Zdy-1110/FPGA-676/fpga/linux/ReadME.txt

driver  --- 驱动
dma_pio_app.c  --- dma and pio 操作应用程序
pio_test.c  --  寄存器操作应用程序
