Zdy-1110/FPGA-676/交接_20261019_会话续接.md

# 会话交接（2026-10-19 13:15，接 10-18 下午至 10-19 中午的会话）

新会话开场请先读本文件和记忆索引 `MEMORY.md`，然后从 **§3 待办第 1 项** 继续。

## 1. 当前硬件状态（以本节为准）

**FPGA 卡**
- 插在 **P29**（PCIe3 x2，控制器 3c0800000）。10-19 13:03 按 V2 条件重插后，建链为 **Gen2 x2**：
  - EP 0002:21:00.0，根端口 0002:20:00.0；
  - BAR0 f0200000，BAR1 **f0204000**。
- 比特流 **osd1c**（md5 24fc1ec8…）**已写进 FPGA 的 SPI flash**，上电后自加载，不再需要 JTAG。
- V2 之后测过两次，误码计数和 AER 全部为 0：空闲 30 秒一次，不限速送帧约 4.9 GB 一次。
- 日志：`log/p29_gap/v2_*`。

**接线**
- **HDMI 线：用户 13:10 左右在不播放的状态下刚插到 FPGA 板的 HDMI OUT，插上之后还没检查过链路和误码。**
- MIPI 屏没接，挡板螺丝没拧。

**RK（OK3568）**
- 地址 192.168.3.51（WiFi C305_5G），登录方式见记忆 `rk-board-network-access`。
- 串口控制台是 COM9。COM9 可能被其他会话的串口录制程序占用，遇到时等它结束，不要杀进程。
- CMA 256 MB（U-Boot 环境变量 bootargs 里的 `cma=256M`）。

**每次 RK 重启后会复位的东西**
- `/tmp` 被清空；
- EP 没有使能（需要 enable 加 CMD 0x06）；
- MPS 变回 128。

在 PC 上运行 `sh tools/test_feeder/board_test.sh` 会全部自动处理：识别槽位、使能 EP、在 P29 上设 MPS 256、上传文件、30 fps 播放。

## 2. 本次会话完成的工作

| 项目 | 结果 | 详情 |
|---|---|---|
| FPGA 显示 + OSD + 按键 + 标定（disp1 → osd1 → osd1b → osd1c） | 上板全部通过，osd1c 为当前版本 | 记忆 `fpga-display-path` |
| aarch64 交叉编译（Zig 0.14.1 + MPP/RKNN 1.5.0 头文件） | 可用，命令 `sh tools/rk_build.sh` | 记忆 `rk-cross-toolchain` |
| CMA 16 → 256 MB | 已生效，有备份和回退办法 | `RK_CMA扩容方案_20261018.md` |
| test_feeder 零拷贝送帧（MPP → CMA → 门铃 → FPGA） | 30 fps 稳定。不限速：P30 x1 为 103.8 fps，P29 x2 + MPS 256 为 **202 fps** | `tools/test_feeder/`，记忆 `rk-test-feeder` |
| test_feeder 修复 | 输入 EOF 后 2 秒内没有新帧就退出，空输入返回码 3；board_test.sh 改为自动识别槽位、使能 EP、设 MPS | 同上 |
| osd1c 写进 flash | 卡上 flash 实际是芯天下 XT25BF128（ID 0x0B4018），原来是空的。PDS 的 flash 列表经 UAC 加了一条（挂在 WINBOND 下）；冷启动验证通过 | `FPGA_flash固化方案_20261018.md`，记忆 `fpga-flash` |
| P29 排查 | 参考时钟已排除（V3，由 P29 排查会话完成）；**V2 机械重插成功**，确认是插槽接触问题 | 记忆 `ok3568-pcie-slot-hardware`，`P29成功与失败差异分析_20261018.md` |
| 门铃带宽 | 冷启动后 MPS=128，只有 506 MB/s；设成 256 后 770 MB/s。显示读口只占约 30 MB/s | 记忆 `pcie-dma-fast-path`，`log/p29_gap/v2_bench_*` |
| NPU 检测程序 | **只有设计，还没写代码**：yolov8n 转 RKNN 1.5.x INT8，输入 960×320 路面带，用 RGA 预处理，分 M0–M4 | `RK_NPU检测程序设计_20261018.md`，记忆 `rk-npu-design` |
| 状态问答 | RK 端还没有模型检测，FPGA 端也还没有车道线检测；只有 PC 上的离线参考算法 | `tools/ref_algo/`、`tools/yolo_baseline/` |

## 3. 待办（按优先级）

1. **【下一步】确认接上 HDMI 后 P29 是否正常，然后播放给用户看。**
   1. 只读检查：`lspci`、`current_link_speed/width`；
   2. 上传 `tools/pcie_bench/{gen2check,aer,rasdes}.sh` 到 `/tmp`，执行 `/tmp/gen2check.sh 30`，看两条 lane 的误码和 AER；
   3. 一切正常就运行 `sh tools/test_feeder/board_test.sh`，请用户看显示器；
   4. 之后按"一次只加一项"的原则验证：带 HDMI 重启一次 → 拧上挡板螺丝 → 接 MIPI，每加一项都检查建链和误码。
2. **NPU 程序：等用户决定。** 转换环境二选一：
   - 把 Ubuntu-22.04 切到 WSL1，不需要 VT-x；
   - 用户去 BIOS 打开 VT-x，继续用 WSL2。

   另外有几项下载需要用户同意：Toolkit2 1.5.x 和依赖（约 1.5–2 GB）、airockchip 的 ultralytics 分支、yolov8n.pt、librga 1.9.1 头文件。批准后从 M0 开始。
3. （用户暂缓）RK 开机脚本：自动使能 EP、设 MPS，并把播放程序放到 `/userdata`。
4. 更早留下的待办：
   - 用户核验 layer-A 的 GT；
   - 用户手动删除 `D:\d\` 和 `video_review/ref_runs/B_manual$1`；
   - RK HDMI 后备链路（RK 检测不到 HPD）；
   - FPGA 感知口：FPGA 上做车道线和信号灯检测、给 NPU 的拼图预处理、DMA-W 环形缓冲；
   - 门铃完成改用 MSI 通知；
   - test_feeder 每帧带元数据，以及支持中途换分辨率；
   - OSD 检测框寄存器加影子和提交位。

## 4. 常用命令和文件

| 用途 | 命令 / 文件 |
|---|---|
| 一键播放（PC 上运行） | `sh tools/test_feeder/board_test.sh [--fps 0] [--frames N]` |
| 安全重载比特流（JTAG） | `[SLOT=p30] sh tools/fpga_reload.sh D:/pango_work/prog_x2_osd1c.tcl`（P29 不加 SLOT） |
| 写 flash | `tools/flash/*.tcl`，经 `tools/jtag_run_tcl.ps1` 执行。**先断链**，写完用整片回读比对 |
| 误码 / AER | 板上 `/tmp/gen2check.sh 30`、`/tmp/aer.sh show`、`/tmp/rasdes.sh dump`（脚本在 `tools/pcie_bench/`） |
| 门铃回归 | `/tmp/pcie_bench f0204000 3 D`（测之前先设 MPS 256） |
| 板子访问 | `tools/rk_ssh.py`、`rk_put.py`、`rk_get.py`，要设 `MSYS_NO_PATHCONV=1` |
| 方案文档 | `选题3_硬件架构_FPGA视频中枢方案_20261018.md`（总架构）、`PCIe_DMA提速_20261018.md`、`RK_CMA扩容方案_20261018.md`、`FPGA_flash固化方案_20261018.md`、`RK_NPU检测程序设计_20261018.md`、`P29成功与失败差异分析_20261018.md` |

## 5. 坑点（下次别再踩）

- **RK 链路在线时不能动 FPGA**（JTAG 烧写、访问 flash 都不行），否则 RK 会挂死。必须先断链：移除 EP，再置 LnkCtl.Link Disable。
- `rk_ssh.py` 会把命令本身回显出来，而且不返回远端的退出码。在输出里 grep 标记时要加 `^` 锚定，否则会匹配到回显的命令行（之前 `HAVE_MP4` 就因此误判）。
- P29 的 PHY 时钟被关掉时，不要读 0xFDCB8xxx，会挂总线。
- 管理员身份运行的 PowerShell 5.1 会把没有 BOM 的 UTF-8 脚本当 GBK 读，所以 .ps1 只写 ASCII。
- PDS 的 flash 厂商表写死在 cdt_js.exe 里，新增的厂商名会被忽略。`cfg_jtag_flash_verify` 要往管理员目录写文件，所以会失败，改用回读比对。
- `cfg_jtag_flash_readback` 必须先 assign 一个文件，回读长度等于这个文件的大小。
- 测带宽前先确认 MPS。不要凭推断下结论：这次"显示读口抢带宽"的猜测，实测证明是错的。
- Git Bash 里没有 `iconv`；cdt 工具的输出直接读原始内容即可。

## 6. 环境备注

- 工作目录 `E:\Project\nesai2026`；远程操作前确认板卡供电与 P29 槽位占用。
