Zdy-1110/FPGA-676/选题3_当前进度分析与交接_20261014.md

# 选题三（ADAS）当前进度分析与交接文档

> 生成时间：2026-10-14（Asia/Taipei）
> 用途：从「聊天模式」交接到「code 模式」继续执行。新会话请先读本文，再按 §9 的顺序开展工作。
> 分析范围：`E:\Project\nesai2026`（工作区）。**未覆盖** `D:\pango_build\`、`D:\pango_work\` 等工作区外目录（x2 自研工程和成功证据都在那里）。
> 分析方式：4 个 haiku 子智能体分块只读分析 + 主会话抽样复核。凡是只有子智能体报告、未经本人复核的结论，文中标注「未复核」。

---

## 1. 一句话结论

选题三的应用层（图像采集显示、图像识别、多路视频、AI）**一行代码都还没有**。已完成的工作几乎全部集中在「基础任务②：RK3568 ↔ FPGA 的 PCIe 互联」的底层打通：Gen2 x2 链路协商成功、DMA 数据面用 `devmem` 往返验证通过。但**吞吐从未实测**，官方驱动也未编译成功。

---

## 2. 选题三要求（来源：紫光同创《FPGA 创新设计赛道选题指南》第 12–14 页）

**架构要求**：以「紫光同创 FPGA + ARM（或 RISC-V 软核）」为核心的软硬协同系统，处理性能不得高于 RK3568。

| 类别 | 任务 |
|---|---|
| 基础① | 图像采集与显示：HDMI / 摄像头（如 OV5640）输入，LCD 或 HDMI 输出，完成「采集-处理-显示」闭环 |
| 基础② | 软硬协同通信：MCU 与 FPGA 之间的高速通信（如 PCIe），完成数据交互与指令控制 |
| 基础③ | 基于 FPGA 的道路环境监测与特定场景感知（斑马线、行人、障碍物等） |
| 高阶① | 至少四路视频流（前、后、左、右）并行采集与低延迟传输，优化数据流带宽 |
| 高阶② | 复杂场景（夜间道路、复杂路口）下的完整感知与避障 |
| 高阶③ | MCU 端部署轻量 AI 模型，实现多路视频实时、高精度、低延迟识别与自主路径规划 |

**测评与测试方式要点**：
- 图像采集处理：采集一路或多路视频，能拼接或融合（模拟全景影像）；灰度化、去噪、二值化、色彩空间转换等基础处理；延迟与帧率满足低延迟需求。
- 测试场景（现场用 U 盘提供 1–4 种）：
  - 十字路口视频，假设车在左/右/直行三车道之一：红灯停、绿灯行、红灯强行行驶时报警；用叠加箭头或 LED 指示行驶行为（LED0 左转、LED1 直行、LED2 右转）；按键模拟换车道、停止/行驶；LED 或红色叠加表示报警。
  - 道路图片或视频：虚线则变道，实线则直行，强制变道指令时报警；按键模拟左转/右转。
  - 带导航的真实道路视频：根据导航完成模拟智驾。
  - 其他：行人闯红灯、汽车刹车等。
- 文档与代码：Verilog / C 模块化、时序约束合理、无明显时序违例；分析报告含系统架构、软硬协同数据流、资源占用、性能测试。
- 提交物：完整技术文档（含核心亮点预览）、**硬件实物**、**1080P 演示视频（3 分钟内）**、打包的工程源码。强调需要可现场演示的实物，不能只停留在算法仿真。

**平台**：推荐盘古 50 / 盘古 676 开发板（企业借出共 200 套）、RK3568_MES2L100H（5 套），也可用以紫光同创 FPGA 为核心的自制板。盘古 100Pro+（本项目所用）属于 676 系列，板载 HDMI 输入/输出、按键、LED、FMC LPC、PCIe Gen2 x4 金手指；FMC 转 IO 子卡可接官方双目 OV5640 摄像头模块。

---

## 3. 本项目当前硬件方案

- FPGA：盘古 100Pro+（PG2L100H-6FBG676，Logos2），板卡识别为 BASE-V1.2 / CORE-V1.2。
- 主机：飞凌 OK3568-UP4（RK3568），FPGA 卡插在 **P29 槽（PCIE_A，物理 x2，RK 控制器 `3c0800000.pcie`）**。P30 槽是 x1，空置。
- 互联：PCIe，RK 为 Root Complex，FPGA 为 Endpoint。
- 工具链：PDS 2025.2-ads（`D:\pango_pds`），仿真用 Questa Altera Starter 2025.3。
- 用户最新状态（2026-10-14）：FPGA 板已接电脑（JTAG），同时已插在 RK3568 板上。

---

## 4. 已完成的工作（按证据强度分级）

### 4.1 有文档记载的实测结果（原始日志在 `D:\pango_work`，工作区内无，本次未复核原始证据）

来源均为 `PCIe_x2提速_进度与交接文档.md`（2026-10-05 第 2 版）。

| 项目 | 结论 |
|---|---|
| x2 提速根因 | `NUM_OF_LANES` 是布尔标志位，必须保持 `5'b1`。真正决定 lane 数的是 `MAX_LINK_WIDTH=6'd2`、`LINK_CAPABLE=6'd3`、`HSST_LANE_NUM=2` |
| x2 比特流 | 已编译并烧写，EP 广告 `max_link_speed=5.0 GT/s`、`max_link_width=2`；产物 `D:\pango_work\pango_pcie_dma_x2.sbit`（3,791,112 B） |
| RK 端链路 | `PCIe Link up, LTSSM is 0x130011`，EP = `0002:21:00.0`（vendor/device = 0x0755），`current_link_speed=5.0 GT/s`、`current_link_width=2` |
| DMA 数据面 | 用 `devmem` 直控 BAR1（本次映射 `0xf0204000`），128 B 逐字比对与 4096 B 满包往返在两个方向上全部一致，done 位均置 1 |
| RK 启动修复 | boot 分区 DTB 损坏导致 U-Boot `panic()` 死循环，已用 recovery 分区（LBA 0x28000 + 0x800）里的原版 DTB 修回，CRC32 `74a6f13e`，现可正常进 Linux |
| 自动化 | `pds_shell` 全流程编译（约 2.5 分钟）、JTAG 命令行烧写、U-Boot 恢复、串口脚本均已打通 |

JTAG 烧写日志旁证：工作区 `log/configuration.log` 记录 2026-10-05 21:41 有一次成功烧写（进度 100%），与交接文档时间吻合。

### 4.2 工作区内有文件支撑的成果

- **只读 JTAG 实测**（2026-10-03）：识别到 PG2L100H，ID `0x00602899`，当时 DONE=0（`review/hardware_connected_20261003/jtag_readonly_result.json`）。
- **官方 PCIe 例程只读审计**：`review/pcie_code_audit_20261003/`。覆盖 `4_15_PCIE_DMA`（Fabric 2022.2-SP6.4，Gen2 x4 端点，DMA + PIO + 主机驱动 + 测试程序）与 `2_13_pcie_test`。（子智能体摘要，未复核：约 83 个源/IP 文件；历史单 seed 布线结果 Setup WNS 0.439 ns、Hold 0.098 ns、TNS 0，LUT 约 6%、FF 约 4%；官方预编译的驱动和测试程序是 x86-64，RK3568 用不了。）
- **资料包校验**：104 个压缩包重下后校验全部完好（`_report_redownload.txt`、`tools/check_archives.py`）。
- **仿真环境**：`fpga_sim/` 有 Questa + PDS 仿真库的运行方法与踩坑记录；`tb_counter.v` 是有效的计数器自检，`tb_pango_prim.v` 的时钟检查恒真，不算有效验证。运行证据只是 README 自述（2026-10-02 PASS），无日志。
- **串口排障工具**：`tools/` 下 11 个串口脚本，XR21V1414 驱动在 `tools/xr_usb_driver/`。
- **自制教学页**：`fpga_architecture.html`（FPGA 原理图解，非项目方案）。

### 4.3 已终止的工作线（遗留文件会误导，见 §6）

PCIe 电源隔离转接板（Rev A/B/C）：2026-10-07 已按用户指示终止，`design/`、`delivery/`、`archive/` 和 review 里的板卡专属内容全部删除（回收站可恢复）。

---

## 5. 选题三完成度对照

| 任务 | 状态 | 说明 |
|---|---|---|
| 基础① 图像采集与显示 | 未开始 | 工作区无 HDMI/OV5640 采集、显示的 HDL 或软件 |
| 基础② PCIe 软硬协同通信 | 部分完成 | 链路和 DMA 数据面已验证（文档记载）；缺官方驱动编译、吞吐实测、真实数据通道、指令控制协议、FPGA 比特流固化 |
| 基础③ 图像处理与识别 | 未开始 | 无 |
| 高阶①~③ | 未开始 | 无 |
| 提交物（文档、视频、源码） | 未开始 | 现有文档均为工程记录，不是参赛文档 |

---

## 6. 文档矛盾与过期结论（已核对）

| 问题 | 结论 |
|---|---|
| `00_最新PCIe评审_禁止直接打板.md` 声称 Rev C 设计包已交付 | **已过期**。README 写明该线 10 月 7 日已终止并删除，文中链接全部失效 |
| `PCIe中间件_CEM触点映射_已核实.md` 依据 OK3588-C 原理图，而主线用 OK3568-UP4 | 属于已终止的转接板线，不适用于主线 |
| `configuration.log` 显示 10 月 5 日有成功烧写，而 10 月 3 日文档称「未烧写」 | **不矛盾**。前者是 x2 比特流烧写（交接文档有记载），后者是更早的只读 JTAG 阶段 |
| `tools/boot_console.log` 中两路 PCIe 均为 Link Fail | 这是 FPGA 未配置时抓的排障现场（交接文档 §4.2 已说明），不代表当前状态 |
| 交接文档称「目标已达成」，但吞吐未测 | 「≈1GB/s」是 Gen2 x2 的链路折算（5 GT/s × 2 lane × 8b/10b），不是测量值 |
| 10 月 11 日的 `tmp_yuque_*.html` | 飞凌文档页面保存失败后留下的空壳（正文仅十几个字符），无信息 |
| `tmp_ok3568_up4_sch.txt`（2 MB）、`tmp_pcie_page11.txt`、`tmp_rk_pcie_pages/` | 未分析，疑似 RK 原理图 PCIe 页的提取，可能是最近的排查输入 |

---

## 7. 风险与阻塞

1. **吞吐无基线**：官方 `.ko` 驱动需 OK3568 的 Linux 5.10.160 内核源码树加 aarch64 交叉工具链，当前没有（F 盘资料盘已断开，`D:\pango_work\ksrc` 为空，飞凌源码分卷包曾损坏）。板端 `/lib/modules/5.10.160/build` 是悬空软链接，且板上无 gcc，不能板上编译。
2. **FPGA 配置掉电即丢**（SRAM）：交接文档明确要求「别给 FPGA 板断电」。若已断电过，x2 比特流已不在，需要先只读检查 `done bit`。
3. **RK 上电只探测一次 PCIe**：FPGA 必须先于 RK 启动完成配置。演示需要把比特流固化到 Flash（文档提过思路，未做），并验证冷启动能一次枚举成功。
4. **PDS license 已于 2026-11-03 续期至 2029-09-09**（`host_id 00e04cf107df`，需保持 TAP 网卡「以太网 8」MAC = `00E04CF107DF`）。Questa license 至 2027-10-02。
5. **四路视频来源未规划**（我的推断）：100Pro+ 只有 1 路 HDMI 输入加 FMC，官方配套摄像头模块是双目，四路需要提前确认方案（多 FMC 子卡、HDMI 加摄像头混合，或用 U 盘视频文件模拟多路输入）。
6. **时间分配失衡**：最新有实质内容的文档更新是 10 月 7 日，工作量主要花在互联底层、已废弃转接板和排障上。
7. **遗留的未决硬件问题**（均来自已终止的转接板线，直插 P29 槽的主线下已能训练成功，所以大概率不阻塞，这是推断）：参考时钟球位 F11/E11 与 F13/E13 手册冲突、lane reversal 两个例程相反。

---

## 8. 本次会话的 SSH 尝试结果

用户要求：FPGA 已接入电脑并插在 RK 板上，尝试 SSH 到 RK 板分析 PCIe 提速；若缺乏软硬件资料则停止并等待用户补充。

结果：**未能连接，已按约定停止**。

- 本会话运行在云端，访问不到用户本地网络。
- 桌面端本地命令行工具（`device_bash`）提示「Linux 环境仍在下载」，两次尝试均不可用。
- 桌面控制对终端类应用只给「点击」权限，无法输入命令。
- RK 板在 Linux 下的 IP **没有任何文档记载**。此前全部操作走串口 COM14（115200，root/root）；`boot_console.log` 显示启动时有 `Starting sshd`，但未出现 IP。U-Boot 阶段用过 `169.254.33.200`（PC 侧 `169.254.33.151`，网线直连 APIPA），那是 U-Boot 的临时地址，不是 Linux 的。

**本会话未对任何硬件做过写操作**。

---

## 9. code 模式下的建议执行顺序

### 9.0 开工前的约束（上轮约定，沿用）

- 对 RK 板和 FPGA **只读**：不烧写、不擦除、不复位、不断电，除非用户明确另行授权。
- FPGA 烧写只在用户授权时用 `cdt_js.exe` + `cdt_cfg_shell.exe`（见交接文档 §3.3）。
- 访问 BAR 前必须 `echo 1 > /sys/bus/pci/devices/0002:21:00.0/enable`，否则读出全 `0xFFFFFFFF`。
- 板上 `dd` 读写 `/dev/mem` 会报 `Bad address`，只能 `devmem` 逐字访问。
- U-Boot 缓冲区一律用 `0x08300000`（`0x09000000` 是 TrustZone 保护区，访问即 panic）；U-Boot 数字参数全按十六进制解析。
- 串口用 pyserial 直连 COM14 前先杀掉 MobaXterm（它独占串口）；XR21 句柄卡死（PermissionError 13）时拔插 USB。
- 修改 `.v` 文件用 Edit 工具，不要用 Python `re.sub` 写 `\'`（会写入非法语法并被解析器静默跳过）。

### 9.1 第一步：只读摸清现状

1. 找到 RK 板 Linux 下的 IP（任选其一）：
   - 串口 COM14 登录后执行 `ip addr` 或 `ifconfig`；
   - 在 PC 上查 `ipconfig` 与 `arp -a`，网线直连时留意 169.254.x.x 网段。
2. 用 `ssh root@<IP>`（密码见交接文档 §八）确认可达。
3. 在 RK 上执行只读命令，建立链路基线：
   ```sh
   D=/sys/bus/pci/devices/0002:21:00.0; R=/sys/bus/pci/devices/0002:20:00.0
   cat $D/current_link_speed $D/current_link_width $D/max_link_speed $D/max_link_width
   cat $R/current_link_speed $R/current_link_width
   hexdump -C $D/config | head -20; hexdump -C $R/config | head -20
   dmesg | grep -i -E "pcie|0002:2"
   ```
   （`hexdump` 可用来读 PCIe Capability 里的 MPS/MRRS；busybox 的 `lspci` 输出乱码，认 sysfs。）
4. 在 PC 上用 `check.tcl`（只连接并扫链，不烧写）确认 FPGA 的 `done bit`，判断 x2 比特流是否仍在运行。

### 9.2 第二步：补齐资料后再测吞吐

需要用户提供或找到，缺了就停下等待：
- OK3568 的 Linux 5.10.160 内核源码（飞凌 SDK）+ aarch64 交叉工具链，用于编 `pango_pci_driver.ko`、`dma_pio_app`、`pio_test`；
- 或评估不依赖官方驱动的方案（UIO/`mmap` 用户态 DMA 测试）。该方案的可行性我没有验证，需要先读官方 DMA 寄存器说明与 `dma_findings.md`。

链路层面的判断（来自文档，不是实测）：P29 物理上只有 2 条 lane，FPGA 官方例程最高是 Gen2，所以链路层基本已到顶；再提速只能在数据通路上优化（DMA payload 大小、RK 端 MPS/MRRS、驱动与描述符方式、FPGA 侧 128 bit 数据通路时钟），必须先测基线才能判断。

### 9.3 第三步：补选题三主线（优先级建议，非文档内容）

1. **基础①**：HDMI 输入 → DDR3 帧缓存 → HDMI 输出的闭环。不依赖 PCIe，是所有后续工作的底座。
2. **PCIe 数据通道**：把 FPGA 的帧数据 DMA 到 RK 内存并实测吞吐；设计简单的指令/状态协议。
3. **比特流固化 + 冷启动枚举验证**。
4. **基础③**：FPGA 端预处理（灰度、去噪、二值化、边缘、ROI），识别斑马线、红绿灯状态、虚实线。
5. **高阶**：确定四路视频的来源方案；RK 端用 NPU（RKNN）部署轻量模型；构建夜间、十字路口场景。
6. **参赛交付物**：架构、软硬协同数据流、资源占用与性能测试文档；1080P 3 分钟演示视频；按 U 盘测试数据集（十字路口、变道、红绿灯判断）准备演示流程。
7. 续 PDS license。

### 9.4 顺手清理

- 过期文档 `00_最新PCIe评审_禁止直接打板.md`、`PCIe中间件_CEM触点映射_已核实.md`，及 `tools/` 下的转接板线遗留（`make_kicad_interposer.py`、`make_pcie_interposer.py`、`make_wiring_diagram.py`、`kicad_lib/`、`kicad_out/`、`datasheet/`、`lcsc_page.html`）。README 已说明可再删，删除需用户确认。
- `tmp_*` 文件（含 2 MB 的 `tmp_ok3568_up4_sch.txt`）确认无用后清理。

---

## 10. 关键文件索引（工作区 `E:\Project\nesai2026`）

| 文件 | 说明 |
|---|---|
| `README.md` | 工作区总索引（2026-10-07 整理），各工作线状态、目录说明、外部依赖路径、清理记录 |
| `PCIe_x2提速_进度与交接文档.md` | **核心交接文档**：x2 提速全过程、RK 侧枚举/DTB/devmem/U-Boot 坑、烧写与串口方法 |
| `review/pcie_code_audit_20261003/代码分析汇总结论.md` | 官方 PCIe 例程审计结论；配合 `dma_findings.md`、`pcie_test_findings.md` |
| `review/hardware_connected_20261003/` | 实板只读实测记录（不可再生，勿删） |
| `pcie_demo/4_15_PCIE_DMA/` | 官方 DMA 参考设计（含 `linux/` 驱动与测试程序源码、`docs/` 的 RD04005 使用说明） |
| `fpga_sim/README.md` | Questa + PDS 仿真环境四个坑 |
| `contest_pymupdf.txt` | 紫光同创赛道选题指南全文提取（含选题三） |
| `anlogic_2026_topics.txt` | 安路赛道选题指南（与本队无关） |
| `fpga_docs/` | 官方手册 PDF 与文本提取（无 DDR3/HDMI/PCIe IP 用户指南，PDS 的 UG 文档在 `D:\Program Files\pango\PDS_2025.2-ads\doc\`） |

**工作区外依赖**：`D:\pango_build\4_15_PCIE_DMA\`（x2 自研工程，主力）、`D:\pango_work\`（x2/x1 比特流、烧写脚本、U-Boot 自动化脚本、DTB 备份）、`D:\pango_sim_libraries\`（仿真库）、`F:\BaiduNetdiskDownload\`（竞赛资料包与飞凌资料，当前断开）。

---

## 11. 本文未覆盖或未核实的内容

- `D:\pango_build`、`D:\pango_work` 下的实际工程与证据文件。
- x2 链路和 DMA 往返结果的原始日志（`boot_after_fix_raw.bin` 等）。
- 官方例程源码本身（只读了审计结论，没读 RTL）。
- `review/rk_up4_*` 的 RK 手册逐页解析、`tmp_ok3568_up4_sch.txt`、`tmp_pcie_page11.txt`。
- 子智能体给出的细节数字（WNS、资源占用、83 个源文件等）只经过抽样复核。
