Zdy-1110/FPGA-676/选题3_硬件层架构_双摄像头+HDMI降级方案.md

# 选题三（ADAS）硬件层架构：单双目（FMC）+ HDMI 容器帧

> 2026-10-16 制定；**2026-10-17 修订**：卖家确认 FMC 转 IO 子卡（MES-FMC-LPC-IO）只能接 **1 个双目模块**。经手册核实，这是 PG2L100H 的 FMC 引脚数造成的硬上限（见 §1.1）。原方案里"再买一套双目把前/后换成实拍"的升级路径已不成立，改为由 RK3568 外接摄像头填充容器帧（见 §1.2）。
> 文件名保留旧名，避免已有引用失效。
>
> **2026-10-18 架构变更：主架构已改为 `选题3_硬件架构_FPGA视频中枢方案_20261018.md`**（3 个 USB 摄像头 + FMC 双目；USB 画面经 PCIe 进 FPGA；双目改为前方）。本文以下部分仍然有效，被新文档直接引用：§1.1 FMC 引脚限制、§5 引脚、§6 时钟、§10 LED 与按键、§11 上电顺序、§12 可复用代码、§13 中第 1–6、12 条。本文的 HDMI 容器帧（§4.1）降为评测测试视频和 PCIe 故障时的降级通路。§1.2 表中方案 E"摄像头经 PCIe 下发给 FPGA"当时因 PCIe 不稳被否决；10-18 修复并提速后，它成为新的主方案。
> 标注说明：【确认】= 已对照原文核实；【待定】= 缺资料或需上板验证；【推断】= 设计推理，未实测。

---

## 1. 结论

- **主显示屏和双目摄像头接 FPGA 板（盘古 100Pro+）。** RK3568 的 HDMI 输出是 FPGA 的第二个视频入口（容器帧）。
- **4 路逻辑视频（前、后、左、右）的来源：**
  - 左、右：双目 OV5640 → FMC → FPGA 直接采集（2 路实拍，低延迟）。
  - 前、后：RK3568 拼成 1920×1080 的"容器帧"，经 HDMI 送入 FPGA，FPGA 按窗口地址拆出两路。容器窗口的内容由 RK 决定，有两种来源：
    - **回放：** U 盘视频解码（评测现场用这一种）；
    - **实拍：** RK 外接的 2 个摄像头（推荐 USB UVC，备选 OV5645 MIPI）。此时 4 路全部是实拍。
  - 两种来源下，FPGA 侧的硬件和逻辑**完全相同**，切换只是 RK 软件换了视频源。
- **显示：** FPGA 输出 1080p60 四宫格。每格 960×540，与各路源分辨率 1:1，显示通路**不需要缩放器**。
- **测试模式：** 按键切换成"单路全屏"。HDMI 输入整帧作为前视（U 盘测试视频，1920×1080），FPGA 全分辨率处理并全屏显示。
- **PCIe 只传缩小帧和结果：** 约 23 MB/s，Gen1 x1 都够用。PCIe 断开时，采集、处理、显示闭环照常工作。

### 1.1 约束核实：为什么 FMC 只能接 1 个双目【确认】

- 100Pro+ 上**除 FMC（J33）外没有任何通用 IO 排针**。仅有的排针是 10 针 JTAG（`100pro_txt.txt:410-411`）；其余是 HDMI、SFP、SMA、PCIe、以太网、SD、UART。
- 手册 FMC 管脚表中，**LA21、LA24–LA33 和 CLK0_M2C 都标注"PG2L200H"**，并注明"FMC 部分管脚仅 PG2L200H 支持，PG2L100H 为 NC"（`100pro_txt.txt:3128-3211`）。本板是 PG2L100H，可用的只有 LA00–LA20、LA22、LA23，共 **23 对 = 46 根单端 IO**。手册正文"24 对"（`:2931`）与这个数基本一致；概述中的"34 对"（`:420`）是 200H 的数字。
- 一个双目模块要 28 根 IO（每路 14 根，见 §5.2），两个要 56 根，**超过 46 根**。即使去掉 RESET、共用 I2C，也要 52 根，仍然不够。所以**任何 FMC 子卡都无法在本板上接两个双目**，不只是这块子卡的问题。
- 子卡型号：**MES-FMC-LPC-IO 子板**（小眼睛，`docs_ext/fpga_pkg/hsst_regs/sma_hsst_demo.txt:8,14`）。

### 1.2 前/后两路的来源方案比较

| 方案 | 做法 | 4 路都是实拍？ | 额外硬件 | 风险 | 结论 |
|---|---|---|---|---|---|
| A 回放 | RK 解码 U 盘视频填 W0/W1 | 否（2 实拍 + 2 回放） | 无 | 无 | **基线，必须先做通**；评测就用这个 |
| B USB 摄像头 | RK 接 2 个 UVC 摄像头，采集后拼进 W0/W1 | **是** | 2 个 USB 摄像头（支持 MJPEG） | 延迟比 DVP 路高（§7.1） | **推荐的增强**。FPGA 视频通路不改，只加一个可选的帧尾标签解析 |
| C MIPI 摄像头 | RK 底板有 2 个 26 针 `FPC26_OV5645_MIPI` 座（`sch.txt:1158,1257`），CSI 支持 2+2 lane 拆分（`hw.txt:3423-3427`） | 是 | 2 个飞凌 OV5645 模组 | 两路同时工作要改设备树，并核对 0R 选配（R62–R71）【待定】 | 备选，延迟低于 B |
| D 定制 FMC 转接板接 4 个 DVP | — | 是 | 自制 PCB | 4×11 数据/同步线 + 2 根共用 I2C + 4 根独立复位（4 颗 OV5640 默认 SCCB 地址都是 0x78，必须逐个唤醒）= 50 根 > 46 根 | **否决**：引脚不够 |
| E 摄像头经 PCIe 下发给 FPGA | RK → PCIe → FPGA | 是 | 同 B | PCIe Gen2 链路仍有间歇故障，且 DMA 要重写 | **否决**：HDMI 通路更稳 |

决定：**A 作为基线，B 作为 4 路实拍的增强，C 留作备选。** 三者共用同一份 FPGA 设计。

2026-10-17 用户确认做方案 B。摄像头选型和 RK 端容器帧合成的细化设计见 `选题3_RK端容器帧合成与USB摄像头方案.md`。

## 2. 系统框图

```
                    ┌──────────────────────── 盘古 100Pro+ (PG2L100H) ────────────────────────┐
 双目 OV5640 ──J17──┤FMC转IO子卡├─FMC LPC─► DVP×2 采集 ─► 8→16bit ─┐                          │
 (左/右, 960×540@30)│                                              │      ┌─────────────┐     │
                    │                                              ├─AXI─►│ DDR3 1GB    │     │
 RK3568 HDMI TX ────┼─► MS7200 ─RGB888─► HDMI RX 采集 ─► 预处理 ───┤      │ 32bit 帧缓存 │     │
 (容器帧 1080p30)   │                     (灰度/滤波/边缘/HSV)      │      └──────┬──────┘     │
                    │                         │ 特征(车道/红绿灯)    │             │            │
                    │                         ▼                      │      ┌──────▼──────┐     │
                    │                   规则判决 ◄── KEY0-4          │      │ 四宫格合成  │     │
                    │                         │                      │      │ + OSD 叠加  ├─► MS7210 ─► 显示器
                    │                         └──► LED0-3            │      └──────▲──────┘     │   (1080p60)
                    │                                                │             │ 检测框/决策 │
                    │                  2:1 抽取 ─► DMA 区 ──► PCIe EP (DMA + BAR0 寄存器) ◄───────┤
                    └──────────────────────────────────────────────────────┬──────────────────────┘
                                                                           │ 金手指, Gen2 x2
                    ┌──────────────────── RK3568 (OK3568-UP4) ─────────────┴──────────────────────┐
 U 盘 ──────USB─────┼─► VPU 硬解码 ──┐                                                           │
                    │                ├─► 容器帧合成（RGA，W0 前 / W1 后）─► HDMI TX ─► FPGA HDMI 输入 │
 USB 摄像头×2 ──USB─┼─► MJPEG 解码 ──┘                                                           │
 (方案 B，前/后实拍) │                                                                             │
                    │  PCIe RC ─► NPU (YOLO) ─► 决策/路径规划 ─► 写回 BAR0                        │
                    │  (可选) MIPI DSI / LVDS 中控屏                                              │
                    └────────────────────────────────────────────────────────────────────────────┘
```

## 3. 物理连接清单

| # | 连接 | 线缆/接口 | 说明 |
|---|---|---|---|
| 1 | 双目 OV5640 模块 J17 → MES-FMC-LPC-IO 子卡 40 针座 → 100Pro+ FMC LPC（J33） | 2.54 mm 40 针直插 | 模块自带 24 MHz XCLK 晶振，FPGA 不用输出 XCLK；模块只取 3.3V，无 5V【确认】。Bank L6 跳线设为 2.5V（J20→ADJ、J24→2V5，见 §5.2）。**这是 FPGA 上唯一的摄像头入口**（§1.1） |
| 2 | OK3568-UP4 HDMI 输出 → 100Pro+ HDMI 输入（MS7200） | 标准 HDMI 线 | RK 输出 1920×1080@30 |
| 3 | 100Pro+ HDMI 输出（MS7210）→ 显示器 | 标准 HDMI 线 | 1920×1080@60 |
| 4 | 100Pro+ PCIe 金手指 → OK3568-UP4 **P29**（PCIE_A，Gen2 x2） | 直插 | 10-18：FPGA lane 1 去加重改为 0（`pango_pcie_dma_x2_post1_0.sbit`）后，Gen2 x2 压测 10 分钟 0 错误，约 188/184 MB/s。P29 对插拔敏感；P30（Gen2 x1，约 155 MB/s）作备用。见 `PCIe_Gen1链路稳定性测试_20261017.md` §5.12 |
| 5 | U 盘 → RK3568 USB 主机口 | — | 评测现场提供的测试视频 |
| 6 | 调试：FPGA JTAG + USB-UART；RK 调试串口 COM14、WiFi SSH | — | 演示时可拔 |
| 7 | 供电：两板各用自己的适配器，接同一个插排 | — | 只能同时上电或断电（见 §11） |
| 8 | 可选：RK MIPI DSI 或 LVDS 中控屏 | 排线 | 显示 AI 结果和导航，不在主链路上 |
| 9 | 方案 B：USB 摄像头 ×2 → OK3568-UP4 USB 口（前、后） | USB | 选支持 MJPEG 的 UVC 摄像头；两个摄像头插不同的 USB 口，不要挂在同一个 Hub 下【推断】。选型要求见 RK 端方案 §2 |
| 10 | 方案 C（备选）：OV5645 MIPI 模组 ×2 → OK3568-UP4 的两个 `FPC26_OV5645_MIPI` 座 | 26 针 FPC | 需飞凌配套模组、设备树改 2+2 lane；两路能否同时工作【待定】 |

## 4. 逻辑通道与显示模式

### 4.1 HDMI 容器帧（RK 输出 1920×1080@30）

| 窗口 | 区域（x, y, w, h） | 模式 Q-回放（方案 A） | 模式 Q-实拍（方案 B/C） | 模式 T（测试） |
|---|---|---|---|---|
| W0 | 0, 0, 960, 540 | 前视：U 盘视频 | 前视：RK 摄像头 #1 | 整帧 1920×1080 = U 盘测试视频 |
| W1 | 960, 0, 960, 540 | 后视：U 盘视频 | 后视：RK 摄像头 #2 | — |
| W2 | 0, 540, 960, 540 | 备用（左视录像） | 备用（左视录像） | — |
| W3 | 960, 540, 960, 540 | 备用（右视录像） | 备用（右视录像） | — |

FPGA 把整帧存进 DDR3，"拆窗口"只是读取时加地址偏移，采集端不需要裁剪逻辑。

Q-回放和 Q-实拍对 FPGA 来说是同一种输入，**由 RK 端服务选择视频源**，FPGA 不需要知道。只有 T 和 Q 的切换（KEY4）需要两边同步：FPGA 通过 BAR0 0x008 告诉 RK 当前模式；PCIe 断开时，RK 按配置文件里的默认模式运行。

**帧尾标签：** RK 在每帧的 y = 1072–1079、x = 0–287 写入一个由黑白块组成的标签，内容包括布局、W0/W1 的来源、帧计数，以及量化范围校准块（格式见 RK 端方案 §3.5）。FPGA 不依赖 PCIe，也能从标签知道容器的实际布局和 RK 是否卡死。这块区域落在 W2 左下角；模式 T 下位于画面最底部 8 行，显示时可以涂黑。

### 4.2 逻辑通道映射

| 通道 | 方位 | 默认来源 | 备用来源（寄存器切换） |
|---|---|---|---|
| CH0 | 前 | HDMI W0（U 盘视频或 RK 摄像头 #1；模式 T 时为整帧） | — |
| CH1 | 后 | HDMI W1（U 盘视频或 RK 摄像头 #2） | — |
| CH2 | 左 | OV5640 #1（FMC） | HDMI W2 |
| CH3 | 右 | OV5640 #2（FMC） | HDMI W3 |

摄像头出问题时，CH2/CH3 切到 W2/W3，系统就变成"4 路全部来自 HDMI 回放"，演示不中断。

双目模块的两颗 OV5640 通过 24 针 FPC 连到模块主板（`double_dvp_ov5640.txt` 中 J4/J5 = `FPC0_5_24P`），可以朝不同方向安装。实际朝向受 FPC 排线长度限制，装车模前要量一下。

### 4.3 显示输出（1920×1080@60）

- **模式 Q：** 左上 CH0 前，右上 CH1 后，左下 CH2 左，右下 CH3 右，每格 960×540，不缩放。OSD 叠加车道线、检测框、行驶箭头和报警红框。
- **模式 T：** CH0 全屏 1920×1080，叠加箭头、红绿灯状态和报警。可选在角落放两路摄像头的 2:1 小窗（480×270）。
- KEY4 在 Q 和 T 之间切换（见 §10）。

## 5. FPGA 引脚

### 5.1 已确认引脚（来源：100Pro+ 官方例程 `4_12_HDMI_IN_DDR3_HDMI_OUT` 的 fdc，以及硬件手册）

| 功能 | 信号 | 管脚 | 电平 |
|---|---|---|---|
| HDMI 输入（MS7200） | pixclk_in | K21 | LVCMOS33 |
| | hs / vs / de | J23 / H24 / H23 | LVCMOS33 |
| | r_in[7:0] | M15 H19 J19 J20 K20 G21 G20 H22 | LVCMOS33 |
| | g_in[7:0] | L14 J14 J15 J16 K15 K17 K16 L15 | LVCMOS33 |
| | b_in[7:0] | L18 J21 J18 H18 L17 M16 M17 M14 | LVCMOS33 |
| HDMI 输出（MS7210） | pix_clk | T24 | LVCMOS33 |
| | hs / vs / de | R20 / R21 / N19 | LVCMOS33 |
| | r_out[7:0] | N21 L23 L22 L25 L24 K26 K25 P16 | LVCMOS33 |
| | g_out[7:0] | T25 P25 R25 P24 P23 N24 N23 N22 | LVCMOS33 |
| | b_out[7:0] | P19 P21 P20 M22 M21 N18 R22 T22 | LVCMOS33 |
| MS7200/MS7210 公共 | I2C SCL / SDA（两芯片共用） | K22 / K23 | LVCMOS33 |
| | 复位 rstn_out（两芯片共用） | G25 | LVCMOS33 |
| 时钟 | 27 MHz 单端（核心板 U11） | D18 | LVCMOS33 |
| | DDR3 参考差分（核心板 U7，125 MHz） | N3 / N2 | HSTL15D_I |
| | PCIe 参考 100 MHz（来自金手指） | F11 / E11（HSSTREFCLK0_QL3） | HSST |
| | 板载 125 MHz（底板 U4，备用 PCIe 参考） | F13 / E13 | HSST |
| | 底板 27 MHz（U10，备用） | E17 | LVCMOS33 |
| LED（高电平亮） | LED0–LED7 | A20 C18 C19 E18 A17 A18 C17 B17 | LVCMOS33 |
| 按键 | KEY0–KEY4 | C22 C23 B22 A22 B20 | LVCMOS33 |

另有独立的硬件复位按键，所以 KEY0–KEY4 全部可以作业务按键。

### 5.2 摄像头引脚【确认，2026-10-17 取自官方 100H 双目例程】

**最终引脚**（来源：资料包 `7_FMC扩展子卡及Demo/2_Demo/HDMI_DDR3_OV5640_100H/HDMI_DDR3_OV5640_test.fdc`，即 100Pro+ 配 MES-FMC-LPC-IO 子卡和双目模块的官方例程，附预编译的 `CMOS1.sbit` / `CMOS2.sbit`）

| 信号 | CAM1 管脚（所在 LA） | CAM2 管脚（所在 LA） |
|---|---|---|
| PCLK | Y22（LA01_P_CC） | U21（LA17_P_CC） |
| HREF / VSYNC | W18（LA04_N）/ Y23（LA01_N） | W23（LA10_N）/ V23（LA10_P） |
| D7 D6 D5 D4 | V14（CLK0_C2M_N）、V18（LA04_P）、Y21（LA00_N）、T15（LA02_N） | T18（LA06_N）、T17（LA06_P）、AA23（LA12_N）、AB25（LA16_N） |
| D3 D2 D1 D0 | W25（LA15_P）、Y26（LA15_N）、U20（LA07_N）、T14（LA02_P） | V19（LA05_P）、U25、U26（表外，见下）、V21（LA17_N） |
| SCL / SDA | W21（LA00_P）/ U14（CLK0_C2M_P） | W19（LA05_N）/ V16（LA03_P） |
| RESET | T20（LA07_P） | Y20（LA09_N） |

- 两个 PCLK 都落在 `_CC` 时钟对上，全部引脚都不在本板为 NC 的 LA 上。
- 例程把 `cmos_init_done[1:0]` 接到 E18 / A17（LED3 / LED4）。
- **U25 / U26 不在手册的 LA 表里。** 它们应该就是 LA08 或 LA23 的真实管脚（手册把这两对都写成 T19/U19，必有一处错）。用例程引脚即可，不再依赖手册这一行。

以下是推导过程中的原始资料，保留备查。

**双目模块 J17 引脚定义**（来源：`DOUBLE-DVP-OV5640-1113.pdf`）【确认】

| 摄像头 | 信号 → J17 针号 |
|---|---|
| CAM1 | D7→3, D5→5, D4→7, HREF→9, D1→11, D2→13, VSYNC→17, SDA→4, SCL→6, D0→8, D6→10, RESET→12, D3→14, PCLK→18 |
| CAM2 | SDA→20, D7→21, D6→22, SCL→23, D3→24, D1→25, D2→26, D4→27, D5→29, D0→31, PCLK→32, HREF→33, VSYNC→34, RESET→35 |

- 每个摄像头 14 根信号，两个共 28 根 FPGA IO。
- PWDN 不在排针上（模块上有下拉电阻）。
- 模块从排针取 3.3V，板上 LDO 产生 2.8V/1.5V，摄像头 IO 电平是 2.8V。
  - **2026-10-18 更正：** 官方《OV5640双目摄像头实验例程》说明书第 6 页要求 J20 接 ADJ、J24 接 2V5，即 Bank L6 用 **2.5V**。FPGA 输出的 RESET、SCL、SDA 不应高于摄像头 2.8V 的 IO 电源，所以约束用 LVCMOS25。
  - 官方例程的 fdc 把这些引脚写成 LVCMOS33 / VCCIO 3.3，与说明书不一致，以说明书为准。
- 两个摄像头的 I2C 地址都是 0x78，但各走独立的 I2C 总线，不冲突。

**FMC LA 差分对 → FPGA 管脚**（来源：100Pro+ 硬件手册 J33 表 `100pro_txt.txt:2945-3211`）【确认】

> **2026-10-17 更正：** 上一版把 LA00–LA33 全列为可用，这是错的。手册中 LA21、LA24–LA33 标注"PG2L200H"，并注明 PG2L100H 上为 NC（`:3211`）。下表中 ~~删除线~~ 的对在本板不可用。

| LA | P / N | LA | P / N | LA | P / N |
|---|---|---|---|---|---|
| 00_CC | W21 / Y21 | 12 | AA22 / AA23 | ~~24~~ | NC（200H：W14 / W15） |
| 01_CC | Y22 / Y23 | 13 | V24 / W24 | ~~25~~ | NC（200H：AB16 / AC16） |
| 02 | T14 / T15 | 14 | Y25 / AA25 | ~~26~~ | NC（200H：AE17 / AF17） |
| 03 | V16 / V17 | 15 | W25 / Y26 | ~~27~~ | NC（200H：AC17 / AD17） |
| 04 | V18 / W18 | 16 | AA24 / AB25 | ~~28~~ | NC（200H：AD25 / AD26） |
| 05 | V19 / W19 | 17_CC | U21 / V21 | ~~29~~ | NC（200H：AC22 / AC23） |
| 06 | T17 / T18 | 18_CC | U22 / V22 | ~~30~~ | NC（200H：AF19 / AF20） |
| 07 | T20 / U20 | 19 | U15 / U16 | ~~31~~ | NC（200H：AD23 / AD24） |
| 08 | T19 / U19 ⚠ | 20 | AB26 / AC26 | ~~32~~ | NC（200H：AA20 / AB20） |
| 09 | W20 / Y20 | ~~21~~ | NC（200H：AE18 / AF18） | ~~33~~ | NC（200H：AD20 / AE20） |
| 10 | V23 / W23 | 22 | V26 / W26 | | |
| 11 | AB24 / AC24 | 23 | T19 / U19 ⚠ | | |

本板可用：LA00–LA20、LA22、LA23 共 23 对（46 根）；另有 CLK0_C2M U14 / V14（FPGA → 子卡方向的时钟对）。CLK0_M2C 同样只有 200H 才有。

FMC I2C：SCL M20，SDA L20（子卡如果把它引到排针上，可以作摄像头 I2C 备用）。

**落位规则：**

1. 摄像头引脚的最终位置 = 子卡"40 针 → FMC LA"的映射，再查上表。**需要拿到 MES-FMC-LPC-IO 子卡的原理图**（小眼睛科技，meyesemi.com，或向淘宝店铺索取，可以顺便问卖家要 100Pro+ 配双目的例程 fdc）。映射结果必须全部落在 LA00–LA20、LA22、LA23 内；如果落到 NC 的 LA 上，说明子卡是按 200H 设计的，要立刻反馈。
2. CAM1_PCLK、CAM2_PCLK 最好落在 `_CC` 时钟对（LA00/01/17/18）上。如果子卡没这样走线，就像 50K 例程那样设 `PAP_CLOCK_DEDICATED_ROUTE FALSE`，并约束 `create_clock -period 11.9`（84 MHz）。
3. FMC 的 LA 信号分布在 BANK L4/L5/L6/L7。L6/L7 的电压由 VADJ 决定：J20 选 3.3V 或 VADJ，J24 选 VADJ 为 2.5V 或 1.8V（板卡手册）。**接双目时按官方说明书设为 J20→ADJ、J24→2V5（2.5V）**（2026-10-18 更正，原文写的是 3.3V）。
4. ⚠ 手册中 LA08 和 LA23 都写成 T19/U19，必有一处错，**要以底板原理图（`MES2L676-BASE-V1.2-供客户做底板.sch`）为准**。另外 4_12 例程 fdc 里的 `free_clk` 约束在 W19，与 LA05_N 冲突，移植时删掉这个端口。

### 5.3 PCIe

沿用 `D:\pango_build\4_15_PCIE_DMA\` 现有工程的 HSST 引脚和约束（x2，lane 2/3 已释放）。

## 6. 时钟方案

| 时钟 | 频率 | 来源 | 用途 |
|---|---|---|---|
| sys_clk | 27 MHz | D18 | 主 PLL 的输入 |
| pix_out | 148.5 MHz | PLL（27×11/2） | HDMI 输出 1080p60、显示读取、OSD【4_12 例程已实现】 |
| cfg_clk | 10 MHz | PLL | MS7200/MS7210 的 I2C 配置 |
| sccb_clk | 25 MHz | PLL | OV5640 的 SCCB 配置（沿用 50K 例程） |
| pclk_hdmi | 74.25 MHz | MS7200 → K21 | HDMI 输入 1080p30 的采集与预处理 |
| pclk_cam1/2 | 84 MHz（16 位侧 42 MHz） | OV5640 → FMC | 摄像头采集 |
| ddr_core | 由 DDR3 IP 产生 | N3/N2 参考 | AXI 帧缓存 |
| pcie_ref | 100 MHz | 金手指 → F11/E11 | PCIe HSST |

跨时钟域：每个采集口经异步 FIFO 进入 DDR 时钟域，显示和 PCIe 读取同样经异步 FIFO 出来。沿用 `fram_buf` / `wr_buf` / `rd_buf` 的结构。

## 7. 视频格式

| 源 | 分辨率 / 帧率 | 进入 FPGA 的格式 | 存储格式 |
|---|---|---|---|
| OV5640 ×2 | 960×540@30【待定】 | 8 位 DVP，两字节拼成 RGB565 | RGB565 |
| HDMI 输入 | 1920×1080@30 | MS7200 输出 RGB888 并行 24 位 | RGB565（截断） |
| RK USB 摄像头 ×2（方案 B） | 采集 960×540@30 或 1280×720@30，MJPEG | 在 RK 上解码，由 RGA 缩放/拼进 W0/W1（每窗 960×540） | 经容器帧进入 FPGA |
| HDMI 输出 | 1920×1080@60 | RGB888 并行 24 位 → MS7210 | — |
| 送 RK | 每路 480×270@15，可调 | 2:1 抽取，RGB888 | DDR3 中的 DMA 区 |

- **OV5640：** 50K 例程配置的是 1280×720@30、PCLK 84 MHz【确认，`reg_config.v:315-318`】。本方案建议把 DVP 输出尺寸寄存器 0x3808–0x380B 改成 960×540，由传感器内部的 ISP 缩小，FPGA 端就不需要缩放器。【待定：需上板验证】
  - 备选：保持 720p 输出，在 FPGA 里做 4:3 抽取。
- **HDMI 输入用 1080p30 而不是 1080p60：** 并行输入的像素钟从 148.5 MHz 降到 74.25 MHz，时序余量更大，DDR 写带宽也减半。
- **USB 摄像头用 MJPEG，不用 YUYV：** 960×540 YUYV@30 每路约 31 MB/s，超过 USB 2.0 单个等时端点的上限（约 24.6 MB/s）；两路挂在同一 Hub 下更不够。MJPEG 每路只有几 MB/s，RK 的 VPU 可以硬解。【推断，需按实际摄像头确认】

### 7.1 各通路延迟估算【推断，需实测】

| 通路 | 组成 | 估算 |
|---|---|---|
| OV5640 → FPGA → 显示（左/右） | 传感器出一帧 33 ms + 三缓冲最多 1 帧 33 ms + 显示扫描 ≤ 17 ms | 约 50–85 ms |
| RK 摄像头 → RK → HDMI → FPGA → 显示（方案 B，前/后） | UVC 采集 33–66 ms + MJPEG 解码与拼接 10–20 ms + RK 显示 1 帧 33 ms + FPGA 33–50 ms | 约 110–170 ms |
| 方案 C（MIPI） | 比 B 少了 USB 传输和 MJPEG 解码 | 约 80–130 ms |
| FPGA 抽取帧 → PCIe → NPU 结果回写 → OSD | DMA 每组约 1.6 MB，< 20 ms（Gen1）+ NPU 推理 + 回写 | 取决于模型，单独测 |

结论：低延迟要求最高的规则判决（红灯、实线变道）在 FPGA 本地做，不受 RK 通路延迟影响。方案 B 的前/后两路延迟较高，答辩时要如实给出实测值。测量方法：在四个画面里都拍同一个毫秒计时器，拍照比较。

## 8. DDR3 地址映射与带宽

### 8.1 地址映射（字节地址，总容量 1 GB）

| 区域 | 起始 | 大小 | 内容 |
|---|---|---|---|
| HDMI_FB | 0x0000_0000 | 16 MB | HDMI 容器帧，3 帧 × 4 MB（每帧 4,147,200 B） |
| CAM1_FB | 0x0100_0000 | 4 MB | 3 帧 × 1 MB（每帧 1,036,800 B） |
| CAM2_FB | 0x0140_0000 | 4 MB | 同上 |
| DMA_BUF | 0x0180_0000 | 8 MB | 2 组乒乓 × 4 路 × 512 KB（每路 480×270×3 = 388,800 B） |
| 预留 | 0x0200_0000 | — | OSD 图元、调试抓帧 |

三缓冲的作用：30 fps 写入、60 fps 读出不撕裂；写端永远写"非读取帧"，读端取"最新完整帧"。

### 8.2 带宽估算

| 数据流 | 方向 | 带宽 |
|---|---|---|
| 2 路摄像头 960×540×2B×30 | 写 | 62 MB/s |
| HDMI 输入 1920×1080×2B×30 | 写 | 124 MB/s |
| 抽取帧 4×480×270×3B×15 | 写 | 23 MB/s |
| 显示 1920×1080×2B×60 | 读 | 249 MB/s |
| PCIe DMA | 读 | 23 MB/s |
| **合计** | | **约 481 MB/s** |

DDR3 峰值为 4.26 GB/s（32 位 × 1066 Mbps），占用约 11%。AXI 口需要一个 4 写 2 读的仲裁器，可在 `wr_rd_ctrl_top` 基础上扩展。

## 9. FPGA ↔ RK 接口（PCIe）

- **数据面：** FPGA 每完成一组 4 路抽取帧，就置位帧号并发中断，RK 通过 DMA 读走 DMA_BUF。
  - 官方 4_15 例程的 DMA 吞吐有限，且数据源不是 DDR3，需要重写（已列在 PCIe 工作线的计划里），并接入 DDR3 的 AXI 口。
  - 带宽需求约 23 MB/s，远低于链路能力，所以 Gen1 x1 降级运行也能用。
- **控制面：BAR0 寄存器草案**

| 偏移 | 方向 | 内容 |
|---|---|---|
| 0x000 | 只读 | 版本号 |
| 0x004 | 只读 | 状态：DDR 初始化 / HDMI 输入锁定 / CAM1、CAM2 初始化 / 各路帧率 |
| 0x008 | 读写 | 控制：显示模式 Q/T、容器来源请求（实拍/回放）、CH2/CH3 来源选择、DMA 使能、抽取帧率 |
| 0x00C | 只读 | 容器帧尾标签：最近一次解出的 32 位标签、有效位、白块/黑块实测值（量化范围） |
| 0x010 | 只读 | 最新完整帧号（每路一个字节） |
| 0x020 | 只读 | FPGA 感知结果：左右车道线虚/实与偏移、红绿灯状态、斑马线标志 |
| 0x030 | 只读 | 按键状态、当前车道、行驶/停止 |
| 0x040 | 读写 | RK 回写：决策（左/直/右/停）、报警位、导航箭头 |
| 0x080–0x0FC | 读写 | 检测框：最多 16 个 × {通道, 类别, x0, y0, x1, y1}（每个 2 个字） |

### 9.1 NPU 输入改为 FPGA 预处理后的四宫格拼图（2026-10-18 补充）

- **格式：** FPGA 把 4 路各自缩放，拼成一张图，直接按 NPU 输入张量排布（RGB888 交错，NHWC）写出，并带一个帧头（帧号、每路时间戳、通道编号、有效位）。
- **尺寸：** 两种可选：
  - 640×384 整图，每格 320×180；
  - 前方单独一张 640×384，其余三路拼一张。
- **算力：** 拼图不会让 NPU 变快。推理时间大致与输入像素数成正比，拼图只是让 4 路共用一次推理、取同一时刻，并摊薄每次推理的固定开销。
- **后处理：** 检测框按框中心所在的格子归到对应摄像头，按格子边界裁剪，NMS 按格分别做。
- **传输：** 写入 RK 保留内存中的环形缓冲（640×384×3 ≈ 737 KB/帧，15 fps 约 11 MB/s，PCIe 实测 896 MB/s，余量很大），NPU 用 `rknn_create_mem_from_phys` 直接读这块物理内存，不需要 CPU 拷贝。
- **板上已核实（10-18，只读）：**
  - librknnrt **1.5.0**（2023-05-25），导出了 `rknn_create_mem_from_phys`；RKNPU 驱动 v0.9.0；有 `rknn_server`。
  - reserved-memory 只有 ramoops 等小区域，CMA 共 16 MB，已全部分配。
  - 结论：环形缓冲需要在设备树里新增一段保留内存（8–16 MB）。这是对 RK 的持久修改，要用户同意。
- **前置条件：**
  1. FPGA 端要做视频源 DMA：把 10-18 做的长 MWr 引擎的数据源从内部 RAM 改为 DDR3，见 `PCIe_DMA提速_20261018.md` §7。
  2. RK 设备树要加保留内存。
  3. RK 端推理程序需要 aarch64 交叉编译环境（尚未搭好）。
  4. 模型要用 RKNN-Toolkit2 在 PC（Linux 或 WSL）上转换，量化校准图用实际拼图。

- **分工：**
  - FPGA 实时规则判决：红灯时行驶则报警，实线时强制变道则报警。按键和 LED 全在 FPGA 本地，不依赖 RK。
  - RK 负责 NPU 识别（行人、车辆、障碍物）和路径规划，结果写回 0x040/0x080 区，由 FPGA 的 OSD 叠加到画面上。

## 10. LED 与按键（按评测要求分配）

| 器件 | 管脚 | 功能 |
|---|---|---|
| LED0 | A20 | 左转（评测指定） |
| LED1 | C18 | 直行（评测指定） |
| LED2 | C19 | 右转（评测指定） |
| LED3 | E18 | 报警（同时叠加红框） |
| LED4 | A17 | PCIe 链路建立 |
| LED5 | A18 | DDR3 初始化完成 |
| LED6 | C17 | 两路摄像头都初始化完成 |
| LED7 | B17 | HDMI 输入锁定（闪烁 = 心跳） |
| KEY0 | C22 | 切换所在车道：左 → 中 → 右 |
| KEY1 | C23 | 行驶 / 停止 |
| KEY2 | B22 | 左转向 / 强制向左变道 |
| KEY3 | A22 | 右转向 / 强制向右变道 |
| KEY4 | B20 | 短按：显示模式 四宫格 Q ↔ 单路全屏 T；长按 ≥ 1 s：容器来源 实拍 ↔ 回放（经 BAR0 0x008 通知 RK） |

当前 PCIe 调试版本把 LED4–7 用作 RX 状态灯、KEY0 用作复位，合入视频工程时要按上表重新分配。

## 11. 上电与启动顺序

1. 两块板同时上电。
2. FPGA 从 QSPI Flash 加载比特流。**必须先固化**，目前是 JTAG 加载，掉电即丢失。
3. FPGA 依次完成：MS7200/MS7210 I2C 初始化 → OV5640 初始化（每路 257 条有效寄存器写入，循环 357 步；10-18 更正） → DDR3 校准。
4. RK 内核探测 PCIe。RK 只在启动时扫描一次，所以 FPGA 必须在此之前完成配置。从 Flash 加载的耗时需要实测确认。
5. RK 用户态服务自启动：
   - 强制 HDMI 输出 1920×1080@30；
   - 填充容器帧：模式 T 全屏播放 U 盘视频；模式 Q 下 W0/W1 按配置来自 U 盘视频（方案 A）或 RK 摄像头（方案 B/C），某个摄像头打不开时自动退回 U 盘视频；
   - 加载 PCIe 驱动和 NPU 程序。
6. 视频闭环不依赖第 4 步。PCIe 失败时只缺 AI 检测框，LED 和规则报警照常工作。

## 12. 可复用的官方代码

| 来源 | 文件 | 用途 |
|---|---|---|
| 50K `10_HDMI_DDR3_OV5640_test`（已解压到 `docs_ext/demo50k_ov5640/`） | `cmos_8_16bit.v`、`reg_config.v`、`i2c_com.v`、`power_on_delay.v` | DVP 采集与 OV5640 配置。注意：该例程用宏二选一，只显示 1 路摄像头，没有 HDMI 输入，也没有四分屏【确认，顶层 `:22-24, :250-261`】 |
| 100Pro+ `4_12_HDMI_IN_DDR3_HDMI_OUT`（fdc 和顶层已解压到 `docs_ext/demo100p_4_12/`） | `ms7200_ctl.v`、`ms7210_ctl.v`、`ms72xx_ctl.v`、`fram_buf.v`、`wr_rd_ctrl_top.v`、`sync_vg.v`（1080p）、DDR3 IP、fdc | HDMI 输入输出、帧缓存、1080p60 时序、100Pro+ 引脚约束 |
| 100Pro+ `3_2/3_4/3_6/3_8/3_9/3_11`（资料包 RAR） | YCbCr、二值化、中值、高斯、Sobel、字符叠加 | 预处理流水线和 OSD 文字 |
| `D:\pango_build\4_15_PCIE_DMA\` | PCIe x2 工程 | EP 和 BAR，DMA 待重写 |
| 资料包 `7_FMC扩展子卡及Demo/2_Demo/HDMI_DDR3_OV5640_100H/`（F 盘百度网盘下载目录） | 完整 PDS 工程 + fdc + `CMOS1/CMOS2.sbit` | **100Pro+ 上双目的官方例程**：摄像头引脚、OV5640 配置、DDR3 帧缓存，四宫格从这里改起最省事 |
| `D:\pango_work\demo_4_12_extract\`（10-17 从资料包解压） | 4_12 完整工程和 `HDMI_IN_DDR3_HDMI_OUT_top.sbit` | HDMI 输入 → DDR3 → HDMI 输出的环出测试 |

## 13. 待确认事项与风险

| # | 事项 | 怎么解决 |
|---|---|---|
| 1 | ~~MES-FMC-LPC-IO 子卡的 40 针 → FMC LA 映射未知~~ | **已解决（10-17）**：引脚取自官方 100H 双目例程 fdc（§5.2）。子卡手册在资料包 `7_FMC扩展子卡及Demo/3_Hardware/MES-FMC-LPC-IO硬件使用手册_v1.1(0408).pdf` |
| 2 | 手册中 LA08 与 LA23 重复（T19/U19） | 基本解决：例程用到了表外的 U25/U26。直接用例程引脚，不再依赖手册这一行 |
| 3 | VADJ 跳线 J20/J24 当前位置 | 上电前目视确认 **J20→ADJ、J24→2V5（2.5V）**，依据是官方双目说明书（10-18 更正，原写 3.3V） |
| 4 | OV5640 直接输出 960×540 是否正常 | 上板验证；不行就保持 720p 并在 FPGA 抽取 |
| 5 | RK 能否读到 MS7200 的 EDID，并输出 1080p30 | MS7200 内置可编程 EDID【确认，datasheet】；读不到时在 RK 上强制模式 |
| 6 | FPGA 从 Flash 加载的时间是否早于 RK 的 PCIe 探测 | 固化后做冷启动测试 |
| 7 | PCIe 链路间歇故障尚未解决 | 主线排查中；本架构下 PCIe 断开不影响视频闭环 |
| 8 | DDR3 多端口仲裁和 DMA 重写的工作量 | 先做单路 HDMI 闭环，再逐路增加 |
| 9 | FPGA 上只能接 1 个双目（FMC 引脚硬上限，§1.1），前/后两路必须经 RK 的 HDMI 进入 | 方案 A 先做通；要 4 路实拍就加方案 B（2 个 USB 摄像头，FPGA 侧不改）。答辩时说明：4 路都在 FPGA 内并行采集、处理和显示，其中 2 路由 RK 经 HDMI 转入 |
| 10 | 方案 B：USB 摄像头的格式、带宽和延迟；RK 端软件栈与构建环境 | 按 RK 端方案 §2 选型，§6 上板核实和分阶段验收；构建环境（PC 上目前没有 aarch64 交叉编译器）见该文 §5 |
| 11 | 方案 C：两个 OV5645 能否同时工作 | 核对 OK3568-UP4 原理图上 R62–R71 的 0R 装配，并查飞凌的设备树是否支持 2+2 lane |
| 12 | 原 FMC 表把 LA21、LA24–33 列为可用（已更正） | 已在 §5.2 标注 NC；新的引脚约束不要使用这些 LA |

## 14. 资料来源

- 赛题：`contest_pymupdf.txt:362-438`
- 100Pro+ 硬件手册：`fpga_docs/100pro_txt.txt`
  - 接口总览：`320-425`（JTAG `410-411`）
  - FMC：`2928-3236`（PG2L100H 为 NC 的注释：`3211`）
  - 按键和 LED：`2770-2820`
  - 时钟：`522-556`、`2878-2927`
  - HDMI：`2484-2630`
- 双目模块原理图：资料包 `4_IC_datasheet/OV5640/DOUBLE-DVP-OV5640-1113.pdf`（文本见 `docs_ext/scratch_cam/double_dvp_ov5640.txt`）
- MS7200 datasheet：`docs_ext/scratch_cam/ms7200.txt:30, 52`（EDID）
- 官方例程：`docs_ext/demo50k_ov5640/`、`docs_ext/demo100p_4_12/`
- FMC 子卡型号：`docs_ext/fpga_pkg/hsst_regs/sma_hsst_demo.txt:8,14`
- RK3568 摄像头输入：`docs_ext/scratch_rkdoc/hw.txt:2334, 3420-3427`（1 个 CSI PHY，支持 4 lane 或 2+2 lane）
- OK3568-UP4 底板：`docs_ext/scratch_sch/sch.txt:1158, 1257`（两个 `FPC26_OV5645_MIPI`）、`:1740`（USB2.0 Hub FE1.1s）、`:1874, 1986`（USB-A 双口、USB3.0 双口）
