Zdy-1110/FPGA-676/log/npu_freq_20261029.md

# NPU 频率与性能实测记录 (2026-10-29)

## 1. 测试环境与命令
- **测试平台**：飞凌 OK3568 (RK3568) + 紫光同创盘古 100Pro+ (PG2L100H) P29 PCIe 链路
- **模型**：`b5_v6n_band.rknn` (YOLOv8n INT8 定点化，960×320 带状输入)
- **单路测试命令**：
  ```sh
  ./usb_feed --bar1 0xf0204000 --dst 960x540 --slot0-rgb565 --video ... --npu b5_v6n_band.rknn --frames 300
  ```
- **浸泡测试命令**：
  ```sh
  /tmp/soak900.sh
  ```

## 2. 频率与推理耗时实测数据
- **600 MHz**：
  - `run:` 19.67/20.18/20.20/20.24/20.28/20.21/20.16/20.09/20.13/20.14 ms
  - 中位数：`20.14 ms`
  - 超时统计：`to:0`
- **900 MHz (`performance`)**：
  - `run:` 17.02/17.30/17.51/17.60/17.62/17.59/17.63/17.56/17.56/17.53 ms
  - 中位数：`17.55 ms`
  - 超时统计：`to:0`
  - 性能提升：`12.9%`

## 3. 5 分钟四路 900 MHz 浸泡稳定性
- **温度监控**：`soc-thermal 46.7–48.3 °C`
- **工作频率**：`cur_freq` 全程 900 MHz，无温控降频
- **欠载统计**：BAR1 `0x82C` 欠载恒 0
