Zdy-1110/FPGA-676/review/pango100pro_evidence.md

# 盘古 100Pro+（MES2L676-100HP）PCIe 独立证据审查

> **收束状态（2026-10-03）：本次 PERST / power-off 证据评审已完成，最终未证实点及唯一优先补证见第 11 节。硬件未放行，不能上电、不能下单。**

> **PERST / 独立上电优先补充：见第 10 节（2026-10-03）。本地 3.3 V 生成已确认；固定 PERST 外部上拉 / 卡边 3.3 V 出压仍未确认。**

- 审查日期：2026-10-03（Asia/Shanghai）。
- 范围：仅指定 FPGA 资料包的硬件指导手册、底板/核心板相关原理图资料、PCIe 通信测试与 PCIe DMA 示例/约束。
- 不包含：RK 资料、FPC 产品选型、工作区既有 PCB/原理图的审查或修改、嘉立创 EDA 设计操作。
- 所有原始资料只读。PCIe RAR 仅解包到系统临时目录；底板 SCH 仅在临时副本上尝试读取。指定工作区仅新增本报告。
- 未启动子智能体，也未启用 gpt-6-astra。

## 0. 结论与证据边界

**本次不能签署“卡边引脚及双独立电源互连已验证安全”的结论。** 已核实的是资料中的明确表述和工程中的实际配置；二进制底板 SCH 未取得可靠的连通图/网表，未找到核心板独立完整原理图。因此真实 PCIe 卡边接触号、卡边电源与外接 12 V 的关系以及 PRSNT/WAKE 实现仍未闭环。

优先级最高的发现：

1. **REFCLK 球位冲突**：S1 的 PCIe 表写 P=F13、N=E13；S2 的板级约束截图以及两套示例的板级 FDC 均使用 P=F11、N=E11。S1 的另一个章节又把 F13/E13 分配给底板 U4 的 125 MHz 时钟。工程配置可以确认；物理卡边到底连到哪一组，不能仅凭这些文字替代原理图证据。
2. **PERST 板级配置是 G24、低有效、3.3 V LVCMOS33 输入**；DMA 压缩包内的 IP 自带 example_design 约束另写 L4，不能把内层模板当作板级约束。
3. **lane reversal 配置冲突**：S2 要求启用；通信测试示例确实启用；DMA 示例的 IDF 与生成 RTL 却关闭。两套示例不是可以无条件混用的同一配置。
4. **PCIe 编号与 HSST 编号反序**：按 S1 两张表交叉核对，手册 PCIE 通道 0 对应 HSST 通道 3，PCIE 通道 3 对应 HSST 通道 0。这里是手册信号编号关系，不是已经核实的卡边 A/B 接触号，也不是反转 P/N 或 TX/RX。
5. **独立供电不是隔离证明**：S1 确认底板输入 +12 V，并由底板给核心板提供 +5 V；但没有取得可读证据证明 PCIe 电源脚与外接 +12 V 已隔离、经二极管 OR-ing 或具备反向阻断。

### 证据使用规则

- “手册确认”：能在指定页的表格/图中直接读出；不等于本次测量了实物或完整追踪了板间连接。
- “工程确认”：能在实际 IDF、FDC、RTL、PDS 中定位到对应内容；不等于焊接版本或已烧录镜像必然相同。
- “连通确认”：需要清晰的完整原理图线段/器件引脚，或经过正确解析的网表端点。本次对卡边与外接 12 V 尚不具备此类证据。
- **二进制中出现网名，绝不作为连通证明。** 未把标准 PCIe 接触号、原理图符号序号、板对板连接器脚号或 FPGA 球位相互替代。
- PDF 页码均为从 1 开始的文件物理页；另列印刷页码以避免页码偏移。

## 1. 原始资料完整路径与定位

| ID | 文件完整路径 | 用途及相关页 |
|---|---|---|
| S1 | `F:\BaiduNetdiskDownload\【竞赛】2026FPGA创新设计竞赛紫光同创杯资料包\盘古100Pro+开发板（MES2L676-100HP）配套资料\1_Demo_document\实验例程说明篇\教程1_硬件实验指导手册_盘古676系列100Pro+开发板.pdf` | 核心板供电 PDF 20-21（印刷 16-17）；核心板 J1/J3 表 PDF 28-29、32（印刷 24-25、28）；PCIe PDF 41-43（印刷 37-39）；U4 时钟 PDF 54（印刷 50）；底板供电 PDF 59-60（印刷 55-56） |
| S2 | `F:\BaiduNetdiskDownload\【竞赛】2026FPGA创新设计竞赛紫光同创杯资料包\盘古100Pro+开发板（MES2L676-100HP）配套资料\1_Demo_document\实验例程说明篇\教程2_通用实验指导手册_盘古676系列100Pro+开发板.pdf` | PCIe 章节 PDF 187、192-193、195（印刷 180、185-186、188）；图 13.3-8 的球位只能从截图视觉核对，不能靠正文提取 |
| S3 | `F:\BaiduNetdiskDownload\【竞赛】2026FPGA创新设计竞赛紫光同创杯资料包\盘古100Pro+开发板（MES2L676-100HP）配套资料\1_Demo_document\实验例程说明篇\教程4_《国产FPGA权威开发指南》教材配套实验指导手册_盘古676系列100Pro+开发板.pdf` | DMA 能力 PDF 175（印刷 168）；表 15.2-1 PDF 177（印刷 170）；上板 RC/EP 说明 PDF 214（印刷 207） |
| S4 | `F:\BaiduNetdiskDownload\【竞赛】2026FPGA创新设计竞赛紫光同创杯资料包\盘古100Pro+开发板（MES2L676-100HP）配套资料\3_Hardware\MES2L676底板设计资料\MES2L676-BASE-V1.2-供客户做底板.sch` | 二进制底板 SCH；没有可靠页码/连通图可引用，不能宣称已完成其电路连通审查 |
| S5 | `F:\BaiduNetdiskDownload\【竞赛】2026FPGA创新设计竞赛紫光同创杯资料包\盘古100Pro+开发板（MES2L676-100HP）配套资料\3_Hardware\点位图\MES2L676-BASE-V1.2-点位图.pdf` | 共 2 页，底板点位图，不是网络原理图；PDF 1 可定位 PCIe 卡边及器件，但不能证明网络连通 |
| S6 | `F:\BaiduNetdiskDownload\【竞赛】2026FPGA创新设计竞赛紫光同创杯资料包\盘古100Pro+开发板（MES2L676-100HP）配套资料\3_Hardware\点位图\MES2L676-CORE-V1.2-点位图.pdf` | 共 2 页，核心板点位图，不是核心板完整原理图 |
| A1 | `F:\BaiduNetdiskDownload\【竞赛】2026FPGA创新设计竞赛紫光同创杯资料包\盘古100Pro+开发板（MES2L676-100HP）配套资料\2_Demo\2_13_pcie_test.rar` | 通信测试原始 RAR；内部文件与行号见下表 |
| A2 | `F:\BaiduNetdiskDownload\【竞赛】2026FPGA创新设计竞赛紫光同创杯资料包\盘古100Pro+开发板（MES2L676-100HP）配套资料\2_Demo\4_15_PCIE_DMA.rar` | DMA 原始 RAR；内部文件与行号见下表 |

在可见硬件资料以及已审查的两套 PCIe 压缩包中，**没有找到核心板独立完整 SCH/PDF 原理图**。S1 包含部分核心板原理图截图与引脚表，不能替代完整核心板电路。

### PCIe 示例证据索引

以下“RAR 内路径”是归档成员定位，不是声称 F: 盘存在已解包文件。每项同时给出本次实际解包副本的完整路径。临时副本用于复核，最终依据仍是 A1/A2 的原始内容。

| ID | 原始归档与 RAR 内路径 | 本次可读副本完整路径 | 关键行号 |
|---|---|---|---|
| T1 | A1 → `2_13_pcie_test/2_13_pcie_test/pcie_test/ipcore/pcie_test/pnr/example_design/pango_pcie_top.fdc` | `C:\Users\Zdy\AppData\Local\Temp\pango100pro_review_20261003\2_13_pcie_test\2_13_pcie_test\2_13_pcie_test\pcie_test\ipcore\pcie_test\pnr\example_design\pango_pcie_top.fdc` | 82-85 PERST；97-105 REFCLK |
| T2 | A1 → `2_13_pcie_test/2_13_pcie_test/pcie_test/ipcore/pcie_test/pcie_test.idf` | `C:\Users\Zdy\AppData\Local\Temp\pango100pro_review_20261003\2_13_pcie_test\2_13_pcie_test\2_13_pcie_test\pcie_test\ipcore\pcie_test\pcie_test.idf` | 153-154 lane reversal；161-162 5 GT/s；339-340 X4；395-396 100 MHz；435-436 EP |
| T3 | A1 → `2_13_pcie_test/2_13_pcie_test/pcie_test/ipcore/pcie_test/pcie_test.v` | `C:\Users\Zdy\AppData\Local\Temp\pango100pro_review_20261003\2_13_pcie_test\2_13_pcie_test\2_13_pcie_test\pcie_test\ipcore\pcie_test\pcie_test.v` | 22-26 时钟/复位输入；42-45 数据方向；150-158 速度及 reversal；329-334 lane 数与数组映射；567、584-601 PHY 接口 |
| T4 | A1 → `2_13_pcie_test/2_13_pcie_test/pcie_test/ipcore/pcie_test/pnr/example_design/pango_pcie_top.pds` | `C:\Users\Zdy\AppData\Local\Temp\pango100pro_review_20261003\2_13_pcie_test\2_13_pcie_test\2_13_pcie_test\pcie_test\ipcore\pcie_test\pnr\example_design\pango_pcie_top.pds` | 14-16 PG2L100H、-6、FBG676；368-369 选用同目录 FDC |
| D1 | A2 → `4_15_PCIE_DMA/pnr/pango_pcie_top.fdc` | `C:\Users\Zdy\AppData\Local\Temp\pango100pro_review_20261003\4_15_PCIE_DMA\4_15_PCIE_DMA\pnr\pango_pcie_top.fdc` | 4 参考时钟 10 ns；50-54 x4 硬资源；93-96 PERST；108-116 REFCLK |
| D2 | A2 → `4_15_PCIE_DMA/ip/PCIe_IP/PCIe_IP.idf` | `C:\Users\Zdy\AppData\Local\Temp\pango100pro_review_20261003\4_15_PCIE_DMA\4_15_PCIE_DMA\ip\PCIe_IP\PCIe_IP.idf` | 134-135 EP；194-195 100 MHz；281-282 5 GT/s；430-431 X4；473-474 reversal=false |
| D3 | A2 → `4_15_PCIE_DMA/ip/PCIe_IP/PCIe_IP.v` | `C:\Users\Zdy\AppData\Local\Temp\pango100pro_review_20261003\4_15_PCIE_DMA\4_15_PCIE_DMA\ip\PCIe_IP\PCIe_IP.v` | 24-28 时钟/复位；44-47 数据方向；161-169 速度、reversal；340 HSST_LANE_NUM=4 |
| D4 | A2 → `4_15_PCIE_DMA/ip/PCIe_IP/pnr/example_design/pango_pcie_top.fdc` | `C:\Users\Zdy\AppData\Local\Temp\pango100pro_review_20261003\4_15_PCIE_DMA\4_15_PCIE_DMA\ip\PCIe_IP\pnr\example_design\pango_pcie_top.fdc` | 82-85 PERST=L4；97-105 的 E13/F13 REFCLK 行均以 `#` 注释，不能当作生效约束 |
| D5 | A2 → `4_15_PCIE_DMA/pnr/pg2l_pcie_dma.pds` | `C:\Users\Zdy\AppData\Local\Temp\pango100pro_review_20261003\4_15_PCIE_DMA\4_15_PCIE_DMA\pnr\pg2l_pcie_dma.pds` | 14-16 PG2L100H、-6、FBG676；304-305 使用外层 D1 |

## 2. PCIe 能力、用途及收发方向

### 2.1 能确认的资料与配置

- S1 PDF 41（印刷 37）描述的是 **PCIe x4 插卡形态**，可插入 PC 的 x4 插槽；四通道收发连接 FPGA HSST，单通道最高 5 GT/s，卡槽给板卡提供 100 MHz 参考时钟。
- S2 PDF 187（印刷 180）列明 IP 可选 EP、Legacy EP、Root Port，x1/x2/x4，以及 2.5/5 GT/s；这是 IP 配置能力，不代表当前样例是 RC，也不证明当前实物链路已建立。
- T2 与 D2 的明确 GUI 参数均为 **PCI Express Endpoint、X4、100 MHz、5 GT/s**。结合 S3 PDF 214（印刷 207）“PC 软件驱动作为 RC 端，盘古板为 EP 端”的实验说明，已审查样例按 EP 使用。
- S3 PDF 175（印刷 168）列明 DMA 例程支持 Gen1/Gen2 的 x1、x2、x4 模式；不能由此承诺任意裁减 lane 的中间板都能训练。
- S3 PDF 177（印刷 170）与 T3/D3 一致：`rxp/rxn` 是 FPGA 输入，`txp/txn` 是 FPGA 输出；`ref_clk_p/n` 与 `perst_n` 也是输入。这里的 TX/RX 方向以 **FPGA 板卡为参照**。

因此跨端方向只能在角色与端口定义确认后表达为“对端 TX → FPGA RX、FPGA TX → 对端 RX”，不能把两端相同字符串的 TX 网直接并起来。本报告没有审查另一端。

### 2.2 手册信号、FPGA 球位与核心板连接器的交叉表

依据：S1 PDF 42-43（印刷 38-39）的 PCIE 表 + PDF 28-29（印刷 24-25）的 **核心板 J1** 表。下列 J1 脚号不是 PCIe 卡边接触号；也不代表已经验证底板同名连接器的物理朝向。

| S1 的 PCIE 编号 | FPGA 发送 P/N 球位 | 核心板 J1 发送 P/N 脚 | HSST 发送编号 | FPGA 接收 P/N 球位 | 核心板 J1 接收 P/N 脚 | HSST 接收编号 | 本次验证的卡边接触号 |
|---|---|---|---|---|---|---|---|
| 通道 0 | D10 / C10 | 8 / 10 | TX3_QL3 | D12 / C12 | 1 / 3 | RX3_QL3 | 未确认 |
| 通道 1 | B9 / A9 | 14 / 16 | TX2_QL3 | B13 / A13 | 7 / 9 | RX2_QL3 | 未确认 |
| 通道 2 | D8 / C8 | 20 / 22 | TX1_QL3 | D14 / C14 | 13 / 15 | RX1_QL3 | 未确认 |
| 通道 3 | B7 / A7 | 26 / 28 | TX0_QL3 | B11 / A11 | 19 / 21 | RX0_QL3 | 未确认 |

这张表确认的是**两组手册表格间的编号反序关系**，不是本次获得的完整物理连通图。T3 行 329-334 的四路数组映射和硬核自动 reversal 也不能直接替代卡边接触号验证。

### 2.3 必须保留的不确定性

- 手册 PCIE 通道号与标准卡边 lane 号是否完全一致，未完成原理图闭环。
- 卡边正反面的 A/B 接触号、P/N 极性、卡边方向、原理图符号的 pin 编号如何对应，均不能用标准表推定成本板的“已验证接触号”。
- x1/x2 降宽时应保留哪组实物触点，及 lane reversal 对该配置的实际效果，尚未验证。
- 样例中的 `NUM_OF_LANES=5'b1` 是内部编码，**不能仅凭这个数字判定为 x1**；当前 X4 的依据是 IDF 的 `Maximum_Link_Width=X4`、RTL 的 `HSST_LANE_NUM=4` 以及四路端口。

## 3. REFCLK 球位：已发现明确冲突

| 证据 | P 球位 | N 球位 | 频率/用途 | 判断 |
|---|---|---|---|---|
| S1 PDF 43（印刷 39）PCIe 表 | F13 | E13 | 该节前页写卡槽 100 MHz | 手册声明，和板级示例相冲突 |
| S1 PDF 54（印刷 50）U4 原理图截图与表 | F13 | E13 | U4 125 MHz，`Q3_REFCLKP/N` | 手册图能读出 U4 输出经 C123/C122（0.1 uF）到 Q3_REFCLKP/N；不能据此证明卡边时钟与 U4 同网 |
| S1 PDF 28（印刷 24）核心板 J1 表 | F11 | E11 | `HSSTREFCLK0P/N_QL3`，J1=2/4 | 证明手册的第一组 HSST 时钟端口编号 |
| S1 PDF 29（印刷 25）核心板 J1 表 | F13 | E13 | `HSSTREFCLK1P/N_QL3`，J1=32/34 | 第二组独立的手册时钟端口编号，不能与 2/4 混淆 |
| S2 PDF 193（印刷 186），图 13.3-8 | F11 | E11 | 板级约束截图 | 视觉核实截图内容，截图列为 NOBANK |
| T1 行 97-105 | F11 | E11 | 生效板级 FDC | 工程配置确认 |
| D1 行 108-116 | F11 | E11 | 生效板级 FDC；行 4 的参考周期 10 ns | 工程配置确认 |
| D4 行 97-105 | F13 | E13 | 所有这些行被 `#` 注释 | 不是生效球位证据，不应混用 |

T1 的原始片段：

```tcl
define_attribute {p:ref_clk_n} {PAP_IO_LOC} {E11}
define_attribute {p:ref_clk_p} {PAP_IO_LOC} {F11}
```

**结论：可以确认板级示例使用 P=F11、N=E11、100 MHz；不能无条件确认卡边真实物理路径。** F13/E13 的手册 PCIe 条目高度可疑，可能与 U4 时钟条目混淆，但本次没有完整底板/核心板连通证据，不能把“可能误写”升级成已证明的原理图修正。

额外注意：T1/D1 的时钟端口还带有 `LVCMOS33` 属性，而 S2 的截图把这组 HSST 时钟标为 NOBANK。**不要据此把差分参考时钟按普通 3.3 V 单端 GPIO 设计**；该属性文本不足以证明模拟时钟的输入标准、摆幅或容限。

## 4. PERST：逻辑、电平配置及模板污染

明确证据：

- S1 PDF 43（印刷 39）：`PCIE_PERST → G24`。
- S1 PDF 32（印刷 28）核心板 J3 表：J3.9 → `L4_G3_18P_A22` → G24。此处证明手册中核心板侧对应脚，不证明卡边对应接触号。
- S2 PDF 193（印刷 186）图 13.3-8：`perst_n` 为输入，G24、BANKL4、VCCIO=3.3、LVCMOS33。
- T1 行 82-85 与 D1 行 93-96：输入、G24、3.3、LVCMOS33。
- S3 PDF 177（印刷 170）明确写：`perst_n` 为输入，**低有效、来自插槽 PERST#**；与调试用 `button_rst_n` 分开。

```tcl
# T1 行 82-85；D1 行 93-96 同样配置
define_attribute {p:perst_n} {PAP_IO_DIRECTION} {Input}
define_attribute {p:perst_n} {PAP_IO_LOC} {G24}
define_attribute {p:perst_n} {PAP_IO_VCCIO} {3.3}
define_attribute {p:perst_n} {PAP_IO_STANDARD} {LVCMOS33}
```

但 D4 行 82-85 的 **IP 自带内层 example_design** 写 `PAP_IO_LOC=L4`，且是生效行。D5 行 304-305 选择的是外层 D1。因此：

- 可确认该 DMA 板级工程选用 G24 的外层 FDC；不能说整个 RAR 中所有模板都适配此开发板。
- `L4` 是另一 FPGA 球位，不是 BANKL4 的缩写；不得因为截图标 BANKL4 就接受 `LOC=L4`。
- 不能由工程的 3.3 V 输入配置推断卡边上没有电平转换、输入 5 V 安全、另一端 1.8 V 可以直接驱动，或 FPGA 断电时不会通过输入反向供电。
- 实物的上拉电压/阻值、串联器件、保护器件、掉电容限及卡边 PERST 接触号均未核实。

## 5. lane reversal：不能混用的样例配置

| 证据 | 配置/说明 |
|---|---|
| S2 PDF 192（印刷 185） | 明确要求勾选 `Enable Lane Reversal`，否则 PCIe 实验失败 |
| T2 行 153-154 | `Enable_Lane_Reversal=true` |
| T3 行 156 | `AUTO_LANE_FLIP_CTRL_EN=1'b1` |
| D2 行 473-474 | `Enable_Lane_Reversal=false` |
| D3 行 167 | `AUTO_LANE_FLIP_CTRL_EN=1'b0` |

结合第 2 节的手册通道反序表，可以确认这是一项需要解决的工程一致性风险。但不能只看默认 IP 参数、只看教程截图或只看一个包里的模板就认定所有样例可直接上板。

本次没有重新编译、烧录或测试这些样例，不能断言 DMA 示例关闭 reversal 后一定失败，也不能断言它已经靠其他逻辑修正。需要先核实真实卡边到 HSST 的通道排列，再确认最终采用的 IP 参数、约束及烧录镜像。

## 6. 电源脚与外接 12 V 路径

### 6.1 能确认的供电段

依据 S1 PDF 59（印刷 55）的文字和原理图截图：

```text
底板外部电源要求：+12 V
截图中的电源段：DC12V → U25（SGM61163）的 VIN/PVIN → 开关输出及 L38 → A5V0
A5V0/底板 +5 V → 板对板连接器 → 核心板输入
```

- S1 PDF 59-60（印刷 55-56）：+5 V 经 MT2492 生成为底板使用的 +3.3 V；另一路生成 VADJ（2.5 V/1.8 V），并由 J20/J24 选择相关电压配置。
- S1 PDF 20-21（印刷 16-17）：核心板 `VCCIN` 输入要求 +5 V，通过板对板连接器供电；L6/L7 的 I/O 电源还需另外从板间连接器提供。**不能把底板的外接 +12 V 直接当成核心板的 VCCIN。**
- S1 PDF 21（印刷 17）列核心板 L3/L4/L5 I/O 电压为 3.3 V，与 PERST 的 BANKL4、3.3 V 工程配置一致。

以上只确认 **DC12V 至底板 +5 V，以及底板给核心板供电的说明**。该页没有完整画出外部插座、开关、保护/选择元件和 PCIe 卡边电源之间的关系。

### 6.2 不能确认的电源连接

本次没有可靠证据回答：

1. 卡边各 +12 V、+3.3 V、辅助电源触点的真实接触号及本板端点；不能用标准 CEM 表填入“已验证”。
2. 外部 +12 V 插座经过什么器件成为 `DC12V`；是否经过开关、保险丝、二极管、MOSFET 或理想二极管控制。
3. PCIe 电源轨和外部 +12 V 是硬并接、互斥选择、二极管 OR-ing、只读检测，还是完全不连接。
4. +3.3 V/辅助电源触点是否反接板载 +3.3 V；是否用于 WAKE 上拉/待机逻辑；断开这些触点是否会影响侧带信号。
5. 单侧掉电时，PERST/WAKE 或其他 I/O 是否仍可能反向供电。
6. 板上是否存在通过其他连接形成的第二条供电回路。

二进制 SCH 中检索到的 `PCIE_12V`、`12V_IN`、`DC12V` 等字符串，只能作为未来完整原理图的检索线索，**不能证明三者连通、不同名隔离或具有任何反向阻断能力**。

**对双独立电源方案的审查边界：**目前不能宣称“此 FPGA 板自带防反灌、因此卡槽供电脚可以直接保留”。也不能仅靠删除一个所谓电源层证明电气隔离。需要完整网络和器件方向证据后，才可确认应在转接板隔离哪些真实接触号；本次没有给出已验证的断脚清单，更没有改动现有设计。

## 7. PRSNT 与 WAKE

### WAKE

- S1 PDF 43（印刷 39）：`PCIE_WAKE → F24`，描述为 PCIe 唤醒引脚。
- S1 PDF 32（印刷 28）核心板 J3：J3.11 → `L4_G3_18N_VREF_A21` → F24。
- 以上为手册对应关系，**不是**对开漏驱动、待机电源、上拉、缓冲器或真实卡边接触号的确认。
- 已审查的 T3/D3 公开模块接口没有 `PCIE_WAKE`/`WAKE#` 顶层端口。不能因为 IP 内部可能存在 `wake` 名字，就认定它连接到了板卡 F24 或已实现卡边唤醒。
- 本次不能确认 WAKE 的驱动类型、低有效行为、外部上拉来源、掉电状态，也不能把 WAKE 当成已验证的可直接直通信号。

### PRSNT

- 本次可读手册的相关 PCIe 表和示例接口没有给出可验证的 PRSNT 卡边连接图。
- 二进制中的 `PCIE_PRSNT` 仅是字符串线索；不能证明 PRSNT# 触点短接、接地、串电阻或关联供電。
- 不能确认真实存在检测接触号、短接/下拉方式及其是否与独立供电冲突。也不能用通用“短接 PRSNT”建议代替本板证据。

## 8. 最终可确认 / 不能确认清单

### 可确认（均限于明确的资料/工程层面）

- [x] 该资料的 PCIe 接口为 x4 插卡形态，最高 5 GT/s；IP/示例支持 Gen1/Gen2。
- [x] 两套已审查样例的 IDF 按 EP、X4、100 MHz、5 GT/s 配置；没有据此假设另一端角色。
- [x] FPGA TX 是输出，RX 是输入，REFCLK/PERST 是输入；方向以 FPGA 端为参照。
- [x] 手册 PCIe 信号的 FPGA 球位及其与核心板 J1 脚号的交叉表；手册 PCIe 编号与 HSST 编号反序。
- [x] 板级工程 REFCLK=P:F11 / N:E11；与 S1 的 F13/E13 条目有明确冲突。
- [x] 板级 PERST=G24、低有效、3.3 V LVCMOS33；DMA 内层模板的 L4 不适合作为外层板级结论。
- [x] 通信测试启用 reversal，DMA 关闭，与教程要求不一致。
- [x] 外部底板电源要求 +12 V，底板 12 V→5 V，核心板 VCCIN 要求 +5 V；不能把 12 V 直接送入核心板。
- [x] 手册 WAKE 球位 F24、核心板 J3.11；但没有确认其完整电气实现。

### 不能确认 / 后续设计不能跳过

- [ ] 本 FPGA 板卡 PCIe 真实 A/B 接触号、接触面与全部信号/电源的最终对应。
- [ ] 卡边 REFCLK 到 F11/E11 的完整物理路径，以及 U4 125 MHz 支路与卡边时钟是否独立/选择/不装。
- [ ] 卡边与 FPGA 发射端 AC 耦合电容的实际位置、数值、装配状态和是否会重复串接。
- [ ] PCIe +12 V/+3.3 V/辅助电源触点与外接 +12 V、板载电源之间的关系和反向阻断能力。
- [ ] PERST 电平转换、上拉、保护及掉电容限；没有证明与任意另一开发板可直接互连。
- [ ] PRSNT 实际接触号和检测电路；WAKE 接触号、开漏/上拉及待机电源实现。
- [ ] 核心板完整原理图、实物版本/装配配置、当前烧录镜像与这些样例的对应关系。
- [ ] x1/x2 降宽可保留的真实触点及其训练结果；本次没有进行信号完整性或实物链路测试。

## 9. 闭环所需的最小补充证据

应取得与实物版本一致的、清晰可读的底板/核心板完整 PDF 原理图或导出的 ASCII 网表，至少覆盖：

1. PCIe 卡边符号，逐个显示 A/B 接触号、网络名和元件针号。
2. 全部 TX/RX、REFCLK 耦合电容和板间连接器端点；U4 与两组 HSST 参考时钟的连接/选择。
3. PERST、WAKE、PRSNT 的全部上拉、串联、缓冲、保护和供电。
4. 外部 12 V 插座、开关/保险丝/二极管/MOSFET、PCIe 各电源触点及 DC/DC 输入之间的完整路径。
5. 核心板板间连接器到 FPGA 球位的完整电路，以及实际板卡硬件版本/相关元件装配情况。

在这些证据补齐前，不能用本报告作为实际接触号放行表或双电源安全证明。本报告的价值是明确已经发现的资料矛盾，并阻止把未证实的网名/模板配置当成可靠设计输入。

## 附录 A. 提取和只读核验说明

- `pcb scan` 在当前可用运行环境中不可用，按用户允许的本地 Python/PDF 方式回退。
- 使用本地 PyMuPDF 提取 PDF 文本，并渲染/目视检查相关页，包括硬件手册的 PCIe 表/U4/供电图以及 S2 图 13.3-8；未把文字提取失败的截图当作没有内容。
- 使用系统 `tar` 读取 RAR 并解包到 `C:\Users\Zdy\AppData\Local\Temp\pango100pro_review_20261003`；没有在 F: 原目录内解包、保存或改写样例。
- 曾在系统临时目录的 SCH 副本上尝试以已安装 Altium 直接打开；未得到可靠电路内容或网表，因此**不以该尝试作为原理图已成功解析的证据**。未保存原始 SCH，也未操作用户的嘉立创 EDA 设计。
- SCH 在尝试前与尝试后读取的 SHA-256 一致：`eb49c64fdaf3a08e4b9a8affceab7a63ca7754ef9dd67ad9ec28664aad1a864f`。
- 下表为本次读取版本的指纹（除明确说明的 SCH 前后对照外，不把单次读取指纹包装成对所有文件的完整前后审计）。

| 原始文件 | 字节数 | SHA-256 |
|---|---:|---|
| `F:\BaiduNetdiskDownload\【竞赛】2026FPGA创新设计竞赛紫光同创杯资料包\盘古100Pro+开发板（MES2L676-100HP）配套资料\1_Demo_document\实验例程说明篇\教程1_硬件实验指导手册_盘古676系列100Pro+开发板.pdf` | 3504935 | `f2fb07625a0a31705d7e8477308f7bcb1aa5272b6b0754cfbf9daca20ebec114` |
| `F:\BaiduNetdiskDownload\【竞赛】2026FPGA创新设计竞赛紫光同创杯资料包\盘古100Pro+开发板（MES2L676-100HP）配套资料\1_Demo_document\实验例程说明篇\教程2_通用实验指导手册_盘古676系列100Pro+开发板.pdf` | 17393730 | `c6985c13d1c9c4054620e242fd75011ff33a4e5a26341b63a2d842da06dea5e1` |
| `F:\BaiduNetdiskDownload\【竞赛】2026FPGA创新设计竞赛紫光同创杯资料包\盘古100Pro+开发板（MES2L676-100HP）配套资料\1_Demo_document\实验例程说明篇\教程4_《国产FPGA权威开发指南》教材配套实验指导手册_盘古676系列100Pro+开发板.pdf` | 17339089 | `0138ad16c9c4e6dab61b598c0241ef3cab1550c50890d04bbc5f8f40766b89b9` |
| `F:\BaiduNetdiskDownload\【竞赛】2026FPGA创新设计竞赛紫光同创杯资料包\盘古100Pro+开发板（MES2L676-100HP）配套资料\3_Hardware\MES2L676底板设计资料\MES2L676-BASE-V1.2-供客户做底板.sch` | 309885 | `eb49c64fdaf3a08e4b9a8affceab7a63ca7754ef9dd67ad9ec28664aad1a864f` |
| `F:\BaiduNetdiskDownload\【竞赛】2026FPGA创新设计竞赛紫光同创杯资料包\盘古100Pro+开发板（MES2L676-100HP）配套资料\2_Demo\2_13_pcie_test.rar` | 19205045 | `8f0186c0558e93cb9e02aed018a6b86f92694cbd637c9a2c191404dce2adfd11` |
| `F:\BaiduNetdiskDownload\【竞赛】2026FPGA创新设计竞赛紫光同创杯资料包\盘古100Pro+开发板（MES2L676-100HP）配套资料\2_Demo\4_15_PCIE_DMA.rar` | 34637631 | `ea552d7121bbc7487a2741eba1dc28d634b30797bf851fff4e26f17a03c248f1` |

---

## 10. PERST / 独立上电专项补充（2026-10-03，供 native REV_B 决策）

本轮优先回答 PERST 上拉、电源来源和单侧掉电，不审查 RK/FPC，不研究 TI 器件，不修改 native REV_B。用户提出的“lane0/1 + REFCLK + PERST，WAKE/CLKREQ 默认 NC，正电源轨跨板全切”作为待验证的边界，不视为已经通过链路/安全测试。

### 10.1 优先答复表

| 问题 | 可确认结果 | 证据及限制 |
|---|---|---|
| PERST 的接收域与极性 | **已确认工程配置：G24 / BANK L4、低有效、3.3 V LVCMOS33 输入。** | S2 PDF 193（印刷 186）图 13.3-8；S3 PDF 177（印刷 170）；T1 行 82-85、D1 行 93-96。不是卡边电平转换/掉电容限证明。 |
| PERST 已有固定外部 3.3 V 上拉？ | **不能确认；也不是确认没有。** | 缺少完整 PERST 电路，不能给出电阻位号、阻值、供电网和装配状态。 |
| FPGA 是否有启动内部弱上拉？ | **手册确认：默认在进入用户模式前使能所有用户 IO 内部弱上拉。** | S1 PDF 23-24（印刷 19-20），2.1.2.2.4 上电 IO Status。不证明配置完成后 G24 仍上拉，更不证明有固定外部上拉。 |
| 本地 3.3 V 从独立 12 V 供电树生成？ | **是，图示可确认；须区分底板和核心板支路。** | S1 PDF 21、59-60（印刷 17、55-56）：底板 12 V→5 V→MT2492/A3V3；核心板 5 V→EZ8303/3.3 V→L3/L4/L5。 |
| PERST 真实外部上拉接到哪条本地 3.3 V？ | **不能确认。** | 存在本地电源不等于该电源经过电阻连接 PERST。 |
| Pango 独立 12 V 上电时，PCIe 3.3 V 触点会出压？ | **不能确认“会”或“不会”。** | 尚未取得金手指触点到 A3V3/核心板 3.3 V 的完整连通关系，也没有实测触点电压。不能默认从该触点给缓冲取电。 |
| 电源轨全切后，PERST 直接贯通安全？ | **尚未验证，现有证据不能放行直通。** | 切断正电源没有证明 G24 的掉电输入容限，也未消除侧带可能的注入路径。 |

“不能确认”不应被替换为“没有电阻”“卡边没电”或“可以直接连”。

### 10.2 本地供电：真实局部原理图与框图证据

**完整源文件：** `F:\BaiduNetdiskDownload\【竞赛】2026FPGA创新设计竞赛紫光同创杯资料包\盘古100Pro+开发板（MES2L676-100HP）配套资料\1_Demo_document\实验例程说明篇\教程1_硬件实验指导手册_盘古676系列100Pro+开发板.pdf`。

- **PDF 59 / 印刷 55，底板局部原理图**：DC12V → U25（SGM61163）的输入 → 开关输出及 L38 → A5V0。
- **PDF 60 / 印刷 56，底板局部原理图**：U26（MT2492）VIN=5 接 A5V0；SW=6 经 L20（2.2 uH）到 A3V3，输出节点同时接去耦电容和 TP2。图示底板 A3V3 明确是本板 12 V→5 V→3.3 V 的降压输出，不需要把卡槽 3.3 V 作为这条生成路径的输入。
- **PDF 20 / 印刷 16**：核心板 VCCIN 需要 5 V，来自板对板连接器。
- **PDF 21 / 印刷 17，供电框图**：5 V 经 EZ8303 生成 3V3@3A，箭头指向 BANK L3/L4/L5；功能表也把这条 3.3 V 列为 L3/L4/L5 的 I/O 电源。PERST G24 的 L4 工程接收域与此一致。

限制：U25/U26 的截图没有 PCIe 金手指和 PERST，所以不能证明 U26 的输出送到金手指或 PERST 上拉。核心板一项是电源框图证据，不是完整核心板原理图。

**底板 MT2492 的 3.3 V 与核心板 EZ8303 的 3.3 V 需要分别识别，不能凭标称电压相同或同名网认定硬并接。** 即使两支路最终都来自同一个外部 12 V，仍没有验证上电顺序、掉电顺序及 power-good 条件；“底板 A3V3 出现”不等于“G24 的 VCCIO 已经有效”。

这也不等于已经证明切掉卡槽所有电源后 PCIe 全部功能和时序都满足要求；旁路/待机用电等仍缺完整电路证据。

### 10.3 启动弱上拉：有阶段限制，不是 PERST 外部电阻

S1 **PDF 23 / 印刷 19**明示：控制用户 IO 内部弱上拉的功能复用 IO，在“上电完成后到进入用户模式之前”起作用；该脚为 0 时使能内部上拉，核心板默认将它接 GND。**PDF 24 / 印刷 20**画的是 IO_STATUS 配置支路，不是 PCIE_PERST 电路。

可确认和不能确认应分开：

1. 按手册默认装配，上述阶段会使能用户 IO 的内部弱上拉。结合 G24 为 L4 用户 IO 的资料，应将它作为启动行为考虑；没有实测 G24 电压、弱上拉阻值或实际装配状态。
2. 不能据此确认 PERST 有固定外部上拉，也不能证明其配置完成后的上拉状态。
3. T1、D1 对 `perst_n` 只明确 Input、G24、3.3、LVCMOS33，**这两个端口约束块没有显式 pull-up/keeper 属性**。不能从这四行推出用户模式下有确定上拉。
4. IO_STATUS 配置电阻、其他 RESET/JTAG/按键电路的上拉不是 PERST 上拉证据；`button_rst_n` 也不是卡边 PERST。
5. 对低有效 PERST，未被外部有效拉低时，启动弱上拉可能使它向“释放复位”的方向变化。这是待验证状态风险，不是本次实测结果。

**不要以“Pango 启动时有内部弱上拉”为理由省掉 REV_B 的确定上拉、失效安全默认态和掉电隔离。**

### 10.4 给 REV_B 的电源域 / 缓冲边界（推导要求，不是 TI 选型结论）

- 正电源跨板隔离与 PERST 侧带掉电安全是不同事项。全切 +12 V/+3.3 V/辅助电源不能证明 G24 安全；GND 和连续信号参考地不属于要切断的正电源轨。
- 若选择具备适当掉电保护的开漏/开集缓冲，上拉应引用 **G24 所在接收域实际有效的本地 3.3 V/VCCIO**，不应为了上拉重新把另一板的 3.3 V 跨排线接进来。
- 目前不能确认 PCIe 金手指 3.3 V 是上述本地接收域的取电点。不要默认用它作缓冲 VCC/上拉电源；应先确认正确触点网络，或使用另外已验证的本地供电点。
- 如后续发现已有外部上拉，先核对位号/阻值/电源域再决定是否装 REV_B 额外上拉；不能凭 UNKNOWN 删掉选位，也不要在未知已有电阻时盲目并加强上拉。
- **Ioff / 输出高阻不等于复位保持有效。** 例如缓冲由 RC 供电，RC 断电后输出高阻，而 Pango 上拉仍有效，PERST 就可能被拉高、即释放复位。缓冲供电域、未供电输入默认值和 RC 失效时的输出态必须共同定义。
- 若缓冲由 Pango 接收域供电，则“RC 已供电、Pango 未供电”要验证输入和输出的实际掉电容限；若由 RC 供电，则“RC 未供电、Pango 已供电”要处理上拉是否释放复位。不能只验证一个方向。
- 正常释放复位还要服从 FPGA 实际加载、接收域电源和参考时钟条件；本次没有验证具体时序数值或最终镜像。

没有查阅 SN74LVC1G07 或其他 TI 器件资料，不对该型号的电气能力作结论。**当前不应把直通当成已验证安全默认；保留适当掉电隔离的缓冲路径与接收端上拉选位是保守候选，但具体型号、供电侧和默认复位逻辑仍由你完成器件级验证。**

### 10.5 独立上电需要覆盖的状态表

| RC 端 | Pango 接收域 | 必须明确 / 验证 |
|---|---|---|
| 未供电 | 未供电 | 无侧带构成的任一方供电路径；未供电端不被有源强驱。 |
| 已供电 | 未供电或上电中 | RC 的 PERST 高/低不能注入未有效的 G24 接收域；缓冲供电与容限匹配。 |
| 未供电或掉电 | 已供电 | 明确定义复位状态。如果要求保持复位，就不能以“输出高阻 + 本地上拉 = PERST 高”作为安全默认。 |
| 已供电 | 已供电、FPGA 未就绪 | 不把局部 3.3 V 出现当成可释放复位；纳入加载、时钟、上电条件。 |
| 有效 | 就绪 | 低/高电平及释放逻辑正确；再单独关断任一端仍满足上述要求。 |

这只是待验证清单，没有任何一行代表已经执行实物测试。

### 10.6 对最小互连边界的有限说明

WAKE/CLKREQ 不经转接板，意味着本转接板不新增这两条跨板侧带路径；不证明板卡的待机/时钟管理逻辑兼容。本次未取得本板 CLKREQ 完整电路。

只留两组 lane 时，原 x4 示例不能被当成已验证的 x2 配置；原报告的通道反序及 lane reversal 冲突仍存在，本次未验证所称 lane0/1 的真实触点。没有扩展审查 RK/FPC。

### 10.7 本轮查找边界和最小待补证据

- 仍未获得包含本板 PCIe 金手指/PERST 的完整原理图 PDF。可读局部原理图仅支持 U25/U26 供电段，不能填补 PERST 上拉和卡边出压结论。
- 工作区 `E:\Project\nesai2026\fpga_docs\教程1_硬件实验指导手册_盘古676系列100Pro开发板.pdf` 的内容身份和 SHA-256 与 S1 一致：正文也是 MES2L676-100HP，不是一份新增完整原理图。没有读取同目录 RK 内容。
- 二进制底板 SCH 隔离副本的正规导入尝试仍未得到可靠图页/网表，不能作为成功解析证据。原件 SHA-256 前后仍为 `eb49c64fdaf3a08e4b9a8affceab7a63ca7754ef9dd67ad9ec28664aad1a864f`。
- 最小补证只有两组：**① PERST 整段电路：上拉位号/阻值/电源、保护和转换；② PCIe 3.3 V 真实触点到板载 A3V3/核心板 3.3 V 的连接，以及单独 12 V 供电时触点电压。**
- 实物通断/电压测试必须先核对正确触点和方向，不按未核实的通用脚表盲测，更不能带电测通断。本次没有实物测量。

**当前最简答复：本地 3.3 V 来自独立 12 V 的生成支路已确认；固定 PERST 外部上拉和 PCIe 3.3 V 触点出压仍未确认。不能因此放行 PERST 直通，或默认利用卡边 3.3 V 给缓冲取电。**

---

## 11. 收束结论：PERST / power-off tolerances（2026-10-03）

**任务状态：本次证据评审已完成收束；未证实项目保留为未证实，不再扩展调查，也不等待补证继续运行。任务完成不等于硬件安全放行。当前 PCB 仍不能上电、不能下单。**

本收束轮仅核查已有 FPGA PDF 的明确电路/规范文字，不分析二进制连通性、不导入 SCH、不操作 EDA、不读取或修改生成器、不启动子 agent。没有进行实物测量、带电试验或器件选型。

### 11.1 新增的明确器件规范证据

- **N1 完整路径：** `F:\BaiduNetdiskDownload\【竞赛】2026FPGA创新设计竞赛紫光同创杯资料包\盘古100Pro+开发板（MES2L676-100HP）配套资料\4_IC_datasheet\FPGA\DS04001_Logos2系列FPGA器件数据手册.pdf`。
- **资料版本：** DS04001 v1.5，文档日期 2020-11-10，43 页；只核查了这份已有本地版本，不宣称它是最新规范。
- **源文件 SHA-256：** `2debe19896f92864fd5cda743796bd3ec4f06019921e4df1a4b957ef52d5efee`。
- N1 的 PDF 物理页码与印刷页码一致。相关表格已结合页面图像核验，不以文本串出现替代电路连通。

| 直接证据 | 可以确认的规范文字 | 不能由它推导的保证 |
|---|---|---|
| N1 第 17 页，表 2-1 | 通用 I/O 输入绝对极限列为 -0.3 V 至 VCCIO+0.45 V；超过极限可能永久损坏。 | 不能由“LVCMOS33”推导 VCCIO=0 时可持续直接承受外部 3.3 V。未取得 G24 专项掉电例外条款。 |
| N1 第 17 页，表 2-2 | 通用 VIN 推荐范围 -0.2 V 至 VCCIO+0.2 V；IIN 最大 10 mA 的说明明确覆盖上电或未上电 Bank 的引脚正偏钳位二极管。 | 10 mA 是钳位电流限制，不是 Ioff 保证、无反灌保证或推荐注入电流；本报告不以此给出串联电阻放行方案。 |
| N1 第 18 页，2.3 / 表 2-3 | 在“推荐工作条件”下 IL 最大 15 uA；IPU 在 VIN=0、VCCIO=3.3 V 时为 90-330 uA。 | IL 不是明确列有 VCCIO=0 条件的 Ioff 规格。IPU 是 PAD 上拉电流，不能转换成已存在的 PERST 固定外部电阻或证明用户模式持续启用上拉。 |
| N1 第 20 页，3.1；第 2 页修订记录 | 明确写“除专用 I/O 和复用 I/O 外，其它 I/O 均支持二级热插拔”；v1.5 修订记录再次说明这一排除条件。 | 不是“全部 FPGA 引脚掉电安全”的声明；现有资料没有完成 G24 在该条款中的分类、适用条件及 Ioff/长期输入容限确认。 |
| N1 第 20 页，表 3-1 | LVCMOS33 正常输入逻辑门限：VIL 最大 0.8 V、VIH 最小 2.0 V。 | 正常有电的逻辑门限不等于未供电输入容限；不能据此放行 PERST 直通。 |

**对热插拔条款作完整保留：**本报告并不是断言器件完全不支持热插拔，而是没有证明 G24 及其板级 PERST 路径满足该条款。既不忽略“支持二级热插拔”，也不越过专用/复用 I/O 的排除条件。

硬件指导手册 S1（`F:\BaiduNetdiskDownload\【竞赛】2026FPGA创新设计竞赛紫光同创杯资料包\盘古100Pro+开发板（MES2L676-100HP）配套资料\1_Demo_document\实验例程说明篇\教程1_硬件实验指导手册_盘古676系列100Pro+开发板.pdf`）第 32 页给出 G24 名称 `L4_G3_18P_A22`、核心板 J3.9。**该名称本身不在本报告中被当作它属于或不属于上述排除类别的证明。**第 23 页的启动内部弱上拉说明仍限于进入用户模式前，不能替代 PERST 完整电路或掉电规范。

### 11.2 最终未证实点

1. **PERST 的固定外部上拉：**未取得电阻位号、阻值、装配状态及真实上拉电源网；不能称“已有确定 3.3 V 上拉”，也不能称“确认没有上拉”。
2. **G24 的 power-off / Ioff：**没有取得明确针对 G24、VCCIO=0 及外部 PERST 高电平的持续容限、泄漏/注入上限及适用条件；正常 IL、钳位电流上限和有限热插拔文字均不足以单独证明直通安全。
3. **PCIe 3.3 V 触点是否出压：**本地电源生成已有局部图示，但没有证明金手指触点与这些电源网的真实连接，也没有单独 12 V 供电时的触点实测电压。
4. **卡边 PERST 到 G24 的完整保护路径：**未确认所有串联、缓冲、转换、钳位及板间连接器端点，因而不能证明两端独立上电时无注入/反供电。

以上均明确为“未证实”，不是凭二进制字符串、原理图网名相似或标准 PCIe 脚表得到的结论。

### 11.3 当前 PCB 边界：仅记录用户说明，不作核验背书

按用户提供的当前状态记录：

- SB1 的 PERST 两端已分网，默认 OPEN。
- 四层 GND 边界排除全部接点区。
- 当前评审 PCB **不能上电、不能下单**。

本轮没有打开 EDA 或检查实际 PCB，所以没有独立确认上述状态，也没有将 SB1 默认 OPEN 或 GND 边界处理表述为完整电气/信号完整性验收。没有将本轮“评审完成”表述为允许闭合 SB1、接入开发板或下单生产。

### 11.4 仅一项优先最小补证

**向板卡厂家索取一页或一张拼接图：与实物版本一致的 PCIe PERST# 完整局部原理图，从真实卡边触点一直显示到核心板 G24，并完整显示该线的上拉电阻位号/阻值、所接电源网及全部串联/缓冲/转换/保护器件。**资料标识 BASE/CORE V1.2 可作为检索线索，最终必须匹配实物版本。

这是本轮唯一优先补充项；不再新增测量任务，不建议在当前禁止上电的评审 PCB 上施加 3.3 V 或闭合 SB1 来猜测掉电容限。该图优先解决实际线路及上拉证据，**即使取得，也不会自动产生 G24 的 Ioff 规范保证**，因此不提前承诺硬件放行。

第 9/10 节的较完整历史待验证清单保留作背景，不代表本收束任务继续执行或要求用户一次提交多项证据。

**最终状态：证据报告收束完成；PERST 直通/掉电安全未获证明。维持用户规定的 OPEN、禁止上电/下单状态；不操作 EDA、不修改生成器、不启动子 agent。**
