Zdy-1110/FPGA-676/tools/docs_figs/arch_overview.html

车载 ADAS 异构感知平台 · 软硬件框架

紫光同创 PG2L100H FPGA × 瑞芯微 RK3568 SoC ｜ 控制走 MMIO · 数据走零拷贝 DMA · 显示走全硬件流水线

FPGA 位流 cam23 · 0x20261106

感知与人机输入

3 × UVC USB 摄像头

MJPEG 1280×720

后视 / 左后 / 右后

U 盘评测素材

MP4（H.264 / H.265）· JPG / PNG

中文文件名

四路摄像头布置

FMC 前视摄像头

OV5640 · 1280×720

前视主通道（DVP 直连 FPGA）

5 个板载按键 KEY0–4

换道 · 起步/停车 · 转向 · 菜单

RK3568 SoC（飞凌 OK3568-C）· 软件栈

4 × Cortex-A55 2.0 GHz ｜ NPU 1 TOPS INT8 ｜ MPP ｜ RGA ｜ Linux 5.10

应用
交互层

run_boot.sh

开机自启 · 0x838 版本握手

mode_select

开机二选一：实时监控 / U 盘测评

menu_daemon

实时四路监控 · 3×3 参数浮窗

usb_menu

U 盘测评 · 中文界面 · 1–4 路 / 单路满屏

感知
决策层

NPU · YOLOv6n INT8

960×320 道路带 · 9 类目标 · 17.55 ms/帧

tl_det 红绿灯识别

纯 C99 · 0 malloc · 4–6 ms（PC 基准）

adas 决策状态机

红绿灯 + 车道线 + 障碍物 + 按键 → 箭头 / 告警

导航示例 示例

.nav 路线文件驱动

媒体
调度层

usb_feed

多线程零拷贝推流流水线

MPP 硬件解码

MJPEG / H.264 / H.265 → NV12

RGA 2D 加速

缩放转色 960×540 ×4 · 道路带 960×320

quad_sched

四路 NPU 加权轮询 2:1:1:1

fcam_rb 前摄回读 cam19+

FPGA 前视画面 → NPU / 红绿灯 · 15 fps

驱动
内存层

V4L2 / UVC + 夜视 夜视

3 路采集 · usb_night 亮度自适应三档参数

CMA 256 MB + dma-buf

物理连续内存 · 零拷贝 · 缓存回写

RKNN Runtime

NPU INT8 推理

PCIe RC + BAR 映射

MMIO 寄存器 · DMA 门铃

PCIe Gen2 ×2 · MPS 256

实测 896 / 861 MB/s · 5 分钟双向压测 0 错误

↓

视频帧 DMA（RK → FPGA）

门铃 0x190–0x19C · FPGA 主动拉取四路帧

↑

前摄回读 MWr（FPGA → RK）

DDR3 → CMA · 3.2 ms/帧

⇅

控制 / 状态 MMIO（双向）

检测框 0x900 · 文本 0xC00 · 决策 0x850 · 车道 0x8D0 · 车道统计 0x8F4

PG2L100H FPGA（紫光同创盘古 100Pro+）· 硬件流水线

LUT 36.5% ｜ FF 19.4% ｜ DRM 64.8% ｜ APM 25.4% ｜ WNS +0.050 ns · TNS 0

接入

PCIe 端点 + SG-DMA

16 深门铃队列 · DMA 读 / MWr 写

OV5640 采集 cam23

FMC DVP 输入 · 双缓冲 · SCCB 调参

rt_keys

5 键消抖 · 短按 / 长按事件

rt_ext_regs

BAR1 寄存器池 0x800–0xCFF

帧存

rt_ddr_hub

DDR3 1 GB · 32 bit

400 MHz

4 槽视频帧缓冲

独立 Commit：

消隐期换帧，无撕裂

流式感知（前视通道）

rt_night 夜间增强 合成暗化验证

亮度统计 · AUTO 迟滞 · γ 0.5 查找表

rt_lane_det 车道线 cam22

单遍流式最小二乘拟合 · 虚 / 实 / 双黄

逐帧统计 0x8F4 → RK 桶式判定

rt_zebra_det 斑马线 实验性

流式条纹统计

VIEW 图像模式

原彩 / 灰度 / 二值化

显示合成

rt_disp_win_reader

四宫格 4 × 960×540 → 1920×1080

rt_zoom_ana cam19+

ZOOM2X 单路 2 倍满屏

rt_osd 图层叠加

16 检测框 · 4×64 字符

24×24 箭头 · 全屏告警红框

输出

MS7210 HDMI 发送

1080p60 · 148.5 MHz

LED0–3

LED3 = 告警指示

面向驾驶员的功能

四路环视 · 硬件四宫格拼接

车道线虚实识别 · 变道合规提示

红绿灯识别 · 闯红灯告警

行人 / 骑行者 / 锥桶 / 路障 / 前车近距预警

限速标志提示

两级夜视（FPGA + USB 摄像头）

合成/模拟暗场

路线文件导航

示例

单路 2 倍满屏放大

cam19+

中文界面 · 5 键全操控

HDMI 1080p60 显示

前视 · FMC / U 盘

后视

左后

右后

两级夜视协同 合成/模拟暗场

FPGA rt_night γ0.5 + USB 摄像头三档成像参数 · 0x800[11:10] 统一开关

896 MB/s

PCIe Gen2 ×2 实测吞吐（FPGA → RK）

双向压测 0 错误

119.4 fps

四路 960×540 并发合计帧率

PCIe 总线负载 ≤ 14.5%

1080p60

硬件四宫格 + OSD 叠加

独立 Commit 无撕裂

17.55 ms

NPU YOLOv6n INT8 单帧（900 MHz）

验证集 mAP50 66.05%

63 / 69

红绿灯官方用例通过

tl_det 单帧 4–6 ms

36.5%

FPGA LUT 占用（cam23）

DRM 64.8% · WNS +0.050 ns

视频帧 DMA

前摄回读

控制 / 状态 MMIO

功能边界

cam19–cam23 新增

数据来源：技术文档最终稿 · cam19–cam23 板测与构建报告（2026-11-03）
