Zdy-1110/FPGA-676/tools/board_eval/out/report.csv

case_id | video | category | lane_or_side | command | expected | expected_code | t_start | t_end | conf | n_frames | match_ratio | status | dominant_pred | first_ok_s
SIG-112454-01 | 112454 | SIG | 左 | 无/停止 | 停车，不亮方向灯 | STOP | 0.0 | 3.55 | high | 4 | 1.0000 | PASS | STOP | 0.300
SIG-112454-02 | 112454 | SIG | 左 | 按键强制行驶 | 报警（LED3/红色叠加） | ALARM | 0.0 | 3.55 | high | 4 | 1.0000 | PASS | ALARM | 0.300
SIG-112454-03 | 112454 | SIG | 直 | 无/停止 | 停车，不亮方向灯 | STOP | 0.0 | 3.55 | high | 4 | 1.0000 | PASS | STOP | 0.300
SIG-112454-04 | 112454 | SIG | 直 | 按键强制行驶 | 报警（LED3/红色叠加） | ALARM | 0.0 | 3.55 | high | 4 | 1.0000 | PASS | ALARM | 0.300
SIG-112454-05 | 112454 | SIG | 右 | 行驶 | 右转不受灯控，通行（LED2） | GO | 0.0 | 3.55 | mid | 4 | 1.0000 | PASS | GO | 0.300
SIG-112507-01 | 112507 | SIG | 直 | 行驶 | 通行，亮直方向LED（LED1）并叠加箭头 | GO | 10.5 | 12.5 | high | 3 | 1.0000 | PASS | GO | 0.000
SIG-112507-02 | 112507 | SIG | 右 | 行驶 | 右转不受灯控，通行（LED2） | GO | 10.5 | 12.5 | mid | 3 | 1.0000 | PASS | GO | 0.000
SIG-112507-03 | 112507 | SIG | 直 | 行驶 | 通行，亮直方向LED（LED1）并叠加箭头 | GO | 12.5 | 13.5 | high | 2 | 1.0000 | PASS | GO | 0.100
SIG-112507-04 | 112507 | SIG | 右 | 行驶 | 右转不受灯控，通行（LED2） | GO | 12.5 | 13.5 | mid | 2 | 1.0000 | PASS | GO | 0.100
SIG-112507-05 | 112507 | SIG | 左 | 行驶 | 通行，亮左方向LED（LED0）并叠加箭头 | GO | 22.5 | 23.5 | mid | 2 | 1.0000 | PASS | GO | 0.300
SIG-112507-06 | 112507 | SIG | 直 | 行驶 | 通行，亮直方向LED（LED1）并叠加箭头 | GO | 22.5 | 23.5 | high | 2 | 1.0000 | PASS | GO | 0.300
SIG-112507-07 | 112507 | SIG | 右 | 行驶 | 右转不受灯控，通行（LED2） | GO | 22.5 | 23.5 | mid | 2 | 1.0000 | PASS | GO | 0.300
SIG-112507-08 | 112507 | SIG | 左 | 行驶 | 通行，亮左方向LED（LED0）并叠加箭头 | GO | 23.5 | 25.0 | mid | 2 | 1.0000 | PASS | GO | 0.200
SIG-112507-09 | 112507 | SIG | 直 | 行驶 | 通行，亮直方向LED（LED1）并叠加箭头 | GO | 23.5 | 25.0 | high | 2 | 1.0000 | PASS | GO | 0.200
SIG-112507-10 | 112507 | SIG | 右 | 行驶 | 右转不受灯控，通行（LED2） | GO | 23.5 | 25.0 | mid | 2 | 1.0000 | PASS | GO | 0.200
SIG-112507-11 | 112507 | SIG | 左 | 行驶 | 通行，亮左方向LED（LED0）并叠加箭头 | GO | 39.0 | 40.0 | mid | 2 | 1.0000 | PASS | GO | 0.000
SIG-112507-12 | 112507 | SIG | 直 | 行驶 | 通行，亮直方向LED（LED1）并叠加箭头 | GO | 39.0 | 40.0 | high | 2 | 1.0000 | PASS | GO | 0.000
SIG-112507-13 | 112507 | SIG | 右 | 行驶 | 右转不受灯控，通行（LED2） | GO | 39.0 | 40.0 | mid | 2 | 1.0000 | PASS | GO | 0.000
SIG-112739-01 | 112739 | SIG | 左 | 无/停止 | 停车，不亮方向灯 | STOP | 58.0 | 64.0 | mid | 9 | 1.0000 | PASS | STOP | 0.500
SIG-112739-02 | 112739 | SIG | 左 | 按键强制行驶 | 报警（LED3/红色叠加） | ALARM | 58.0 | 64.0 | mid | 9 | 1.0000 | PASS | ALARM | 0.500
SIG-112739-03 | 112739 | SIG | 左 | 无/停止 | 停车，不亮方向灯 | STOP | 64.0 | 77.0 | mid | 20 | 0.8500 | PASS | STOP | 0.500
SIG-112739-04 | 112739 | SIG | 左 | 按键强制行驶 | 报警（LED3/红色叠加） | ALARM | 64.0 | 77.0 | mid | 20 | 0.8500 | PASS | ALARM | 0.500
SIG-113343-01 | 113343 | SIG | 左 | 无/停止 | 停车，不亮方向灯 | STOP | 12.5 | 14.0 | high | 1 | 1.0000 | PASS | STOP | 0.400
SIG-113343-02 | 113343 | SIG | 左 | 按键强制行驶 | 报警（LED3/红色叠加） | ALARM | 12.5 | 14.0 | high | 1 | 1.0000 | PASS | ALARM | 0.400
SIG-113343-03 | 113343 | SIG | 直 | 无/停止 | 停车，不亮方向灯 | STOP | 12.5 | 14.0 | high | 1 | 1.0000 | PASS | STOP | 0.400
SIG-113343-04 | 113343 | SIG | 直 | 按键强制行驶 | 报警（LED3/红色叠加） | ALARM | 12.5 | 14.0 | high | 1 | 1.0000 | PASS | ALARM | 0.400
SIG-113343-05 | 113343 | SIG | 右 | 行驶 | 右转不受灯控，通行（LED2） | GO | 12.5 | 14.0 | mid | 1 | 1.0000 | PASS | GO | 0.400
SIG-113343-06 | 113343 | SIG | 左 | 无/停止 | 停车，不亮方向灯 | STOP | 14.0 | 15.5 | high | 2 | 1.0000 | PASS | STOP | 0.100
SIG-113343-07 | 113343 | SIG | 左 | 按键强制行驶 | 报警（LED3/红色叠加） | ALARM | 14.0 | 15.5 | high | 2 | 1.0000 | PASS | ALARM | 0.100
SIG-113343-08 | 113343 | SIG | 左 | 无/停止 | 停车，不亮方向灯 | STOP | 15.5 | 21.85 | low | 9 | 1.0000 | PASS | STOP | 0.400
SIG-113343-09 | 113343 | SIG | 左 | 按键强制行驶 | 报警（LED3/红色叠加） | ALARM | 15.5 | 21.85 | low | 9 | 1.0000 | PASS | ALARM | 0.400
SIG-113343-10 | 113343 | SIG | 直 | 无/停止 | 停车，不亮方向灯 | STOP | 14.0 | 15.5 | high | 2 | 1.0000 | PASS | STOP | 0.100
SIG-113343-11 | 113343 | SIG | 直 | 按键强制行驶 | 报警（LED3/红色叠加） | ALARM | 14.0 | 15.5 | high | 2 | 1.0000 | PASS | ALARM | 0.100
SIG-113343-12 | 113343 | SIG | 直 | 无/停止 | 停车，不亮方向灯 | STOP | 15.5 | 21.85 | low | 9 | 1.0000 | PASS | STOP | 0.400
SIG-113343-13 | 113343 | SIG | 直 | 按键强制行驶 | 报警（LED3/红色叠加） | ALARM | 15.5 | 21.85 | low | 9 | 1.0000 | PASS | ALARM | 0.400
SIG-113343-14 | 113343 | SIG | 右 | 行驶 | 右转不受灯控，通行（LED2） | GO | 14.0 | 15.5 | mid | 2 | 1.0000 | PASS | GO | 0.100
SIG-113343-15 | 113343 | SIG | 右 | 行驶 | 右转不受灯控，通行（LED2） | GO | 15.5 | 21.85 | mid | 9 | 1.0000 | PASS | GO | 0.400
SIG-113421-01 | 113421 | SIG | 左 | 行驶 | 通行，亮左方向LED（LED0）并叠加箭头 | GO | 0.0 | 6.0 | mid | 9 | 1.0000 | PASS | GO | 0.300
SIG-113421-02 | 113421 | SIG | 直 | 行驶 | 通行，亮直方向LED（LED1）并叠加箭头 | GO | 0.0 | 1.0 | mid | 2 | 1.0000 | PASS | GO | 0.000
SIG-113421-03 | 113421 | SIG | 直 | 行驶 | 通行，亮直方向LED（LED1）并叠加箭头 | GO | 1.0 | 6.0 | high | 7 | 1.0000 | PASS | GO | 0.500
SIG-113421-04 | 113421 | SIG | 右 | 行驶 | 右转不受灯控，通行（LED2） | GO | 0.0 | 6.0 | mid | 9 | 1.0000 | PASS | GO | 0.300
SIG-113421-05 | 113421 | SIG | 左 | 行驶 | 通行，亮左方向LED（LED0）并叠加箭头 | GO | 6.0 | 10.0 | mid | 6 | 1.0000 | PASS | GO | 0.300
SIG-113421-06 | 113421 | SIG | 直 | 行驶 | 通行，亮直方向LED（LED1）并叠加箭头 | GO | 6.0 | 10.0 | high | 6 | 1.0000 | PASS | GO | 0.300
SIG-113421-07 | 113421 | SIG | 右 | 行驶 | 右转不受灯控，通行（LED2） | GO | 6.0 | 10.0 | mid | 6 | 1.0000 | PASS | GO | 0.300
SIG-113452-01 | 113452 | SIG | 左 | 无/停止 | 停车，不亮方向灯 | STOP | 9.0 | 10.0 | low | 2 | 1.0000 | PASS | STOP | 0.000
SIG-113452-02 | 113452 | SIG | 左 | 按键强制行驶 | 报警（LED3/红色叠加） | ALARM | 9.0 | 10.0 | low | 2 | 1.0000 | PASS | ALARM | 0.000
SIG-113452-03 | 113452 | SIG | 直 | 无/停止 | 停车，不亮方向灯 | STOP | 9.0 | 10.0 | mid | 2 | 1.0000 | PASS | STOP | 0.000
SIG-113452-04 | 113452 | SIG | 直 | 按键强制行驶 | 报警（LED3/红色叠加） | ALARM | 9.0 | 10.0 | mid | 2 | 1.0000 | PASS | ALARM | 0.000
SIG-113452-05 | 113452 | SIG | 直 | 无/停止 | 停车，不亮方向灯 | STOP | 10.0 | 14.37 | low | 5 | 1.0000 | PASS | STOP | 0.500
SIG-113452-06 | 113452 | SIG | 直 | 按键强制行驶 | 报警（LED3/红色叠加） | ALARM | 10.0 | 14.37 | low | 5 | 1.0000 | PASS | ALARM | 0.500
SIG-113452-07 | 113452 | SIG | 右 | 行驶 | 右转不受灯控，通行（LED2） | GO | 9.0 | 14.37 | low | 7 | 0.0000 | FAIL | STOP
SIG-113539-01 | 113539 | SIG | 左 | 无/停止 | 停车，不亮方向灯 | STOP | 10.0 | 26.0 | high | 25 | 1.0000 | PASS | STOP | 0.500
SIG-113539-02 | 113539 | SIG | 左 | 按键强制行驶 | 报警（LED3/红色叠加） | ALARM | 10.0 | 26.0 | high | 25 | 1.0000 | PASS | ALARM | 0.500
SIG-113539-03 | 113539 | SIG | 直 | 无/停止 | 停车，不亮方向灯 | STOP | 10.0 | 26.0 | high | 25 | 1.0000 | PASS | STOP | 0.500
SIG-113539-04 | 113539 | SIG | 直 | 按键强制行驶 | 报警（LED3/红色叠加） | ALARM | 10.0 | 26.0 | high | 25 | 1.0000 | PASS | ALARM | 0.500
SIG-113539-05 | 113539 | SIG | 右 | 行驶 | 右转不受灯控，通行（LED2） | GO | 10.0 | 26.0 | mid | 25 | 1.0000 | PASS | GO | 0.500
SIG-113539-06 | 113539 | SIG | 左 | 行驶 | 通行，亮左方向LED（LED0）并叠加箭头 | GO | 27.0 | 30.0 | mid | 4 | 1.0000 | PASS | GO | 0.300
SIG-113539-07 | 113539 | SIG | 直 | 行驶 | 通行，亮直方向LED（LED1）并叠加箭头 | GO | 27.0 | 30.0 | high | 4 | 1.0000 | PASS | GO | 0.300
SIG-113539-08 | 113539 | SIG | 右 | 行驶 | 右转不受灯控，通行（LED2） | GO | 27.0 | 30.0 | mid | 4 | 1.0000 | PASS | GO | 0.300
SIG-113539-09 | 113539 | SIG | 左 | 行驶 | 通行，亮左方向LED（LED0）并叠加箭头 | GO | 61.0 | 63.5 | mid | 3 | 1.0000 | PASS | GO | 0.500
SIG-113539-10 | 113539 | SIG | 直 | 行驶 | 通行，亮直方向LED（LED1）并叠加箭头 | GO | 61.0 | 63.5 | high | 3 | 1.0000 | PASS | GO | 0.500
SIG-113539-11 | 113539 | SIG | 右 | 行驶 | 右转不受灯控，通行（LED2） | GO | 61.0 | 63.5 | mid | 3 | 1.0000 | PASS | GO | 0.500
SIG-113539-12 | 113539 | SIG | 左 | 行驶 | 通行，亮左方向LED（LED0）并叠加箭头 | GO | 63.5 | 67.5 | mid | 6 | 1.0000 | PASS | GO | 0.400
SIG-113539-13 | 113539 | SIG | 左 | 无/停止 | 停车，不亮方向灯 | STOP | 67.5 | 69.0 | low | 2 | 0.0000 | FAIL | GO
SIG-113539-14 | 113539 | SIG | 左 | 按键强制行驶 | 报警（LED3/红色叠加） | ALARM | 67.5 | 69.0 | low | 2 | 0.0000 | FAIL | GO
SIG-113539-15 | 113539 | SIG | 直 | 行驶 | 通行，亮直方向LED（LED1）并叠加箭头 | GO | 63.5 | 67.5 | high | 6 | 1.0000 | PASS | GO | 0.400
SIG-113539-16 | 113539 | SIG | 直 | 无/停止 | 停车，不亮方向灯 | STOP | 67.5 | 69.0 | mid | 2 | 0.0000 | FAIL | GO
SIG-113539-17 | 113539 | SIG | 直 | 按键强制行驶 | 报警（LED3/红色叠加） | ALARM | 67.5 | 69.0 | mid | 2 | 0.0000 | FAIL | GO
SIG-113539-18 | 113539 | SIG | 右 | 行驶 | 右转不受灯控，通行（LED2） | GO | 63.5 | 67.5 | mid | 6 | 1.0000 | PASS | GO | 0.400
LANE-112507-01 | 112507 | LANE | 左 | 左转向 | 允许左变道（LED0/左箭头） | ALLOW | 1.0 | 9.5 | mid | 13 | 0.3846 | FAIL | KEEP | 1.100
LANE-112507-02 | 112507 | LANE | 左 | 左转向 | 保持直行（LED1） | KEEP | 9.5 | 12.5 | mid | 4 | 1.0000 | PASS | KEEP | 0.400
LANE-112507-03 | 112507 | LANE | 左 | 强制左变道 | 报警 | ALARM | 9.5 | 12.5 | mid | 4 | 1.0000 | PASS | ALARM | 0.400
LANE-112507-04 | 112507 | LANE | 左 | 左转向 | 允许左变道（LED0/左箭头） | ALLOW | 15.0 | 19.5 | mid | 7 | 1.0000 | PASS | ALLOW | 0.300
LANE-112507-05 | 112507 | LANE | 左 | 左转向 | 保持直行（LED1） | KEEP | 19.5 | 23.0 | mid | 5 | 0.2000 | FAIL | ALLOW | 1.200
LANE-112507-06 | 112507 | LANE | 左 | 强制左变道 | 报警 | ALARM | 19.5 | 23.0 | mid | 5 | 0.2000 | FAIL | ALLOW | 1.200
LANE-112507-07 | 112507 | LANE | 左 | 左转向 | 允许左变道（LED0/左箭头） | ALLOW | 26.0 | 30.0 | mid | 6 | 0.1667 | FAIL | KEEP | 1.900
LANE-112507-08 | 112507 | LANE | 左 | 左转向 | 保持直行（LED1） | KEEP | 36.0 | 38.5 | mid | 3 | 1.0000 | PASS | KEEP | 0.300
LANE-112507-09 | 112507 | LANE | 左 | 强制左变道 | 报警 | ALARM | 36.0 | 38.5 | mid | 3 | 1.0000 | PASS | ALARM | 0.300
LANE-112507-10 | 112507 | LANE | 左 | 左转向 | 允许左变道（LED0/左箭头） | ALLOW | 43.0 | 45.0 | low | 1 | 1.0000 | PASS | ALLOW | 0.500
LANE-112507-11 | 112507 | LANE | 右 | 右转向 | 允许右变道（LED2/右箭头） | ALLOW | 1.0 | 9.5 | mid | 13 | 0.3077 | FAIL | KEEP | 3.500
LANE-112507-12 | 112507 | LANE | 右 | 右转向 | 保持直行（LED1） | KEEP | 9.5 | 12.5 | mid | 4 | 0.7500 | FAIL | KEEP | 0.400
LANE-112507-13 | 112507 | LANE | 右 | 强制右变道 | 报警 | ALARM | 9.5 | 12.5 | mid | 4 | 0.7500 | FAIL | ALARM | 0.400
LANE-112507-14 | 112507 | LANE | 右 | 右转向 | 允许右变道（LED2/右箭头） | ALLOW | 15.0 | 19.5 | mid | 7 | 0.7143 | FAIL | ALLOW | 0.300
LANE-112507-15 | 112507 | LANE | 右 | 右转向 | 保持直行（LED1） | KEEP | 19.5 | 23.0 | mid | 5 | 0.8000 | PASS | KEEP | 0.000
LANE-112507-16 | 112507 | LANE | 右 | 强制右变道 | 报警 | ALARM | 19.5 | 23.0 | mid | 5 | 0.8000 | PASS | ALARM | 0.000
LANE-112507-17 | 112507 | LANE | 右 | 右转向 | 允许右变道（LED2/右箭头） | ALLOW | 26.0 | 35.0 | mid | 14 | 0.5714 | FAIL | ALLOW | 1.300
LANE-112507-18 | 112507 | LANE | 右 | 右转向 | 保持直行（LED1） | KEEP | 36.0 | 38.5 | mid | 3 | 0.0000 | FAIL | ALLOW
LANE-112507-19 | 112507 | LANE | 右 | 强制右变道 | 报警 | ALARM | 36.0 | 38.5 | mid | 3 | 0.0000 | FAIL | ALLOW
LANE-113343-01 | 113343 | LANE | 左 | 左转向 | 保持直行（LED1） | KEEP | 0.0 | 8.0 | mid | 12 | 1.0000 | PASS | KEEP | 0.300
LANE-113343-02 | 113343 | LANE | 左 | 强制左变道 | 报警 | ALARM | 0.0 | 8.0 | mid | 12 | 1.0000 | PASS | ALARM | 0.300
LANE-113343-03 | 113343 | LANE | 右 | 右转向 | 允许右变道（LED2/右箭头） | ALLOW | 0.0 | 8.0 | mid | 12 | 0.2500 | FAIL | KEEP | 2.100
LANE-113452-01 | 113452 | LANE | 左 | 左转向 | 允许左变道（LED0/左箭头） | ALLOW | 0.0 | 5.0 | low | 7 | 0.0000 | FAIL | KEEP
LANE-113539-01 | 113539 | LANE | 左 | 左转向 | 保持直行（LED1） | KEEP | 0.0 | 5.0 | mid | 7 | 1.0000 | PASS | KEEP | 0.300
LANE-113539-02 | 113539 | LANE | 左 | 强制左变道 | 报警 | ALARM | 0.0 | 5.0 | mid | 7 | 1.0000 | PASS | ALARM | 0.300
LANE-113539-03 | 113539 | LANE | 右 | 右转向 | 允许右变道（LED2/右箭头） | ALLOW | 0.0 | 5.0 | low | 7 | 0.8571 | PASS | ALLOW | 0.900
LANE-113539-04 | 113539 | LANE | 左 | 左转向 | 保持直行（LED1） | KEEP | 37.0 | 47.0 | mid | 15 | 0.8000 | PASS | KEEP | 0.500
LANE-113539-05 | 113539 | LANE | 左 | 强制左变道 | 报警 | ALARM | 37.0 | 47.0 | mid | 15 | 0.8000 | PASS | ALARM | 0.500
LANE-113539-06 | 113539 | LANE | 左 | 左转向 | 保持直行（LED1） | KEEP | 54.0 | 60.0 | mid | 9 | 0.7778 | FAIL | KEEP | 1.500
LANE-113539-07 | 113539 | LANE | 左 | 强制左变道 | 报警 | ALARM | 54.0 | 60.0 | mid | 9 | 0.7778 | FAIL | ALARM | 1.500
LANE-113539-08 | 113539 | LANE | 右 | 右转向 | 允许右变道（LED2/右箭头） | ALLOW | 37.0 | 47.0 | low | 15 | 0.4000 | FAIL | KEEP | 1.700
LANE-113539-09 | 113539 | LANE | 右 | 右转向 | 允许右变道（LED2/右箭头） | ALLOW | 54.0 | 60.0 | low | 9 | 0.4444 | FAIL | KEEP | 0.300
NAV-112739-01 | 112739 | NAV | 右 | 按导航行驶 | 提示右方向（转向灯/LED） |  | 2.0 | 2.0 | high |  |  | N/A
NAV-112739-02 | 112739 | NAV | 右 | 按导航行驶 | 提示右方向（转向灯/LED） |  | 10.0 | 10.0 | high |  |  | N/A
NAV-112739-03 | 112739 | NAV | 右 | 按导航行驶 | 提示右方向（转向灯/LED） |  | 20.0 | 20.0 | high |  |  | N/A
NAV-112739-04 | 112739 | NAV | 右 | 按导航行驶 | 提示右方向（转向灯/LED） |  | 30.0 | 30.0 | high |  |  | N/A
NAV-112739-05 | 112739 | NAV | 右 | 按导航行驶 | 提示右方向（转向灯/LED），距离141.0m≤150.0m，进入对应转向车道 |  | 38.0 | 38.0 | high |  |  | N/A
NAV-112739-06 | 112739 | NAV | 右 | 按导航行驶 | 提示右方向（转向灯/LED），距离36.0m≤150.0m，进入对应转向车道 |  | 42.0 | 42.0 | high |  |  | N/A
NAV-112739-07 | 112739 | NAV | 右 | 按导航行驶 | 提示右方向（转向灯/LED），距离57.0m≤150.0m，进入对应转向车道 |  | 44.0 | 44.0 | high |  |  | N/A
NAV-112739-08 | 112739 | NAV | 右 | 按导航行驶 | 提示右方向（转向灯/LED），距离30.0m≤150.0m，进入对应转向车道 |  | 46.0 | 46.0 | high |  |  | N/A
NAV-112739-09 | 112739 | NAV | 左 | 按导航行驶 | 提示左方向（转向灯/LED） |  | 48.0 | 48.0 | high |  |  | N/A
NAV-112739-10 | 112739 | NAV | 左 | 按导航行驶 | 提示左方向（转向灯/LED） |  | 54.0 | 54.0 | high |  |  | N/A
NAV-112739-11 | 112739 | NAV | 左 | 按导航行驶 | 提示左方向（转向灯/LED） |  | 58.0 | 58.0 | high |  |  | N/A
NAV-112739-12 | 112739 | NAV | 左 | 按导航行驶 | 提示左方向（转向灯/LED），距离100.0m≤150.0m，进入对应转向车道 |  | 60.0 | 60.0 | high |  |  | N/A
NAV-112739-13 | 112739 | NAV | 左 | 按导航行驶 | 提示左方向（转向灯/LED），距离40.0m≤150.0m，进入对应转向车道 |  | 66.0 | 66.0 | high |  |  | N/A
NAV-112739-14 | 112739 | NAV | 掉头 | 按导航行驶 | 提示掉头方向（转向灯/LED） |  | 84.0 | 84.0 | high |  |  | N/A
NAV-112739-15 | 112739 | NAV | 掉头 | 按导航行驶 | 提示掉头方向（转向灯/LED） |  | 90.0 | 90.0 | high |  |  | N/A
HAZARD-112507-01 | 112507 | HAZARD | ped_crossing_near | 危险处置 | 减速提醒 |  | 40.0 | 41.5 | mid |  |  | N/A
HAZARD-113343-01 | 113343 | HAZARD | lead_close | 危险处置 | 碰撞提醒 |  | 12.0 | 14.0 | mid |  |  | N/A
HAZARD-113421-01 | 113421 | HAZARD | cut_in | 危险处置 | 碰撞提醒 |  | 7.0 | 10.0 | low |  |  | N/A
HAZARD-113452-01 | 113452 | HAZARD | lead_close | 危险处置 | 碰撞提醒 |  | 8.0 | 10.5 | high |  |  | N/A
HAZARD-113539-01 | 113539 | HAZARD | lead_close | 危险处置 | 碰撞提醒 |  | 11.0 | 12.5 | mid |  |  | N/A
HAZARD-113539-02 | 113539 | HAZARD | ped_crossing_near | 危险处置 | 减速提醒 |  | 17.5 | 19.5 | mid |  |  | N/A
HAZARD-113539-03 | 113539 | HAZARD | ped_crossing_near | 危险处置 | 减速提醒 |  | 23.5 | 25.0 | mid |  |  | N/A
HAZARD-113539-04 | 113539 | HAZARD | ped_crossing_near | 危险处置 | 减速提醒 |  | 40.5 | 41.5 | mid |  |  | N/A
HAZARD-113539-05 | 113539 | HAZARD | cut_in | 危险处置 | 碰撞提醒 |  | 54.0 | 54.5 | low |  |  | N/A
HAZARD-113539-06 | 113539 | HAZARD | lead_close | 危险处置 | 碰撞提醒 |  | 62.0 | 63.5 | mid |  |  | N/A
HAZARD-113539-07 | 113539 | HAZARD | ped_in_path | 危险处置 | 刹车/停车 + 报警 |  | 69.5 | 71.5 | mid |  |  | N/A
SPEED-112507-01 | 112507 | SPEED |  | 按限速行驶 | 记录限速值50.0，车速（按键/参数模拟）超过时超速提醒 |  | 43.0 | 43.0 | high |  |  | N/A
SPEED-112739-01 | 112739 | SPEED |  | 按限速行驶 | 记录限速值50.0，车速（按键/参数模拟）超过时超速提醒 |  | 14.0 | 14.0 | low |  |  | N/A
SPEED-113421-01 | 113421 | SPEED |  | 按限速行驶 | 记录限速值40.0，车速（按键/参数模拟）超过时超速提醒 |  | 11.0 | 11.0 | high |  |  | N/A
SPEED-113539-01 | 113539 | SPEED |  | 按限速行驶 | 记录限速值40.0，车速（按键/参数模拟）超过时超速提醒 |  | 1.0 | 1.0 | mid |  |  | N/A
