Zdy-1110/FPGA-676/video_review/baseline/113539_baseline_report.md

# COCO yolo11n 基线报告

- a 目录（全片 640）：`E:\Project\nesai2026\video_review\baseline\113539_640`
- b 目录（仅快照帧 1280）：`E:\Project\nesai2026\video_review\baseline\113539_1280snap`
- 生成时间：2026-10-18 12:42:49

## 1 运行概况

### A（全片 640）：`E:\Project\nesai2026\video_review\baseline\113539_640`

| 参数 | 值 |
| --- | --- |
| imgsz | 640 |
| frames_total | 2315 |
| frames_inferred | 2315 |
| infer_ms_mean | 23.422 |
| infer_ms_p95 | 37.924 |

| 类别 | boxes | frames_with | frames_with/frames_inferred | mean_per_frame | h640 <8 | h640 8-16 | h640 16-32 | h640 32-64 | h640 >=64 |
| --- | --- | --- | --- | --- | --- | --- | --- | --- | --- |
| person | 3307 | 1464 | 63.2% | 1.4285 | 0 | 19 | 1250 | 1308 | 730 |
| rider | 1359 | 871 | 37.6% | 0.587 | 0 | 1 | 279 | 584 | 495 |
| car | 13811 | 2311 | 99.8% | 5.9659 | 4 | 1200 | 4327 | 4282 | 3998 |
| bus | 422 | 352 | 15.2% | 0.1823 | 0 | 0 | 114 | 139 | 169 |
| truck | 953 | 747 | 32.3% | 0.4117 | 0 | 0 | 67 | 338 | 548 |
| tl_ref | 1033 | 667 | 28.8% | 0.4462 | 2 | 469 | 536 | 23 | 3 |
| other_ref | 40 | 39 | 1.7% | 0.0173 | 0 | 4 | 13 | 23 | 0 |

原始 COCO 框数：person 4062，bicycle 62，car 13811，motorcycle 1297，bus 422，truck 953，traffic light 1033，stop sign 40

### B（仅快照帧 1280）：`E:\Project\nesai2026\video_review\baseline\113539_1280snap`

| 参数 | 值 |
| --- | --- |
| imgsz | 1280 |
| frames_total | 2315 |
| frames_inferred | 39 |
| infer_ms_mean | 95.902 |
| infer_ms_p95 | 93.858 |

| 类别 | boxes | frames_with | frames_with/frames_inferred | mean_per_frame | h640 <8 | h640 8-16 | h640 16-32 | h640 32-64 | h640 >=64 |
| --- | --- | --- | --- | --- | --- | --- | --- | --- | --- |
| person | 78 | 25 | 64.1% | 2.0 | 0 | 11 | 30 | 31 | 6 |
| rider | 53 | 21 | 53.8% | 1.359 | 0 | 2 | 21 | 15 | 15 |
| car | 302 | 39 | 100.0% | 7.7436 | 2 | 61 | 85 | 80 | 74 |
| bus | 13 | 9 | 23.1% | 0.3333 | 0 | 0 | 2 | 7 | 4 |
| truck | 25 | 17 | 43.6% | 0.641 | 0 | 0 | 4 | 6 | 15 |
| tl_ref | 53 | 16 | 41.0% | 1.359 | 0 | 33 | 20 | 0 | 0 |
| other_ref | 0 | 0 | 0.0% | 0.0 | 0 | 0 | 0 | 0 | 0 |

原始 COCO 框数：person 108，bicycle 3，car 302，motorcycle 50，bus 13，truck 25，traffic light 53，stop sign 0

## 2 640 对 1280 分辨率对照

a/b 快照帧交集：39 帧（0, 60, 120, 180, 240, 300, 360, 420, 480, 540, 600, 660, 720, 780, 840, 900, 960, 1020, 1080, 1140, 1200, 1260, 1320, 1380, 1440, 1500, 1560, 1620, 1680, 1740, 1800, 1860, 1920, 1980, 2040, 2100, 2160, 2220, 2280）

| 类别 | n_b | 匹配数 | a 相对 b 的召回率 | n_a | a 独有框数 |
| --- | --- | --- | --- | --- | --- |
| person | 78 | 27 | 34.6% | 50 | 23 |
| rider | 53 | 23 | 43.4% | 26 | 3 |
| car | 302 | 186 | 61.6% | 243 | 57 |
| bus | 13 | 2 | 15.4% | 10 | 8 |
| truck | 25 | 10 | 40.0% | 19 | 9 |
| tl_ref | 53 | 11 | 20.8% | 16 | 5 |

按 1280（b）框的 h640 分桶：

| 类别 | h640 桶 | n_b | 匹配数 |
| --- | --- | --- | --- |
| person | <8 | 0 | 0 |
| person | 8-16 | 11 | 0 |
| person | 16-32 | 30 | 9 |
| person | 32-64 | 31 | 14 |
| person | >=64 | 6 | 4 |
| rider | <8 | 0 | 0 |
| rider | 8-16 | 2 | 0 |
| rider | 16-32 | 21 | 5 |
| rider | 32-64 | 15 | 6 |
| rider | >=64 | 15 | 12 |
| car | <8 | 2 | 0 |
| car | 8-16 | 60 | 17 |
| car | 16-32 | 85 | 49 |
| car | 32-64 | 81 | 54 |
| car | >=64 | 74 | 66 |
| bus | <8 | 0 | 0 |
| bus | 8-16 | 0 | 0 |
| bus | 16-32 | 2 | 0 |
| bus | 32-64 | 7 | 1 |
| bus | >=64 | 4 | 1 |
| truck | <8 | 0 | 0 |
| truck | 8-16 | 0 | 0 |
| truck | 16-32 | 4 | 1 |
| truck | 32-64 | 6 | 4 |
| truck | >=64 | 15 | 5 |
| tl_ref | <8 | 0 | 0 |
| tl_ref | 8-16 | 32 | 7 |
| tl_ref | 16-32 | 21 | 4 |
| tl_ref | 32-64 | 0 | 0 |
| tl_ref | >=64 | 0 | 0 |

以 1280 结果作参照，只反映缩到 640 造成的漏检，不是相对真值的绝对召回率。

## 3 危险事件区间检出情况

| value | t_start–t_end | conf | 帧数 | 命中帧比例 | 最大 h640 |
| --- | --- | --- | --- | --- | --- |
| lead_close | 11.0–12.5 | mid | 46 | 100.0% | 134.6 |
| ped_crossing_near | 17.5–19.5 | mid | 61 | 100.0% | 110.5 |
| ped_crossing_near | 23.5–25.0 | mid | 46 | 84.8% | 64.1 |
| ped_crossing_near | 40.5–41.5 | mid | 31 | 6.5% | 76.7 |
| cut_in | 54.0–54.5 | low | 16 | 100.0% | 106.2 |
| lead_close | 62.0–63.5 | mid | 46 | 84.8% | 127.3 |
| ped_in_path | 69.5–71.5 | mid | 61 | 100.0% | 144.5 |

注意（人工核对后补充）：这张表只统计"画面中间三分之一、下 60% 区域内有没有对应类别的框"，误检也算命中，所以不能当作危险检出率：
- 17.5–19.5 s 的 100% 来自出租车后窗里的乘客（误检为 person），真正横穿的打伞骑手没有检出；
- 40.5–41.5 s 的 6.5% 不是漏检：41 s 时外卖骑手（0.81）和右侧行人（0.64）都检出了，只是不在中间三分之一（见 `113539_640/snaps_extra/t041.0_det.jpg`）。

## 4 按 5 秒分段的平均目标数

| 区间 | person | rider | car | bus | truck | tl_ref |
| --- | --- | --- | --- | --- | --- | --- |
| 0–5s | 0.07 | 0.00 | 7.72 | 0.01 | 1.39 | 0.04 |
| 5–10s | 1.02 | 0.05 | 2.93 | 0.07 | 0.03 | 0.01 |
| 10–15s | 0.83 | 0.30 | 4.09 | 0.10 | 0.12 | 0.67 |
| 15–20s | 1.83 | 0.29 | 2.52 | 0.00 | 0.01 | 1.37 |
| 20–25s | 2.19 | 0.61 | 2.99 | 0.33 | 0.09 | 1.42 |
| 25–30s | 2.39 | 0.41 | 3.84 | 0.23 | 0.15 | 1.09 |
| 30–35s | 0.85 | 0.45 | 2.00 | 0.25 | 0.47 | 0.34 |
| 35–40s | 1.00 | 0.27 | 12.25 | 0.17 | 0.54 | 0.01 |
| 40–45s | 1.54 | 0.70 | 11.23 | 0.02 | 0.05 | 0.00 |
| 45–50s | 1.22 | 0.91 | 6.16 | 0.01 | 0.10 | 0.24 |
| 50–55s | 0.73 | 1.85 | 6.45 | 0.31 | 0.91 | 0.00 |
| 55–60s | 0.70 | 0.71 | 14.92 | 0.16 | 0.59 | 0.01 |
| 60–65s | 3.36 | 1.35 | 5.03 | 0.15 | 0.44 | 0.81 |
| 65–70s | 2.77 | 0.65 | 3.69 | 0.21 | 0.59 | 0.85 |
| 70–75s | 1.39 | 0.17 | 3.85 | 0.79 | 0.85 | 0.00 |
| 75–77s | 0.35 | 0.77 | 5.54 | 0.00 | 0.06 | 0.06 |

## 5 COCO 无法覆盖的目标类

以下四类目标在 COCO 中没有对应类别，当前基线必然漏检，需层 B 标注后训练：

- tricycle（三轮车）
- cone（锥桶）
- barrier（水马/围挡）
- speed_limit（限速牌）

## 6 人工抽查

抽查了 6 个时刻的 640 叠框图（18、34、40、41、64、70 s），64 s 另外对照了 1280 的结果。"弱势目标"指行人、骑手和骑车人，不含车内乘客和停放的两轮车。

| 时刻 | 画面里的弱势目标 | 640 检出 | 主要漏检 / 误检 |
|---|---|---|---|
| 18 s | 约 4（打伞骑手 2、右侧人行道行人 2） | 0 | 漏检：全部。误检：出租车后窗里的乘客被检成 person。正前方两个带倒计时的红灯都没检出，只检出了左侧的行人灯。锥桶 3 个（COCO 无此类） |
| 34 s | 2（近处电动车骑手、远处摩托） | 1 | 骑手被检成 person，因为电动车本身没检出，合并不成。路边停放的自行车被当成 rider（误检）。前方出租车同时有 car 和 truck 两个框。车道中间 2 个锥桶、右侧施工围挡都检不出 |
| 40 s | 2（外卖骑手、右侧行人） | 1 | 右侧拎袋子的行人漏检 |
| 41 s | 2 | 2 | — |
| 64 s | 约 10 | 约 4 | 640 漏检：中间穿斑马线的白衣行人（h640 约 80）、两个骑自行车的人、面包车前的骑手、打伞骑手，以及左侧那盏绿灯。改用 1280 后，除被黄色指示牌遮住的行人和打伞骑手外都能检出 |
| 70 s | 6 | 5 | 最左侧被画面截断的行人漏检。远处一辆白色面包车被检成 bus，还出现了重叠的 bus 框 |
| 合计 | 约 26 | 约 13（约 50%） | |

结论：
1. **640×384 整帧输入对行人和骑手不够。** 与 1280 对照：行人加骑手只找回约 41%，车辆约 61%。漏检集中在 640 尺度下框高 32 px 以下的目标（1280 找到的这一段，640 只匹配上 17/64）。框高 64 px 以上的弱势目标，640 能找回 16/21。
2. **误检类型**：车窗里的乘客、停放的自行车和电动车、同一辆车同时出 car 和 truck 两个框（按类分别做 NMS 导致）、面包车被检成 bus。
3. **COCO 没有的类别**：锥桶、施工围挡和水马、三轮车、限速牌在这段视频里都多次出现，基线全部检不出。
4. **红绿灯**：COCO 的 traffic light 在 640 下连主灯都会漏（18 s 的两个红灯），而且不区分颜色和箭头方向。这再次说明认灯应放在 FPGA 上、按原分辨率做。
5. **速度**（PC CPU，不代表板上）：640 下每帧平均 23.4 ms（p95 37.9 ms）；1280 下每帧约 94 ms，约为 640 的 4 倍。1280 的平均值 95.9 ms 比 p95 还高，是因为被首帧预热拉高了。

建议：
- NPU 输入不要把整帧直接缩到 640。可以由 FPGA 先裁掉天空和仪表台，只保留路面带（例如 y 360–1000，整宽 1920），再缩到 960×320。这样目标尺度是现在的 1.5 倍，像素数只多约 25%。需要在 RK3568 上实测帧率后再定。
- 层 B 标注时：
  - 把车内乘客、停放的两轮车列为不标；
  - 加上锥桶、围挡、三轮车、限速牌四类；
  - 训练和推理时改用不分类别的 NMS（`agnostic_nms`），消除同一辆车出两个框的问题。
- 危险判决不能只看"中间三分之一有没有人"，要按自车行驶路径划区域，再加多帧跟踪去掉单帧误检。
