Zdy-1110/FPGA-676/RK_CMA扩容方案_20261018.md

# RK3568 CMA 扩容方案（30 fps 零拷贝送帧的前置条件）

> 2026-10-18 晚。只读调查结果和建议改法。
>
> **【已执行，10-18 21:54，用户确认后】改法 A 成功。**
> - **备份：** 板上 `/userdata/uboot_env_20261018.{bin,txt}`，PC 上 `log/rk_boot/uboot_env_20261018.*`，md5 211892a0…。
> - **改动：** `fw_setenv` 只改了 bootargs 一项，新 CRC 为 9d1119fc。重启时 COM9（XR21V1414 Ch A）全程抓了串口日志：`log/rk_boot/serial_boot_cma.txt`。
> - **3.3 验证全部通过：**
>   1. cmdline 含 `cma=256M`；
>   2. `cma: Reserved 256 MiB at 0xddc00000`，范围 0xDDC00000–0xEDC00000，位于 4 GB 以下；
>   3. CmaTotal 262144 kB；
>   4. cma 堆分配 64 MB 和 200 MB，都从 0xddf00000 起物理连续；
>   5. P30 链路 Gen2 x1，osd1c 寄存器和静态帧正常，`pcie_bench D` ALL PASS，gst 硬件解码 655 帧耗时 1.9 s。
> - 记录：`log/rk_boot/verify_cma_1.txt`、`verify_cma_2.txt`、`dmesg_before_cma.txt`、`dmesg_after_cma.txt`。
> - **副作用排查（已逐项核对）：**
>   - 改动前后 dmesg 里 error/fail/unable 的行数都是 63，没有新增错误。
>   - 变化只有三处：swiotlb 从 0xe9f00000 下移到 0xd9c00000（仍为 64 MB，位于 4 GB 以下）；可用内存减少 240 MB；xhci 中断号变了。
>   - 串口日志里的 `WARNING: could not set reg FDT_ERR_BADOFFSET` 在 10-04 的旧启动日志 `tools/boot_console.log:1134` 里就已经有，不是这次引入的。
>   - U-Boot 显示 "FIT: no signed"、"Verified-boot: 0"：只做 sha256 校验，不校验签名。
> - **回退办法不变（见 3.4）。**
> 原始数据：`log/rk_boot/`（board_boot_info*.txt、live_dtb.txt、boot_fit.txt、recovery_fit.txt、uboot_bootargs_strings.txt、cma_phys_test_run.txt）。

## 1. 为什么要扩容

零拷贝送帧的做法：
1. MPP 把 HEVC 解码到物理连续、地址在 4 GB 以下的缓冲里。
2. RK 查出每帧缓冲的物理地址，用门铃交给 FPGA。
3. FPGA 经 PCIe 直接读走，CPU 不拷贝。

这条路已在板上验证可行（`tools/rk_hello/cma_phys_test`，结果见 `log/rk_boot/cma_phys_test_run.txt`）：

| 堆 | 分配 | 结果 |
|---|---|---|
| `/dev/dma_heap/cma` | 4 MB、12 MB | 物理地址 0xeef00000 起，**完全连续，位于 4 GB 以下**；pagemap 能查到物理地址 |
| `/dev/dma_heap/system-dma32` | 4 MB | pagemap 查不到物理地址（全为 0），而且本来就不连续 → **不能用** |

问题出在容量：
- 现在的 CMA 只有 **16 MB**（内核默认值 `CONFIG_CMA_SIZE_MBYTES=16`），12 MB 就基本分满了。
- 1080p HEVC 解码需要约 20 个帧缓冲，每个约 3.7 MB（行跨度 2304），合计约 75 MB；以后摄像头帧和 NPU 拼图还要用。

## 2. 板上现状（只读调查结论）

| 项目 | 事实 | 证据 |
|---|---|---|
| 启动参数来源 | U-Boot 把环境变量 `bootargs`（`storagemedia=emmc androidboot.storagemedia=emmc androidboot.mode=normal`）与内核 DTB 的 `/chosen/bootargs`（`rw rootwait earlycon=… root=PARTUUID=…`）合并后传给内核 | `fw_printenv`；`/proc/cmdline`；U-Boot 镜像里有 `## bootargs(u-boot)`、`## bootargs(merged)` 字符串 |
| U-Boot 环境区 | eMMC 偏移 0x3F8000，长 0x8000（32 KB），只有一份（无冗余）；CRC 有效；板上自带 `fw_printenv` / `fw_setenv` | `/etc/fw_env.config`；环境区头部 CRC `b3aa7b2c` |
| 内核 CMA | 无 DT CMA 节点，用内核默认 16 MB，位于 0xeec00000；`CONFIG_CMA=y`、`DMA_CMA=y`、`DMABUF_HEAPS_CMA=y` | dmesg `cma: Reserved 16 MiB at 0xeec00000`；`/proc/config.gz`；`live_dtb.txt` 里无 `shared-dma-pool` / `linux,cma-default` |
| 内存布局 | 低端 0x0020_0000–0x0840_0000、0x0940_0000–0xF000_0000（约 3.7 GB），4 GB 以上 0x1_F000_0000 起 256 MB；DMA 区覆盖全部低端内存 | DT `/memory`；`/proc/iomem`；dmesg Zone ranges |
| 已有保留区 | ramoops @0x110000（0xF0000，其中 0x1b0000–0x1fffff 被 pcie_feed / pcie_bench 当作中转区）、drm-logo @0xedf00000、drm-cubic-lut @0xeff00000 | `live_dtb.txt` 653–675 行 |
| /dev/mem | `CONFIG_STRICT_DEVMEM=y`：只能访问非"System RAM"区域，所以普通内存和 CMA 不能经 /dev/mem 访问 | `/proc/config.gz` |
| 物理地址查询 | `CONFIG_PROC_PAGE_MONITOR=y`：root 可以读 `/proc/self/pagemap` | 同上；cma_phys_test 实测 |
| boot 分区 | FIT 镜像（fdt @0x800，大小 0x1B7B3；kernel @0x1C000；resource @0x224BA00），各段有 sha256；配置里声明了 `sha256,rsa2048` 签名节点但没有签名值；**fdt 段与 kernel 段之间只剩 77 字节空余** | `boot_fit.txt` |

## 3. 推荐改法 A：在 U-Boot 环境变量 bootargs 末尾加 `cma=256M`

**原理**
- `cma=` 是内核标准的早期参数，会覆盖内核默认的 16 MB。
- 没有 DT CMA 节点，所以不存在"DT 节点优先"的冲突。
- 内核在 DMA 区（4 GB 以下）从高往低找连续空间。预计落在 0xdexx_xxxx–0xeexx_xxxx 一带，以 dmesg 为准。

**影响范围**
- 只改 eMMC 上 32 KB 的环境区，不碰 boot、rootfs 分区。
- CMA 是"可复用"内存：空闲时内核照样拿它放可迁移页，所以占用 256 MB 对日常可用内存影响很小（低端共有 3.7 GB）。

### 3.1 改前备份（板上执行，并拷回 PC）
```sh
fw_printenv > /userdata/uboot_env_20261018.txt
dd if=/dev/mmcblk0 of=/userdata/uboot_env_20261018.bin bs=4096 skip=1016 count=8   # 0x3F8000/4096 = 1016，32 KB
md5sum /userdata/uboot_env_20261018.bin
```
PC 上：`py -3 tools/rk_get.py 192.168.3.51 /userdata/uboot_env_20261018.bin log/rk_boot/uboot_env_20261018.bin`（txt 同理）。

### 3.2 修改
```sh
fw_setenv bootargs "storagemedia=emmc androidboot.storagemedia=emmc androidboot.mode=normal cma=256M"
fw_printenv bootargs          # 确认值
sync; reboot
```
写入约 1 秒，**这期间不要断电**：环境区只有一份，断电可能写坏；写坏后 U-Boot 会改用编译时的默认环境。

### 3.3 改后验证（全部满足才算成功）
1. `cat /proc/cmdline` 含 `cma=256M`。
2. `dmesg | grep "cma: Reserved"` 显示 `Reserved 256 MiB at 0x…`，地址加 256 MB 不超过 0x1_0000_0000。
3. `grep CmaTotal /proc/meminfo` 为 262144 kB。
4. `/tmp/cma_phys_test cma 0x4000000`（64 MB）：物理连续，位于 4 GB 以下。
5. 回归测试：
   - 使能 EP 后 P30 链路正常；
   - osd1c 显示静态帧正常；
   - `pcie_bench D` ALL PASS；
   - gst + mppvideodec 解码正常。

### 3.4 回退
| 情况 | 办法 |
|---|---|
| Linux 能正常启动（最可能） | `fw_setenv bootargs "storagemedia=emmc androidboot.storagemedia=emmc androidboot.mode=normal "`，然后 `reboot`；或者用备份整块写回：`dd if=/userdata/uboot_env_20261018.bin of=/dev/mmcblk0 bs=4096 seek=1016 count=8 conv=fsync` |
| Linux 起不来（可能性很小：CMA 预留失败时内核只打印错误、继续启动） | 接 RK 调试串口（XR21V1414，115200），上电后 1 秒内按任意键进入 U-Boot：`setenv bootargs storagemedia=emmc androidboot.storagemedia=emmc androidboot.mode=normal`、`saveenv`、`reset` |
| 串口也不通 | 用 Rockchip 官方烧写工具（RKDevTool）进 Loader 模式，重刷 U-Boot 或擦除环境区 |

**建议**：执行前先把 RK 调试串口接上 PC，作为第 2 种情况的保险。目前 PC 上没有看到 XR21V1414 的 COM 口，说明串口线没接。

## 4. 备选改法 B：改 boot 分区里的内核 DTB（不推荐）

**做法**
- 在内核 DTB 里加 `reserved-memory/linux,cma` 节点（`compatible = "shared-dma-pool"`、`reusable`、`size = 256 MB`、`alloc-ranges` 限定在 4 GB 以下、`linux,cma-default`），或者在 `/chosen/bootargs` 里加 `cma=256M`；
- 然后重新打包 FIT。

**不推荐的原因**
- fdt 段后面只有 77 字节空余，DTB 一变大就要整体挪动后面 30 多 MB 的 kernel 和 resource 段，并改写 data-position。
- 三段的 sha256 都要重算。
- 镜像声明了签名节点。现在没有签名值也能启动，说明 U-Boot 不强制校验，但这一点没有验证过。
- 一旦出错，boot 分区就起不来了，只能靠 RKDevTool 恢复。

**回退**：改之前用 `dd` 备份整个 boot 分区（64 MB）到 PC；起不来时用 RKDevTool 把备份烧回。

只有当改法 A 被 U-Boot 忽略（验证第 1 条不满足）时才考虑。

## 5. 不采用的做法：DT 里划一块 no-map 保留区

- 用 /dev/mem 映射 no-map 区倒是可以，因为它不算 System RAM。
- 但 VPU 解码要的是 dma-buf 句柄，MPP 无法直接解码进一块裸物理地址。
- 要绕过去就得写内核驱动。

所以零拷贝解码不适合这条路。以后 FPGA→RK 方向的 NPU 输入缓冲，同样可以从 CMA 分配，再用 `rknn_create_mem_from_fd` 或 `rknn_create_mem_from_phys` 交给 NPU。

## 6. 改完之后的下一步（test_feeder）

**接口核对**：MPP 1.0.1 与 RKNN 1.5.0 的头文件已逐行核对，下表为关键行。

| 接口 | 位置 |
|---|---|
| `MPP_BUFFER_TYPE_DMA_HEAP` | `mpp_buffer.h:129` |
| `MPP_BUFFER_FLAGS_CONTIG`（"means cma"） | `mpp_buffer.h:154` |
| `mpp_buffer_group_get` / `limit_config` | `mpp_buffer.h:305-318` |
| `MPP_DEC_SET_EXT_BUF_GROUP` / `MPP_DEC_SET_INFO_CHANGE_READY` | `rk_mpi_cmd.h:93-94` |
| NV12 = `MPP_FMT_YUV420SP` | `mpp_frame.h:213` |
| `rknn_create_mem_from_fd` / `rknn_create_mem_from_phys` | `rknn_api.h:583` / `rknn_api.h:599` |

**做法**：
1. 收到 info change 后，按 `buf_size` 从 cma 堆分配约 20 个缓冲，导入外部缓冲组，交给解码器。
2. 每个缓冲 mmap 后用 pagemap 查一次物理地址，建成"fd → 物理地址"表。
3. 每拿到一帧，按 Y 和 UV 各发门铃（行跨度 2304，FB_STRIDE 设为 2304）。
4. 完成计数到位后 FB_COMMIT，再把缓冲还给解码器。

**带宽**：不再经过 CPU 拷贝。按 30 fps 计约 112 MB/s，P30 x1 的门铃实测 392 MB/s，足够。
