Zdy-1110/FPGA-676/RK_NPU检测程序设计_20261018.md

# RK NPU 检测程序设计要点（2026-10-18，待用户确认）

## 1. 现状与约束（已核实）

**板上（只读查询，10-18 23:53）**
- RKNPU 驱动 v0.9.0，librknnrt 1.5.0（2023-05-25）。
- NPU 频率 200–900 MHz，调速器 rknpu_ondemand。RK3568 的 NPU 只有 1 个核，约 1 TOPS INT8。
- librga 2.1.0（API 1.9.3）。
- 板上没有 Python，也没有编译器，程序用 PC 上的 zig cc 交叉编译（`tools/rk_build.sh`）。

**PC**
- RKNN-Toolkit2（模型转换）只能在 x86 Linux 上运行。
- WSL 里装了 Ubuntu-22.04，但它是 WSL2；BIOS 关了 VT-x，所以起不来。

**已有基线**（`coco-detection-baseline`，PC 上的 yolo11n）
- 整帧缩到 640×384 时，行人、骑车人的召回只有 1280 输入时的约 41%，主要漏掉小目标。
- 建议改为：裁出路面带（y 360–1000，全宽），再缩到 960×320。
- 另外两点：用不分类别的 NMS（消除同一辆车被同时框成 car 和 truck）；COCO 没有锥桶、护栏、三轮车这几类。

**架构文档的长期方案**（§8）
- FPGA 生成 NPU 拼图（640×384 RGB888），用长写放进 RK 的 CMA 环形缓冲。
- RK 零拷贝推理，再把检测框写回 BAR1 0x900+。
- FPGA 侧的预处理和长写都还没做。

**OSD 检测框寄存器**（osd1）
- 0x900–0x97F，共 16 个框，每个框占两个 DW：{color[31:28], y0, x0} 和 {y1, x1}，坐标是 1920×1080 下的值。
- 颜色 0 表示不画；1 红、2 绿、3 黄、4 蓝、5 青、6 品红、7 白。
- **这组寄存器不按帧锁存**，写到一半时可能有一帧画面上新旧框混在一起。

## 2. 关键决策（我的建议）

1. **模型先用 YOLOv8n（COCO 预训练），不用 yolo11n。**
   - 板上运行库是 1.5.0，转换必须用同版本的 RKNN-Toolkit2 1.5.x，否则模型加载不了。
   - yolo11 的 C2PSA 注意力模块要到 toolkit 2.x、model zoo 2.3 才有官方支持。
   - 要用 yolo11，就得升级板上的 librknnrt（可能还要升级 NPU 驱动），属于改板子，暂不做。
2. **导出方式按 rknn_model_zoo 的 yolov8 方案。**
   - 用 airockchip 的 ultralytics 分支导出 ONNX：DFL 和后处理不放进模型，输出 3 个尺度 × {box 64 通道, cls 80 通道, score_sum 1 通道}。
   - 这样 INT8 量化误差小，后处理在 CPU 上用 C 写。
3. **输入尺寸 960×320**，对应原图 1920×640 的路面带，正好横竖都缩 2 倍，不变形，也不用补边。
   - 两边都是 32 的倍数，符合 YOLO 的要求。
   - 以后接 FPGA 拼图时，再转一个 640×384 版本。
4. **分阶段取输入源，NPU 模块不关心输入从哪来。**
   - 现阶段（测试视频模式）：在 RK 上用 RGA 把 MPP 解码帧（NV12，stride 2304，在 CMA 里）裁剪、缩放、转成 RGB888，放进另一块 CMA 缓冲。这一步是硬件完成的，约 2–3 ms。
   - 以后：改成直接吃 FPGA 长写进来的拼图。
   - 不用 CPU 做预处理：之前实测 CPU 读 MPP 缓冲只有 61 MB/s，一帧要 30 ms。
5. **零拷贝推理。**
   - 输入用 `rknn_create_mem_from_fd`（CMA dma-buf）加 `rknn_set_io_mem`。
   - 输出保持 INT8（`want_float=0`）；阈值先换算成量化域，只对超过阈值的候选做反量化。

## 3. 程序结构

新目录 `tools/npu_det/`，test_feeder 保持不动。

| 模块 / 线程 | 职责 |
|---|---|
| 解码送帧线程 | 复用 test_feeder 的逻辑：MPP 解码，30 fps 门铃送 FPGA，FB_COMMIT |
| 最新帧信箱 | 解码线程每出一帧，就把"最新帧"放进 1 格信箱：对 MppBuffer 加引用，并带上帧号。NPU 线程空闲时取走。来不及处理的帧直接跳过，不排队 |
| NPU 线程 | RGA 预处理（裁剪带默认 y 360–1000，以后可改读 CAL_BAND 0x988）→ `rknn_run` → 后处理 → 释放帧引用 |
| 后处理 | 3 个尺度的 DFL 解码 → 分数阈值（默认 0.30）→ 不分类别的 NMS（IoU 0.5）→ 坐标映射回 1920×1080（x×2，y×2+360）→ 类别归并 |
| 输出 | 最多 16 个框按分数排序写入 0x900+，没用到的框写颜色 0；文字 RAM 第 3 行显示 "NPU xx fps yy ms n=zz"；每帧检测结果写 CSV（帧号、类别、框、分数），便于取回 PC 评估 |

**类别与颜色（初版）**

| 类别 | 来源 | 颜色 |
|---|---|---|
| 行人 | person | 黄 3 |
| 骑车人 | bicycle/motorcycle 和 person 的框重叠 | 品红 6 |
| 车辆 | car/bus/truck 合并 | 青 5 |
| 交通灯 | 忽略，信号灯归 FPGA 全分辨率识别 | — |

红色 1 留给以后的"风险目标"，由决策逻辑决定。

**延迟**
- 一次推理预计几十毫秒，所以框会比画面晚 1–2 帧。
- 初版先接受。以后用帧号对齐：FPGA 按 §6 的显示延迟 D 去匹配。

**撕裂**
- 初版直接写寄存器，影响可以忽略（16 个框共 32 次 MMIO 写，不到 50 µs）。
- 以后可以在 RTL 里给框寄存器加影子和"提交"位，在 vs 时生效。

## 4. 模型转换流程（PC，WSL 里）

1. 用 airockchip/ultralytics_yolov8 分支加载 `yolov8n.pt`，导出 model zoo 格式的 ONNX（opset 12，输入 1×3×320×960）。
2. 准备校准集：从 `video_review/src` 的视频里均匀抽 150 帧，裁出路面带并缩到 960×320，写列表文件。
3. RKNN-Toolkit2 1.5.x：
   - `config(mean=[0,0,0], std=[255,255,255], target_platform='rk3568')`；
   - `build(do_quantization=True, dataset=calib.txt)`；
   - `export_rknn`；
   - 用 `accuracy_analysis` 查看每层的量化误差。
4. 在 PC 上，用 ONNX（fp32）和 RKNN 模拟器对同样的 10 帧做检测，比较框的一致性。

## 5. 里程碑与验收

| 编号 | 内容 | 验收 |
|---|---|---|
| M0 | 转换环境和模型（PC） | 生成 `yolov8n_960x320_i8.rknn`；在 PC 模拟器上，与 ONNX 在 10 帧上的召回比 ≥ 0.9 |
| M1 | `npu_bench`（板上，静态图） | 读一张 960×320 RGB888 原始图，跑 100 次 `rknn_run`。打印平均和最大耗时（分别在 600 MHz 和 900 MHz 下），以及检测结果；与 PC 结果的框 IoU ≥ 0.9 |
| M2 | 接进送帧程序 | 播放 113343 和 113539 时显示保持 30.0 fps，late 0；NPU ≥ 15 fps（实测为准）；显示器上框位置正确 |
| M3 | 评估 | 取回 CSV，与 PC 的 yolo11n 基线和 ONNX 结果对比召回与误检，写报告 |
| M4（以后） | 输入改为 FPGA 拼图；前方 640×384 拼图 + 后左右 2×2 拼图；针对锥桶、护栏等微调 | — |

## 6. 需要用户决定或操作的事

1. **转换环境**（二选一）
   - A（推荐，不用重启）：把 Ubuntu-22.04 切到 WSL1（`wsl --set-version Ubuntu-22.04 1`）。WSL1 不需要 VT-x，Toolkit2 是纯 CPU 的 Python 包，理论上能跑。如果跑不起来，再换 B。
   - B：你进 BIOS 打开 VT-x（Intel VT-x / AMD SVM），继续用 WSL2。
2. **下载**（需要同意）
   - WSL 里的 RKNN-Toolkit2 1.5.x wheel 和依赖（torch CPU、onnx、onnxruntime 等），约 1.5–2 GB；
   - airockchip/ultralytics_yolov8 分支（几十 MB）；
   - yolov8n.pt（约 6 MB）；
   - librga v1.9.1 头文件（不到 1 MB，M2 要用；之前搭交叉编译环境时你先没要）。
3. 分工：
   - 写规范、审查代码、上板测试；
   - 转换脚本、校准集脚本、`npu_bench`、集成代码。

## 7. 风险

- **NPU 帧率可能不够。** 960×320 的像素数是 640×640 的 75%；在 RK3568 上能否到 15 fps 以上，以 M1 实测为准。不够就降到 640×224，或者换更轻的模型。
- **WSL1 兼容性。** Toolkit2 依赖的某些原生库在 WSL1 下可能有问题，备选是开 VT-x。
- **Toolkit 1.5.x 的 wheel 对 Python 版本有要求。** Ubuntu 22.04 默认是 3.10；如果 1.5.x 没有 cp310 的 wheel，就要另装 Python 3.8（又是一次下载）。
- **COCO 类别不够用。** 没有锥桶、护栏、三轮车，需要自己采集、标注、训练，属于后续工作。
- **FPGA 感知。** 比赛基础任务③要求"基于 FPGA 感知"。NPU 检测是 RK 端的补充，FPGA 侧的车道线、信号灯、预处理仍要单独做。
