Zdy-1110/FPGA-676/选题3_硬件架构_FPGA视频中枢方案_20261018.md

# 选题三（ADAS）硬件架构：FPGA 视频中枢方案

> 2026-10-18 用户决定：**3 个 USB 摄像头（RK）+ FMC 双目（FPGA）**，采用 **FPGA 视频中枢**架构。USB 画面经 PCIe 送进 FPGA；FPGA 负责全部拼接、预处理和显示；RK 只做 USB 解码、NPU 推理和决策。
> 本文是新的主架构。下面这些内容沿用 `选题3_硬件层架构_双摄像头+HDMI降级方案.md`，不重复：
> - FMC 引脚限制（§1.1）、摄像头与 FPGA 引脚（§5）、时钟（§6）、LED 与按键（§10）、可复用代码（§12）；
> - 该文的 HDMI 容器方案降为**评测测试视频通路和 PCIe 故障时的降级通路**（本文 §6）。
> **2026-10-18 下午修订（用户决定）：评测测试视频改走 PCIe**：RK 解码 U 盘视频后把 NV12 帧经门铃写进 FPGA DDR3，FPGA 读出显示和处理。HDMI 输入只作后备（PCIe 故障时）。原因和实测见 §5.4，新寄存器见 §5.3。
> 标注说明：【确认】= 已核实；【推断】= 设计推理，未实测；【待定】= 需上板验证或待决定。

---

## 1. 结论

- **摄像头：**
  - 前方：FMC 双目 OV5640 ×2，左路作为前视画面，左右两路一起用于测距；
  - 后、左、右：3 个 USB 摄像头接 RK，每个独占一条 USB 总线。
- **数据流：** USB 摄像头 → RK 硬件解码和缩放 → **PCIe（FPGA 主动读）** → FPGA DDR3。双目直接进 FPGA DDR3。FPGA 输出两路结果：
  - 四宫格加叠加信息 → HDMI 显示；
  - NPU 拼图 → **PCIe（FPGA 写回）** → RK NPU 推理 → 检测框和决策经 PCIe 写回寄存器 → FPGA 叠加显示。
- **评测测试视频（U 盘）：** RK 硬件解码后，把 1920×1080 NV12 帧经 **PCIe 门铃**写进 FPGA DDR3（模式 T 全屏），约 93–112 MB/s。好处：像素不经 HDMI 编码，可与 PC 上的参考算法逐像素对比；每帧带帧号，能精确对齐真值、实测延迟；与 USB 摄像头共用同一条通路。（10-18 下午由 HDMI 改为 PCIe，见 §5.4。）
- **降级：** PCIe 断开时，FPGA 自动把测试画面和后、左、右三格切到 HDMI 输入；RK 改为经 HDMI 输出（模式 T 全屏播放测试视频，模式 Q 输出 2×2 拼图）。显示不中断，只是没有 AI 结果。
- **PCIe 能力【确认，10-18 实测】：** FPGA→RK 长传输 896 MB/s；RK→FPGA 现为 4 KB 命令 485 MB/s。本方案需要约 100 MB/s + 25 MB/s，余量充足。

## 2. 系统框图

```
                    ┌──────────────────────────── 盘古 100Pro+ (PG2L100H) ─────────────────────────────┐
 双目 OV5640 ──FMC──┤► DVP×2 采集（前L/前R，960×540@30，同时钟同时启动）─┐                           │
                    │                                                   │      ┌───────────────────┐ │
 RK HDMI TX ───────┤► MS7200 ─► HDMI 采集（仅 PCIe 故障时的后备）──────┼─AXI─►│ DDR3 1GB 多口仲裁 │ │
                    │                                                   │      │ 每路 3–4 帧环形缓存│ │
                    │  PCIe EP ─► DMA-R（长读）：测试视频 NV12 + USB 三路 ┘      │ + 时间戳          │ │
                    │      ▲                                                   └──┬──────┬─────┬───┘ │
                    │      │ 门铃寄存器（地址/帧号/时间戳）                        │      │     │     │
                    │      │                  ┌── 按时间戳挑帧对齐（延迟 D 可调）◄┘      │     │     │
                    │      │                  ├─► 四宫格合成 + OSD ─► MS7210 ─► 显示器 1080p60   │     │
                    │      │                  ├─► NPU 预处理：缩放/拼图/RGB888/帧头 ─────────┘     │
                    │      │                  ├─► 车道线、红绿灯（FPGA 本地）─► 规则判决 ─► LED0-3 │
                    │      │                  └─► 双目视差 → 检测框距离（扩展项）                   │
                    │  PCIe EP ◄─ DMA-W（长写）：NPU 拼图 → RK 预留内存环形缓冲 ◄──────────────────┘
                    │  BAR1 0x800–0xFFF：显示、OSD、按键 LED、标定、检测框/决策回写（§5.3）            │
                    └───────────────────────────────┬──────────────────────────────────────────────────┘
                                                    │ P29 金手指，Gen2 x2（P30 Gen2 x1 备用）
                    ┌──────────────────── RK3568 (OK3568-UP4) ─┴────────────────────────────────────────┐
 USB 摄像头 ×3 ─────┤► V4L2 MJPEG ─► MPP 硬解 ─► RGA 缩放为 960×540 RGB565 ─► 预留内存 ─► 写门铃       │
 (后/左/右)         │                                                                                  │
 U 盘 ──────────────┤► MPP 解码 ─► NV12 帧 ─► 预留内存 ─► 写门铃（模式 T）；PCIe 故障时改走 HDMI TX     │
                    │  NPU：rknn_create_mem_from_phys 直读拼图 ─► 后处理 ─► 检测框/决策写回 BAR1         │
                    └──────────────────────────────────────────────────────────────────────────────────┘
```

## 3. 物理连接

| # | 连接 | 说明 |
|---|---|---|
| 1 | 双目 OV5640 → MES-FMC-LPC-IO 子卡 → FMC（J33） | 安装在车前，左右基线水平。两颗传感器要同步，见 §7.3。**上电前跳线设为 J20→ADJ、J24→2V5（Bank L6 = 2.5V）**，依据是官方说明书，约束用 LVCMOS25 |
| 2 | USB 摄像头 ×3 → RK | **一个接 USB3 口 A、一个接 USB3 口 B、一个接板载 Hub 的任意口**，每个独占一条 USB 总线【确认，10-18 实测 USB 拓扑】。不要把两个摄像头接在 Hub 上 |
| 3 | 100Pro+ PCIe 金手指 → OK3568-UP4 **P29** | Gen2 x2。P29 对插拔敏感，**必须用支架或螺丝把卡固定牢**；P30（Gen2 x1）作备用。**10-18 晚 P29 连续 10 次建链失败（LTSSM 0x2，重插 2 次无效），同一张卡在 P30 一次成功，当前联调用 P30**（脚本加 `SLOT=p30`；BAR1 = 0xf4204000） |
| 4 | RK HDMI 输出 → 100Pro+ HDMI 输入（MS7200） | 仅作 PCIe 故障时的后备通路。10-17 测过：加载 4_12 环出例程前后，RK 都检测不到 HPD，这条链路尚未打通【待查】 |
| 5 | 100Pro+ HDMI 输出（MS7210）→ 显示器 | 1080p60。**主画面在这里看**（10-18 上板打通） |
| 5b | RK MIPI DSI 屏（DSI-1，1024×600） | 建议作副屏：RK 状态（NPU 帧率、链路、丢帧）、日志、标定参数。不放主视频：分辨率太低，且主画面不应依赖 RK |
| 6 | U 盘 → RK | 评测测试视频 |
| 7 | 调试：FPGA JTAG + USB-UART（COM13）；RK 串口和 WiFi SSH | — |
| 8 | 供电：两板各用自己的适配器，接同一插排 | 只能同时上电或断电 |

## 4. 逻辑通道与显示

| 通道 | 方位 | 主来源 | 降级来源 | 分辨率 |
|---|---|---|---|---|
| CH0 | 前 | OV5640 左（FMC） | — | 960×540@30 |
| CH0R | 前（右目） | OV5640 右（FMC） | — | 960×540@30，只用于测距，默认不显示 |
| CH1 | 后 | USB #1 → PCIe | HDMI 拼图 W1 | 960×540@30 |
| CH2 | 左 | USB #2 → PCIe | HDMI 拼图 W2 | 960×540@30 |
| CH3 | 右 | USB #3 → PCIe | HDMI 拼图 W3 | 960×540@30 |
| CHT | 测试 | U 盘视频 → RK 解码 → PCIe（NV12） | HDMI 整帧 | 1920×1080@30 |

**显示（1080p60）：**
- 模式 Q：四宫格，左上前、右上后、左下左、右下右，每格 960×540，不缩放。叠加检测框、距离、车道线、行驶箭头和报警红框。
- 模式 T：CHT 全屏，叠加箭头、红绿灯状态和报警。
- KEY4 切换，沿用原文档 §10。按场景放大（如倒车时放大后方）作为可选项。

## 5. PCIe 接口

### 5.1 数据面

| 方向 | 内容 | 机制 | 带宽 |
|---|---|---|---|
| RK→FPGA | 测试视频（模式 T），每帧 1920×1080 NV12：行跨度 1920 时 3,110,400 B，2304 时 3,732,480 B | 同下，写进 DDR3 的 TEST_FB 槽，写完一帧后写 FB_COMMIT（§5.3） | 93–112 MB/s |
| RK→FPGA | USB 三路，每帧 960×540 RGB565 = 1,036,800 B | RK 把帧放进预留内存，写**门铃**（缓冲区物理地址、帧号、时间戳）。FPGA 排队后**主动发长读请求**，把整帧读进 DDR3，完成后更新状态，RK 才可复用该缓冲区 | 3 × 31 MB/s ≈ 93 MB/s |
| FPGA→RK | NPU 拼图两张 640×384 RGB888（各 737,280 B）+ 64 B 帧头 | FPGA 按 NPU 帧率（默认 15 fps）把拼图**长写**进 RK 预留内存的环形缓冲槽，更新"最新槽号"寄存器（以后可加 MSI） | 约 22 MB/s |
| RK→FPGA | 检测框、决策 | BAR0 寄存器写 | 可忽略 |

**需要新做的 FPGA DMA（在 10-18 提速版基础上）：**
- **DMA-R（长读）**：**引擎已于 10-18 完成**（比特流 mrd1，详见 `PCIe_DMA提速_20261018.md` §4.1）。tag 0–31 循环使用，在途请求有上限（默认 16），完成包按"本命令内全局字节偏移"落地，FPGA 内带测试图校验器。实测 861 MB/s，320 KB 以内任意长度浸泡无错。**10-18 已接到 DDR3 并加了 16 深门铃队列**（比特流 ddr2，`PCIe_DMA提速_20261018.md` §4.2）：Gen2 x2 门铃排队约 795 MB/s，整帧 960×540 写 DDR3 后回读校验无错，随机门铃浸泡 5.87 GB 0 失败。剩下：门铃完成改 MSI 通知、门铃加时间戳、DDR3 多口仲裁（读出口给显示/拼图）。
- **DMA-W（长写）**：10-18 已做好 BAR1 0x250 扩展长度的写包引擎，只需把数据源从内部 RAM 换成 DDR3 读口。

### 5.2 RK 预留内存

> **【10-18 晚已落实：不改设备树，改为扩大 CMA】** 用户同意后，用 `fw_setenv` 在 U-Boot 的 bootargs 里加了 `cma=256M`。现在 CMA 为 256 MB，位于 0xDDC00000–0xEDC00000，在 4 GB 以下。
> - **分配方式：** 所有 RK↔FPGA 缓冲（解码帧、USB 摄像头帧、NPU 拼图环）都从 `/dev/dma_heap/cma` 分配，物理连续，实测 200 MB 一次分配连续。
> - **物理地址：** 用 `/proc/self/pagemap` 查（STRICT_DEVMEM=y，/dev/mem 读不到普通内存）。
> - **好处：** VPU 和 NPU 都能直接用 dma-buf 句柄（MPP 的外部缓冲组、`rknn_create_mem_from_fd`）。no-map 保留区做不到这一点，所以下面的 no-map 方案不再采用。
> - **详情与回退：** 见 `RK_CMA扩容方案_20261018.md`。下表的区域划分仍可作为各环形缓冲的容量参考。

（原方案，已被上面的做法替代）板上现有的保留区只有 ramoops 等小区域，CMA 共 16 MB 且已全部分配【确认，10-18】，所以要在设备树里新增一段 no-map 保留内存，约 16 MB：

| 区域 | 大小 | 内容 |
|---|---|---|
| USB_RING | 9 MB | 3 路 × 3 个缓冲 × 1 MB |
| NPU_RING | 约 6 MB | 4 个槽 × 2 张 × 737 KB + 帧头 |
| 预留 | 约 1 MB | 状态、调试 |

### 5.3 扩展寄存器：BAR1 0x800–0xFFF（10-18 下午定，取代原 BAR0 草案）

- **为什么不用 BAR0：** BAR0（8 KB）在官方设计里接的是 PIO 数据 RAM 通路，改它要动读完成包逻辑。BAR1（4 KB）已有写旁路（rt0101 的 tap，12 位地址）和状态读多路器（rt0206），rt_ddr_hub 就是这样接的，照此扩展风险最小。
- **别名问题【确认】：** BAR1 老寄存器的写译码只比较地址低 9 位，0x800 以上会别名到 0x000–0x1FF 的老寄存器。disp1 给每处老译码加了"地址第 11 位为 0"的条件。
- 0x000–0x7FF 仍为 DMA 引擎和门铃寄存器（见 `PCIe_DMA提速_20261018.md`）。
- 全部为 32 位寄存器；写入必须整 DW。

| 偏移 | 方向 | 内容 | 阶段 |
|---|---|---|---|
| 0x800 | 读写 | DISP_CTRL：bit0 VIDEO_EN，bit1 PAT_FORCE（强制测试图），bit2 OSD_EN，bit4 CSC_SEL（0 = BT.709，1 = BT.601，均为有限范围），bit12/13/14 字节序交换（DW 内字节、128 位内 DW、256 位高低半） | disp1 |
| 0x804–0x810 | 读写 | FB_BASE（复位 0x0400_0000）、FB_SLOT_SIZE（4 MB）、FB_STRIDE（1920）、FB_UV_OFF（1920×1080） | disp1 |
| 0x814 | 只写 | FB_COMMIT：[1:0] 槽号，[31:16] 帧号。RK 写完一帧的所有门铃并确认完成后写入；FPGA 在下一个帧起点换上 | disp1 |
| 0x820–0x830 | 只读 | FB_STAT（显示中的槽号、帧号、是否为视频）、输出帧计数、换帧计数、欠载行数、调试 | disp1 |
| 0x838 / 0x83C | 只读 | 版本 0x2026_1018 / 魔数 0x4453_5031（"DSP1"） | disp1 |
| 0x840 | 只读 | KEY_STAT：去抖后的 KEY0–KEY4，按下 = 1 | disp1 |
| 0x844 | 只读 | KEY_EVT：按键事件序号、键号、类型（短按 / 长按 1 s / 按住 3 s） | osd1 |
| 0x848 | 只读 | DRV_STATE：按键给出的所在车道、行驶 / 停止、左右变道请求 | osd1 |
| 0x84C | 读写 | LED_CTRL：[7:0] 主机给定值，[15:8] 覆盖掩码 | disp1 |
| 0x850 | 读写 | DECISION：L/S/R 三个箭头各 2 位（隐藏 / 灰 / 绿 / 红），bit8 报警 | osd1 |
| 0x880 | 读写 | OSD_CTRL：十字、引导线、y_bot 线、y_top 线、检测框、文字、箭头、报警红框的使能 | osd1 |
| 0x900–0x97F | 读写 | 16 个检测框：+0 {颜色[31:28], y0[27:16], x0[11:0]}，+4 {y1[27:16], x1[11:0]} | osd1 |
| 0x980–0x9A4 | — | 标定寄存器，字段与 `选题3_按键辅助标定与鸟瞰图车道线_FPGA设计_20261018.md` §4 相同（原 BAR0 0x180–0x1A4 整体平移到 BAR1 0x980–0x9A4） | osd1 / 之后 |
| 0xA00–0xBFF | — | 预留：原 BAR0 草案中的 TIME_US、ALIGN_D_US、USB 三路门铃、NPU_RING、通道来源等，届时在此分配 | 之后 |
| 0xC00–0xCFF | 只写 | 文字 RAM：4 行 × 64 字符 ASCII，每 DW 4 个字符，低字节在前 | osd1 |

FPGA 内的帧缓冲规则：4 个槽，RK 写第 n 帧到槽 (n+1) mod 4；FPGA 只在帧起点（场消隐开始）换槽，因此正在显示的槽只可能是最近两次提交之一，不会被覆盖。

### 5.4 测试视频改走 PCIe：板上实测与做法（10-18 下午）

RK3568 板上用 113343（HEVC 1080p30，BT.709 有限范围，21.85 s，655 帧）实测【确认】，脚本 `log/rk_env/gst_t.sh`、`gst_t2.sh`，输出 `log/rk_env/gst_t2_out.txt`：

| 测试 | 结果 | 说明 |
|---|---|---|
| mppvideodec 硬解 → fakesink | 655 帧 1.78 s，约 **368 fps** | 解码不是瓶颈 |
| NV12 → fdsink → /dev/null | 1.77 s | 不读数据时没有额外开销 |
| NV12 → fdsink → 管道 → dd | 40.2 s，**61 MB/s，约 16 fps** | 慢在 CPU 读解码器的输出缓冲（推断为不经缓存的映射） |
| 普通内存走同样的管道 | 491 MB/s | 管道本身不是瓶颈 |
| 每帧字节数 | 3,732,480 = 2304 × 1080 × 1.5 | MPP 把行跨度对齐到 2304，UV 紧接在 1080 行之后 |
| mppvideodec format=BGR16 / BGRx（RGA 转换） | 失败 | dmesg：`RGA_MMU unsupported memory larger than 4G`。解码缓冲落在 4 GB 以上（板上 0x1_F000_0000 起还有 256 MB 内存），RK3568 的 RGA 访问不到 |

结论：
1. **过渡办法**（不需要交叉编译环境）：`gst-launch-1.0 … mppvideodec format=NV12 ! fdsink | pcie_feed … stream - 2304`。pcie_feed 是无 libc 的 32 位 ARM 程序（`tools/pcie_feed/`），把帧经 320 KB 中转区分块写进 DDR3 并提交。上限约 16 fps，只用于把 FPGA 显示通路调通。
2. **全帧率 30 fps 必须用自写的 RK 程序**（依赖交叉编译环境）。**【10-18 晚已实现：test_feeder，采用下面第 1 种做法的变体】** 内存不用 DT 预留，而是把 CMA 扩到 256 MB；MPP 解码直接写进外部 CMA 缓冲，CPU 不拷贝。实测 30.0 fps、欠载 0，见 `tools/test_feeder/`。原先列的两种做法，按优先级：
   - **零拷贝**：设备树新增一段 4 GB 以下的连续保留内存，作为 MPP 的外部输出缓冲组；MPP 直接解码进去，FPGA 用门铃直接读。CPU 不碰像素，行跨度 2304 由 FB_STRIDE 处理。
   - **DMA32 + RGA**：MPP 输出缓冲改从 4 GB 以下分配，用 RGA 拷进保留内存（也可顺便去掉行跨度填充）。
3. 两种做法都要先有交叉编译环境，以及设备树改动（需用户同意）。

## 6. 降级与评测通路

| 情况 | FPGA | RK |
|---|---|---|
| 正常（模式 Q） | CH1–CH3 来自 PCIe | 写门铃、跑 NPU |
| 评测（模式 T） | CHT 来自 DDR3 的 TEST_FB 槽（PCIe 写入的 NV12） | MPP 解码 U 盘视频，经门铃送帧 |
| PCIe 断开或 DMA 超时 | 自动把 CHT 和 CH1–CH3 切到 HDMI 输入；LED4 灭 | 改为 HDMI 输出：模式 T 全屏播放测试视频，模式 Q 输出 2×2 拼图（沿用原方案的容器帧和帧尾标签） |

规则判决（红灯行驶、实线变道）和 LED、按键都在 FPGA 本地完成，任何情况下都不依赖 RK。

## 7. 时序、对齐与同步

### 7.1 统一时间基准
- FPGA 的 TIME_US 是全系统的"钟"。RK 定期读这个寄存器，同时记下自己的系统时间，求出两边的差值（读一次约 1.3 µs）。
- 双目帧在帧同步信号到来时打 FPGA 时间戳。
- USB 帧用 V4L2 时间戳，减去每路的固定延迟补偿后，换算成 FPGA 时间，写进门铃。

### 7.2 按时间戳挑帧（ALIGN_D_US）
每路保留最近 3–4 帧。输出时取"当前时间减去 D"作为目标时刻，每路选最接近的一帧，用于显示和 NPU 拼图。
- D = 0：延迟最小，不对齐；
- D ≈ 80–100 ms：4 路画面对齐；
- D ≈ 150 ms：检测框也按帧号对齐。

摄像头之间没有硬件同步，对齐后的剩余误差为 ±半帧（30 fps 时 ±16.7 ms）【推断】。

每路的固定延迟用 LED 法实测：FPGA 在已知时刻点亮一颗 LED，所有摄像头拍到它，比较时间戳。

### 7.3 双目同步（测距的前提）
左右两路必须同一时刻曝光，否则测距会出错。

官方例程的现状【确认，源码】：
- 两颗 OV5640 由同一个 `power_on_delay` 同时释放复位（`hdmi_ddr_ov5640_top.v:184-191`）；
- 两个 `reg_config` 实例并行配置（`:193-214`），所以两颗几乎同时开始出帧。

但 FPGA 不输出 XCLK，每颗模组用自己的 24 MHz 晶振（原理图 U27 为 CAM1 的晶振）。两颗晶振有频偏，两路的帧相位会慢慢漂开【推断】。

处理办法（二选一，需上板验证）：
- 定期通过 I2C 同时让两颗传感器停流再开流，重新对齐；
- 改模组，让两颗共用一个时钟源。

FPGA 侧按帧时间戳配对左右帧，相位差超过阈值时不做测距。

### 7.4 延迟估算【推断，需实测】

| 通路 | 估算 |
|---|---|
| 双目 → 显示 | 约 50–85 ms |
| USB → RK 解码缩放 → PCIe → FPGA → 显示 | 约 70–100 ms（比原 HDMI 容器方案少 1–2 帧） |
| 拼图 → NPU → 检测框回写 | 约拼图周期 + 推理 30–70 ms |

## 8. 视频格式与 NPU 拼图

| 数据 | 格式 |
|---|---|
| 双目存储 | 960×540 RGB565 |
| USB 帧（RK 侧 RGA 输出） | 960×540 RGB565 |
| 测试视频（PCIe，模式 T） | 1920×1080 NV12，行跨度 1920 或 2304（MPP 对齐）由 FB_STRIDE 给出；FPGA 读出时按 BT.709 有限范围转 RGB（CSC_SEL 可切 BT.601），色度取最近邻 |
| HDMI 输入（后备） | 1920×1080 RGB888 → RGB565 存储 |
| NPU 拼图 A | 前方单独，640×384 RGB888 NHWC（640×360 加上下补边） |
| NPU 拼图 B | 后、左、右各 320×180，拼成 2×2 共 640×384，第 4 格补零 |
| 帧头（64 B） | 魔数、拼图帧号、布局编号、每格的通道号、帧号和时间戳 |

NPU 后处理：检测框按中心所在格子归属到对应摄像头，按格子边界裁剪，NMS 分格做。拼图不会让 NPU 变快，只是共用一次推理、取同一时刻；实际帧率需实测。模型用 RKNN-Toolkit2 转换，量化校准图取真实拼图。

## 9. DDR3 规划（1 GB，32 位，峰值 4.26 GB/s）

| 区域 | 大小 | 内容 |
|---|---|---|
| CAM_L / CAM_R | 各 4 MB | 每路 4 帧 × 1 MB + 时间戳 |
| USB1/2/3 | 各 4 MB | 每路 4 帧 × 1 MB + 时间戳 |
| TEST_FB | 16 MB | 测试视频 4 槽 × 4 MB（NV12，PCIe 写入），起点 FB_BASE = 0x0400_0000 |
| HDMI_FB | 12 MB | 3 帧 × 4 MB（PCIe 故障时的后备输入） |
| NPU_OUT | 4 MB | 乒乓 2 组 × 2 张 × 737 KB |
| 视差 / OSD / 预留 | — | 扩展项 |

**带宽（正常 Q 模式）：**
- 写：双目 62 + USB 93 + 拼图 22 MB/s；
- 读：显示 249 + 预处理约 62 + 拼图上传 22 + 视差约 31 MB/s；
- 合计约 540 MB/s，约为峰值的 13%。

需要一个约 6 写、5 读的 AXI 多口仲裁器，在 `wr_rd_ctrl_top` 基础上扩展。

## 10. 模块清单

| 端 | 模块 | 来源 | 状态 |
|---|---|---|---|
| FPGA | 双目采集与 OV5640 配置 | 官方 `HDMI_DDR3_OV5640_100H` 例程 | 复用 |
| FPGA | HDMI 输入采集、1080p60 输出 | 官方 4_12 例程 | 复用 |
| FPGA | DDR3 + 多口仲裁 | 扩展 `wr_rd_ctrl_top` | 新做 |
| FPGA | PCIe EP + DMA-R / DMA-W + 门铃 + 时间基准 | 10-18 提速版扩展 | 新做（DMA-W 部分已有） |
| FPGA | 按时间戳挑帧、四宫格合成 + OSD | 新做；OSD 文字参考官方 3_11 | 新做 |
| FPGA | NPU 预处理：缩放、拼图、格式转换、帧头 | 新做 | 新做 |
| FPGA | 车道线、红绿灯、规则判决、LED/按键 | 原方案；参考官方 3_x 图像例程 | 新做 |
| FPGA | 双目视差 + 检测框距离 | 新做 | 扩展项 |
| RK | 交叉编译环境 | **Zig 0.14.1**（`zig cc -target aarch64-linux-gnu.2.36`，glibc 与板上一致）；头文件 MPP 1.0.1、RKNN 1.5.0；链接从板上拷回的 librockchip_mpp / librknnrt / librga；一条命令：`sh tools/rk_build.sh <out> <src.c> -lrockchip_mpp -lrknnrt` | **10-18 晚就绪**：冒烟测试在板上通过（MPP HEVC 解码器创建成功，librknnrt 1.5.0 加载）。WSL2 因 BIOS 未开虚拟化无法启动，只在以后做 RKNN 模型转换时才需要 |
| RK | ~~设备树预留内存~~ → CMA 256 MB | U-Boot bootargs `cma=256M` | **10-18 晚已完成**（见 §5.2） |
| RK | usb_feeder：采集 → MPP 解码 → RGA → 预留内存 → 门铃 | 新做 | — |
| RK | npu_infer：读拼图 → RKNN → 后处理 → 写回 BAR0 | 新做；板上 librknnrt 1.5.0 支持物理地址输入【确认】 | — |
| RK | test_feeder：U 盘文件 → MPP 解码 → 预留内存 → 门铃 → FB_COMMIT（30 fps） | **10-18 晚完成**：`tools/test_feeder/`。做法：零拷贝，MPP 外部缓冲组（EXT_DMA），24 个缓冲从 CMA 分配，pagemap 查物理地址，每帧 15 个 256 KB 门铃，按绝对时间节拍提交 | **板上实测（P30 x1）**：30.0 fps，655/655 帧，late 0，欠载 0；每帧 DMA 9.5 ms；不限速 103.8 fps（DMA 是瓶颈）；**用户目测：速度正常、流畅、无花屏、无撕裂、无卡顿** |
| RK | pcie_feed：无 libc 的过渡送帧工具（文件或 gst 管道 → 中转区 → 门铃），约 16 fps | `tools/pcie_feed/`，10-18 新做 | 只用于调通显示 |
| RK | HDMI 输出程序（PCIe 故障时：测试视频全屏、降级拼图） | 原 `adas_vsrc` 方案 | 降为后备 |

## 11. 实施顺序

| 阶段 | 内容 | 验收 | 依赖 |
|---|---|---|---|
| P0（可并行） | 搭交叉编译环境；买 **1 个** USB 摄像头样品上板测带宽和解码，合格后再买 3 个；确定预留内存方案 | 能编译出调用 librknnrt 的 aarch64 程序；样品摄像头 MJPEG 可用，预留带宽满足一总线一个 | 用户：BIOS 开虚拟化；购买 |
| P1 | FPGA 基础视频：双目采集 + DDR3 + 四宫格显示（另外两格先放测试图） | 显示器上看到双目两路画面 | 双目模组到位 |
| P2 | PCIe DMA-R + 门铃；RK 用测试程序推 3 路测试图 | 3 × 960×540@30 推送 10 分钟，逐帧校验无错，显示正常 | P1；预留内存 |
| P2 进度（10-18） | **DMA-R 引擎完成**：长读 + 在途上限 + 在线校验，861 MB/s；**长读落 DDR3 + 门铃队列完成**（ddr2）：门铃约 795 MB/s，960×540 整帧写入 DDR3 回读校验无错，随机门铃浸泡 20000 轮 / 5.87 GB 0 失败 | 待做：DDR3 多口仲裁与上屏、门铃 MSI、预留内存 | — |
| P2' 上板（10-18 晚，P30 Gen2 x1） | **显示通路和 OSD 骨架在板上打通**。①静态帧与参考图一致、颜色正常，**字节序用默认设置即正确**（不需要交换位）；②gst 硬解 → 管道 → pcie_feed 连续送帧 655/655，13.8 fps，**欠载 0**，瓶颈是 CPU 读管道（47 s 中 DMA 只占 0.24 s）；③pcie_bench D 回归 ALL PASS（门铃 392 MB/s @x1）；④OSD 7 项（文字、箭头、检测框、十字、射线、y_top/y_bot 线、LED）和 2 Hz 报警红框目视确认。上板时发现并修复：**官方 ms72xx_ctl 要等 HDMI 输入时钟才配置 MS7210**（无输入就黑屏）→ 改为先配 MS7210；osd1 上电误报 KEY4 短按、DRV_STATE 读 0 → 已修（osd1b）。**osd1b 上板按键与标定全部通过**：短按（车道循环、moving、左右请求 2 s 自动清除、显示模式）、长按（src_sel）、KEY4 按住 3 s 进入标定、连发加速（步长 2→8）、对象切换 VP→YB→G→VP、30 s 无操作放弃、保存后 CAL_VP=(936,600)、CAL_BAND=(720,1000)、CAL_GUIDE=576、CAL_CTRL=0x109，与理论值逐项一致。看代码又发现十字推过左/上边缘会绕到另一侧（无符号下溢）→ 已修并在 T8 补测（旧代码 FAIL、新代码 PASS）。**当前比特流 `D:\pango_work\pango_pcie_dma_x2_osd1c.sbit`**（时序全满足，像素时钟 +0.202 ns；上板复核：开机无误报事件、DRV 复位值对、静态帧正常、欠载 0、pcie_bench D ALL PASS）；日志 `log/rk_env/disp1_p30_run1.txt`、`osd1_p30_*.txt`、`osd1b_*.txt`；按键记录器 `tools/keylog.sh` | osd1c 上板 | — |
| P2' 进度（10-18 晚） | **disp1 已构建**（上板结果见上一行）：`D:\pango_work\pango_pcie_dma_x2_disp1.sbit`（prog_x2_disp1.tcl；工程 `out\build_disp1.tcl` 为 4 种子构建）。Questa T1–T6 全过：真实测试帧 1920×1080 逐像素一致、行跨度 2304 与字节交换、测试图、欠载与恢复、读口仲裁、寄存器与老译码隔离。时序全满足（像素时钟 +1.29 ns，pclk_div2 +0.535 ns）。资源 LUT 19%、DRM 40%、APM 9 个、GPLL 4/6。审查时修了 4 处：格雷码改为源域寄存后跨域、帧起点不再丢失并加确认（防止旧行数被当成新帧）、首帧视频标志、KEY_STAT 极性 | 上板：`tools/fpga_reload.sh D:/pango_work/prog_x2_disp1.tcl`，再用 pcie_feed 送帧 | — |
| P2' 显示骨架（10-18 下午起） | FPGA：DDR3 读出 → 1080p60 HDMI 输出（比特流 disp1）；读口仲裁；BAR1 0x800 扩展寄存器；RK 用 pcie_feed 送 NV12 帧。随后 OSD 骨架（osd1）：文字、箭头、检测框、报警红框、标定十字和引导线、按键事件 | 显示器上看到测试图和 RK 送来的视频帧；pcie_bench D 模式回归通过 | 现在只有两块板就能做 |
| P3 | RK usb_feeder 接真实 USB 摄像头 | 4 路实拍同屏；用毫秒计时器实测延迟 | P0、P2 |
| P4 | NPU 通路：FPGA 拼图 → DMA-W → npu_infer → 检测框回写 → OSD | 检测框叠加在画面上；记录 NPU 实际帧率 | P3；模型转换 |
| P5 | 时间对齐、HDMI 自动降级、评测模式 T（test_feeder 全帧率） | 模式 T 经 PCIe 以 30 fps 播放 U 盘视频；拔掉 PCIe 后切到 HDMI 输入，显示不中断 | P4；交叉编译环境 |
| P6 | 车道线、红绿灯、规则判决、LED/按键；双目测距（扩展） | 按评测要求逐项验收 | P1 起可并行 |

FPGA 侧的 P1 和 P6 不依赖 RK，可以先做；RK 侧所有程序都依赖 P0 的交叉编译环境。

## 12. 风险

| # | 风险 | 应对 |
|---|---|---|
| 1 | PCIe 是单点：P29 对插拔敏感；10-18 晚连续 10 次建链失败，P30 正常 | 当前用 P30（x1，够调显示）；P29 的 x2 到接 3 路摄像头时才需要，届时接上 FPGA USB-UART，用 ltssm_logger 抓训练过程定位；机械固定；HDMI 自动降级（§6） |
| 2 | ~~交叉编译环境未就绪，卡住全部 RK 程序~~ | 【已解决，10-18 晚】Zig 交叉编译；剩下 RKNN 模型转换要 x86 Linux（需 BIOS 开 VT-x 后用 WSL2，或另找 Linux 机器） |
| 3 | 3 路 MJPEG 硬解能力 | P0 用样品实测；不够就降到 960×540 采集 |
| 4 | DMA-R 标签复用、DDR3 多口仲裁的复杂度 | 先单路、再多路；每阶段压测 |
| 5 | NPU 帧率不足 | 前方优先，后左右轮询；必要时换更小的模型 |
| 6 | 双目两路不同步，测距不准 | §7.3 |
| 7 | 修改设备树有风险 | 先备份当前 DTB，改动前征得同意 |
| 8 | FPGA 程序目前用 JTAG 加载，掉电即丢 | 联调稳定后固化到 Flash，并做冷启动测试（原文档 §11） |
| 10 | 评测视频也走 PCIe 后，PCIe 故障会影响评测 | HDMI 输入作后备（§6）；但 RK→FPGA 的 HDMI 链路 10-17 未通（无 HPD），后备要单独打通 |
| 11 | MPP 输出缓冲 CPU 读出只有 61 MB/s，RGA 访问不到 4 GB 以上内存【确认，10-18】 | 全帧率走零拷贝或 DMA32 + RGA（§5.4），都依赖交叉编译环境；在此之前用 pcie_feed 以约 16 fps 调通 |
| 12 | ~~PCIe 写进 DDR3 的字节序未在硬件上确认~~ | 【已解决，10-18 晚】上板看图确认默认设置即正确，交换位保持 0 |
| 9 | Bank L6 电压设错可能伤摄像头 | 按官方说明书 J20→ADJ、J24→2V5；约束用 LVCMOS25。官方 fdc 写的 LVCMOS33 与说明书不一致 |

## 13. FPGA 预处理：怎样真正减轻 NPU 的负担

缩放、拼图和格式转换**本身不减少 NPU 的运算量**（运算量与输入像素数成正比），但能省掉 RK CPU 的前处理。真正减负靠下面几招：

| 手段 | 做法 | 对 NPU 的作用 |
|---|---|---|
| 1. 把经典视觉任务交给 FPGA | 车道线、红绿灯、斑马线在 FPGA 上用传统算法做 | NPU 只跑一个目标检测模型（车、人、障碍物），不用再跑车道线或信号灯模型。**这是最大的一项减负，也符合赛题"基于 FPGA 感知"的要求** |
| 2. 只送有用区域 | 前视裁掉天空和车头，侧后视只保留近处路面 | 输入像素减少约 30–50%【估计】 |
| 3. 只送有变化的画面 | FPGA 做帧差或运动检测，静止、无目标的画面降频或跳过推理 | 平均推理次数下降，与场景有关 |
| 4. 双目测距放在 FPGA | 视差（块匹配）加上检测框，得到距离 | 不需要跑深度估计网络 |
| 5. 画面增强 | 伽马、去噪、统一亮度 | 检测更稳定，可以用更小的模型或更低的分辨率 |
| 6. 缩放、拼图、格式转换 | 直接输出 NPU 要的 RGB888 NHWC | 省掉 RK CPU 前处理（RKNN 例程中这一步常占每帧数毫秒到十几毫秒），帧率常常就卡在这里 |

### 13.1 官方例程能复用什么（2026-10-18 核实）

**双目例程** `7_FMC扩展子卡及Demo/2_Demo/HDMI_DDR3_OV5640_100H`（源码副本在 `D:\pango_work\ref_dual_ov5640`）：
- **只显示一路：** 两路都完成配置和 8→16 位拼字，但只有一路写 DDR3 并显示，由 `` `define CMOS_2 `` 选择（`hdmi_ddr_ov5640_top.v:23-24, 255-265`）。两路同时存储和四宫格显示要自己写。
- **寄存器配置：**
  - 每路 **257 条有效寄存器写入**：循环跑 357 步，空缺的序号走 default 分支（`reg_config.v:77`）；
  - I2C 约 10 kHz（`:57-62`）。
- **输出格式：**
  - 1280×720 RGB565：`reg_config.v:332-335` 中 0x3808=0x05、0x380A=0x02、0x380B=0xD0；`:163` 中 0x4300=0x60；
  - PLL：0x3034=0x1A、0x3035=0x21、0x3036=0x69、0x3037=0x13（`:113-114, 317-318`）。
- **自动对焦：** 没有下载 AF 固件（找不到 0x8000 起的写入和 0x3022），镜头停在音圈电机的静止位置【推断】。这对双目标定反而有利。
- **复位与时钟：**
  - 两路共用一个复位信号（`power_on_delay.v:37-38`）；
  - PWDN 未连接（`top:189`）；
  - FPGA 不输出 XCLK，由模组晶振提供【推断，端口和 fdc 中都没有 xclk】。
- **拼字：** 16 位侧时钟用 `GTP_IOCLKDIV_E2` 对 PCLK 二分频（`cmos_8_16bit.v:59-66`），输出打 3 拍。
- **帧缓存：**
  - `fram_buf` 只有一个写口、一个读口，**2 帧乒乓**（`wr_buf.v:303`、`rd_buf.v:137`）；
  - 1280×720×16 位，DDR3 32 位，AXI 256 位，突发最多 16 拍（`wr_cmd_trans.v:169`）；
  - 显示 720p30，像素时钟 37.125 MHz（`top:147`）。
- **约束：** fdc 中**没有摄像头 PCLK 的 create_clock**，摄像头时钟域没有时序约束。我们的工程要补上。
- 例程里没有任何图像处理。

以上依据例程源码逐段整理，其中寄存器条数、XCLK、帧缓存结构已人工复核。

**板卡图像例程**，资料包 `2_Demo/3_x`，已解压到 `D:\pango_work\img_demos`：

| 模块 | 来源 | 用途 |
|---|---|---|
| `RGB2YCbCr.v` | 3_2 等 | 灰度（取 Y） |
| `matrix_3x3.v` + 行缓存 FIFO | 3_4、3_6、3_8、3_9 | 3×3 窗口，`IMG_WIDTH` 参数默认 1920，可改 |
| `binarization.v`、`area_bin.v` | 3_4 | 二值化 |
| `erosion.v`、`dilate.v`、`matrix_3x3_1bit.v` | 3_5 | 腐蚀和膨胀，可清理红绿灯、车道线掩膜 |
| `median_filter_3x3.v`、`sort3.v` | 3_6 | 中值去噪 |
| `gauss_filter.v` | 3_8 | 高斯平滑 |
| `sobel.v` | 3_9 | 边缘检测，`SOBEL_THRESHOLD=28`，输出二值边缘 |
| `gamma_table.v` | 3_10 | 伽马和亮度 |
| `char_proc.v` | 3_11 | 字符叠加（OSD） |

这些例程除字符叠加外，都把处理放在"采集之后、写 DDR3 之前"，是流式逐像素处理。例如 Sobel 例程：`RGB2YCbCr`（top:167）→ `sobel`（:226）→ `fram_buf`（:250）。字符叠加 `char_proc` 放在**读出 DDR3 之后、显示之前**。

**细节与注意事项**（标"已复核"的为人工核对过）：

| 模块 | 关键参数 | 行缓存 | 延迟 |
|---|---|---|---|
| RGB2YCbCr | Y = (77R + 150G + 29B) >> 8，Cb/Cr 未用 | 无 | 3 拍 |
| matrix_3x3 | IMG_WIDTH/IMG_HEIGHT 参数（默认 1920×1080），x/y 计数器 11 位（最大 2047，已复核）；首末行和行首行尾不做边界钳位 | 2 × FIFO（4096 深 × 8 位） | — |
| binarization | 全局阈值 128 | — | 1 拍 |
| area_bin | 3×3 均值作阈值的局部二值化；**3_4、3_5 里输出没接进写 DDR 的数据**，实际没用上 | 同上 | 4 拍 |
| erosion / dilate | 1 位 3×3 | matrix_3x3_1bit | 各 2 拍 |
| median_filter_3x3 | 7 次 sort3 取中值 | 同 matrix_3x3 | 3 拍 |
| gauss_filter | 核 [1 2 1; 2 4 2; 1 2 1] / 16 | 同上 | 3 拍 |
| sobel | \|gx\| + \|gy\|，不开方，阈值 28，输出 0/255 | 同上 | 3 拍 |
| gamma_table | 256 项查找表写死 | 无 | 1 拍 |
| char_proc | 128×32 字模写死，位置 (1500, 750) | 字模 ROM | 2 拍 |

- ⚠️ **Sobel 有笔误（已复核）：** `sobel.v:86-87` 的 gy 与 `:67-68` 的 gx 公式完全相同，实际只算了横向梯度，只能检测竖直方向的边缘。复用时要把 gy 改为上下两行之差。车道线在透视图中多为斜线，用横向梯度为主也可以，但要有意识地选择，不能把笔误当成设计。
- RGB2YCbCr、matrix_3x3 在各例程中逐字节相同，可以只取一份。
- 改分辨率时要同时改：matrix_3x3 的 IMG_WIDTH、sync_vg 的 H_ACT、fram_buf 的 H_NUM。

**例程里没有、需要自己写的：**
- 缩放器（双线性）；
- 颜色空间转换到 HSV，以及红绿黄阈值分割（红绿灯）；
- ROI 掩膜和车道线拟合（霍夫变换或滑窗）；
- 帧差和运动检测；
- 双目块匹配；
- NPU 拼图打包和帧头；
- 时间戳挑帧和 DMA。

### 13.2 建议的预处理流水线

```
前视 L（采集后）─► 伽马 ─┬─► 缩放 ─► 拼图 A（NPU）
                        ├─► 灰度 ─► 高斯 ─► Sobel ─► ROI ─► 车道线拟合 ─► 车道寄存器
                        ├─► HSV ─► 红/绿/黄阈值 ─► 腐蚀膨胀 ─► 连通域 ─► 红绿灯状态
                        └─► 帧差 ─► 运动标志（控制 NPU 送帧频率）
前视 L + R ─► 灰度 ─► 低分辨率块匹配 ─► 视差图 ─► 检测框内取中值 ─► 距离
USB 三路（DDR3 中）─► 缩放 ─► 拼图 B（NPU）
```

## 14. 摄像头选型

### 14.1 双目模组
- 买**小眼睛官方 Double_OV5640**（店铺"小眼睛科技官方旗舰店"，选"双目摄像头 无超广角"，2026-10-18 用户截图标价 ¥289）。它与官方例程、引脚约束一一对应。
- 选**普通视角，不选超广角**。测距需要每度视角上有更多像素、畸变更小；超广角会降低远处测距精度。
- 两颗模组通过 FPC 软排线连到底板。装车时要用刚性支架固定：两颗平行朝前，基线固定（建议 6–12 cm）。然后做双目标定。
- 不启用自动对焦，保持对焦固定，标定结果才稳定。

### 14.2 USB 摄像头（3 个，后、左、右）

| 项目 | 要求 | 原因 |
|---|---|---|
| 接口 | USB 2.0 UVC 免驱（USB3 也可） | 内核已开 `CONFIG_USB_VIDEO_CLASS=y`，插上即用 |
| 格式 | **MJPEG 1280×720@30**，最好同时支持 960×540、640×480 | USB2 带宽有限，MJPEG 由 RK 硬件解码 |
| 帧率 | 稳定 30 fps，可关闭"曝光优先"（exposure_auto_priority=0）；支持 720p60 更好 | 时间对齐，降低延迟 |
| 传感器 | 1/2.7"–1/2.9" 宽动态或星光级，例如 IMX291、IMX307、IMX335、SC2335、AR0230、OV2710 一类；避免低端小靶面 | 车外反差大（天空、阴影、隧道），夜间也要能用 |
| 镜头 | **定焦**，最好是 M12 可换镜头。后视 120–140°，左右 100–120°，选"无畸变"或低畸变款；不选鱼眼（本方案不做环视） | 检测更准，焦距可调 |
| 快门 | 卷帘快门可以；预算允许时选全局快门 | 运动模糊和果冻效应更小 |
| 外形 | 模组板（如 38×38 mm）配 1–3 m 线，或带外壳和支架 | 方便装车模 |
| 功耗 | ≤ 1 W，USB 供电 | — |
| 数量 | **同一型号 3 个，先买 1 个样品**上板测试 | 一致性、风险控制 |
| 避免 | 只有 YUYV 的高清款；自动对焦；只输出 H.264；带"美颜"或电子防抖；夜间自动降帧且不能关 | — |

**样品到货后我在板上测：**
1. `v4l2-ctl --list-formats-ext`：确认有 MJPEG 720p30；
2. 看它占用的 USB 等时带宽（端点包长），确认一条总线放得下；
3. 确认能设置 exposure_auto_priority=0；
4. 用 MPP 硬解，测 3 路同时 720p30 是否稳定；
5. 用 LED 法测摄像头自身延迟（§7.2）。
