Zdy-1110/FPGA-676/P29成功与失败差异分析_20261018.md

# P29 成功与失败差异分析（2026-10-18）

前提：没有示波器和万用表，只用软件、日志和受控的插拔来定位。

数据来源：
- 10-14 至 10-18 全部会话记录。按 P29（3c0800000）每次建链结果、每次烧录的比特流、用户的每次物理操作，抽成时间线：`log/p29_gap/timeline_raw.txt`。
- 「PCIe插槽通信问题分析」会话的硬件结论（记忆 `ok3568-pcie-slot-hardware`）。
- RK3568 TRM 中 PCIE30_PHY_GRF 一节（`docs_ext/scratch_rkdoc/trm1_phygrf_raw.txt`）。

下文时间均为本地时间（UTC+8）。

## 1. P29 的全部成功记录

| # | 时间 | 成功前做了什么 | 成功维持了多久 |
|---|---|---|---|
| 1 | 10-14 19:03 | 首次上板，烧 x2 | 当天的测试 |
| 2 | 10-15 18:07、20:19、20:26 | 20:17 "板卡已重新插到底" | 和失败交替出现，20:34 起连续失败 |
| 3 | 10-17 17:31 | "卡重新插在 P29、核心板已压紧并加了支撑"，两板上电，烧原版 x2 | 第一次启动就连上，30 分钟 soak 误码 0；**之后 10 次软重启 0/10**，期间没人碰板子 |
| 4 | **10-17 23:25 → 10-18 16:53** | 卡从 P30 换回 P29，两板重新上电，烧 ltssmlog | **最稳的一段**：3/3，之后每次软重启和 JTAG 重载都连上（post1_0、fast1/2、mrd1、ddr1、ddr2）。RK 从 05:30 起没断电，16:53 读到仍是 Gen2 x2 在线 |

## 2. 失败分两种

| 模式 | 出现时间 | RK 侧 | FPGA 侧 | 含义 |
|---|---|---|---|---|
| A | 10-15 晚、10-17 白天 | 0x3→0x8→0x2，Link Fail | CDR 锁定，进入 POLL_CONFIG → CFG_LINKWD_ACEPT，3.1 ms 超时（ltssmlog 记录） | RK 发的 FPGA 收得到；RK 收不到 FPGA 的 TS |
| B | 10-15 21:12、10-17 22:33 以后、**10-18 19:55 以后约 18 次** | 停在 0x2（Polling.Active） | 两条 lane 的 CDR 都不锁，LED4/5/6/7 全灭（dbgled），PLL 和 refclk 正常 | 接收端检测两边都通过（直流通），但**两个方向、两条 lane 都没有交流信号** |

另外，LTSSM 0x0 的失败是 FPGA 还没配置或者槽是空的，属于操作时序，不算故障。

## 3. 成功 #4 和 10-18 晚的失败：哪些因素相同（已排除）

| 因素 | 证据 |
|---|---|
| 比特流 | 19:57 换回成功 #4 最后用的 **ddr2.sbit**，同样 0x2 失败 |
| FPGA 卡本身 | 同一张卡在 P30 每次都能连上 |
| RK 内核和 DT | DT 没改过；cma=256M 是 21:54 加的，比首次失败（19:55）晚 |
| 重载流程 | 都是 fpga_reload.sh 的安全流程：先断链，再 JTAG，再软重启 |
| 温度、断电时长 | 10-17 冷启动（断电 10 分钟以上，38 °C）也失败 |
| 复位时序 | rstfix 比特流在 10-17 测过，无效 |

## 4. 成功 #4 和 10-18 晚的失败：不同之处

链路在 **16:53 还在线**，**19:55 第一次重新训练就失败**。这三个小时里发生了：

1. **RK 接了 MIPI 屏**。19:37 RK 已经识别出 DSI-1（1024×600）。MIPI 面板只在开机时探测，所以接屏之后 RK 至少重新上电过一次。那次上电后 P29 是好是坏，没有记录。
2. **在插在 P29 的 FPGA 卡上插了 HDMI 线**（19:51）。插线会对卡施加侧向或向下的力。
3. 之后的物理操作：
   - 20:15 拔掉 HDMI 后软重启，失败，但 FPGA 没断电，不是干净的对照；
   - 20:26 断电重插，此时 HDMI 已插回；
   - 22:16 "插回 P29 并**固定好**"，用螺丝固定了挡板，是否改变卡的姿态未知。
   
   这些全部失败。**"MIPI 和 HDMI 都不接、全断电、P29" 这个组合 10-18 一次也没测过。**

但 MIPI 和 HDMI 不可能是根因：10-15 和 10-17 没接它们也出现过同样的失败。它们最多是诱因，例如插线时的机械扰动。

## 5. 从成功和失败的规律能推出什么

1. **好坏状态主要在"插入"那一刻决定，之后大体保持。** 成功段几乎都开始于一次物理重插；一段失败里，软重启、全断电、换比特流、按压都救不回来。随机的电气余量不足不会表现成这样，更像**机械接触状态**或**某个受板子形变影响的焊点**。
2. **但好状态也会在没人碰的情况下翻转。** 成功 #3 在 30 分钟满负载 soak 之后，第一次软重启就坏了，说明余量本来就是临界的，热膨胀或负载后的形变可能足以让它翻转。#4 能扛十几个小时，说明那次插入余量较大。
3. **模式 B 只用一个原因就能解释全部 4 对差分线同时没信号。** 有两类候选：
   - **(a) RK 的 PCIe3 PHY 没在工作**，比如 U53 CLK0 → `PCIE_A_CLK` → RK 这一路参考时钟缺失。此时 RK 发不出 TS、也锁不住接收，但接收端检测是模拟电路，照样通过。板子形变（插拔卡时底板受力）可以让 U53 附近一个虚焊点时通时断。这也是另一个会话列的头号嫌疑。
   - **(b) 金手指或插槽在 4 对线所在区域整体接触电阻偏高**。几百欧的接触电阻仍能通过接收端检测，但会把 GHz 信号衰减到对端认为是电气空闲。问题是 refclk（A13/A14）就在旁边却正常（LED3 在闪），所以这一类的可能性小一些。
   - 模式 A（RK 能发、收不到）也和 (a) 相容：参考时钟质量差（幅度低、抖动大）时，TX 还能凑合工作，RX 的 CDR 先锁不住。
4. **没有仪器的情况下，有一个关键手段：RK3568 PCIe3 PHY 自带参考时钟检测器，还能切换参考时钟源。** 见 TRM PCIE30_PHY_GRF 一节，基地址 0xFDCB8000，与 live DT `syscon@fdcb8000` 一致：

   | 寄存器 | 位 | 含义 |
   |---|---|---|
   | `GRF_PCIE30PHY_CON3`（0xFDCB800C） | bit15 `phy0_ref_use_pad` | 复位值 1 = 使用外部引脚时钟（U53 CLK0）；0 = 使用 `ref_alt_clk`（芯片内部；DT 里 PHY 已挂上并使能 `refclk_m/refclk_n`，即 PMUCRU CLK_PCIE30PHY_REF_M/N）。改动后必须复位 PHY |
   | 同上 | bit13 `phy0_ref_clkdet_en` | 打开引脚参考时钟检测，复位值 0 |
   | `GRF_PCIE30PHY_STATUS0`（0xFDCB8080） | bit29 `phy0_ref_clkdet_result` | 检测结果 |
   | 同上 | bit27 `phy0_mplla_state` | PHY 锁相环状态 |

   写 CON3 时，高 16 位是写使能位，例如只置 bit13：`0x20002000`。

   **注意：U53 CLK0 → RK 这一路和 P29 里插没插卡无关。** 所以卡插在 P30 时也可以检查它。

## 6. 不用仪器的验证（按代价从低到高）

> 主会话正在用 JTAG 固化 flash。下面的实验都要等它结束，不能同时操作两块板子。

**V1 只读，查 RK 这一路参考时钟（约 1 分钟）。**
先确认 PHY 的 APB 时钟开着，再读寄存器，避免访问被门控的外设把 RK 卡死：

```sh
grep -iE "pcie30phy|pclk_pcie30" /sys/kernel/debug/clk/clk_summary
devmem 0xfdcb8080 32     # STATUS0：看 bit27 mplla_state
devmem 0xfdcb800c 32     # CON3：确认 bit15=1（用的是外部引脚）
```

- 如果 PHY 在建链失败后被关掉了，mplla_state 会是 0，这时只能说明 PHY 没在运行。
- 要直接判断时钟有没有到，需要打开检测器：`devmem 0xfdcb800c 32 0x20002000`（只置 bit13），再读 STATUS0 的 bit29。这一步是写寄存器，需要你同意。
- 判读：clkdet=0 → U53 CLK0 这一路**现在**就没有时钟，P29 必然失败，基本定位到 RK 侧时钟。clkdet=1 → 这一路至少此刻正常，重点转向接触。

**V2 受控插拔，排除 10-18 新增的变量（约 10 分钟，你操作）。**
1. 拔掉 MIPI 屏和 FPGA 的 HDMI 线，两板断电。
2. 卡插进 P29，**挡板先不拧螺丝**，让卡自己找正。
3. 上电，`fpga_reload` 烧 ddr2 或 osd1c。
4. 如果连上了，再逐个接回 HDMI、MIPI、螺丝，每接一样软重启一次，看是哪一步让它坏的。

**V3 需要你同意：把 P29 的 PHY 改用内部参考时钟（决定性实验，成功的话也是一个长期绕行方案）。**
- 做法：在 U-Boot 命令行（COM9）启动内核之前，执行 `mw.l 0xfdcb800c 0x80000000`（ref_use_pad=0），然后 boot。PHY 复位由内核驱动完成。
- 改完后两端时钟不再同源（RK 用内部 100 MHz，FPGA 用 U53 CLK1），变成 SRNS 方式。两边都不带展频，±ppm 在 PCIe 容限内。可能还要把 `rx0/rx1_cmn_refclk_mode` 改成 separate refclk，TRM 里同一组寄存器。
- 判读：P29 能连上 → 坐实 U53 CLK0 这一路的问题，可以把这条命令写进 U-Boot 的 `bootcmd`，长期绕开它。仍然失败 → 时钟这一支基本排除，剩下插槽接触和 RK PHY 本身。
- 未验证的点：本地没有这版 BSP 的 `phy-rockchip-snps-pcie3.c` 源码，不确定内核驱动会不会改写 CON3。要先在板上做一次只读确认：启动后读 CON3，看 bit15 是否还是 0。

**V4 以后每次尝试都留证据。**
`fpga_reload.sh` 现在只抓 "Link up/Fail" 和最后一行 "Linking"。建议改成每次都保存：
- 完整的 PHY/PCIe 相关 dmesg（`snps pcie3phy`、`lock failed`、`3c0800000` 各行）；
- STATUS0 和 CON3 的值。

这样以后成功和失败可以直接对比。到目前为止，P29 失败的启动**一次完整日志都没留下**。

## 7. 不用仪器测不了的

- U53 CLK0 的幅度和抖动是否处于临界状态。clkdet 只给出有或没有。
- 插槽每个触点的接触电阻。
- 是否有虚焊。只能间接判断：施加按压或形变后，现象是否随之变化。

这些需要万用表或示波器，见记忆 `ok3568-pcie-slot-hardware` 里测 R442–R445 直流电平的办法。

## 8. V1 结果（23:30，只读，日志 `log/p29_gap/v1_phy_status_p30cfg_20261018.txt`）

当时卡插在 P30，P29 是空槽，RK 刚冷启动。

1. **建链失败后，PHY 的时钟全被驱动关掉了。** 以下时钟的使能计数都是 0，所以 GRF 寄存器按设计没有读：
   - `pclk_pcie30phy`
   - `clk_pcie30phy_ref_m/n`
   - `aclk_pcie30x2_*`
   - `pclk_pcie30x2`

   这说明开机后从用户态去读 STATUS0 或打开时钟检测器都没有意义，因为 PHY 已经断电。要观察训练过程中的 PHY 状态，只能让驱动在建链失败后保持 PHY 上电（改 DT 或驱动），或者在训练的那 2.6 秒内去读。
2. **PHY 初始化正常。** 本次启动和 **10-18 20:14 那次 P29 插卡、模式 B 失败的启动**都打印了 `snps pcie3phy FW update! size 8192`，都没有 "lock failed"，与成功启动一致。
   - 推断：BSP 驱动要等 SRAM 初始化完成后才装 PHY 固件，而 SRAM 初始化依赖参考时钟。所以失败那次，U53 CLK0 → RK 这一路**至少在 PHY 初始化时是有时钟的**。
   - "这一路完全没有时钟"基本排除。仍然排除不了的是：时钟质量临界（幅度低、抖动大），或者 PHY 起来了但 lane 没有进入 P0 状态、没有驱动 TX。
3. **嫌疑排序随之调整。** 模式 B 是"两边都检测得到对端，但两个方向都没有交流信号"。结合"好坏状态在插卡那一刻决定"这一规律，**插槽或金手指在 lane 区域接触电阻偏高**升为第一嫌疑；RK PHY 或时钟质量降为第二。
4. **下一步建议：**
   - 先做 V2（受控插拔，无仪器，零风险）；
   - V3（切内部时钟）仍然能检验"时钟质量"这一支，但先验概率下降了，排在 V2 之后；
   - V4 照做：P29 的每次尝试都保存完整的 PHY/PCIe 启动日志。

## 9. 修复尝试（23:35–23:55，卡在 P29，FPGA 从 flash 启动 osd1c）

| 尝试 | 条件 | 结果 | 日志 |
|---|---|---|---|
| 冷启动 | 两板一起上电，**完全不用 JTAG**，FPGA 由 flash 配置 | 0x2，Link Fail | `log/p29_gap/attempt_20261018_2335_coldboot.txt` |
| 普通软重启 | 同上 | 0x2，Link Fail | 同上 |
| **V3：内部参考时钟** | 在 U-Boot（COM9）写 GRF：CON3 = 0x80000000（ref_use_pad 0x9860→0x1860），CON5/CON6 = 0x02100000（cmn_refclk_mode 和 mpll_mode 清零，0x2A90→0x2880），回读确认后 boot | PHY 正常初始化（FW update，没有 lock failed），但仍然 **0x2，Link Fail**，与以前一样 | `v3_uboot_read_before.txt`、`v3_uboot_write.txt`、`v3_boot_serial.txt`、`v3_result.txt` |
| 恢复 | 普通软重启，GRF 回到复位值 | 0x2 | `v3_result.txt` |

**结论：**
1. "FPGA 配置晚了或没配好"彻底排除。从 flash 冷启动的 osd1c 在 P30 上 4.7 秒就能建链，在 P29 上失败。
2. **U53 → RK 那一路参考时钟基本排除**，有两条证据：
   - 失败的启动里，PHY 都能正常初始化；
   - 完全改用内部时钟后，失败现象一模一样。
   
   保留一点：建链失败后 PHY 时钟被关掉，没法在内核里回读确认 CON3 没被驱动改回去。不过 rk3568 的 PHY 初始化流程不写 CON3。
3. 剩下的解释：
   - **P29 插槽或金手指在 lane 区域接触电阻偏高。** 这种情况下直流接收端检测仍能通过，但 GHz 信号被衰减到对端判为电气空闲。它和"好坏在插卡时决定、插 HDMI 或拧螺丝之后变坏"这一规律最吻合，**列为第一嫌疑**。
   - RK PCIe3 PHY 两条 lane 的模拟收发电路，或 P29 走线本身。这一项没法用软件区分。
4. **软件能动的手段基本用完了。** 已经试过：
   - FPGA 比特流的各种变体；
   - TX 摆幅、去加重；
   - 复位时序；
   - FPGA 从 flash 冷启动；
   - RK 参考时钟源。

   剩下的修复办法只有机械方面（V2）：
   - 不接 HDMI 和 MIPI；
   - 挡板**不拧螺丝**，让卡自然落位；
   - 确认靠挡板一端（lane 0/1 的引脚就在这一端，键槽之后的 14–22 号针）完全插到底、卡身水平；
   - 必要时用无水酒精清洁插槽簧片，晾干后再插。

   如果几次受控插拔都不行，就只能长期使用 P30。P30 实测 392 MB/s，已经满足计划中约 230 MB/s 的需求。
