Zdy-1110/FPGA-676/PCIe_DMA提速_20261018.md

# PCIe DMA 提速（2026-10-18）

链路：RK3568 P29（pcie3x2）↔ PG2L100H，Gen2 x2，lane 1 去加重已修复（见 `PCIe_Gen1链路稳定性测试_20261017.md` §5.12）。

## 1. 结论

| 测试项 | 优化前（官方参考 DMA） | 第 1 步：去掉 16 位搬运 | 第 2 步：长命令 + 256 B 包 | 第 3 步：长读 + 未完成数限制（P2） |
|---|---|---|---|---|
| FPGA→主机，长传输 | 不支持（每条命令最多 4 KB） | — | **896 MB/s**（每条命令 256 KB） | 未改动 |
| 主机→FPGA，长传输 | 不支持（每条命令最多 4 KB） | — | — | **861 MB/s**（每条 320 KB，未完成上限 ≥ 8） |
| FPGA→主机，每条 4 KB | 约 160 MB/s | 571 MB/s | 514–571 MB/s | 514 MB/s |
| 主机→FPGA，每条 4 KB | 约 160 MB/s | 446 MB/s | 485 MB/s | 487 MB/s |
| 数据校验 | OK | OK（随机数据） | OK（每档长度逐字校验） | FPGA 在线逐 DW 比对测试图，主机再回读 FPGA RAM 末尾 8 KB 比对，全部 OK |

Gen2 x2 的理论带宽是 1000 MB/s（单方向）。FPGA→主机 896 MB/s 约为理论值的 90%，已接近 256 B 包时的协议开销上限。

第 4 步（P2，比特流 ddr2，§4.2）：长读数据直接写进板载 DDR3，并加了 16 深的门铃队列。Gen2 x2 下 16 个 128 KB 门铃连续排队约 **795 MB/s**，960×540 整帧分 4 条写入 DDR3 后回读逐 DW 校验无错；随机门铃浸泡 20000 轮、89467 个门铃、5.87 GB，0 失败，AER/RAS 全 0。

主机→FPGA 封顶 861 MB/s。推断原因（未直接验证）：RK3568 根口把读完成包按 128 B 一个返回。每个完成包另有约 20 B 开销，128/(128+20)×1000 ≈ 865 MB/s，与实测吻合。如果完成包是 256 B，应能到 900 左右，与 FPGA→主机方向的 896 MB/s 一致。

## 2. 参考资料检索（GitHub 等）

没有找到可以直接用的开源高速 DMA。有参考价值的资料：

- [walker99999/pango_pcie_dma_alloc](https://github.com/walker99999/pango_pcie_dma_alloc)：自称官方设计，与本工程同源。
- [927242768-dotcom/PCB-Component-Inspector](https://github.com/927242768-dotcom/PCB-Component-Inspector)：RK3568 + PG2L100H，只用 BAR0 内存映射，没有 DMA。
- [CSDN《紫光PCIe效率提升指南》](https://blog.csdn.net/m0_61846207/article/details/153267389)：思路是让 FPGA 主动发写包、改用 MSI 中断；x2 下 1080p RGB888 约 130 fps（约 800 MB/s）。没有源码。
- [创龙 RK3568J + FPGA PCIe 实测（博客园）](https://www.cnblogs.com/Tronlong818/p/18222087)：RK3568J + PG2L100H 平台，写约 791 MB/s、读约 595 MB/s。没有源码。
- [CSDN：Titan2 PG2T390H 链式 DMA](https://blog.csdn.net/whlzywy/article/details/130208838)：Gen3 x8，读约 86%、写约 79% 理论值。

## 3. 原设计的瓶颈（源码确认）

1. 两个方向的数据都经过一级 16 位 RAM 逐拍搬运（`src/interface_conversion/rt_mwr_16bit_ram_ctrl.v`、`rt_cpld_16bit_ram_ctrl.v`）。4 KB 要 2048 个时钟，而且必须搬完才开始发送或报完成。Gen2 下内部上限 250 MB/s。
2. 每条命令最多 4 KB（`rt0101_dma_request_ctrl.v:495`，长度只有 10 位 DW），每条都要 CPU 写寄存器、轮询完成标志。
3. FPGA 只声明支持 128 B 包（`ip/PCIe_IP/PCIe_IP.v:180`）。

## 4. 改动

FPGA 工程 `D:\pango_build\4_15_PCIE_DMA`：

| 步骤 | 文件 | 内容 | 备份 |
|---|---|---|---|
| 1 | `src/interface_conversion/rt_gs_dma_interface_conversion.v` | 新增参数 `FAST_PATH`：为 1 时用一块 128 位进/出的 RAM（`ram_128in_128out`，64 KB）直接作 DMA 缓冲区；CplD 收完即报完成，MWr 命令到达 2 拍后开始组包。FAST_PATH=0 时保留原通路 | `backup_20261018_prefast\` |
| 1 | `src/pango_pcie_dma_top.v` | 实例参数 `.FAST_PATH(1)` | 同上 |
| 2 | `src/dma_src/rx/rt0101_dma_request_ctrl.v` | 新寄存器 BAR1 **0x250**：MWr 扩展长度（单位 DW，20 位，最大 4 MB）；为 0 时保持原来的 4 KB 行为 | `backup_20261018_preext\` |
| 2 | `rt01_dma_rx.v`、`rt_dma.v`、`rt02_dma_tx.v` | 0x250 逐级传端口 | 同上 |
| 2 | `src/dma_src/tx/rt0201_dma_mwr_ctrl.v` | `mwr_length` 11 → 20 位；0x250 非 0 时用它作总长度 | 同上 |
| 2 | `ip/PCIe_IP/PCIe_IP.v:180` | `MAX_PAYLOAD_SIZE` 3'd0 → 3'd1（声明支持 256 B） | 同上 |

时序：pclk_div2 WNS 0.733 ns，无违例。比特流：`D:\pango_work\pango_pcie_dma_x2_fast2.sbit`（`prog_x2_fast2.tcl`）。它包含 lane 1 去加重修复、ltssm_logger 和调试灯。

### 4.1 第 3 步：主机→FPGA 长读（P2 的 DMA-R 引擎，比特流 mrd1）

原设计的问题（源码确认）：
- `rt0202` 把一条命令切成若干 MRd 背靠背发出，没有任何节流；tag 每发一个加 1，命令结束清零。
- CplD 落地地址是 `{tag, 片内偏移}`（`rt0102:92-96`），超过 4 KB 后 tag 会在旧请求的完成包回来之前被复用，数据互相覆盖。
- IP 的接收数据 RAM（`ip/PCIe_IP/rtl/external_ram/rcv_data_ram`）只有 1024×72 位，约 8 KB 数据，完成包不受流控。所以在途读请求的总量必须有上限。

新设计：
- **tag 循环使用 0–31**：第 k 个请求用 tag `k mod 32`。只有当这个 tag 的最后一个完成包收完，它才能再次使用；同时限制在途请求数（默认 16 个 × 256 B = 4 KB，可设 1–32）。
- **最后一个完成包的判据**：按 PCIe 规范，Byte Count 等于"本包及之后剩余的字节数"，满足 `ByteCount + LowerAddr[1:0] ≤ Length×4` 的就是最后一包。在数据结束（`cpld_en_flag` 下降沿）时释放 tag（新模块 `rt0105_cpld_tag_free`）。
- **落地地址**：发请求时记下"tag → 本命令内第几块"（32 项表），完成包按 `块号 × 块长 + 片内偏移` 落地，得到本命令内的全局字节偏移。旧的 ≤ 4 KB 命令里块号就是 tag，所以行为不变。FPGA RAM 按低 8 KB 循环写，这个全局偏移以后接 DDR3 时直接作写地址。
- **完成标志**：0x130 改为由请求跟踪器产生（全部请求已发出、全部 tag 已释放、再等 16 拍），不再按拍数计数。
- **在线校验器 `rt_mrd_checker`**：对每个写入的 DW 与测试图 `seed ^ k ^ (k<<16)` 比对（k 为本命令内 DW 序号），同时统计错误数、写入拍数、32 位累加和，并记录第一个错的位置、实际值和期望值。累加和可以用来校验任意图像数据。
- **中止寄存器**：请求卡死时（例如丢了完成包）可以清空跟踪状态，不必重新烧写。

| 文件 | 内容 |
|---|---|
| `src/dma_src/tx/rt0202_dma_mrd_ctrl.v` | 请求跟踪器：tag 占用位图、在途计数和上限、`issue_pending` 节流、完成判定、中止、统计；长度 11 → 20 位；`o_mrd_tag = chunk_cnt[4:0]` |
| `src/dma_src/rx/rt0102_dma_cpld_tag_ctrl.v` | 32 项"tag → 块号"表；落地地址改用块号；多包偏移 RAM 改为组合读出（`OUT_REG 0`），保证完成包首拍读到当前 tag 的偏移 |
| `src/dma_src/rx/rt01_dma_rx.v` | 新模块 `rt0105_cpld_tag_free`（在同一文件末尾）；端口传递 |
| `src/dma_src/rx/rt0101_dma_request_ctrl.v` | BAR1 新写寄存器 0x150 / 0x154 / 0x158 / 0x15C |
| `src/dma_src/tx/rt0206_data_mux.v` | BAR1 新读寄存器 0x160 / 0x170 / 0x180（各 16 字节） |
| `src/dma_src/tx/rt02_dma_tx.v`、`src/dma_src/rt_dma.v` | 端口传递；`rt_mrd_checker` 定义在 `rt_dma.v` 末尾（不必改 .pds 工程文件） |

备份：`backup_20261018_premrd\`。仿真：`sim_mrd/`（Questa FSE，`bash run_sim.sh`）。仿真里的主机模型包括随机延迟、乱序返回、把一个请求拆成多个完成包、TX 随机反压，还做了注错和中止测试，T1–T9 全部通过。时序：pclk_div2 WNS 0.643 ns，WHS 0.061 ns，全部约束满足。比特流：`D:\pango_work\pango_pcie_dma_x2_mrd1.sbit`（`prog_x2_mrd1.tcl`，时序报告 `timing_x2_mrd1.rtr`），包含 fast2 的全部内容。

BAR1 新寄存器（注意：与中枢方案草案里 **BAR0** 的 0x150/0x154 不是同一组）：

| 偏移 | 读/写 | 内容 |
|---|---|---|
| 0x150 | 写 | 长读长度（DW，20 位）；0 = 旧模式，用 0x120 |
| 0x154 | 写 | 在途 MRd 上限，0 → 16，>32 按 32 |
| 0x158 | 写 | 校验器种子 |
| 0x15C | 写 | 写任意值 = 中止，清空跟踪状态（只在"等完成包"或"等 tag"时生效） |
| 0x160 / 0x164 / 0x168 / 0x16C | 读 | 错误 DW 数 / 写入拍数（16 B 一拍）/ 32 位累加和 / 第一个错 DW 的序号（无错 0xFFFFFFFF） |
| 0x170 / 0x174 / 0x178 / 0x17C | 读 | 第一个错 DW 的实际值 / 期望值 / 本次发出的 MRd 数 / 状态：[31] 命令进行中、[30] 正在发请求、[29] 等 tag、[21:16] 生效上限、[13:8] 在途峰值、[5:0] 当前在途数 |
| 0x180 / 0x184 / 0x188 / 0x18C | 读 | 本次耗时（125 MHz 周期）/ 释放的 tag 数 / 固定值 0x4D524432（"MRD2"，用来确认比特流版本）/ tag 占用位图 |

这些统计在每条命令开始时清零，读取不会清零。

主机工具 `tools/pcie_bench/`：
- `pcie_bench.c`：
  - 完成标志是读即清零的，快速通路下第一次读就可能已完成，所以改成直接轮询到置位；
  - 回环校验改为每轮随机数据；
  - 新增 `x` 模式（扩展长度 MWr 测试，逐档长度校验）；bufB 映射扩大到 0x48000。
- `soak_ext.sh`：交替跑 `x` 模式和常规测试。

### 4.2 第 4 步：长读落 DDR3 + 门铃队列 + DDR3 回读（P2，比特流 ddr2）

数据通路：
- **写 DDR3**：长读的完成包写口（本命令内全局偏移，16 B 一拍）加上命令的 DDR 目的地址，在新模块 `src/ddr/rt_ddr_hub.v` 里拼成 256 位拍，按 256 B 块切成不超过 8 拍的 AXI 写突发（目的地址只要求 16 B 对齐，不足一拍的部分用字节使能），经异步 FIFO（写 FIFO 512×288 位、命令 FIFO 512×32 位）送到 DDR3 时钟域的 AXI 写主机。FPGA 片内 RAM 照常同时写入，所以在线校验器（0x160 起）继续有效。
- **反压**：写 FIFO 积压 ≥ 240 拍时 `o_issue_hold` 让 `rt0202` 暂停发新的 MRd（已发出的请求最多再回 256 拍，FIFO 不会溢出）。
- **完成判定**：命令的全部 MRd 完成后，往命令 FIFO 塞一个"提交"标记；AXI 写主机处理到它时，前面所有突发都已交给 DDR3 控制器，再等 64 拍后回报。DDR 使能时，主机命令的 0x130 在这之后才置位；门铃命令不置 0x130，看 0x1C8 完成计数。
- **门铃队列**：16 项（主机地址、长度、DDR 目的地址、帧号），满时丢弃并计数。队列非空且没有命令在提交时，向 `rt0202` 申请；主机命令优先，提交期间（`o_start_block`）不开始新命令。
- **DDR3 回读**：DDR3 → 片内 RAM（读突发 16 拍，按读 FIFO 余量发请求；片内 RAM 写口长读优先），再用已有的长写（0x250）送回主机。回读只用于校验。
- **DDR3 控制器**：官方 DDR3 IP（`ip/ddr3_test/`，Pango DDR3 Interface 1.10，用 PDS 2022.2 生成，2025.2 直接可用），1000 Mbps、32 位、1 GB，用户时钟 125 MHz，参考时钟 125 MHz（N3/N2）。约束从双目例程合并进 `pnr/pango_pcie_top.fdc`（参考时钟改名 `ddr_ref_clk`，避免和 PCIe 的 `ref_clk` 冲突）。

| 文件 | 内容 |
|---|---|
| `src/ddr/rt_ddr_hub.v`（新） | 寄存器旁路、门铃队列、写打包、提交时序、AXI 写/读主机、回读搬运、状态字；异步 FIFO `rt_async_fifo`、同步器 `rt_sync2` |
| `src/pango_pcie_dma_top.v` | DDR3 端口、参考时钟缓冲、上电复位、`u_ddr3_test_h`、`u_rt_ddr_hub` |
| `rt0101` / `rt01_dma_rx` / `rt_dma` / `rt_pcie_dma` | BAR1 写旁路（地址 + 数据）逐级引出；门铃握手、完成、状态逐级传递 |
| `rt0202_dma_mrd_ctrl.v` | 门铃启动 `start_db`（无主机请求、无命令、未阻塞时）；主机请求的应答受 `i_start_block` 门控；`fire` 受 `i_issue_hold` 门控；`o_db_ack` |
| `rt02_dma_tx.v` / `rt0206_data_mux.v` | 0x130 改由 hub 的 `o_final_done_host` 驱动；新读寄存器 0x1C0 / 0x1D0 / 0x1E0 |
| `rt_gs_dma_interface_conversion.v` | 快速通路 RAM 写口加回读复制口（长读写入优先） |
| `pnr/pg2l_pcie_dma.pds`、`pnr/pango_pcie_top.fdc` | 加入 74 个 IP 文件和 hub；DDR3 管脚、时钟、位置约束 |

备份：`backup_20261018_preddr\`（以及 `pnr/*.bak_ddr`）。仿真：`sim_ddr/`（Questa，`bash run_sim.sh`），DDR3 模型带随机握手延迟和写空隙，MRd 模型带拆包、乱序和反压，H1–H9 全部通过（主机命令、回读、门铃、DDR 关闭、队列溢出、非 32 B 对齐、随机压力、写主机吞吐、非对齐 + 慢 DDR 反压）。旧的 `sim_mrd` T1–T9 回归通过。时序：pclk_div2 WNS 0.660 ns，ddrphy_sysclk 1.773 ns，全部约束满足。比特流：`D:\pango_work\pango_pcie_dma_x2_ddr2.sbit`（`prog_x2_ddr2.tcl`，`timing_x2_ddr2.rtr`），包含 mrd1 的全部内容。

开发中修掉的问题（都是 `rt_ddr_hub.v` 内）：
- 审查发现：门铃队列 4 位指针回绕后占用数算错；命令字段读错一位；三个 FIFO 的读数据都晚一拍才有效，状态机却在下一拍就取；写主机取数没有流水。
- 综合日志发现：提交标记写成 `{1'b1, 28'h0}`，只有 29 位，标志位实际落在 bit 28，综合器把整个提交状态当常量删掉了（所有 DDR 命令都会卡死）。
- **上板发现（ddr1 比特流）**：Gen1 下全部通过，但 Gen2 下整帧图像从第 1 条中间开始全错。原因：目的地址不是 256 B 对齐时每 256 B 拆成两个 4 拍突发，写 FIFO 积压到 300 多拍时，64 项的命令 FIFO 先满了，而写命令 FIFO 时没查满标志，命令被丢掉，后面的数据全部配错地址。修正：命令 FIFO 加深到 512 项（与写 FIFO 一样深，1 拍一个突发也不会先满），并加了溢出粘滞位 0x1D0 bit 7。

BAR1 新寄存器（hub）：

| 偏移 | 读/写 | 内容 |
|---|---|---|
| 0x190 / 0x194 / 0x198 | 写 | 门铃：主机物理地址 / 长度（字节，16 的倍数）/ DDR 目的字节地址（16 B 对齐） |
| 0x19C | 写 | 帧号，写入即入队（满时丢弃，溢出计数加 1） |
| 0x1A0 | 写 | bit0 = DDR 使能（长读数据写 DDR3）；bit1 = 1 清统计 |
| 0x1A4 | 写 | 主机命令（0x140 触发的长读）的 DDR 目的字节地址 |
| 0x1A8 / 0x1AC / 0x1B0 / 0x1B4 | 写 | 回读：DDR 源地址（512 B 对齐）/ 长度（512 的倍数，≤ 32 KB）/ 片内 RAM 目的字地址（用 2048）/ 写任意值启动 |
| 0x1C0 | 读 | [31:16] 门铃溢出数、[13:12] 提交状态、[11:10] 门铃状态、[8] 队列满、[4:0] 队列占用 |
| 0x1C4 / 0x1C8 / 0x1CC | 读 | 入队计数 / 门铃完成计数 / 最近完成的帧号 |
| 0x1D0 | 读 | [31:16] 写 FIFO 峰值、[7] 命令 FIFO 溢出、[6] 回读中、[5] 读 FIFO 溢出、[4] 写 FIFO 溢出、[3] 提交中、[2] 反压、[1] DDR 使能生效、[0] DDR 初始化完成 |
| 0x1D4 / 0x1D8 / 0x1DC | 读 | 进入写 FIFO 的拍数（256 位）/ AXI 写突发数 / 回读完成计数 |
| 0x1E0 / 0x1E4 / 0x1E8 / 0x1EC | 读 | 最近一个门铃耗时（125 MHz 周期）/ AXI 写拍数 / 固定值 0x44445231（"DDR1"）/ 回读拍数 |

0x1C4、0x1D8、0x1E4 不随 0x1A0 bit1 清零。0x1D8、0x1E4 来自 DDR 时钟域，多位直接同步，读到的瞬时值偶尔可能不准，只作参考。

## 5. 使用方法

**FPGA→主机长传输：**
```
wr(0x200, 主机物理地址低32位); wr(0x204, 高32位); wr(0x210, 0);
wr(0x220, 1023); wr(0x250, 总字节数/4); wr(0x240, 0)   // 0x240 触发
轮询 0x230 直到非 0（读即清零）
用完 wr(0x250, 0) 恢复 4 KB 行为
```
限制：
- 主机地址要按包长对齐（至少 256 B），保证包不跨 4 KB 边界；
- FPGA RAM 读地址取主机地址的 [12:4]，所以长传输的数据是 FPGA RAM 前 8 KB 循环重复。测吞吐够用；以后接视频源时，要把数据源换成视频 FIFO。

**主机→FPGA 长传输（mrd1 比特流）：**
```
wr(0x158, 种子); wr(0x154, 在途上限，建议 16); wr(0x150, 总字节数/4);
wr(0x100, 主机物理地址低32位); wr(0x104, 0); wr(0x110, 0); wr(0x120, 1023); wr(0x140, 0)   // 0x140 触发
轮询 0x130 直到 == 1（读即清零）；再读 0x160–0x18C 查看校验结果和耗时
用完 wr(0x150, 0) 恢复旧模式
```
限制：
- 主机地址必须按请求长度对齐（MPS 256 时为 256 B），否则请求可能跨 4 KB 边界；
- 长度必须是 16 B 的倍数，校验器按 16 B 一拍计数；
- RK 端目前只有 ramoops 那 320 KB 连续物理内存（0x1b0000–0x1fffff），所以一帧 960×540 RGB565（1 MB）分 4 条传。正式使用要在设备树里加约 16 MB 预留内存（改设备树前先征得同意）。

测试命令：`pcie_bench f0204000 <每点次数> L` 跑长度 × 上限矩阵、测试图像和旧模式回归；`pcie_bench f0204000 <轮数> S` 跑随机长度和随机上限的浸泡测试。

**主机→DDR3（ddr2 比特流）：**
```
先确认 0x1D0 bit0 = 1（DDR3 初始化完成），0x1E8 = 0x44445231
wr(0x154, 16); wr(0x1A0, 1)                      // 在途上限；DDR 使能
门铃：wr(0x190, 主机地址); wr(0x194, 字节数); wr(0x198, DDR 目的地址); wr(0x19C, 帧号)   // 入队
轮询 0x1C8（完成计数）达到目标；0x1CC 为最近完成的帧号
主机命令：wr(0x1A4, DDR 目的地址)，再按上面"主机→FPGA 长传输"发；0x130 置位时数据已写进 DDR3
```
限制：
- 主机地址按 256 B 对齐（同长读）；长度为 16 B 的倍数；DDR 目的地址 16 B 对齐即可。
- 长读期间别用 0x210 搬片内 RAM：回读用的是片内 RAM 2048–4095 字，长读落在 0–511 字。
- 用完 DDR 前 `wr(0x1A0, 0)`，再用旧的 4 KB 读命令前 `wr(0x150, 0)`（否则旧命令会按 0x150 的长度读）。

测试命令：`pcie_bench f0204000 <队列轮数> D`（主机命令落 DDR、16 个门铃排队、整帧图像、关闭 DDR 后回归）；`pcie_bench f0204000 <轮数> E`（每轮 1–8 个随机门铃：随机源、长度 256 B–128 KB、DDR 目的地址在 0–48 MB 内跨轮递增，含 +16 B 偏移，逐个回读校验）。回读打印的 MB/s 含 CPU 在非缓存内存上逐 DW 比对的时间，不代表硬件速度。

**256 B 包（每次 RK 重启后要重新设）：** 在没有传输时，把根口和 EP 的 DevCtl（配置空间 0x78，PCIe 能力在 0x70）的 MPS 设为 256：
```
printf '\060' | dd of=/sys/bus/pci/devices/0002:20:00.0/config bs=1 seek=120 count=1 conv=notrunc
printf '\060' | dd of=/sys/bus/pci/devices/0002:21:00.0/config bs=1 seek=120 count=1 conv=notrunc
```
也可以在内核命令行加 `pci=pcie_bus_perf` 让内核自动协商（未验证）。

## 6. 测试记录

| 时间 | 比特流 | 测试 | 结果 | 日志（`log/rk_env/`） |
|---|---|---|---|---|
| 00:35 | fast1 | 常规测试 | 回环校验 OK；4 KB：主机→FPGA 444、FPGA→主机 570 MB/s | `pcie_fast1_bench_20261018.log` |
| 00:43 | fast1 | 5 分钟压测 | 303/303，AER/RAS DES 全 0 | `pcie_fast1_soak_20261018.log` |
| 00:48 | fast1 | 2 分钟压测（随机校验数据） | 121/121 | `pcie_fast1_soak_rand_20261018.log` |
| 01:05 | fast2，MPS 128 | x 模式 | 8 KB 659 → 256 KB 834 MB/s，全部校验 OK | `pcie_fast2_mps128_20261018.log` |
| 01:07 | fast2，MPS 256 | x 模式 | 8 KB 669 → 256 KB **896 MB/s**，全部校验 OK；4 KB：主机→FPGA 485 MB/s | `pcie_fast2_mps256_20261018.log` |
| 01:09–01:14 | fast2，MPS 256 | 5 分钟交替压测（`soak_ext.sh 300`） | **485 轮 0 失败**，AER、RAS DES 全 0，256 KB 档稳定 896 MB/s | `pcie_fast2_soak_ext_20261018.log` |
| 03:06 | mrd1（仿真） | Questa T1–T9：旧模式、256 KB 反压+乱序+拆包、上限 1/16/32、注错、中止恢复 | 全部通过 | `pcie_mrd1_sim_20261018.log` |
| 03:16 | mrd1，MPS 256 | 旧模式回归（默认测试 300 次） | 回环 OK；4 KB：主机→FPGA 487、FPGA→主机 514 MB/s，与 fast2 一致 | — |
| 03:18 | mrd1，MPS 256 | `L` 模式，每点 3 次：6 种长度 × 8 种上限、测试图像、回归 | **全部通过**。上限 1：141 MB/s（每个读请求往返约 1.8 µs）；上限 4：558；上限 ≥ 8：861 MB/s 封顶；设 24/32 时在途峰值只到约 21，没有收益。960×540 RGB565 一帧（分 4 条）FPGA 传输 1.2 ms | `pcie_mrd1_L3_20261018.log` |
| 03:20 起 | mrd1，MPS 256 | `S` 浸泡 500000 轮：长度 256 B–320 KB 随机、上限 1–16 随机，每 100 轮插一次旧模式回环 | **500000 轮 0 失败，共 82 GB**；5000 次回环全部 OK；AER、RAS DES 全 0；链路仍为 Gen2 x2 | `pcie_mrd1_soak_20261018.log` |
| 05:13 | ddr1 | 烧写后 60 s 空闲误码 | 开始 Gen2 x2，期间 4 次 L0→Recovery、EP CE=0x1（接收错），结束时**降为 Gen1**；RK 侧各 lane 误码 0。重训练一次（`setlink.sh 2 0`）后 Gen2 x2 30 s 全 0。ddr2 烧写后没有复现，暂按偶发处理 | `pcie_ddr1_variant_20261018.log`、`pcie_ddr1_gen2retrain_20261018.log` |
| 05:16 | ddr1，Gen1 x2 | `D` 模式 | 全部通过；门铃 16×128 KB 约 427 MB/s（链路上限）。第一次跑回归失败是测试程序没清 0x150，已修 | `pcie_ddr1_D_20261018.log`、`pcie_ddr1_D3_20261018.log` |
| 05:18 | ddr1，Gen2 x2 | `D` 模式 | 门铃 795 MB/s 通过；**整帧图像失败**（命令 FIFO 溢出，见 §4.2） | `pcie_ddr1_D3_gen2_20261018.log` |
| 05:29 | ddr2，Gen2 x2 | 烧写后 60 s 空闲误码 + `D` 模式（3 轮） | 链路全 0；**全部通过**：门铃 794–796 MB/s，整帧图像通过，回归 OK；写 FIFO 峰值 332 拍，三个溢出位都是 0；进 FIFO 的拍数 = AXI 写拍数 = 233104 | `pcie_ddr2_variant_20261018.log`、`pcie_ddr2_D3_gen2_20261018.log` |
| 05:30–05:34 | ddr2，Gen2 x2 | `E` 浸泡 20000 轮 | **0 失败**，89467 个门铃、5.87 GB；门铃平均约 600 MB/s（随机长度，平均约 64 KB，含每个门铃的固定开销）；写 FIFO 峰值 349；进 FIFO 拍数 = AXI 写拍数 = 195,167,817；AER、RAS DES 全 0，仍为 Gen2 x2 | `pcie_ddr2_soakE_20261018.log` |
| 05:33 | ddr2（仿真） | Questa H1–H9 | 全部通过；写主机吞吐（DDR 无空隙）每拍 3.44 个 DDR 时钟，约 1.16 GB/s | `pcie_ddr2_sim_20261018.log` |

## 7. 还没做的

1. ~~主机→FPGA 长传输~~：10-18 已完成（§4.1，比特流 mrd1）。后续问题：
   - ~~完成包写口接 DDR3、加门铃队列~~：10-18 已完成（§4.2，比特流 ddr2）。剩下：门铃完成用 MSI 通知 RK（现在靠轮询 0x1C8）；DDR3 的读出口要给显示/拼图用，届时 hub 要改成多口仲裁；门铃时间戳字段还没加。
   - 中止后，如果丢失的完成包又迟到，可能写进下一条命令的数据里。正常使用不会触发，以后可以加"命令代号"过滤。
   - 想验证"RK 按 128 B 返回完成包"的推断，可以在 FPGA 里加一个完成包计数寄存器。
2. **MPS 256 持久化**：现在每次 RK 重启都要手动设。可以改设备树或内核命令行。
3. **接视频源**：把 MWr 的数据源从 RAM 换成摄像头帧 FIFO，按帧写入主机环形缓冲区；帧完成用 MSI 中断（`ven_msi_req` 目前固定为 0）。这需要 RK 侧有内核驱动，依赖交叉编译环境。
4. 4 KB 小命令的性能受主机轮询限制（每次读寄存器 1.34 µs），要改善只能靠更长的命令或中断。
