Zdy-1110/FPGA-676/PCIe_Gen1链路稳定性测试_20261017.md

# PCIe Gen1 链路稳定性测试（2026-10-17）

> 目的：确认 Gen1 x2 能否作为视频下行通路的基础（见 `选题3_RK端容器帧合成与USB摄像头方案.md` 的方案 B+）。
> 环境：卡插 P29（PCIE_A，x2），用户 17:30 断电后重新插卡、压紧核心板并加支撑。bitstream 为官方 4_15 x2 原版 `D:\pango_work\pango_pcie_dma_x2.sbit`（10-05 编译）。
> 原始日志：`log/rk_env/pcie_gen1_idle_20261017.log`、`pcie_gen1_soak_20261017.log`、`pcie_reboot_loop_20261017.log`。

## 1. 结论

| 项目 | 结果 |
|---|---|
| 建链后的链路质量（Gen1 x2） | **合格**：空闲 60 s 与带流量 30 min 均为 0 误码 |
| 建链成功率 | **不合格**：今天 14 次开机只成功 1 次 |
| 第一个修复假设（PERST# 漏检） | **未被证实**；修复版也建不了链，原版在同样流程下也失败 |
| 当前判断 | 训练阶段 FPGA 收发器没有工作起来（两条 lane、两个方向都没有信号），根因未定 |

## 2. 测试记录

| 时间 | 操作 | 结果 |
|---|---|---|
| 17:33 | 断电重启（FPGA 未配置） | P29 LTSSM 0x0，Link Fail（正常） |
| 17:34 | JTAG 烧原版 x2 → 软重启 RK | **建链成功，Gen2 x2**；Gen2 下根端口已记一次 Receiver Error |
| 17:36 | `setlink.sh 1 0` 降到 Gen1 | 2.5 GT/s x2 |
| 17:36 | 空闲 60 s（`gen2check.sh 60`） | 两条 lane 各计数、DLL、L0→Recovery、AER **全为 0** |
| 17:37–18:07 | 30 min 压力测试（`soak.sh 1800 2000`，循环 pcie_bench：4 KB 回环校验 + 双向 DMA 长度扫描） | **563/563 轮通过**，30 个每分钟采样的所有计数与 AER 均为 0；吞吐 RK→FPGA 97.0 MB/s、FPGA→RK 98.9 MB/s |
| 18:08–18:16 | 10 次 RK 软重启（FPGA 保持配置，`reboot_loop.sh 10`） | **0/10**，每次都停在 LTSSM 0x2（Polling.Active） |
| 18:47 | 烧复位监管修复版（覆盖已配置的 FPGA）→ 重启 RK | 失败（0x2）；LED4 灭（监管模块已放开复位）、LED3 快闪、LED0 慢闪、LED1/2 灭 |
| 19:25 | 断电重启 → 修复版作为首次配置 → 重启 RK | 失败（0x2） |
| 19:31 | 原版覆盖已配置的 FPGA → 重启 RK | 失败（0x2） |
| 19:34 | 断电重启 → 原版作为首次配置 → 重启 RK（与 17:34 完全相同的流程） | **失败**（0x2） |
| 19:36 | 用户再次按压核心板（不断电）→ 重启 RK | 失败（0x2） |

失败时 RK 一侧的 LTSSM 依次为 0x3 → 0x8 → 0x2，然后一直停在 0x2，2.6 s 后报 Link Fail。

## 3. 排除了什么

- **第一个假设**：RK 重启时会停掉参考时钟，而 FPGA 的 PERST# 去抖和 HSST 复位序列都运行在这个参考时钟上，所以 FPGA 漏掉了复位。
  - 源码确认：`INNER_RST_EN="FALSE"`、`i_free_clk=1'b0`（`ipm2l_pcie_hsstlp_x2_top.v:245, 1420`）；PLL 锁定看门狗也运行在 ref_clk 上（`hsstl_rst4mcrsw_tx_v1_0.v:66-72`）。
  - 但原有的 `hsst_rst_cross_sync_v1_0` 对 PERST# 是**异步拉低**的，没有时钟也能复位，所以"漏检"本来就不太可能。
  - 加了 27 MHz 自由时钟（D18）复位监管模块的修复版也建不了链，而原版在同一流程下同样失败。**结论：假设不成立；17:34 的成功与"首次配置"无关，更可能与刚重新插卡有关。**
- **不是 Gen2 的问题**：失败发生在 Polling 阶段，这时链路还在 2.5 GT/s，尚未切换速率。

## 4. 现在的推断【推断，待验证】

- 失败时两条 lane、两个方向都没有有效信号，但双方都能检测到对端的接收端。10-15 的逐 lane 调试灯显示：FPGA 两条 lane 都没有退出电气空闲，也没有符号锁定；今天 RK 一侧也一直收不到 FPGA 的 TS1。
- 这更像是 **FPGA 收发器在训练时没有工作起来**（例如 HSST PLL 没锁定、lane 复位没完成），而不是某一对差分线接触不良。
- 一旦训练成功，链路就非常稳定（30 min 0 误码）。这说明问题出在"起振、锁定"阶段，而不是信号质量本身。
- FPGA 的参考时钟路径要经过底板与核心板之间的板对板连接器 J1（金手指 A13/A14 → C236/C237 → 底板 J1.1/3 → 核心板 J1.2/4 → R249 → F11/E11）。参考时钟幅度不足，正好会造成"难以锁定、锁上后稳定"的现象。但按压核心板没有恢复，所以证据还不够。

## 5. 当前文件状态

- `D:\pango_build\4_15_PCIE_DMA\`：6 个文件已恢复为原始版本，再加上复位监管修改（`src/pango_pcie_dma_top.v` 新增 `pcie_rst_supervisor`，`pnr/pango_pcie_top.fdc` 新增 free_clk D18 和 LED4 A17）。10-15 的调试版保存在 `backup_20261017_debug/`，原始版在 `backup_20261015_orig/`。
- 修复版 bitstream：`D:\pango_work\pango_pcie_dma_x2_rstfix.sbit`（编译通过，时序满足，最差 setup +0.778 ns、hold +0.044 ns）。没有证明它有害，也没有证明它有用。
- 新工具：`tools/pcie_bench/soak.sh`（压力测试）、`tools/pcie_bench/reboot_loop.sh`（软重启统计）。

## 5.1 调试灯版本与 x1 对照（19:40–19:55）

调试版 `D:\pango_work\pango_pcie_dma_x2_dbgled.sbit`：基于原始源码，只新增调试输出，编译时序满足（setup +0.938 ns、hold +0.050 ns）。粘滞灯由 PERST# 清零，记录本次训练窗口内到达过的状态。

| LED | 含义 | 19:47 训练失败后读数 |
|---|---|---|
| LED0 | HSST PLL 曾锁定 | **亮** |
| LED1 | TX lane 复位曾完成 | **亮** |
| LED2 | 链路建立（实时） | 灭 |
| LED3 | 原 ref_led | 亮或闪 |
| LED4 / LED5 | lane0 / lane1 CDR 曾锁定 | **亮 / 亮** |
| LED6 | LTSSM 曾到 POLL_CONFIG（0x04） | **亮** |
| LED7 | LTSSM 曾到 Configuration（0x07–0x0C） | **亮** |

- **结论：失败时物理层是好的。** 时钟、PLL、两条 lane、两个方向都正常，FPGA 的 LTSSM 能进入 Configuration，但到不了 L0。RK 侧早期记录的 0x8（CFG_LINKWD_ACEPT）也说明双方都进了 Configuration。
- **由此排除：** 参考时钟 / J1 接触（PLL 和 CDR 都锁定了）、FPGA 复位问题（第 3 节）。
- **x1 对照：** 官方 x1 版（`pango_pcie_dma_x1_backup.sbit`）连续 6 次 RK 软重启 **0/6**（`log/rk_env/pcie_x1_reboot_loop_20261017.log`），所以也不是双 lane 绑定或去偏斜的问题。

**新的规律【推断】：** 今天唯一的成功出现在 17:30 重新插卡之后，当时板子断电了好几分钟、处于冷态。建链后链路在升温过程中 30 分钟 0 误码，而之后的所有尝试都失败了；那几次断电只有约 5 秒，板子一直是热的。10-15 也是"重插卡后就能成功"，而重插卡意味着较长时间断电。所以训练能否成功可能与**温度或断电时长**有关。

## 5.2 冷启动对照（20:15）

两块板断电 10 分钟以上，上电后 RK SoC 温度 38.3 °C。烧调试版 → RK 软重启 → **Link Fail**（SoC 38.9 °C，`log/rk_env/pcie_coldstart_20261017.log`）。**温度或断电时长的假设不成立。**

至此，今天唯一一次成功（17:34）与其他所有失败相比，唯一的区别是**刚刚物理拔插过板卡**。

## 5.3 拔插复现测试（20:25）

第 1 次：断电 → 拔出再插回 P29、压紧核心板 → 上电 → 烧调试版 → RK 重启两次：**0/2**（`log/rk_env/pcie_reseat1_20261017.log`）。"拔插后能成功一次"**没有复现**。今天累计：约 23 次训练尝试，只成功 1 次（17:34），看起来是低概率的随机成功，而不是由某个可控条件触发的。

## 5.4 UART LTSSM 轨迹（21:12）

记录器版本 `D:\pango_work\pango_pcie_dma_x2_ltssmlog.sbit`：用 27 MHz 板载时钟，经 CP2102（PC 上为 COM13，921600 baud）输出每次 LTSSM 跳变和 PERST/PLL/TX/CDR/LSM/LINK 的变化。PC 端解码脚本为 `tools/pcie_bench/uart_ltssm.py`。一次失败训练的完整记录：`log/rk_env/ltssm_trace1_20261017.log`（1292 条，无丢失）。

- PERST# 释放后约 1.2 ms PLL 锁定，再过 26 µs TX 复位完成；两条 lane 的 CDR 和字对齐（LSM）在 Polling.Configuration 和 Configuration 期间**一直保持锁定**。
- 2.8 s 内约 90 轮，**每一轮都一样**：

| FPGA 状态 | 停留时间 | 说明 |
|---|---|---|
| POLL_ACTIVE | 中位 2.3 ms | FPGA 很快收齐 RK 的 TS1，FPGA 接收方向正常 |
| POLL_CONFIG | 12.5 / 25 / 50 ms（约 12.5 ms 的整数倍） | 在等 RK 发 TS2；RK 像是靠自身超时才前进 |
| CFG_LINKWD_START → CFG_LINKWD_ACEPT | Accept **每次正好 3.146 ms** | 超时，回到 Detect |
| CFG_LANENUM_WAIT 及以后 | **一次也没到** | — |

**推断：** FPGA 能正常接收 RK，而 RK 迟迟收不齐 FPGA 的训练序列。问题方向更像是 **FPGA TX → RK RX**，与 10-14/15 Gen2 下 lane 1 误码的方向相同。

## 5.5 加大 FPGA 发送幅度（21:15–21:21）

10-15 的全摆幅版本：DAC40 **0/3**，DAC55 **0/3**（`log/rk_env/pcie_dac40_reboot_20261017.log`、`pcie_dac55_reboot_20261017.log`）。**单纯加大 TX 幅度无效。**

RK 设备树：10-05 修改过一次（`D:\pango_work\dtb_new.bin`），现在的值 max-link-speed=3、num-lanes=2 与 10-14 链路正常时相同。**排除 RK 侧配置被持久修改的可能。**

## 5.6 参考时钟 100 MHz / 125 MHz 核对（21:40）

| 项 | 结果 | 依据 |
|---|---|---|
| FPGA 设计用的参考时钟脚 | F11/E11（HSSTREFCLK0_QL3） | `pnr/pango_pcie_top.fdc:144-152` |
| F11/E11 接到哪里 | 金手指 J5.A13/A14（REFCLK±）→ C236/C237 → 底板 J1.1/3 → 核心板 J1.2/4 → U1.F11/E11 | `docs_ext/fpga_pkg/hw/BASE_V1.2_netpins.txt`、`CORE_V1.2_netpins.txt` |
| 板载 125 MHz 晶振 U4（Q3_REFCLK） | 接 F13/E13（HSSTREFCLK1_QL3），本设计**没用** | 同上；手册 p50 |
| IP 设置 | Reference_Clk = 100 MHz | `ip/PCIe_IP/PCIe_IP.idf:194-195` |
| 时序约束 | ref_clk 10.000 ns（100 MHz） | `pnr/pango_pcie_top.fdc:4` |
| 125 MHz 从哪来 | PCIe 核内部 pclk（Gen1 时 125 MHz，由 100 MHz 参考倍频得到）；DMA 逻辑用 pclk_div2（62.5 MHz） | `src/pango_pcie_dma_top.v:267` 注释 |
| RK 侧 | PHY 参考 clk_pcie30phy_ref_m/n = 100 MHz（来自 PPLL） | `/sys/kernel/debug/clk/clk_summary` |

手册 p43 写的 PCIE_REFCLK=F13/E13 是**错的**（那是 125 MHz 晶振）。照手册接会出问题，本设计没有照抄。

**结论：不存在 100/125 MHz 错配。** 另有物理证据：若参考时钟差 25%，FPGA 不可能解出 RK 的 TS1/TS2，而 5.4 轨迹里每次失败 FPGA 都走过了 Polling.Active → Polling.Config → Config.Linkwidth.Start；17:34 那次建链后 30 分钟 0 误码。

**补充（10-15 已查过 OK3568-UP4 原理图）：** P29 插槽的 REFCLK 来自底板 U53 DSC557-03 时钟芯片，不开 SSC。RK 的 PHY 按 clk_summary 看用的是内部 PPLL 100 MHz【推断，原理图上 U53 是否也接 RK 未最终确认】。也就是说，两侧很可能是"各自的 100 MHz"（非同源），这在 PCIe 规范允许范围内（各 ±300 ppm），17:34 建链后 30 分钟 0 误码也说明它不是根因。

**另：** 10-15 已把卡插到 P30 做过对照（RK 另一个控制器、另一个 PHY、另一路参考时钟），同样大多失败。两个插槽的共同因素是 FPGA 卡。

## 5.7 检查清洁后复测（22:17–22:23）

用户检查了金手指（橡皮擦 + 酒精清洁）、板间连接器和金手指附近的电容，然后断电重插 P29、上电。FPGA 用 JTAG 烧 `pango_pcie_dma_x2_ltssmlog.sbit`，RK 软重启 3 次：**0/3**，每次 RK 都是 0x3 → 0x8 → 0x2 → Link Fail。

UART 轨迹（`log/rk_env/ltssm_insp1_20261017.log`、`ltssm_insp23_20261017.log`）与 5.4 相同：每次启动约 88 轮 CFG_LINKWD_START → CFG_LINKWD_ACEPT 超时，从未进入 CFG_LANENUM_WAIT，LINK 一直为 0。**清洁、检查没有改变失败方式。**

## 5.8 第二次橡皮清洁后复测（22:33–22:35）——失败方式变了

用户再次用橡皮清洁金手指，重插、上电，烧 ltssmlog，RK 软重启 3 次：**0/3**。日志：`log/rk_env/pcie_clean2_reboot_20261017.log`、`ltssm_clean2_20261017.log`。

| | 之前（5.4、5.7） | 这次 |
|---|---|---|
| FPGA 接收（CDR0/1、LSM0/1） | 一直锁定 | **一直为 0**，收不到 RK 的信号 |
| FPGA 最远状态 | CFG_LINKWD_ACEPT，约 88 轮 | POLL_ACTIVE 约 25 ms 后进 **POLL_COMPLIANCE** 并停住，每次启动只走一轮 |
| RK dmesg | 0x3 → 0x8 → 0x2 → Fail | 0x2 ×5 → Fail |
| PLL / TX 复位完成 | 1 | 1（全程没有掉锁记录） |

**解读：** 两边的"接收端检测"都通过了（这一步只需要低频导通），但两个方向的高速信号都过不去。前后唯一的变化是手动清洁和重插。

**结论更新【推断】：** 失败方式会随拔插、清洁而改变，说明问题主要在**机械连接**上：金手指和 P29 插槽的接触，或者核心板与底板之间的连接器。这比"FPGA 发送端器件损坏"更可能。另外，用橡皮摩擦金手指会产生静电，而卡上的 RX 金手指直接连到 FPGA 的 HSST 接收脚，有一定 ESD 风险。之后不要再用橡皮擦。

## 6. 下一步选项（21:22 更新）

| 选项 | 内容 | 需要 | 能回答的问题 |
|---|---|---|---|
| G（最关键） | **交叉替换**：把一块已知正常的 PCIe 设备（M.2 NVMe 加转接卡、PCIe 网卡等）插到 RK 的 P29；或者把 FPGA 卡插到一台台式机的 PCIe 槽 | 你手边有没有这类设备或台式机 | 问题在 RK 一侧还是 FPGA 卡一侧，这是目前最大的未知 |
| H | 读 RK PCIe 控制器内部的 LTSSM 调试 FIFO（驱动在训练时已经打开了它） | 无需硬件，但训练失败后控制器可能已断电，读寄存器有让 RK 死机的风险 | RK 一侧卡在哪个子状态、在等什么 |
| I | 把 FPGA PCIe IP 的目标速率锁死为 Gen1，并去掉 Gen3/Gen2 相关的速率协商 | 重新生成 IP | 排除速率协商字段的影响（可能性较低，因为失败发生在速率切换之前） |
| D | PCIe 先放一放，推进 HDMI 通路（方案 B，不依赖 PCIe） | 无 | — |

**之前的下一步选项（20:16 版本，保留备查）**

| 选项 | 内容 | 代价 | 能回答的问题 |
|---|---|---|---|
| E（最便宜） | 两块板断电 ≥ 10 分钟，冷却后上电 → 烧 x2 调试版 → 重启 RK | 等 10 分钟，你开关一次电 | 冷态能否稳定建链；如能，再用吹风机或风扇做冷热对照 |
| F（信息量最大） | 在 FPGA 中加一个 UART 记录器，通过 100Pro+ 的 USB-UART 口实时输出 LTSSM 状态的每次跳变（带时间戳） | 编译一次；需要用 USB 线连接 FPGA 板的 UART 口和电脑 | 精确知道卡在 Configuration 的哪个子状态（Lanenum、Complete、Idle），以及是否进入了 Recovery |
| D | PCIe 先放一放，推进 HDMI 通路（方案 B） | 无 | — |

原选项 A 已完成（结果见 5.1）；B、C 暂缓：物理层已证实正常，换参考时钟意义不大。

| 选项 | 内容 | 代价 | 能回答的问题 |
|---|---|---|---|
| A（推荐） | 调试版 bitstream：用 LED 显示 HSST PLL 锁定（实时）、TX/RX lane 复位完成、CDR 锁定、自 PERST# 释放以来 LTSSM 到达的最高状态 | 编译一次（约 4 min），再重启几次 RK | 训练失败卡在哪一层：时钟、PLL、lane 复位还是 LTSSM |
| B | 完全按 17:30 的做法：断电 → 拔卡 → 重插 → 压紧 → 上电，看是否"每次重插都能成功一次" | 每次都要你动手 | 是否是机械或热漂移问题 |
| C | 根据 A 的结果，必要时改用 FPGA 板上的 125 MHz 晶振作 HSST 参考时钟（独立参考时钟模式），绕开金手指参考时钟路径 | 需要重新生成 IP | 绕开可疑的参考时钟路径 |
| D | PCIe 先放一放，推进不依赖 PCIe 的 HDMI 通路（方案 B） | 无 | — |

## 5.9 酒精清洁 + 仔细重插后复测（22:41–22:43）

用户按 5.8 的步骤操作：酒精清洁、吹插槽、插到底、保持垂直并托住、压核心板。之后上电、烧 ltssmlog，RK 软重启 3 次：**0/3**。日志：`log/rk_env/pcie_reseat3_reboot_20261017.log`、`ltssm_reseat3_20261017.log`。

失败方式与 5.8 相同：FPGA 的 CDR/LSM 全程为 0，POLL_ACTIVE 约 25 ms 后进 POLL_COMPLIANCE。**两个方向的高速信号仍然都不通，重插没有恢复到 5.7 的状态。**

下一步建议：把卡移到 **P30**（RK 另一个控制器、另一路时钟，只接 lane 0），用同一个 ltssmlog 版本看 FPGA 的 CDR0 能否锁定：
- CDR0 能锁：卡的接收通路正常，问题在 P29 插槽一侧；
- CDR0 也锁不住：问题在卡一侧（金手指、板间连接器或 FPGA 本身）。

## 5.10 卡换到 P30（22:50–23:00）——卡是好的

用户把卡从 P29 移到 P30（RK pcie2x1 控制器、组合 PHY2、核心板 PCIE_B_CLK 参考时钟，只接 lane 0），FPGA 仍烧 `pango_pcie_dma_x2_ltssmlog.sbit`。

| 项 | 结果 |
|---|---|
| 建链 | **3/3**，每次 `PCIe Link up, LTSSM is 0x130011`，**5.0 GT/s x1**；第 2、3 次是软重启，没有重新 JTAG 烧录 |
| UART 轨迹 | 每次一遍走完 Detect → Polling → Config（含 LANENUM_WAIT/ACEPT、COMPLETE、IDLE）→ L0 → Recovery（升速）→ L0；CDR0/LSM0=1 |
| 稳定性 | 60 s 内每 5 s 读一次，LTSSM 一直 0x11，LnkSta=0xf012 |
| 数据 | pcie_bench 4 KB 回环校验 6/6 OK；host→FPGA ~153 MB/s，FPGA→host ~156 MB/s；无 AER 报错 |

日志：`log/rk_env/pcie_p30_reboot_20261017.log`、`ltssm_p30_1_20261017.log`、`ltssm_p30_23_20261017.log`、`pcie_p30_bench_20261017.log`。

**结论（推翻 10-15 "共同因素是 FPGA 卡"的判断）：** 卡的 lane 0 收发、金手指、参考时钟输入都是好的。P29 的问题在 **P29 一侧**，可能是：
- P29 插槽触点；
- P29 的参考时钟 U53 DSC557-03（PCIE_A_CLK）或其走线；
- RK 的 PCIe3 PHY 或 P29 走线。

卡的 lane 1 没有测到（P30 只接 lane 0）。

与 5.8/5.9 一致的解释【推断】：如果 P29 给卡的参考时钟有问题，FPGA 的收发都以它为基准，两个方向都会坏；而 RK 自己的 PHY 用内部 PPLL，不受影响。这可以用 FPGA 内测频（27 MHz 晶振对 ref_clk 计数）在 P30、P29 各测一次来验证。

**实际意义：** P30 的 Gen2 x1 用参考 DMA 实测约 153/156 MB/s，比 P29 Gen1 x2 的 97/99 MB/s 还高（参考 DMA 内部搬运在 Gen2 下是 250 MB/s 上限）。项目可以先用 P30。

**10 分钟压力测试（23:00–23:10，`log/rk_env/pcie_p30_soak_20261017.log`）：** 324/324 轮通过（每轮都含 4 KB 回环校验和双向 DMA 长度扫描）。根端口和 EP 的 AER 全为 0，RAS DES 各计数全为 0，链路全程 5.0 GT/s x1。吞吐量 153.0 / 156.0 MB/s。

## 5.11 卡换回 P29（23:24–23:37）——能建链了，但 lane 1 在 Gen2 下仍坏

用户把卡从 P30 移回 P29，上电，烧 `pango_pcie_dma_x2_ltssmlog.sbit`。FPGA 的 USB 串口线（COM13）在这次移动后没有出现在电脑上，所以本节**没有 UART 轨迹**。

| 项 | 结果 | 日志 |
|---|---|---|
| 建链 | **3/3**，每次都是 5.0 GT/s x2（1 次烧录后 + 2 次软重启） | `log/rk_env/pcie_p29b_reboot_20261017.log` |
| Gen2 x2，空闲约 70 s | lane0 全 0；**lane1 decode/disparity=15（计数上限）**，deskew=255，rx_err=255，l0_to_recov=282510，replay_to=21，tx_nak=33；根口 CE=0x1081，EP CE=0x1100 | `pcie_p29b_idle_20261017.log` |
| Gen2 x2，pcie_bench | 回环校验 OK，但 3 轮里 2 轮超过 15 s 超时；第 3 轮出现 `reg read 0xFFFFFFFF: EP lost`（链路瞬断）→ **不可用** | `pcie_p29b_gen2_bench_20261017.log` |
| 运行中降到 Gen1 x2（`setlink.sh 1 0`），空闲约 50 s | 全部计数为 0 | `pcie_p29b_gen1_idle_20261017.log` |
| Gen1 x2，5 分钟压测 | **94/94 通过**，全部计数为 0，94.4 / 99.8 MB/s | `pcie_p29b_gen1_soak_20261017.log` |

**结论：**
1. P29 的"建链失败"在这次重插后消失了（3/3），说明它主要是**接触/机械问题**，对插拔很敏感，不是 P29 电路彻底坏了。这修正了 5.10 的说法。
2. **lane 1 在 Gen2 下的误码仍在**（方向是 FPGA lane1 TX → RK lane1 RX，与 10-14/15 相同）。P30 只接 lane 0，所以还分不清是卡的 lane 1 坏还是 P29 的 lane 1 坏。
3. 用参考 DMA 时三种可用配置的对比：

| 配置 | 稳定性 | 实测吞吐 |
|---|---|---|
| **P30 Gen2 x1** | 稳定，10 分钟 0 错误 | **约 153 / 156 MB/s** |
| P29 Gen1 x2 | 稳定，5 分钟 0 错误（但开机默认训练到 Gen2，需要启动后降速，或把设备树 max-link-speed 改为 1） | 约 94 / 100 MB/s |
| P29 Gen2 x2 | lane 1 误码，链路会瞬断 | 不可用 |

现状（23:37）：卡在 P29，链路已在运行中降到 Gen1 x2。

## 5.12 修复 Gen2 lane 1 误码：把 lane 1 的 TX 去加重从 -6 dB 改成 0（23:40–00:10）

**机制（源码确认）：** `ips2l_pcie_soft_phy_v1_2c.v:953-961`：PIPE `mac_phy_txdeemph==0`（Gen2 -6 dB）→ `lx_deemph=01` → HSST 用 POST1 去加重；其余（Gen1、-3.5 dB）→ `lx_deemph=00` → 用 POST。参数在 `ipm2l_pcie_hsstlp_x2_top.v:271-276`：POST=12，POST1=19（取值范围 0..31，见 `ipm2l_pcie_hsstlp_wrapper_v1_6.v:627`）。所以 Gen2 下两条 lane 都用 POST1=19。

**RK 侧请求 -3.5 dB 不生效：** 根端口 GEN2_CTRL（0x80C）bit20 置 1（0x001102be）后升回 Gen2，两端 LnkSta2 仍为 0x0000（-6 dB）。10-15 那次"-3.5 dB 无改善"实际上从未生效。

**FPGA 侧扫描（只改 CH1_POST1_CURSOR_EMPHASIS，lane 0 与 Gen1 不动；`tools/build_post1.sh`，产物 `D:\pango_work\pango_pcie_dma_x2_post1_<v>.sbit`）：**

| CH1 POST1 | 样本（Gen2 x2 空闲） | lane1 decode/disparity | L0→Recovery |
|---|---|---|---|
| 19（原版） | 4 次：70 s / 20 s / 15 s / 15 s | 15/15（计数上限） | 282510 / 102005 / 35667 / 82423 |
| **0** | 开机训练后 60 s + 2 次重训练各 15 s | **0/0** | **0 / 0 / 0** |

POST1=0 时，三个样本中 lane0、lane1、DLL、AER 全为 0。日志：`log/rk_env/pcie_p29_post1_19_samples_20261017.log`、`pcie_p29_post1_0_20261017.log`。

**解读【推断】：** lane 1 这条通路的高频损耗小，-6 dB 去加重属于"过补偿"：低频分量被压掉一半，眼图反而变差，RK 接收端误判。lane 0 的通路特性不同，所以在 -6 dB 下仍然正常。

**验证（POST1=0）：**
- 10 分钟 Gen2 x2 压测（00:05–00:15，`log/rk_env/pcie_p29_post1_0_soak_20261018.log`）：**370/370 通过**，AER、RAS DES 全部为 0，吞吐 **188.4 / 183.7 MB/s**（P30 Gen2 x1 是 153/156）。
- 软重启 2 次（`pcie_p29_post1_0_reboot_20261018.log`）：每次开机直接训练到 Gen2 x2，20 s 内全部为 0。

**已写入源码：** `ipm2l_pcie_hsstlp_x2_top.v:276` 改为 `CH1_POST1_CURSOR_EMPHASIS = 0`（原文件备份在 `backup_20261017_prepost1\`）。可直接使用的比特流：`D:\pango_work\pango_pcie_dma_x2_post1_0.sbit`（`prog_x2_post1_0.tcl`；内含 ltssm_logger 和调试灯）。

**现在的推荐配置：P29 Gen2 x2 + post1_0。** 这是参考 DMA 下最快的稳定配置。仍需注意：P29 对插拔敏感，插好后不要再动。另外，FPGA 是 JTAG 烧到 SRAM 的，断电后要重新烧录。
