Zdy-1110/FPGA-676/RK_NPU模型训练与部署规划_20261020.md

# RK3568 NPU 检测模型训练与部署规划（2026-10-20）

> 本文是在 `RK_NPU检测程序设计_20261018.md` 基础上的扩展：从"直接用 COCO 预训练模型"改为"自训专用模型"，并补上数据、训练、量化的规划。板端程序结构（§6）沿用旧文档 §3。
> 本次规划未连接开发板。所有板端数字，以 N1 的上板实测为准。

## 0. 结论摘要

- **目标**：训练一个 9 类 YOLOv8n 检测模型，量化为 INT8，跑在 RK3568 的 NPU 上（板端 librknnrt 1.5.0）。它要覆盖赛题点名的"行人、道路路障"，以及碰撞提醒、变道需要的车辆和骑行者。COCO 没有锥桶、水马、三轮车，所以必须自己训练。
- **训练条件已具备，不用下载**：
  - PC 有 RTX 5080 Laptop（16 GB，compute capability 12.0）。
  - conda 环境 `E:\Project\conda_envs\yoloe-trt` 已有 torch 2.7.1+cu128（含 sm_120，CUDA 可用）、ultralytics 8.4.120、onnx 1.18，Python 3.11。
  - 预训练权重已在本地：`E:\Project\Python_Project\yolo\yolov8n.pt`（6,549,796 B，md5 95a24496…，与官方大小一致）和 `yolov8s.pt`。
- **两个主要阻塞**：
  1. 还没有任何人工标注的目标框，只有 113539 一段的 yolo11n 伪标签。
  2. 还没有 RKNN 转换环境：BIOS 里 VT-x 关闭，WSL2 起不来；本机没有 Toolkit2。
- **推进方式**：四条工作线并行（数据、训练、转换、板端），按里程碑 N0–N6 推进。
  - 决定输入尺寸和模型大小，要先拿到 N1 的板上测速结果，所以转换环境是关键路径。

## 1. 需求边界

### 1.1 赛题原文（`contest_pymupdf.txt`，已逐字核对）

| 行号 | 要点 |
|---|---|
| :368-369 | 识别斑马线、行人、道路路障；变道、超速提醒、碰撞提醒 |
| :373 | ARM 端处理性能不高于 RK3568 |
| :384 | 基础任务③：**基于 FPGA** 实现环境监测与场景感知 → NPU 只是 AI 补充，不能替代 FPGA 感知 |
| :386-391 | 高阶任务：①四路视频；②夜间道路、复杂路口；③在 ARM 端部署轻量 AI 模型，做多路实时、低延迟识别 |
| :413、:417-420 | 评分看实时帧率、端到端延迟、识别准确率 |
| :437 | 测试场景含"行人闯红灯的汽车刹车" |
| — | 原文没有给出具体的 fps 数字，下文的 fps 目标是自定的 |

### 1.2 NPU 和 FPGA 分工

| 目标 | 负责方 | 理由 |
|---|---|---|
| 信号灯（含箭头灯） | FPGA，全分辨率 | 缩到 NPU 输入后，箭头只剩约 10 px |
| 车道线和虚实 | FPGA，BEV | 已有方案（按键标定 + 鸟瞰图） |
| 斑马线 | FPGA | 架构文档 §13。v2 可选：NPU 加 crosswalk 类做交叉验证 |
| 行人、骑行者、车辆、三轮车、锥桶、水马 | NPU | COCO 类别不全，需要自训 |
| 限速牌 | NPU 只检出框；数值由二级识别读取 | 小目标。v1 只出框，读数值放到 v2 |

## 2. 模型规格（v1）

- **架构**：YOLOv8n，nc=9，用 COCO 预训练的 yolov8n.pt 初始化。
  - 为什么仍用 v8n：板端 runtime 1.5.0 只能配 Toolkit2 1.5.x；model_zoo 有 yolov8 的 C 后处理可以参考；yolo11 要 2.x 才支持。
- **类别**（沿用层 B 标注方案）：

  | id | 类别 |
  |---|---|
  | 0 | person |
  | 1 | rider（骑手和两轮车合成一个框） |
  | 2 | car |
  | 3 | bus |
  | 4 | truck |
  | 5 | tricycle |
  | 6 | cone |
  | 7 | barrier |
  | 8 | speed_limit |

  - 标注按 9 类做。训练时可以合并（比如 bus+truck 合成 large_vehicle），合并不需要重新标注。
- **输入**：
  - 前视：960×320。取 1920×1080 原图的路面带 y 360–1000，横竖各缩 2 倍。
  - 以后接 FPGA 拼图时：640×384。用同一份权重再导出一个版本。
- **输出**：按 model_zoo 格式，3 个尺度，每个尺度 {box 64 通道（DFL）, cls 9 通道, score_sum 1 通道}。DFL 解码和 NMS 放在板端 C 代码里。
- **量化**：
  - INT8 非对称量化。
  - 校准集：200 张真实路面带图，必须用和板端相同的裁剪、缩放方式生成。
  - 如果精度损失超标，把检测头改为 fp16，做混合量化。
- **备选**：
  - N1 测速余量大（≥30 fps）：试 yolov8s。
  - 不到 15 fps：改用 640×224 输入，或者把激活函数换成 ReLU 的版本。

## 3. 数据方案

### 3.1 数据来源

| 来源 | 规模 | 作用 | 状态 |
|---|---|---|---|
| 官方 7 段视频（`video_review/src`，共约 268 s、8.4k 帧） | 帧池 535 张（`label_pool`，已去掉 111440） | 域内训练和验证 | 已抽帧，未标注 |
| 官方视频加密抽帧 | 再抽约 800 张（按 2 fps 抽，帧差去重） | 扩充域内样本 | 待做 |
| 自己拍的行车视频，白天和夜间都要 | 目标 ≥30 min，抽约 2000 张 | 样本量不够；高阶任务②需要夜间道路 | 需要你们拍 |
| 公开数据集（需要你批准下载） | 子集，见下 | 补足类别和夜间样本 | 未下载 |

公开数据候选（大小和类别映射都待核实，**下载前会逐项请你批准**）：
- **BDD100K 检测子集**：行车记录仪视角，有昼夜之分。类别含 pedestrian、rider、car、bus、truck、bicycle、motorcycle。计划只取 5–10k 张。
- **SODA10M 有标注部分**：中国城市道路，含 tricycle、cyclist。和深圳的素材最接近。
- **锥桶/水马**：CODA（道路角落案例）或其他 traffic cone 数据集，二选一。
- **限速牌**：TT100K（有 pl40 等限速类）体积大，放到 v2 再议。

### 3.2 标注

- **工具**：建议用 X-AnyLabeling。它在本地运行，支持 YOLO 格式，也能用模型预标注。需要下载约 100–200 MB；备选是 LabelImg。
- **流程**：
  1. 预标注：在 GPU 上用 COCO 的 yolov8s，以 1280 输入跑原图，得到 person、bicycle、motorcycle、car、bus、truck，再用脚本把人和两轮车合成 rider。
  2. 人工修正，并补标 tricycle、cone、barrier、speed_limit。
  3. 抽查：随机抽 10%，由另一人复核。
- **标注在 1920×1080 原图上做**。裁带放在数据构建脚本里，这样以后改裁带范围或者换拼图格式，都不用重新标注。
- **规则**：沿用 `选题3_官方视频素材分析与数据标注方案_20261018.md` :66-80（遮挡超过 70% 的不标、中控屏和反光里的不标等）。新增一条：裁带后可见部分不到 30% 的框丢弃。
- **工作量估计**：535 张约 1.5–2 人日；加密抽帧的 800 张约 2 人日；自采的 2000 张约 4–5 人日。

### 3.3 训练集和验证集划分

- **必须按视频划分**。相邻帧高度相关，按帧随机分会让验证结果虚高。
- 验证集取 2 段官方视频，再加 1 段自采夜间视频。要求验证集里至少出现 person、rider、car、cone 这 4 类。具体选哪几段，标完后按各类数量再定。
- 113539 里锥桶、围挡、三轮车、行人最多，放在训练集。
- 事件级测试：用层 A 的 131 条用例。其中 HAZARD 11 条（ped_in_path、lead_close、obstacle_in_lane）专门检验 NPU 的检测结果能不能支撑刹车和碰撞提醒的判断。

### 3.4 数据集构建

脚本 `tools/npu_train/build_dataset.py`：
1. 读入原图标注，裁出路面带，缩到 960×320，写出 YOLO 格式的 txt。
2. 公开数据集按相同的纵向比例裁带，并把类别映射到这 9 类。
3. 生成 `data.yaml`。自有数据按重复列表的方式加权，让域内样本占比更高。

## 4. 训练方案

- **环境**：conda 环境 yoloe-trt，**只用不改**：不往里 pip install。
  - 需要加包时，先 `conda create --clone` 出一个 `npu-train` 环境，再在新环境里装。
  - 设置 `YOLO_CONFIG_DIR=E:\Project\nesai2026\.yolo_cfg`，不再改动全局的 Ultralytics settings.json。
  - 训练输出写到 `runs/npu_train/`。
- **起点超参**：imgsz=960，开 mosaic，最后 15 轮关闭 mosaic，epochs 150，batch 32，从 yolov8n.pt 预训练开始。增强里加亮度和 gamma 扰动，模拟夜间。
- **三组对照**，全部在同一个验证集上比较各类 AP50：
  - B0：COCO yolov8n 不训练，只把类别映射过来（只覆盖 5 类）；
  - B1：只用自有数据微调；
  - B2：自有数据加公开数据。
- **耗时估计**：5k 张图在 RTX 5080 上大约 1–2 小时，以实测为准。

## 5. 导出与转换

- **导出**：
  - 不用 airockchip 的旧 fork 训练。它基于 ultralytics 8.0，和现在的权重、依赖版本都可能对不上。
  - 自己写 `tools/npu_train/export_rknn_onnx.py`：用 ultralytics 8.4 加载训练好的权重，把 Detect.forward 换成 model_zoo 的 9 输出格式。
  - 用 opset 12，静态形状，导出 1×3×320×960 和 1×3×384×640 两个版本。
  - **等价性检验**：用 numpy 解码 ONNX 的输出，在 10 张图上和 ultralytics predict 的结果比较，要求框的 IoU ≥0.99。
  - **风险**：onnx 1.18 默认写出 IR version 10，Toolkit 1.5 自带的老版 onnx 可能不认。要么把 IR 降到 8，要么在转换环境里导出，到时验证。
- **转换**：
  - 需要 Linux x86_64 加 RKNN-Toolkit2 1.5.x。优先用和板端完全一致的 1.5.0；wheel 支持哪些 Python 版本，到时核实。
  - 参数：`target_platform='rk3568'`，mean 0，std 255，asymmetric_quantized-8，校准集 200 张。精度不够时把量化算法换成 mmse。
- **验收**：用模拟器在验证集上测，INT8 的 mAP50 比 fp32 下降不超过 3 个点。超标就查 accuracy_analysis，再考虑混合量化。

转换环境有三个选项：

| 选项 | 前置条件 | 优点 | 缺点 |
|---|---|---|---|
| **A（推荐）** 在 BIOS 打开 VT-x，用 WSL2 里的 Ubuntu-22.04 | 你进 BIOS 改一项，然后重启 | 最稳；以后 docker 也能用 | 需要你到机器前操作 |
| B 把 Ubuntu-22.04 切到 WSL1 | 运行 `wsl --set-version Ubuntu-22.04 1`（改系统配置，需要你同意） | 不用进 BIOS | Toolkit 在 WSL1 下能不能跑没验证过；转换要花不少时间 |
| C 云主机，或别人的 Linux 机器 | 有账号；要上传 ONNX 和校准图 | 不动本机 | 数据要外传，流程更繁琐 |

Toolkit 版本：**推荐 1.5.x**，和板端一致。备选是 2.3.x：
- 好处是可以直接 pip 安装，也支持 yolo11。
- 代价是要把 librknnrt 2.x 和我们的程序一起放到板上（用 LD_LIBRARY_PATH 指定，不替换系统库）。
- NPU 驱动 0.9.0 能不能配 2.x 的 runtime，要上板验证。

## 6. 板端部署（沿用 18 日的设计文档 §3）

- `npu_bench`（N1）：单独测推理速度。
- `npu_det`（N5）：接到 test_feeder 上，流程是：
  1. 最新帧信箱；
  2. RGA 裁剪、缩放，转成 RGB888，放进 CMA 缓冲；
  3. `rknn_create_mem_from_fd` 零拷贝推理；
  4. 在 INT8 域里做后处理；
  5. 把框写入 BAR1 0x900+（最多 16 个）；文字 RAM 显示 fps 和延迟；每帧结果写 CSV。
- 颜色只有 3 位，按类别分配：

  | 类别 | 颜色 |
  |---|---|
  | person | 黄 3 |
  | rider | 品红 6 |
  | car、bus、truck | 青 5 |
  | tricycle | 蓝 4 |
  | cone、barrier | 白 7 |
  | speed_limit | 绿 2 |
  | 风险目标（保留） | 红 1 |

- N5 需要 librga v1.9.1 的头文件（不到 1 MB，需要你同意下载）。

## 7. 速度预算（待 N1 实测）

- 960×320 的像素数是 640×640 的 75%。
- 目标：
  - 前视单路 ≥15 fps，一次推理加前后处理 ≤50 ms；
  - 四路阶段：前视 15 fps 加 2×2 拼图 ≥5 fps。
- RK3568 的 NPU 只有一个核，所以四路阶段每次推理要压到约 40 ms 以内。
- N1 实测后，再定模型用 n 还是 s，以及输入尺寸。

## 8. 里程碑

| 编号 | 内容 | 验收 | 依赖 |
|---|---|---|---|
| N0 | 你确认 §9 的决策；不需要下载的部分马上开工：数据构建脚本、预标注脚本、导出脚本 | 脚本能在本机跑通 | — |
| N1 | 打通转换链路并测速：COCO yolov8n 转成 960×320 和 640×384 两个 rknn，在板上跑 `npu_bench` | 900 MHz 下的推理时间；定下模型大小和输入尺寸 | 转换环境、开发板 |
| N2 | 535 张预标注，人工修正，按视频划分 | 标注完成，抽查一致 | 标注工具、标注人力 |
| N3 | 训练 B0、B1、B2 | 各类 AP50 对比表，选定模型 | N2 |
| N4 | 导出和量化 | ONNX 等价；INT8 在模拟器上 mAP50 下降 ≤3 点 | N1、N3 |
| N5 | 上板集成 `npu_det` | 显示保持 30 fps 不掉帧；NPU ≥15 fps；框的位置正确；取回 CSV，对比板端和模拟器 | N4、开发板 |
| N6 | 扩展：用自采夜间数据再训；输入改成 FPGA 拼图；限速值识别；用帧号对齐框和画面 | — | N5 |

可以并行的部分：N1 在 PC 上的部分、N2、N3 的准备工作（脚本、B0 评估）三者互不依赖。需要开发板的只有 N1 的测速和 N5。

## 9. 需要你决定的事

> 10-20 已定：D1 = A（VT-x 已开，WSL2 可启动）；D2 = 1.5.x；D3 = 9 类；D5 = yoloe-trt 只用不改。仍待定：D4。

1. **D1 转换环境**：A 开 VT-x（推荐）/ B WSL1 / C 云端。
2. **D2 Toolkit 版本**：1.5.x（推荐）/ 2.3.x 加随程序附带的 runtime。
3. **D3 类别**：按 §2 的 9 类（推荐），或者修改。
4. **D4 数据**：
   - 谁来标注；是否下载 X-AnyLabeling；
   - 下载哪些公开数据集；
   - 能不能自己补拍行车视频，尤其是夜间的。
5. **D5 训练环境**：直接用 yoloe-trt，只用不改（推荐）；或者克隆一个专用环境。

## 10. 目录规划

| 路径 | 内容 |
|---|---|
| `tools/npu_train/` | PC 端：build_dataset、prelabel、训练配置、export_rknn_onnx、评估脚本 |
| `tools/npu_convert/` | Linux 端：转换脚本、生成校准列表、accuracy_analysis |
| `tools/npu_det/` | 板端 C 程序：npu_bench、npu_det |
| `datasets/npu_v1/` | 生成的训练数据，可以随时重新生成 |
| `models/npu/` | 训练好的权重、ONNX、rknn |

## 11. 进度（10-21）

- **N0 完成**，所有脚本只在 CPU 上运行。**供电不足**：10-20 用 GPU 预标注时整机断电 3 次（Kernel-Power 41）。供电问题解决前不用 GPU、不训练。
- 预标注：`tools/npu_train/prelabel.py`（支持 `--device cpu --threads 6 --skip-existing`），535 张，4723 个框，输出在 `datasets/npu_labels/prelabel_v8s1280`。
- 数据集：`tools/npu_train/build_dataset.py` 生成 `datasets/npu_v1`。train 462 张/3780 框，val 73 张/819 框（val 暂定 113343、113452）。ultralytics 格式检查 0 corrupt。完整命令见 `build_cmd.txt`。
  - 不设全局的 y2/面积过滤：机位正常时，近车底边会到 y≈1030–1077，面积可达 0.39，全局过滤会误删这些最关键的目标。
  - 只对 112739 按视频过滤：y2>900 或框宽>700 的框删掉（中控屏、A 柱误检），共 123 个。
- ONNX 导出：`tools/npu_train/export_rknn_onnx.py`，9 输出，opset 12，ir 7。COCO yolov8n 的 band 档和 mosaic 档都通过等价校验：框误差 ≤0.008 px，NMS 后 IoU ≥0.99999。后处理参考实现为 `rknn_postprocess.py`，只依赖 numpy，可以给板端 C 代码对照。
- 校准集：`tools/npu_convert/make_calib.py` 生成 `models/npu/calib/{band_960x320,mosaic_640x384}`，各 200 张 PNG。排除 111440、val、112739（机位偏）。
- 转换：`tools/npu_convert/convert_rknn.py` 目前只通过了 `--dry-run`，要等 WSL 装好 Toolkit2 1.5.x 才能真正转换。
- **人工标注（N2）要修的预标注问题**：
  - 锥桶、栏杆、限速牌、三轮车全部漏标，COCO 没有这几类；
  - 两轮车没检出时，骑车人会被标成 person；
  - 有重复框，以及同一辆车同时被标成 car 和 truck；
  - 112739 整段机位偏，路段带里大部分是仪表台。
- **下一步**（都需要你批准或在场）：
  - WSL 装 pip、venv 和 Toolkit2 1.5.x，约 1.5–2 GB 下载，注意 WSL 不能用本机 localhost 代理；
  - 决定 D4；
  - 供电恢复后再做冒烟训练。

## 12. 进度（10-25：在 WSL 里用 GPU 训练）

- **环境**：WSL 的 conda 环境 `yolov8_train`，只用不改。每次先 `source tools/npu_train/wsl_env.sh`，它会设好 YOLO_CONFIG_DIR、关掉自动安装、开启离线。数据集是在 WSL 里重建的 `datasets/npu_v1w`，与 npu_v1 划分一致。新增脚本：`train_npu.py`、`hyp_v1*.yaml`、`eval_npu.py`、`infer_videos.py`。
- **供电**：做了冒烟和 3 次训练与推理。GPU 峰值 126 W，最高 58 °C，没有断电，功耗记录在 `log/gpu_smoke_20261025.csv`。
- **结果**：验证集是 2 段留出视频共 73 张，GT 是教师伪标签，所以下面的数字只代表与教师的一致程度。

  | 模型 | person | rider | car | bus | truck | mAP50 |
  |---|---|---|---|---|---|---|
  | B0（COCO 映射） | 0.285 | 0.594 | 0.825 | 0.335 | 0.651 | 0.538 |
  | B1（全量微调） | 0.570 | 0.667 | 0.737 | 0.049 | 0.512 | 0.507 |
  | B1f（冻结骨干） | 0.528 | 0.440 | 0.781 | 0.022 | 0.587 | 0.471 |

  | B2（6 fps，全量微调） | 0.512 | 0.508 | 0.797 | 0.127 | 0.619 | 0.513 |
  | B2f（6 fps，冻结骨干） | 0.578 | 0.626 | 0.777 | 0.239 | 0.640 | **0.572** |

  B2 和 B2f 的数据是 `datasets/npu_v2w`：训练视频按 6 fps 加密抽帧，训练集 1384 张，验证集与 v1w 逐字节相同。B2f 是第一个 mAP 超过 B0 的模型，工作点召回也全面高于 B0。但 car 仍比 B0 低 4.8 个点，按原定标准还是没过验收。

  **当前候选改为 B2f**：
  - `models/npu/b2f_v8n_band.onnx` 等价校验通过（IoU ≥ 0.99998）；
  - 官方视频回放结果在 `video_review/npu_runs/b2f_freeze10/`；
  - HAZARD 近似命中 9/11，B1f 是 8/11、B1 是 7/11。提升都出现在训练视频 113539 上，所以偏乐观。

  B1 和 B1f 都没过验收：car 低于 B0，bus 基本学不出来。B1f 在工作点的召回最好；HAZARD 近似命中 8/11，B1 是 7/11。
- **导出**：`models/npu/b1f_v8n_band.onnx` 等价校验通过（IoU ≥ 0.99999），IR 7，opset 12，9 个输出。官方视频回放在 `video_review/npu_runs/b1f_freeze10/`，GPU 推理约 6.7 ms/帧。
- **坑**：
  - 对已训完的 last.pt 做 resume，ultralytics 会另起一次默认训练（coco8，自动选设备），脚本现在会直接拒绝；
  - YOLO_OFFLINE 拦不住数据集的自动下载。
