Zdy-1110/FPGA-676/选题3_官方视频素材分析与数据标注方案_20261018.md

# 选题3 官方视频素材分析与数据标注方案（2026-10-18）

素材目录：`F:\BaiduNetdiskDownload\RK3568-飞凌\紫光同创杯赛题三参考素材\`（8 段 mp4）
赛题测评依据：`contest_pymupdf.txt` 第 422–438 行（十字路口红绿灯、虚实线变道、带导航真实道路、行人闯红灯等，现场 U 盘给视频）。
本次产物：
- 缩略图拼版 `video_review/sheets/`（每段 5×4 张，文件名标明抽帧间隔）
- 关键帧截图 `video_review/frames/`
- 待标注帧池 `video_review/label_pool/`（2 fps，729 帧，`manifest.csv` 记录视频名与时间）
- 抽帧脚本 `tools/video_prep/extract_frames.py`

## 1 结论

1. **需要标注，但要分层做，不是所有内容都逐帧画框。** 先做"事件时间轴真值"（工作量最小、用处最大），再做 NPU 检测框，最后做 FPGA 传统算法的调参数据。见第 4 节。
2. **风险最大的是红绿灯。** 素材里全是"箭头灯组"（左转箭头、直行箭头分开），测评又按"左/直/右车道"考，所以只判断"有红灯"不够，必须同时识别**灯的颜色和箭头方向**，再与按键选定的车道对应。现有方案"FPGA 用 HSV 阈值找红绿灯"需要扩展为"灯箱定位 + 颜色 + 箭头形状"。
3. **111440 不是道路素材**，是量产车"城市领航辅助"中控屏的录像，不标注，作为我们 HDMI 输出画面的设计参考（对应评分项"更真实的道路效果模拟及效果呈现"）。
4. **112739 是测评第 (3) 项"带导航的真实道路视频"的样例**。导航指令（转向图标 + 距离）从画面里的导航屏读取，用模板匹配和数字模板即可，不需要训练用的标注，只需要时间轴真值和图标模板。

## 2 素材清单

全部为 1920×1080、30 fps、HEVC，音轨为空；均为晴天白天，深圳城区（粤B 车牌），由手机隔着挡风玻璃手持拍摄。时间点由缩略图估计，误差约 ±1 个抽帧间隔。

| 文件 | 时长 | 画面内容 | 对应测评项 | 要点 |
|---|---|---|---|---|
| video_20260929_111440 | 1:40 | 中控屏"城市领航辅助中"可视化录像 | 呈现效果参考 | 车速、限速 60、导航"352 米右转"、车道级箭头、渲染的自车/车辆/电动车/行人/斑马线/锥桶、顶部红绿灯状态；约 75 s 后在路口停车等红灯 |
| video_20260929_112454 | 0:04 | 停在路口停止线后 | (1) 红灯停/强行通过报警 | 左转红箭头 + 直行红箭头，前方斑马线 |
| video_20260929_112507 | 0:45 | 多车道主干道前视 | (1)(2)(4) | 白虚线、路口前白实线、地面导向箭头；约 22–25 s 绿灯过路口；约 40 s 路口有行人和电动车；约 42 s 限速 50 标志 |
| video_20260929_112739 | 1:33 | 道路 + 左下中控导航屏 | (3) 按导航模拟智驾 | 导航转向图标与距离（如"684 米右转"）、车道引导箭头、地图上的红绿灯倒计时；约 75–80 s 中控切到 360 环视画面 |
| video_20260929_113343 | 0:22 | 接近路口、变道、排队 | (1)(2) | 变道后在路口排队停车 |
| video_20260929_113421 | 0:13 | 路口起步通过 | (1) | 绿灯起步、通过斑马线 |
| video_20260929_113452 | 0:14 | 跟车减速停车 | (1)(4) 碰撞提醒 | 前车距离由远到近直至停车 |
| video_20260929_113539 | 1:17 | 城市街道跟出租车 | (1)(4) 路障/行人 | 约 12–28 s 红灯停车、约 28 s 转绿；锥桶、施工围挡、三轮车、电动车；约 64–72 s 路口行人 |

## 3 对方案设计有影响的观察

1. **视角不固定。** 手持拍摄，每段的视角、消失点高度都不同且会晃动；画面上沿有后视镜和遮阳板，下沿有仪表台及其在玻璃上的反光。车道线 ROI 和逆透视参数不能写死，需要按段自动估计消失点（或按键标定）；FPGA 帧差也会受晃动影响。
2. **红绿灯小，而且是箭头灯。** 1080p 原图中一组灯箱约 140×60 px，箭头约 30 px；缩到 NPU 输入的 640×360 后箭头只剩约 10 px，NPU 不适合认灯。灯要在 FPGA 上、在原分辨率（至少 960×540）的上半幅 ROI 里做。易混的干扰：红旗（112739 多处）、红色横幅、公交 LED 屏、尾灯、蓝色指路牌。
3. **测评里的车道是按键指定的虚拟车道。** 左车道看左转箭头灯，直行车道看直行箭头或圆灯；右转一般不受灯控（有右转箭头灯时除外）。这一口径需要向组委会确认。
4. **车道线类型有限**：白虚线、白实线（路口前一段）、黄实线中心线、地面导向箭头。变道测评只需要自车左右两条边界的类型（虚或实）。
5. **目标构成**：电动车/摩托很多，骑手常打伞；还有三轮车、出租车、公交、货车；锥桶、水马、施工围挡；行人多出现在路口斑马线上。
6. **没有夜间、雨天、强逆光素材。** 高阶任务里的"夜间道路"需要自己补拍。
7. **素材少且相似。** 道路部分约 4.5 分钟，相邻帧高度相关。划分训练集和验证集要按视频分，不能按帧随机分，否则验证结果虚高；还需要补拍同风格的素材。

## 4 标注内容（三层）

### 层 A：事件时间轴真值（必须，最先做）

每段视频一张 CSV，按时间段记录（开始秒、结束秒、字段值）：

| 字段 | 取值 | 用途 |
|---|---|---|
| sig_left / sig_straight / sig_right | red / yellow / green / off / none | 三车道各自的放行状态 |
| junction | approach / at_stop_line / crossing / none | 是否在路口、在停止线前 |
| ego_left_line / ego_right_line | white_dashed / white_solid / yellow_solid / double_yellow / none | 是否允许向该侧变道 |
| lane_change | left / right（事件起止时间） | 变道动作 |
| nav_maneuver, nav_dist_m | left / right / straight / uturn，数字 | 导航指令（112739） |
| hazard | ped_in_path / lead_close / obstacle_in_lane / none | 刹车、碰撞提醒 |
| speed_limit | 数值或空 | 超速提醒 |
| expect | stop / go / alarm_if_go；allow_change / forbid_change | 由测评规则推出的期望行为 |

用途：判决状态机的测试用例；离线回放时统计判决准确率和延迟。FPGA 传统算法和 NPU 模型都用这一份。工作量：8 段共约 6 分钟，1 人约半天。

### 层 B：NPU 目标检测框（训练用，必须）

建议单模型 9 类：

| id | 类别 | 标注规则 |
|---|---|---|
| 0 | person | 步行的人；骑车人不单独标 |
| 1 | rider | 骑手和两轮车（电动车/摩托/自行车）合成一个框，打伞的也算 |
| 2 | car | 轿车、SUV、出租车、面包车 |
| 3 | bus | 公交、大巴 |
| 4 | truck | 货车、厢式车、工程车 |
| 5 | tricycle | 三轮车（载货或载人） |
| 6 | cone | 锥桶、防撞桶 |
| 7 | barrier | 占用车道的水马、施工围挡、临时隔离栏；路侧固定护栏不标 |
| 8 | speed_limit | 限速牌，附属性 value（30/40/50/60…） |

通用规则：
- 遮挡超过 70% 的不标；在 640 宽尺度下高度不足约 8 px 的不标；
- 中控屏和玻璃反光里的目标不标；被画面边缘截断的目标按可见部分标。

数据：帧池 `video_review/label_pool/`，去掉 111440 的 194 帧后剩 535 帧。

做法：
1. 先用 COCO 预训练 YOLO 预标注（person、bicycle、motorcycle、car、bus、truck 可直接得到）；
2. 人工修正，把骑手和车合成 rider，再补标 tricycle、cone、barrier、speed_limit。

工作量：预标注后约 1.5–2 人日。

### 层 C：FPGA 传统算法的调参与验收数据（必须，数量可以小）

- **红绿灯**：所有路口段按 5 fps 抽帧，每个灯箱标一个框，附属性：
  - color：red / yellow / green / off；
  - shape：round / left / straight / right / uturn；
  - facing：是否朝向本车方向。

  这批数据用来测 FPGA 的识别率。如果 FPGA 的识别率达不到要求，可以用它训练一个只看上半幅 ROI 的小模型作为备选。
- **车道线**：约 150 帧。标自车左右两条边界的折线（必要时加上相邻两条），附属性 color 和 style。斑马线用多边形、停止线用折线，在出现的帧上标。
- **导航屏**：
  - 每段标几次导航面板的位置（手持拍摄，位置会漂移）；
  - 截取左转、右转、直行、掉头、靠左、靠右等转向图标作为模板；
  - 截取 0–9 数字作为模板。

### 不需要标注的内容

- 111440 中控屏渲染画面（只作为呈现效果参考）；
- 路侧固定护栏、建筑、树木、指路牌上的文字。

## 5 下一步（按顺序）

1. **确认规则口径**（找组委会或比赛群）：
   - U 盘里的测试视频是否就是这一批同风格视频；
   - 三个车道与灯如何对应（右转是否受灯控，只有圆灯时是否管所有方向）；
   - "强制行驶""强制变道"由什么触发（按键）。
2. **做层 A 时间轴真值和测试用例表。** 初稿已完成（10-18）：`video_review/gt/`（7 段道路时间轴、131 条测试用例），核对说明见 `video_review/gt/README_核对说明.md`。
3. **跑基线**：在 PC 上用 COCO 预训练 YOLO 跑一遍帧池，统计各类漏检，据此定稿类别表。113539 已完成（10-18）：叠框视频和报告见 `video_review/baseline/`。结论是 640×384 整帧输入时，行人和骑手大约漏掉一半，建议改为裁出路面带后再缩放。
4. **选标注工具**：X-AnyLabeling（离线，支持 YOLO 预标注、折线、多边形和属性）或 CVAT；导出 YOLO txt 格式，属性另存 JSON。
5. **训练与部署**：
   - 以 640×384 输入微调；
   - 用 RKNN-Toolkit2 做 INT8 量化，校准图取自帧池；
   - 在 RK3568 上实测帧率，目标不低于方案文档中的 15 fps。
6. **改进 FPGA 红绿灯识别**：上半幅 ROI 内做红/绿/黄 HSV 阈值，加上"外围是黑色灯箱"的约束和箭头形状模板（左/直/右），用层 C 数据测准确率。车道线改为按消失点自标定 ROI。
7. **补拍素材**：同风格（手机隔挡风玻璃，1080p30）补拍夜间、雨天、逆光、行人闯红灯、施工路段、实线变道场景，每类 2–3 段。
