Zdy-1110/FPGA-676/选题3_按键辅助标定与鸟瞰图车道线_FPGA设计_20261018.md

# 选题3 按键辅助消失点标定与鸟瞰图车道线的 FPGA 实现设计（2026-10-18，草案）

相关文档：
- Python 参考算法：`tools/ref_algo/`（说明见其中的 `README.md`）；
- 硬件主架构：`选题3_硬件架构_FPGA视频中枢方案_20261018.md`；
- 按键 / LED 引脚：`选题3_硬件层架构_双摄像头+HDMI降级方案.md` §10。

## 1 为什么要按键标定

鸟瞰图（BEV）车道线检测非常依赖消失点（VP）是否准确。VP 偏几十像素，鸟瞰图就会呈扇形，虚实判断随之出错。10-18 在 7 段官方视频上试了四种自动标定方法，各有失败的视频，误差在 100–430 px：
- 霍夫线段投票；
- 光流扩展焦点（FOE）；
- 鸟瞰图竖直度搜索；
- 闭环成对选线搜索。

原因是这些视频都是手持拍摄：取景差别大，有仪表台遮挡，开头常停在斑马线前。详见 `tools/ref_algo/README.md`。

所以采用"按键辅助标定"：
- 每段测试视频开始时，操作员用按键把屏幕上的十字和两条引导线对准路面，大约 10 秒。
- 自动标定的结果作为十字的初始位置，同时作为不按键时的后备。
- 运行中 VP 可以在标定值附近自动微调，跟上手持晃动带来的漂移。

赛题测试方式本身就要求用按键模拟车道切换和强制操作，增加一个标定模式符合评测形式。

## 2 标定参数

坐标都以输入帧 1920×1080 为准。模式 T 下全屏显示时，屏幕坐标与输入帧一一对应。

| 参数 | 含义 | 来源 |
|---|---|---|
| vp_x, vp_y | 消失点 | 按键标定；未标定时用自动标定值 |
| y_bot | 路面带下沿（仪表台 / 引擎盖上方的最低一行可见路面） | 按键标定；未标定时用自动值 |
| y_top | 鸟瞰图顶行对应的图像行 = vp_y + max(0.05H, 0.30·(y_bot − vp_y)) | 由上面两个参数推出，不需要标定 |
| 车道宽度、镜头在车道内的相对位置 | 用于成对选线 | 每段视频在线学习，不需要标定 |

## 3 操作流程

### 3.1 按键分配（标定模式下临时复用）

平时 KEY0–KEY4 的功能见硬件文档 §10。KEY4 原定义为：短按切换显示模式 Q/T，长按 ≥ 1 s 松开时切换容器来源。

| 操作 | 平时 | 标定模式 |
|---|---|---|
| KEY4 按住 ≥ 3 s | 进入标定模式（到 3 s 时立即触发，不再执行 1 s 长按的功能） | 保存并退出（写寄存器，CAL_VALID=1） |
| KEY4 短按 | 显示模式 Q/T | 切换调节对象：VP → y_bot → 引导线张角 → VP |
| KEY2 / KEY3 | 左转向 / 右转向 | 当前对象左移 / 右移（调张角时为收窄 / 放宽） |
| KEY0 / KEY1 | 换车道 / 行驶停止 | 当前对象上移 / 下移 |
| 30 s 无按键 | — | 放弃修改并退出 |

- 按住连发并逐步加速：前 0.5 s 每次 2 px，0.5–1.5 s 每次 8 px，此后每次 32 px，约每 66 ms 一次。
- 进入标定模式时，FPGA 在 BAR0 置"暂停请求"位，RK 播放器收到后暂停 U 盘视频，方便对准；退出时清除该位，恢复播放。PCIe 断开时无法暂停，就在播放中对准。

### 3.2 屏幕叠加（OSD）

- **红色十字**：中心为 (vp_x, vp_y)，臂长 40 px，线宽 3。
- **两条绿色引导射线**：从 VP 射向 (vp_x ± g, y_bot)，g 为张角参数，初值为 0.3W。操作员调 VP 和张角，让两条射线分别与自车左右车道线重合。两条射线都重合时，VP 的 x、y 就都对准了。这一步最直观，是标定的核心。
- **黄色水平线**：y = y_bot。对准可见路面的最低一行，紧贴仪表台或引擎盖上沿，宁低勿高。离线评测表明，把最近一段路面切掉会让车道线判对率从 87% 掉到 70%（见 §7.2）。
- **灰色水平线**：y = y_top（推导值，不可调）。
- **右上角**：实时显示鸟瞰小窗（见 §5）。对准时车道线在小窗里会变成竖直线，可以作为第二种确认手段。
- **左上角**：文字 "CAL VP(x,y) YB=.. OBJ=VP STEP=8"，用现有 3_11 OSD 字符模块。
- 当前被调节的对象闪烁（1 Hz）。

射线的像素判定：对显示像素 (x, y) 计算 |(x − vx)·(y_bot − vy) − (±g)·(y − vy)| ≤ t·L，其中 L 为射线长度的近似值，t 为线宽。每条射线需要 2 个乘法器，2 条射线、十字、水平线合计用不到 10 个 DSP。

### 3.3 自动后备与运行中自校正

- **自动初值**：RK 在每段视频开头 3 s 运行自动标定（参考算法中的霍夫投票 VP 和 y_bot），写入 AUTO_VP、AUTO_BAND，作为十字的初始位置。
- **未标定时**：直接使用自动值（CAL_SRC=0）。
- **运行中自校正**：左右两条线都稳定时，用它们在原图中的交点慢慢修正 VP，每帧最多移动 vp_alpha=0.05 倍的偏差，单步不超过 10 px。修正后的 VP 只能落在标定值附近：x 方向 ±12%W，y 方向 ±6%H。当前值写入 LIVE_VP 供显示和调试。

## 4 BAR0 寄存器（新增，0x180 起）

| 偏移 | 方向 | 内容 |
|---|---|---|
| 0x180 | 读写 | CAL_CTRL：bit0 CAL_VALID，bit1 CAL_MODE（FPGA 置位，RK 只读），bit2 PAUSE_REQ（FPGA 置位，RK 只读），bit3 CAL_SRC（0 自动 / 1 按键），bit8–15 CAL_SEQ（每次保存加 1，RK 据此重算） |
| 0x184 | 读写 | CAL_VP：[15:0] vp_x，[31:16] vp_y（像素，整数） |
| 0x188 | 读写 | CAL_BAND：[15:0] y_top，[31:16] y_bot |
| 0x18C | 读写 | CAL_GUIDE：[15:0] 引导线张角 g |
| 0x190 | RK 写 | AUTO_VP：自动标定 VP |
| 0x194 | RK 写 | AUTO_BAND：自动标定 y_top、y_bot |
| 0x198 | RK 写 | LIVE_VP：运行中自校正后的 VP |
| 0x1A0 | 读写 | BEV_CTRL：bit0 使能；bit8–15 行表版本号（行表重算后加 1） |
| 0x1A4 | 只读 | BEV_STAT：最近一帧鸟瞰图帧号、处理耗时（us） |

## 5 鸟瞰图在 FPGA 上的实现

### 5.1 关键性质：按行变换

参考算法的鸟瞰图，是把"上下边水平、两腰过 VP"的梯形映射成 w×h 矩形（w=h=400）。这类单应变换把水平线映射为水平线，并把 VP 映射到竖直方向的无穷远，所以：
- 鸟瞰图的每一行 v 正好对应原图的一行 y(v)；
- 在同一行内，横向坐标是线性对应的。

记 D_b = y_bot − vy，D_t = y_top − vy，HS = 0.75W：

- y(v) = vy + 1 / ( 1/D_b + (1 − v/(h−1)) · (1/D_t − 1/D_b) )
- x(u, v) = vx + HS · (y(v) − vy)/D_b · (2u/(w−1) − 1)

也就是 x(u, v) = x0(v) + u·dx(v)，其中：
- x0(v) = vx − HS·s(v)
- dx(v) = 2·HS·s(v)/(w−1)
- s(v) = (y(v) − vy)/D_b

因此不需要逐像素做单应除法，只要一张 h=400 行的行表 {y(v), x0(v), dx(v)}：
- y(v) 取整数；
- x0 用 Q12.4 定点；
- dx 用 Q4.12 定点；
- 合计约 400×6 字节。

行表在 CAL_SEQ 或 LIVE_VP 变化时重算：由 RK 算好后经 BAR 窗口写入 BRAM，或由 FPGA 内一个小状态机用串行除法器算出，每行一次倒数，400 行约 20 us。

**已验证（10-18）**：取 4 组 VP / y_bot（(880,715,1052)、(1203,607,942)、(917,739,971)、(632,576,971)），在全部 400×400 个鸟瞰图像素上，与 cv2.getPerspectiveTransform 的逆变换结果比对，最大误差 4.8e-4 px，只是浮点舍入。远端一行原图最多对应 4.8–8.2 行鸟瞰图。

### 5.2 数据通路

1. **生成鸟瞰图**：输入帧已在 DDR3 中，按 v=0..399 读出图像行 y(v) 的 [x0(v), x0(v)+w·dx(v)] 一段，做横向线性插值，得到 400 个像素（BGR 转灰度、H、S 在读出后计算）。
   - 远端一行原图会对应多行鸟瞰图：112507 的 VP 下最多约 8 行，所以不宜按原图光栅流水线直通，应从 DDR3 按行随机读，读带宽 < 1 MB/帧。
2. **提取脊线**：G(u) − max(G(u−6), G(u+6)) ≥ 18 且 G ≥ 120；再按 S、H 阈值分为白线、黄线。逐行流水处理，只需 13 像素的移位寄存器。
3. **列直方图**：400 个 9 位计数器，按帧累加。
4. **送往 RK**：两张 400×400 的 1 位掩膜（白线、黄线）和列直方图，合计约 41 KB/帧，用 DMA-W 送到 RK 预留内存，30 fps 时约 1.2 MB/s，相对于已实测的 896 MB/s 可以忽略。
5. **RK 端（C 语言移植参考算法）**：
   - 成对选线；
   - 滑窗跟踪和直线拟合；
   - 最长连续段判断虚实，1 s 时间窗多数表决；
   - 判断黄线、双黄线；
   - VP 自校正（限幅）。
   - 结果写回 BAR0 0x020（左右线型、偏移），以及两条线在原图中的端点，供 OSD 画线用。PC 上参考实现每帧约 4 ms，C 移植到 A55 后预计 1–2 ms，待实测。
6. **FPGA 判决**：用 0x020 的线型和 KEY2/KEY3 的请求做变道判决（允许 / 保持 / 报警），点亮 LED0–LED3。

这样划分的理由：
- 逐像素、规则的部分（变换、脊线、直方图）放在 FPGA，体现基础任务③"基于 FPGA 的感知"；
- 逻辑分支多、数据量很小的部分（选线、分类、跟踪）放在 RK，开发和调参都快；
- 两边以 PCIe 交换，也正好体现软硬协同。

## 6 验收

1. **离线**：用 `tools/ref_algo/vp_measure.py` 从清晰的车道线帧测得每段视频的准确 VP，作为"操作员标定值"跑完整评测，与自动标定对比。结果见 §7，待补。
2. **行表公式**：Python 中闭式行表与 cv2 单应结果逐像素一致（≤ 0.5 px）。
3. **RTL 仿真**：取一帧测试图，鸟瞰图的灰度和掩膜与 Python 参考逐像素比对；掩膜允许插值舍入造成的 ≤ 1% 差异。
4. **上板**：
   - 进入 / 退出标定模式、连发加速、30 s 超时退出；
   - 寄存器读回与 CAL_SEQ 自增；
   - RK 暂停播放；
   - 鸟瞰小窗实时显示；
   - 操作员对准一段视频的耗时 ≤ 15 s。

## 7 离线评测结果（10-18）

### 7.1 各段视频的消失点测量

测量方法：用 `tools/ref_algo/vp_measure.py`，取左右两条自车车道线都拟合良好的帧，把两条线映射回原图求交点，取中位数后迭代。

| 视频 | 时间窗 | 测得 VP | 稳定性 | 评测采用 |
|---|---|---|---|---|
| 112507 | 2–9 s | (876–889, 714–717) | 4 轮摆动 ±7 px，交点四分位距约 30 px | (880, 715) |
| 113343 | 0–8 s | (917, 739) | 2 轮收敛 | (917, 739) |
| 113452 | 0–8 s | 第 1 轮 (835, 674)，之后持续向上漂 | 不收敛：右边界是绿化带路缘，不是车道线；手持俯仰角一直在变 | 第 1 轮值 |
| 113539 | 0–10 s | 第 1 轮 (1203, 607)，之后向上漂 | 不收敛 | 第 1 轮值 |
| 113421 | 0–6 s | 第 1 轮 (950, 715) | 不收敛 | 第 1 轮值 |
| 112739 | 15–30 s | 退化，结果不可用 | 路面带只有约 60 行，太窄 | 沿用自动值（这段没有车道线用例） |

手持视频的消失点本身会随时间漂移，"一段视频一个准确 VP"只能是近似。这也说明，标定之后仍然需要限幅自校正。

### 7.2 模拟操作员标定的评测

| 运行 | VP | 路面带下沿 y_bot | 车道线逐帧 | LANE 用例 | 112507 / 113343 / 113539 逐帧 |
|---|---|---|---|---|---|
| H_pair（自动，当前默认） | 霍夫自动值 + 限幅自校正 | 霍夫自动值 | 71.2% | 17/32 | 86.6% / 58.6% / 51.9% |
| I_cal | 测得值 + 限幅自校正 | 人工目测（偏保守、偏高） | 62.2% | 10/32 | 70.5% / 47.5% / 52.6% |
| J_cal | 测得值 + 限幅自校正 | 霍夫自动值 | 70.1% | 17/32 | 86.8% / 47.5% / 52.6% |

结论：
1. **y_bot 必须尽量低**，紧贴仪表台或引擎盖上沿。把最近的一段路面切掉，代价很大（112507 从 87% 掉到 70%）。所以 §3.2 中黄色水平线的操作要求改为"对准可见路面的最低一行"，自动值作为初值。
2. **在当前真值下，准确的 VP 没有带来提升。**
   - 113343 用测得的 VP 反而更差。从画面看，车更可能在中间车道，真值标的"左侧黄实线"很可能是错的：VP 准了以后，算法找到的是真实的左右虚线，反而与错误的真值不一致。
   - 113539 的 37–47 s 是车越过双黄线超车的片段，真值有歧义。
   - 所以眼下车道线成绩的瓶颈是**真值质量**，需要先核对。
3. 按键标定的价值主要在于**未知视频上的鲁棒性**：自动标定在 7 段官方视频中有 3–4 段偏差超过 100 px，现场 U 盘视频的取景无法预知，按键标定可以兜底。
