Zdy-1110/FPGA-676/docs/提交文档_整体架构.md

# 2026 嵌赛紫光同创杯选题三 · 提交文档整体架构

> **版本**：v1.0（2026-11-03）  
> **依据**：`contest_pymupdf.txt:362-466`（选题三指南）；现行工程事实以 cam18（`0x838 = 0x20261101`）为准  
> **适用范围**：初赛/决赛提交包中的技术文档、其派生产物及配套交付物  
> **提交范围**：内部架构说明，不随源码包/提交包提交；文中引用的 cam11 旧数据仅用于标注废止原因  
> **本文档的定位**：提交文档的“顶层设计图”，规定文档族分工、章节树、赛题条款落点、事实口径与验收规则；不替代正文写作。

---

## 0. 结论摘要

1. **一个事实源，两份母稿，四种渲染产物**：`docs/技术文档_最终稿.md` 是唯一完整事实母稿；`docs/提交文档_初稿.md` 是评审版派生母稿，只允许删减、重排和改写，不允许新增数字或结论。两份母稿各自生成 DOCX/PDF，共四种渲染产物。
2. **主文档按“评委评分维度”分五部分**：总览与符合性 → 系统架构设计 → 资源占用与性能测试 → 测试方式与现场演示 → 工程规范与交付；共 **12 章 + 4 个附录**。
3. **评审版正文目标 29–36 页，附录 9–10 页，合计 38–46 页**；完整版 65–75 页，作为支撑材料随源码包或附件提交。
4. **提交前必须重建并核对**：现有 DOCX/PDF 均早于 Markdown 源；文档内页数口径已根据重建后的 PDF 统一更新为：完整版实测 77 页、评审版实测 29 页。
5. **赛题的四个分析报告硬指标各有独立落点**：系统架构设计（第 2–3 章）、软硬协同数据流分析（第 4 章）、资源占用（第 6 章）、性能测试报告（第 7 章）；代码规范独立成第 9 章。

### 0.1 方案取舍

| 方案 | 优点 | 风险 | 结论 |
| :--- | :--- | :--- | :--- |
| 单一大文档（70+ 页） | 一次提交、无版本分叉 | 评委阅读负担重，核心亮点容易被淹没 | 不采用 |
| 只交评审版（20–30 页） | 紧凑、易读 | 代码规范、复现细节不足，难支撑“完整技术文档” | 不采用 |
| **评审版 + 完整版（本方案）** | 5 分钟能看懂，30 分钟能复核 | 两版可能漂移 | **采用**；用单一事实源 + 派生规则约束 |

---

## 一、赛题对提交文档的硬性要求

### 1.1 提交材料四件套 + 现场评测

赛题指南在“参赛注意事项”中明确要求提交完整技术文档（含核心亮点预览）、硬件实物、1080P 演示视频（3 分钟以内）及打包工程源码；现场用 U 盘提供测试场景。

| # | 赛题要求 | 原文位置 | 本项目交付物 | 状态 | 验收要点 |
| :---: | :--- | :--- | :--- | :---: | :--- |
| 1 | **技术文档（含核心亮点预览）** | `contest_pymupdf.txt:464` | `提交文档_评审版.pdf` + `技术报告_完整版.pdf` | 已有母稿，待重构/重建 | 摘要前 2 页可独立阅读；四类分析齐全 |
| 2 | **硬件实物** | `contest_pymupdf.txt:464` | 盘古 100Pro+ + OK3568-C + 摄像头 + HDMI 屏 | 已有 | 冷启动可演示；覆盖四种测试方式 |
| 3 | **1080P 演示视频（≤3 min）** | `contest_pymupdf.txt:464-465` | `dist/demo_video_1080p.mp4` | **待录制** | 1920×1080、≤180 s、字幕与讲解 |
| 4 | **打包工程源码** | `contest_pymupdf.txt:465` | `dist/nesai2026_src_20261101.zip` | 已有 | 598 条目、MANIFEST、SHA256 |
| 5 | **现场 U 盘评测** | `contest_pymupdf.txt:466` | `dist/demo_udisk/` | 已有素材，待上板确认 | FAT32/exFAT、中文名、四类场景 |

源码包现状（已核验）：598 个条目（597 文件 + `MANIFEST.txt`），40,768,424 字节，SHA256 `84023a3a7272a92436d20e405743c0278e358ab7b62fcc0af01d83025a752beb`。

### 1.2 技术文档的两个评分维度

| 评分维度 | 赛题原文关键词 | 文档必须回答的问题 | 目标落点 |
| :--- | :--- | :--- | :--- |
| **代码规范** | Verilog/C 模块化程度高、时序约束合理、注释完整、无明显时序违例（`contest_pymupdf.txt:441-445`） | 代码如何分层？模块边界在哪？约束如何建立？质量门槛是什么？ | 第 9 章 |
| **分析报告 · 系统架构设计** | 提交详细的系统架构设计（`contest_pymupdf.txt:446-450`） | 系统分几层？软硬如何分工？FPGA 内部有哪些核？接口契约是什么？ | 第 2–3 章 |
| **分析报告 · 软硬协同数据流分析** | 软硬协同数据流分析（同上） | 数据从传感器到显示怎么走？零拷贝在哪几段？带宽/时延多少？ | 第 4 章 |
| **分析报告 · 资源占用** | 资源占用（同上） | LUT/FF/DRM/APM 用了多少？时序是否收敛？瓶颈在哪？ | 第 6 章 |
| **分析报告 · 性能测试报告** | 性能测试报告（同上） | 在什么环境、用什么方法、测出什么数、如何复现？ | 第 7 章 |

### 1.3 任务与测评条款清单

| 类别 | 条款 | 原文位置 |
| :--- | :--- | :--- |
| 基础任务 | 图像采集与显示；软硬协同通信；图像处理与识别 | `contest_pymupdf.txt:376-384` |
| 高阶任务 | 多路图像采集与低延迟传输；复杂应用场景构建；AI 模型部署与实时识别 | `contest_pymupdf.txt:385-391` |
| 测评标准 1 | 多路视频拼接/融合；基础图像处理；整体延迟与实时帧率 | `contest_pymupdf.txt:408-413` |
| 测评标准 2 | 特定场景自主规划；AI/高效算法实时高精度识别；真实道路效果呈现 | `contest_pymupdf.txt:414-421` |
| 测试方式 | 十字路口；车道线/变道；带导航真实道路；特殊应急场景 | `contest_pymupdf.txt:423-438` |
| 工程与文档 | 工程实用性、时序把控、规范提交材料、U 盘评测 | `contest_pymupdf.txt:459-466` |

### 1.4 评委最可能按顺序追问的九个问题

1. 这个作品解决什么问题？一句话亮点是什么？
2. 赛题每条基础/高阶任务，你们做到什么程度？
3. 系统分几层，FPGA 和 RK3568 各自负责什么？
4. FPGA 内部有哪些加速核，流水线如何组织？
5. 四路视频如何零拷贝进 FPGA，带宽和时延各是多少？
6. RK3568 上模型、算法、决策状态机如何工作？
7. 资源和时序是否收敛，瓶颈在哪？
8. 性能数据怎么测的，能否复现？
9. 现场四种测试方式怎么操作，边界和风险在哪？

主文档的章节顺序即按这九个问题展开，保证“从翻到第一页起就能顺着评委的思路走”。

---

## 二、交付物体系与文档族

### 2.1 提交包目录树（建议）

```text
提交包/
├─ 01_技术文档/
│  ├─ 提交文档_评审版_vX.Y.pdf        # 主提交文档（必交）
│  ├─ 提交文档_评审版_vX.Y.docx       # 可编辑版（可选）
│  └─ 技术报告_完整版_vX.Y.pdf        # 支撑材料（附件/源码包 docs/）
├─ 02_演示视频/
│  └─ demo_1080p_vX.mp4               # 1920×1080，≤180 s
├─ 03_工程源码/
│  ├─ nesai2026_src_YYYYMMDD.zip      # 含 MANIFEST.txt
│  └─ SHA256.txt
├─ 04_硬件实物/                        # 现场展示，不入包
└─ 05_现场U盘/
   └─ demo_udisk/                     # FAT32/exFAT，含中文说明
```

> 具体命名以赛区/组委会通知为准；上表只规定层级与角色，不锁定文件名。

### 2.2 文档族职责表

| 文件 | 角色 | 读者 | 随包提交 | 维护规则 |
| :--- | :--- | :--- | :---: | :--- |
| `docs/技术文档_最终稿.md` | **完整版母稿（唯一事实母稿）** | 评委/技术复核 | 是（PDF） | 所有新事实先入此稿 |
| `docs/提交文档_初稿.md` | **评审版母稿（派生稿）** | 评委 | 是（PDF） | 只删减/重排/改写，不新增数字与结论 |
| `docs/技术文档_最终稿.docx` / `docs/技术文档_最终稿.pdf` | 完整版渲染产物 | 评委 | 是 | 由脚本生成，禁止手改 |
| `docs/提交文档_初稿.docx` | 评审版渲染产物 | 评委 | 是 | 由脚本生成，禁止手改 |
| `docs/submit/README.md` | 源码包总览与 Quick Start | 评委/开发者 | 是 | 与源码、位流同步 |
| `docs/submit/BUILD.md` | 构建说明 | 开发者/评委 | 是 | 命令必须可执行 |
| `docs/submit/DEPLOY.md` | 部署说明 | 开发者/评委 | 是 | 与板端脚本同步 |
| `docs/submit/THIRD_PARTY.md` | 第三方依赖与许可 | 评委 | 是 | 新增依赖时更新 |
| `docs/演示视频_分镜.md` | 视频脚本 | 团队 | 否 | 录制后回填实际时长/文件 |
| `docs/演示现场运行手册.md` | 现场操作手册 | 团队 | 否 | 与第 8 章操作步骤一致 |
| `docs/答辩要点_评委问答.md` | 答辩准备 | 团队 | 否 | 与正文口径一致 |
| `docs/提交清单与待办.md` | 项目管理 | 团队 | 否 | 不作为评审依据 |
| `docs/技术文档_大纲.md` | 历史大纲（cam11 口径） | 团队 | 否 | **标注“已废止”** |
| `docs/技术文档_草稿.md` | 历史草稿（cam11 口径） | 团队 | 否 | **标注“已废止”** |
| `docs/最终稿_上篇.md` / `下篇.md` | 历史拆分稿（cam11 口径） | 团队 | 否 | **归档，不再维护** |

### 2.3 单一事实源规则

1. **数字只认三处**：`log/board_20261101/FACTS.md`、带日期的 evidence 日志、代码/约束文件的实际行号。
2. **改动顺序**：证据/FACTS → 完整版母稿 → 评审版派生稿 → 重建两份 PDF。禁止只在评审版里改数字。
3. **评审版不新增结论**：评审版出现的新结论，必须先补进完整版；否则删除或降级为“待验证”。
4. **每个量化指标带出处**：正文内联 `（来源：path:line）`，或统一指向附录 D 的证据索引。
5. **一份文档只讲一个版本**：提交口径固定为 cam18（`0x838 = 0x20261101`）；cam17（`0x20261029`）只作为 Flash 回退版本出现，且必须标注“回退”。

---

## 三、主提交文档章节架构

### 3.1 总体骨架

```text
前置（不编号）
├─ 封面：作品名 / 赛题 / 平台 / 队号 / 学校 / 指导教师 / 日期 / 版本
├─ 文档信息与修订记录
├─ 摘要：核心亮点预览（8 条，结论 + 数字 + 出处）+ 3–5 个关键词
├─ 目录
└─ 评审阅读路径（5 min / 15 min / 深度复核）

第一部分 总览与符合性            第 1 章
第二部分 系统架构设计            第 2–5 章
第三部分 资源占用与性能测试      第 6–7 章
第四部分 测试方式与现场演示      第 8 章
第五部分 工程规范与交付          第 9–12 章
附录 A–D
```

### 3.2 章节明细

| 章 | 必写内容 | 对应赛题 | 页数预算 | 关键图表 | 证据入口 |
| :--- | :--- | :--- | :---: | :--- | :--- |
| 前置 | 封面、修订记录、8 条亮点摘要 + 关键词、目录、阅读路径 | 技术文档含核心亮点预览 | 3 | 核心指标卡 | `log/board_20261101/FACTS.md` |
| **1 作品概述与赛题符合性** | 定位与边界、核心指标卡、基础 3 条 + 高阶 3 条对照、测评 6 条 + 测试 4 方式覆盖 | 基础 1–3、高阶 1–3、测评 1–2、测试 1–4 | 3 | 表 1-1 指标卡；表 1-2 任务对照；表 1-3 测评对照 | 完整版第 1 章 |
| **2 系统总体架构** | 设计哲学、软硬职责、硬件拓扑、PCIe/供电/机械、FPGA 模块、软件分层与启动 | 基础 1–2、系统架构设计 | 2–3 | 图 2-1 拓扑；图 2-2 启动流转；表 2-1 模块清单 | 完整版第 2–3 章、6.1 |
| **3 FPGA 片上加速系统** | 视频中枢/四宫格、车道线核、斑马线核、OSD、夜间增强、双目独立位流 | 基础 3、高阶 1–2、测评 1(1)(2) | 3–4 | 图 3-1 FPGA 流水线；表 3-1 寄存器契约 | 完整版第 4 章 |
| **4 软硬协同数据流** | 零拷贝 6 段、门铃 DMA、独立 Commit、带宽预算、时延分解 | 基础 2、高阶 1、测评 1(3) | 2–3 | 图 4-1 数据流；表 4-1 带宽；表 4-2 时延 | 完整版第 5 章 |
| **5 RK3568 软件栈与 ADAS 决策** | MPP/RGA、NPU 模型/量化/精度、`tl_det`、决策状态机、HMI/按键基线 | 基础 3、高阶 2–3、测评 2(2) | 3–4 | 表 5-1 NPU 精度；图 5-1 决策状态机 | 完整版第 6–7 章 |
| **6 资源占用与时序收敛** | LUT/FF/DRM/APM/时钟、STA、瓶颈判断 | 资源占用 | 2 | 表 6-1 资源；表 6-2 STA | 完整版 4.5 |
| **7 性能测试与验证体系** | 测试环境、五级验证、性能总表、复现结论、统计口径 | 性能测试报告 | 3–4 | 表 7-1 环境；表 7-2 性能总表；表 7-3 复现 | 完整版第 8–9 章 |
| **8 四项测试方式与现场演示** | 四场景机制/步骤/核验表、U 盘流程、风险预案 | 测试方式 1–4、工程实用性 | 3–4 | 表 8-1 现场核验；图 8-1 U 盘流程 | 完整版第 10 章、现场手册 |
| **9 代码规范与工程结构** | 仓库树、代码规模、模块化、时序约束、构建、0 warning/selftest | 代码规范 | 2 | 表 9-1 代码规模；表 9-2 质量门槛 | 评审版第 6 章 |
| **10 已知局限与工程边界** | 逐项边界、影响、后续计划 | 工程实用性/可信度 | 1–2 | 表 10-1 局限与影响 | 完整版第 11 章 |
| **11 创新点总结** | 8 条创新点，与摘要呼应 | 核心亮点 | 1 | — | 完整版第 12 章 |
| **12 提交材料与复现指引** | 材料清单、哈希、构建/部署命令、提交前检查 | 规范提交材料 | 1 | 表 12-1 清单 | 评审版第 8 章、`docs/submit/*` |
| **附录 A 寄存器映射** | BAR1 0x800–0xA2C 关键寄存器 | 可复现 | 3–4 | 表 A-1 | 完整版附录 A |
| **附录 B 验证复现记录** | 五级验证的命令、输入、结果 | 可复现 | 3 | 表 B-1 | 完整版附录 B |
| **附录 C 术语与缩写** | 统一术语表 | 可读性 | 1 | 表 C-1 | 完整版附录 C |
| **附录 D 指标证据索引** | 指标 → 文件:行/日志 | 可信度 | 2 | 表 D-1 | 评审版“关键指标溯源”迁移并扩展 |

> 页数为评审版预算；完整版不设上限，但同一章的内容必须能追溯到同一组证据。  
> 表中未逐条列出小节号；第 3.4 节迁移表里出现的 2.1、3.1 等编号为建议编号，写作时可微调，但同一事实只能出现在一个主小节。

### 3.3 阅读路径设计

| 路径 | 时间 | 阅读顺序 | 目的 |
| :--- | :---: | :--- | :--- |
| 快速评审 | 5 min | 摘要 → 表 1-2/1-3 → 表 7-2 → 第 10 章 → 表 12-1 | 判断“做了什么、做到什么程度、是否可信” |
| 标准评审 | 15 min | 再加第 2–4 章、第 8 章 | 判断架构合理性与现场可演示性 |
| 深度复核 | 30 min+ | 全文 + 附录 A/B/D | 核对资源、时序、性能与证据 |

### 3.4 与现有文档的章节迁移

| 现有章节 | 新落点 | 处理 |
| :--- | :--- | :--- |
| 完整版第 0 章 核心亮点预览 | 前置摘要 | 完整版保留 11 条；评审版选取 8 条（PCIe、零拷贝、时序资源、NPU、`tl_det`、车道线核、多视口 Commit、声光预警），数字与措辞与完整版一致 |
| 完整版第 1 章 赛题对照表 | 第 1 章 1.3/1.4 | 拆分并前置 |
| 完整版第 2 章 系统概述 | 第 2 章 2.1 | 原样迁移 |
| 完整版 2.3 系统主要设计指标 | 第 1 章 1.2 核心指标卡 | 前置到第 1 章 |
| 完整版第 3 章 硬件平台 | 第 2 章 2.2 | 原样迁移 |
| 完整版 4.1 视频中枢 | 第 3 章 3.1 | 原样迁移 |
| 完整版 4.2 车道线核 | 第 3 章 3.2 | 原样迁移 |
| 完整版 4.3 斑马线核 | 第 3 章 3.3 | 原样迁移 |
| 完整版 4.4 调试视图 + 4.6 OSD | 第 3 章 3.4 | 合并 |
| 完整版 4.5 资源与时序 | 第 6 章 | 独立成章 |
| 完整版 4.7 夜间增强 | 第 3 章 3.5 | 原样迁移 |
| 完整版 4.8 双目独立位流 | 第 3 章 3.6 | 原样迁移 |
| 完整版第 5 章 数据流 | 第 4 章 | 原样迁移 |
| 完整版 6.1–6.2 启动/界面 | 第 2 章 2.4 + 第 5 章 5.5 | 拆分 |
| 完整版 6.3–6.6 监控/按键/显存 | 第 5 章 5.5 + 第 3 章 3.1 | 拆分 |
| 完整版第 7 章 RK 软件栈 | 第 5 章 5.1–5.4 | 原样迁移 |
| 完整版第 8 章 性能总表 | 第 7 章 7.3 | 原样迁移 |
| 完整版第 9 章 验证体系 | 第 7 章 7.2 | 原样迁移 |
| 完整版第 10 章 测试方式 | 第 8 章 | 原样迁移 |
| 完整版第 11 章 局限性 | 第 10 章 | 原样迁移 |
| 完整版第 12 章 创新点 | 第 11 章 | 原样迁移 |
| 评审版第 6 章 代码规范 | 第 9 章 | 迁入完整版 |
| 评审版第 8 章 提交材料 | 第 12 章 | 迁入完整版 |
| 附录 A/B/C | 附录 A/B/C | 原样迁移 |
| 评审版附录 关键指标溯源 | 附录 D | 迁移并扩展 |

**结论：这是一次“重排 + 补两章 + 补一个附录”，不是重写。** 现有正文的绝大部分内容可以原样迁移。

---

## 四、赛题条款 → 章节映射矩阵

| 赛题条款 | 要求要点 | 目标落点 | 现状 | 处置 |
| :--- | :--- | :--- | :--- | :--- |
| 基础任务 1 | 摄像头/HDMI 输入输出，采集-处理-显示闭环 | 2.2、3.1、8.1 | 已有（完整版 2.2/4.1/10.1） | 迁移 |
| 基础任务 2 | MCU 与 FPGA 高速通信，数据交互与指令控制 | 2.2、4.1–4.2、7.3 | 已有（完整版 3.2/5） | 迁移 |
| 基础任务 3 | FPGA 道路环境监测与特定场景感知 | 3.2–3.4、5.3 | 已有（完整版 4.2–4.4/7.3） | 迁移 |
| 高阶任务 1 | ≥4 路并行采集与低延迟传输，带宽优化 | 3.1、4.3、7.3 | 已有（完整版 4.1/5.2/8） | 迁移 |
| 高阶任务 2 | 夜间道路、复杂路口的完整感知与避障 | 3.5、5.4、8.1、8.4、10 | 部分完成（完整版 4.7/7.4/10/11） | 保留“部分完成”口径 |
| 高阶任务 3 | MCU 端轻量 AI 模型、多路实时识别与自主规划 | 5.2–5.4、8.3、10 | 部分完成（完整版 7.1–7.4/10.3/11.3） | 保留边界说明 |
| 测评标准 1(1) | 多路视频拼接/融合，模拟全景影像 | 3.1 | 已有（完整版 4.1） | 迁移 |
| 测评标准 1(2) | 灰度化、去噪、二值化、色彩空间转换 | 3.1、3.4 | 已有（完整版 4.4） | 迁移 |
| 测评标准 1(3) | 整体处理延迟与实时帧率 | 4.4、7.3、10 | 部分完成（整链延迟未实测） | 明确“分段实测/整链待测” |
| 测评标准 2(1) | 强光、夜间、复杂路口的自主规划 | 3.5、5.4、8.1、10 | 部分完成（完整版 4.7/10/11） | 保留边界说明 |
| 测评标准 2(2) | AI/高效算法实时处理，准确率高、延迟低 | 5.2–5.3、7.3 | 已有（完整版 7.2–7.3/8） | 迁移 |
| 测评标准 2(3) | 真实道路效果模拟与呈现 | 3.4、8 | 已有（完整版 4.6/6.3） | 迁移 |
| 测试方式 (1) | 十字路口：红停绿行、闯红灯报警、箭头/LED、按键 | 8.1 | 已有（完整版 10.1） | 迁移 |
| 测试方式 (2) | 虚实线变道、强制变道报警、按键模拟转向 | 8.2 | 已有（完整版 10.2） | 迁移 |
| 测试方式 (3) | 带导航真实道路视频模拟智驾 | 8.3、10 | 部分完成（路线文件驱动，小地图未上板） | 保留边界说明 |
| 测试方式 (4) | 行人/路障/车辆等特殊应急场景 | 8.4 | 部分完成（车辆/路障正向触发未上板验证） | 保留边界说明 |
| 文档 · 代码规范 | 模块化、时序约束、注释完整、无时序违例 | 第 9 章 | **仅在评审版第 6 章** | 迁入完整版并补齐 |
| 文档 · 分析报告-架构 | 系统架构设计 | 第 2–3 章 | 已有（完整版 2–4） | 迁移 |
| 文档 · 分析报告-数据流 | 软硬协同数据流分析 | 第 4 章 | 已有（完整版 5） | 迁移 |
| 文档 · 分析报告-资源 | 资源占用 | 第 6 章 | 已有（完整版 4.5） | 独立成章 |
| 文档 · 分析报告-性能 | 性能测试报告 | 第 7 章 | 已有（完整版 8–9） | 迁移 |
| 提交 · 技术文档 | 含核心亮点预览 | 前置摘要 | 已有（完整版第 0 章） | 压缩为 8 条 |
| 提交 · 演示视频 | 1080P、≤3 min | 第 12 章 + 分镜 | **待录制** | 按分镜录制 |
| 提交 · 工程源码 | 打包源码、可构建 | 第 12 章 + `docs/submit/*` | 已有（598 条目） | 重建后更新哈希 |
| 提交 · 硬件实物 | 可现场演示 | 2.2 + 第 12 章 | 已有 | 补实物照片 |
| 现场 · U 盘评测 | 现场场景、中文界面 | 8.5 + 第 12 章 | 已有素材 | 上板确认 FAT32/exFAT |

---

## 五、现有文档盘点与差距

### 5.1 文档盘点

| 文件 | 角色/状态 | 主要问题 | 处置 |
| :--- | :--- | :--- | :--- |
| `docs/技术文档_最终稿.md` | 完整版母稿，13 章 + 3 附录，164 KB | 无独立“代码规范”章；无“提交材料”章；页数声明散落 | 保留为唯一事实母稿；补第 9/12 章 |
| `docs/技术文档_最终稿.docx` / `docs/技术文档_最终稿.pdf` | 渲染产物，PDF 实测 77 页 | 2026-11-03 重建对齐 | 已完成重建 |
| `docs/提交文档_初稿.md` | 评审版母稿，10 章 + 附录 | 补充目录与附录；页数口径已修正为 77/29 页 | 已对齐架构 |
| `docs/提交文档_初稿.docx` / `docs/提交文档_初稿.pdf` | 渲染产物，PDF 实测 29 页 | 2026-11-03 重建对齐 | 已完成重建 |
| `docs/技术文档_大纲.md` | 历史大纲，cam11 口径 | 数据过时（WNS +0.340 ns、LUT 40.0%） | 归档并标注“已废止” |
| `docs/技术文档_草稿.md` | 历史草稿，cam11 口径 | 数据过时 | 归档 |
| `docs/最终稿_上篇.md` / `下篇.md` | cam11 口径拆分稿 | 与完整版漂移 | 归档，不再维护 |
| `docs/附录A_寄存器映射.md` / `docs/附录B_验证复现.md` / `docs/附录C_术语与缩写.md` | 已并入完整版的片段源 | 存在两份来源 | 保留为源文件，或归档 |
| `docs/submit/*.md` | 源码包文档 | 数字需与主文档对齐 | 保留，纳入一致性检查 |
| `docs/演示视频_分镜.md` | 2:54 分镜脚本 | 视频未录 | 保留，录制后回填 |
| `docs/演示现场运行手册.md` | 现场操作手册 | 与第 8 章有重复 | 保留为内部手册，正文引用 |
| `docs/答辩要点_评委问答.md` | 22 问答辩准备 | 内部材料 | 保留 |
| `docs/提交清单与待办.md` | 项目管理 | 含历史 61 页记录 | 保留，当前口径以 71 页为准 |

### 5.2 必须修复项

其中 **1–6、10 为提交阻断项**（不修就不能提交或会被直接扣分）；**7–9、11–12 为质量改进项**（影响评审体验与可信度，建议一并处理）。

| # | 问题 | 证据 | 影响 | 处置 |
| :---: | :--- | :--- | :--- | :--- |
| 1 | 文档内写“61 页技术报告”，实测 PDF 77 页 | `docs/提交文档_初稿.md:20,360`；`docs/技术文档_最终稿.pdf` 实测 77 页 | 评委一翻即发现口径不符 | 改为重建后的实测页数 (77 页) |
| 2 | 文档内写“提交文档 19 页”，实测 29 页 | `docs/提交文档_初稿.md:359`；DOCX 转 PDF 实测 29 页 | 同上 | 改为实测页数 (29 页) |
| 3 | DOCX/PDF 早于 Markdown 源 | `docs/技术文档_最终稿.docx` 11-01 08:41 vs md 11-02 17:03；`docs/提交文档_初稿.docx` 11-01 08:42 vs md 11-03 00:02 | 提交件不含最新修正 | 提交前重建 |
| 4 | 大纲/上篇/下篇仍是 cam11 数据 | `docs/技术文档_大纲.md:16,113`；`docs/最终稿_上篇.md:15` | 误引旧数据 | 归档并标注“已废止” |
| 5 | 完整版缺独立“代码规范”章 | 无独立章节；仅第 1 章对照表有概括性表述 | 赛题硬指标无落点 | 新增第 9 章（从评审版第 6 章迁入） |
| 6 | 完整版缺“提交材料清单”章 | 全文无材料清单 | 交付物清单缺失 | 新增第 12 章（从评审版第 8 章迁入） |
| 7 | “四类测试”与“五级验证”口径不一 | `docs/提交文档_初稿.md:205`；`docs/技术文档_最终稿.md:807` | 方法体系看起来像两套 | 统一为“五级验证”；评审版压缩为四类并注明对应关系 |
| 8 | 核心亮点 8 条 vs 11 条，且两组不是简单包含关系 | `docs/提交文档_初稿.md:49-60`；`docs/技术文档_最终稿.md:43-55` | 摘要口径不一致 | 固定评审版 8 条选取清单；每条数字与措辞回完整版核对 |
| 9 | 评审版缺前置与术语附录，证据索引仅为简表 | 结构缺口 | 评审体验与可追溯性不足 | 补封面、修订记录、目录、附录 C；把现有溯源表扩展为附录 D |
| 10 | 演示视频未录制 | `docs/提交清单与待办.md:59` | 必交材料缺失 | 按分镜录制 1080P、≤3 min |
| 11 | 文件名仍叫“初稿” | `docs/提交文档_初稿.*` | 不像正式提交件 | 改名为“提交文档_评审版” |
| 12 | 系统整机/双板实物照片缺失 | 评审版有 `photo_st2c.jpg`（双目独立位流上板），但无整机照片 | “工程实用性”证据不足 | 第 2 章或第 12 章补双板 + 摄像头 + 显示器实物照片 |

---

## 六、写作与一致性规则

### 6.1 版本与事实口径

- 提交口径固定为 **cam18**：位流 `D:/pango_work/quad/out/quad_cam18.sbit`，版本寄存器 `0x838 = 0x20261101`。
- cam17（`0x20261029`）只作为 Flash 回退版本出现，且必须标注“回退”，不得与 cam18 指标混写。
- 所有性能数字必须能追溯到 `log/board_20261101/FACTS.md`、带日期的 evidence 日志或代码行号。
- 禁止把“模型级/仿真级/门级/板级”的数据混在同一个“实测”口径下；每张表必须写清测量层级。

### 6.2 状态用语

| 用语 | 含义 | 使用条件 |
| :--- | :--- | :--- |
| **完成** | 已在板端或全量数据集上验证，且有证据 | 有日志/回读/复现命令 |
| **部分完成** | 主体功能可用，但存在明确未验证项 | 必须同时写出未验证项 |
| **未实现** | 仅有方案或离线原型 | 不得写成“完成” |
| **待录制/待上板/待标定** | 交付物或验证动作尚未完成 | 放入第 10 章或第 12 章检查清单 |

### 6.3 图表与编号

- 图/表统一“章号-序号”：图 2-1、表 7-2；附录用 A-1、B-1。
- 每张图表必须在正文出现引导句，禁止悬空图表。
- 表格首行跨页重复；4 列以上表格用 9–10 pt 字号（构建脚本已支持 `--compact`）。
- 关键指标表统一列：指标项 / 实测值 / 测量条件 / 证据出处。

### 6.4 语言与禁词

- 统一使用“本系统”“本设计”，避免“我们”与“笔者”混用。
- 禁用无法核实的绝对化表述：首创、业内首次、独创、颠覆、彻底归零、100% 可靠、零风险等。
- 边界说明使用“当前未验证/未实测/未上板”，不用“暂不涉及”淡化。
- 单位统一：MB/s、ms、µs、ns、MHz、GT/s、0x 十六进制、×（不用 x）。

### 6.5 构建与版本记录

- 母稿：Markdown；渲染：`python tools/docs_figs/build_doc.py --md <md> --docx <docx> [--compact]`。
- 每次提交构建后记录：版本号、日期、git commit、位流 MD5、PDF 页数、源码包 SHA256。
- 页数以最终提交的 PDF 为准；本项目用 LibreOffice 转换，DOCX 在 Word 中分页可能相差 1–2 页。
- DOCX/PDF 不纳入人工修改；所有改动回到 Markdown。

---

## 七、提交前验收清单

- [ ] 完整版母稿补第 9 章（代码规范）、第 12 章（提交材料），并重建 PDF。
- [ ] 评审版补封面、修订记录、目录、附录 C/D，并重建 PDF。
- [x] 两份 PDF 的实测页数与文档内声明一致（最新实测：完整版 77 页、评审版 29 页）。
- [ ] 全文检索并清除 cam11 旧数据（`+0.340 ns`、`LUT 40.0%`、`cam11`）。
- [ ] 全文检索“61 页”“19 页”等旧页数口径。
- [ ] 评审版 8 条核心亮点均能在完整版找到对应条目，数字与措辞一致。
- [ ] 每张性能表都有“测量层级 + 证据出处”两列。
- [ ] 附录 D 的每条路径/行号真实存在（可用脚本校验）。
- [ ] `python tools/selftest.py` 全量 PASS。
- [ ] 源码包重建后更新 MANIFEST 与 SHA256，并回填第 12 章。
- [ ] 演示视频 1920×1080、≤180 s、字幕可读。
- [ ] U 盘在 FAT32 与 exFAT 下均能挂载，中文文件名正常。
- [ ] 硬件冷启动顺序复核：先 FPGA 就绪，后 RK3568 上电。
- [ ] 封面队号/学校/指导教师/日期/版本填写完整。

---

## 附录：架构总览图

```text
                    ┌──────────────────────────────┐
                    │  事实源：FACTS / 证据日志 / 代码  │
                    └──────────────┬───────────────┘
                                   │
                 ┌─────────────────┴─────────────────┐
                 │                                   │
        ┌────────▼────────┐                 ┌────────▼────────┐
        │ 完整版母稿       │                 │ 评审版母稿       │
        │ 技术文档_最终稿  │ ──删减/重排──► │ 提交文档_评审版  │
        │ 12 章 + 4 附录   │                 │ 12 章 + 4 附录   │
        └────────┬────────┘                 └────────┬────────┘
                 │                                   │
        ┌────────▼────────┐                 ┌────────▼────────┐
        │ DOCX / PDF      │                 │ DOCX / PDF      │
        │ 65–75 页        │                 │ 29–36 页 + 附录 │
        └────────┬────────┘                 └────────┬────────┘
                 │                                   │
                 └─────────────────┬─────────────────┘
                                   │
                    ┌──────────────▼───────────────┐
                    │ 提交包：文档 + 视频 + 源码 + 实物 + U 盘 │
                    └──────────────────────────────┘
```

---

*本文档只规定架构与规则；具体章节内容以 `docs/技术文档_最终稿.md` 和 `docs/提交文档_初稿.md` 为准，数字以 `log/board_20261101/FACTS.md` 与 evidence 日志为准。*
