Zdy-1110/FPGA-676/docs/最终稿_上篇.md

# 2026 嵌赛紫光同创杯选题三：基于 FPGA+RK3568 软硬协同的高性能车载 ADAS 系统设计技术报告（上篇）

> **项目名称**：基于紫光同创 PG2L100H 与瑞芯微 RK3568 异构架构的车载高级驾驶辅助系统 (ADAS)  
> **参赛赛题**：2026 全国大学生嵌入式芯片与系统设计竞赛——紫光同创杯 选题三  
> **硬件平台**：紫光同创盘古 100Pro+ (PG2L100H-6FBG676) + 飞凌嵌入式 OK3568-C (RK3568)  
> **编制基准**：实测工程日志与软硬件代码事实对齐稿（上篇：第零章至第六章）  
> **编制日期**：2026-10-30  

---

## 第零章 核心亮点预览

1. **工业级高可靠 PCIe 异构高速互联通道**：打通盘古 100Pro+ 插接 OK3568 P29 槽位的 PCIe Gen2 ×2 链路，实测板卡到主机长传输吞吐达 896 MB/s，主机到板卡传输峰值达 861 MB/s；在 5 分钟 485 轮双向交替压力测试中取得 0 校验错误，高级错误报告（AER）与可靠性可用性可维护性未纠正错误（RAS DES）计数恒为 0（出处：`PCIe_DMA提速_20261018.md:200-201`）。
2. **端到端纯硬件零拷贝多路视频中枢**：构建“MPP 硬解 $\rightarrow$ RGA 派生 $\rightarrow$ 门铃 DMA $\rightarrow$ FPGA DDR3 $\rightarrow$ 四宫格排版 $\rightarrow$ HDMI”流水线，四路 960×540@30fps 并发推流在 RGB888 格式下总带宽为 186.6 MB/s（占 861 MB/s 实测峰值的 21.7%），全 RGB565 格式下仅占用 124.4 MB/s（总线负载 14.5%），全 NV12 格式下仅占用 93.3 MB/s（总线负载 10.8%），CPU 拷贝与画面撕裂开销彻底归零（出处：`PCIe_DMA提速_20261018.md:204`）。
3. **纳秒级时序收敛与高紧凑片上资源平衡**：最新 cam11 固件在集成车道线核、斑马线核与多路视频集线器满载工况下，全局建立时间最差裕量 WNS 为 +0.340 ns（148.5 MHz `pix_clk` 域），总负余量 TNS 严格为 0.000 ns；片上逻辑资源高效利用，LUT 占用 26,645/66,600（40.0%）、FF 占用 25,730/133,200（19.3%）、DRM 占用 99/155（63.8%）、APM 占用 61/240（25.4%）（出处：`build_cam11_s1.log:20529,20551-20577`）。
4. **NPU 深度量化与频点极限能效调优**：部署 960×320 车载带状视野定制 YOLOv6n INT8 模型（`b5_v6n_band.rknn`），运行于 900 MHz 频点时单帧推理耗时中位数降至 17.55 ms（较 600 MHz 频点的 20.14 ms 下降 12.9%）；5 分钟浸泡压力测试中片上温度稳定在 46.7–48.3 °C，总线欠载计数器 `0x82C` 恒为 0（出处：`log/npu_freq_20261029.md:21, 27-29`）。
5. **零依赖极低开销纯 C 交通信号灯引擎**：脱离 OpenCV 等重型视觉库，纯 C99 实现 `tl_det` 单帧运算 0 动态内存分配（0 malloc）；在 7 段官方评测视频共 2678 帧全量数据集上实现检测级 RAW 2678/2678（100.00%）逐帧对齐、滤波后独立运行 SIG 2603/2678（97.20%）对齐，官方 SIG 用例通过数达 63/69（91.3%），算法单帧耗时仅 4–6 ms（WSL x86 PC 基准）（出处：`tools/adas/host_test/report.md:33, 52, 67, 77`）。
6. **单遍光栅流式车道线硬件加速核**：提出无整帧行缓存的在线定点最小二乘与 EMA 平滑滤波硬件流水线 `rt_lane_det`，在 5 组基准向量集仿真中实现逐行比对全部通过（row_mismatch=0）并严密核验 12 个关键字段，门级网表后仿真跑通真实路面采样的 42 帧时序反标核验（出处：`log/lane_fpga/vectors/README.md:13`）。
7. **嵌入式人机交互与全功能多模式启动系统**：自主开发轻量级中文图形用户界面（GUI）与 26×26 GBK 点阵字库引擎，实现开机二选一启动器、四宫格实时推流、U 盘中文文件名显示与播放参数浮窗调节，全系统脱离外接键鼠纯靠板载 5 物理按键闭环控制（已实现，上板验证项见第十一章）（出处：`tools/menu/mode_select.c:388`，`tools/menu/usb_menu.c:1461`）。
8. **亚毫秒级声光安全预警闭环响应**：通过单个 32 位 MMIO 寄存器（`0x850`）实现单周期控制字映射（实测 0x0C 红停、0x10C 闯红灯爆闪、0x08 绿行），每个 4 KB 读请求往返约 1.8 µs，960×540 RGB565 一帧 FPGA 传输仅 1.2 ms；当视觉检出近距危险障碍物时即刻置位自车道红箭头与 bit8 报警标志，驱动屏幕全屏鲜红边框闪烁与声光告警（出处：`tools/usb_feed/adas.c:301-327`，`PCIe_DMA提速_20261018.md:200-204`）。

---

## 第一章 赛题任务与测评标准逐条对照表

系统严格对照 2026 年全国大学生嵌入式芯片与系统设计竞赛——紫光同创杯选题三指南各项技术条款进行设计开发。各项指标实现状态与证据索引见表 1-1。

#### 表 1-1：赛题任务与测评标准逐项达成对照表

| 赛题条款（原文关键词） | 状态 | 实现方式 | 证据位置 |
| :--- | :---: | :--- | :--- |
| **基础任务 1**：图像采集与显示（HDMI/摄像头输入，LCD/HDMI 输出，采集-处理-显示闭环，道路环境感知） | **完成** | 前向 FMC 摄像头/视频回放 + 3 路 UVC USB 摄像头并行输入；FPGA MS7210 芯片驱动 HDMI 1080P@60Hz 闭环输出。 | 第三章 §3.2、第四章 §4.1 |
| **基础任务 2**：软硬协同通信（MCU 与 FPGA 高速通信如 PCIe，数据交互与指令控制） | **完成** | 建立 OK3568 与盘古 100Pro+ 间的 PCIe Gen2 ×2 物理链路，实测 DMA 吞吐达 896 MB/s；MMIO 门铃触发与双向状态交互。 | 第三章 §3.2、第五章 §5.3 |
| **基础任务 3**：图像处理与识别（基于 FPGA 实现道路周围环境监测和特定场景感知） | **完成** | FPGA 片上部署单遍光栅流式车道线检测核 `rt_lane_det` 与斑马线核 `rt_zebra_det`，支持 DISP_CTRL 原彩/灰度/二值化滤镜硬件切换。 | 第四章 §4.2、§4.3、§4.4 |
| **高阶任务 1**：多路图像采集与低延迟传输（至少四路视频流并行采集与低延迟传输，优化数据流带宽） | **完成** | 支持四路 960×540@30fps 并发采集，总线负载仅 14.5%（RGB565）；FPGA 片上 DDR3 多通道仲裁 Hub 具备独立 Commit 异步帧同步机制。 | 第四章 §4.1、第五章 §5.2 |
| **高阶任务 2**：复杂应用场景构建（针对夜间道路、复杂路口构建完整感知和避障功能） | **部分** | 完成复杂十字路口红绿灯识别与车道线决策；检出近距危险障碍物触发红箭头与全屏爆闪告警；夜间微光自适应增强算法本期未集成。 | 第五章 §5.1、第七章、第十一章 |
| **高阶任务 3**：AI 模型部署与实时识别（MCU 部署轻量级 AI 模型，多路实时高精度低延迟识别与自主道路规划） | **部分** | RK3568 NPU 部署定制 YOLOv6n INT8 模型（`b5_v6n_band.rknn`），900 MHz 下单帧 17.55 ms；底层完成车道规划与转向提示，全局导航规划未开发。 | 第五章 §5.1、第七章、第十一章 |
| **测评标准 1(1)**：正确采集一路或多路视频，进行拼接或融合，模拟汽车全景影像 | **完成** | FPGA 硬件视频中枢实现四路 960×540 视频光栅实时拼接排版，合成 1920×1080@60Hz 四宫格全景监控画面。 | 第四章 §4.1、第六章 §6.6 |
| **测评标准 1(2)**：基础图像处理（灰度化、去噪、二值化、色彩空间转换等优化道路场景） | **完成** | FPGA 纯硬件流水线实现实时加权灰度化与路面标线二值化掩膜提取（DISP_CTRL 控制）；RGA 硬件完成 YUV/RGB 快速转换与缩放。 | 第四章 §4.4、第五章 §5.1 |
| **测评标准 1(3)**：系统整体处理延迟与实时帧率满足高级辅助驾驶低延迟需求 | **完成** | 硬件流水线处理延迟在像素时钟级别，PCIe 传输单帧 1.2 ms（960×540 RGB565），显示维持 60 fps 刷新。 | 第四章 §4.1、第五章 §5.3 |
| **测评标准 2(1)**：基于特定场景（如强光、夜间、复杂十字路口）完成道路自主规划 | **部分** | 复杂十字路口红绿灯识别率通过率达 91.3%，结合虚实车道线完成本车道通行规划；强光与夜间极端环境自适应算法未开发。 | 第四章 §4.2、第五章 §5.2 |
| **测评标准 2(2)**：利用 AI 模型或高效算法完成图像实时处理，识别准确率高且延迟低 | **完成** | YOLOv6n NPU 推理 17.55 ms，验证集 mAP50 达 66.05%；C99 交通灯算法耗时 4–6 ms，RAW 一致率 100.00%。 | 第零章、第五章 §5.1、§5.2 |
| **测评标准 2(3)**：更真实的道路效果模拟及呈现 | **完成** | 1080P 高清画面逐像素叠加 24×24 矢量转向箭头、16 组目标动态识别框、64 字符状态行与违规全屏边框爆闪。 | 第四章 §4.6、第六章 §6.3 |
| **测试方式 (1)**：十字路口场景（红灯停、绿灯行、红灯强行报警，箭头叠加，按键切换车道与启停） | **完成** | C99 `tl_det` 准确判定三向信号灯；KEY0 循环切车道、KEY1 切换行驶/停止；DECISION 寄存器控制 24×24 矢量箭头与全屏闪烁告警。 | 第四章 §4.6、第六章 §6.5 |
| **测试方式 (2)**：车道线与变道合规（虚线变道、实线直行、强制实线变道报警，按键模拟转向） | **完成** | `rt_lane_det` 实时提取线型；KEY2/KEY3 短按转向、长按强制变道；实线强制变道触发声光报警与指示红箭头。 | 第四章 §4.2、第六章 §6.5 |
| **测试方式 (3)**：带导航真实道路视频模拟智驾（根据导航完成模拟智驾功能） | **未实现** | 系统专注于底层机器视觉感知与行车规则决策，未开发内嵌导航小地图图标 OCR 解析算法，现场退化为常规道路监测演示。 | 第十章、第十一章 |
| **测试方式 (4)**：特殊应急场景（行人闯红灯刹车、障碍物等；现场评测用 U 盘提供场景） | **部分** | NPU 检出行人/骑行者/锥桶，近距危险触发自车道红箭头与 bit8 全屏爆闪；因无车载 CAN 卡与线控底盘，未连接物理刹车制动。 | 第零章、第六章 §6.4、第十章 |
| **提交要求与注意事项**：代码规范、分析报告、工程实用性实物、时序把控、提交材料、现场 U 盘评测 | **完成** | Verilog/C 模块化编码，STA 建立与保持全收敛（WNS=+0.340 ns）；双核心板刚性固定可演示；提供完备技术文档与 U 盘评测工具；静态图片输入已实现待上板验证。 | 全文、第六章 §6.4 |

---

## 第二章 系统概述与整体设计

### 2.1 系统定位与设计哲学
本系统面向智能网联汽车前装与准前装边缘感知应用场景，针对传统车载 ADAS 系统在多路高清并发输入下面临的“CPU 拷贝负荷过重、总线时延抖动不可控、端到端显示撕裂”等痛点，提出了基于紫光同创盘古 100Pro+（PG2L100H）FPGA 与瑞芯微 RK3568 SoC 异构协同的计算平台架构。

系统确立了“**控制走 MMIO，数据走零拷贝 DMA，显示走全硬件流水线**”的设计哲学：
1. **控制与管理解耦**：Linux 用户态程序通过 PCIe 内存映射 I/O（MMIO）读写 FPGA 内部寄存器，实现亚微秒级指令配置与毫秒级告警下发；
2. **高速流媒体数据直通**：多路视频在 SoC 侧经由硬件解码与图形缩放后，直接通过直接内存访问（DMA）注入 FPGA 板载显存，绕过操作系统虚拟内存二次搬移；
3. **显示渲染硬件接管**：多视口画面裁切、排版、四宫格拼接以及矢量图形与文字字符的屏幕显示（OSD）全部在 FPGA 硬件光栅流水线内单周期实时完成。

### 2.2 系统顶层协同架构
系统总体硬件互连与协同处理拓扑如图 2-1 所示。

```text
                                 图 2-1：系统总体硬件互连与协同拓扑框图
```
*(注：对应技术架构矢量图见 `figs/fig1_system.png`)*

系统的多传感器输入层由 1 路专用高速差分 FMC 接口（主前视/双目 CMOS 子卡）与 3 路工业级 UVC USB 摄像头（覆盖左后视、右后视及车内视角）组成。在数据流向上一句话概括为：**外部视频流经 SoC 硬件解码与 RGA 零拷贝预处理后，通过 PCIe DMA 门铃直推至 FPGA DDR3 帧存，由 FPGA 硬件流水线在行扫描时单周期完成四宫格无撕裂拼接与多图层 OSD 告警叠加，并经 HDMI 1080P@60Hz 实时输出。**

四宫格画面布局定义如下：
- **视口 0（Slot 0，左上角）**：主前视道路视角，分辨率 960×540，采用 RGB565 格式（单帧占用 1,036,800 字节），承载硬件流式车道线与斑马线检测，支持图像原彩/灰度/二值化效果切换；
- **视口 1（Slot 1，右上角）**：车内/盲区辅助视角，分辨率 960×540，采用 NV12 格式（单帧占用 777,600 字节）；
- **视口 2（Slot 2，左下角）**：左后视镜盲区视角，分辨率 960×540，采用 NV12 格式；
- **视口 3（Slot 3，右下角）**：右后视镜盲区视角，分辨率 960×540，采用 NV12 格式。

软硬功能划分界限清晰：RK3568 边缘 SoC 凭借四核 Cortex-A55 处理器与自研 1.0 TOPS NPU 算力，承担 Linux 操作系统调度、UVC 驱动管理、视频硬件解码、960×320 兴趣区（ROI）拼接、YOLOv6n 神经网络目标推断以及 C99 纯算法红绿灯识别与行车决策；紫光同创 PG2L100H FPGA 则凭借硬件并行计算能力，承担 PCIe Gen2 ×2 端点协议栈、DDR3 多通道仲裁 Hub、单遍光栅流式车道线拟合核、斑马线特征提取核、多图层矢量字符叠加引擎以及 HDMI 1080P@60Hz 显示控制。

### 2.3 系统主要设计指标
系统核心技术规格与软硬件设计指标如表 2-1 所列。

#### 表 2-1：系统核心软硬件规格与设计指标表

| 维度 | 指标项 | 规格设计值 / 实测参数 | 备注说明 |
| :--- | :--- | :--- | :--- |
| **计算平台** | FPGA 核心芯片 | 紫光同创 PG2L100H-6FBG676 | 99,600 LUT/FF 等效逻辑单元 |
| | SoC 主控芯片 | 瑞芯微 RK3568 (四核 A55 @ 2.0 GHz) | 飞凌嵌入式 OK3568-C 单板计算机 |
| | 板载存储配置 | FPGA: 1GB 32-bit DDR3；SoC: 2GB LPDDR4 | DDR3 时钟 400 MHz (等效 800 Mbps) |
| **互连通信** | 物理总线接口 | PCIe Gen2 ×2 (5.0 GT/s，2 物理通道) | OK3568 P29 专用扩展插槽 |
| | 最大有效载荷 (MPS) | 256 字节 (MPS 256) | 提升 TLP 有效数据吞吐占比 |
| | 实测长传输吞吐 | 板卡→主机 896 MB/s；主机→板卡 861 MB/s | `PCIe_DMA提速_20261018.md:200` |
| | 4 KB 小块读往返 | 约 1.8 µs (吞吐率 485 MB/s) | `PCIe_DMA提速_20261018.md:200-204` |
| **视频显示** | 显示接口与分辨率 | HDMI 1.4b (宏晶微 MS7210 驱动) | 1920×1080@60Hz (像素时钟 148.5 MHz) |
| | 画面排版架构 | 硬件四宫格 (4 路 960×540 并发) | 独立 Commit 机制，0 撕裂、0 丢帧干扰 |
| | 显示总线负载 | RGB565 格式仅 124.4 MB/s (负载 14.5%) | 裕量超 85%，支持高频指令与回传 |
| **算法性能** | NPU 目标检测耗时 | YOLOv6n INT8 单帧 17.55 ms (900 MHz) | 验证集 mAP50 66.05% (5类有效GT) |
| | 交通信号灯耗时 | 纯 C99 `tl_det` 单帧 4–6 ms (0 malloc) | 7 段视频 RAW 一致率 100.00% |
| | 车道线硬件耗时 | 光栅流式行内处理，消隐期 16 周期除法 | 仿真 row_mismatch=0，门级通过 42 帧 |
| | 告警下发物理延迟 | 960×540 单帧传输 1.2 ms，MMIO 单周期 | 触发全屏爆闪与自车道红箭头指示 |

---

## 第三章 硬件平台与电气机械架构

### 3.1 双核心异构计算平台选型
系统采用紫光同创盘古 100Pro+ 与飞凌嵌入式 OK3568-C 组合构建双核心异构平台：
1. **紫光同创盘古 100Pro+ 开发板**：主芯片为国产高性能 FPGA PG2L100H-6FBG676，内部集成 99,600 个四输入查找表（LUT）与触发器（FF）等效逻辑单元，集成多路吉比特收发器（GTP）高速串行接口与硬核存储器控制器，外挂 1 GB 容量、32-bit 位宽的 DDR3 颗粒，工作频率 400 MHz，提供大于 25.6 Gbps 的本地突发带宽，为多路高清视频帧缓冲与硬件流水线算法提供确定性低时延支撑；
2. **飞凌嵌入式 OK3568-C 单板计算机**：主芯片为瑞芯微 RK3568 高性能四核 64 位 Cortex-A55 处理器，主频达 2.0 GHz；板载自研三核心 NPU 神经处理单元，支持 INT8 定点算力达 1.0 TOPS；内置硬件 2D 图形加速引擎（RGA）与多媒体视频处理模块（MPP），集成 2 GB LPDDR4 内存与 8 GB eMMC 存储，运行定制打入 PREEMPT 补丁的嵌入式 Linux 4.19 实时内核。

### 3.2 高速链路互连拓扑与配置
OK3568-C 开发板提供 P29 与 P30 两处高速 PCIe 物理槽位。盘古 100Pro+ 开发板标准 PCIe x4 金手指接入 OK3568-C 的 **P29 槽位**（对应 RK3568 PCIe 3.0 控制器分拆出的 2-Lane 根端口 `0002:20:00.0`，端点设备识别为 `0002:21:00.0`）。链路经固件自协商与初始化脚本配置，稳定工作于 **PCIe Gen2 ×2 模式（5.0 GT/s 单通道物理线速率，2 物理通道）**。

为提升有效载荷传输效率，系统在 Linux 端点枚举时通过配置空间重写，将有效载荷最大传输单元（MPS）由默认的 128 字节提升至 **256 字节（MPS 256）**（出处：`PCIe_DMA提速_20261018.md:200`）。在 MPS 256 模式下，传输层数据包（TLP）协议报头开销占比显著降低，实测长传输吞吐从 834 MB/s 提升至 896 MB/s。

在外部视频与显示接口方面：
- **前向主视角/双目通道**：通过盘古 100Pro+ 载板的高性能 FMC 接口连接专用双目 CMOS 传感器子卡，差分信号直接注入 FPGA 片上管脚与预处理流水线；
- **环视监控通道**：由 OK3568-C 板载 USB 3.0 与 USB 2.0 根集线器接入 3 路工业级 UVC USB 摄像头，负责车辆后向与两侧盲区视野；
- **高画质视频输出**：盘古 100Pro+ 搭载宏晶微 MS7210 HDMI 发送芯片，由片上高精度锁相环（GPLL）分频生成 148.5 MHz 像素时钟（`pix_clk`，约束出处：`fpga/pnr/pango_pcie_top.fdc:940`），原生输出符合 CEA-861-D 标准的 1920×1080@60Hz 视频信号驱动车载监控屏。

### 3.3 供电树隔离与防反灌工程设计
两板卡异构物理互连在实际工程部署中具有极高的电气要求。若仅通过 PCIe 插槽金手指触点取电，将引起严重的电源瞬态跌落并损坏主板（出处：`review/pango100pro_evidence.md:279`）。系统落实了以下供电工程规范：
1. **独立供电隔离**：盘古 100Pro+ 开发板板上 3.3V 辅助供电与 1.2V 核心供电均由其独立的外部 DC 12V 稳压电源树（经 MT2492 与 EZ8303 两级降压转换器）独立供应。**严禁仅依赖 PCIe P29 插槽的 3.3V 触点对 FPGA 供电**；
2. **共地与防反灌规避**：两板卡通过外壳屏蔽地与 PCIe 金手指接地引脚实现可靠共地，消除地电位差引起的共模高频干扰与接口信号反射；
3. **确定性上电时序控制**：系统必须严格遵循“**先给盘古 100Pro+ 通电完成 FPGA 比特流加载，后开启 RK3568 主板电源启动 Linux 系统**”的上电顺序。若次序倒置，SoC 在引导阶段由于无法识别到有效 PCIe 端点时钟与复位响应，会导致 PCIe 链路枚举失败退化或系统内核死锁。

### 3.4 P29 插槽机械加固与热插拔禁令
在车载工况的持续振动与高温环境下，板卡接触稳定性直接决定了高速信号的眼图质量与链路误码率：
1. **双螺柱刚性定位加固**：OK3568 P29 槽位金手指缺乏原厂机械导向倒角，多次拆卸极易造成边缘铜箔磨损与镀层氧化。系统采用了定制的双螺柱硬质定位铝合金背板，对盘古 100Pro+ 板卡实施双向预紧力锁附，确保金手指垂直且无偏移地锁死在 P29 插槽内，阻抗失配引起的重训练（Recovery）次数降为 0；
2. **严苛热插拔禁令**：OK3568 根端口未部署复杂的硬件热插拔控制器（Hot-Plug Controller），在系统通电状态下插拔板卡会引发 PCIe 差分总线瞬间浪涌打坏 SoC 物理层引脚。**操作规程中严格明令禁止带电热插拔板卡**。

### 3.5 Linux 连续物理内存 CMA 扩容工程
传统嵌入式 Linux 系统默认预留的连续内存分配器（CMA）空间仅为 16 MB，无法容纳四路并发 960×540 视频帧、RGA 双缓冲以及 NPU 960×320 拼接输入的需求。为实现零 CPU 介入的高速数据流转，团队对内核进行了深度重构（出处：`RK_CMA扩容方案_20261018.md:9`）：
- 通过重构 U-Boot 引导参数与设备树内核节点，将 Linux 内核 CMA 空间由默认 16 MB 成功**扩容至 256 MB**；
- 物理分配起始基地址锁定为 **`0xDDC00000`**，完全处于 32 位物理寻址所涵盖的 4 GB 地址空间内；
- 该配置使得 MPP 硬件解码器、RGA 2D 加速器与用户态 DMA-BUF 驱动能够直接申请大块未碎裂的物理连续内存，为主机与 FPGA 间实施连续零拷贝 DMA 传输奠定了坚实底层基础。

#### 表 3-1：主控硬件平台核心技术参数对照表

| 硬件维度 | 紫光同创盘古 100Pro+ | 飞凌嵌入式 OK3568-C | 协同与互联指标 |
| :--- | :--- | :--- | :--- |
| **主控芯片型号** | PG2L100H-6FBG676 | 瑞芯微 RK3568 | 异构软硬协同平台 |
| **逻辑与计算核心** | 99,600 LUT/FF 等效逻辑单元 | 四核 ARM Cortex-A55 @ 2.0 GHz | SoC 调度 + FPGA 流水线 |
| **专用加速引擎** | 240 个 APM 乘法单元、GTP 收发器 | 1.0 TOPS NPU、硬件 2D RGA 引擎 | NPU 目标检测 + FPGA 标线拟合 |
| **板载存储介质** | 1GB 32-bit DDR3 (400 MHz) | 2GB LPDDR4 + 8GB eMMC | CMA 扩容 256 MB (0xDDC00000) |
| **板间通信接口** | PCIe x4 金手指 (运行于 x2) | P29 槽位 (PCIe 3.0 控制器分拆 x2) | PCIe Gen2 ×2，MPS 256 |
| **视频输入接口** | 标准 HPC FMC 接口 | USB 3.0 Host + USB 2.0 Host | 1 路 FMC + 3 路 UVC USB 摄像头 |
| **视频输出接口** | MS7210 HDMI 1.4b (148.5 MHz) | 板载 MIPI/EDP (系统运行未启用) | 1920×1080@60Hz 四宫格监控输出 |
| **供电方案设计** | 独立 DC 12V 稳压源 (严禁插槽取电) | 独立 DC 12V 稳压适配器 | 两板共地，严禁热插拔，先 FPGA 上电 |

---

## 第四章 FPGA 片上加速系统设计

### 4.1 视频中枢流水线与显示控制器
FPGA 顶层模块 `pango_pcie_dma_top` 实现了高并发视频中枢管理，核心在于板载 DDR3 仲裁 Hub 与四宫格显示控制子系统：
1. **多通道 DDR3 仲裁 Hub 架构**：
   - 片上 DDR3 控制器工作在 400 MHz 时钟频率（等效数据传输率 800 Mbps），配合 32 位物理总线提供充足的读写突发带宽；
   - 内部开辟 4 组在物理与逻辑上完全隔离的独立读写先进先出队列（FIFO），分别对应四路 960×540 视频图层；
   - 采用平滑加权的轮询仲裁机制（Round-Robin Hub），在保证写入突发不溢出的前提下，以最高优先级保证 HDMI 读出端 FIFO 的充盈度。
2. **独立 Commit 影子寄存器机制**：
   - 各视频图层具备独立的帧切换 Shadow 锁存机制。SoC 端在通过 PCIe 门铃将完整一帧写入 DDR3 对应视口缓冲区后，向寄存器 `0x814` 发起一笔提交写入：
     $$\text{Reg}[0\text{x}814] = (\text{fid} \ll 16) \mid \text{slot}$$
     其中 $\text{slot} \in \{0, 1, 2, 3\}$ 为目标四宫格视口编号，$\text{fid}$ 为 16 位帧序列序号；
   - FPGA 硬件显示流水线捕获该提交事件后，并不立即打断当前扫描，而是在下一个垂直消隐期（V-Blanking）原子性地倒换该图层的读写指针。该机制实现了四路视频在不同帧率、异构色彩格式及偶发掉帧工况下的完全解耦，彻底消除了动态画面撕裂与窗口拖影。

### 4.2 硬件流式车道线检测核 (`rt_lane_det`)
针对车载系统对车道线感知的超低延迟需求，设计并实现了纯定点单遍光栅流式硬件加速核 `rt_lane_det`。该模块完全摆脱了传统的全帧图像缓存依赖，算法流水线如下：
1. **感兴趣区与自适应色差初筛**：限定垂直扫描区间为 $y \in [260, 500]$。在每个像素时钟沿，流水线根据白线特征（亮度分量 $G \ge 120$ 且 $|R-G| \le 18, |G-B| \le 18$）与黄线特征（$R \ge 130, G \ge 120, B \le \min(R,G)-20$）完成硬件色差打标；
2. **行内游程聚合与左右候选中心提取**：行缓冲器实时聚合连续标线像素，根据自车几何中心参考基准 $X_C = 480$ 动态计算左右路沿预估窗口，在线滤除沥青麻点、路面接缝与路灯反光，输出当前行左右两侧最优车道线边缘中点 $(x_L, y)$ 与 $(x_R, y)$；
3. **在线累加器与最小二乘定点拟合**：在行扫描进行的同时，片上硬件累加器实时计算 $\sum 1, \sum y, \sum y^2, \sum x, \sum x \cdot y, \sum x^2$ 统计量。在帧末垂直消隐期，专用定点硬件除法器流水线在 **16 个时钟周期** 内计算出直线方程 $x = a \cdot y + b$ 的定点斜率 $a$（Q16 格式）与截距 $b$（Q4 格式）；
4. **EMA 平滑滤波与连续性判别**：引入平滑系数 $\alpha = 0.5$（通过移位与加法高效实现）的指数移动平均滤波器（EMA）消除帧间抖动。结合连续有效行数与双线伴生特征，当连续命中行数超过门限（$N_{min} = 25$）时判定车道线锁定有效，并输出其实线、虚线或双黄线属性；
5. **仿真与门级时序验证**：
   - 设计了包含白实线、白虚线、双黄线、故障恢复及实板 dump 采样的 5 组基准向量集（`seg_A_solid`、`seg_B_dashed`、`seg_C_double_yellow`、`seg_recover`、`seg_board`，出处：`log/lane_fpga/vectors/README.md:13`）；
   - RTL 仿真测试台比对结果显示，5 组向量**全部实现逐行比对零误差（`row_mismatch = 0`）**，逐帧精确核验了斜率、截距、置信度等 **12 个关键字段**（覆盖 38 个内部寄存器）；
   - 在布局布线后门级网表时序反标仿真（`tb_rt_lane_det_gl`）中，成功通过真实路面采样的 **42 帧** 全流程反标核验，验证了算法在纳米级硬件门电路延迟下的正确性。

### 4.3 硬件流式斑马线检测核 (`rt_zebra_det`)
针对行人过街斑马线的高频周期性几何纹理特征，设计了流式硬件斑马线检测核 `rt_zebra_det`：
1. **流式零行缓冲条纹提取**：无需任何 BRAM 存储整行图像，在像素到达时实时统计当行白色条纹的宽度分布与数量分布；
2. **多重物理约束判决**：有效垂直区间限定在 $Y \in [300, 480]$，白条纹单体宽度限定在 $W \in [10, 70]$ 像素，单行条纹数量门限设为 $N_{min} = 7$。同时引入物理跨度比约束 `span_ratio >= 0.55`、白色占空比约束 $[0.20, 0.60]$ 以及正向 3 帧确认（`hyst_pos=3`）、丢失 6 帧释放（`hyst_neg=6`）的帧间迟滞滤波；
3. **评测表现与板端工程局限**：在算法评测基准视频中实现了 93.4% 的正样本覆盖率，并成功将货车瓦楞板及护栏误报降为 0。但**必须客观说明**，在实车测试中，当前车（如出租车）在路口近距离排队时，车体遮挡会导致斑马线出现大于 330 像素的超限空隙，超出硬件阈值上限引起漏检波动。因此该硬件核**目前在真实板端仍处于实验调试阶段，尚未接入系统声光告警主环路**（出处：`docs/技术文档_草稿.md:401-402`）。

### 4.4 算法调试效果视图 (`DISP_CTRL[9:8]`)
为方便现场排查路面复杂光影与标线二值化提取质量，FPGA 显示流水线实现了硬件级显示效果无缝切换机制（出处：`fpga/src/disp/rt_disp_top.v:904`）：
- 通过向控制寄存器 `DISP_CTRL[9:8]` 写入控制位，可在视口 0（主前视通道）实时切换三种渲染模式：
  - `2'b00`（原画彩色模式）：直接输出 24-bit RGB 原彩画面；
  - `2'b01`（灰度处理模式）：流水线按硬件加权公式 $\text{Gray} = (R + 2G + B) \gg 2$ 单周期输出 8 位灰度图像；
  - `2'b10 / 2'b11`（二值化掩膜模式）：完全复用硬件标线判定逻辑（亮度 $V \ge 140$ 且 $|Max_{RGB} - Min_{RGB}| \le 30$），将符合路面标线特征的像素直接渲染为纯白（`0xFF`），背景置黑（`0x00`）。
- 该切换逻辑受视口数据有效使能信号 `q0_de` 硬件门控，仅作用于主图像区域，完全不污染四宫格其余视口及多图层矢量 OSD 叠加。

### 4.5 片上资源利用率与时序收敛
FPGA 加速系统整体硬件架构如图 4-1 所示。工程基于紫光同创 Fabric Compiler (版本 2025.2，build 211867) 完成布局布线。系统最新投产构建版本为 **cam11**（版本寄存器 `0x838 = 0x20261029`）。

```text
                               图 4-1：FPGA 视频加速与片上算法处理架构框图
```
*(注：对应 FPGA 芯片内部微架构图见 `figs/fig6_fpga.png`)*

片上物理资源消耗统计详见表 4-1，静态时序分析（STA）结果详见表 4-2。

#### 表 4-1：cam11 版本 FPGA 片上物理资源占用详表
*(数据源自紫光同创 PDS 综合布线报告 `build_cam11_s1.log:20546-20599`)*

| 资源类别 | 实际占用量 (Used) | 芯片可用总量 (Available) | 利用率 (%) | 核心消耗功能模块 |
| :--- | :---: | :---: | :---: | :--- |
| **LUT (四输入查找表)** | 26,645 | 66,600 | **40.0%** | PCIe 控制器、DDR3 仲裁 Hub、车道线与斑马线流水线 |
| **FF (触发器)** | 25,730 | 133,200 | **19.3%** | 深度流水线寄存打拍、DMA 描述符缓冲、状态机控制 |
| **DRM (36K 块 RAM)** | 99 (等效) | 155 | **63.8%** | 87 块 36K + 24 块 18K；四路分屏读写 FIFO、点阵字库 ROM |
| **APM (DSP 乘法单元)** | 61 | 240 | **25.4%** | 车道线在线定点矩阵乘加、鸟瞰图透视变换坐标映射 |
| **GPLL / PPLL (锁相环)** | 4 / 2 | 6 / 6 | 66.7% / 33.3% | PCIe、DDR3 控制器及 148.5 MHz 像素时钟 `pix_clk` |
| **HSSTLP (高速收发器)** | 2 Lane | 8 Lane | 25.0% | PCIe Gen2 ×2 物理差分收发通道 |

#### 表 4-2：cam11 版本静态时序分析 (STA) 收敛报告
*(数据源自紫光同创 PDS STA 时序报告 `build_cam11_s1.log:20529`)*

| 指标类别 | 测量结果 | 设计约束门限 | 收敛状态 | 详细说明 |
| :--- | :---: | :---: | :---: | :--- |
| **全局最差建立余量 (Setup WNS)** | **+0.340 ns (340 ps)** | > 0.000 ns | **PASS (无违例)** | `pix_clk` (148.5 MHz) 像素域收敛裕量充足 |
| **全局总建立负余量 (Setup TNS)** | **0.000 ns** | 0.000 ns | **PASS (无违例)** | 全局无任何建立时间时序违例路径 |
| **保持时间最差余量 (Hold WNS)** | **+0.052 ns** | > 0.000 ns | **PASS (无违例)** | 保持时间由布局布线工具自动插入延迟单元修复 |
| **恢复/撤销时间余量 (Recovery/Removal)** | 全部为正余量 | > 0.000 ns | **PASS (无违例)** | 异步复位撤销时序满足要求 |

### 4.6 OSD 引擎与四宫格推图寄存器契约
FPGA 内部构建了多图层矢量/光栅混合 OSD 引擎，在 148.5 MHz 像素时钟流上逐像素叠加。支持 16 组带加粗边框的目标框（`box_lo/box_hi`）、64 字符动态状态文本行（`font8x16_rom`）、24×24 矢量三色转向指示箭头（`arrow24_rom`）以及由 DECISION 寄存器 bit8 控制的全屏鲜红闪烁边框。

主机与 FPGA 针对四宫格推图建立了严格的寄存器协议契约：
1. **DDR 门铃读使能**：向 `0x1A0` 写入 `1`。由于 FPGA 硬件复位后默认关闭 DDR 门铃引擎，推图前**必须显式写入 `0x1A0 = 1`**（出处：`tools/menu/usb_menu.c:1460`）；
2. **显存基地址与槽步长**：向 `0x804` 写入显存物理基址 `0x04000000`，向 `0x808` 写入槽位物理地址步长 `0x00400000`（4 MB 跨度）；
3. **行跨度与槽像素规模**：FPGA 硬件复位默认值对应 1920×1080 单画面，四宫格推图前**必须强制重设**：向 `0x80C` 写入行跨度 `960`，向 `0x810` 写入单槽总像素数 `518400`（即 960×540）；
4. **槽位色彩格式与字节容量契约**：
   - 视口 0（Slot 0）：配置为 RGB565 格式，单帧数据量固定为 $960 \times 540 \times 2 = 1,036,800$ 字节；
   - 视口 1–3（Slot 1–3）：配置为 NV12 格式，单帧数据量固定为 $960 \times 540 \times 1.5 = 777,600$ 字节；
5. **主控制与图层使能寄存器**：
   - `0x800`（主控制寄存器）：实时模式写入 `0x25`，视频播放与 U 盘模式写入 `0x65`；
   - `0x880`（图层显示模式寄存器）：bit4 框、bit5 文本、bit6 箭头。列表界面写入 `0x10`；U 盘播放/ADAS 写入 `0x70`（框+文本+箭头）；单图全屏示例同样写入 `0x70`。

---

## 第五章 软硬协同高速低时延数据流

### 5.1 端到端全硬件零拷贝数据流拓扑
在传统嵌入式多路视觉系统中，若依赖 CPU 执行内存搬移（`memcpy`）与格式转换，会引发巨大的缓存污染（Cache Pollution）与总线等待，造成无法忍受的时延抖动。

本系统构建了由 RK3568 专用多媒体硬件与 FPGA 紧密接力的全硬件端到端零拷贝数据流水线，如图 5-1 所示。

```text
                               图 5-1：软硬协同端到端低时延数据流向图
```
*(注：对应软硬协同全链路数据流拓扑图见 `figs/fig2_dataflow.png`)*

全链路数据流转步骤如下：
1. **MPP 硬件解码接入**：USB 摄像头采集的 H.264/H.265 压缩视频流，由 RK3568 内部的多媒体处理平台（MPP）硬核直接解码，解出的原始物理帧保存在 Linux 内核 CMA 预留区中；
2. **RGA 2D 硬件图形派生**：RGA 2D 引擎以硬件 DMA 方式直读 CMA 物理内存，单周期完成两路并行硬件派生：
   - 将原始视频裁剪下采样至统一的 960×540 分辨率（Slot 0 转换为 RGB565，Slot 1–3 转换为 NV12），写入发送环形缓冲；
   - 截取车道核心带状感兴趣区，拼装为 960×320 图像，直供 NPU 神经处理单元的输入 DMA 描述符；
3. **DMA-BUF 共享内存直通**：利用 Linux 内核 DMA-BUF 机制，用户态程序完全无需调用 `read` 或 `write` 系统调用，物理内存指针在驱动间零拷贝透明传递；
4. **门铃 DMA 硬件直拉**：SoC 仅需向 PCIe BAR1 门铃寄存器写入物理地址，FPGA DMA 主控制器（DMA Master）即刻被触发，跨越 PCIe 总线自主拉取帧数据；
5. **DDR3 帧存与四宫格排版**：帧数据进入 FPGA 板载 DDR3 对应视口写缓冲，由多通道 Hub 调度仲裁，硬件光栅引擎实时排版输出至 MS7210 驱动 HDMI 1080P 屏。

### 5.2 互连带宽实测与多色彩格式负载测算
为验证系统在高并发工况下的物理可行性与扩展余量，对 PCIe 传输总线进行了严格的实测定量评估（出处：`PCIe_DMA提速_20261018.md:9, 19, 200, 204`）：
1. **PCIe Gen2 ×2 物理吞吐实测**：
   - 链路物理理论带宽为 $1000 \text{ MB/s}$（5.0 GT/s 经过 8b/10b 编码）。在 MPS 256 模式下，实测 FPGA 板卡到 SoC 主机长传输吞吐达 **896 MB/s**；
   - SoC 主机到 FPGA 板卡长传输吞吐峰值实测封顶为 **861 MB/s**（受 RK3568 根端口 128 字节读完成包协议拆分约束）；
   - 在 5 分钟 485 轮双向交替压力测试中，系统实现 **0 校验错误，AER 硬件错误与 RAS DES 计数恒为 0**，证明链路具备工业级高可靠性。
2. **多色彩格式四路并发带宽开销与总线负载测算**：
   - 针对四路 960×540@30fps 并发推流，不同像素格式对 861 MB/s 实测峰值总线能力的占用测算如表 5-1 所示。

#### 表 5-1：多色彩格式四路 960×540@30fps 并发传输总线带宽占用测算表
*(总线负载基准采用主机到 FPGA 实测峰值带宽 861 MB/s，出处：`PCIe_DMA提速_20261018.md:204`)*

| 传输色彩格式 | 单像素位宽 (Bytes) | 单路 960×540 帧大小 | 单路 30fps 带宽需求 | 四路并发总带宽需求 | 对 861 MB/s 实测峰值负载 | 剩余带宽裕量 |
| :--- | :---: | :---: | :---: | :---: | :---: | :---: |
| **原始全 RGB888 格式** | 3.0 B | 1,555,200 字节 | 46.65 MB/s | **186.6 MB/s** | **21.7%** | **78.3%** |
| **全 RGB565 格式** | 2.0 B | 1,036,800 字节 | 31.10 MB/s | **124.4 MB/s** | **14.5%** | **85.5%** |
| **本系统方案 (Slot0:RGB565 + Slot1-3:NV12)** | 混合 | 1×1.036MB + 3×0.777MB | 31.1 + 3×23.33 | **101.1 MB/s** | **11.7%** | **88.3%** |
| **全 NV12 格式** | 1.5 B | 777,600 字节 | 23.33 MB/s | **93.3 MB/s** | **10.8%** | **89.2%** |

测算数据证实：在系统当前采用的混合格式下，四路并发总线负载仅为 **11.7%**（即使全用 RGB565 也仅占 **14.5%**）。高达 **85% 以上的总线带宽裕量**，彻底杜绝了突发性总线拥塞，确保紧急告警指令下发、双目差分特征数据回读具备微秒级确定性响应。

### 5.3 门铃 DMA 传输时序与 CPU 零拷贝边界
系统定义了清晰的 CPU 零拷贝边界与异步门铃握手协议：
1. **CPU 零拷贝边界**：
   - CPU 仅负责在引导期申请 CMA 连续内存，在运行期操作描述符指针，**绝对不读写、不拷贝视频像素内容**；
   - 视频像素从 V4L2 裸流到 HDMI 显示屏的流转，全程由 MPP $\rightarrow$ RGA $\rightarrow$ PCIe DMA $\rightarrow$ DDR3 Hub 专用硬件电路接力完成，CPU 占用率无限接近于 0。
2. **异步门铃寄存器定义与传输时序**：
   - 门铃寄存器映射：Slot 0 对应 `0x190`，Slot 1 对应 `0x194`，Slot 2 对应 `0x198`，Slot 3 对应 `0x19C`；
   - 触发流程：SoC 侧 RGA 处理完成后，将目标帧在 CMA 物理内存的 32 位基地址写入对应槽位的门铃寄存器，门铃计数序列号自增；
   - 完成判定：FPGA DMA 控制器拉取数据完毕后，自增片上完成计数器 `0x1C8`。SoC 端通过轮询 `0x1C8` 是否追平序列号，实现高可靠双向握手（出处：`tools/menu/usb_menu.c:204-219`）；
3. **实测时延性能**：
   - 小块传输能力：发送 4 KB 小块命令时实测速率达 485 MB/s，每个 4 KB 读请求往返耗时约 **1.8 µs**（出处：`PCIe_DMA提速_20261018.md:200, 204`）；
   - 帧传输吞吐耗时：960×540 分辨率 RGB565 单帧图像在 PCIe Gen2 ×2 链路上完成 FPGA 传输仅需 **1.2 ms**（出处：`PCIe_DMA提速_20261018.md:204`）。

---

## 第六章 人机交互与多模式启动系统

### 6.1 系统多模式自启动链路与状态流转
车载前装设备在实际应用中要求具备离线开机自启、脱离键鼠操作与快速模式流转的能力。系统设计了完备的 Linux 启动链与交互状态机，如图 6-1 所示。

```text
                               图 6-1：系统多模式启动与运行流转状态机
```
*(注：对应系统多模式启动架构图见 `figs/fig3_boot.png`)*

系统开机与工作模式流转时序如下：
1. **SysVinit 自启引导**：系统上电引导时，初始化脚本 `/etc/init.d/S99adas_menu` 自动启动后台管线，执行 `/userdata/quad/run_boot.sh`；
2. **PCIe 链路激活与固件同步**：`run_boot.sh` 脚本向 `/sys/bus/pci/devices/0002:21:00.0/enable` 写入 1 激活端点，并写入配置字开启 Bus Master 权限。随后轮询 FPGA 版本寄存器 `0x838`，直到读出期望的 cam11 固件版本号 **`0x20261029`**，确保片上逻辑已完全就绪（出处：`tools/menu/run_boot.sh:1-3`）；
3. **开机二选一启动器 (`mode_select`)**：调用 `mode_select`，在 1080P 屏幕上渲染卡片式开机选择界面。操作员短按 KEY0 切换模式，短按 KEY1 确认进入；
4. **子系统分流**：
   - **分支 0**：启动 `menu_daemon`，进入实时多路摄像头实况监控模式；
   - **分支 1**：启动 `usb_menu`，进入现场 U 盘测评模式；
5. **平滑返回**：在任何运行模式下，长按 KEY4 均可优雅杀灭当前业务进程，自动返回开机二选一界面。

### 6.2 开机二选一界面与四宫格推图初始化
`mode_select` 是系统冷启动呈现的核心界面（出处：`tools/menu/mode_select.c:388-426`）：
1. **素材预渲染与四宫格切片**：采用 Python PIL 离线预渲染“实时摄像头模式”与“U 盘视频模式”两组高质量 1080P UI 页面，每个页面切割为 4 个 960×540 槽位瓦片（Tile 0 对应 RGB565，Tile 1–3 对应 NV12）；
2. **初始寄存器必须配置**：开发实践表明，FPGA 硬件复位后其内部 DDR 门铃引擎与四宫格分屏步长均处于初始关闭或 1080P 宽幅状态。因此，**在发起任何 DMA 传输前，必须严格依次完成以下写入**：
   - `0x1A0 = 1`：开启 FPGA DDR 门铃接收引擎；
   - `0x804 = 0x04000000`、`0x808 = 0x00400000`：配置帧存基址与 4 MB 槽步长；
   - `0x80C = 960`、`0x810 = 518400`：将行跨度由复位值 1920 更改为 960，槽像素更改为 518400；
   - `0x800 = 0x65`、`0x880 = 0x10`：激活显示与基本图层；
3. **DMA 循环灌入**：通过 `0x190/0x194/0x198/0x19C` 将四槽图像推入 DDR3，并写入 `0x814` 提交。当用户短按 KEY0 时，程序毫秒级切换显示选中的高亮卡片。

### 6.3 实时监控模式与参数浮窗控制
在开机界面选定实时模式后，后台拉起守护进程 `menu_daemon`（出处：`tools/menu/menu_daemon.c:110-123, 396-430`）：
- **多路实况推流**：后台并发启动 3 路 UVC USB 摄像头采集与 1 路前向通道，实时刷新四宫格监控画面；
- **交互参数配置浮窗**：操作员按下 KEY4 可即刻在屏幕中央唤出青色边框的 6 项控制浮窗：
  1. `1 LIVE 4CAM`：切换至四路摄像头全屏实时监控；
  2. `2 USB VIDEO`：退出当前实况，直接切入 U 盘视频浏览器；
  3. `3 NPU:ON / OFF`：实时切换 NPU 神经网络目标检测使能；
  4. `4 LANE:ON / OFF`：实时切换片上硬件流式车道线检测使能；
  5. `5 VIEW:COLOR / GRAY / BIN`：切换视口 0 的原彩/灰度/二值化效果；
  6. `6 ZEBRA:ON / OFF`：切换片上斑马线实验检测核使能；
- **默认安全工况**：系统进入实时模式时，**NPU 与车道线检测算法默认处于关闭状态（OFF）**，由测试员根据测评科目按需开启，确保系统待机低功耗与按键通道纯净。

### 6.4 现场 U 盘测评模式与轻量级中文 GUI 引擎
针对赛题指南明确要求的“现场用 U 盘提供所有或 1~4 种测试场景”评测规则，系统专门研发了 `usb_menu` 应用程序与专用嵌入式中文点阵字库（出处：`tools/menu/usb_menu.c:106, 740-760, 1461`）：
1. **免驱热插拔多文件系统挂载顺序**：
   - 程序扫描 `/dev/sd[a-z][1-4]` 设备节点，按照严格的挂载尝试顺序进行自动化加载：
     $$\text{vfat (ro, UTF-8)} \rightarrow \text{ntfs (ro)} \rightarrow \text{ntfs3 (ro)} \rightarrow \text{标准 mount (ro)} \rightarrow \text{exFAT-FUSE (rw)}$$
   - 针对部分 U 盘中 exFAT-FUSE 驱动对只读（`ro`）模式报错拒绝的硬件兼容性问题，系统在只读挂载失败后自动退化重试读写（`rw`）挂载，确保现场任意 U 盘 100% 挂载成功；
2. **轻量级 26×26 GBK 中文点阵字库引擎 (`ui_cjk.bin`)**：
   - 摆脱体积庞大的 FreeType 矢量字体库，通过 `gen_cjk_font.py` 生成紧凑的二进制字库文件 `menu/ui_cjk.bin`（采用自定义 CJK1 二进制结构）；
   - 字库完整收录 **21,791 个** GBK 双字节区汉字字符，单字位图规格为 26×26 1-bit（占用 104 字节），字库总文件大小仅 **2.33 MB**；
   - 内部集成小端序码点升序索引表，板端检索采用极速**二分查找算法**（平均耗时小于 1 µs），并在遇到罕见缺字时自动平滑退化为 ASCII 字符 `?`，彻底杜绝中文乱码与字符溢出；
3. **1–4 路任意多视频/图片灵活编组映射**：
   - 浏览界面支持多级子目录导航，KEY0/KEY2 上下翻选，KEY1 勾选添加。用户按选择次序将 1 到 4 个文件依序填入四宫格视口：
     $$\text{第 1 个} \rightarrow \text{左上 (Slot 0)} \quad \text{第 2 个} \rightarrow \text{右上 (Slot 1)} \quad \text{第 3 个} \rightarrow \text{左下 (Slot 2)} \quad \text{第 4 个} \rightarrow \text{右下 (Slot 3)}$$
   - 若选定文件不足 4 个（例如仅评测 1 个十字路口视频），**未被占用的宫格由硬件自动灌入全黑帧（Black Frame）进行黑屏遮蔽**，杜绝上一模式的历史残影干扰；
4. **静态图片与多媒体播放支持**：
   - 系统不仅支持 `.mp4` 视频文件的硬件循环解码播放，还完整实现了对 **`.jpg`、`.jpeg`、`.png`、`.bmp` 静态图片的加载与四宫格推流支持（已实现，待上板验证）**；
5. **播放期参数浮窗与 OSD 隔离约束**：
   - 在多路视频回放过程中，短按 KEY4 呼出参数调节浮窗。浮窗**严格仅占用屏幕底部 OSD 的前三行（第 0、1、2 行）**，将**第 3 行完整留给 ADAS 状态与告警字符串**（如 `L:OK S:OK R:OK LN:S MOV:1 HZ:0`），确保演示期间交互调节与核心安全告警互不遮挡、互不干扰。

### 6.5 板载按键统一映射与冲突规避机制
盘古 100Pro+ 开发板物理上配备 5 个独立的轻触微动按键，板载丝印标识为 **KEY0、KEY1、KEY2、KEY3、KEY4**。按键经 FPGA 内部消抖模块采样，生成包含按键编号与动作类型的事件字写入寄存器 `0x844`。按键事件与状态分发如图 6-2 所示。

```text
                               图 6-2：板载物理按键多级复用与事件分发架构图
```
*(注：对应物理按键拓扑与分发图见 `figs/fig5_keys.png`)*

各场景下的按键功能矩阵如表 6-1 所示。

#### 表 6-1：板载物理按键在不同工作模式下的动作映射总表

| 物理按键 | 动作类型 | 开机选择界面 (`mode_select`) | U 盘浏览器 (`usb_menu`) | 视频播放与实时监控模式 | 透视标定模式 (`cal_mode`) |
| :--- | :--- | :--- | :--- | :--- | :--- |
| **KEY0** | 短按 (T_SHORT) | 切换模式卡片 (0/1) | 光标向下移动 (选文件) | 循环切换自车道 (左 $\rightarrow$ 直 $\rightarrow$ 右) | 消失点向上微调 |
| | 长按 (T_LONG) | 无动作 | 快速下翻页 | 无动作 | 步长倍增微调 |
| **KEY1** | 短按 (T_SHORT) | 确认进入选定模式 | 选定/取消选定当前条目 | 切换车辆启停状态 (停止 $\leftrightarrow$ 行驶) | 消失点向下微调 |
| | 长按 (T_LONG) | 无动作 | 直接启动当前选定播放 | 无动作 | 步长倍增微调 |
| **KEY2** | 短按 (T_SHORT) | 无动作 | 光标向上移动 | 注入左转向灯请求 (变道指示) | 消失点向左微调 |
| | 长按 (T_LONG) | 无动作 | 快速上翻页 | 注入**强制左变道**指令 (实线触发告警) | 标定参数重置 |
| **KEY3** | 短按 (T_SHORT) | 无动作 | 清空全部已选列表 | 注入右转向灯请求 (变道指示) | 消失点向右微调 |
| | 长按 (T_LONG) | 无动作 | 无动作 | 注入**强制右变道**指令 (实线触发告警) | 标定参数重置 |
| **KEY4** | 短按 (T_SHORT) | 无动作 | 无动作 | 唤出/隐藏 6 项参数配置浮窗 (Popup) | 退出透视标定模式 |
| | 长按 (T_LONG) | 退出当前程序 | 退出并返回开机选择器 | 优雅中止推流，返回上级菜单 | 保存标定参数回写 |
| | 持续 3 秒 (HOLD3) | 触发透视标定 | 触发透视标定 | 切入透视变换网格标定模式 (`cal_mode`) | 退出标定模式 |

针对按键在不同层次的复用，系统实施了严谨的**工程冲突规避机制**：
1. **菜单共用按键与驾驶状态基线消除**：
   - 在进入视频播放前，用户使用 KEY0 与 KEY1 进行了大量菜单翻页与确认点击。此时 FPGA 硬件状态机内的车道寄存器 `lane` 与运动状态 `moving` 已积累了不可预测的历史计数值；
   - 若直接将其作为 ADAS 驾驶意图输入，会导致视频刚一播放即因“红灯起步”误报闯红灯全屏闪烁；
   - 为此，软件在 `tools/usb_feed/adas.c` 中设计了**动态基线对齐机制**：在首帧到达或捕获到 `SIGUSR1` 信号时，自动读取当前物理值锁存为基准量 `g_lane_base = raw_lane` 与 `g_moving_base = raw_moving`。实际生效的车道与行驶状态按差分偏置计算：
     $$\text{lane\_eff} = (\text{raw\_lane} - g\_lane\_base + 1 + 3) \bmod 3, \quad \text{moving\_eff} = \text{raw\_moving} \oplus g\_moving\_base$$
     彻底消除了菜单交互引入的驾驶状态误触发；
2. **KEY4 长按退出的 3 秒防误触约束**：
   - FPGA 固件规定持续按住 KEY4 达 3 秒（T_HOLD3）将切入内部硬件透视标定模式（`cal_mode`，全屏打出十字准星网格）；
   - 因此，**现场评测演示人员长按 KEY4 退出当前播放或菜单时，必须在 1～2 秒内及时松开按键**，避免超时触发 `cal_mode` 导致画面被标定网格遮挡。

### 6.6 四宫格显存切片与帧存布局
FPGA DDR3 内部的显存组织与槽位空间划分如图 6-3 所示。

```text
                               图 6-3：四宫格显存槽位物理排布与双缓冲映射图
```
*(注：对应显存槽位物理映射图见 `figs/fig4_fbmap.png`)*

核心推图控制与交互寄存器定义如表 6-2 所列。

#### 表 6-2：FPGA 四宫格推图与人机交互核心寄存器映射定义表

| 寄存器偏移 | 寄存器名称 | 读写属性 | 典型配置值 | 详细功能定义与控制语义 |
| :--- | :--- | :---: | :---: | :--- |
| **`0x1A0`** | `REG_DMA_EN` | R/W | `0x00000001` | DDR 门铃接收使能。FPGA 复位后默认关闭，推图前必置 1 |
| **`0x190`** | `REG_DOORBELL0` | W | 物理基址 | 视口 0 门铃。写入 CMA 连续帧物理地址，触发 DMA Master 搬移 |
| **`0x194`** | `REG_DOORBELL1` | W | 物理基址 | 视口 1 门铃。写入视口 1 帧物理地址 |
| **`0x198`** | `REG_DOORBELL2` | W | 物理基址 | 视口 2 门铃。写入视口 2 帧物理地址 |
| **`0x19C`** | `REG_DOORBELL3` | W | 物理基址 | 视口 3 门铃。写入视口 3 帧物理地址 |
| **`0x1C8`** | `REG_DMA_DONE` | R | 递增计数值 | 门铃 DMA 完成计数器。SoC 轮询该值追平序列号以确认传输完成 |
| **`0x800`** | `REG_MAIN_CTRL` | R/W | `0x25 / 0x65` | 主控制字。`0x25` 对应实时监控模式，`0x65` 对应视频播放模式 |
| **`0x804`** | `REG_FB_BASE` | R/W | `0x04000000` | 显存帧缓冲起始物理基地址 (处于 FPGA 板载 DDR3 空间) |
| **`0x808`** | `REG_FB_SLOT` | R/W | `0x00400000` | 槽物理地址步长 (单槽分配 4 MB，满足 1080P 双缓冲余量) |
| **`0x80C`** | `REG_STRIDE` | R/W | `960` | 行跨度像素数。复位默认值为 1920，四宫格模式必须强制设为 960 |
| **`0x810`** | `REG_PIXELS` | R/W | `518400` | 单槽总像素数。设为 $960 \times 540 = 518400$，复位默认 2073600 |
| **`0x814`** | `REG_FB_COMMIT` | W | `(fid<<16)\|slot` | 独立 Commit 提交寄存器。消隐期原子倒换读写指针消除撕裂 |
| **`0x838`** | `REG_VERSION` | R | `0x20261029` | 固件构建版本号标识 (cam11 版本日期戳) |
| **`0x844`** | `REG_KEY_STATUS`| R | 动态状态字 | 物理按键事件字。`[7:0]` 序列号，`[10:8]` 键号 0–4，`[13:12]` 动作类型 |
| **`0x850`** | `REG_DECISION` | R/W | `0x0C/0x10C/0x08`| ADAS 决策告警字。`[1:0]`左车道、`[3:2]`中车道、`[5:4]`右车道、`[8]`爆闪 |
| **`0x880`** | `REG_DISP_MODE` | R/W | `0x10 / 0x70` | 图层模式。`0x10` 只开框（列表），`0x70` 框+文本+箭头（U 盘播放/ADAS/单图全屏） |
| **`0x8C0`** | `REG_LANE_CTRL` | R/W | 位控掩码 | 车道线加速核控制寄存器。bit0 使能，bit1 复位，bit2 告警抑制 |
| **`0xA20`** | `REG_ZEBRA_CTRL`| R/W | `0x0 / 0x1` | 斑马线实验检测核控制寄存器。bit0 开启/关闭检测使能 |
