Zdy-1110/FPGA-676/docs/演示视频_分镜.md

# 2026 嵌赛紫光同创选题三 1080P 演示视频分镜脚本

- **工程代号**：nesai2026（车载异构计算与智能驾驶辅助系统）
- **硬件平台**：紫光同创盘古 100Pro+ (PG2L100H) + 飞凌嵌入式 OK3568-UP4 (RK3568)
- **目标视频规格**：1920×1080 60fps，目标时长 02:54（控制范围 02:50–02:55，比赛硬上限 03:00）
- **编导定位**：竞赛演示视频执行导演 / 硬件实物与界面实录现场机位统筹

---

## 一、总体时长规划与时间码累计校验表

| 序号 | 镜头分段名称 | 起止时间码 (SMPTE) | 单段时长 (秒) | 累计时间码 | 核心呈现内容 | 风险等级 |
| :---: | :--- | :---: | :---: | :---: | :--- | :---: |
| 1 | 片头系统概览与实物 | 00:00 - 00:10 | 10 | 00:10 | 异构架构框图与硬件实物连接全貌 | 低 |
| 2 | 断电冷启动与模式选择 | 00:10 - 00:24 | 14 | 00:24 | 硬件冷启动、全屏二选一菜单切换 | 中 |
| 3 | 四路实时多摄与弹窗交互 | 00:24 - 00:52 | 28 | 00:52 | 3路USB+1路FPGA四宫格、OSD弹窗控制 | 高 |
| 4 | U盘模式与多路分屏播放 | 00:52 - 01:21 | 29 | 01:21 | CJK中文文件浏览、4视频勾选并发回放 | 中 |
| 5 | 赛题(1) 红绿灯通行判决 | 01:21 - 01:49 | 28 | 01:49 | 切车道、红灯禁行、闯红灯爆闪、绿灯通行 | 高 |
| 6 | 赛题(2) 车道线与变道监控 | 01:49 - 02:14 | 25 | 02:14 | 虚线变道放行、实线拒绝、强行变道告警 | 高 |
| 7 | 赛题(4) 行人与障碍物识别 | 02:14 - 02:29 | 15 | 02:29 | NPU目标检出、车道红箭头与声光报警 | 高 |
| 8 | 核心性能指标与资源卡 | 02:29 - 02:49 | 20 | 02:49 | 896MB/s带宽、17.55ms时延、WNS时序与资源 | 低 |
| 9 | 片尾收尾与团队信息 | 02:49 - 02:54 | 5 | 02:54 | 演示收尾、参赛题号与队名占位 | 低 |

**时间码校验公式**：
`10s + 14s + 28s + 29s + 28s + 25s + 15s + 20s + 5s = 174s = 02分54秒`（符合 02:50–02:55 黄金区间，距 03:00 上限预留 6 秒安全缓冲）。

---

## 二、分镜头拍摄脚本（逐镜头详细执行表）

> **排版说明**：
> 1. 屏幕字幕均严格遵守每行不超过 18 字（中文全角）规范，单段至多 2 行。
> 2. 配音解说词均严格遵守不超过 2 句口语化表达规范。
> 3. 每个镜头明确对应物理按键操作时长与拍摄设备形态。

### 镜头 1：系统架构与硬件实物全貌 (00:00 - 00:10, 10s)
- **画面内容**：
  - 前 4 秒：后期合成异构系统框图动效（RK3568 PCIe 2-Lane 与 PG2L100H 高速桥接，PCIe、DDR3、HDMI 信号流动态点亮）。
  - 后 6 秒：手机双机位摇镜头拍摄硬件实物，特写展示 OK3568 底板与盘古 100Pro+ 插入 P29 槽位的双螺柱固定结构、外部双 12V 隔离电源线、三路 USB 摄像头与 HDMI 输出线。
- **屏幕叠加字幕**：
  - 行1：紫光同创FPGA+瑞芯微SoC
  - 行2：异构软硬协同车载ADAS系统
- **物理操作**：无操作（设备静置展示）。
- **解说词**：本系统基于紫光同创盘古100Pro+与瑞芯微RK3568构建。通过PCIe高速互联，实现端到端硬件零拷贝车载视觉处理。
- **拍摄方式**：后期合成 (0-4s) + 手机拍硬件 (4-10s, 4K60P 顺滑摇镜)。
- **失败预案**：若手机微距对焦虚化或走线杂乱，直接切为系统 3D 渲染爆炸图与清晰硬件俯视定妆照，镜头时长保持 10 秒不变。

---

### 镜头 2：断电冷启动与整屏模式选择 (00:10 - 00:24, 14s)
- **画面内容**：
  - 手机特写拍摄操作手按下总电源开关，LED 指示灯亮起。
  - 画中画切 HDMI 采集卡直录画面：全高清 1080P 显示器从黑屏迅速亮起，加载出整屏大图标二选一引导界面（左卡片「四路实时模式 4CAM」、右卡片「U盘视频流 USB」）。
  - 采集卡画面显示黄色高亮框随按键在左右两个大选项间自如切换，最后停在左侧进入。
- **屏幕叠加字幕**：
  - 行1：上电冷启动秒级就绪
  - 行2：按KEY0切换选择 按KEY1进入
- **物理操作**：
  - 00:10：机械开关上电。
  - 00:17：短按 KEY0（C22 引脚，约 0.2 秒），高亮框由左移至右。
  - 00:19：再次短按 KEY0，高亮框由右移回左。
  - 00:21：短按 KEY1（C23 引脚，约 0.2 秒），确认进入四路实时模式。
- **解说词**：系统支持断电冷启动秒级初始化，进入整屏引导菜单。驾驶员通过板载按键即可在实时监控与文件回放间快速切换。
- **拍摄方式**：手机拍硬件按键（画中画右下角 30% 画面） + HDMI 采集卡直录（主画面 70%）。
- **失败预案**：若 HDMI 显示器冷启动握手延时导致漏录启动画面，改用预先录制好的完整冷启动 1080P 视频段，重新对准手部按键动作剪辑合成。

---

### 镜头 3：四路实时多摄与弹窗交互 (00:24 - 00:52, 28s)
- **画面内容**：
  - 采集卡直录全屏四宫格画面（左上/右上/左下为 3 路真实 USB 摄像头环境视角，右下为 FPGA 片上硬件生成的高清测试信号流）。四路画面 30fps 流畅无撕裂。
  - 画面顶部快速滑出青色外框 OSD 调试弹窗（3×3 布局共 9 项：CAM1~3、NPU、LANE、VIEW、ZEBRA、USB VIDEO、NIGHT）。
  - 黄色光标跳转至「5 LANE」，车道线识别覆盖（绿色拟合多项式曲线）即刻浮现；光标切至「6 VIEW」，画面由彩色平滑切换为灰度图与二值化特征提取视图；切至「9 NIGHT」，演示夜间增强模式切换（AUTO/ON/OFF）。
  - 长按按键关闭弹窗并返回纯净四宫格监控。
- **屏幕叠加字幕**：
  - 行1：四路960×540满帧硬件排版
  - 行2：OSD弹窗即时开关算法图层
- **物理操作**：
  - 00:27：短按 KEY4（B20 引脚，约 0.2 秒），激发 3×3 OSD 配置弹窗。
  - 00:32：短按 KEY0 移动光标至 LANE 项（第 5 项），短按 KEY1 开启车道线（LANE:ON）。
  - 00:38：短按 KEY0 移动光标至 VIEW 项（第 6 项），连续两次短按 KEY1（COLOR → GRAY → BIN），展示硬件图像预处理。
  - 00:42：短按 KEY0 移动光标至 NIGHT 项（第 9 项），短按 KEY1 切换夜间增强模式（ON/OFF/AUTO）。
  - 00:46：长按 KEY4（约 1.2 秒），彻底关闭弹窗恢复整屏四宫格。
- **解说词**：四路视频由FPGA硬件流水线实时排版为四宫格，时延低于一毫秒。通过OSD弹窗可动态下发车道线拟合、夜间增强与视图特征切换指令。
- **拍摄方式**：HDMI 采集卡直录（主画面全屏展示）。
- **失败预案**：若现场摄像头因光照不足导致二值化噪点较多，在弹窗中仅切换至 GRAY（灰度）视图，跳过 BIN（二值）阶段；斑马线硬件核若在板上不稳定，禁止在弹窗中开启第 7 项「7 ZEBRA:ON」，保持其默认 OFF 状态。

---

### 镜头 4：U 盘模式与多路分屏播放 (00:52 - 01:21, 29s)
- **画面内容**：
  - 画面由实时流切回模式选择，进入 U 盘视频模式。
  - 屏幕呈现 CJK 点阵汉字渲染的中文文件管理器，列表中清晰显示包含中文字符的 MP4 测试文件名称（如「测试路段A_红绿灯.mp4」、「实线变道_路口.mp4」）。
  - 操作光标连续勾选 4 个测试视频，底部状态显示 `[1] [2] [3] [4]` 顺序分配，光标移至 `START` 启动播放。
  - 界面瞬间切入四路 MP4 视频同步分屏硬件解码回放；短按呼出 5 项播放弹窗（NPU/LANE/VIEW/ZEBRA/NIGHT）。
  - （新增扩展演示，≤10s）：若加载含 `112739.nav` 的测试视频，OSD 状态行呈现导航转向指令（标注：“模拟导航文件”），在标线虚线时放行变道、实线时拒绝；若混选暗化静态图，FPGA 硬件自适应夜间增强自动开启（标注：“合成暗化静态图”），暗部特征即刻拉伸。
- **屏幕叠加字幕**：
  - 行1：全自主CJK中文文件管理器
  - 行2：多路MP4视频并行分屏回放
- **物理操作**：
  - 00:54：在主菜单按 KEY0 切至右侧 U 盘图标，按 KEY1 进入。
  - 00:59：按 KEY0 下移光标，连续按 KEY1 依次选定 4 个待播视频。
  - 01:08：光标移动到底部 `START`，按 KEY1 执行并发回放。
  - 01:15：短按 KEY4，呼出播放中浮动状态菜单，展示回放中控制能力。
- **解说词**：系统内置全自主点阵中文字库与文件管理器，支持多路高清视频并行选取。SoC端硬件解码配合FPGA四通道DMA，实现流畅分屏回放。
- **拍摄方式**：HDMI 采集卡直录。
- **失败预案**：若现场热插拔 U 盘导致偶发未挂载，必须在录制前确保 U 盘格式化为 FAT32，且文件固定放置于 `/media/usb`；若选 4 个视频解码偶发掉帧，可勾选 2 个代表性视频分屏演示。

---

### 镜头 5：赛题测试 (1) 十字路口红绿灯判决 (01:21 - 01:49, 28s)
- **画面内容**：
  - 画面锁定前视主车道测试视频：自车接近十字路口，前方信号灯显示红灯。
  - 屏幕下方叠加的左转、直行、右转三组 24×24 矢量指示箭头实时更新；当前直行车道为红灯，直行箭头呈现鲜红色，状态寄存器 `0x850` 写入 `0x0C`（红灯停）。
  - 模拟驾驶员强行起步（闯红灯）：屏幕四周瞬间爆闪 2Hz 红色警示边框，状态字突变为 `0x10C`，声光告警同步激发。
  - 随后信号灯变绿，自车恢复行驶，屏幕边框红闪解除，直行箭头变为绿色通行（`0x08`）。
- **屏幕叠加字幕**：
  - 行1：红灯禁行直行箭头显红
  - 行2：闯红灯毫秒级全屏爆闪告警
- **物理操作**：
  - 01:23：短按 KEY0（C22）切换自车所在车道至中间直行车道。
  - 01:30：在红灯状态下短按 KEY1（C23，设置 `moving=1`），人为触发闯红灯违规状态。
  - 01:39：信号灯转绿后，再次短按 KEY1（保持 `moving=1`），恢复合规通行。
- **解说词**：纯C语言算法tl_det实现零内存分配的交通灯逐帧识别。当红灯违规行驶时，系统毫秒级触发全屏红色边框爆闪警示。
- **拍摄方式**：HDMI 采集卡直录（全屏） + 手机特写拍摄板载蜂鸣器/告警 LED 联动（画中画叠加）。
- **失败预案**：若现场视频交通灯受光照或反光影响偶发漏检，使用官方评测数据集黄金测试视频段（`7段评测集`），确保 `tl_det` 100% 检出率与准确决策。

---

### 镜头 6：赛题测试 (2) 虚实线变道合规监控 (01:49 - 02:14, 25s)
- **画面内容**：
  - 车辆行驶于多车道干道，左侧为白色虚线，右侧为连续双黄实线。
  - 驾驶员发出左转信号：屏幕左下角立即打出绿色通行箭头，决策引擎判定为合规变道（ALLOW）。
  - 车辆进入路口前实线区段，驾驶员发出右转信号：屏幕右侧箭头变为灰色保持（KEEP），禁止变道。
  - 驾驶员长按按键强行压实线变道：系统即刻判定违规压线，右侧箭头变为亮红，伴随红色闪烁边框报警（ALARM）。
- **屏幕叠加字幕**：
  - 行1：虚线变道放行 实线禁行拦截
  - 行2：强制压实线变道即刻触发告警
- **物理操作**：
  - 01:52：行至虚线段，短按 KEY2（B22，约 0.2 秒），触发左转向变道请求。
  - 01:59：驶入实线段，短按 KEY3（A22，约 0.2 秒），触发右转向变道请求。
  - 02:05：长按 KEY3（约 1.5 秒），强制注入右变道压线指令。
- **解说词**：车道线检测核实时感知标线物理属性。虚线区段允许自如变道，而实线强行变道将瞬间触发压线红色警告。
- **拍摄方式**：HDMI 采集卡直录。
- **失败预案**：若道路光影干扰导致局部线型置信度抖动，在测试脚本中微调地面消失点参数或选取标线清晰的标准测试片段，保证虚线与实线状态机严格翻转。

---

### 镜头 7：赛题测试 (4) 特殊障碍物与行人识别 (02:14 - 02:29, 15s)
- **画面内容**：
  - 画面切换至复杂交通场景：前方车道出现横穿行人与施工反光锥桶。
  - RK3568 板载 NPU 运行轻量化模型，在 17.55 ms 内锁定目标，FPGA 硬件图层在行人与锥桶外侧稳定打出黄色目标跟踪方框。
  - 当障碍物进入自车安全制动包络线，本车道上方立即叠加醒目红色危险制动箭头与警示提示。
- **屏幕叠加字幕**：
  - 行1：NPU 900MHz高速目标检测
  - 行2：障碍物侵限本车道红箭头告警
- **物理操作**：无须按键，算法实时流式推理检测。
- **解说词**：利用SoC端900兆赫NPU加速行人与锥桶检测，耗时仅17.55毫秒。障碍物侵限时自车道即刻亮起红色制动警示。
- **拍摄方式**：HDMI 采集卡直录。
- **失败预案**：若现场摄像头捕捉的活体障碍物在近距离边界触发不稳定，立即切换为提前在开发板验证通过的标准 MP4 道路评测片段，并在屏幕右上角诚实注明「预录视频测试」，确保画面目标框稳定不抖动。

---

### 镜头 8：核心性能指标与时序资源卡 (02:29 - 02:49, 20s)
- **画面内容**：
  - 后期制作具有科技感的全屏数据信息大屏（黑金风格图表），以清晰图表罗列实测关键参数：
    1. **PCIe 互联吞吐**：长传输实测 **896 MB/s**，四路视频并发总线负载仅 21.7%（余裕 >78%）。
    2. **四路并发吞吐**：四路 **960×540 @ 30fps** 零丢失满帧运转。
    3. **NPU 推理时延**：RK3568 NPU @ 900 MHz，平均单帧仅 **17.55 ms**。
    4. **FPGA 时序收敛**：全局 setup WNS = **+0.086 ns**，pix_clk 148.5 MHz 域 WNS = **+0.321 ns**，TNS 严格为 0，零违例。
    5. **片上资源占用**：LUT 36.1% (24064/66600)、FF 19.2% (25536/133200)、DRM 64.5% (100/155)、APM 25.8% (62/240)。
    6. **算法精度表现**：纯 C 交通灯 `tl_det` 黄金集 RAW 一致率 **100%**，动态内存分配严格为 0。
- **屏幕叠加字幕**：
  - 行1：PCIe吞吐896MB/s 余量超78%
  - 行2：pix_clk WNS+0.32ns 严苛时序零违例
- **物理操作**：无操作（数据图表动效展示）。
- **解说词**：系统实测PCIe双向带宽达896兆字节每秒，时序收敛裕量充足。算法全面摆脱第三方库依赖，实现极致轻量与高可靠。
- **拍摄方式**：后期合成（After Effects / 剪映专业版 1080P 高清动态信息图）。
- **失败预案**：此镜头为纯后期数据资产卡，数据源严格来自已归档的测试记录与 `技术文档_草稿.md`，无硬件断连风险。

---

### 镜头 9：片尾总结与队伍信息 (02:49 - 02:54, 5s)
- **画面内容**：
  - 科技感淡出画面，居中展示项目全称：「2026年全国大学生嵌入式芯片与系统设计竞赛——紫光同创选题三车载视觉处理系统」。
  - 屏幕下方列出参赛队名占位符 `[参赛队伍名称 / 高校名称]` 与构建版本 `Bitstream cam18 (0x20261101)`。
- **屏幕叠加字幕**：
  - 行1：软硬协同 构筑安全车载视觉
  - 行2：[参赛队名占位]
- **物理操作**：无。
- **解说词**：软硬协同，构筑高可靠车载视觉中枢。感谢各位评审专家观看！
- **拍摄方式**：后期合成。
- **失败预案**：无，直接使用预渲染模板。

---

## 三、录制前物理与电气检查清单（严格 18 条）

> 必须在开机录制前按序逐一核对打勾，任何一项不满足严禁开机拍摄。

- [ ] **1. 板卡机械紧固**：盘古 100Pro+ 与 OK3568 底板间的双螺柱必须完全拧紧定位，严防晃动。
- [ ] **2. P29 插槽金手指防护**：确认卡已垂直插到底，**严禁在通电状态下触碰、扳动 P29 插槽或插拔板卡**。
- [ ] **3. 供电树独立隔离**：FPGA 必须使用独立 12V 适配器供电，RK3568 使用原装 12V 适配器，地线可靠共地。
- [ ] **4. 开机上电时序**：严格执行「**先开 FPGA 电源加载固件，后开 RK3568 电源启动系统**」原则。
- [ ] **5. FPGA Flash 固件版本确认**：串口读取 `0x838` 寄存器值应为 `0x20261101`（cam18 提交位流；若 Flash 暂为 cam17 则为 `0x20261029`）。
- [ ] **6. PCIe 链路速率检查**：进入系统执行 `lspci -vvv`，确认链路状态锁定在 `5.0 GT/s, width x2`（Gen2 x2）。
- [ ] **7. U 盘物理格式与分区**：U 盘格式化为标准 FAT32，卷标为纯英文，插入 RK3568 USB 3.0 高速口。
- [ ] **8. U 盘演示测试素材齐备**：根目录下放置 `test_1.mp4`、`test_2.mp4`、`test_3.mp4`、`test_4.mp4`（1080P/720P H.264 基线编码）及中文命名测试文件各一份。
- [ ] **9. 三路 USB 摄像头连通性**：插入指定 USB 口，通过 `ls /dev/video*` 确认识别出 3 组视频节点且镜头保护膜已撕除。
- [ ] **10. 镜头采光与反光控制**：摄像头前视测试车道模型摆放平整，避免现场顶灯直接照射引发过曝反光。
- [ ] **11. HDMI 信号传输稳定性**：使用高屏蔽 HDMI 2.0 线缆连接盘古开发板 HDMI TX 口至视频采集卡。
- [ ] **12. HDMI 采集卡参数锁死**：采集卡 EDID 设置为固定 1920×1080@60Hz，严禁开启自适应缩放或 HDR。
- [ ] **13. OBS 录制参数校验**：录制分辨率严格为 1920×1080，帧率锁定 60 fps，编码器设为 NVENC 或 CPU H.264，码率锁定 12 Mbps CBR，音频采样率 48 kHz。
- [ ] **14. 颜色空间与范围**：采集软件中配置视频格式为 NV12 或 YUY2，色彩空间 BT.709，色彩范围 Full。
- [ ] **15. 实体按键响应测试**：开机前测试 KEY0–KEY4 机械弹性，消抖电平切换正常，无连键粘连。
- [ ] **16. 录制脚本与按键序列张贴**：将按键操作时间表打印并贴在录制机位旁，确保按键人与录屏人读秒同步。
- [ ] **17. 辅助机位手机参数设置**：副机位手机固定于三脚架，开启 4K 60fps 模式，锁定曝光与对焦（AE/AF LOCK）。
- [ ] **18. 静电与现场环境**：录制人员佩戴防静电手环，桌面远离大功率射频或电机干扰源。

---

## 四、高风险镜头现场处置与剪辑备选预案

| 风险序号 | 涉及镜头 | 现场潜在故障现象 | 根因与规避策略 | 剪辑备用方案 (Plan B) |
| :---: | :--- | :--- | :--- | :--- |
| **R1** | 镜头 3 (四路实时) | 斑马线识别核在板上不稳定，画面出现跳变噪点。 | 硬件加速核特定光照下误触发。在 OSD 弹窗中**禁止开启第 7 项「7 ZEBRA:ON」**，保持 OFF。 | 剪辑时完全不切入斑马线特写，仅一句话带过「系统保留了全硬件斑马线感知接口」，主画面聚焦四路流畅排版。 |
| **R2** | 镜头 7 (行人/锥桶) | 现场活体行人近距离经过时，NPU 检出框抖动或未达触发阈值。 | 镜头焦距及环境照度导致置信度低于阈值。代码已实现，但近距离触发待现场确认。 | **立即使用预录测试视频方案**：切入已在 RK3568 端验证完毕的行人测试 MP4 片段，字幕右上方添加小字「预录实测」，绝不强行摆拍。 |
| **R3** | 镜头 5 (红绿灯判决) | 摄像头拍摄模型红绿灯时，因发光二极管频闪导致 `tl_det` 偶发识别跳变。 | LED 脉冲调制与摄像头快门产生拍频条纹。 | 调整摄像头曝光时间或直接切换至 U 盘回放模式播放官方标准评测序列，确保红/黄/绿与 0x0C/0x10C 告警 100% 精确复现。 |
| **R4** | 镜头 2 (冷启动) | P29 金手指插拔受力，导致开机冷启动 PCIe 链路偶发降级或训练失败。 | P29 槽位机械敏感度高，插卡微动导致接触电阻异常。 | 录制期间绝对严禁触碰板卡；若冷启动偶然失败，重启两板并在后期将成功的冷启动片段平滑拼接，不得强行录制异常态。 |
| **R5** | 镜头 4 (U盘回放) | 插入劣质 U 盘或 NTFS 格式导致无法挂载，提示「未检测到 U 盘」。 | 嵌入式 Linux 内核驱动与分区格式限制。 | 必须使用检查清单中已格式化为 FAT32 的专用测试 U 盘；若现场无法识别，直接使用板载 `/userdata/quad/` 预置的 MP4 文件执行演示。 |

---

## 五、后期剪辑合成与音画包装规范

### 1. 视频画质与编码标准
- **分辨率**：标准 1080P（1920 × 1080 逐行扫描，宽高比 16:9）。
- **编码格式**：H.264 / AVC（High Profile, Level 4.2），封装格式 MP4。
- **视频码率**：动态码率 VBR 8–12 Mbps（目标码率 10 Mbps，峰值码率 15 Mbps）。
- **帧率**：严格 60.00 fps（不得使用可变帧率 VFR）。
- **像素格式**：YUV 4:2:0（8-bit）。

### 2. 字幕排版与视觉标识规范
- **中文字体**：思源黑体（Source Han Sans CN Bold）或 微软雅黑 Bold。
- **英文字体**：DIN Alternate Bold 或 Arial Bold。
- **主标题字号**：42 pt，纯白（#FFFFFF），加 2 像素 40% 黑色投影（平滑柔和）。
- **正文字幕字号**：32 pt，文字居中，行宽限制在 **18 个汉字以内**，底部边距 80 像素。
- **数据标注卡与高亮字**：高亮重点数据使用竞赛青色（#00E5FF）或琥珀金（#FFB300）。

### 3. 音频设计与旁白要求
- **音频轨配置**：立体声双声道（Stereo），采样率 48 kHz，AAC-LC 编码，码率 256 kbps。
- **配音旁白**：录音棚级清晰解说，男中音或女声沉稳专业，解说音量电平控制在 **-6 dB 至 -3 dB** 之间，去底噪、压限处理。
- **背景音乐 (BGM)**：选用科技感、快节奏、具有前进动力的轻度电子音乐（如 Tech Minimal / Deep Ambient）；BGM 音量必须全程压低至 **-20 dB 至 -24 dB**，严禁掩盖人声。
- **音效提示**：在告警边框爆闪（01:32、02:08）瞬间，叠加短促微弱的雷达警示音效（Buzzer SFX）。

### 4. 镜头转场与时间轴纪律
- **转场方式**：以硬切（Cut）为主，部分模块过渡使用极速交叉溶解（Cross Dissolve，不超过 0.3 秒），杜绝炫目三维翻转特效。
- **严守时限**：成片绝对时长控制在 **02:54:00**（误差不得超出 ±0.5 秒），严禁突破 03:00 比赛红线。

---

## 六、功能边界与明确禁录声明

> 依据比赛命题要求与现有工程真实已验证记录，以下内容**严禁出现在演示视频中**：

1. **导航功能规范（路线文件驱动）**：
   - 现状：当前导航变道决策基于 `.nav` 路线引导文件（模拟导航模块输出）驱动，中控屏小地图图标视觉解析与全局路径规划尚未部署。
   - 规范：导航只允许以“模拟导航文件（路线文件驱动）”的名义出现，禁止说成真实导航/小地图识别/路径规划；解说词不得提倡未开发功能。
2. **绝对禁录物理刹车执行器控制**：
   - 现状：系统决策通过寄存器 `0x850` 完成亚毫秒级声光告警与屏幕警示，未连接实际底盘线控刹车电机。
   - 规范：不得宣称「已实现物理线控刹车制动」，一律统一口径为「车道级声光安全预警与制动提示」。
3. **审慎对待斑马线硬件核**：
   - 现状：`rt_zebra` 硬件加速核目前板上测试存在微小稳定性抖动，正在工程优化中。
   - 规范：仅在四路实时菜单中作为调试视图展示一次，解说词不作展开，若拍摄时偶发异常则直接移出镜头，严禁当作主打成熟功能宣传。
4. **诚实注明检测输入源**：
   - 针对行人与复杂障碍物检测，若使用本地录制测试视频流验证 NPU，必须在字幕中明确标注「测试样本回放测试」，体现严谨求实的工程素养。

---

## 总体校验

- **视频规划总时长**：174 秒（02分54秒）
- **时间码累计一致性**：00:00 → 00:10 → 00:24 → 00:52 → 01:21 → 01:49 → 02:14 → 02:29 → 02:49 → 02:54（自洽无空隙，段时长与总时长完全相等）
- **镜头数量**：9 个分镜段落（覆盖系统框图、开机引导、四路实时、U盘回放、红绿灯判决、变道监控、行人识别、性能卡、收尾）
- **六大板块完整性**：一总体规划、二分镜头脚本、三检查清单、四失败预案、五后期规范、六禁录声明，全项具备。
