Zdy-1110/FPGA-676/docs/答辩要点_评委问答.md

# 答辩要点与评委问答

> 用法：现场答辩按“结论 → 数据 → 边界”三句话回答；每个数字都能在正文/附录找到出处。
> 原则：不知道就说不知道，未实测就说未实测；不要用“应该”“大概”替代数据。

## A. 30 秒开场（背下来）

“我们做的是紫光同创 PG2L100H + RK3568 的软硬协同 ADAS 演示平台。FPGA 负责多路视频汇聚、四宫格显示、车道线与斑马线硬件流水线；RK3568 负责硬解、NPU 检测和决策。PCIe Gen2 ×2 实测 896 MB/s，四路 960×540@30fps 只占用约 21.7% 带宽；NPU 900 MHz 单帧 17.55 ms；整机从开机到选择界面全自动，现场用 5 个按键完成全部操作。”

## B. 高频问题

### Q1 为什么用 FPGA + RK3568，纯 SoC 不行吗？
- **结论**：纯 SoC 能做，但四路并发时 CPU/NPU 会被搬运和显示合成吃掉，延迟和抖动不可控。
- **数据**：FPGA 侧 DDR3 400 MHz、四组独立 FIFO + round-robin，四路 30fps 连续运行无撕裂；PCIe 只占 21.7% 带宽。
- **边界**：我们不是要替代量产 SoC，而是验证“异构分工”的工程可行性。

### Q2 PCIe 为什么只有 Gen2 ×2？带宽够吗？
- **结论**：受 OK3568 P29 插槽与 FPGA 端点 IP 限制，稳定跑在 Gen2 ×2；带宽足够。
- **数据**：长传输 896 MB/s、反向 861 MB/s；四路 RGB888 满载 186.6 MB/s，占 21.7%；RGB565 14.5%，NV12 10.8%。
- **边界**：再提高需要改硬件走线/端点 IP，不在本期范围。

### Q3 四路 1080p 怎么做到 30fps？
- **结论**：摄像头 MJPEG → MPP 硬解 → RGA 缩放到 960×540 → 门铃 DMA 直推 FPGA，全程不经过 CPU 内存拷贝。
- **数据**：三路 USB 摄像头采集 87–90 fps，显示节拍 30 fps；PCIe 单帧传输 1.2 ms。
- **边界**：4 路 1080p 解码时 CMA 紧张，选 3 路以上时把 `--dec-bufs` 降到 8（代码里已按选片数自动设置）。

### Q4 端到端延迟到底多少？
- **结论**：**整链（传感器曝光→HDMI）尚未实测**，这是本期明确留下的缺口。
- **数据**：已实测分段——PCIe 单帧 1.2 ms、4 KB 读请求往返约 1.8 µs、MMIO 单周期、显示 60 fps；四路连续 5 分钟无丢帧/撕裂。
- **边界**：复位后会补“秒表 + 高速相机”的整链标定；文档第十一章 11.1b 已写明。

### Q5 车道线为什么用硬件而不是 NPU？
- **结论**：车道线是逐行几何问题，硬件流水线延迟确定、不占 NPU；NPU 留给语义目标。
- **数据**：单遍光栅、无整帧缓存、16 周期除法、EMA 平滑；5 组向量 `row_mismatch=0`，12 个关键字段核验，门级 42 帧。
- **边界**：32 用例模型级通过 16/32，瓶颈是虚实线/双黄线分类，不是拟合。

### Q6 16/32 的通过率是不是太低？
- **结论**：这是**参考算法同口径**的结果（参考 17/32），差距 1 例；失败集中在类型判定，不是车道线位置。
- **数据**：失败 16 例中 12 例是类型判定偏差、4 例是决策表决抖动、0 例无候选点、0 例拟合偏差。
- **边界**：类型判定用线宽/占空比先验，遇到磨损、阴影、双黄线会混淆；下一步用时序投票或小 CNN 分类。

### Q7 斑马线为什么板端不稳？
- **结论**：几何先验太严 + 遮挡，导致整行被判废。
- **数据**：112454 每帧只有 2–5 行满足全部条件（`r_min=3`，本身临界）；113539 前车遮挡产生约 330 px 间隙，超过 `gap_max_w=100`，所以 0 检出。
- **边界**：模型扫描显示放宽到 400 能救回 88.2%，但瓦楞板负样本开始误报，因此**保持 100，不接入告警**；另发现 `0xA2C` 因总线连线错位实际不可调（附录 B.8），已在第十一章写明。

### Q8 NPU mAP50 只有 66%，能用吗？
- **结论**：这是 9 类里 5 类有标注的验证集结果，不能按 COCO 的 80 类口径对比；演示场景够用。
- **数据**：mAP50 66.05%、mAP50-95 47.59%、AR 72.3%（验证集 73 帧）；900 MHz 17.55 ms。
- **边界**：验证集中 tricycle/cone/barrier/speed_limit 4 类没有 GT，精度无法量化；这也是我们没把 barrier 纳入刹车判定的原因。

### Q9 红绿灯为什么不用 CNN？
- **结论**：固定机位下颜色 + 形状 + 时序滤波更稳、更省、可解释。
- **数据**：2678 帧 RAW 100%、独立 SIG 97.20%、SIG 用例 63/69（91.3%），单帧 4–6 ms、0 malloc。
- **边界**：夜间/强逆光未覆盖；`tl_det` 假设画面里有明确的灯组区域。

### Q10 菜单按键会不会和驾驶状态打架？
- **结论**：会，这是我们在联调中发现的真实问题，已经用软件基线抵消。
- **数据**：FPGA 里 KEY0 短按切车道、KEY1 短按切启停；菜单又用 KEY0/KEY1 导航。`adas.c` 记录开播瞬间的基线，用 `lane_eff=(raw-base+1+3)%3`、`moving_eff=raw^base`；弹窗关闭时发 `SIGUSR1` 重置。
- **边界**：这是软件规避，根治要改 RTL 的按键分发；许可证窗口内不改。

### Q11 返回选择界面时 DMA 卡死，怎么解决？
- **结论**：根因是旧 feed 未彻底退出/门铃队列残留；已从三处加固。
- **数据**：子进程 `setpgid` 成组、`SIGTERM` 轮询 2 s 后 `SIGKILL` 并 `waitpid`；`mode_select` 推图前等 `0x1C8` 静止 100 ms（最多 2 s），超时重试 3 次；`run_boot` 连续失败 3 次才退出，S99 再包一层守护。
- **边界**：**未上板复测**，板子回来第一件事就是连续 5 次“实时→选择界面”验证。

### Q12 4 路 U 盘播放怎么保证不 OOM？
- **结论**：按选片数量自动降解码缓冲，并预分配 CMA。
- **数据**：`--dec-bufs` 在选 3 路及以上时为 8，否则 10；CMA 预留 256 MB；四路 960×540 输出缓冲固定复用。
- **边界**：4 路同时播放尚未由用户在板上确认，是上板验证项。

### Q13 中文文件名怎么显示？测试 U 盘语言不可预测怎么办？
- **结论**：预生成 GBK 位图字库，运行时按 UTF-8 码点二分查找，不依赖系统字体。
- **数据**：21,791 字、26×26、2.33 MB；ASCII 用 15×30 字模；缺字退化为 `?`，不崩。
- **边界**：4 字节生僻字/emoji 会退化；文件名过长按显示宽度截断。

### Q14 现场演示怎么保证不翻车？
- **结论**：三层兜底 + 明确的操作规范。
- **数据**：S99 守护循环；`run_boot` 3 次重试；`mode_select` 推图 3 次重试；KEY4 长按 3 s 返回开机界面，按住 10 s 才进调试/标定层；P29 插槽不热插拔。
- **边界**：FPGA 位流对外以 cam18（0x20261101）为准；若现场 Flash 仍为 cam17（0x20261029），除 NIGHT 项无效外其它功能不受影响，现场不重烧。

### Q15 你们的创新点到底是什么？
- **结论**：不是算法首创，而是“把多路视频 + 硬件视觉 + NPU + 交互”在国产 FPGA 上做成可现场演示的闭环。
- **数据**：896 MB/s、21.7% 带宽、pix_clk WNS +0.321 ns、LUT 36.1%、17.55 ms、2678 帧 100%。
- **边界**：单点算法指标不是 SOTA，工程整合与可复现性是优势。

### Q16 和量产 ADAS 差多远？
- **结论**：差在传感器、功能安全、执行器与数据闭环，不在“能不能跑”。
- **数据**：我们只有 3 路 USB + 1 路 FPGA 相机；没有 CAN/线控；没有车规认证。
- **边界**：定位是教学/竞赛验证平台，不是量产件。

### Q17 为什么没有自动刹车？
- **结论**：没有线控底盘和 CAN 执行器，物理上做不到。
- **数据**：软件已实现近距危险目标 → 本车道红箭头 + bit8 全屏告警（person/rider/cone/barrier，score≥0.30、底边≥75%、中心 30–70%；移动中车辆类亦纳入）。
- **边界**：车辆/路障报警正向触发未在板上实测验证（测试视频无 cls 7，且测试未按键 moving_eff=0）；告警≠制动，答辩时明确说“预警闭环”，不说“AEB”。

### Q18 导航功能没做，怎么回应？
- **结论**：部分实现：路线文件驱动的模拟导航示例；小地图视觉识别与路径规划未实现。
- **数据**：112739 上 15 条真值，离线 NCC 原型 53.3%（right 25%/left 80%/uturn 100%），低于 70% 可用线；失败原因是手持漂移 >230 px、玻璃反光、卡片背景变化。
- **边界**：现场把带导航视频当普通道路视频处理，前视红绿灯/车道线/障碍物正常跑。

### Q19 LUT 才 40%，余量准备做什么？
- **结论**：留给双目标定/立体测距与更多视觉核；当前优先保时序余量。
- **数据**：LUT 24,064/66,600 (36.1%)、FF 25,536/133,200 (19.2%)、DRM 100/155 (64.5%，较紧)、APM 62/240 (25.8%)；pix_clk WNS +0.321 ns（全局最差 +0.086 ns，TNS 0）。
- **边界**：DRM 63.8% 是下一个瓶颈，加核前要先算 BRAM。

### Q20 如果现场 U 盘只有图片怎么办？
- **结论**：已支持 jpg/png/bmp 作为静态帧循环播放，和 mp4 可混选。
- **数据**：`usb_feed --still` 解一帧后按 30 fps 循环推；usb_menu 同时列出图片与视频，按选择顺序填 1–4 格。
- **边界**：图片解码走 GStreamer `decodebin`，依赖板端插件；已于 10-30 完成板端实测验证（静态图片推流与按键基线，详见 `docs/提交清单与待办.md:21-31`）。

### Q21 怎么证明这些数字不是编的？
- **结论**：全部可复现，附录 B 给了命令与结果。
- **数据**：交通灯 2678 帧逐帧复现；车道线 16/32 复现；斑马线 93.4% 复现；门级仿真 42 帧；`python tools/selftest.py` 一键构建与文档检查。
- **边界**：板端相关指标（帧率、温度、DMA）以历史日志为准，本次未重测。

### Q22 成本与功耗？
- **结论**：FPGA + RK3568 两块板，功耗未做整机实测。
- **数据**：RK3568 5 分钟 900 MHz 浸泡 46.7–48.3 °C；FPGA 资源如上。
- **边界**：没有功率计数据，不猜瓦数。

## C. 现场演示顺序（2 分钟版）

1. 冷启动 → 选择界面（10 s）
2. 四路实时 → 弹窗开车道线 → 切灰度/二值（25 s）
3. 回选择界面 → U 盘 → 选 3 个视频 → 播放 → 弹窗（35 s）
4. 红绿灯：切直行、红灯停、闯红灯告警、绿灯行（30 s）
5. 变道：虚线允许、实线拒绝（20 s）

## D. 不要说的话

- “完全实时/零延迟”（我们只有分段实测）
- “四路都验证过无欠载”（`0x82C` 只统计窗口 0）
- “斑马线已经能用”（板端不稳，未接告警）
- “支持自动刹车”（只有预警）
- “导航已实现”（只有离线原型，53.3%）
