Zdy-1110/FPGA-676/docs/技术文档_大纲.md

# 2026 嵌赛紫光同创杯选题三：车载 ADAS 系统技术文档编制大纲与执行指南

> **文档定位**：本大纲为正式技术报告的顶层设计蓝图，定义了报告的章节树、各节撰写目标、核心技术论点、图表规划、数据出处及代码事实一致性核对规则，供后续分章节填充编写。  
> **适用赛题**：2026 年全国大学生嵌入式芯片与系统设计竞赛——紫光同创杯 选题三（以紫光同创 FPGA 为核心的高级辅助驾驶系统）  
> **硬件平台**：紫光同创盘古 100Pro+ (PG2L100H-6FBG676) + 飞凌嵌入式 OK3568-C (RK3568)  
> **编制基准**：基于初稿 `docs/技术文档_草稿.md`（Draft v1.0）及仓库软硬件实际实现与测试日志梳理  

---

## 零、核心亮点预览 (Executive Summary)

*本节置于正式技术文档卷首（第 1 页），紧扣赛题“含核心亮点预览”要求，以 8 条“核心结论 + 权威实测数字”直观呈现作品核心竞争力：*

1. **工业级高可靠 PCIe 异构高速互联通道**：打通盘古 100Pro+ 插接 OK3568 P29 槽位的 PCIe Gen2 x2 链路，实测板卡到主机长传输吞吐达 **896 MB/s**（主机到板卡实测峰值 **861 MB/s**），在 5 分钟 485 轮双向交替压力测试中取得 **0 失败、PCIe AER 与 RAS DES 硬件错误严格为 0** 的优异表现（出处：`PCIe_DMA提速_20261018.md:200-201`）。
2. **端到端纯硬件零拷贝多路视频中枢**：独创“MPP 硬件解码 $\rightarrow$ RGA 2D 派生 $\rightarrow$ 门铃 DMA 触发 $\rightarrow$ FPGA DDR3 帧存 $\rightarrow$ 四宫格硬件排版”全链路，四路 960×540@30fps 并发推流在 RGB565 格式下仅占用 **124.4 MB/s** 总线带宽，**对 861 MB/s 实测峰值负载仅为 14.5%**（原始 RGB888 占 **21.7%**），CPU 内存搬移与画面撕裂开销彻底归零（出处：草稿 §4.2，`PCIe_DMA提速_20261018.md:204`）。
3. **纳秒级时序收敛与高紧凑片上资源平衡**：最新 cam11 固件在包含车道线、斑马线及四路视频 Hub 满载工况下，全局建立时间最差余量 **Setup WNS = +0.340 ns (340 ps)**（`pix_clk` 148.5 MHz 域），总负余量 TNS 严格为 **0.000 ns**；以精简资源（**LUT 40.0%、FF 19.3%、DRM 63.8%、APM 25.4%**）实现单片高密度集成（出处：`build_cam11_s1.log:20529, 20551-20577`）。
4. **NPU 深度量化与频点极限能效调优**：部署定制 $960 \times 320$ 车载带状视野 YOLOv6n INT8 模型（`b5_v6n_band.rknn`），超频运行于 900 MHz 最大频点，**单帧推理耗时中位数降至 17.55 ms**（较 600 MHz 降低 **12.9%**）；5 分钟浸泡压测板温稳定在 **46.7–48.3 °C** 且硬件 `0x82C` 欠载计数恒为 **0**（出处：`log/npu_freq_20261029.md:21, 27-29`）。
5. **零依赖极低开销纯 C 交通信号灯引擎**：完全脱离 OpenCV 等重型视觉库，纯 C99 实现 `tl_det` 单帧运算 0 动态内存分配（**0 malloc/free**）；在 7 段官方评测视频共 2678 帧全量数据集上实现 **检测级 RAW 100.00% (2678/2678) 逐帧对齐**，官方 SIG 用例通过数达 **63 / 69 (91.3%)**（出处：`tools/adas/host_test/report.md:33, 67`）。
6. **单遍光栅流式车道线硬件加速核**：提出无整帧缓存的在线定点最小二乘与 EMA 平滑流水线 `rt_lane_det`，在 5 组基准向量集仿真中**逐行比对全部通过 (row_mismatch = 0) 并核验 12 个关键字段**，门级网表后仿真成功跑通真实路面采样的 **42 帧**时序反标核验（出处：`log/lane_fpga/vectors/README.md:13`）。
7. **嵌入式人机交互与全功能 U 盘启动系统**：自主开发轻量级中文 GUI 与 26×26 GBK 点阵字库引擎（`ui_cjk.bin`），构建开机二选一界面（`mode_select`）、实况监控参数浮窗（`menu_daemon`）与现场 U 盘多格式视频浏览器（`usb_menu`），全系统脱离键盘鼠标、纯靠板载 5 物理按键与 MMIO 闭环控制（出处：`tools/menu/mode_select.c:388`，`tools/menu/usb_menu.c:1461`）。
8. **亚毫秒级声光安全预警闭环响应**：通过单个 32 位 MMIO 寄存器（`0x850`）单周期控制字映射（实测 **`0x0C` 红停、`0x10C` 闯红灯爆闪、`0x08` 绿行**），当视觉检出近距危险障碍物时即刻置位自车道红箭头与 bit8 报警标志，实现 **<1.2 ms** 的硬件级告警直推与全屏鲜红边框闪烁（出处：`tools/usb_feed/adas.c:250-253`，`PCIe_DMA提速_20261018.md:204`）。

---

## 一、总体结构与章节树

正式技术文档划分为 **12 个正式章节**，保留草稿已有 10 章主体结构，并将人机交互与启动系统独立成章，章节规划如下：

```text
文档结构章节树：
├── 零、核心亮点预览 (Executive Summary，1页)
├── 一、赛题任务与测评标准逐条对照表 (Contest Checklist)
├── 二、系统概述与整体设计 (System Overview)
├── 三、硬件平台与电气机械架构 (Hardware Platform & Architecture)
├── 四、FPGA 片上加速系统设计 (FPGA Accelerated System)
├── 五、软硬协同高速低时延数据流体系 (Hardware-Software Dataflow)
├── 六、人机交互与多模式启动系统 (HMI & Multi-mode Boot System) [新增]
├── 七、RK3568 边缘计算与 ADAS 决策软件栈 (Edge Computing & ADAS Decision)
├── 八、系统关键实测性能数据全景表 (Performance Benchmark Tables)
├── 九、全流程软硬件协同验证方法体系 (Verification & Validation System)
├── 十、赛题四项测试方式的实现与现场演示步骤 (Test Modes & Demonstration)
├── 十一、已知局限性与工程说明 (Limitations & Engineering Notes)
└── 十二、核心亮点与创新点总结 (Key Innovations Summary)
```

---

## 二、赛题任务与测评标准逐条对照表

*本节对照 2026 嵌赛紫光同创选题三指南（`contest_pymupdf.txt:362-466`），逐项核验系统达成状态：*

| 赛题要求类别 | 赛题指南原文任务描述 | 本系统技术实现方案 | 达成状态 | 报告对应章节 |
| :--- | :--- | :--- | :---: | :---: |
| **基础任务 1** | **图像采集与显示**：HDMI/摄像头视频输入接口，LCD/HDMI 输出，完成采集-处理-显示闭环，道路环境感知。 | 前向 FMC/回放 + 3 路 UVC USB 摄像头输入；FPGA MS7210 驱动 HDMI 1080P@60Hz 输出；全流程闭环感知。 | **完成** | 第三章、第四章 |
| **基础任务 2** | **软硬协同通信**：设计并实现 MCU 与 FPGA 高速通信机制（如 PCIe），完成数据交互与指令控制。 | PCIe Gen2 x2 链路，DMA 长传输实测 896 MB/s；MMIO 门铃触发与双向寄存器配置。 | **完成** | 第三章、第五章 |
| **基础任务 3** | **图像处理与识别**：基于 FPGA 实现系统对道路周围环境的监测和特定场景的感知。 | FPGA 硬件流式 `rt_lane_det` 车道线检测、`rt_zebra_det` 斑马线特征检测、DISP_CTRL 灰度/二值化滤镜。 | **完成** | 第四章 |
| **高阶任务 1** | **多路图像采集与低延迟传输**：至少四路视频流并行采集与低延迟传输，优化数据流带宽。 | 四路 960×540@30fps 并发，PCIe 总线负载仅 14.5%（RGB565）；DDR3 Hub 独立 Commit 机制。 | **完成** | 第五章 |
| **高阶任务 2** | **复杂应用场景构建**：针对特定交通场景（夜间道路、复杂路口），构建完整感知和避障功能。 | 复杂路口信号灯识别与虚实车道线决策完成；近距障碍物触发红箭头与全屏报警；夜间低照度算子未开发。 | **部分完成** | 第四章、第七章、第十一章 |
| **高阶任务 3** | **AI 模型部署与实时识别**：在 MCU 端部署轻量级 AI 模型，实现多路视频实时识别和自主道路规划。 | RK3568 NPU 部署定制 YOLOv6n INT8（`b5_v6n_band.rknn`），900 MHz 下 17.55 ms；未开发全局路径规划。 | **部分完成** | 第七章、第十一章 |
| **测试方式 (1)** | **十字路口场景**：红灯停、绿灯行、红灯强行报警；图像叠加箭头（左/直/右）；按键切换车道与启停。 | C99 `tl_det` 逐帧检测；KEY0 切车道、KEY1 切启停；DECISION 寄存器控制 24×24 矢量箭头与全屏爆闪。 | **完成** | 第七章、第十章 |
| **测试方式 (2)** | **车道线与变道合规**：虚线变道、实线直行、强制实线变道报警；叠加箭头；按键模拟转向。 | `rt_lane_det` 实时提取线型；KEY2/KEY3 短按转向灯、长按强制变道；实线强制变道触发声光报警。 | **完成** | 第四章、第十章 |
| **测试方式 (3)** | **带导航真实道路视频模拟智驾**：根据导航完成模拟智驾。 | 系统专注于底层视觉感知与规则决策，未开发内嵌导航小地图图标 OCR 解析算法；退化为常规道路监测。 | **未实现** | 第十章、第十一章 |
| **测试方式 (4)** | **特殊应急场景**：行人闯红灯刹车、障碍物等；现场评测用 U 盘提供测试场景。 | NPU 实时检出行人/骑行者/锥桶等，近距危险触发红箭头与告警位；无底盘线控物理刹车；支持 U 盘多格式播放。 | **部分完成** | 第六章、第七章、第十章 |
| **现场评测要求** | **U 盘评测支持**：现场用 U 盘提供所有或 1~4 种测试场景数据集。 | 专门开发 `usb_menu`，支持 U 盘自动挂载、GBK 中文文件列表浏览、多格式视频播放与实时 ADAS 处理。 | **完成** | 第六章、第十章 |

---

## 三、各章节详细大纲条目

### 第一章：系统概述与整体设计
- **本章目标**：系统阐述项目研发背景、赛题任务定位、软硬协同异构设计思想及系统顶层全景架构。
- **章节核心要点**：
  1. 车载 ADAS 系统在实际道路工况下面临的“高并发视频吞吐、纳秒级流水线低时延、严苛时序收敛与高可靠性决策”综合挑战；
  2. 紫光同创盘古 100Pro+（PG2L100H）与瑞芯微 RK3568 异构架构的分工范式：SoC 负责 NPU 推理与高层调度，FPGA 承担流水线机器视觉与四路视频集中排版；
  3. “控制走 MMIO，数据走零拷贝 DMA，显示走全硬件流水线”的核心系统设计哲学；
  4. 多传感器视频接入拓扑：3 路 UVC 高清 USB 摄像头 + 1 路 FMC/回放源，MS7210 芯片驱动 1080P@60Hz HDMI 实时输出闭环；
  5. 系统开机多模式工作流与状态机宏观概述。
- **规划图表/素材**：
  - 图 1-1：系统总体硬件互连与协同拓扑框图【框图，需重画】
  - 图 1-2：软硬协同数据分流与控制流向总图【流程图，需重画】
- **权威数据出处**：草稿行 28–62；`docs/技术文档_草稿.md:36-58`。

---

### 第二章：硬件平台与电气机械架构
- **本章目标**：深入阐述异构计算平台选型依据、高速 PCIe 物理互连拓扑以及严苛的现场电气机械工程规范。
- **章节核心要点**：
  1. 紫光同创盘古 100Pro+（PG2L100H-6FBG676）硬件规格：99,600 LUT/FF 等效逻辑单元、GTP 高速收发器、板载 32-bit DDR3 内存；
  2. 飞凌嵌入式 OK3568-C 单板计算机规格：四核 Cortex-A55、1.0 TOPS 算力自研 NPU、RGA 2D 硬件图形引擎、2GB LPDDR4；
  3. OK3568 P29 PCIe 插槽链路拓扑：协商为 PCIe Gen2 x2（5.0 GT/s，2 物理通道），有效载荷最大传输单元 MPS 设置为 256 字节；
  4. 多路视频输入子系统（前向 FMC 子卡通道与 3 路 USB 摄像头）及 HDMI 1.4b（MS7210 芯片，`pix_clk = 148.5 MHz`）物理输出通道；
  5. 关键供电树隔离与防反灌工程约束：盘古板由独立 DC 12V 稳压源供电，严禁仅依赖 PCIe P29 供电，两板共地并先供电 FPGA 后上电 SoC；
  6. P29 插槽机械固定工程约束：采用双螺柱硬质定位背板，规避触点擦伤与阻抗失配；
  7. Linux 内核连续物理内存 CMA 扩容工程：由默认 16 MB 成功扩容至 256 MB（基址 `0xDDC00000`）。
- **规划图表/素材**：
  - 图 2-1：双核心板硬件电气互连与供电树架构图【框图，需新画】
  - 图 2-2：OK3568 P29 槽位与双螺柱加固结构示意图【实物照片/示意图，已有 review/p29.png，需新拍整机实物照】
  - 表 2-1：主控硬件平台核心技术参数对照表【表格】
- **权威数据出处**：草稿行 66–90；`PCIe_DMA提速_20261018.md:200`；`review/pango100pro_evidence.md:279`；`RK_CMA扩容方案_20261018.md:9`。

---

### 第三章：FPGA 片上加速系统设计
- **本章目标**：详细剖析 FPGA 顶层流水线集成、硬件流式视觉算法核、多图层 OSD 引擎及 PDS 静态时序收敛成果。
- **章节核心要点**：
  1. `pango_pcie_dma_top` 顶层集成架构：Scatter-Gather 散列式 DMA 引擎与轻量级 MMIO 门铃触发机制；
  2. 多通道 DDR3 仲裁 Hub 与四宫格分屏显示控制器：4 组完全物理隔离读写 FIFO、Round-Robin 轮询仲裁及独立 Commit 影子寄存器机制；
  3. 多图层矢量/光栅混合 OSD 引擎：16 组目标框、64 字符动态状态文本行、24×24 矢量转向指示箭头、DECISION 触发全屏闪烁红框；
  4. 硬件流式车道线检测核 `rt_lane_det`：ROI 自适应色差初筛、行内游程聚合、在线累加器与最小二乘定点拟合、EMA 跟踪滤波；
  5. 硬件流式斑马线检测核 `rt_zebra_det`：纯流式零行缓存条纹宽度提取、跨度比与占空比约束、迟滞滤波、前车遮挡局限性说明；
  6. 算法调试效果视图 `DISP_CTRL[9:8]`：RGB 原彩（`2'b00`）、8-bit 加权灰度（`2'b01`）、二值化掩膜（`2'b10/2'b11`）硬件门控无缝切换；
  7. 板载 5 微动按键（KEY0–KEY4）消抖扫描与硬件透视标定引擎（cal_mode 消失点微调）；
  8. cam11 固件片上资源利用率（LUT 40.0%、FF 19.3%、DRM 63.8%、APM 25.4%）与 STA 时序收敛（Setup WNS = +0.340 ns，TNS = 0）。
- **规划图表/素材**：
  - 图 3-1：FPGA 片上视频加速流水线与图层叠加架构框图【框图，需重画】
  - 图 3-2：`rt_lane_det` 单遍光栅流式车道线检测时序图【时序图，需新画】
  - 图 3-3：`rt_zebra_det` 条纹特征提取与迟滞判决状态机图【状态机图，需新画】
  - 图 3-4：透视变换硬件标定模式网格十字准星叠加示意图【HDMI 截图/示意图，需新拍】
  - 表 3-1：cam11 版本 FPGA 片上资源消耗详表【表格，源自 PDS 日志】
  - 表 3-2：静态时序分析 STA 收敛报告表【表格，源自 PDS STA 报告】
- **权威数据出处**：草稿行 95–179；`build_cam11_s1.log:20529, 20546-20599`；`fpga/src/disp/rt_disp_top.v:904`；`fpga/src/disp/rt_osd_ctl.v:318-364`。

---

### 第四章：软硬协同高速低时延数据流体系
- **本章目标**：深入剖析由 SoC 视频采集解码、零拷贝派生、PCIe DMA 高速搬运到 FPGA 显存排版的全链路。
- **章节核心要点**：
  1. MPP 硬件视频解码与 RGA 2D 硬件图形引擎纳秒级零拷贝派生管线；
  2. 960×540 视频缩放帧（送待传环形缓冲）与 960×320 兴趣区拼装帧（直供 NPU 描述符）双路径；
  3. 基于 DMA-BUF 共享内存与 CMA 物理连续内存的 0 CPU 拷贝流转；
  4. 异步 PCIe 门铃通知机制与双缓冲/四槽位平滑倒换；
  5. PCIe Gen2 x2 链路吞吐实测：长传输吞吐达 896 MB/s（板到主）与 861 MB/s（主到板），4 KB 传输速率 485 MB/s；
  6. 多色彩格式（原始 RGB888、RGB565、NV12）在四路 960×540@30fps 并发下的总线负载多口径精确测算（负载 10.8%～21.7%）；
  7. 78%～89% 充裕总线带宽裕量对目标检测结果回传与紧急告警低抖动的安全保障。
- **规划图表/素材**：
  - 图 4-1：软硬协同全链路零拷贝流转数据流图【流程图，需重画】
  - 图 4-2：PCIe 门铃与 DMA Master 突发读写握手时序图【时序图，需新画】
  - 表 4-1：多色彩格式四路视频并发传输总线带宽占用测算表【表格】
- **权威数据出处**：草稿行 184–231；`PCIe_DMA提速_20261018.md:9, 19, 200, 204`。

---

### 第五章：RK3568 边缘计算与 ADAS 决策软件栈
- **本章目标**：阐述 SoC 端主运行程序 `usb_feed`、YOLOv6n NPU 推理优化、纯 C99 交通灯识别及 ADAS 行为决策。
- **章节核心要点**：
  1. 主运行程序 `usb_feed` 解耦多线程流水线架构与 `quad_sched` 平滑加权轮询调度；
  2. 定制 $960 \times 320$ 车载带状视野轻量级 YOLOv6n INT8 模型部署（`b5_v6n_band.rknn`）；
  3. 完整 9 类目标检测模型输出（person, rider, car, bus, truck, tricycle, cone, barrier, speed_limit）；
  4. NPU 900 MHz 最大频点压榨优化（推理中位数降至 17.55 ms，降幅 12.9%）与长时浸泡温升测试（46.7–48.3 °C）；
  5. 纯 C99 交通信号灯检测模块 `tl_det`：0 外部依赖、0 动态内存分配（0 malloc/free）、算法耗时 4～6 ms；
  6. `tl_det` 7 段评测视频（2678 帧）全量逐帧比对结果：RAW 100.00% 对齐，SIG 用例通过率 63/69 (91.3%)；
  7. 决策服务线程 `adas.c` 规则状态机：红停绿行判决、虚线变道允许与实线变道禁止；
  8. 危险目标近距预警决策路径：前视检出行人/骑行者/锥桶距离过近时，自动置位自车道红箭头与 bit8 报警字；
  9. 板端实测 DECISION 寄存器（`0x850`）控制字行为：`0x0C` 红停、`0x10C` 闯红灯爆闪、`0x08` 绿行与无灯回退。
- **规划图表/素材**：
  - 图 5-1：SoC 侧 `usb_feed` 多线程流水线处理模型图【流程图，需新画】
  - 图 5-2：纯 C99 `tl_det` 视觉检测与时序滤波状态转移图【状态转移图，需新画】
  - 图 5-3：ADAS 行为决策与声光告警生成决策树图【流程图，需新画】
  - 图 5-4：NPU 频点推理时延对比与 5 分钟浸泡温度曲线图【折线图，需用数据绘制】
  - 表 5-1：`tl_det` 纯 C 模块与 Python 黄金模型 7 段视频逐帧一致率对比表【表格】
  - 表 5-2：DECISION 寄存器（0x850）编码与声光告警映射表【表格】
- **权威数据出处**：草稿行 236–271；`log/npu_freq_20261029.md:16-29`；`tools/adas/host_test/report.md:20-68`；`tools/usb_feed/adas.c:236-253, 274-292`；`models/npu/b5_v6n_band.onnx.json:35-45`。

---

### 第六章：人机交互与多模式启动系统（新增核心章）
- **本章目标**：系统揭示支撑现场评测演示与多种工况流转的开机选择、实况守护、U 盘浏览及中文 GUI 方案。
- **章节核心要点**：
  1. 系统自启动脚本 `run_boot.sh` 与 PCIe 设备枚举激活流程；
  2. 开机二选一交互器 `mode_select`：开机默认呈现，KEY0 切换实况相机/U 盘视频模式，KEY1 确认启动，KEY4 长按退出；
  3. 实时多路监控守护进程 `menu_daemon`：维护 3 路 UVC 后台推流，KEY4 短按唤出 6 项参数配置浮窗（LIVE 4CAM、USB VIDEO、NPU、LANE、VIEW、ZEBRA），KEY0 切换项、KEY1 改值；
  4. 现场 U 盘视频浏览器 `usb_menu`：自动扫描挂载点、支持多级目录导航、KEY0/KEY2 上下移动、KEY1 播放、KEY4 返回；
  5. 视频播放浮窗控制机制：播放中 KEY4 短按呼出参数控制浮窗，支持热切换 NPU 检测、车道线识别、灰度二值滤镜及斑马线检测；
  6. 嵌入式 GBK 中文字库方案：`gen_cjk_font.py` 生成 26×26 1-bit 点阵字库 `ui_cjk.bin`（CJK1 格式），实现完整中文文件名显示与字符检索；
  7. 板载 5 微动按键（KEY0–KEY4）统一动作映射与各交互模式下的功能分发矩阵；
  8. FPGA 四宫格推图寄存器协议约定：`0x1A0 = 1`（DDR 门铃使能，复位后必开）、`0x804/0x808`（帧存基址与步长）、`0x80C = 960`（行宽）、`0x810 = 518400`（槽像素数）、`0x800 = 0x65/0x25`（主控制）。
- **规划图表/素材**：
  - 图 6-1：系统多模式启动与运行流转状态机图【状态机流程图，需新画】
  - 图 6-2：板载 KEY0–KEY4 按键复用与控制映射关系图【结构图，需新画】
  - 图 6-3：四宫格推图切片与显存槽位映射原理图【原理图，需新画】
  - 图 6-4：GBK 26×26 点阵字库 CJK1 二进制结构与字符检索流程图【结构图，需新画】
  - 图 6-5：开机二选一界面截图【HDMI 截图，已有素材 menu/sel_preview.png，需补充实机照】
  - 图 6-6：U 盘中文浏览器与播放界面截图【HDMI 截图，已有素材 menu/preview.png，需补充实机照】
  - 图 6-7：实况监控 6 项参数配置弹窗截图【HDMI 截图，需新拍】
  - 表 6-1：FPGA 四宫格推图与人机交互核心寄存器映射定义表【表格】
  - 表 6-2：板载物理按键在各交互场景下的功能映射总表【表格】
- **权威数据出处**：`tools/menu/mode_select.c:268-285, 388-426`；`tools/menu/menu_daemon.c:28-29, 110-123, 396-430`；`tools/menu/usb_menu.c:106, 1287-1337, 1432-1438, 1461`；`tools/menu/run_boot.sh:1-12`；`tools/menu/gen_cjk_font.py:5-11, 48`。

---

### 第七章：系统关键实测性能数据全景表
- **本章目标**：以严谨量化的实测数据全景展现系统软硬件各项技术指标，明确权威文件与日志出处，杜绝任何理论猜测。
- **章节核心要点**：
  1. FPGA 固件构建版本与片上物理资源占用全景（cam11 版本，LUT/FF/DRM/APM/GPLL/SerDes）；
  2. FPGA 静态时序分析 STA 全景（Setup WNS、TNS、Hold、Recovery 全余量通过）；
  3. PCIe 物理链路吞吐与持续浸泡稳定性全景（板主双向吞吐、MPS 256、5 分钟 485 轮、AER/RAS DES 0 错误）；
  4. 四路视频并发传输总线带宽开销测算全景（RGB888/RGB565/NV12 负载与裕量）；
  5. NPU 边缘 AI 推理耗时优化与稳定性全景（600MHz/900MHz 对比、板温稳态、欠载为 0）；
  6. NPU 目标检测精度指标（YOLOv6n B5 模型 mAP@0.5、mAP@0.5:0.95、逐类 AP 表）；
  7. 纯 C 交通信号灯检测模块精度指标全景（RAW 100%、SIG 97.2%、官方 SIG 用例 63/69）；
  8. 车道线硬件加速核仿真全景（5 组向量逐行比对 0 误差、12 字段比对、门级 42 帧反标）；
  9. ADAS 综合行为决策与声光告警状态字全景（0x0C 红停、0x10C 闯红灯爆闪、0x08 绿行）；
  10. 系统连续物理内存扩容（CMA 256 MB，基址 0xDDC00000）；
  11. 待测指标客观标注与说明（整链端到端延迟、整机实测功耗、四路并发实测 CPU 占用）。
- **规划图表/素材**：
  - 表 7-1：系统关键性能与参数全景数据及出处对照总表【综合大表】
  - 表 7-2：NPU 目标检测精度详细评测表（逐类别 AP50 与 mAP，提取自评估日志）【表格】
- **权威数据出处**：草稿行 276–299；`build_cam11_s1.log`；`PCIe_DMA提速_20261018.md`；`log/npu_freq_20261029.md`；`tools/adas/host_test/report.md`；`log/lane_fpga/vectors/README.md`；`log/train_b5_v6n_20261027_030923.log:54042-54069`。

---

### 第八章：全流程软硬件协同验证方法体系
- **本章目标**：系统阐述团队建立的由浮点黄金参考、定点化位真仿真、门级后仿真到板级长时浸泡的五级渐进式验证体系。
- **章节核心要点**：
  1. 第一级：Python 浮点黄金参考模型推导与参数敏感性扫描；
  2. 第二级：Python/C 定点化位真模型建模（除法器截断、Q16/Q4 标定、导出逐行 rows.csv 与逐帧 frames.hex 黄金向量）；
  3. 第三级：RTL 级行为仿真与自动比对验证（`tb_rt_lane_det_all`，5 组基准向量逐行比对 row_mismatch=0，核验 12 个关键字段与 38 个寄存器）；
  4. 第四级：PDS 布局布线后门级网表时序反标后仿真（`tb_rt_lane_det_gl`，反标运行 seg_board 与 seg_recover 共 42 帧）；
  5. 第五级：整机板级联调与长时浸泡压测（PCIe 5 分钟 485 轮双向交替压测 AER 保持 0，NPU 5 分钟 900MHz 浸泡温控监控，数万帧视频读写 FIFO 欠载统计恒为 0）。
- **规划图表/素材**：
  - 图 8-1：五级递进式软硬件协同工程验证流向架构图【流程图，需重画】
  - 图 8-2：ModelSim/PDS 仿真波形关键字段自动比对波形截图【仿真波形截图，需新截】
  - 表 8-1：车道线 5 组基准仿真向量集特征与验证结果对照表【表格】
- **权威数据出处**：草稿行 304–345；`log/lane_fpga/vectors/README.md:13`；`PCIe_DMA提速_20261018.md:201`；`log/npu_freq_20261029.md:26-29`。

---

### 第九章：赛题四项测试方式的实现与现场演示步骤
- **本章目标**：对照官方任务书四项测试方式，详细呈现软硬件实现机制、按键注入方式及现场标准操作演示规程。
- **章节核心要点**：
  1. 测试方式 (1) 十字路口场景：红绿灯感知提取、KEY0 切车道（左/直/右循环）、KEY1 切启停、DECISION 控制字映射、全屏红框闪烁与蜂鸣器告警演示步骤；
  2. 测试方式 (2) 车道线与变道合规监控：`rt_lane_det` 虚实线识别、KEY2/KEY3 短按转向请求（绿箭头 ALLOW / 黄箭头 KEEP）、KEY2/KEY3 长按强制变道、违规压线告警演示步骤；
  3. 测试方式 (3) 带导航真实道路视频模拟智驾：客观核定本期未开发内嵌导航小地图图标 OCR 解析算法，阐明现场将视频作为常规道路场景执行安全监测的退化演示步骤；
  4. 测试方式 (4) 特殊应急场景：YOLOv6n 检测行人、骑行者、锥桶等目标，近距危险触发自车道红箭头与 bit8 全屏告警演示步骤；客观说明无底盘线控物理刹车；
  5. 现场评测 U 盘操作全流程演示指南：插入 U 盘 $\rightarrow$ 开机二选一选择界面进入 `usb_menu` $\rightarrow$ 按键翻选视频 $\rightarrow$ 播放并调出浮窗切换算法模式。
- **规划图表/素材**：
  - 图 9-1：十字路口红停绿行与闯红灯违规报警现场演示图【HDMI 截图/照片，需新拍】
  - 图 9-2：车道线虚线变道允许与实线变道违规告警现场演示图【HDMI 截图/照片，需新拍】
  - 图 9-3：近距行人/障碍物危险标红与声光告警现场演示图【HDMI 截图/照片，需新拍】
  - 图 9-4：现场 U 盘测评模式端到端操作演示时序流向图【时序流程图，需新画】
- **权威数据出处**：草稿行 350–394；`tools/usb_feed/adas.c:220-275`；`tools/menu/mode_select.c`；`tools/menu/usb_menu.c`。

---

### 第十章：已知局限性与工程说明
- **本章目标**：实事求是地阐明系统当前的技术边界、客观局限与后续工程演进路线，展现严谨工程学态度。
- **章节核心要点**：
  1. 斑马线硬件流式检测核在实车复杂路况（前车遮挡产生超限大空隙）下的检出波动，保持实验调试模式未接入安全主环；
  2. 特殊应急刹车场景缺乏线控底盘执行机构与车载 CAN 通信卡，仅能完成毫秒级声光与视觉红框告警，未形成物理制动闭环；
  3. 赛题测试方式 (3) 的车载导航小地图图标解析与全局路径规划本期尚未开发；
  4. 恶劣天气（夜间低照度、雨雪地面强反光）自适应增强算子未部署；
  5. CMA 256 MB 连续物理内存在高并发下的碎片风险与静态复用防范措施；
  6. OK3568 P29 PCIe 插槽机械触点公差与供电树隔离约束，强调必须遵循刚性紧固背板与上电时序规范。
- **规划图表/素材**：
  - 图 10-1：前车遮挡导致斑马线条纹空隙超限局限性示意图【示意图/截图，需新画】
- **权威数据出处**：草稿行 398–413；`review/pango100pro_evidence.md:279`。

---

### 第十一章：核心亮点与创新点总结
- **本章目标**：系统提炼并升华项目在异构体系架构、流水线算法设计及软硬件协同工程落地的 8 项核心创新成果。
- **章节核心要点**：
  1. 工业级高可靠 PCIe 异构高速互联通道（实测 896 MB/s 吞吐，5 分钟 485 轮浸泡 0 失败，AER 0 错误）；
  2. 端到端纯硬件零拷贝视频分流中枢（四路并发仅占 14.5%~21.7% PCIe 带宽，CPU 零开销）；
  3. 纳秒级时序收敛与高紧凑片上资源平衡（cam11 Setup WNS = +0.340 ns，TNS=0，LUT 占用 40.0%）；
  4. 单遍光栅流式车道线检测硬件加速核（无整帧行缓存，逐行比对 0 误差，门级 42 帧反标）；
  5. NPU 深度量化与频点极限能效调优（YOLOv6n INT8 耗时 17.55 ms，降低 12.9%，长时稳态无降频）；
  6. 零外部依赖极低开销纯 C 交通信号灯引擎（0 malloc/free，单帧 4~6 ms，2678 帧全量 100% RAW 对齐）；
  7. 多视口硬件级异步帧同步与独立 Commit 机制（4 组隔离 FIFO 仲裁，掉帧不卡顿、无撕裂）；
  8. 毫秒级人机交互与声光安全告警闭环（单个 MMIO 寄存器单周期告警直推，全屏红框爆闪）。
- **规划图表/素材**：
  - 图 11-1：系统 8 大核心技术创新点全景雷达/矩阵图【图表，需新画】
- **权威数据出处**：草稿行 418–427。

---

## 四、一致性核对清单（文档 vs 代码/仓库实际事实核查）

*本节对技术文档初稿（`docs/技术文档_草稿.md`）与代码仓库真实实现进行逐行穿透式核对，列出 5 大类核心偏差与整改指引：*

### 核对项 a：刹车控制未联动 vs 危险目标告警决策路径
- **初稿现状表述**：
  - 草稿 §8.4（行 390, 393）：写“【部分实现：目标检测已打通，刹车控制未联动】”、“仅在 OSD 画面中完成危险目标的标红提示”；
  - 草稿 §9 第 2 条（行 404）：写“未能构建端到端的主动紧急刹车制动闭环，仅限于在 HDMI 显示屏上进行危险框高亮警示”。
- **仓库实际代码事实**：
  - `tools/usb_feed/adas.c:236-252` 中，当前视窗口检出近距危险目标（`b->cls == 0` 行人, `1` 骑行者, `6` 锥桶，置信度 $\ge 0.30$，框底 $y_1 \ge 0.75 \times 540$，中心 $c_x$ 位于中央 30%~70% 车道范围）时，置位 `hazard = 1`；
  - 触发后决策赋值：`dec = (3u << (2 * lane)) | (1u << 8);`，即**强制将自车当前所在车道的指示箭头变红（值 3），同时置位 bit8（触发全屏鲜红边框闪烁与声光告警）**；
  - 此外，在底部 OSD 文本串中输出 `HZ:1`（`tools/usb_feed/adas.c:280-282`）。
- **核查结论与整改方案**：
  - 必须严格区分“缺乏整车 CAN/线控物理制动机构”与“已具备视觉危险目标判定并触发自车道红箭头+bit8告警的完整决策闭环”；
  - 草稿将已实现的软件决策告警路径遗漏，矮化了系统完成度。需在文档中补全该决策逻辑与寄存器交互说明。
- **需补充/更正章节**：**第五章 §5.3、第七章 表7-2、第九章 §9.4、第十章 §10.2**。

---

### 核对项 b：模型命名 YOLOv8n vs YOLOv6n 及检测类别清单
- **初稿现状表述**：
  - 草稿全文共有 5 处将 NPU 检测模型表述为“YOLOv8n”：
    1. 行 47：`| - NPU 神经网络推断 (YOLOv8n INT8 定点化，960x320 拼图高效推理) |`
    2. 行 241：`2. **RKNN INT8 YOLOv8n 轻量级目标检测与频率调优**：`
    3. 行 291：表 6-1 序号 10 中写 `YOLOv8n INT8 960×320`
    4. 行 392：`RK3568 NPU 部署的轻量级 YOLOv8n INT8 模型已完整训练并包含行人（Pedestrian）、车辆（Car/Truck）、骑行者（Cyclist）及交通锥桶（Cone）类别。`
    5. 行 424：`5. ...完成定制 $960 \times 320$ 带状视野 YOLOv8n INT8 模型轻量化`
- **仓库实际代码事实**：
  - 最终实际部署运行的模型为 `models/npu/b5_v6n_band.rknn`（对应 ONNX 为 `models/npu/b5_v6n_band.onnx`）；
  - 训练执行脚本 `tools/npu_train/run_b5_v6_train.sh:2, 33, 38` 明确记载为 **YOLOv6n** 架构（配置文件 `configs/yolov6n_npu_v2w.py`，模型名 `b5_v6n_band`）；
  - 类别清单在 `models/npu/b5_v6n_band.onnx.json:35-45` 中明确定义为 **9 类**：`person`、`rider`、`car`、`bus`、`truck`、`tricycle`、`cone`、`barrier`、`speed_limit`；
  - （注：早先试验阶段的 B1f/B2f/B3f 为 YOLOv8n，B4 为 YOLOv8n-ReLU，但在综合权衡 RKNN-Toolkit 算子兼容性与 RepVGG 架构在 NPU 上的定点推理延迟后，最终优选并部署了 **YOLOv6n**）。
- **核查结论与整改方案**：
  - 草稿 5 处出现的“YOLOv8n”表述必须全部更正为“YOLOv6n（B5 版本 `b5_v6n_band.rknn`）”；
  - 检出目标类别由草稿所列的 4 类补齐为完整的 **9 类**（补上大巴 bus、卡车 truck、三轮车 tricycle、路障 barrier、限速牌 speed_limit）。
- **需补充/更正章节**：**第一章 §1.2、第五章 §5.1、第七章 表7-1/表7-2、第九章 §9.4、第十一章 亮点5**。

---

### 核对项 c：物理按键命名与 FPGA 内部实际映射行为
- **初稿现状表述**：
  - 草稿行 111-112：泛泛写“FPGA 板载 5 向按键经消抖模块连接状态机...”；
  - 草稿行 357-358：`物理按键 KEY_UP / KEY_DOWN：循环切换自车所在车道...`；`物理按键 KEY_CENTER：模拟车辆启停切换...`；
  - 草稿行 372-374：`按键 KEY_LEFT：注入左转向请求...`；`按键 KEY_RIGHT：注入右转向请求...`；`长按或组合键：注入强制压线变道指令...`。
- **仓库实际代码事实**：
  - 盘古 100Pro+ 开发板物理上为 5 个独立的微动轻触按键，板载丝印标识为 **KEY0、KEY1、KEY2、KEY3、KEY4**（无摇杆或十字 D-Pad 机械结构）；
  - `fpga/src/disp/rt_osd_ctl.v:318-339` 中真实 RTL 状态机按键映射严格定义如下：
    - **KEY0 (ek=0)**：短按（T_SHORT）$\rightarrow$ 循环切换自车道（`lane <= (lane==2) ? 0 : lane + 1`，0 左 $\rightarrow$ 1 直 $\rightarrow$ 2 右）；
    - **KEY1 (ek=1)**：短按（T_SHORT）$\rightarrow$ 切换车辆启停状态（`moving <= ~moving`）；
    - **KEY2 (ek=2)**：短按（T_SHORT）$\rightarrow$ 左转向请求（`left_req<=1, left_force<=0`）；长按（T_LONG）$\rightarrow$ 强制左转变道（`left_req<=1, left_force<=1`）；
    - **KEY3 (ek=3)**：短按（T_SHORT）$\rightarrow$ 右转向请求（`right_req<=1, right_force<=0`）；长按（T_LONG）$\rightarrow$ 强制右转变道（`right_req<=1, right_force<=1`）；
    - **KEY4 (ek=4)**：短按（T_SHORT）$\rightarrow$ 切换显示模式（`disp_mode <= ~disp_mode`）；长按（T_LONG）$\rightarrow$ 切换输入信号源（`src_sel <= ~src_sel`）；持续按住 3 秒（T_HOLD3）$\rightarrow$ 切入透视标定模式（`cal_mode <= 1`）。
- **核查结论与整改方案**：
  - 草稿混淆了按键硬件形态与动作逻辑（将单键循环误记为上下键，将长按机制误记为组合键）；
  - 必须全文统一采用 KEY0–KEY4 的标准板载名称，准确说明短按、长按、3 秒长按的分级映射行为。
- **需补充/更正章节**：**第三章 §3.1、第六章 §6.2/表6-2、第九章 §9.1/§9.2**。

---

### 核对项 d：开机菜单、U 盘浏览器、中文字库及四宫格推图约定遗漏
- **初稿现状表述**：
  - 草稿全文**完全遗漏**了系统启动交互系统、U 盘浏览功能、中文文件名支持以及 FPGA 四宫格推图的核心配置约定。
- **仓库实际代码事实**：
  - **开机二选一选择界面**：`tools/menu/mode_select.c` 与 `tools/menu/run_boot.sh` 实现了开机自启，用户无需外接键鼠即可在“实时摄像头（模式 0）”与“U 盘视频（模式 1）”间无缝二选一；
  - **实时模式守护进程**：`tools/menu/menu_daemon.c` 实现了后台多路推流与实时 OSD 浮窗控制，支持在监控画面上直接调出 6 项功能开关；
  - **U 盘视频浏览器**：`tools/menu/usb_menu.c` 实现了对外部 U 盘的动态遍历与多级目录树翻页浏览，并集成了播放时浮窗动态控制；
  - **中文 GBK 字库方案**：`tools/menu/gen_cjk_font.py` 生成了专用的 26×26 1-bit 点阵字库 `ui_cjk.bin`（CJK1 格式，含索引表与 104B 单字位图），支持在 1080P 高清画布上清晰渲染中文文件名；
  - **FPGA 四宫格推图核心寄存器约定**：
    - `0x1A0 = 1`：DDR 门铃读使能（FPGA 复位后硬件默认关闭门铃引擎，推图前必须显式写 1，出处：`tools/menu/usb_menu.c:1432`）；
    - `0x804 = 0x04000000`：帧缓冲区显存物理基址；
    - `0x808 = 0x00400000`：槽物理地址步长；
    - `0x80C = 960`：行跨度宽度（FPGA 默认复位值为 1920，四宫格必须重设为 960，出处：`tools/menu/usb_menu.c:1436`）；
    - `0x810 = 518400`（$960 \times 540$）：单槽总像素数（FPGA 默认值为 $1920 \times 1080$，推图前必须重写，出处：`tools/menu/usb_menu.c:1437`）；
    - `0x800 = 0x65 / 0x25`：主控制寄存器。
- **核查结论与整改方案**：
  - 遗漏该部分内容将严重弱化系统工程落地度与现场演示便利性；
  - 必须在正式文档中独立设立**第六章「人机交互与多模式启动系统」**，并在第三章与第四章补全四宫格推图寄存器契约。
- **需补充/更正章节**：**第三章 §3.1、第六章（整章新增）、第七章 表7-1**。

---

### 核对项 e：实测数字出处核查与缺出处条目清单
- **已有权威日志/文件支撑的实测数据（确认合格）**：
  1. FPGA 资源利用率（LUT 40.0%, FF 19.3%, DRM 63.8%, APM 25.4%）$\rightarrow$ `build_cam11_s1.log:20546-20599`；
  2. FPGA 静态时序分析 STA（Setup WNS = +0.340 ns, TNS = 0.000 ns）$\rightarrow$ `build_cam11_s1.log:20529`；
  3. PCIe 长传输带宽（板卡→主机 896 MB/s，主机→板卡 861 MB/s）$\rightarrow$ `PCIe_DMA提速_20261018.md:9, 19, 200`；
  4. PCIe 5 分钟浸泡压测（485 轮 0 失败，AER/RAS DES 全 0）$\rightarrow$ `PCIe_DMA提速_20261018.md:201`，`log/pcie_fast2_soak_ext_20261018.log`；
  5. PCIe 4 KB 突发速率 485 MB/s $\rightarrow$ `PCIe_DMA提速_20261018.md:200`；
  6. NPU 900 MHz 推理耗时中位数 17.55 ms（降幅 12.9%）$\rightarrow$ `log/npu_freq_20261029.md:21-24`；
  7. NPU 5 分钟浸泡温度 46.7–48.3 °C，0x82C 欠载恒 0 $\rightarrow$ `log/npu_freq_20261029.md:27-29`；
  8. 交通灯瞬时 RAW 一致率 100.00%（2678/2678）$\rightarrow$ `tools/adas/host_test/report.md:22-35`；
  9. 交通灯独立滤波 SIG 一致率 97.20%（2603/2678）$\rightarrow$ `tools/adas/host_test/report.md:41-56`；
  10. 官方 SIG 测试用例通过数 63 / 69（91.3%）$\rightarrow$ `tools/adas/host_test/report.md:60-68`；
  11. 车道线 5 组基准向量比对（row_mismatch=0，核验 12 个关键字段，门级 42 帧）$\rightarrow$ `log/lane_fpga/vectors/README.md:13`；
  12. ADAS 决策控制字实测状态（0x0C 红停、0x10C 闯红灯爆闪、0x08 绿行）$\rightarrow$ `tools/usb_feed/adas.c:244-247, 259`；
  13. CMA 物理连续内存扩容 256 MB（基址 0xDDC00000）$\rightarrow$ `RK_CMA扩容方案_20261018.md:7-13`。
- **草稿中出现但【缺出处/存在平台口径混淆】的条目清单**：
  1. **单笔 MMIO 寄存器响应时延小于 1.2 $\mu s$**（草稿行 224）：`PCIe_DMA提速_20261018.md:204` 记载为“上限 1 时每个读请求往返约 1.8 µs”，草稿 1.2 µs 疑似笔误，仓库无单笔 MMIO 物理延迟实测日志。需在第四章标注“待用硬件计数器重新实测，或更正为读请求往返约 1.8 µs”；需补充到：**第四章 §4.2、第七章 表7-1**；
  2. **tl_det 纯 C99 算法单帧运算“4～6 ms”**（草稿行 253, 425）：`tools/adas/host_test/report.md:77` 明确记载该时间是在 WSL x86_64 PC（Ubuntu 22.04）上测得，**并非 RK3568 Cortex-A55 实测值**；草稿未加区分。需补充 ARM 真实板端实测或注明 PC 测试基准；需补充到：**第五章 §5.2、第七章 表7-1**；
  3. **斑马线硬件核在 112454 中覆盖率 93.4%**（草稿行 143, 401）：草稿引用的 `tools/zebra_fpga/eval_report.md` 在仓库中不存在（断链引用），缺少原始测试评测脚本；需补充评测文件与日志；需补充到：**第三章 §3.3、第十章 §10.1**；
  4. **整链端到端延迟（摄像头光子到达 $\rightarrow$ HDMI 画面输出）**：草稿多次宣称“极低端到端时延”，但在第六章实测表中**完全缺席**（历史规划仅估算 110–170 ms）；属于核心关键待补实测数据；需补充到：**第七章 表7-1**；
  5. **系统整机运行功耗（W / mW）**：草稿无任何整机功率数据；需标记为“待补实测”；需补充到：**第七章 表7-1**；
  6. **四路视频同时播放帧率抖动与 CPU 占用率实测**：草稿行 226-230 仅为纯数学带宽推算，缺少板端实际跑满 4 路 30fps 时的真实 CPU 利用率（`top`）与帧率采样；需标记为“待补板端采样”；需补充到：**第四章 §4.2、第七章 表7-1**。

---

## 五、待补数据与素材清单

*本节系统梳理后续报告正文完善过程中必须补充的测试数据、系统设计图及实物截图，统一采用三分类勾选表进行跟踪管理：*

### 5.1 待补关键量化测试数据表
| 序号 | 待补数据项名称 | 具体定义口径与测试方案 | 当前状态 | 拟补充章节 |
| :---: | :--- | :--- | :---: | :---: |
| **D1** | **整链端到端延迟** | 物理世界事件（LED灯亮/光子输入）$\rightarrow$ 摄像头采集 $\rightarrow$ MPP/RGA $\rightarrow$ PCIe DMA $\rightarrow$ FPGA OSD $\rightarrow$ HDMI 画面光子输出总耗时（通过高频秒表或高帧率相机实测） | **需新测**<br>(草稿估算110-170ms) | 第四章、第七章 |
| **D2** | **NPU 检测精度表** | YOLOv6n B5 模型在验证集上的全景精度：mAP@0.5、mAP@0.5:0.95，以及 9 个类别的逐类 AP 表（`log/train_b5_v6n_20261027_030923.log:54042-54069` 终验 mAP50=0.632，需从 `predictions.json` 导出各类别详细 AP） | **已有训练日志**<br>(需提取整理) | 第五章、第七章 |
| **D3** | **整机工作总功耗** | DC 12V 供电输入总电流与功率测量（分别记录：系统空闲静待功耗、4 路全并发无 NPU 功耗、4 路全并发 + NPU 900MHz 满负荷推理总功耗） | **需新测**<br>(待用功率计测量) | 第二章、第七章 |
| **D4** | **四路同时播放实测** | 板端运行 `usb_feed` 四路并发时真实 CPU 各核心占用率（`top`/`mpstat` 采样）、内存占用、各通道实际输出 FPS 与帧间隔抖动统计 | **需新测**<br>(待板端日志采样) | 第四章、第七章 |
| **D5** | **板端 tl_det 耗时** | 纯 C99 交通灯算法在 RK3568 Cortex-A55 真实核心上的单帧运行耗时（采样 1000 帧统计中位数与最大值，区分 WSL x86 PC 的 4~6 ms） | **需新测**<br>(待板端代码埋点) | 第五章、第七章 |
| **D6** | **PCIe MMIO 时延** | Linux 用户态通过 `/dev/mem` mmap 读写 FPGA BAR1 寄存器的单次往返延迟基准（采用高精度时钟连续采样 10,000 次取平均与方差） | **需新测**<br>(修正草稿1.2us) | 第四章、第七章 |

---

### 5.2 待绘制/重画系统架构与流程图表
| 序号 | 待画图表名称 | 图表形式与呈现要点 | 当前状态 | 拟置入章节 |
| :---: | :--- | :--- | :---: | :---: |
| **F1** | **系统硬件与互连拓扑框图** | 矢量框图：展示盘古 100Pro+、OK3568-C、P29 PCIe Gen2 x2 槽位、FMC 双目接口、3 路 USB 摄像头、MS7210 HDMI 屏及双 DC 12V 电源树 | **需重画**<br>(草稿为字符图) | 第一章 图 1-1 |
| **F2** | **全链路零拷贝数据流图** | 彩色流程图：V4L2 裸流 $\rightarrow$ MPP 硬解 $\rightarrow$ RGA 派生 $\rightarrow$ DMA-BUF $\rightarrow$ PCIe 门铃 DMA $\rightarrow$ DDR3 Hub $\rightarrow$ OSD $\rightarrow$ HDMI 1080P | **需重画**<br>(草稿为字符图) | 第四章 图 4-1 |
| **F3** | **多模式启动与交互状态机图** | 状态机流向图：开机自启 $\rightarrow$ PCIe 初始化 $\rightarrow$ `mode_select` 二选一 $\rightarrow$ `menu_daemon` 实时模式 $\leftrightarrow$ `usb_menu` U盘模式 $\rightarrow$ 播放与弹窗控制 | **需新画** | 第六章 图 6-1 |
| **F4** | **板载按键状态机与复用映射图** | 结构图：KEY0–KEY4 在普通监控、弹窗设置、U 盘目录浏览、播放控制及透视标定（cal_mode）下的短按/长按/3s长按行为分发矩阵 | **需新画** | 第六章 图 6-2 |
| **F5** | **四宫格显存布局与仲裁机制图** | 内存布局图：FPGA DDR3 0x04000000 基址分配、4 个 960×540 视口槽位排布、FIFO 读写指针倒换与 Shadow Commit 机制 | **需新画** | 第六章 图 6-3 |
| **F6** | **GBK 字库结构与字符索引流程图** | 数据结构图：`ui_cjk.bin` 文件头 CJK1 Magic、码点索引表二分查找、26×26 点阵位图行内存储与 1080P 画布点阵展开流程 | **需新画** | 第六章 图 6-4 |
| **F7** | **五级递进式软硬件协同验证图** | 层次流程图：①Python浮点模型 $\rightarrow$ ②定点位真模型 $\rightarrow$ ③RTL行为级仿真 $\rightarrow$ ④PDS门级后仿真 $\rightarrow$ ⑤整机长时浸泡压测 | **需重画**<br>(草稿为字符图) | 第八章 图 8-1 |

---

### 5.3 待采集系统运行截图与实物照片
| 序号 | 待采截图/照片名称 | 拍摄/抓取内容与技术要点 | 当前状态 | 拟置入章节 |
| :---: | :--- | :--- | :---: | :---: |
| **S1** | **开机二选一选择界面截图** | HDMI 输出画面：`mode_select` 呈现的“实时摄像头”与“U 盘视频”高亮选择卡片界面 | **已有素材**<br>(`menu/sel_preview.png`，需实拍) | 第六章 图 6-5 |
| **S2** | **U 盘中文视频浏览器截图** | HDMI 输出画面：`usb_menu` 遍历 U 盘呈现的树状目录、GBK 26×26 中文字体文件名及黄色高亮条 | **已有素材**<br>(`menu/preview.png`，需实拍) | 第六章 图 6-6 |
| **S3** | **四宫格视频实时拼接全屏照** | HDMI 1080P 输出画面：4 个 960×540 视频窗口无缝拼接、流畅刷新无撕裂效果 | **需新拍**<br>(HDMI采集卡抓取) | 第四章、第六章 |
| **S4** | **参数配置浮窗 (Popup) 截图** | HDMI 输出画面：`menu_daemon` 或播放过程中按下 KEY4 唤出的青色边框 6 项交互配置弹窗 | **需新拍**<br>(HDMI采集卡抓取) | 第六章 图 6-7 |
| **S5** | **图像滤镜效果对比三联图** | HDMI 输出窗口 0 局部特写：①全彩原图、②8-bit 加权灰度模式、③二值化掩膜模式（DISP_CTRL 控制） | **需新拍**<br>(HDMI采集卡抓取) | 第三章、第四章 |
| **S6** | **十字路口红停与闯红灯报警截图** | HDMI 输出特写：正常红灯停止（红色直行箭头）与强制起步闯红灯（全屏高频鲜红边框闪烁报警） | **需新拍**<br>(HDMI采集卡抓取) | 第九章 图 9-1 |
| **S7** | **车道线变道合规指示截图** | HDMI 输出特写：虚线允许变道（绿色转向箭头）与实线违规强制变道（红色转向箭头 + 全屏红框告警） | **需新拍**<br>(HDMI采集卡抓取) | 第九章 图 9-2 |
| **S8** | **危险障碍物近距预警叠加截图** | HDMI 输出特写：YOLOv6n 检出行人/骑行者框，近距目标触发本车道箭头变红与底部 OSD `HZ:1` | **需新拍**<br>(HDMI采集卡抓取) | 第九章 图 9-3 |
| **S9** | **双板互联硬件实物装配全景照** | 高清单反照片：盘古 100Pro+ 插入 OK3568 P29 槽位，刚性双螺柱定位背板，独立供电与线缆连接 | **需新拍**<br>(实物多角度拍摄) | 第二章 图 2-2 |
| **S10** | **PDS 综合布线与时序报告截图** | 紫光同创 PDS 2025.2 软件界面截图：Device Utilization 资源汇总与 Timing Summary WNS 界面 | **需新截**<br>(EDA工具窗口截图) | 第三章 |

---

## 六、写作规范与提交建议

*为确保最终提交的技术文档在技术深度、学术规范与视觉排版上达到国家级一等奖水准，制定以下写作规范：*

### 6.1 篇幅与结构规模目标
- **全文目标字数**：正文总字数控制在 **16,000 ～ 20,000 字**（不含附录代码与长日志），预计排版为 28–35 页标准 A4 报告；
- **各章篇幅预算建议**：
  - 核心亮点预览与赛题对照表：2 页（约 1,200 字）；
  - 系统概述与硬件平台架构：4 页（约 2,500 字）；
  - FPGA 片上加速系统设计：6 页（约 3,500 字，重点章节）；
  - 软硬协同数据流与人机交互系统：6 页（约 3,500 字，特色章节）；
  - RK3568 边缘计算与 ADAS 决策软件栈：5 页（约 3,000 字）；
  - 性能数据全景表与验证体系：5 页（约 3,000 字，证据硬核章节）；
  - 赛题测试方式演示、局限性与总结：4 页（约 2,500 字）。

### 6.2 图表与交叉引用编号规范
- **图编号规则**：按章节二级编号，统一采用“**图 章号-序号**”格式（如 图 1-1、图 2-1、图 3-1 ... 图 6-3）；图题置于图正下方，居中，附简要注释；
- **表编号规则**：按章节二级编号，统一采用“**表 章号-序号**”格式（如 表 2-1、表 3-1、表 7-1）；表题置于表正上方，居中，三线表样式排版；
- **正文引用强制要求**：正文中必须出现明确的图表引导句（如“如图 4-1 所示”、“见表 7-1 中序号 3 指标”），严禁出现无正文引用的悬空图表。

### 6.3 数值、单位与专业符号书写规范
- **速率与吞吐量**：统一使用 `MB/s`（兆字节每秒，如 896 MB/s）、`Gbps`（吉比特每秒，如 25.6 Gbps）；严禁混淆 `MB/s` 与 `Mbps`；
- **时延与时间**：秒采用 `s`（如 30 s、5 min），毫秒采用 `ms`（如 17.55 ms），微秒统一采用 `$\mu$s` 或 `us`（如 1.8 $\mu$s），纳秒采用 `ns`（如 +0.340 ns），皮秒采用 `ps`（如 340 ps）；
- **时钟与传输频率**：采用 `MHz`（如 148.5 MHz、900 MHz）及 `GT/s`（吉次传输每秒，如 5.0 GT/s）；
- **图像分辨率与尺寸**：宽度与高度之间一律采用乘号 $\times$（如 $1920 \times 1080$、$960 \times 540$、$960 \times 320$），不用小写字母 x；
- **十六进制数**：寄存器地址与控制字统一采用前缀 `0x` 及大写十六进制字符（如 `0x850`、`0x1A0`、`0x80C`、`0x810`、`0x10C`）。

### 6.4 专业术语统一汇编表（必收 12 词）
| 序号 | 术语缩写 / 全称 | 中文权威定义与工程含义 | 本项目具体承载与体现 |
| :---: | :--- | :--- | :--- |
| **1** | **ADAS** (Advanced Driver Assistance Systems) | 高级驾驶辅助系统，利用传感器感知环境并提供安全辅助与告警 | 本系统所实现的红绿灯判决、车道偏离、压线警告与障碍物预警系统 |
| **2** | **SoC** (System on Chip) | 系统级芯片/片上系统，集成 CPU、GPU、NPU 及多媒体加速器的单芯片 | 本系统所采用的瑞芯微 RK3568 主控芯片 |
| **3** | **FPGA** (Field Programmable Gate Array) | 现场可编程门阵列，通过硬件重构实现极高并行计算与确定性时延 | 本系统所采用的紫光同创盘古 100Pro+（PG2L100H）芯片 |
| **4** | **NPU** (Neural Processing Unit) | 嵌入式神经网络处理器，专用于加速深度学习张量卷积与矩阵运算 | RK3568 集成的 1.0 TOPS 自研 NPU 架构 |
| **5** | **PCIe** (PCI Express) | 高速串行点对点计算机扩展总线标准 | 连接 RK3568 与盘古 FPGA 的高速物理链路（Gen2 x2，5.0 GT/s） |
| **6** | **DMA** (Direct Memory Access) | 直接内存访问，外设在脱离 CPU 干预下直接读写系统主存的技术 | FPGA 作为 Master 通过 PCIe 散列 DMA 直接拉取主机 CMA 帧存 |
| **7** | **CMA** (Contiguous Memory Allocator) | 连续内存分配器，Linux 内核预留用于大块物理连续内存分配的机制 | 系统通过 U-Boot 环境变量由 16 MB 扩容至 256 MB（基址 0xDDC00000） |
| **8** | **OSD** (On-Screen Display) | 屏幕视控系统/屏幕菜单叠加，在视频流逐行扫描过程中注入图形图层 | FPGA 在 148.5 MHz 像素流上硬件叠加 16 框、箭头、文本及全屏红框 |
| **9** | **MPP** (Media Process Platform) | 瑞芯微多媒体处理平台，提供底层 H.264/H.265 硬件解码与编码接口 | 用于解耦多路高清车载码流，输出零拷贝物理连续帧 |
| **10** | **RGA** (Raster Graphic Acceleration) | 瑞芯微 2D 图形硬件加速器，支持硬件裁剪、缩放、旋转与色彩格式转换 | 用于将视频帧并发派生为 960×540 显示帧与 960×320 NPU 宽幅帧 |
| **11** | **BEV** (Bird's Eye View) | 鸟瞰图/俯视图，通过逆透视变换（IPM）消除近大远小畸变的地面坐标系 | 硬件车道线检测算法与按键校准模式（cal_mode）的核心参考基准 |
| **12** | **WNS** (Worst Negative Slack) | 最差负时序裕量，静态时序分析（STA）中衡量全芯片建立时间收敛的核心指标 | cam11 固件实测全局 setup WNS = +0.340 ns，严格无时序违例 |

### 6.5 文档生成与排版工具链建议
1. **源码版本控制**：以 Markdown（`.md`）为主稿进行 Git 多人协同与审阅，确保技术指标与代码事实变更完全同步；
2. **多格式发布**：
   - 使用 **Pandoc + Eisvogel/自制模板** 编译生成符合竞赛规范的 Word (`.docx`) 与 PDF (`.pdf`) 文件；
   - 包含完整的标准要素：评审封面（参赛队号/题目/学校）、中文摘要与 3–5 个关键词、目录树、图目录、表目录、正文各章、致谢与参考文献；
3. **图表绘制质量控制**：
   - 严禁直接使用低分辨率手机拍屏或粗糙 ASCII 字符图；
   - 系统框图、数据流图与状态机统一使用 **Draw.io / Visio** 绘制，统一配色风格（推荐主色调：工业蓝 `#1A5276` / 科技青 `#117A65`），导出 600 DPI 以上矢量图置入；
   - 示波器与逻辑分析仪波形图使用暗色/白色高对比度专业截图，标注测量光标数值。
