Zdy-1110/FPGA-676/docs/提交前清理记录.md

# 提交前仓库清理与参数化记录 (2026-10-30)

## 1. 从 Git 索引移除的误跟踪文件 (11 个)
通过 `git rm --cached` 移出索引，本地工作区文件均保留：
- `fpga/src/disp/iic_dri.v.bak_20261019`
- `fpga/src/disp/ms7210_ctl.v.bak_20261019`
- `fpga/src/disp/ms72xx_ctl.v.bak_20261019`
- `fpga/src/disp/rt_disp_top.v.bak_20261019`
- `fpga/src/disp/rt_ext_regs.v.bak_20261019`
- `fpga/src/pango_pcie_dma_top.v.bak_20261019`
- `tools/pcie_bench/pcie_bench.bak_20261018`
- `tools/pcie_bench/pcie_bench.c.bak_preddr`
- `tools/adas/host_test/tl_host_main`
- `tools/adas/host_test/tl_host_main.exe`
- `tools/adas/host_test/tl_host_main.pdb`

## 2. .gitignore 追加规则分组
在 `.gitignore` 末尾追加 `# --- submission hygiene (20261030) ---`：
- **备份文件**: `*.bak_*`, `*.bak_*.*`, `*.bak_preddr`
- **编译中间件与二进制**: `*.exe`, `*.pdb`, `*.o`, `*.a`, `*.so`
- **未带扩展名的工具编译产物**:
  - `tools/menu/menu`, `tools/menu/menu_daemon`, `tools/menu/menu_launcher`
  - `tools/menu/mode_select`, `tools/menu/usb_menu`
  - `tools/usb_feed/usb_feed`, `tools/test_feeder/test_feeder`
  - `tools/pcie_feed/pcie_feed`, `tools/usb_feed/qnpu_selftest`
- **Menu 资源与打包产物**:
  - `menu/*.rgb565`, `menu/*.nv12`, `menu/ui_cjk.bin`, `menu/*.png`
  - `dist/`

## 3. 板端连接凭据参数化
对以下 5 个 Python 脚本去硬编码，保持默认值 `root`/`root` 向后兼容：
- `tools/rk_ssh.py`
- `tools/rk_get.py`
- `tools/rk_put.py`
- `tools/rk_push.py`
- `tools/rk_net_info.py`
新增可选环境变量：
- `RK_USER`: 用户名（默认 `root`）
- `RK_PASS`: 密码（默认 `root`）

## 4. 工作区残留文件提醒（打包需排除）
上述 11 个文件已不再受 Git 跟踪，但物理文件仍在工作区中（如备份与二进制）。
在执行最终提交打包或制作 Release 归档时，请确保：
1. 依据 `.gitignore` 规则进行打包过滤；
2. 特别注意无扩展名可执行文件 `tools/adas/host_test/tl_host_main` 需排除。
