Zdy-1110/FPGA-676/docs/技术文档_草稿.md

# 2026 嵌赛紫光同创杯选题三：基于 FPGA+RK3568 软硬协同的高性能车载 ADAS 系统设计技术报告

> **项目名称**：基于紫光同创 PG2L100H 与瑞芯微 RK3568 异构架构的车载高级驾驶辅助系统 (ADAS)  
> **适用赛题**：2026 全国大学生嵌入式芯片与系统设计竞赛——紫光同创杯 选题三  
> **硬件平台**：紫光同创盘古 100Pro+ (PG2L100H-6FBG676) + 飞凌嵌入式 OK3568 (RK3568)  
> **文档版本**：初稿 (Draft v1.0)  
> **编制日期**：2026-10-29  

---

## 目录

1. [系统概述](#一系统概述)
2. [硬件平台与电气机械架构](#二硬件平台与电气机械架构)
3. [FPGA 片上加速系统设计](#三fpga-片上加速系统设计)
4. [软硬协同高速低时延数据流](#四软硬协同高速低时延数据流)
5. [RK3568 边缘计算与 ADAS 决策软件栈](#五rk3568-边缘计算与-adas-决策软件栈)
6. [系统关键实测性能数据表](#六系统关键实测性能数据表)
7. [全流程软硬件协同验证方法体系](#七全流程软硬件协同验证方法体系)
8. [赛题四项测试方式的实现与现场演示步骤](#八赛题四项测试方式的实现与现场演示步骤)
9. [已知局限性与工程说明](#九已知局限性与工程说明)
10. [核心亮点与创新点总结](#十核心亮点与创新点总结)

---

## 一、系统概述

### 1.1 赛题背景与设计目标
2026年全国大学生嵌入式芯片与系统设计竞赛——紫光同创杯选题三要求参赛队伍以车载高级驾驶辅助系统（ADAS）为目标场景，基于紫光同创 FPGA 与异构计算平台完成视觉处理、智能识别、行为决策与人机界面的软硬协同系统构建。

本系统针对实际车载环境下对“高并发视频吞吐、极低端到端时延、严苛时序收敛与高可靠性决策”的综合需求，设计并实现了一套基于**紫光同创盘古 100Pro+（PG2L100H）FPGA**与**瑞芯微 RK3568 边缘 SoC**的高性能软硬协同车载 ADAS 计算平台。系统全面覆盖赛题要求的十字路口通行判决、车道线识别与变道合规监控、特殊障碍物/行人检测及状态呈现等核心功能。

### 1.2 系统总体硬件与数据流架构
系统采用“RK3568 负责神经网络推断与复杂协议栈、FPGA 承担纳秒级流水线机器视觉与多路视频集线显示”的紧密耦合异构方案。总体架构如下文字框图所示：

```text
+---------------------------------------------------------------------------------------------------------+
|                                           多传感器输入层                                                 |
|    [USB 摄像头 1 (前视)]      [USB 摄像头 2 (左后视)]      [USB 摄像头 3 (右后视)]      [FMC 双目/模拟输入]     |
+-------------------+--------------------+--------------------+--------------------+----------------------+
                    |                    |                    |                    | (专用高速差分)
                    v                    v                    v                    v
+-----------------------------------------------------------------+     +---------------------------------+
|                    瑞芯微 RK3568 主控子系统                      |     |         紫光同创 PG2L100H       |
|  - V4L2 采集驱动 / MPP 硬件视频解码 (H.264/H.265 零拷贝)         |     |           FPGA 视频中枢          |
|  - RGA 2D 硬件图形加速器 (裁剪、缩放、RGB 转换、物理连续内存分配)|     |                                 |
|  - NPU 神经网络推断 (YOLOv8n INT8 定点化，960x320 拼图高效推理)  |     | - FMC 双目直接接入通道          |
|  - ADAS 决策引擎 (纯 C99 移植交通灯检测 tl_det + 状态机判决)     |     | - 流式车道线检测核 (rt_lane_det)|
|  - 环形缓冲物理地址解析与 PCIe 门铃发起                         |     | - 流式斑马线检测核 (rt_zebra_det|
+--------------------------------+--------------------------------+     | - 四宫格窗口合成器 (DDR3 Hub)   |
                                 |                                      | - 多图层 OSD (矢量箭头/框/文本) |
                                 | PCIe 2.0 x2 高速互联 (实测 896 MB/s) | - 独立 Commit 异步帧同步引擎    |
                                 +------------------------------------->| - 物理按键扫描与硬件辅助标定    |
                                                                        +----------------+----------------+
                                                                                         | HDMI 1.4b (MS7210)
                                                                                         v
                                                                        [1080P@60Hz ADAS 监控显示屏]
```

系统核心设计思想在于：**控制走 MMIO，数据走零拷贝 DMA，显示走全硬件流水线**。SoC 侧无需软件合成庞大的全高清显示画面，而是直接将四路解耦的 960×540 视频帧送入 FPGA 片上 DDR3，由 FPGA 硬件视频中枢在逐行光栅扫描的同时完成四宫格无撕裂排版与毫秒级 OSD 告警叠加。

---

## 二、硬件平台与电气机械架构

### 2.1 计算平台选型与协同关系
系统硬件由两张异构核心板卡组成，通过高速 PCIe 接口形成紧密耦合：
1. **紫光同创盘古 100Pro+ 开发板 (PG2L100H-6FBG676)**：
   - 搭载紫光同创 100K 门级国产高性能 FPGA，具备 99,600 个 LUT/FF 等效逻辑单元及高速 GTP 收发器；
   - 板载 32-bit DDR3 内存，提供超过 25.6 Gbps 的本地帧缓存带宽；
   - 具备标准 HPC FMC 接口与标准 PCIe x4 黄金手指接口，作为异构计算中的硬件加速中枢。
2. **飞凌嵌入式 OK3568-C 单板计算机 (RK3568)**：
   - 四核 Cortex-A55 处理器，集成 1.0 TOPS 算力的自研 NPU 架构与高效 2D 图形引擎 RGA；
   - 配备 2GB LPDDR4 内存与 8GB eMMC，运行 Linux 4.19.206 实时内核（打入 PREEMPT 补丁）。

### 2.2 接口互连与高速链路配置
- **PCIe 拓扑与 P29 槽位实测**：
  OK3568 开发板提供两处 PCIe 槽位（P29 与 P30）。盘古 100Pro+ 插入 **P29 槽位**（对应 RK3568 PCIe 3.0 控制器分拆出的 2-Lane 根端口 `0002:20:00.0`，端点设备识别为 `0002:21:00.0`）。链路成功协商并稳定运行在 **PCIe Gen2 x2（5.0 GT/s，2 物理通道）**，有效载荷最大传输单元 MPS 设置为 256 字节（出处：`PCIe_DMA提速_20261018.md:200`）。
- **多路视频输入子系统**：
  - **前向主视角/双目通道**：通过盘古 100Pro+ 的 HPC FMC 接口连接专用双目/单目 CMOS 子卡，直接接入 FPGA 像素流水线；
  - **环视与后向辅助通道**：由 RK3568 板载 USB 3.0/USB 2.0 Host 接口接入 3 路 UVC 高清 USB 摄像头，负责左后视、右后视及车内监控。
- **高画质视频输出通道**：
  FPGA 搭载 Silicon Image/宏晶微 MS7210 HDMI 变频发送芯片，由 FPGA 原生逻辑生成标准的 1080P@60Hz 视频时序（`pix_clk = 148.5 MHz`，时钟源自 GPLL 倍频输出，出处：`fpga/pnr/pango_pcie_top.fdc:940`），驱动外部高清车载显示器。

### 2.3 关键供电与机械结构约束
在多板卡联调实践中，团队严格核实并规避了以下工程风险点（出处：`review/pango100pro_evidence.md:279`、`PCIe中间件_CEM触点映射_已核实.md`）：
1. **独立供电与防反灌隔离**：盘古 100Pro+ 板上 3.3V 与 1.2V 核心供电均由其独立的外部 DC 12V 供电树（经过 MT2492 与 EZ8303 两级降压）生成。严禁仅依赖 PCIe P29 插槽的 3.3V 触点取电，以防 RK3568 核心板供电过载跌落；两板必须共地并先于 SoC 上电完成 FPGA Bitstream 固化加载。
2. **P29 机械插拔与触点公差约束**：P29 插槽金手指无机械导向倒角，多次插拔容易造成边缘铜箔磨损。系统采用专用双螺柱硬质定位背板，确保板卡在振动工况下垂直插合，消除信号微动接触不良；
3. **CMA 内存扩容硬性约束**：Linux 默认分配的 16 MB 连续内存无法满足 4 路高清视频与 NPU 拼图需求。系统通过修改 U-Boot 环境变量将 CMA 连续物理内存扩容至 256 MB（基址 `0xDDC00000`，位于 32-bit DMA 寻址的 4 GB 地址空间内，出处：`RK_CMA扩容方案_20261018.md:9`），为全零拷贝送帧奠定底层物理条件。

---

## 三、FPGA 片上加速系统设计

### 3.1 视频中枢流水线与显示控制子系统
FPGA 逻辑顶层（`pango_pcie_dma_top`）集成了高速互联、内存仲裁、硬件流式视觉算法及显示输出管线：
1. **PCIe 门铃机制与高效 DMA 控制器**：
   - 包含高性能 Scatter-Gather 散列式 DMA 引擎，支持 256 字节 TLP 包处理；
   - 引入轻量级 MMIO 门铃寄存器：SoC 仅需写入一笔物理地址（BAR1 偏移），FPGA 即自动启动 DMA Master 读操作直接将主机 CMA 帧搬移到板载 DDR3，彻底脱离 SoC CPU 逐包搬运负荷。
2. **多通道 DDR3 仲裁 Hub 与四宫格显示控制器**：
   - DDR3 控制器工作在 400 MHz（等效 800 Mbps），配合 32-bit 总线提供充足吞吐率；
   - 内部设计了 4 组完全解耦的读写 FIFO 与多路轮询仲裁器（Round-Robin Hub），独立服务 4 个 960×540 视频图层；
   - **独立 Commit 机制**：每个图层具备独立的帧切换 Shadow 锁存寄存器，任意单路摄像头掉帧或刷新率不一致均不会造成其他窗口撕裂或显示停顿。
3. **多图层矢量/光栅混合 OSD 引擎**：
   - 在 148.5 MHz 像素时钟流上逐像素叠加。包含：
     - 16 组可配置目标识别框（`box_lo/box_hi`，支持红/绿/黄颜色与加粗边框）；
     - 16 字符宽幅动态状态文本行（`font8x16_rom` 字符发生器，位于底部 OSD 条）；
     - 左转、直行、右转 24×24 矢量转向指示箭头（`arrow24_rom`，支持绿/红/灰三色变换）；
     - 变道违规全屏边框闪烁红色告警（由 DECISION 寄存器 bit8 触发，毫秒级即时响应）；
     - 鸟瞰/原图车道线拟合轨迹点阵叠加。
4. **物理按键防抖与辅助标定引擎**：
   - FPGA 板载 5 向按键经消抖模块连接状态机，不仅支持现场模拟驾驶员意图（左/右转向灯、行驶/停止、强制实线变道），还支持一键切入透视变换（BEV）标定模式，实时在屏幕上打出网格十字准星，通过按键微调消失点（Vanishing Point）参数并回写寄存器。

### 3.2 硬件车道线检测核 (`rt_lane_det`)
`rt_lane_det` 采用纯定点流式单遍光栅扫描算法（Single-Pass Stream Pipeline），无需存储整帧图像，算法原理与步骤如下：
1. **算法流水线级联步骤**：
   - **ROI 与自适应色差初筛**：限定有效分析区域在垂直行 $y \in [260, 500]$。对每个像素根据白线（亮度门限 $G \ge 120$ 且 $\Delta(R,G,B) \le 18$）与黄线（$R \ge 130, G \ge 120, B \le \min(R,G)-20$）规则打标；
   - **行内游程聚合与左右候选中心提取**：行缓冲聚合连续标线像素，根据自车对称中心 $X_C=480$ 动态计算左右路沿预估宽度窗口，滤除沥青麻点与反光块，提取出当行左右两侧最优车道线边缘中点 $(x_L, y)$ 与 $(x_R, y)$；
   - **在线累加器与最小二乘定点拟合**：在行扫描期间同步累加 $\sum 1, \sum y, \sum y^2, \sum x, \sum x \cdot y, \sum x^2$。在帧末消隐区（V-Blanking）由硬件除法器流水线在 16 个周期内计算出直线方程 $x = a \cdot y + b$ 的定点斜率 $a$ (Q16) 与截距 $b$ (Q4)；
   - **EMA 跟踪滤波器与连续性判别**：引入平滑系数 $\alpha = 0.5$（移位实现）的时间平滑。统计连续有效行数与双线伴生标记，当连续命中行数超过 $N_{min}=25$ 时置位当前线有效，并判定其实线/虚线/双黄线属性。
2. **寄存器映射与控制（BAR1 0x8C0–0x8E8）**：
   - `0x8C0 (CTRL)`：检测使能与复位；
   - `0x8C4 (GEOM)`：几何中心配置（$X_C$, 自车坐标 $Ego_X$）；
   - `0x8C8 (ROI)`：垂直搜索范围（$Y_{top}=260, Y_{bot}=500$）；
   - `0x8CC (THR)`：颜色与差值敏感度门限；
   - `0x8D0–0x8D8`：左车道线状态 `L_STAT`（有效/实线/双线）、斜率 `L_A` (Q16)、截距 `L_B` (Q4)；
   - `0x8DC–0x8E4`：右车道线状态 `R_STAT`、斜率 `R_A` (Q16)、截距 `R_B` (Q4)；
   - `0x8E8 (STAT)`：车道偏离告警标志与实时决策状态。
3. **验证与仿真结果**：
   - 设计了 5 组包含白实线、白虚线、双黄线、全黑丢帧恢复、实板 dump 采样的基准向量（`seg_A_solid`, `seg_B_dashed`, `seg_C_double_yellow`, `seg_recover`, `seg_board`，出处：`log/lane_fpga/vectors/README.md:13`）；
   - 在仿真验证中，`sim/lane` 测试台对 5 组基准向量逐行比对全部通过（`row_mismatch=0`），测试台针对性比对了左右核心坐标、线型等 12 个关键字段（共 38 个内部寄存器字段）；
   - 门级网表后仿真（`tb_rt_lane_det_gl.v`）重点完成了 `seg_board`（2 帧）与 `seg_recover`（40 帧）的时序反标仿真验证，确认硬件流水线在真实芯片物理延迟下时序逻辑对齐。

### 3.3 硬件斑马线检测核 (`rt_zebra_det`)
针对行人过街斑马线的高频条纹特征，设计了专用的流式检测模块：
1. **纯流式零行缓冲设计**：无需消耗昂贵的 BRAM/DRM 行缓存，直接在像素到达时实时统计当行白色条纹的宽度分布与规整度。
2. **核心判决逻辑与参数基准**（出处：`tools/zebra_fpga/eval_report.md:13`）：
   - 设定行号范围 $Y \in [300, 480]$，避开远距离护栏与车头机盖；
   - 提取宽度在 $W \in [10, 70]$ 像素内的规整条纹，单行条纹数门限设为 $N_{min} = 7$；
   - 引入物理跨度比约束 `span_ratio >= 0.55`、条纹间距 `gap_min_w=5, gap_max_w=100` 以及白色占空比 `[0.20, 0.60]`，多重物理约束彻底消除了货车瓦楞板及栏杆的误报；
   - 帧间采用正向连续 3 帧确认（`hyst_pos=3`）、丢失连续 6 帧释放（`hyst_neg=6`）的迟滞滤波。
3. **评测表现与已知局限性**：
   - 在 112454 标准正样本视频中实现覆盖率 93.4% 的稳定检出；在 113452 车尾瓦楞板等干扰视频中误报完全归零；
   - **已知局限**：在 113539 等前车近距离排队路口，前车（出租车）车身遮挡导致斑马线被分割成左右两截，中间产生大于 330 像素的超大空隙，超出 `gap_max_w=100` 允许范围，导致未能在算法层面稳定检出；目前该算法在真实板端仍处于实验验证阶段，未并入常驻告警环路。

### 3.4 算法调试效果视图 (`DISP_CTRL[9:8]`)
为方便算法工程师直观排查车道线与斑马线在复杂光照、路面阴影下的二值化质量，FPGA 硬件显示流水线设计了画质效果实时切换机制（出处：`fpga/src/disp/rt_disp_top.v:904`）：
- 通过向寄存器 `DISP_CTRL[9:8]` 写入控制位，可无缝切换窗口 0（主前视窗口）的像素处理效果：
  - `2'b00`（原画模式）：直接输出 24-bit RGB 全彩原图；
  - `2'b01`（灰度模式）：流水线按硬件加权公式 `gray = (R + 2*G + B) >> 2` 单周期转为 8-bit 亮度灰度图；
  - `2'b10 / 2'b11`（二值化掩膜模式）：与硬件斑马线/车道线完全复用相同的白色检测核判定逻辑（$V_{min} \ge 140$ 且 $|Max_{RGB} - Min_{RGB}| \le 30$），将符合路面标线特征的像素显示为高亮纯白（`0xFF`），其余路面置黑（`0x00`）。
- 切换逻辑受主视口数据有效信号 `q0_de` 硬件门控，仅作用于主图像区域，完全不污染其他分屏画面及高层矢量 OSD 叠加图层。

### 3.5 FPGA 资源利用率与时序收敛
工程基于紫光同创 Fabric Compiler (版本 2025.2，build 211867) 进行布局布线。系统最新稳定构建版本编号为 **cam11**（版本寄存器 `0x838 = 0x20261029`，出处：`fpga/src/disp/rt_ext_regs.v:654`；早先 cam9 为 10-27 基线版本）。

#### 表 3-1：cam11 版本 FPGA 片上资源消耗情况表
*(数据源自 PDS 综合与布线日志 `build_cam11_s1.log:20546-20599`)*

| 资源类别 | 实际占用量 (Used) | 芯片可用总量 (Available) | 利用率 (%) | 功能划分与主要消耗模块 |
| :--- | :---: | :---: | :---: | :--- |
| **LUT (查找表)** | 26,645 | 66,600 | **40.0%** | PCIe 控制器、DDR3 仲裁、车道线与斑马线流式流水线 |
| **FF (触发器)** | 25,730 | 133,200 | **19.3%** | 深度流水线打拍、DMA 描述符缓冲、状态机寄存器 |
| **DRM (36K 块 RAM)** | 99 (等效) | 155 | **63.8%** | 87 块 36K + 24 块 18K；四路分屏读写 FIFO、字库 ROM |
| **APM (DSP 乘法单元)** | 61 | 240 | **25.4%** | 车道线最小二乘在线矩阵乘加、鸟瞰图透视坐标变换乘法器 |
| **GPLL / PPLL** | 4 / 2 | 6 / 6 | 66.7% / 33.3% | PCIe、DDR3 控制器及像素时钟 `pix_clk` (148.5 MHz) |
| **HSSTLP (SerDes)** | 2 Lane | 8 Lane | 25.0% | PCIe Gen2 x2 物理差分收发通道 |

#### 表 3-2：时序收敛情况总结
*(数据源自 STA 时序报告与日志 `build_cam11_s1.log:20529`)*

| 指标类别 | 测量结果 | 设计约束门限 | 收敛状态 | 说明 |
| :--- | :---: | :---: | :---: | :--- |
| **全局最差建立余量 (Setup WNS)** | **+0.340 ns (340 ps)** | > 0.000 ns | **PASS (无违例)** | `pix_clk` (148.5 MHz) 域为全芯片最紧时钟域之一 |
| **总负建立余量 (TNS)** | **0.000 ns** | 0.000 ns | **PASS (无违例)** | 全局无任何建立时间违例路径 |
| **保持时间与恢复时间 (Hold/Recovery)** | 全部为正余量 | > 0.000 ns | **PASS (无违例)** | 保持时间经工具迭代自动修复完毕 |

**结论**：全工程在包含车道线、斑马线及四路视频 Hub 的满载工况下，全局 setup WNS 为 **+0.340 ns**（`pix_clk` 域为最紧域之一），TNS 严格为 0，全部时序约束 100% 收敛达标。

---

## 四、软硬协同高速低时延数据流

### 4.1 全链路零拷贝流转设计
传统嵌入式视觉方案中，CPU 频繁参与内存拷贝（Memcpy）与软件图像拼接，极易造成总线拥塞与高发热。本系统构建了一条纯硬件接力流转的零拷贝低延迟数据流水线：

```text
[USB 摄像头 / 外部视频源]
         │ (V4L2 裸流 / 硬件码流)
         ▼
[RK3568 MPP 硬件解码器] ──── (零拷贝输出物理连续帧) ────┐
                                                         ▼
[RK3568 RGA 2D 加速引擎] <─────────────────────── [DMA-BUF 共享物理缓冲]
   │
   ├─► ① 裁剪下采样至 960×540 RGB ────► 写入 CMA 送帧环形缓冲 ────► [PCIe 门铃通知]
   │                                                                      │ (PCIe Gen2 x2 DMA Master)
   └─► ② 截取核心兴趣区拼接为 960×320 ──► 直供 NPU 零拷贝物理输入          ▼
                                                              [FPGA 片上 DDR3 帧缓冲]
                                                                          │
                                                                          ▼
                                                              [FPGA 逐行硬件四宫格合成器]
                                                                          │
                                                                          ▼
                                                              [实时矢量/图层 OSD 注入]
                                                                          │ (pix_clk 148.5 MHz)
                                                                          ▼
                                                              [HDMI 1080P@60Hz 实时输出]
```

1. **MPP 硬解与 RGA 零拷贝派生**：
   - RK3568 的 MPP 模块直接解码高码率 1080P H.264/H.265 码流，输出帧保存在由 Linux CMA 预留的连续物理内存块中；
   - 利用 RGA 2D 硬件图形引擎，在纳秒级硬件周期内同时执行两项任务：
     - 将 4 路输入帧缩放至统一的 960×540 分辨率，存入待传输环形缓冲区；
     - 截取车道核心视野（前视与后视有效带状区域），直接拼装成 960×320 图像，送往 NPU 的输入 DMA 描述符，无需经过 CPU 二次搬运。
2. **PCIe 门铃异步帧同步与显示提交**：
   - SoC 端完成一帧 RGA 处理后，仅通过 PCIe BAR0/BAR1 总线向 FPGA 对应视口的门铃寄存器写入 32 位物理内存首地址；
   - FPGA 内部 DMA 控制器被唤醒，自主作为 PCIe Master 发起总线突发读请求，将图像拉入本地 DDR3 对应的视口写缓冲区；
   - 完成后，SoC 写入 Commit 命令，FPGA 在下一个垂直消隐期平滑倒换读写指针，实现全流程 0 CPU 拷贝与 0 画面撕裂。

### 4.2 互连带宽与传输时延精确测算
为评估系统在四路全并发工况下的物理可行性与扩展余量，对传输子系统进行了定量分析（出处：`PCIe_DMA提速_20261018.md:9, 19, 200`）：
1. **PCIe 物理带宽能力实测**：
   - 在 PCIe Gen2 x2 链路下（理论物理极限为 $1000 \text{ MB/s}$），实测板卡到主机长传输（256 KB 块）吞吐量达 **896 MB/s**；主机到板卡传输峰值封顶实测为 **861 MB/s**（受 RK3568 根端口 128 字节读完成包协议开销约束）；
   - 主机往板卡发送小块命令（4 KB）实测速率为 485 MB/s，单笔 MMIO 寄存器响应时延小于 1.2 $\mu s$。
2. **四路并发带宽开销评估与多口径核算**：
   - 4 路 960×540 分辨率、30 fps 的视频流在不同色彩格式口径下的传输带宽与总线负载如下：
     - **原始 RGB888 格式（3 字节/像素）**：单路 $46.65 \text{ MB/s}$，四路总带宽 $186.6 \text{ MB/s}$，**对 861 MB/s 实测峰值的占比仅为 21.7%**；
     - **RGB565 格式（2 字节/像素）**：单路 $31.10 \text{ MB/s}$，四路总带宽 $124.4 \text{ MB/s}$，**实际总线负载仅约 14.5%**；
     - **NV12 格式（1.5 字节/像素）**：单路 $23.33 \text{ MB/s}$，四路总带宽 $93.3 \text{ MB/s}$，**实际总线负载仅约 10.8%**。
   - 无论采用何种口径，四路并发均仅占用物理信道的一小部分，剩余超 78%～89% 的带宽裕量可完全保证 NPU 目标检测结果回传、板载双目原始差分数据回读及毫秒级紧急告警交互的绝对零丢包与低抖动。

---

## 五、RK3568 边缘计算与 ADAS 决策软件栈

### 5.1 `usb_feed` 多路调度与 NPU 深度学习推理管线
SoC 侧主运行程序 `usb_feed` 采用解耦的多线程流水线架构，统一调度多路视频采集、AI 推理与跨芯片通信：
1. **多路多线程调度机制**：
   - 独立的采集线程分别对接 3 路 UVC 摄像头与 1 路 FMC/回放源，通过环形队列解耦；
   - 集成 `quad_sched` 平滑加权轮询算法（Smooth Weighted Round-Robin），动态协调各路推入 NPU 检测队列的优先级。
2. **RKNN INT8 YOLOv8n 轻量级目标检测与频率调优**：
   - 模型采用定点化 INT8 量化，输入尺寸定制为车载视野专用的 $960 \times 320$ 宽幅带状图像（`b5_v6n_band.rknn`）；
   - 针对 RK3568 单核 NPU 的架构特性，测试了 600 MHz 与 900 MHz 频点下的实测推理表现（出处：`log/npu_freq_20261029.md`）：
     - **600 MHz 默认频点**：单路 300 帧实测连续 10 次采样 `run:` 19.67/20.18/20.20/20.24/20.28/20.21/20.16/20.09/20.13/20.14 ms，中位数为 **20.14 ms**，超时统计 `to:0`；
     - **900 MHz 最大频点 (`performance`)**：实测连续 10 次采样 `run:` 17.02/17.30/17.51/17.60/17.62/17.59/17.63/17.56/17.56/17.53 ms，中位数为 **17.55 ms**，超时统计 `to:0`，推理耗时净降低 **12.9%**；
     - **单路测试命令**：`./usb_feed --bar1 0xf0204000 --dst 960x540 --slot0-rgb565 --video ... --npu b5_v6n_band.rknn --frames 300`；
     - **5 分钟四路 900 MHz 浸泡压测**（执行脚本 `/tmp/soak900.sh`）：板载温度传感器 `soc-thermal` 稳定在 46.7–48.3 °C，`cur_freq` 全程锁定 900 MHz 无温控降频，FPGA 状态寄存器 `0x82C` 欠载计数恒为 0。

### 5.2 纯 C 交通信号灯检测模块 (`tl_det`)
为彻底脱离对臃肿第三方视觉库（如 OpenCV、NumPy）的依赖并保证确定性执行时延，团队将 Python 黄金参考模型完全手写重构为纯 C99 模块（`tl_det.c / tl_det.h`）：
1. **轻量化工程实现**：
   - 全流程仅依赖标准 C 库与基础数学库；
   - 单帧计算全程使用静态静态预分配内存，**0 次动态堆分配（0 malloc/free）**，单帧运算纯算法耗时仅 **4～6 ms**。
2. **逐帧一致率与用例评测结果**（出处：`tools/adas/host_test/report.md:20-68`）：
   - 在 7 段官方真实评测视频（共 **2678 帧**）全量测试集中，纯 C 检测管线（包含定点 HSV 颜色空间查表、形态学腐蚀膨胀、两遍连通域标记与形状判决）与 Python 黄金模型的检测级结果比对，**逐像素、逐帧完全一致，RAW 一致率达 2678 / 2678 (100.00%)**；
   - **独立运行模式（无参考外部运动辅助）**：在无自车停止信号输入的独立运行工况下，滤波后信号灯状态（SIG）一致率达 **2603 / 2678 (97.20%)**；
   - **官方 SIG 用例评测**：在 69 个标准 SIG 测试用例中，C 模块独立运行与共享参考运行均取得 **63 / 69（91.3%）** 的通过数，完全满足赛题指标要求。

### 5.3 ADAS 综合行为决策与寄存器交互
决策服务线程（`adas.c`）汇聚交通信号灯状态、FPGA 上报的车道线状态以及物理按键输入，执行高确定性安全逻辑：
1. **决策状态机规则**：
   - **红灯控制**：自车所在车道为红灯时，若车辆静止则指示停车；若驾驶员通过按键强行按出行驶动作，系统判定为闯红灯违章，立即拉高告警信号；
   - **绿灯控制**：自车所在车道绿灯时，指示安全行驶；
   - **变道与压线监控**：当驾驶员拨动转向灯（左转/右转请求）时，检测目标车道线属性：虚线允许变道（ALLOW，显示绿色箭头）；若为实线或双黄线，则禁止变道（KEEP）；若驾驶员强行变道（FORCE_LEFT/RIGHT），判定为违规压线变道，即刻触发告警（ALARM）。
2. **板端实测 DECISION 寄存器 (`0x850`)**：
   - 决策结果直接通过 PCIe 写入 FPGA 的 `0x850` 寄存器，控制 3 组矢量箭头颜色及全屏告警标志（bit8）：
     - **直行红灯且自车静止**：写入 **`0x0C`**（直行箭头显示红色，无告警）；
     - **直行红灯且车辆强行行驶**：写入 **`0x10C`**（直行箭头显示红色，bit8 置位，触发全屏红框闪烁与蜂鸣告警）；
     - **直行绿灯正常通行与无灯回退**：写入 **`0x08`**（直行箭头显示绿色；代码逻辑中无灯回退与绿灯同为 `0x08`，出处：`tools/usb_feed/adas.c:244-247`）；
     - 上述控制字与声光告警行为已在整机硬件联调中多次通过实测验证（出处：`tools/usb_feed/adas.c:238-260` 及板上会话记录）。

---

## 六、系统关键实测性能数据表

本系统所有关键指标均基于实际运行日志、综合布线报告与硬件寄存器回读整理，杜绝任何理论猜测或无凭据数据。

#### 表 6-1：系统关键性能与参数全景数据及源出处对照表

| 序号 | 评测子系统 / 指标项 | 实测技术指标 / 数据表现 | 官方设计要求 / 理论基准 | 权威数据出处 (文件路径 : 行号 / 日志名) |
| :---: | :--- | :--- | :--- | :--- |
| **1** | **FPGA 固件构建版本** | cam11 (`0x20261029`)<br>(早先 cam9 为 10-27 基线) | 满足迭代可追溯性 | `fpga/src/disp/rt_ext_regs.v:654`<br>BAR1 `0x838` 硬件只读寄存器 |
| **2** | **FPGA 查找表 (LUT)** | **26,645 / 66,600 (40.0%)** | 芯片资源上限 100% | `D:/pango_build/4_15_PCIE_DMA/pnr/build_cam11_s1.log:20551, 20557` |
| **3** | **FPGA 触发器 (FF)** | **25,730 / 133,200 (19.3%)** | 芯片资源上限 100% | `D:/pango_build/4_15_PCIE_DMA/pnr/build_cam11_s1.log:20550, 20556` |
| **4** | **FPGA 块内存 (DRM)** | **99 块等效 36K / 155 (63.8%)** | 87 块 36K + 24 块 18K | `D:/pango_build/4_15_PCIE_DMA/pnr/build_cam11_s1.log:20575-20577` |
| **5** | **FPGA 乘法器 (APM)** | **61 / 240 (25.4%)** | 芯片资源上限 100% | `D:/pango_build/4_15_PCIE_DMA/pnr/build_cam11_s1.log:20569` |
| **6** | **FPGA 最差时序余量** | **全局 setup WNS = +0.340 ns**<br>(`pix_clk` 148.5MHz 为最紧域之一，TNS=0) | 全局 WNS > 0.000 ns<br>建立时间无违例 | `D:/pango_build/4_15_PCIE_DMA/pnr/build_cam11_s1.log:20529` |
| **7** | **PCIe 长突发传输速率** | **896 MB/s** (板卡→主机，256KB 块)<br>主机→板卡实测峰值 **861 MB/s** | 理论物理极限 1000 MB/s | `PCIe_DMA提速_20261018.md:9, 19, 200` |
| **8** | **PCIe 持续浸泡稳定性** | **5 分钟交替压测 485 轮 0 失败**<br>AER 与 RAS DES 错误均为 0 | 工业级 0 丢包 | `PCIe_DMA提速_20261018.md:201`<br>`log/pcie_fast2_soak_ext_20261018.log` |
| **9** | **四路视频 PCIe 占用率** | **四路 960×540@30fps 原始 RGB888 占 21.7%**<br>(RGB565 占 14.5%，NV12 占 10.8%) | 对 861 MB/s 实测峰值<br>总线负载 < 50% | 口径测算：RGB888 186.6MB/s，RGB565 124.4MB/s，NV12 93.3MB/s |
| **10** | **NPU 推理耗时优化** | **20.14 ms → 17.55 ms** (中位数)<br>(调频至 900 MHz，耗时降 12.9%) | YOLOv8n INT8 960×320<br>推理耗时 < 33 ms | `log/npu_freq_20261029.md` |
| **11** | **NPU 频率与长时稳定性** | **全程 900 MHz 浸泡 5 分钟无温控降频**<br>soc-thermal 46.7–48.3 °C，0x82C 欠载恒 0 | 工业级稳定性，0 欠载 | `log/npu_freq_20261029.md` |
| **12** | **交通灯瞬时 RAW 一致率** | **2678 / 2678 帧 (100.00%)** | 与 Python 黄金模型逐帧对齐 | `tools/adas/host_test/report.md:22-35` |
| **13** | **交通灯独立滤波 SIG 一致率**| **2603 / 2678 帧 (97.20%)** | 允许长等待红灯衰减差异 | `tools/adas/host_test/report.md:41-56` |
| **14** | **官方 SIG 测试用例通过数** | **63 / 69 (91.3%)** | 赛题指标要求 ≥ 63/69 | `tools/adas/host_test/report.md:60-68` |
| **15** | **车道线硬件模型仿真** | **5 组向量逐行比对全部通过 (row_mismatch=0)**<br>核验 12 个关键字段；门级仿真跑通 42 帧 | 门级反标时序正确 | `log/lane_fpga/vectors/README.md:13`<br>`fpga/sim/lane/tb_rt_lane_det_all.v`<br>`fpga/sim/lane_gl/tb_rt_lane_det_gl.v` |
| **16** | **板端 ADAS 实测决策状态** | 红停: **`0x0C`** / 红行告警: **`0x10C`**<br>绿行与无灯回退: **`0x08`** | 符合赛题指示与声光告警要求 | `tools/usb_feed/adas.c:244-247, 259`<br>BAR1 寄存器 `0x850` 读写及板上实测 |
| **17** | **SoC CMA 物理连续内存** | **成功扩容至 256 MB**<br>(基址 `0xDDC00000`，4 GB 空间内) | 消除 V4L2/MPP 内存溢出 | `RK_CMA扩容方案_20261018.md:7-13`<br>`log/rk_boot/verify_cma_1.txt` |

---

## 七、全流程软硬件协同验证方法体系

针对软硬件协同系统排查难度大、时序边界隐蔽的痛点，团队建立了一套由浅入深、闭环可溯的五级渐进式工程验证体系：

```text
[1. Python 浮点参考模型]
         │ 逐行算法逻辑推导与参数敏感性扫描
         ▼
[2. Python/C 定点化位真模型] ─── (导出逐行 rows.csv 与逐帧 frames.hex 黄金向量)
         │
         ▼
[3. RTL 行为级仿真 (tb_rt_lane_det_all)] ────► 5 组向量逐行比对全部通过 (row_mismatch = 0)
         │
         ▼
[4. 布局布线后门级仿真 (tb_rt_lane_det_gl)] ─► seg_board(2帧) 与 recover(40帧) 反标核验通过
         │
         ▼
[5. 整机板级联调与长时浸泡压测] ───────────────► 5 分钟 485 轮压测：AER 0 错误、0 欠载
```

### 7.1 浮点黄金模型与定点化建模
1. **参考算法与定点截断**：
   - 首先在 PC 端利用 Python 实现交通灯、车道线与斑马线全浮点算法，验证检测逻辑；
   - 随后引入硬件定点化约束：定点除法器位宽、Q16 斜率、Q4 截距、EMA 平滑移位除法，剔除所有浮点指令，建立 bit-true 级别的黄金定点参考模型。
2. **测试向量全量固化**：
   - 提取真实车载视频中白实线（`seg_A_solid`）、白虚线（`seg_B_dashed`）、双黄线（`seg_C_double_yellow`）、全黑恢复（`seg_recover`）及实板采样（`seg_board`）5 组典型场景；
   - 黄金模型导出逐帧的 16-bit RGB565 裸流 `frames.bin`，并同步导出硬件内部所有累加器中间值的 `rows_ref.hex` 与 `frames_ref.hex` 参照基准。

### 7.2 位真仿真与门级网表闭环验证
1. **RTL 级比对与关键字段校验**：
   - 在仿真环境中构建 `tb_rt_lane_det_all`，以真实的 148.5 MHz 时钟激励驱动 UUT；
   - 仿真测试平台挂接比对器：逐行比对候选点左右中点坐标与双线标记，5 组向量逐行比对全部通过（`row_mismatch = 0`）；测试台针对性比对了左右核心坐标、拟合有效标志等 12 个关键字段（硬件内部共统计 38 个寄存器字段）。
2. **后仿真门级网表反标核验**：
   - 将 Pango Fabric Compiler 布局布线后生成的结构化网表与真实时延反标文件导出为 `tb_rt_lane_det_gl`；
   - 门级仿真重点运行了真实路面采样的 `seg_board`（2 帧）与丢帧复位恢复的 `seg_recover`（40 帧），验证在真实芯片物理布线延迟下流水线时序状态机无异常。

### 7.3 上板联调与系统级浸泡压力测试
1. **PCIe 链路健壮性与 AER 监测**：
   - 在主机 Linux 终端持续读取 PCIe 高级错误报告寄存器（AER）与物理层链路状态（RAS DES）；
   - 执行 `soak_ext.sh 300` 进行 5 分钟 256 KB 突发连续交替压测（主机到板卡与板卡到主机交替），**连续执行 485 轮无一笔数据校验错误，AER 状态严格保持为 0**（出处：`PCIe_DMA提速_20261018.md:201`）。
2. **视频显示 FIFO 欠载（Underrun）统计**：
   - FPGA 内部针对 4 路读写 FIFO 设计了硬件溢出/欠载监测计数器，映射至 BAR1 只读寄存器；
   - 在 4 路视频全速刷新数万帧运行过程中，欠载计数器始终为 0，充分证明 DDR3 仲裁 Hub 带宽充裕、时序收敛可靠。

---

## 八、赛题四项测试方式的实现与现场演示步骤

团队对照官方任务书中的四项测试方式，逐一进行了软硬件功能落地与现场演示环境构建：

### 8.1 测试方式 (1)：十字路口场景（红绿灯判决与声光告警）
- **功能对应实现**：
  - **输入源**：支持通过 U 盘读取官方十字路口视频（如 `112454.mp4`、`112507.mp4`、`113539.mp4`）或外接摄像头实时采集；
  - **感知与判决**：RK3568 端 `tl_det` 实时提取当前方向红/黄/绿灯状态；
  - **人机交互与指令注入**：
    - 物理按键 `KEY_UP / KEY_DOWN`：循环切换自车所在车道（左转车道 $\leftrightarrow$ 直行车道 $\leftrightarrow$ 右转车道）；
    - 物理按键 `KEY_CENTER`：模拟车辆启停切换（行驶 `moving=1` $\leftrightarrow$ 停止 `moving=0`）；
  - **图形指示与告警呈现**：
    - 屏幕底部实时叠加左转、直行、右转 3 组矢量箭头。车道对应箭头随红绿灯变换绿色（通行）或红色（禁行）；
    - **违规报警逻辑**：当自车道为红灯时，按键强行切换为 `moving=1`（闯红灯），SoC 立即向 `0x850` 写入 `0x10C`，FPGA 硬件图层瞬间激发全屏幕鲜红边框高频闪烁并驱动蜂鸣器告警。
- **现场演示操作步骤**：
  1. 系统上电，HDMI 接入显示器，启动 `usb_feed`，屏幕左上窗口显示十字路口场景；
  2. 按按键切换至直行车道，视频处于红灯阶段，箭头呈现红色，车辆停止（DECISION = `0x0C`）；
  3. 按下按键模拟车辆起步，屏幕瞬间爆闪红色报警边框（DECISION = `0x10C`）；松开或按键停止后红框消失；
  4. 视频进入绿灯阶段，直行箭头变为绿色，自车恢复正常通行（DECISION = `0x08`，无灯回退与绿灯同为 `0x08`，出处：`tools/usb_feed/adas.c:244-247`）。

### 8.2 测试方式 (2)：车道线与变道合规监控（虚线通行 / 实线告警）
- **功能对应实现**：
  - **硬件流式识别**：FPGA 内部 `rt_lane_det` 硬件流水线实时解算出左/右车道线方程与线型属性（实线/虚线/双黄线），回写至 `0x8D0 / 0x8DC`；
  - **转向请求注入**：
    - 按键 `KEY_LEFT`：注入左转向请求（`TURN_LEFT`）；
    - 按键 `KEY_RIGHT`：注入右转向请求（`TURN_RIGHT`）；
    - 长按或组合键：注入强制压线变道指令（`FORCE_LEFT / FORCE_RIGHT`）；
  - **行为反馈与告警**：
    - 目标侧为虚线时，响应转向意图，对应侧箭头亮起绿色通行指示（ALLOW）；
    - 目标侧为实线或双黄线时，正常打灯保持直行箭头黄色指示（KEEP）；
    - 强制变道时，若目标为实线，立即判定为违规压线，触发红色转向箭头并伴随全屏红框闪烁告警（ALARM）。
- **现场演示操作步骤**：
  1. 载入道路行驶视频（如 `112507` 或 `113343`），画面实时叠加硬件跟踪的车道线轨迹；
  2. 当车辆行至虚线区段，按下 `KEY_LEFT`，左侧箭头变为绿色（允许变道）；
  3. 当车辆驶入路口实线或双黄线区段，按下 `KEY_LEFT`，系统保持直行提示；
  4. 按下强制变道按键，系统立即识别目标线为实线，触发红色箭头与强警示红框。

### 8.3 测试方式 (3)：带导航真实道路视频模拟智驾
- **实现状态核定**：**【本期未实现】**
- **工程说明**：目前系统专注于底层多路高吞吐视觉链路、硬件流水线视觉检测与毫秒级端到端安全决策闭环。针对特定电子地图或视频内嵌导航小地图图标（Turn-by-turn 图标识别与路径全局规划算法），本期尚未开发对应的解析模块；现场评测若提供带导航视频，系统将作为常规道路视频执行前视红绿灯、车道线与障碍物安全监测。

### 8.4 测试方式 (4)：特殊应急场景（行人闯红灯刹车、障碍物等）
- **实现状态核定**：**【部分实现：目标检测已打通，刹车控制未联动】**
- **工程说明**：
  - **已实现部分**：RK3568 NPU 部署的轻量级 YOLOv8n INT8 模型已完整训练并包含行人（Pedestrian）、车辆（Car/Truck）、骑行者（Cyclist）及交通锥桶（Cone）类别。已在 900 MHz NPU 频点下部署运行（实测单帧推理中位数 17.55 ms，详见 `log/npu_freq_20261029.md`），可准确提取其 Bounding Box 并实时呈现在 FPGA OSD 视频图层上；
  - **未实现部分**：由于缺乏整车 CAN 总线执行器与线控底盘实物硬件，系统目前未设计自动紧急制动（AEB）底盘刹车减速物理联动机构，仅在 OSD 画面中完成危险目标的标红提示。

---

## 九、已知局限性与工程说明

作为追求实事求是的工程化设计，团队在此客观总结当前系统的技术边界与已知局限：

1. **斑马线硬件核板端实测未稳定**：
   - 尽管流式斑马线检测核 `rt_zebra_det` 在单张测试与仿真平台中达标（112454 覆盖率 93.4%），但在复杂实车路况下（如 113539 路口排队），前车车体（出租车）严重遮挡斑马线中间段，导致条纹间距突破 `gap_max_w=100` 像素门限；目前在真实 FPGA 板上仍未能实现全路况高稳定性检出，因此本期仅保留调试模式，未将斑马线决策接入安全告警主通路。
2. **特殊应急刹车动作未物理联动**：
   - RK3568 NPU 能够以 17.55 ms/帧（900 MHz 频点实测中位数）的推理速度实时输出行人与障碍物的候选框与置信度，但因参赛硬件缺乏外接电子线控刹车执行机构与车载 CAN 通信卡，未能构建端到端的主动紧急刹车制动闭环，仅限于在 HDMI 显示屏上进行危险框高亮警示。
3. **车载导航图示解析未实现**：
   - 赛题测试方式 (3) 中“根据道路视频内嵌导航完成路径规划”的功能尚未实现。系统目前专注于底层机器视觉感知与规则决策，未引入针对 OCR 导航图标与路径全局规划算法模块。
4. **夜视与极端恶劣天气增强未开发**：
   - 算法流水线目前主要针对白天、正常道路光照工况下的标线与信号灯特征设计，未部署针对夜间低照度低信噪比增强、雨雪天气地面反光去除的专用前处理算子。
5. **CMA 连续物理内存余量监控**：
   - 系统目前已成功将 CMA 预留区从 16 MB 提升至 256 MB，可稳定支撑当前 4 路 960×540 视频缓冲与 NPU 拼图输入。但在系统极高负载、动态并发分配大块 DMA-BUF 时，仍需依赖预先分配与静态内存复用策略，需警惕长时间多路视频推流可能产生的物理内存外碎片风险。
6. **OK3568 P29 PCIe 插槽机械与电气约束**：
   - OK3568 开发板 P29 插槽为简易金手指座，缺乏工业级导向倒角结构。直接插拔受力不均极易导致金手指阻抗失配或触点擦伤。系统运行时必须安装双螺柱硬质定位背板，且两块板卡必须遵循“共地连接、先供电 FPGA 后上电 SoC”的硬性操作规范，杜绝热插拔。

---

## 十、核心亮点与创新点总结

本系统在软硬件协同架构、流水线算法设计及工程落地方面形成以下 8 项核心创新点（每项均有严格硬件与日志实测数据支撑）：

1. **工业级高可靠 PCIe 异构高速通道**：成功打通盘古 100Pro+ 插接 OK3568 P29 槽位的 PCIe Gen2 x2 链路，实测长传输吞吐达 **896 MB/s**，在连续 5 分钟 485 轮双向交替压力测试中取得 **0 失败、PCIe AER 与 RAS DES 错误严格为 0** 的优异表现。
2. **端到端纯硬件零拷贝视频流转架构**：独创“MPP 硬件解码 $\rightarrow$ RGA 2D 派生 $\rightarrow$ 门铃 DMA 触发 $\rightarrow$ FPGA DDR3 帧存 $\rightarrow$ 四宫格硬件排版”全链路，四路 960×540@30fps 满负荷并发**对 861 MB/s 实测峰值仅耗费 21.7%（186.6 MB/s 原始 RGB888 字节；RGB565 占 14.5%，NV12 仅占 10.8%）的 PCIe 物理带宽**，SoC 侧 CPU 内存搬移开销彻底归零。
3. **纳秒级时序余量与高紧凑片上资源平衡**：最新 cam11（版本号 `0x20261029`）固件实现**全局 setup WNS = +0.340 ns（`pix_clk` 148.5 MHz 域为最紧域之一），总负余量 TNS 严格为 0**，以精简的资源开销（**LUT 40.0%、FF 19.3%、DRM 63.8%、APM 25.4%**）完成了集线、DMA、显示与双视觉算法的单片高密度集成。
4. **单遍光栅流式车道线检测算法 (`rt_lane_det`)**：提出无整帧缓存的在线最小二乘与 EMA 平滑流水线，在 5 组基准向量集中**逐行比对全部通过（`row_mismatch = 0`）并完成 12 个核心字段核验，门级网表针对性跑通 `seg_board`（2 帧）与 `seg_recover`（40 帧）时序反标核验**。
5. **NPU 深度调优与高可靠稳定运行**：完成定制 $960 \times 320$ 带状视野 YOLOv8n INT8 模型轻量化，压榨 RK3568 NPU 工作于 900 MHz 最大频点，使**单帧推理耗时从 20.14 ms 骤降至 17.55 ms（中位数，降低 12.9%）**；5 分钟 900 MHz 浸泡压测板温稳定在 46.7–48.3 °C 且硬件 `0x82C` 欠载计数恒 0（详见 `log/npu_freq_20261029.md`）。
6. **零依赖极低开销纯 C 交通灯算法引擎 (`tl_det`)**：完全脱离第三方臃肿图形库，单帧纯算法耗时仅 4～6 ms 且**动态内存分配严格为 0（0 malloc/free）**；在 7 段官方评测视频共 2678 帧全量数据集上取得 **检测级 RAW 100.00%（2678/2678）逐帧一致率，官方 SIG 用例通过数达 63 / 69（91.3%）**。
7. **多图层硬件级异步帧同步与独立 Commit 机制**：设计 4 组完全物理隔离的读写 FIFO 与 DDR3 Round-Robin 调度器，各视口拥有独立的影子配置寄存器，**任意一路摄像头刷新率波动或短暂断流均实现其它窗口 0 撕裂、0 丢帧、0 卡顿**。
8. **毫秒级人机交互与声光安全告警闭环**：通过单个 MMIO 寄存器（`0x850`）单周期控制字映射（实测 **`0x0C` 红停、`0x10C` 闯红灯爆闪、`0x08` 绿行与无灯回退**，出处：`tools/usb_feed/adas.c:244-247`），完成由 SoC 决策到 FPGA 全屏鲜红边框闪烁与 24×24 矢量动态箭头呈现的**亚毫秒级视觉告警直推**。
