Zdy-1110/FPGA-676/tools/lane_fpga/exp_gaptol_20261102.md

# 车道线定点模型 gap_tol 与双黄抑制实验报告 (2026-11-02)

- **实验时间**：2026-11-02 22:56:18
- **基线复现状态**：`G=0, solid_rows=61` 成功复现 **16/32 (50.0%)** (d2s=10, s2d=6)。
- **PDS 综合窗口**：今晚 23:20 决策截止，本实验为是否重跑 RTL 综合提供定点依据。

## 一、参数网格扫描结果表 (PASS/32 及 d2s/s2d 错数)

### Rule A (RTL基线双黄: 帧内累加>=61行)

| gap_tol (G) | sr=61 | sr=73 | sr=85 | sr=97 | sr=109 | sr=121 |
|---|---|---|---|---|---|---|
| **G=0** | 16/32 (d10/s6) | 12/32 (d10/s10) | 13/32 (d9/s10) | 11/32 (d9/s12) | 11/32 (d9/s12) | 11/32 (d9/s12) |
| **G=1** | 15/32 (d11/s6) | 16/32 (d10/s6) | 12/32 (d10/s10) | 13/32 (d9/s10) | 13/32 (d9/s10) | 11/32 (d9/s12) |
| **G=2** | 15/32 (d11/s6) | 15/32 (d11/s6) | 16/32 (d10/s6) | 12/32 (d10/s10) | 13/32 (d9/s10) | 13/32 (d9/s10) |
| **G=3** | 15/32 (d11/s6) | 15/32 (d11/s6) | 15/32 (d11/s6) | 16/32 (d10/s6) | 12/32 (d10/s10) | 12/32 (d10/s10) |
| **G=4** | 16/32 (d12/s4) | 15/32 (d11/s6) | 15/32 (d11/s6) | 16/32 (d10/s6) | 12/32 (d10/s10) | 12/32 (d10/s10) |
| **G=6** | 18/32 (d12/s2) | 14/32 (d12/s6) | 14/32 (d12/s6) | 15/32 (d11/s6) | 16/32 (d10/s6) | 12/32 (d10/s10) |

### Rule B (双黄门限与实线门限同步)

| gap_tol (G) | sr=61 | sr=73 | sr=85 | sr=97 | sr=109 | sr=121 |
|---|---|---|---|---|---|---|
| **G=0** | 16/32 (d10/s6) | 11/32 (d7/s14) | 11/32 (d5/s16) | 14/32 (d2/s16) | 14/32 (d2/s16) | 13/32 (d1/s18) |
| **G=1** | 15/32 (d11/s6) | 12/32 (d10/s10) | 8/32 (d8/s16) | 11/32 (d5/s16) | 12/32 (d4/s16) | 14/32 (d2/s16) |
| **G=2** | 15/32 (d11/s6) | 13/32 (d11/s8) | 8/32 (d10/s14) | 8/32 (d8/s16) | 9/32 (d7/s16) | 12/32 (d4/s16) |
| **G=3** | 15/32 (d11/s6) | 13/32 (d11/s8) | 13/32 (d11/s8) | 8/32 (d10/s14) | 7/32 (d9/s16) | 11/32 (d5/s16) |
| **G=4** | 16/32 (d12/s4) | 13/32 (d11/s8) | 13/32 (d11/s8) | 12/32 (d10/s10) | 9/32 (d9/s14) | 11/32 (d5/s16) |
| **G=6** | 18/32 (d12/s2) | 14/32 (d12/s6) | 12/32 (d12/s8) | 13/32 (d11/s8) | 13/32 (d9/s10) | 9/32 (d9/s14) |

### Rule C (双黄套用gap_tol连续计数, 门限=实线门限)

| gap_tol (G) | sr=61 | sr=73 | sr=85 | sr=97 | sr=109 | sr=121 |
|---|---|---|---|---|---|---|
| **G=0** | 10/32 (d10/s12) | 13/32 (d5/s14) | 12/32 (d2/s18) | 12/32 (d2/s18) | 12/32 (d2/s18) | 14/32 (d0/s18) |
| **G=1** | 11/32 (d11/s10) | 10/32 (d10/s12) | 9/32 (d7/s16) | 12/32 (d4/s16) | 11/32 (d3/s18) | 12/32 (d2/s18) |
| **G=2** | 15/32 (d11/s6) | 13/32 (d11/s8) | 8/32 (d10/s14) | 8/32 (d8/s16) | 7/32 (d7/s18) | 10/32 (d4/s18) |
| **G=3** | 15/32 (d11/s6) | 13/32 (d11/s8) | 13/32 (d11/s8) | 8/32 (d10/s14) | 7/32 (d9/s16) | 11/32 (d5/s16) |
| **G=4** | 16/32 (d12/s4) | 13/32 (d11/s8) | 13/32 (d11/s8) | 12/32 (d10/s10) | 9/32 (d9/s14) | 11/32 (d5/s16) |
| **G=6** | 18/32 (d12/s2) | 14/32 (d12/s6) | 12/32 (d12/s8) | 13/32 (d11/s8) | 13/32 (d9/s10) | 9/32 (d9/s14) |

### Rule D (双黄套用gap_tol连续计数, 门限=30行)

| gap_tol (G) | sr=61 | sr=73 | sr=85 | sr=97 | sr=109 | sr=121 |
|---|---|---|---|---|---|---|
| **G=0** | 10/32 (d10/s12) | 11/32 (d7/s14) | 12/32 (d4/s16) | 13/32 (d3/s16) | 11/32 (d3/s18) | 11/32 (d3/s18) |
| **G=1** | 13/32 (d11/s8) | 10/32 (d10/s12) | 10/32 (d8/s14) | 9/32 (d7/s16) | 11/32 (d5/s16) | 11/32 (d5/s16) |
| **G=2** | 15/32 (d11/s6) | 15/32 (d11/s6) | 10/32 (d10/s12) | 9/32 (d9/s14) | 9/32 (d9/s14) | 10/32 (d8/s14) |
| **G=3** | 15/32 (d11/s6) | 15/32 (d11/s6) | 15/32 (d11/s6) | 12/32 (d10/s10) | 12/32 (d10/s10) | 8/32 (d10/s14) |
| **G=4** | 16/32 (d12/s4) | 15/32 (d11/s6) | 15/32 (d11/s6) | 16/32 (d10/s6) | 12/32 (d10/s10) | 10/32 (d10/s12) |
| **G=6** | 18/32 (d12/s2) | 16/32 (d12/s4) | 16/32 (d12/s4) | 17/32 (d11/s4) | 16/32 (d10/s6) | 16/32 (d10/s6) |
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
