Zdy-1110/FPGA-676/tools/lane_fpga/exp_temporal_20261102.md

# RK 端车道线时序分类器实验报告 (2026-11-02)

## 一、评测口径与平凡解参考标尺

本实验严格遵循 ADAS 变道核心业务逻辑：**虚线允许变道（ALLOW），实线/双黄线禁止变道（KEEP/ALARM）**。
针对 32 个 LANE 用例（12 个虚线用例，20 个实线/双黄线用例），设立以下综合指标：
- **虚线通过数**：$D / 12$（目标变道成功率）
- **实线通过数**：$S / 20$（实线阻拦合规率）
- **均衡分（主指标）**：$\text{Bal} = \frac{D}{12} + \frac{S}{20}$（范围 $[0, 2.0]$，两类权重均等）
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
