Zdy-1110/FPGA-676/docs/figs/fig_arch_overview.png

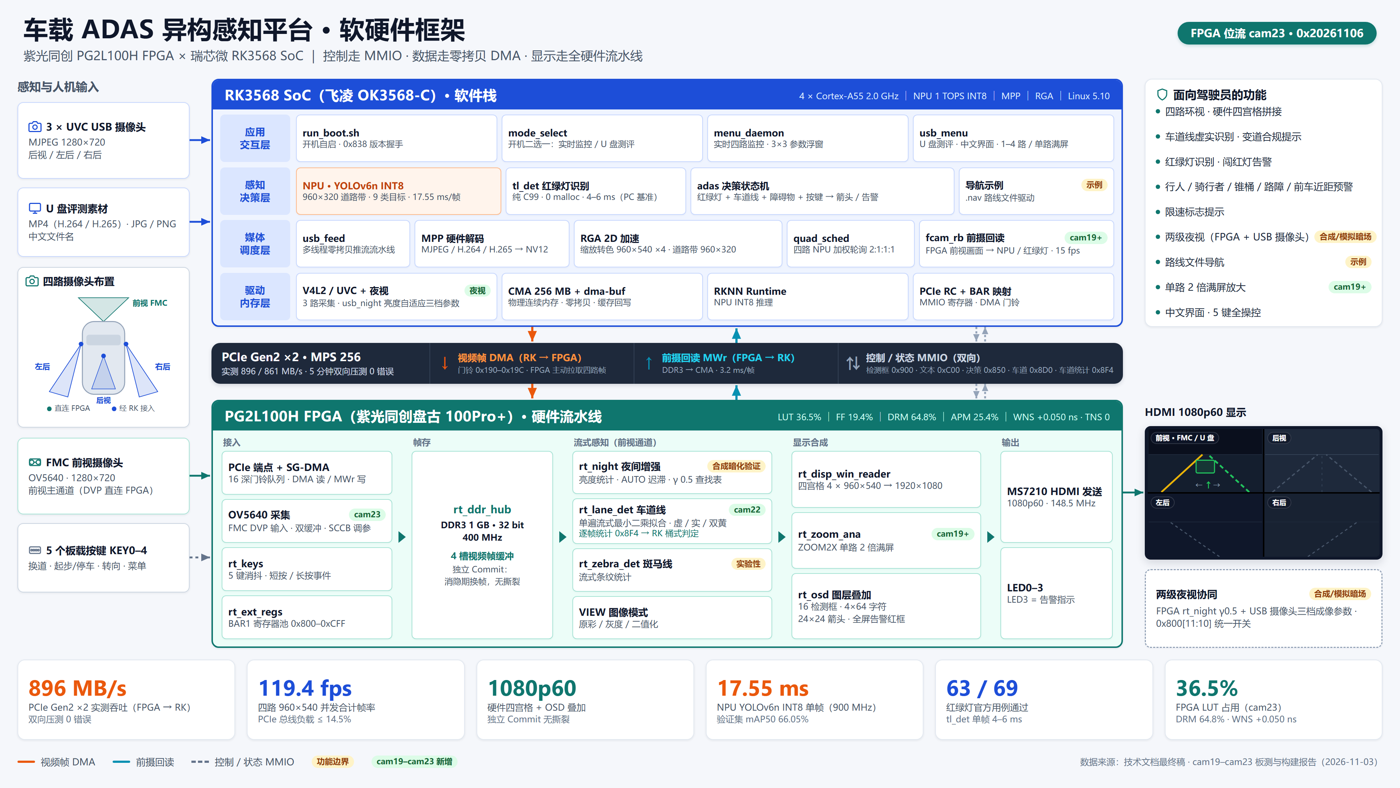
docs/figs/fig_arch_overview.png
