Zdy-1110/FPGA-676/tools/nav_proto/templates/crop48_inspect.jpg

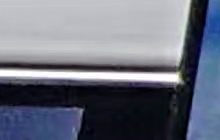
tools/nav_proto/templates/crop48_inspect.jpg
