Zdy-1110/FPGA-676/tools/nav_proto/templates/crop50.jpg

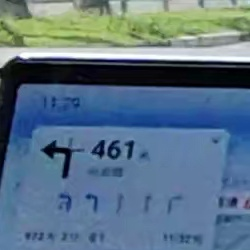
tools/nav_proto/templates/crop50.jpg
