Zdy-1110/FPGA-676/tools/nav_proto/templates/f54_nav_crop.jpg

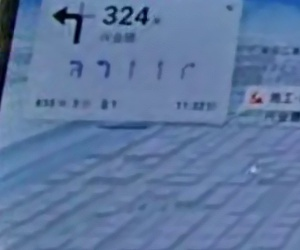
tools/nav_proto/templates/f54_nav_crop.jpg
