Zdy-1110/FPGA-676/tools/nav_proto/templates/frame_70.0s.jpg

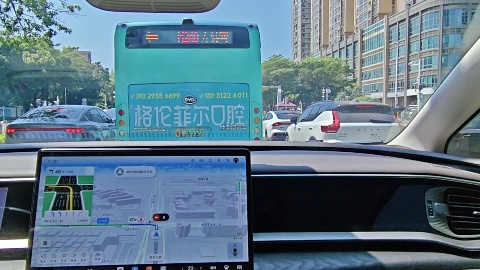
tools/nav_proto/templates/frame_70.0s.jpg
