Zdy-1110/FPGA-676/tools/nav_proto/templates/gt_quad_10.0s.jpg

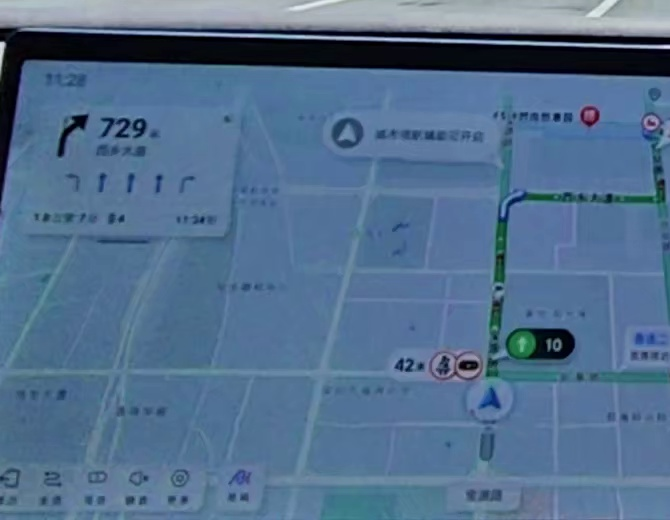
tools/nav_proto/templates/gt_quad_10.0s.jpg
