Zdy-1110/FPGA-676/tools/nav_proto/templates/quad_6.0s.jpg

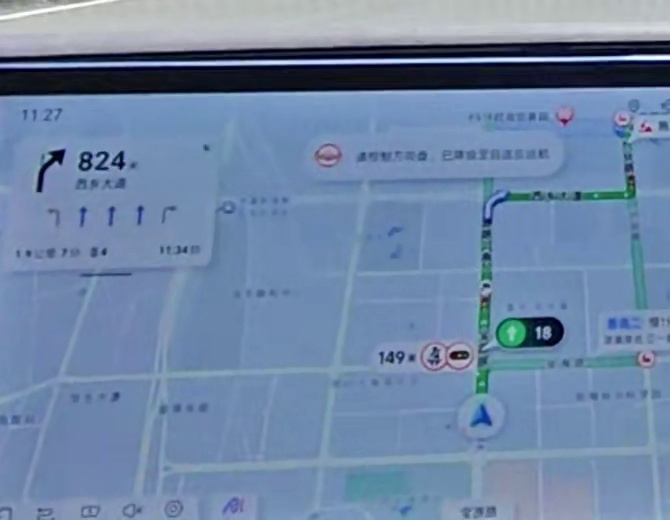
tools/nav_proto/templates/quad_6.0s.jpg
