Zdy-1110/FPGA-676/tools/nav_proto/templates/seq_52.0s.jpg

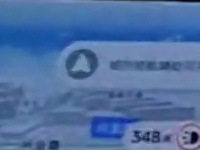
tools/nav_proto/templates/seq_52.0s.jpg
