Zdy-1110/FPGA-676/tools/nav_proto/templates/sub48_full.jpg

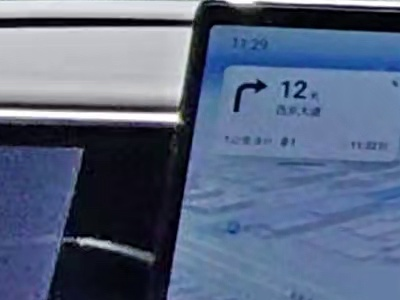
tools/nav_proto/templates/sub48_full.jpg
