Zdy-1110/FPGA-676/tools/nav_proto/templates/sub_02.0s.jpg

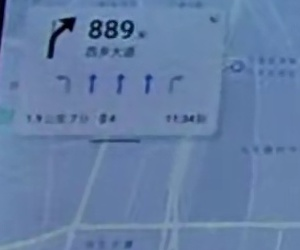
tools/nav_proto/templates/sub_02.0s.jpg
