Zdy-1110/FPGA-676/tools/nav_proto/templates/tiles2/tile_2_1.jpg

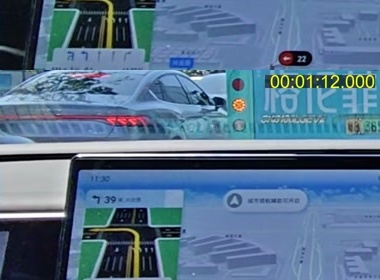
tools/nav_proto/templates/tiles2/tile_2_1.jpg
