Zdy-1110/FPGA-676/tools/night_eval/out/dark/day_112739_10.jpg

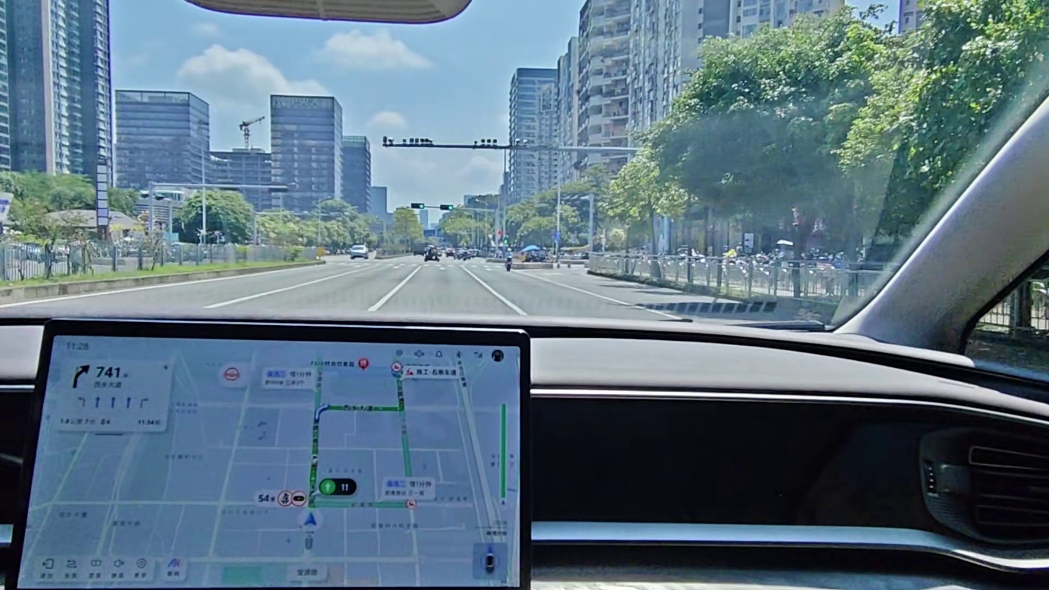
tools/night_eval/out/dark/day_112739_10.jpg
