Zdy-1110/FPGA-676/tools/night_eval/out/dark/day_113539_50.jpg

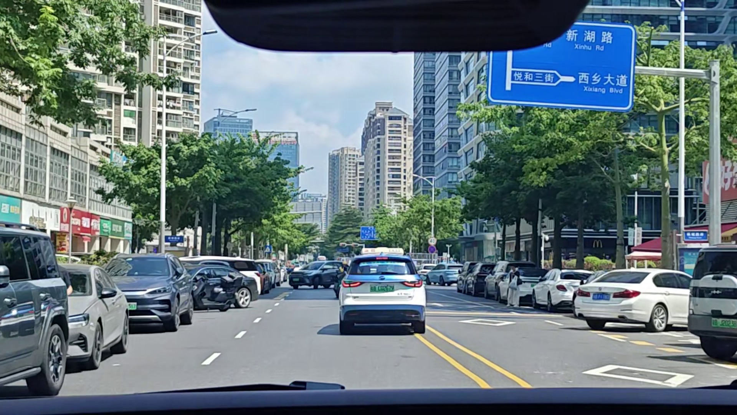
tools/night_eval/out/dark/day_113539_50.jpg
