Zdy-1110/FPGA-676/tools/night_eval/out/dark/night25_112739_50.jpg

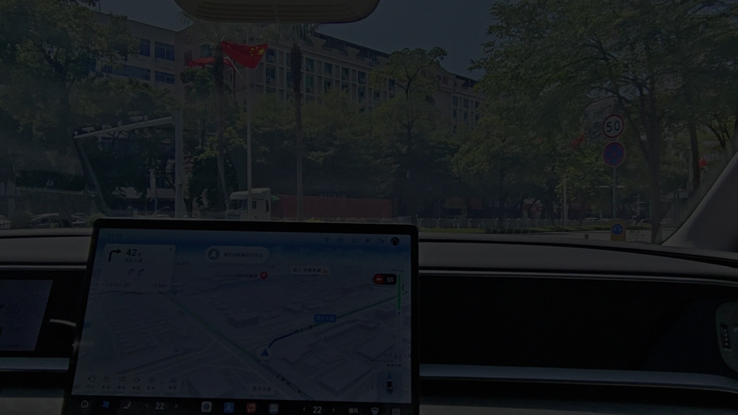
tools/night_eval/out/dark/night25_112739_50.jpg
