Zdy-1110/FPGA-676/tools/night_eval/out/dark/night25_113539_10.jpg

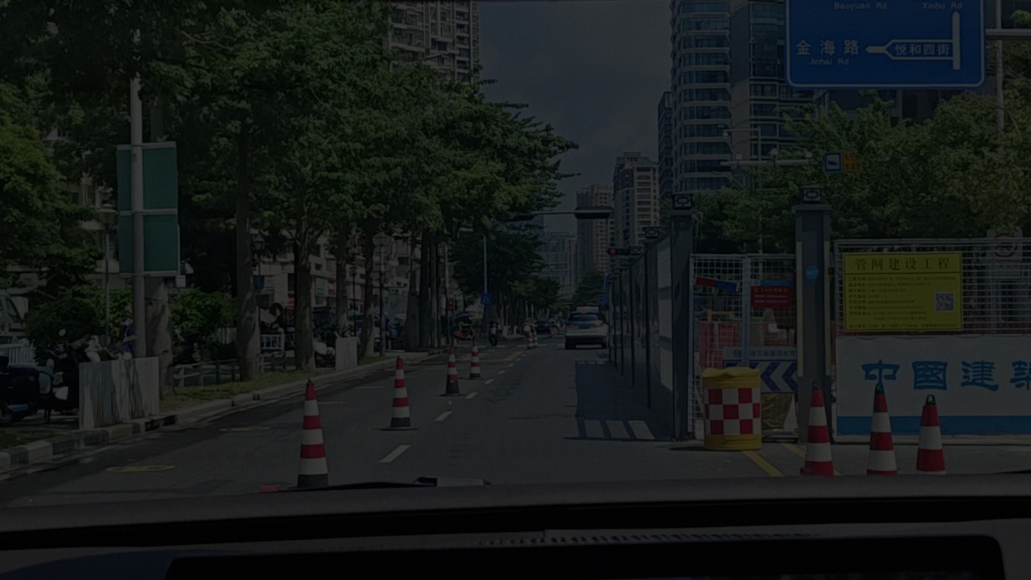
tools/night_eval/out/dark/night25_113539_10.jpg
