Zdy-1110/FPGA-676/tools/night_eval/out/dark/sim_gamma_night25_112739_50.jpg

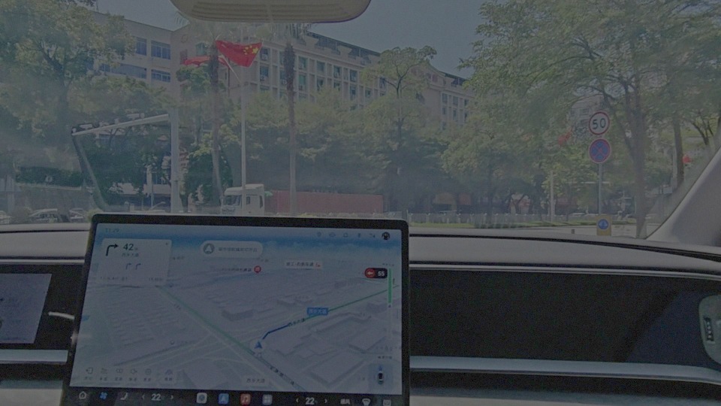
tools/night_eval/out/dark/sim_gamma_night25_112739_50.jpg
