Zdy-1110/FPGA-676/tools/night_eval/out/dark/sim_gamma_night40_112739_10.jpg

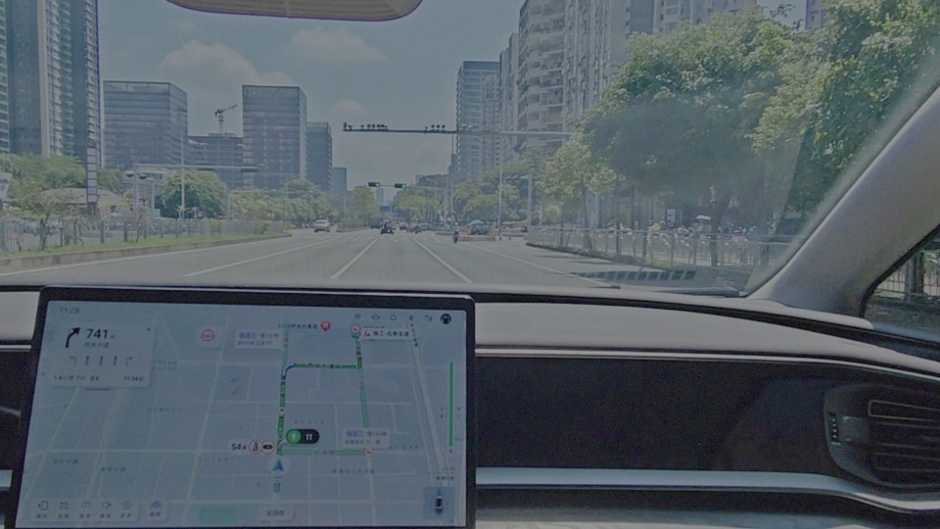
tools/night_eval/out/dark/sim_gamma_night40_112739_10.jpg
