Zdy-1110/FPGA-676/docs/提交清单与待办.md

# 提交清单与待办（2026-11-01）

## 零、2026-11-01 状态（cam18 与新功能交付）

### 1. cam18 构建与板测结论
- **位流与版本**：`D:/pango_work/quad/out/quad_cam18.sbit`（MD5 `c760ab29fb2cb2e2d0ff56207a8b5ed7`），固件版本寄存器 `0x838 = 0x20261101`（取代 cam17 作为提交位流）；构建脚本 `fpga/pnr/build_cam18.tcl`，PDS 2025.2 4-seed 综合实现。
- **时序与资源**：Slow 0.95V 85°C 下 All Constraints Met；pix_clk 148.5 MHz WNS = +0.321 ns，全局最差建立裕量 +0.086 ns（DDR PHY 路径），TNS = 0.000 ns，最差保持 +0.060 ns；片上资源：LUT 24,064/66,600 (36.1%)、FF 25,536/133,200 (19.2%)、DRM 100/155 (64.5%)、APM 62/240 (25.8%)。
- **板测结论**：JTAG 加载板测通过。112739 白天视频回放与 cam17 同条件对比决策字 348/360 一致、`night_active` 恒为 0；暗化静态图（Y25/Y40）AUTO 精准切入夜间，车道候选点显著召回（129/83）；4 路混播 75 s 合计 119.4 fps，`err=0`，欠载 `0x82C=0`；实时双目约 30 fps，`0x82C=0`。

### 2. 三项新功能
- **FPGA 自适应夜间增强（`rt_night.v`）**：`0x800[11:10]` AUTO/ON/OFF，`0x820` bit3 状态 / `[11:4]` slot0 帧亮度均值；8 帧迟滞比较（<48 入，>64 出）；两组 $\gamma=0.5$ LUT（感知前端与显示端）；Questa 仿真 4 用例通过，7 段白天视频 8024 帧 0 误触（GATE PASS）；软件菜单暗底写 `0x865` 避误判。边界：无真实夜间道路实采，仅合成暗化验证，全局固定 gamma，极暗（<15）无效。
- **导航示例（路线文件驱动）**：`tools/nav_proto/make_navfile.py` 从 112739 真值时间线生成 `.nav` 文件；`usb_feed --nav` 加载并在窗口内注入虚拟转向，复用虚实线规则（实线不变道 9 次），OSD 追加 `NAV:x`；`test_nav.c` 宿主单测 PASS；板端实测决策时序对齐在 $\pm 2\text{ s}$ 内。边界：为模拟导航输出，离线小地图模板匹配准确率 53.3% 未上板，无全局规划。
- **前车/路障预警与双目测距独立演示**：
  - `adas.c` 的 `hazard` 扩展纳入 cls 7 路障及 cls 2/3/4 车辆（需 `moving_eff=1` 起步）；112739 回放未误报；边界：车辆/路障报警正向触发未在板上验证。
  - 双目测距独立位流 `st2c.sbit`（JTAG 加载）：FMC 双 OV5640（基线 3 cm），5×5 Census 视差引擎（$D=128$），40×40 网格着色渲染、4 行遥测字符、近距报警边框；板端首次上板 30 fps，近距白墙触发报警；边界：物理真值拟合标定未做（参数为理论估计值），按键未逐项验收，画面偏紫，不合入四路主工程。

### 3. 本次源码包与技术文档
- **归档文件**：`dist/nesai2026_src_20261101.zip`
- **规模与校验**：597 个文件 + MANIFEST.txt（共 598 条目），文件大小 38.9 MB（40,768,424 字节），SHA256 为 `84023a3a7272a92436d20e405743c0278e358ab7b62fcc0af01d83025a752beb`；内含 cam18 位流与 10 份 `evidence/` 评测日志。
- **技术文档构建**：`docs/技术文档_最终稿.pdf` 实测 71 页。

### 4. 自动化质量自检 (selftest)
- 执行 `python tools/selftest.py`：全量 **21/21 passed 全部 PASS**（退出码 0），覆盖交叉构建、脚本语法、文档不变量、二进制资产、旧口径禁词与源码包内容检查。

## 一、已完成（历史记录 2026-10-30）

| 项 | 状态 | 位置 / 证据 |
|---|---|---|
| 技术文档正文（12 章） | ✅ 61 页 | `docs/技术文档_最终稿.md` / `.docx` / `.pdf` |
| 附录 A 寄存器手册 | ✅ | `docs/附录A_寄存器映射.md`（已并入正文） |
| 附录 B 验证复现记录 | ✅ | `docs/附录B_验证复现.md`（已并入正文） |
| 附录 C 术语与缩写 | ✅ | `docs/附录C_术语与缩写.md`（已并入正文） |
| 6 张 300 dpi 配图 | ✅ | `docs/figs/fig1–fig6.png` |
| 演示分镜（2:54） | ✅ | `docs/演示视频_分镜.md` |
| 答辩问答（22 问） | ✅ | `docs/答辩要点_评委问答.md` |
| 现场运行手册 | ✅ | `docs/演示现场运行手册.md` |
| 源码包（含 MANIFEST） | ✅ 569 文件 / 30.0 MB | `dist/nesai2026_src_20261030.zip`（SHA256 `28d7fe0a…`） |
| 关键指标复现 | ✅ | 交通灯 2678 帧、车道线 16/32、斑马线 93.4% |
| 门级后仿 42 帧 | ✅ | `repro_board.log`、`repro_recover40.log`（42 帧 `row_mismatch=0`） |
| 一键自检 | ✅ 18/18 | `python tools/selftest.py` |
| Git 检查点 | ✅ | tag `checkpoint-20261030-windows`、`checkpoint-20261030-final` |

## 二、板端回归（2026-10-30 已实测通过）

- [x] 连续 5 次「实时（开 3 路 USB）→ 长按 KEY4 3 s → 选择界面」无残影/卡死；冷启动 1 次 slot0 超时后重试成功；
- [x] `usb_feed --still` 单张 JPG：60 帧、解码 1920×1080→960×540、`err=0 late=0`、欠载 0；
- [x] 4 路混播（3 视频 + 1 图片，`--dec-bufs 8`）：480 帧、`err=0 late=0`，CMA 最低约 152 MB；
- [x] `SIGUSR1` 重基线：进程存活，日志输出 `adas: rebaseline lane=…`；
- [x] 断电冷启动：`rk_diag` 9/9，`mode_select` 自动拉起；
- [x] U 盘模式长按 KEY4 3 s 返回选择界面；
- [x] KEY4 长按 3 s 返回、按住 10 s 进入调试层（30 s 自动退出）；
- [x] cam17 默认仅 FPGA 双目；CAM1–3 可单独开关，关闭后槽位清黑；
- [x] VIEW 彩色/灰度/二值对四路全画面生效。

## 三、待完成清单

1. **按键类回归与 Flash 固化**：按键类回归（5 轮模式往返、KEY4 3 s/10 s）通过后用 `tools/flash/flash_program_cam18.tcl` 写 Flash（先按 `tools/fpga_reload.sh` 的方式安全断链）；
2. **双目标定**：`D:/pango_work/stereo/doc/st2d_calibration.md`；
3. **演示视频录制**：按 `docs/演示视频_分镜.md` 录制 1080P、≤3 min；失败镜头用文中预案；
4. **提交系统**：上传文档 PDF、源码包、视频；核对命名与大小限制；
5. **可选**：斑马线配置总线（`0xA2C`）仍不可调；如许可证续期可重综合修正，本期不阻塞。

## 四、常用命令

```sh
# 文档重建（md → docx → pdf）
python tools/docs_figs/build_doc.py

# 配图重建
python tools/docs_figs/make_figs.py

# 一键自检（构建 + 文档不变量）
python tools/selftest.py

# 源码包
python tools/make_submit_package.py

# 现场体检（需板子在线）
python tools/rk_diag.py 192.168.3.51

# 录制素材
python tools/make_demo_udisk.py
```

## 五、回退

```sh
git tag                      # checkpoint-20261030-windows / -final
git checkout <tag>           # 需要回退时
```

文档与源码包均可由上述脚本重建；`docs/*.docx|pdf`、`dist/` 未纳入 git（构建产物）。

## 六、已知风险

- 板端已完成：5 轮往返、静态图片、4 路混播、按键基线、冷启动、U 盘返回、10 s 调试；
- `0x82C` 仅统计窗口 0（诊断盲区）；
- 斑马线 `0xA2C` 因 RTL 总线错位不可调（默认 100 仍生效）；
- 门级后仿为独立综合网表，不是全芯片 PnR/SDF 反标；
- cam17 全局 WNS 仅 +0.035 ns（DDR PHY 路径），pix_clk +0.211 ns，属紧收敛；
- PDS 许可证已续期至 2029-09-09（host `00E04CF107DF`）。
