Zdy-1110/FPGA-676/video_review/gt/out/testcases.md

# 测试用例（由 gen_testcases.py 生成）

## 视频 112454（5 条）

| case_id | t_start | t_end | category | lane_or_side | command | expected | conf | note | basis |
|---|---|---|---|---|---|---|---|---|---|
| SIG-112454-01 | 0.0 | 3.55 | SIG | 左 | 无/停止 | 停车，不亮方向灯 | high | 灯=red | 2;4 |
| SIG-112454-02 | 0.0 | 3.55 | SIG | 左 | 按键强制行驶 | 报警（LED3/红色叠加） | high | 灯=red 强制通过 | 2;4 |
| SIG-112454-03 | 0.0 | 3.55 | SIG | 直 | 无/停止 | 停车，不亮方向灯 | high | 灯=red | 2;5 |
| SIG-112454-04 | 0.0 | 3.55 | SIG | 直 | 按键强制行驶 | 报警（LED3/红色叠加） | high | 灯=red 强制通过 | 2;5 |
| SIG-112454-05 | 0.0 | 3.55 | SIG | 右 | 行驶 | 右转不受灯控，通行（LED2） | mid | 口径待组委会确认 | 2;6 |

## 视频 112507（34 条）

| case_id | t_start | t_end | category | lane_or_side | command | expected | conf | note | basis |
|---|---|---|---|---|---|---|---|---|---|
| LANE-112507-01 | 1.0 | 9.5 | LANE | 左 | 左转向 | 允许左变道（LED0/左箭头） | mid | 虚线 | 3;4 |
| LANE-112507-11 | 1.0 | 9.5 | LANE | 右 | 右转向 | 允许右变道（LED2/右箭头） | mid | 虚线 | 3;5 |
| LANE-112507-02 | 9.5 | 12.5 | LANE | 左 | 左转向 | 保持直行（LED1） | mid | 线=white_solid | 3;7 |
| LANE-112507-03 | 9.5 | 12.5 | LANE | 左 | 强制左变道 | 报警 | mid | 线=white_solid 强制压线 | 3;7 |
| LANE-112507-12 | 9.5 | 12.5 | LANE | 右 | 右转向 | 保持直行（LED1） | mid | 线=white_solid | 3;8 |
| LANE-112507-13 | 9.5 | 12.5 | LANE | 右 | 强制右变道 | 报警 | mid | 线=white_solid 强制压线 | 3;8 |
| SIG-112507-01 | 10.5 | 12.5 | SIG | 直 | 行驶 | 通行，亮直方向LED（LED1）并叠加箭头 | high | 灯=green | 6;9 |
| SIG-112507-02 | 10.5 | 12.5 | SIG | 右 | 行驶 | 右转不受灯控，通行（LED2） | mid | 口径待组委会确认 | 6;11 |
| SIG-112507-03 | 12.5 | 13.5 | SIG | 直 | 行驶 | 通行，亮直方向LED（LED1）并叠加箭头 | high | 灯=green | 12;9 |
| SIG-112507-04 | 12.5 | 13.5 | SIG | 右 | 行驶 | 右转不受灯控，通行（LED2） | mid | 口径待组委会确认 | 12;11 |
| LANE-112507-04 | 15.0 | 19.5 | LANE | 左 | 左转向 | 允许左变道（LED0/左箭头） | mid | 虚线 | 3;13 |
| LANE-112507-14 | 15.0 | 19.5 | LANE | 右 | 右转向 | 允许右变道（LED2/右箭头） | mid | 虚线 | 3;14 |
| LANE-112507-05 | 19.5 | 23.0 | LANE | 左 | 左转向 | 保持直行（LED1） | mid | 线=white_solid | 3;16 |
| LANE-112507-06 | 19.5 | 23.0 | LANE | 左 | 强制左变道 | 报警 | mid | 线=white_solid 强制压线 | 3;16 |
| LANE-112507-15 | 19.5 | 23.0 | LANE | 右 | 右转向 | 保持直行（LED1） | mid | 线=white_solid | 3;17 |
| LANE-112507-16 | 19.5 | 23.0 | LANE | 右 | 强制右变道 | 报警 | mid | 线=white_solid 强制压线 | 3;17 |
| SIG-112507-05 | 22.5 | 23.5 | SIG | 左 | 行驶 | 通行，亮左方向LED（LED0）并叠加箭头 | mid | 灯=green | 15;19 |
| SIG-112507-06 | 22.5 | 23.5 | SIG | 直 | 行驶 | 通行，亮直方向LED（LED1）并叠加箭头 | high | 灯=green | 15;18 |
| SIG-112507-07 | 22.5 | 23.5 | SIG | 右 | 行驶 | 右转不受灯控，通行（LED2） | mid | 口径待组委会确认 | 15;20 |
| SIG-112507-08 | 23.5 | 25.0 | SIG | 左 | 行驶 | 通行，亮左方向LED（LED0）并叠加箭头 | mid | 灯=green | 21;19 |
| SIG-112507-09 | 23.5 | 25.0 | SIG | 直 | 行驶 | 通行，亮直方向LED（LED1）并叠加箭头 | high | 灯=green | 21;18 |
| SIG-112507-10 | 23.5 | 25.0 | SIG | 右 | 行驶 | 右转不受灯控，通行（LED2） | mid | 口径待组委会确认 | 21;20 |
| LANE-112507-07 | 26.0 | 30.0 | LANE | 左 | 左转向 | 允许左变道（LED0/左箭头） | mid | 虚线 | 3;22 |
| LANE-112507-17 | 26.0 | 35.0 | LANE | 右 | 右转向 | 允许右变道（LED2/右箭头） | mid | 虚线 | 3;23 |
| LANE-112507-08 | 36.0 | 38.5 | LANE | 左 | 左转向 | 保持直行（LED1） | mid | 线=white_solid | 3;27 |
| LANE-112507-09 | 36.0 | 38.5 | LANE | 左 | 强制左变道 | 报警 | mid | 线=white_solid 强制压线 | 3;27 |
| LANE-112507-18 | 36.0 | 38.5 | LANE | 右 | 右转向 | 保持直行（LED1） | mid | 线=white_solid | 3;28 |
| LANE-112507-19 | 36.0 | 38.5 | LANE | 右 | 强制右变道 | 报警 | mid | 线=white_solid 强制压线 | 3;28 |
| SIG-112507-11 | 39.0 | 40.0 | SIG | 左 | 行驶 | 通行，亮左方向LED（LED0）并叠加箭头 | mid | 灯=green | 32;30 |
| SIG-112507-12 | 39.0 | 40.0 | SIG | 直 | 行驶 | 通行，亮直方向LED（LED1）并叠加箭头 | high | 灯=green | 32;29 |
| SIG-112507-13 | 39.0 | 40.0 | SIG | 右 | 行驶 | 右转不受灯控，通行（LED2） | mid | 口径待组委会确认 | 32;31 |
| HAZARD-112507-01 | 40.0 | 41.5 | HAZARD | ped_crossing_near | 危险处置 | 减速提醒 | mid | 右转路径旁人行横道有行人和电动车等候（行人灯红） | 33 |
| LANE-112507-10 | 43.0 | 45.0 | LANE | 左 | 左转向 | 允许左变道（LED0/左箭头） | low | 虚线 | 3;35 |
| SPEED-112507-01 | 43.0 | 43.0 | SPEED |  | 按限速行驶 | 记录限速值50.0，车速（按键/参数模拟）超过时超速提醒 | high | 右转后路右侧限速 50 | 34 |

**未覆盖区间（3）**：

- [10.5, 12.5] 左灯=unknown (basis: 6;10)
- [12.5, 13.5] 左灯=unknown (basis: 12;10)
- [30.0, 35.0] 左车道线=unknown (basis: 3;24)

## 视频 112739（20 条）

| case_id | t_start | t_end | category | lane_or_side | command | expected | conf | note | basis |
|---|---|---|---|---|---|---|---|---|---|
| NAV-112739-01 | 2.0 | 2.0 | NAV | 右 | 按导航行驶 | 提示右方向（转向灯/LED） | high |  | 3;4 |
| NAV-112739-02 | 10.0 | 10.0 | NAV | 右 | 按导航行驶 | 提示右方向（转向灯/LED） | high |  | 5;6 |
| SPEED-112739-01 | 14.0 | 14.0 | SPEED |  | 按限速行驶 | 记录限速值50.0，车速（按键/参数模拟）超过时超速提醒 | low | 路侧红圈标志，数字待核；导航地图 48–58 s 也显示限速 50 | 8 |
| NAV-112739-03 | 20.0 | 20.0 | NAV | 右 | 按导航行驶 | 提示右方向（转向灯/LED） | high |  | 9;10 |
| NAV-112739-04 | 30.0 | 30.0 | NAV | 右 | 按导航行驶 | 提示右方向（转向灯/LED） | high |  | 11;12 |
| NAV-112739-05 | 38.0 | 38.0 | NAV | 右 | 按导航行驶 | 提示右方向（转向灯/LED），距离141.0m≤150.0m，进入对应转向车道 | high | near | 14;15 |
| NAV-112739-06 | 42.0 | 42.0 | NAV | 右 | 按导航行驶 | 提示右方向（转向灯/LED），距离36.0m≤150.0m，进入对应转向车道 | high | near | 16;17 |
| NAV-112739-07 | 44.0 | 44.0 | NAV | 右 | 按导航行驶 | 提示右方向（转向灯/LED），距离57.0m≤150.0m，进入对应转向车道 | high | near | 20;21 |
| NAV-112739-08 | 46.0 | 46.0 | NAV | 右 | 按导航行驶 | 提示右方向（转向灯/LED），距离30.0m≤150.0m，进入对应转向车道 | high | near | 22;23 |
| NAV-112739-09 | 48.0 | 48.0 | NAV | 左 | 按导航行驶 | 提示左方向（转向灯/LED） | high |  | 25;26 |
| NAV-112739-10 | 54.0 | 54.0 | NAV | 左 | 按导航行驶 | 提示左方向（转向灯/LED） | high |  | 27;28 |
| SIG-112739-01 | 58.0 | 64.0 | SIG | 左 | 无/停止 | 停车，不亮方向灯 | mid | 灯=red | 40;42 |
| SIG-112739-02 | 58.0 | 64.0 | SIG | 左 | 按键强制行驶 | 报警（LED3/红色叠加） | mid | 灯=red 强制通过 | 40;42 |
| NAV-112739-11 | 58.0 | 58.0 | NAV | 左 | 按导航行驶 | 提示左方向（转向灯/LED） | high |  | 29;30 |
| NAV-112739-12 | 60.0 | 60.0 | NAV | 左 | 按导航行驶 | 提示左方向（转向灯/LED），距离100.0m≤150.0m，进入对应转向车道 | high | near | 31;32 |
| SIG-112739-03 | 64.0 | 77.0 | SIG | 左 | 无/停止 | 停车，不亮方向灯 | mid | 灯=red | 41;42 |
| SIG-112739-04 | 64.0 | 77.0 | SIG | 左 | 按键强制行驶 | 报警（LED3/红色叠加） | mid | 灯=red 强制通过 | 41;42 |
| NAV-112739-13 | 66.0 | 66.0 | NAV | 左 | 按导航行驶 | 提示左方向（转向灯/LED），距离40.0m≤150.0m，进入对应转向车道 | high | near | 33;34 |
| NAV-112739-14 | 84.0 | 84.0 | NAV | 掉头 | 按导航行驶 | 提示掉头方向（转向灯/LED） | high |  | 44;45 |
| NAV-112739-15 | 90.0 | 90.0 | NAV | 掉头 | 按导航行驶 | 提示掉头方向（转向灯/LED） | high |  | 46;47 |

## 视频 113343（19 条）

| case_id | t_start | t_end | category | lane_or_side | command | expected | conf | note | basis |
|---|---|---|---|---|---|---|---|---|---|
| LANE-113343-01 | 0.0 | 8.0 | LANE | 左 | 左转向 | 保持直行（LED1） | mid | 线=yellow_solid | 2;5 |
| LANE-113343-02 | 0.0 | 8.0 | LANE | 左 | 强制左变道 | 报警 | mid | 线=yellow_solid 强制压线 | 2;5 |
| LANE-113343-03 | 0.0 | 8.0 | LANE | 右 | 右转向 | 允许右变道（LED2/右箭头） | mid | 虚线 | 2;6 |
| HAZARD-113343-01 | 12.0 | 14.0 | HAZARD | lead_close | 危险处置 | 碰撞提醒 | mid | 接近排队车辆并刹停 | 16 |
| SIG-113343-01 | 12.5 | 14.0 | SIG | 左 | 无/停止 | 停车，不亮方向灯 | high | 灯=red | 8;10 |
| SIG-113343-02 | 12.5 | 14.0 | SIG | 左 | 按键强制行驶 | 报警（LED3/红色叠加） | high | 灯=red 强制通过 | 8;10 |
| SIG-113343-03 | 12.5 | 14.0 | SIG | 直 | 无/停止 | 停车，不亮方向灯 | high | 灯=red | 8;11 |
| SIG-113343-04 | 12.5 | 14.0 | SIG | 直 | 按键强制行驶 | 报警（LED3/红色叠加） | high | 灯=red 强制通过 | 8;11 |
| SIG-113343-05 | 12.5 | 14.0 | SIG | 右 | 行驶 | 右转不受灯控，通行（LED2） | mid | 口径待组委会确认 | 8;12 |
| SIG-113343-06 | 14.0 | 15.5 | SIG | 左 | 无/停止 | 停车，不亮方向灯 | high | 灯=red | 9;10 |
| SIG-113343-07 | 14.0 | 15.5 | SIG | 左 | 按键强制行驶 | 报警（LED3/红色叠加） | high | 灯=red 强制通过 | 9;10 |
| SIG-113343-10 | 14.0 | 15.5 | SIG | 直 | 无/停止 | 停车，不亮方向灯 | high | 灯=red | 9;11 |
| SIG-113343-11 | 14.0 | 15.5 | SIG | 直 | 按键强制行驶 | 报警（LED3/红色叠加） | high | 灯=red 强制通过 | 9;11 |
| SIG-113343-14 | 14.0 | 15.5 | SIG | 右 | 行驶 | 右转不受灯控，通行（LED2） | mid | 口径待组委会确认 | 9;12 |
| SIG-113343-08 | 15.5 | 21.85 | SIG | 左 | 无/停止 | 停车，不亮方向灯 | low | 灯=red | 9;13 |
| SIG-113343-09 | 15.5 | 21.85 | SIG | 左 | 按键强制行驶 | 报警（LED3/红色叠加） | low | 灯=red 强制通过 | 9;13 |
| SIG-113343-12 | 15.5 | 21.85 | SIG | 直 | 无/停止 | 停车，不亮方向灯 | low | 灯=red | 9;14 |
| SIG-113343-13 | 15.5 | 21.85 | SIG | 直 | 按键强制行驶 | 报警（LED3/红色叠加） | low | 灯=red 强制通过 | 9;14 |
| SIG-113343-15 | 15.5 | 21.85 | SIG | 右 | 行驶 | 右转不受灯控，通行（LED2） | mid | 口径待组委会确认 | 9;15 |

## 视频 113421（9 条）

| case_id | t_start | t_end | category | lane_or_side | command | expected | conf | note | basis |
|---|---|---|---|---|---|---|---|---|---|
| SIG-113421-01 | 0.0 | 6.0 | SIG | 左 | 行驶 | 通行，亮左方向LED（LED0）并叠加箭头 | mid | 灯=green | 5;9 |
| SIG-113421-02 | 0.0 | 1.0 | SIG | 直 | 行驶 | 通行，亮直方向LED（LED1）并叠加箭头 | mid | 灯=green | 5;7 |
| SIG-113421-04 | 0.0 | 6.0 | SIG | 右 | 行驶 | 右转不受灯控，通行（LED2） | mid | 口径待组委会确认 | 5;10 |
| SIG-113421-03 | 1.0 | 6.0 | SIG | 直 | 行驶 | 通行，亮直方向LED（LED1）并叠加箭头 | high | 灯=green | 5;8 |
| SIG-113421-05 | 6.0 | 10.0 | SIG | 左 | 行驶 | 通行，亮左方向LED（LED0）并叠加箭头 | mid | 灯=green | 6;9 |
| SIG-113421-06 | 6.0 | 10.0 | SIG | 直 | 行驶 | 通行，亮直方向LED（LED1）并叠加箭头 | high | 灯=green | 6;8 |
| SIG-113421-07 | 6.0 | 10.0 | SIG | 右 | 行驶 | 右转不受灯控，通行（LED2） | mid | 口径待组委会确认 | 6;10 |
| HAZARD-113421-01 | 7.0 | 10.0 | HAZARD | cut_in | 危险处置 | 碰撞提醒 | low | 前车由揽胜变为蓝色宝马（宝马并入或自车偏移），待核对 | 11 |
| SPEED-113421-01 | 11.0 | 11.0 | SPEED |  | 按限速行驶 | 记录限速值40.0，车速（按键/参数模拟）超过时超速提醒 | high | 路右侧限速 40 与禁停标志 | 12 |

## 视频 113452（9 条）

| case_id | t_start | t_end | category | lane_or_side | command | expected | conf | note | basis |
|---|---|---|---|---|---|---|---|---|---|
| LANE-113452-01 | 0.0 | 5.0 | LANE | 左 | 左转向 | 允许左变道（LED0/左箭头） | low | 虚线 | 2;5 |
| HAZARD-113452-01 | 8.0 | 10.5 | HAZARD | lead_close | 危险处置 | 碰撞提醒 | high | 前车刹车、距离缩小至停车 | 13 |
| SIG-113452-01 | 9.0 | 10.0 | SIG | 左 | 无/停止 | 停车，不亮方向灯 | low | 灯=red | 8;10 |
| SIG-113452-02 | 9.0 | 10.0 | SIG | 左 | 按键强制行驶 | 报警（LED3/红色叠加） | low | 灯=red 强制通过 | 8;10 |
| SIG-113452-03 | 9.0 | 10.0 | SIG | 直 | 无/停止 | 停车，不亮方向灯 | mid | 灯=red | 8;9 |
| SIG-113452-04 | 9.0 | 10.0 | SIG | 直 | 按键强制行驶 | 报警（LED3/红色叠加） | mid | 灯=red 强制通过 | 8;9 |
| SIG-113452-07 | 9.0 | 14.37 | SIG | 右 | 行驶 | 右转不受灯控，通行（LED2） | low | 口径待组委会确认 | 8;12 |
| SIG-113452-05 | 10.0 | 14.37 | SIG | 直 | 无/停止 | 停车，不亮方向灯 | low | 灯=red | 8;11 |
| SIG-113452-06 | 10.0 | 14.37 | SIG | 直 | 按键强制行驶 | 报警（LED3/红色叠加） | low | 灯=red 强制通过 | 8;11 |

**未覆盖区间（1）**：

- [0.0, 5.0] 右车道线=unknown (basis: 2;6)

## 视频 113539（35 条）

| case_id | t_start | t_end | category | lane_or_side | command | expected | conf | note | basis |
|---|---|---|---|---|---|---|---|---|---|
| LANE-113539-01 | 0.0 | 5.0 | LANE | 左 | 左转向 | 保持直行（LED1） | mid | 线=yellow_solid | 2;12 |
| LANE-113539-02 | 0.0 | 5.0 | LANE | 左 | 强制左变道 | 报警 | mid | 线=yellow_solid 强制压线 | 2;12 |
| LANE-113539-03 | 0.0 | 5.0 | LANE | 右 | 右转向 | 允许右变道（LED2/右箭头） | low | 虚线 | 2;13 |
| SPEED-113539-01 | 1.0 | 1.0 | SPEED |  | 按限速行驶 | 记录限速值40.0，车速（按键/参数模拟）超过时超速提醒 | mid | 右上角限速 40 | 11 |
| SIG-113539-01 | 10.0 | 26.0 | SIG | 左 | 无/停止 | 停车，不亮方向灯 | high | 灯=red | 15;16 |
| SIG-113539-02 | 10.0 | 26.0 | SIG | 左 | 按键强制行驶 | 报警（LED3/红色叠加） | high | 灯=red 强制通过 | 15;16 |
| SIG-113539-03 | 10.0 | 26.0 | SIG | 直 | 无/停止 | 停车，不亮方向灯 | high | 灯=red | 15;17 |
| SIG-113539-04 | 10.0 | 26.0 | SIG | 直 | 按键强制行驶 | 报警（LED3/红色叠加） | high | 灯=red 强制通过 | 15;17 |
| SIG-113539-05 | 10.0 | 26.0 | SIG | 右 | 行驶 | 右转不受灯控，通行（LED2） | mid | 口径待组委会确认 | 15;18 |
| HAZARD-113539-01 | 11.0 | 12.5 | HAZARD | lead_close | 危险处置 | 碰撞提醒 | mid | 接近前方出租车并刹停（静止排队段不算） | 22 |
| HAZARD-113539-02 | 17.5 | 19.5 | HAZARD | ped_crossing_near | 危险处置 | 减速提醒 | mid | 行人/电动车从出租车前横穿 | 23 |
| HAZARD-113539-03 | 23.5 | 25.0 | HAZARD | ped_crossing_near | 危险处置 | 减速提醒 | mid | 摩托/电动车横穿 | 24 |
| SIG-113539-06 | 27.0 | 30.0 | SIG | 左 | 行驶 | 通行，亮左方向LED（LED0）并叠加箭头 | mid | 灯=green | 25;19 |
| SIG-113539-07 | 27.0 | 30.0 | SIG | 直 | 行驶 | 通行，亮直方向LED（LED1）并叠加箭头 | high | 灯=green | 25;20 |
| SIG-113539-08 | 27.0 | 30.0 | SIG | 右 | 行驶 | 右转不受灯控，通行（LED2） | mid | 口径待组委会确认 | 25;21 |
| LANE-113539-04 | 37.0 | 47.0 | LANE | 左 | 左转向 | 保持直行（LED1） | mid | 线=double_yellow | 6;27 |
| LANE-113539-05 | 37.0 | 47.0 | LANE | 左 | 强制左变道 | 报警 | mid | 线=double_yellow 强制压线 | 6;27 |
| LANE-113539-08 | 37.0 | 47.0 | LANE | 右 | 右转向 | 允许右变道（LED2/右箭头） | low | 虚线 | 6;28 |
| HAZARD-113539-04 | 40.5 | 41.5 | HAZARD | ped_crossing_near | 危险处置 | 减速提醒 | mid | 打伞行人在车流间穿行 | 29 |
| LANE-113539-06 | 54.0 | 60.0 | LANE | 左 | 左转向 | 保持直行（LED1） | mid | 线=double_yellow | 6;34 |
| LANE-113539-07 | 54.0 | 60.0 | LANE | 左 | 强制左变道 | 报警 | mid | 线=double_yellow 强制压线 | 6;34 |
| LANE-113539-09 | 54.0 | 60.0 | LANE | 右 | 右转向 | 允许右变道（LED2/右箭头） | low | 虚线 | 6;35 |
| HAZARD-113539-05 | 54.0 | 54.5 | HAZARD | cut_in | 危险处置 | 碰撞提醒 | low | 蓝色三轮车在左前方近距离 | 33 |
| SIG-113539-09 | 61.0 | 63.5 | SIG | 左 | 行驶 | 通行，亮左方向LED（LED0）并叠加箭头 | mid | 灯=green | 36;39 |
| SIG-113539-10 | 61.0 | 63.5 | SIG | 直 | 行驶 | 通行，亮直方向LED（LED1）并叠加箭头 | high | 灯=green | 36;38 |
| SIG-113539-11 | 61.0 | 63.5 | SIG | 右 | 行驶 | 右转不受灯控，通行（LED2） | mid | 口径待组委会确认 | 36;40 |
| HAZARD-113539-06 | 62.0 | 63.5 | HAZARD | lead_close | 危险处置 | 碰撞提醒 | mid | 接近前方出租车并刹停 | 43 |
| SIG-113539-12 | 63.5 | 67.5 | SIG | 左 | 行驶 | 通行，亮左方向LED（LED0）并叠加箭头 | mid | 灯=green | 37;39 |
| SIG-113539-15 | 63.5 | 67.5 | SIG | 直 | 行驶 | 通行，亮直方向LED（LED1）并叠加箭头 | high | 灯=green | 37;38 |
| SIG-113539-18 | 63.5 | 67.5 | SIG | 右 | 行驶 | 右转不受灯控，通行（LED2） | mid | 口径待组委会确认 | 37;40 |
| SIG-113539-13 | 67.5 | 69.0 | SIG | 左 | 无/停止 | 停车，不亮方向灯 | low | 灯=yellow | 37;42 |
| SIG-113539-14 | 67.5 | 69.0 | SIG | 左 | 按键强制行驶 | 报警（LED3/红色叠加） | low | 灯=yellow 强制通过 | 37;42 |
| SIG-113539-16 | 67.5 | 69.0 | SIG | 直 | 无/停止 | 停车，不亮方向灯 | mid | 灯=yellow | 37;41 |
| SIG-113539-17 | 67.5 | 69.0 | SIG | 直 | 按键强制行驶 | 报警（LED3/红色叠加） | mid | 灯=yellow 强制通过 | 37;41 |
| HAZARD-113539-07 | 69.5 | 71.5 | HAZARD | ped_in_path | 危险处置 | 刹车/停车 + 报警 | mid | 转弯时人行横道上行人与电动车在车前横穿 | 45 |
