Zdy-1110/FPGA-676/evidence/cam23_multiseed_result.csv

Seed | State | UserFilter | Setup(Slow) | Setup(Fast) | Hold(Slow) | Hold(Fast) | Recovery(Slow) | Recovery(Fast) | Removal(Slow) | Removal(Fast) | Routing Arc Length | Worst Slack(place) | Worst Slack(pre route) | Wire Length | Power | Place Cpu Time | Route Cpu Time | Route Optimize Cpu Time
3 | OK | 1 | 0.050 | 2.172 | 0.058 | 0.044 | 0.379 | 1.801 | 0.336 | 0.233 | 436401 | 84 | 475 | 381847 | NA | 0h:3m:11s | 0h:2m:0s | 0h:0m:51s
4 | OK | 1 | 0.032 | 2.126 | 0.062 | 0.044 | 1.115 | 2.178 | 0.353 | 0.247 | 438924 | -248 | 445 | 394286 | NA | 0h:2m:51s | 0h:2m:7s | 0h:0m:53s
2 | OK | 1 | 0.022 | 2.151 | 0.061 | 0.043 | 1.064 | 2.214 | 0.295 | 0.195 | 436866 | -1 | 490 | 383758 | NA | 0h:2m:39s | 0h:2m:24s | 0h:1m:2s
1 | OK | 1 | 0.005 | 2.209 | 0.062 | 0.044 | 0.689 | 1.967 | 0.352 | 0.245 | 438704 | 119 | 211 | 394422 | NA | 0h:2m:55s | 0h:1m:55s | 0h:0m:51s
5 | OK | 0 | -0.007 | 2.135 | 0.060 | 0.044 | 0.728 | 1.944 | 0.352 | 0.248 | 441841 | 24 | 287 | 401342 | NA | 0h:2m:57s | 0h:2m:6s | 0h:0m:52s
0 | OK | 0 | -0.036 | 2.196 | 0.061 | 0.043 | 0.596 | 1.859 | 0.326 | 0.217 | 434938 | -265 | 565 | 377872 | NA | 0h:2m:49s | 0h:1m:59s | 0h:0m:50s
Best Slack Seed:3
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
