Zdy-1110/FPGA-676/video_review/gt/out/testcases.csv

case_id | video | t_start | t_end | category | lane_or_side | command | expected | basis | conf | note
SIG-112454-01 | 112454 | 0.0 | 3.55 | SIG | 左 | 无/停止 | 停车，不亮方向灯 | 2;4 | high | 灯=red
SIG-112454-02 | 112454 | 0.0 | 3.55 | SIG | 左 | 按键强制行驶 | 报警（LED3/红色叠加） | 2;4 | high | 灯=red 强制通过
SIG-112454-03 | 112454 | 0.0 | 3.55 | SIG | 直 | 无/停止 | 停车，不亮方向灯 | 2;5 | high | 灯=red
SIG-112454-04 | 112454 | 0.0 | 3.55 | SIG | 直 | 按键强制行驶 | 报警（LED3/红色叠加） | 2;5 | high | 灯=red 强制通过
SIG-112454-05 | 112454 | 0.0 | 3.55 | SIG | 右 | 行驶 | 右转不受灯控，通行（LED2） | 2;6 | mid | 口径待组委会确认
SIG-112507-01 | 112507 | 10.5 | 12.5 | SIG | 直 | 行驶 | 通行，亮直方向LED（LED1）并叠加箭头 | 6;9 | high | 灯=green
SIG-112507-02 | 112507 | 10.5 | 12.5 | SIG | 右 | 行驶 | 右转不受灯控，通行（LED2） | 6;11 | mid | 口径待组委会确认
SIG-112507-03 | 112507 | 12.5 | 13.5 | SIG | 直 | 行驶 | 通行，亮直方向LED（LED1）并叠加箭头 | 12;9 | high | 灯=green
SIG-112507-04 | 112507 | 12.5 | 13.5 | SIG | 右 | 行驶 | 右转不受灯控，通行（LED2） | 12;11 | mid | 口径待组委会确认
SIG-112507-05 | 112507 | 22.5 | 23.5 | SIG | 左 | 行驶 | 通行，亮左方向LED（LED0）并叠加箭头 | 15;19 | mid | 灯=green
SIG-112507-06 | 112507 | 22.5 | 23.5 | SIG | 直 | 行驶 | 通行，亮直方向LED（LED1）并叠加箭头 | 15;18 | high | 灯=green
SIG-112507-07 | 112507 | 22.5 | 23.5 | SIG | 右 | 行驶 | 右转不受灯控，通行（LED2） | 15;20 | mid | 口径待组委会确认
SIG-112507-08 | 112507 | 23.5 | 25.0 | SIG | 左 | 行驶 | 通行，亮左方向LED（LED0）并叠加箭头 | 21;19 | mid | 灯=green
SIG-112507-09 | 112507 | 23.5 | 25.0 | SIG | 直 | 行驶 | 通行，亮直方向LED（LED1）并叠加箭头 | 21;18 | high | 灯=green
SIG-112507-10 | 112507 | 23.5 | 25.0 | SIG | 右 | 行驶 | 右转不受灯控，通行（LED2） | 21;20 | mid | 口径待组委会确认
SIG-112507-11 | 112507 | 39.0 | 40.0 | SIG | 左 | 行驶 | 通行，亮左方向LED（LED0）并叠加箭头 | 32;30 | mid | 灯=green
SIG-112507-12 | 112507 | 39.0 | 40.0 | SIG | 直 | 行驶 | 通行，亮直方向LED（LED1）并叠加箭头 | 32;29 | high | 灯=green
SIG-112507-13 | 112507 | 39.0 | 40.0 | SIG | 右 | 行驶 | 右转不受灯控，通行（LED2） | 32;31 | mid | 口径待组委会确认
SIG-112739-01 | 112739 | 58.0 | 64.0 | SIG | 左 | 无/停止 | 停车，不亮方向灯 | 40;42 | mid | 灯=red
SIG-112739-02 | 112739 | 58.0 | 64.0 | SIG | 左 | 按键强制行驶 | 报警（LED3/红色叠加） | 40;42 | mid | 灯=red 强制通过
SIG-112739-03 | 112739 | 64.0 | 77.0 | SIG | 左 | 无/停止 | 停车，不亮方向灯 | 41;42 | mid | 灯=red
SIG-112739-04 | 112739 | 64.0 | 77.0 | SIG | 左 | 按键强制行驶 | 报警（LED3/红色叠加） | 41;42 | mid | 灯=red 强制通过
SIG-113343-01 | 113343 | 12.5 | 14.0 | SIG | 左 | 无/停止 | 停车，不亮方向灯 | 8;10 | high | 灯=red
SIG-113343-02 | 113343 | 12.5 | 14.0 | SIG | 左 | 按键强制行驶 | 报警（LED3/红色叠加） | 8;10 | high | 灯=red 强制通过
SIG-113343-03 | 113343 | 12.5 | 14.0 | SIG | 直 | 无/停止 | 停车，不亮方向灯 | 8;11 | high | 灯=red
SIG-113343-04 | 113343 | 12.5 | 14.0 | SIG | 直 | 按键强制行驶 | 报警（LED3/红色叠加） | 8;11 | high | 灯=red 强制通过
SIG-113343-05 | 113343 | 12.5 | 14.0 | SIG | 右 | 行驶 | 右转不受灯控，通行（LED2） | 8;12 | mid | 口径待组委会确认
SIG-113343-06 | 113343 | 14.0 | 15.5 | SIG | 左 | 无/停止 | 停车，不亮方向灯 | 9;10 | high | 灯=red
SIG-113343-07 | 113343 | 14.0 | 15.5 | SIG | 左 | 按键强制行驶 | 报警（LED3/红色叠加） | 9;10 | high | 灯=red 强制通过
SIG-113343-08 | 113343 | 15.5 | 21.85 | SIG | 左 | 无/停止 | 停车，不亮方向灯 | 9;13 | low | 灯=red
SIG-113343-09 | 113343 | 15.5 | 21.85 | SIG | 左 | 按键强制行驶 | 报警（LED3/红色叠加） | 9;13 | low | 灯=red 强制通过
SIG-113343-10 | 113343 | 14.0 | 15.5 | SIG | 直 | 无/停止 | 停车，不亮方向灯 | 9;11 | high | 灯=red
SIG-113343-11 | 113343 | 14.0 | 15.5 | SIG | 直 | 按键强制行驶 | 报警（LED3/红色叠加） | 9;11 | high | 灯=red 强制通过
SIG-113343-12 | 113343 | 15.5 | 21.85 | SIG | 直 | 无/停止 | 停车，不亮方向灯 | 9;14 | low | 灯=red
SIG-113343-13 | 113343 | 15.5 | 21.85 | SIG | 直 | 按键强制行驶 | 报警（LED3/红色叠加） | 9;14 | low | 灯=red 强制通过
SIG-113343-14 | 113343 | 14.0 | 15.5 | SIG | 右 | 行驶 | 右转不受灯控，通行（LED2） | 9;12 | mid | 口径待组委会确认
SIG-113343-15 | 113343 | 15.5 | 21.85 | SIG | 右 | 行驶 | 右转不受灯控，通行（LED2） | 9;15 | mid | 口径待组委会确认
SIG-113421-01 | 113421 | 0.0 | 6.0 | SIG | 左 | 行驶 | 通行，亮左方向LED（LED0）并叠加箭头 | 5;9 | mid | 灯=green
SIG-113421-02 | 113421 | 0.0 | 1.0 | SIG | 直 | 行驶 | 通行，亮直方向LED（LED1）并叠加箭头 | 5;7 | mid | 灯=green
SIG-113421-03 | 113421 | 1.0 | 6.0 | SIG | 直 | 行驶 | 通行，亮直方向LED（LED1）并叠加箭头 | 5;8 | high | 灯=green
SIG-113421-04 | 113421 | 0.0 | 6.0 | SIG | 右 | 行驶 | 右转不受灯控，通行（LED2） | 5;10 | mid | 口径待组委会确认
SIG-113421-05 | 113421 | 6.0 | 10.0 | SIG | 左 | 行驶 | 通行，亮左方向LED（LED0）并叠加箭头 | 6;9 | mid | 灯=green
SIG-113421-06 | 113421 | 6.0 | 10.0 | SIG | 直 | 行驶 | 通行，亮直方向LED（LED1）并叠加箭头 | 6;8 | high | 灯=green
SIG-113421-07 | 113421 | 6.0 | 10.0 | SIG | 右 | 行驶 | 右转不受灯控，通行（LED2） | 6;10 | mid | 口径待组委会确认
SIG-113452-01 | 113452 | 9.0 | 10.0 | SIG | 左 | 无/停止 | 停车，不亮方向灯 | 8;10 | low | 灯=red
SIG-113452-02 | 113452 | 9.0 | 10.0 | SIG | 左 | 按键强制行驶 | 报警（LED3/红色叠加） | 8;10 | low | 灯=red 强制通过
SIG-113452-03 | 113452 | 9.0 | 10.0 | SIG | 直 | 无/停止 | 停车，不亮方向灯 | 8;9 | mid | 灯=red
SIG-113452-04 | 113452 | 9.0 | 10.0 | SIG | 直 | 按键强制行驶 | 报警（LED3/红色叠加） | 8;9 | mid | 灯=red 强制通过
SIG-113452-05 | 113452 | 10.0 | 14.37 | SIG | 直 | 无/停止 | 停车，不亮方向灯 | 8;11 | low | 灯=red
SIG-113452-06 | 113452 | 10.0 | 14.37 | SIG | 直 | 按键强制行驶 | 报警（LED3/红色叠加） | 8;11 | low | 灯=red 强制通过
SIG-113452-07 | 113452 | 9.0 | 14.37 | SIG | 右 | 行驶 | 右转不受灯控，通行（LED2） | 8;12 | low | 口径待组委会确认
SIG-113539-01 | 113539 | 10.0 | 26.0 | SIG | 左 | 无/停止 | 停车，不亮方向灯 | 15;16 | high | 灯=red
SIG-113539-02 | 113539 | 10.0 | 26.0 | SIG | 左 | 按键强制行驶 | 报警（LED3/红色叠加） | 15;16 | high | 灯=red 强制通过
SIG-113539-03 | 113539 | 10.0 | 26.0 | SIG | 直 | 无/停止 | 停车，不亮方向灯 | 15;17 | high | 灯=red
SIG-113539-04 | 113539 | 10.0 | 26.0 | SIG | 直 | 按键强制行驶 | 报警（LED3/红色叠加） | 15;17 | high | 灯=red 强制通过
SIG-113539-05 | 113539 | 10.0 | 26.0 | SIG | 右 | 行驶 | 右转不受灯控，通行（LED2） | 15;18 | mid | 口径待组委会确认
SIG-113539-06 | 113539 | 27.0 | 30.0 | SIG | 左 | 行驶 | 通行，亮左方向LED（LED0）并叠加箭头 | 25;19 | mid | 灯=green
SIG-113539-07 | 113539 | 27.0 | 30.0 | SIG | 直 | 行驶 | 通行，亮直方向LED（LED1）并叠加箭头 | 25;20 | high | 灯=green
SIG-113539-08 | 113539 | 27.0 | 30.0 | SIG | 右 | 行驶 | 右转不受灯控，通行（LED2） | 25;21 | mid | 口径待组委会确认
SIG-113539-09 | 113539 | 61.0 | 63.5 | SIG | 左 | 行驶 | 通行，亮左方向LED（LED0）并叠加箭头 | 36;39 | mid | 灯=green
SIG-113539-10 | 113539 | 61.0 | 63.5 | SIG | 直 | 行驶 | 通行，亮直方向LED（LED1）并叠加箭头 | 36;38 | high | 灯=green
SIG-113539-11 | 113539 | 61.0 | 63.5 | SIG | 右 | 行驶 | 右转不受灯控，通行（LED2） | 36;40 | mid | 口径待组委会确认
SIG-113539-12 | 113539 | 63.5 | 67.5 | SIG | 左 | 行驶 | 通行，亮左方向LED（LED0）并叠加箭头 | 37;39 | mid | 灯=green
SIG-113539-13 | 113539 | 67.5 | 69.0 | SIG | 左 | 无/停止 | 停车，不亮方向灯 | 37;42 | low | 灯=yellow
SIG-113539-14 | 113539 | 67.5 | 69.0 | SIG | 左 | 按键强制行驶 | 报警（LED3/红色叠加） | 37;42 | low | 灯=yellow 强制通过
SIG-113539-15 | 113539 | 63.5 | 67.5 | SIG | 直 | 行驶 | 通行，亮直方向LED（LED1）并叠加箭头 | 37;38 | high | 灯=green
SIG-113539-16 | 113539 | 67.5 | 69.0 | SIG | 直 | 无/停止 | 停车，不亮方向灯 | 37;41 | mid | 灯=yellow
SIG-113539-17 | 113539 | 67.5 | 69.0 | SIG | 直 | 按键强制行驶 | 报警（LED3/红色叠加） | 37;41 | mid | 灯=yellow 强制通过
SIG-113539-18 | 113539 | 63.5 | 67.5 | SIG | 右 | 行驶 | 右转不受灯控，通行（LED2） | 37;40 | mid | 口径待组委会确认
LANE-112507-01 | 112507 | 1.0 | 9.5 | LANE | 左 | 左转向 | 允许左变道（LED0/左箭头） | 3;4 | mid | 虚线
LANE-112507-02 | 112507 | 9.5 | 12.5 | LANE | 左 | 左转向 | 保持直行（LED1） | 3;7 | mid | 线=white_solid
LANE-112507-03 | 112507 | 9.5 | 12.5 | LANE | 左 | 强制左变道 | 报警 | 3;7 | mid | 线=white_solid 强制压线
LANE-112507-04 | 112507 | 15.0 | 19.5 | LANE | 左 | 左转向 | 允许左变道（LED0/左箭头） | 3;13 | mid | 虚线
LANE-112507-05 | 112507 | 19.5 | 23.0 | LANE | 左 | 左转向 | 保持直行（LED1） | 3;16 | mid | 线=white_solid
LANE-112507-06 | 112507 | 19.5 | 23.0 | LANE | 左 | 强制左变道 | 报警 | 3;16 | mid | 线=white_solid 强制压线
LANE-112507-07 | 112507 | 26.0 | 30.0 | LANE | 左 | 左转向 | 允许左变道（LED0/左箭头） | 3;22 | mid | 虚线
LANE-112507-08 | 112507 | 36.0 | 38.5 | LANE | 左 | 左转向 | 保持直行（LED1） | 3;27 | mid | 线=white_solid
LANE-112507-09 | 112507 | 36.0 | 38.5 | LANE | 左 | 强制左变道 | 报警 | 3;27 | mid | 线=white_solid 强制压线
LANE-112507-10 | 112507 | 43.0 | 45.0 | LANE | 左 | 左转向 | 允许左变道（LED0/左箭头） | 3;35 | low | 虚线
LANE-112507-11 | 112507 | 1.0 | 9.5 | LANE | 右 | 右转向 | 允许右变道（LED2/右箭头） | 3;5 | mid | 虚线
LANE-112507-12 | 112507 | 9.5 | 12.5 | LANE | 右 | 右转向 | 保持直行（LED1） | 3;8 | mid | 线=white_solid
LANE-112507-13 | 112507 | 9.5 | 12.5 | LANE | 右 | 强制右变道 | 报警 | 3;8 | mid | 线=white_solid 强制压线
LANE-112507-14 | 112507 | 15.0 | 19.5 | LANE | 右 | 右转向 | 允许右变道（LED2/右箭头） | 3;14 | mid | 虚线
LANE-112507-15 | 112507 | 19.5 | 23.0 | LANE | 右 | 右转向 | 保持直行（LED1） | 3;17 | mid | 线=white_solid
LANE-112507-16 | 112507 | 19.5 | 23.0 | LANE | 右 | 强制右变道 | 报警 | 3;17 | mid | 线=white_solid 强制压线
LANE-112507-17 | 112507 | 26.0 | 35.0 | LANE | 右 | 右转向 | 允许右变道（LED2/右箭头） | 3;23 | mid | 虚线
LANE-112507-18 | 112507 | 36.0 | 38.5 | LANE | 右 | 右转向 | 保持直行（LED1） | 3;28 | mid | 线=white_solid
LANE-112507-19 | 112507 | 36.0 | 38.5 | LANE | 右 | 强制右变道 | 报警 | 3;28 | mid | 线=white_solid 强制压线
LANE-113343-01 | 113343 | 0.0 | 8.0 | LANE | 左 | 左转向 | 保持直行（LED1） | 2;5 | mid | 线=yellow_solid
LANE-113343-02 | 113343 | 0.0 | 8.0 | LANE | 左 | 强制左变道 | 报警 | 2;5 | mid | 线=yellow_solid 强制压线
LANE-113343-03 | 113343 | 0.0 | 8.0 | LANE | 右 | 右转向 | 允许右变道（LED2/右箭头） | 2;6 | mid | 虚线
LANE-113452-01 | 113452 | 0.0 | 5.0 | LANE | 左 | 左转向 | 允许左变道（LED0/左箭头） | 2;5 | low | 虚线
LANE-113539-01 | 113539 | 0.0 | 5.0 | LANE | 左 | 左转向 | 保持直行（LED1） | 2;12 | mid | 线=yellow_solid
LANE-113539-02 | 113539 | 0.0 | 5.0 | LANE | 左 | 强制左变道 | 报警 | 2;12 | mid | 线=yellow_solid 强制压线
LANE-113539-03 | 113539 | 0.0 | 5.0 | LANE | 右 | 右转向 | 允许右变道（LED2/右箭头） | 2;13 | low | 虚线
LANE-113539-04 | 113539 | 37.0 | 47.0 | LANE | 左 | 左转向 | 保持直行（LED1） | 6;27 | mid | 线=double_yellow
LANE-113539-05 | 113539 | 37.0 | 47.0 | LANE | 左 | 强制左变道 | 报警 | 6;27 | mid | 线=double_yellow 强制压线
LANE-113539-06 | 113539 | 54.0 | 60.0 | LANE | 左 | 左转向 | 保持直行（LED1） | 6;34 | mid | 线=double_yellow
LANE-113539-07 | 113539 | 54.0 | 60.0 | LANE | 左 | 强制左变道 | 报警 | 6;34 | mid | 线=double_yellow 强制压线
LANE-113539-08 | 113539 | 37.0 | 47.0 | LANE | 右 | 右转向 | 允许右变道（LED2/右箭头） | 6;28 | low | 虚线
LANE-113539-09 | 113539 | 54.0 | 60.0 | LANE | 右 | 右转向 | 允许右变道（LED2/右箭头） | 6;35 | low | 虚线
NAV-112739-01 | 112739 | 2.0 | 2.0 | NAV | 右 | 按导航行驶 | 提示右方向（转向灯/LED） | 3;4 | high
NAV-112739-02 | 112739 | 10.0 | 10.0 | NAV | 右 | 按导航行驶 | 提示右方向（转向灯/LED） | 5;6 | high
NAV-112739-03 | 112739 | 20.0 | 20.0 | NAV | 右 | 按导航行驶 | 提示右方向（转向灯/LED） | 9;10 | high
NAV-112739-04 | 112739 | 30.0 | 30.0 | NAV | 右 | 按导航行驶 | 提示右方向（转向灯/LED） | 11;12 | high
NAV-112739-05 | 112739 | 38.0 | 38.0 | NAV | 右 | 按导航行驶 | 提示右方向（转向灯/LED），距离141.0m≤150.0m，进入对应转向车道 | 14;15 | high | near
NAV-112739-06 | 112739 | 42.0 | 42.0 | NAV | 右 | 按导航行驶 | 提示右方向（转向灯/LED），距离36.0m≤150.0m，进入对应转向车道 | 16;17 | high | near
NAV-112739-07 | 112739 | 44.0 | 44.0 | NAV | 右 | 按导航行驶 | 提示右方向（转向灯/LED），距离57.0m≤150.0m，进入对应转向车道 | 20;21 | high | near
NAV-112739-08 | 112739 | 46.0 | 46.0 | NAV | 右 | 按导航行驶 | 提示右方向（转向灯/LED），距离30.0m≤150.0m，进入对应转向车道 | 22;23 | high | near
NAV-112739-09 | 112739 | 48.0 | 48.0 | NAV | 左 | 按导航行驶 | 提示左方向（转向灯/LED） | 25;26 | high
NAV-112739-10 | 112739 | 54.0 | 54.0 | NAV | 左 | 按导航行驶 | 提示左方向（转向灯/LED） | 27;28 | high
NAV-112739-11 | 112739 | 58.0 | 58.0 | NAV | 左 | 按导航行驶 | 提示左方向（转向灯/LED） | 29;30 | high
NAV-112739-12 | 112739 | 60.0 | 60.0 | NAV | 左 | 按导航行驶 | 提示左方向（转向灯/LED），距离100.0m≤150.0m，进入对应转向车道 | 31;32 | high | near
NAV-112739-13 | 112739 | 66.0 | 66.0 | NAV | 左 | 按导航行驶 | 提示左方向（转向灯/LED），距离40.0m≤150.0m，进入对应转向车道 | 33;34 | high | near
NAV-112739-14 | 112739 | 84.0 | 84.0 | NAV | 掉头 | 按导航行驶 | 提示掉头方向（转向灯/LED） | 44;45 | high
NAV-112739-15 | 112739 | 90.0 | 90.0 | NAV | 掉头 | 按导航行驶 | 提示掉头方向（转向灯/LED） | 46;47 | high
HAZARD-112507-01 | 112507 | 40.0 | 41.5 | HAZARD | ped_crossing_near | 危险处置 | 减速提醒 | 33 | mid | 右转路径旁人行横道有行人和电动车等候（行人灯红）
HAZARD-113343-01 | 113343 | 12.0 | 14.0 | HAZARD | lead_close | 危险处置 | 碰撞提醒 | 16 | mid | 接近排队车辆并刹停
HAZARD-113421-01 | 113421 | 7.0 | 10.0 | HAZARD | cut_in | 危险处置 | 碰撞提醒 | 11 | low | 前车由揽胜变为蓝色宝马（宝马并入或自车偏移），待核对
HAZARD-113452-01 | 113452 | 8.0 | 10.5 | HAZARD | lead_close | 危险处置 | 碰撞提醒 | 13 | high | 前车刹车、距离缩小至停车
HAZARD-113539-01 | 113539 | 11.0 | 12.5 | HAZARD | lead_close | 危险处置 | 碰撞提醒 | 22 | mid | 接近前方出租车并刹停（静止排队段不算）
HAZARD-113539-02 | 113539 | 17.5 | 19.5 | HAZARD | ped_crossing_near | 危险处置 | 减速提醒 | 23 | mid | 行人/电动车从出租车前横穿
HAZARD-113539-03 | 113539 | 23.5 | 25.0 | HAZARD | ped_crossing_near | 危险处置 | 减速提醒 | 24 | mid | 摩托/电动车横穿
HAZARD-113539-04 | 113539 | 40.5 | 41.5 | HAZARD | ped_crossing_near | 危险处置 | 减速提醒 | 29 | mid | 打伞行人在车流间穿行
HAZARD-113539-05 | 113539 | 54.0 | 54.5 | HAZARD | cut_in | 危险处置 | 碰撞提醒 | 33 | low | 蓝色三轮车在左前方近距离
HAZARD-113539-06 | 113539 | 62.0 | 63.5 | HAZARD | lead_close | 危险处置 | 碰撞提醒 | 43 | mid | 接近前方出租车并刹停
HAZARD-113539-07 | 113539 | 69.5 | 71.5 | HAZARD | ped_in_path | 危险处置 | 刹车/停车 + 报警 | 45 | mid | 转弯时人行横道上行人与电动车在车前横穿
SPEED-112507-01 | 112507 | 43.0 | 43.0 | SPEED |  | 按限速行驶 | 记录限速值50.0，车速（按键/参数模拟）超过时超速提醒 | 34 | high | 右转后路右侧限速 50
SPEED-112739-01 | 112739 | 14.0 | 14.0 | SPEED |  | 按限速行驶 | 记录限速值50.0，车速（按键/参数模拟）超过时超速提醒 | 8 | low | 路侧红圈标志，数字待核；导航地图 48–58 s 也显示限速 50
SPEED-113421-01 | 113421 | 11.0 | 11.0 | SPEED |  | 按限速行驶 | 记录限速值40.0，车速（按键/参数模拟）超过时超速提醒 | 12 | high | 路右侧限速 40 与禁停标志
SPEED-113539-01 | 113539 | 1.0 | 1.0 | SPEED |  | 按限速行驶 | 记录限速值40.0，车速（按键/参数模拟）超过时超速提醒 | 11 | mid | 右上角限速 40
