Zdy-1110/FPGA-676/tools/ov_sccb/test_tune.txt

# Moved to tools/ov_sccb/test/test_tune.txt
