Zdy-1110/FPGA-676/tools/adas/host_test/test_eval.md

# 参考感知 / 判决离线评测报告

- 生成时间：2026-11-02 17:59:31
- runs-dir：tools/adas/host_test/out
- gt-dir：video_review/gt
- testcases：video_review/gt/out/testcases.csv
- pass-ratio：0.8；edge-trim：0.3；right_free：True
- 已加载运行结果视频：112454, 112507, 112739, 113343, 113421, 113452, 113539

## 一、测试用例汇总

| category | 总数 | 参评数 | PASS | FAIL | NO_FRAMES | NO_RUN | 通过率 |
| --- | --- | --- | --- | --- | --- | --- | --- |
| SIG | 69 | 69 | 63 | 6 | 0 | 0 | 91.3% |
| LANE | 32 | 32 | 20 | 12 | 0 | 0 | 62.5% |
| 合计 | 101 | 101 | 83 | 18 | 0 | 0 | 82.2% |

### 按视频通过率（SIG+LANE）

| video | 总数 | PASS | FAIL | 通过率 |
| --- | --- | --- | --- | --- |
| 112454 | 5 | 5 | 0 | 100.0% |
| 112507 | 32 | 25 | 7 | 78.1% |
| 112739 | 4 | 2 | 2 | 50.0% |
| 113343 | 18 | 17 | 1 | 94.4% |
| 113421 | 7 | 7 | 0 | 100.0% |
| 113452 | 8 | 7 | 1 | 87.5% |
| 113539 | 27 | 20 | 7 | 74.1% |
| 合计 | 101 | 83 | 18 | 82.2% |

### 按 conf 通过率（SIG+LANE）

| conf | 总数 | PASS | FAIL | 通过率 |
| --- | --- | --- | --- | --- |
| high | 26 | 26 | 0 | 100.0% |
| mid | 59 | 48 | 11 | 81.4% |
| low | 16 | 9 | 7 | 56.2% |

### FAIL 用例清单（按 match_ratio 升序）

| case_id | 窗口 | 期望 | dominant_pred | match_ratio | note |
| --- | --- | --- | --- | --- | --- |
| LANE-112507-01 | [1.30, 9.20] | ALLOW | KEEP | 0.0000 | 虚线 |
| LANE-112507-04 | [15.30, 19.20] | ALLOW | KEEP | 0.0000 | 虚线 |
| LANE-112507-07 | [26.30, 29.70] | ALLOW | KEEP | 0.0000 | 虚线 |
| LANE-112507-10 | [43.30, 44.70] | ALLOW | KEEP | 0.0000 | 虚线 |
| LANE-112507-11 | [1.30, 9.20] | ALLOW | KEEP | 0.0000 | 虚线 |
| LANE-112507-14 | [15.30, 19.20] | ALLOW | KEEP | 0.0000 | 虚线 |
| LANE-112507-17 | [26.30, 34.70] | ALLOW | KEEP | 0.0000 | 虚线 |
| LANE-113343-03 | [0.30, 7.70] | ALLOW | KEEP | 0.0000 | 虚线 |
| LANE-113452-01 | [0.30, 4.70] | ALLOW | KEEP | 0.0000 | 虚线 |
| LANE-113539-03 | [0.30, 4.70] | ALLOW | KEEP | 0.0000 | 虚线 |
| LANE-113539-08 | [37.30, 46.70] | ALLOW | KEEP | 0.0000 | 虚线 |
| LANE-113539-09 | [54.30, 59.70] | ALLOW | KEEP | 0.0000 | 虚线 |
| SIG-113539-13 | [67.80, 68.70] | STOP | GO | 0.5000 | 灯=yellow |
| SIG-113539-14 | [67.80, 68.70] | ALARM | GO | 0.5000 | 灯=yellow 强制通过 |
| SIG-113539-16 | [67.80, 68.70] | STOP | GO | 0.5000 | 灯=yellow |
| SIG-113539-17 | [67.80, 68.70] | ALARM | GO | 0.5000 | 灯=yellow 强制通过 |
| SIG-112739-03 | [64.30, 76.70] | STOP | STOP | 0.6480 | 灯=red |
| SIG-112739-04 | [64.30, 76.70] | ALARM | ALARM | 0.6480 | 灯=red 强制通过 |

## 二、第一部分：逐帧状态准确率

### 信号灯逐帧准确率

| video | 精确一致 | 颜色一致(真值红/黄/绿) | 停走一致 |
| --- | --- | --- | --- |
| 112454 | 104/108 (96.3%) | 68/72 (94.4%) | 104/108 (96.3%) |
| 112507 | 142/173 (82.1%) | 105/105 (100.0%) | 173/173 (100.0%) |
| 112739 | 197/271 (72.7%) | 197/271 (72.7%) | 224/271 (82.7%) |
| 113343 | 282/282 (100.0%) | 188/188 (100.0%) | 282/282 (100.0%) |
| 113421 | 295/303 (97.4%) | 194/202 (96.0%) | 303/303 (100.0%) |
| 113452 | 93/119 (78.2%) | 39/65 (60.0%) | 119/119 (100.0%) |
| 113539 | 811/831 (97.6%) | 544/564 (96.5%) | 811/831 (97.6%) |
| 总计 | 1924/2087 (92.2%) | 1335/1467 (91.0%) | 2016/2087 (96.6%) |

### 车道线逐帧准确率

| video | 类型一致(虚线/实线/无) | 精确类型一致 |
| --- | --- | --- |
| 112454 | 0/0 (-) | 0/0 (-) |
| 112507 | 0/597 (0.0%) | 0/597 (0.0%) |
| 112739 | 0/0 (-) | 0/0 (-) |
| 113343 | 0/162 (0.0%) | 0/162 (0.0%) |
| 113421 | 0/0 (-) | 0/0 (-) |
| 113452 | 0/51 (0.0%) | 0/51 (0.0%) |
| 113539 | 0/426 (0.0%) | 0/426 (0.0%) |
| 总计 | 0/1236 (0.0%) | 0/1236 (0.0%) |

### 自车运动逐帧准确率

| video | 运动一致 |
| --- | --- |
| 112454 | 35/36 (97.2%) |
| 112507 | 450/450 (100.0%) |
| 112739 | 879/926 (94.9%) |
| 113343 | 193/219 (88.1%) |
| 113421 | 71/131 (54.2%) |
| 113452 | 140/144 (97.2%) |
| 113539 | 696/772 (90.2%) |
| 总计 | 2464/2678 (92.0%) |

### 按真值 conf 统计

| conf | 信号精确 | 信号颜色 | 信号停走 | 车道线类型 | 车道线精确 | 运动 |
| --- | --- | --- | --- | --- | --- | --- |
| high | 99.2% | 99.2% | 99.2% | - | - | 89.7% |
| mid | 89.0% | 83.3% | 94.9% | 0.0% | 0.0% | 99.3% |
| low | 86.6% | 82.9% | 96.8% | 0.0% | 0.0% | 86.3% |

### 混淆矩阵：信号灯（真值 x 预测，精确值）

| 真值\预测 | green | none | red | yellow | 合计 |
| --- | --- | --- | --- | --- | --- |
| green | 507 | 8 | 4 | 0 | 519 |
| none | 31 | 589 | 0 | 0 | 620 |
| red | 47 | 4 | 812 | 53 | 916 |
| yellow | 16 | 0 | 0 | 16 | 32 |

### 混淆矩阵：车道线（真值 x 预测，类型）

| 真值\预测 | none | 合计 |
| --- | --- | --- |
| dashed | 756 | 756 |
| solid | 480 | 480 |

### 混淆矩阵：自车运动（真值 x 预测）

| 真值\预测 | moving | stopped | 合计 |
| --- | --- | --- | --- |
| moving | 2091 | 83 | 2174 |
| stopped | 131 | 373 | 504 |
