Zdy-1110/FPGA-676/tools/ov_sccb/test/test_tune.txt

# Normal test tune
0x3406 0x01
sleep_ms 5
0x3400 0x04
