Zdy-1110/FPGA-676/tools/adas/host_test/out/112454/states.csv

frame | t | sig_left | sig_straight | sig_right | raw_left | raw_straight | raw_right | n_lights | lights | left_line | right_line | left_cov | right_cov | ego_motion | motion_score
0 | 0.000 | none | none | none | red | red | none | 2 | red:straight:828:243:854:268;red:left:508:248:539:276 |  |  | 0 | 0 | moving | 0.000
3 | 0.100 | none | none | none | red | red | none | 2 | red:straight:828:241:854:268;red:left:508:246:540:274 |  |  | 0 | 0 | stopped | 2.720
6 | 0.200 | red | red | none | red | red | none | 2 | red:straight:828:240:854:264;red:left:508:244:539:272 |  |  | 0 | 0 | stopped | 2.549
9 | 0.300 | red | red | none | red | red | none | 2 | red:straight:828:238:854:264;red:left:508:243:540:272 |  |  | 0 | 0 | stopped | 2.378
12 | 0.400 | red | red | none | red | red | none | 2 | red:straight:829:239:855:264;red:left:510:242:540:271 |  |  | 0 | 0 | stopped | 2.067
15 | 0.500 | red | red | none | red | red | none | 2 | red:straight:830:238:856:262;red:left:511:243:541:271 |  |  | 0 | 0 | stopped | 1.756
18 | 0.600 | red | red | none | red | red | none | 2 | red:straight:831:238:858:266;red:left:512:243:542:271 |  |  | 0 | 0 | stopped | 1.597
21 | 0.700 | red | red | none | red | red | none | 2 | red:straight:832:238:858:265;red:left:512:242:544:271 |  |  | 0 | 0 | stopped | 1.597
24 | 0.800 | red | red | none | red | red | none | 2 | red:straight:834:238:860:264;red:left:514:242:546:270 |  |  | 0 | 0 | stopped | 1.756
27 | 0.900 | red | red | none | red | red | none | 2 | red:straight:836:238:862:262;red:left:516:242:548:271 |  |  | 0 | 0 | stopped | 1.852
30 | 1.000 | red | red | none | red | red | none | 2 | red:straight:838:236:864:264;red:left:519:242:550:270 |  |  | 0 | 0 | stopped | 2.182
33 | 1.100 | red | red | none | red | red | none | 2 | red:straight:840:236:866:262;red:left:520:242:552:270 |  |  | 0 | 0 | stopped | 2.247
36 | 1.200 | red | red | none | red | red | none | 2 | red:straight:842:236:869:264;red:left:523:242:554:270 |  |  | 0 | 0 | stopped | 2.989
39 | 1.300 | red | red | none | red | red | none | 2 | red:straight:844:236:871:260;red:left:526:241:556:269 |  |  | 0 | 0 | stopped | 3.127
42 | 1.400 | red | red | none | red | red | none | 2 | red:unknown:847:234:873:253;red:left:528:240:559:268 |  |  | 0 | 0 | stopped | 3.391
45 | 1.500 | red | red | none | red | red | none | 2 | red:straight:849:234:876:260;red:left:530:240:561:268 |  |  | 0 | 0 | stopped | 3.391
48 | 1.600 | red | red | none | red | red | none | 2 | red:straight:851:234:877:262;red:left:532:240:563:268 |  |  | 0 | 0 | stopped | 3.391
51 | 1.700 | red | red | none | red | red | none | 2 | red:straight:852:234:879:262;red:left:534:240:565:268 |  |  | 0 | 0 | stopped | 3.083
54 | 1.800 | red | red | none | red | red | none | 2 | red:straight:854:234:880:258;red:left:536:240:566:268 |  |  | 0 | 0 | stopped | 2.641
57 | 1.900 | red | red | none | red | red | none | 2 | red:straight:856:234:882:262;red:left:538:240:568:268 |  |  | 0 | 0 | stopped | 2.641
60 | 2.000 | red | red | none | red | red | none | 2 | red:straight:857:233:884:262;red:left:539:240:570:268 |  |  | 0 | 0 | stopped | 2.586
63 | 2.100 | red | red | none | red | red | none | 2 | red:straight:859:234:886:258;red:left:540:240:572:268 |  |  | 0 | 0 | stopped | 2.641
66 | 2.200 | red | red | none | red | red | none | 2 | red:straight:860:233:886:260;red:left:542:240:572:268 |  |  | 0 | 0 | stopped | 2.586
69 | 2.300 | red | red | none | red | red | none | 2 | red:straight:862:233:888:260;red:left:543:240:574:268 |  |  | 0 | 0 | stopped | 2.586
72 | 2.400 | red | red | none | red | red | none | 2 | red:straight:862:233:888:260;red:left:544:240:574:268 |  |  | 0 | 0 | stopped | 2.323
75 | 2.500 | red | red | none | red | red | none | 2 | red:straight:864:232:890:261;red:left:545:240:576:268 |  |  | 0 | 0 | stopped | 2.274
78 | 2.600 | red | red | none | red | red | none | 2 | red:straight:864:232:890:258;red:left:546:238:576:266 |  |  | 0 | 0 | stopped | 2.274
81 | 2.700 | red | red | none | red | red | none | 2 | red:straight:865:232:891:260;red:left:546:238:577:266 |  |  | 0 | 0 | stopped | 2.277
84 | 2.800 | red | red | none | red | red | none | 2 | red:straight:865:232:892:256;red:left:547:238:577:266 |  |  | 0 | 0 | stopped | 2.042
87 | 2.900 | red | red | none | red | red | none | 2 | red:straight:866:231:892:258;red:left:547:238:578:266 |  |  | 0 | 0 | stopped | 1.931
90 | 3.000 | red | red | none | red | red | none | 2 | red:straight:866:232:892:258;red:left:548:238:578:266 |  |  | 0 | 0 | stopped | 1.675
93 | 3.100 | red | red | none | red | red | none | 2 | red:straight:866:230:893:256;red:left:548:236:579:264 |  |  | 0 | 0 | stopped | 1.675
96 | 3.200 | red | red | none | red | red | none | 2 | red:straight:868:225:894:253;red:left:549:232:580:261 |  |  | 0 | 0 | stopped | 1.675
99 | 3.300 | red | red | none | red | red | none | 2 | red:straight:868:220:895:248;red:left:550:227:580:256 |  |  | 0 | 0 | stopped | 2.270
102 | 3.400 | red | red | none | red | red | none | 2 | red:straight:869:214:896:240;red:left:550:221:581:249 |  |  | 0 | 0 | stopped | 4.833
105 | 3.500 | red | red | none | red | red | none | 2 | red:straight:868:209:894:236;red:left:550:216:581:244 |  |  | 0 | 0 | stopped | 4.833
