Zdy-1110/FPGA-676/tools/adas/host_test/out/112507/states.csv

frame | t | sig_left | sig_straight | sig_right | raw_left | raw_straight | raw_right | n_lights | lights | left_line | right_line | left_cov | right_cov | ego_motion | motion_score
0 | 0.000 | none | none | none | none | none | none | 0 |  |  |  | 0 | 0 | moving | 0.000
3 | 0.100 | none | none | none | none | green | none | 1 | green:straight:905:158:940:196 |  |  | 0 | 0 | moving | 15.591
6 | 0.200 | none | none | none | none | green | none | 1 | green:straight:906:162:942:201 |  |  | 0 | 0 | moving | 15.990
9 | 0.300 | none | green | none | none | green | none | 1 | green:straight:905:173:942:206 |  |  | 0 | 0 | moving | 16.390
12 | 0.400 | none | green | none | green | none | none | 1 | green:left:474:163:519:202 |  |  | 0 | 0 | moving | 16.129
15 | 0.500 | none | green | none | green | none | none | 1 | green:left:463:158:502:188 |  |  | 0 | 0 | moving | 15.868
18 | 0.600 | green | green | none | green | green | none | 1 | green:unknown:456:150:486:176 |  |  | 0 | 0 | moving | 15.868
21 | 0.700 | green | green | none | none | none | none | 0 |  |  |  | 0 | 0 | moving | 14.619
24 | 0.800 | green | green | none | green | green | none | 1 | green:unknown:430:116:455:140 |  |  | 0 | 0 | moving | 14.170
27 | 0.900 | green | green | none | green | green | none | 1 | green:unknown:409:79:442:112 |  |  | 0 | 0 | moving | 14.170
30 | 1.000 | green | green | none | none | none | green | 1 | green:right:388:50:416:76 |  |  | 0 | 0 | moving | 14.170
33 | 1.100 | green | green | none | none | none | none | 0 |  |  |  | 0 | 0 | moving | 14.619
36 | 1.200 | green | green | none | none | none | none | 0 |  |  |  | 0 | 0 | moving | 15.138
39 | 1.300 | green | green | none | none | none | none | 0 |  |  |  | 0 | 0 | moving | 15.138
42 | 1.400 | green | green | none | none | none | none | 0 |  |  |  | 0 | 0 | moving | 13.555
45 | 1.500 | green | green | none | none | none | none | 0 |  |  |  | 0 | 0 | moving | 13.724
48 | 1.600 | green | green | none | none | none | none | 0 |  |  |  | 0 | 0 | moving | 13.724
51 | 1.700 | green | green | none | none | none | none | 0 |  |  |  | 0 | 0 | moving | 13.724
54 | 1.800 | green | green | none | none | none | none | 0 |  |  |  | 0 | 0 | moving | 13.724
57 | 1.900 | green | green | none | none | none | none | 0 |  |  |  | 0 | 0 | moving | 13.724
60 | 2.000 | green | green | none | none | none | none | 0 |  |  |  | 0 | 0 | moving | 12.924
63 | 2.100 | green | green | none | none | none | none | 0 |  |  |  | 0 | 0 | moving | 11.282
66 | 2.200 | green | green | none | none | none | none | 0 |  |  |  | 0 | 0 | moving | 11.027
69 | 2.300 | green | green | none | none | none | none | 0 |  |  |  | 0 | 0 | moving | 11.027
72 | 2.400 | green | green | none | none | none | none | 0 |  |  |  | 0 | 0 | moving | 11.282
75 | 2.500 | green | green | none | red | red | none | 1 | red:unknown:1370:638:1388:648 |  |  | 0 | 0 | moving | 11.298
78 | 2.600 | green | green | none | red | red | none | 1 | red:unknown:1376:624:1410:648 |  |  | 0 | 0 | moving | 11.528
81 | 2.700 | red | red | none | red | red | none | 1 | red:unknown:1390:608:1432:648 |  |  | 0 | 0 | moving | 11.683
84 | 2.800 | red | red | none | none | none | none | 0 |  |  |  | 0 | 0 | moving | 11.683
87 | 2.900 | red | red | none | none | none | none | 0 |  |  |  | 0 | 0 | moving | 11.528
90 | 3.000 | red | red | none | none | none | none | 0 |  |  |  | 0 | 0 | moving | 9.671
93 | 3.100 | red | red | none | none | none | none | 0 |  |  |  | 0 | 0 | moving | 9.671
96 | 3.200 | red | red | none | none | none | none | 0 |  |  |  | 0 | 0 | moving | 9.671
99 | 3.300 | red | red | none | none | none | none | 0 |  |  |  | 0 | 0 | moving | 11.239
102 | 3.400 | red | red | none | none | none | none | 0 |  |  |  | 0 | 0 | moving | 11.696
105 | 3.500 | red | red | none | green | green | none | 2 | green:unknown:1544:272:1562:309;green:unknown:340:344:349:353 |  |  | 0 | 0 | moving | 12.613
108 | 3.600 | red | red | none | red | red | none | 1 | red:unknown:1576:558:1633:623 |  |  | 0 | 0 | moving | 12.613
111 | 3.700 | red | red | none | red | red | none | 1 | red:unknown:1606:548:1666:614 |  |  | 0 | 0 | moving | 13.511
114 | 3.800 | red | red | none | red | red | none | 1 | red:unknown:1641:537:1703:604 |  |  | 0 | 0 | moving | 12.613
117 | 3.900 | red | red | none | red | red | none | 1 | red:unknown:1674:532:1739:598 |  |  | 0 | 0 | moving | 15.287
120 | 4.000 | red | red | none | green | green | none | 1 | green:unknown:1730:188:1738:202 |  |  | 0 | 0 | moving | 12.010
123 | 4.100 | red | red | none | green | green | none | 1 | green:unknown:1766:100:1774:110 |  |  | 0 | 0 | moving | 15.699
126 | 4.200 | red | red | none | red | red | none | 1 | red:unknown:1785:504:1862:578 |  |  | 0 | 0 | moving | 15.699
129 | 4.300 | red | red | none | red | red | none | 1 | red:unknown:1834:486:1913:562 |  |  | 0 | 0 | moving | 15.699
132 | 4.400 | red | red | none | none | none | none | 0 |  |  |  | 0 | 0 | moving | 11.008
135 | 4.500 | red | red | none | none | none | none | 0 |  |  |  | 0 | 0 | moving | 13.016
138 | 4.600 | red | red | none | none | none | none | 0 |  |  |  | 0 | 0 | moving | 12.248
141 | 4.700 | red | red | none | none | none | none | 0 |  |  |  | 0 | 0 | moving | 11.008
144 | 4.800 | red | red | none | none | none | none | 0 |  |  |  | 0 | 0 | moving | 12.033
147 | 4.900 | red | red | none | none | none | none | 0 |  |  |  | 0 | 0 | moving | 12.033
150 | 5.000 | red | red | none | none | none | none | 0 |  |  |  | 0 | 0 | moving | 8.852
153 | 5.100 | red | red | none | yellow | yellow | none | 1 | yellow:unknown:1716:124:1728:134 |  |  | 0 | 0 | moving | 8.852
156 | 5.200 | red | red | none | green | green | none | 1 | green:unknown:556:403:587:416 |  |  | 0 | 0 | moving | 9.209
159 | 5.300 | red | red | none | none | none | none | 0 |  |  |  | 0 | 0 | moving | 7.896
162 | 5.400 | red | red | none | none | none | none | 0 |  |  |  | 0 | 0 | moving | 9.209
165 | 5.500 | red | red | none | none | none | none | 0 |  |  |  | 0 | 0 | moving | 9.369
168 | 5.600 | red | red | none | none | none | green | 1 | green:right:546:386:558:396 |  |  | 0 | 0 | moving | 11.404
171 | 5.700 | red | red | none | red | none | none | 1 | red:left:1641:500:1652:513 |  |  | 0 | 0 | moving | 13.708
174 | 5.800 | red | red | none | none | none | none | 0 |  |  |  | 0 | 0 | moving | 13.708
177 | 5.900 | red | red | none | red | red | none | 1 | red:unknown:1676:514:1684:524 |  |  | 0 | 0 | moving | 18.205
180 | 6.000 | red | red | none | red | red | none | 3 | red:unknown:1710:498:1722:506;red:unknown:1694:499:1704:508;red:unknown:1696:516:1708:525 |  |  | 0 | 0 | moving | 13.919
183 | 6.100 | red | red | none | yellow | yellow | none | 1 | yellow:unknown:1889:586:1906:596 |  |  | 0 | 0 | moving | 19.505
186 | 6.200 | red | red | none | red | red | none | 1 | red:unknown:1748:518:1756:526 |  |  | 0 | 0 | moving | 15.792
189 | 6.300 | red | red | none | red | red | none | 1 | red:unknown:1776:522:1795:532 |  |  | 0 | 0 | moving | 15.792
192 | 6.400 | red | red | none | red | red | none | 1 | red:unknown:1802:522:1820:534 |  |  | 0 | 0 | moving | 15.150
195 | 6.500 | red | red | none | none | none | none | 0 |  |  |  | 0 | 0 | moving | 15.792
198 | 6.600 | red | red | none | red | red | none | 1 | red:unknown:1860:484:1895:520 |  |  | 0 | 0 | moving | 15.150
201 | 6.700 | red | red | none | red | none | none | 1 | red:left:1896:468:1920:485 |  |  | 0 | 0 | moving | 12.917
204 | 6.800 | red | red | none | none | none | none | 0 |  |  |  | 0 | 0 | moving | 12.917
207 | 6.900 | red | red | none | green | green | none | 1 | green:round:1790:624:1808:634 |  |  | 0 | 0 | moving | 13.522
210 | 7.000 | red | red | none | none | none | none | 0 |  |  |  | 0 | 0 | moving | 12.917
213 | 7.100 | red | red | none | none | none | none | 0 |  |  |  | 0 | 0 | moving | 11.075
216 | 7.200 | red | red | none | none | none | none | 0 |  |  |  | 0 | 0 | moving | 11.391
219 | 7.300 | red | red | none | green | green | none | 1 | green:unknown:1822:616:1832:636 |  |  | 0 | 0 | moving | 11.261
222 | 7.400 | red | red | green | none | none | green | 1 | green:right:1822:624:1852:648 |  |  | 0 | 0 | moving | 11.075
225 | 7.500 | green | red | green | green | none | none | 1 | green:left:1836:626:1860:648 |  |  | 0 | 0 | moving | 11.261
228 | 7.600 | green | red | green | green | none | none | 1 | green:left:1848:628:1866:648 |  |  | 0 | 0 | moving | 11.391
231 | 7.700 | green | red | green | none | none | none | 0 |  |  |  | 0 | 0 | moving | 11.614
234 | 7.800 | green | red | green | none | none | green | 1 | green:right:1846:633:1862:648 |  |  | 0 | 0 | moving | 12.267
237 | 7.900 | green | red | green | none | none | none | 0 |  |  |  | 0 | 0 | moving | 12.279
240 | 8.000 | green | red | green | none | none | none | 0 |  |  |  | 0 | 0 | moving | 12.279
243 | 8.100 | green | red | green | none | none | none | 0 |  |  |  | 0 | 0 | moving | 12.267
246 | 8.200 | green | red | green | none | none | none | 0 |  |  |  | 0 | 0 | moving | 11.751
249 | 8.300 | green | red | green | none | none | none | 0 |  |  |  | 0 | 0 | moving | 11.449
252 | 8.400 | green | red | green | none | none | none | 0 |  |  |  | 0 | 0 | moving | 11.358
255 | 8.500 | green | red | green | none | none | none | 0 |  |  |  | 0 | 0 | moving | 11.304
258 | 8.600 | green | red | green | none | none | none | 0 |  |  |  | 0 | 0 | moving | 11.270
261 | 8.700 | green | red | green | none | none | none | 0 |  |  |  | 0 | 0 | moving | 10.975
264 | 8.800 | green | green | green | green | green | none | 1 | green:unknown:821:532:829:542 |  |  | 0 | 0 | moving | 10.975
267 | 8.900 | green | green | green | green | green | none | 1 | green:unknown:820:525:828:534 |  |  | 0 | 0 | moving | 11.270
270 | 9.000 | green | green | green | green | green | none | 1 | green:unknown:126:158:138:174 |  |  | 0 | 0 | moving | 11.652
273 | 9.100 | green | green | green | green | green | none | 1 | green:unknown:356:14:364:22 |  |  | 0 | 0 | moving | 11.873
276 | 9.200 | green | green | green | green | green | none | 1 | green:unknown:814:503:823:513 |  |  | 0 | 0 | moving | 11.873
279 | 9.300 | green | green | green | green | green | none | 1 | green:unknown:813:499:822:508 |  |  | 0 | 0 | moving | 11.652
282 | 9.400 | green | green | green | green | green | none | 1 | green:unknown:348:6:356:14 |  |  | 0 | 0 | moving | 11.149
285 | 9.500 | green | green | green | green | green | none | 1 | green:unknown:348:8:356:18 |  |  | 0 | 0 | moving | 11.076
288 | 9.600 | green | green | green | none | green | none | 1 | green:straight:811:503:821:513 |  |  | 0 | 0 | moving | 10.586
291 | 9.700 | green | green | green | green | green | none | 1 | green:unknown:346:13:354:22 |  |  | 0 | 0 | moving | 10.586
294 | 9.800 | green | green | green | none | none | green | 1 | green:right:810:502:820:513 |  |  | 0 | 0 | moving | 11.050
297 | 9.900 | green | green | green | green | green | none | 2 | green:unknown:811:502:820:513;green:unknown:982:504:990:512 |  |  | 0 | 0 | moving | 11.076
300 | 10.000 | green | green | green | green | green | none | 2 | green:round:811:502:821:512;green:unknown:986:504:994:514 |  |  | 0 | 0 | moving | 11.097
303 | 10.100 | green | green | green | green | green | none | 2 | green:round:812:502:822:512;green:unknown:989:503:998:512 |  |  | 0 | 0 | moving | 11.155
306 | 10.200 | green | green | green | green | green | none | 2 | green:straight:813:499:823:511;green:unknown:993:501:1002:510 |  |  | 0 | 0 | moving | 11.155
309 | 10.300 | green | green | green | green | green | none | 2 | green:straight:815:495:825:506;green:unknown:998:497:1006:506 |  |  | 0 | 0 | moving | 11.743
312 | 10.400 | green | green | green | green | none | none | 1 | green:left:98:141:113:159 |  |  | 0 | 0 | moving | 12.103
315 | 10.500 | green | green | green | green | none | none | 1 | green:left:99:144:113:156 |  |  | 0 | 0 | moving | 12.376
318 | 10.600 | green | green | green | green | none | none | 1 | green:left:99:139:112:152 |  |  | 0 | 0 | moving | 13.704
321 | 10.700 | green | green | green | green | green | none | 1 | green:round:98:136:110:148 |  |  | 0 | 0 | moving | 14.072
324 | 10.800 | green | green | green | green | green | none | 1 | green:round:96:132:108:144 |  |  | 0 | 0 | moving | 14.292
327 | 10.900 | green | green | green | green | green | none | 1 | green:unknown:94:126:103:140 |  |  | 0 | 0 | moving | 14.655
330 | 11.000 | green | green | green | green | green | none | 1 | green:round:178:400:191:412 |  |  | 0 | 0 | moving | 18.091
333 | 11.100 | green | green | green | green | none | none | 1 | green:left:94:116:106:130 |  |  | 0 | 0 | moving | 19.997
336 | 11.200 | green | green | green | green | green | none | 1 | green:round:94:108:106:124 |  |  | 0 | 0 | moving | 19.997
339 | 11.300 | green | green | green | green | green | none | 1 | green:round:94:98:108:118 |  |  | 0 | 0 | moving | 19.997
342 | 11.400 | green | green | green | green | green | none | 1 | green:round:96:96:108:114 |  |  | 0 | 0 | moving | 19.796
345 | 11.500 | green | green | green | green | green | none | 1 | green:round:96:92:108:110 |  |  | 0 | 0 | moving | 18.592
348 | 11.600 | green | green | green | green | green | none | 1 | green:round:96:88:106:108 |  |  | 0 | 0 | moving | 18.413
351 | 11.700 | green | green | green | green | green | none | 1 | green:unknown:90:84:103:104 |  |  | 0 | 0 | moving | 17.294
354 | 11.800 | green | green | green | none | green | green | 2 | green:straight:820:388:834:404;green:right:1073:393:1084:406 |  |  | 0 | 0 | moving | 16.961
357 | 11.900 | green | green | green | none | green | none | 2 | green:straight:816:382:830:397;green:straight:1076:387:1088:402 |  |  | 0 | 0 | moving | 16.889
360 | 12.000 | green | green | green | none | green | none | 2 | green:straight:811:377:826:392;green:straight:1079:382:1092:396 |  |  | 0 | 0 | moving | 16.040
363 | 12.100 | green | green | green | none | green | none | 2 | green:straight:806:370:822:388;green:straight:1083:375:1098:392 |  |  | 0 | 0 | moving | 15.584
366 | 12.200 | green | green | green | none | green | green | 2 | green:right:802:361:818:378;green:straight:1088:366:1104:384 |  |  | 0 | 0 | moving | 15.144
369 | 12.300 | green | green | green | none | green | none | 2 | green:straight:798:350:814:368;green:straight:1094:355:1108:372 |  |  | 0 | 0 | moving | 14.774
372 | 12.400 | green | green | green | none | green | none | 2 | green:straight:792:338:808:356;green:straight:1099:342:1114:360 |  |  | 0 | 0 | moving | 13.657
375 | 12.500 | green | green | green | none | green | none | 2 | green:straight:786:326:802:346;green:straight:1104:330:1122:348 |  |  | 0 | 0 | moving | 13.657
378 | 12.600 | green | green | green | none | green | none | 2 | green:straight:774:315:792:336;green:straight:1108:319:1125:340 |  |  | 0 | 0 | moving | 14.563
381 | 12.700 | green | green | green | none | green | none | 2 | green:straight:760:302:778:322;green:straight:1107:306:1126:326 |  |  | 0 | 0 | moving | 14.563
384 | 12.800 | green | green | green | green | green | none | 2 | green:left:744:282:764:304;green:straight:1108:286:1127:308 |  |  | 0 | 0 | moving | 14.656
387 | 12.900 | green | green | green | none | green | none | 2 | green:straight:726:250:748:274;green:straight:1110:255:1130:278 |  |  | 0 | 0 | moving | 14.729
390 | 13.000 | green | green | green | none | green | none | 2 | green:straight:715:211:738:237;green:straight:1119:216:1141:242 |  |  | 0 | 0 | moving | 15.715
393 | 13.100 | green | green | green | none | green | none | 2 | green:straight:704:169:729:196;green:straight:1130:174:1154:200 |  |  | 0 | 0 | moving | 17.370
396 | 13.200 | green | green | green | green | green | none | 2 | green:unknown:689:126:716:155;green:straight:1140:132:1165:159 |  |  | 0 | 0 | moving | 17.890
399 | 13.300 | green | green | green | none | green | none | 2 | green:straight:673:84:700:115;green:straight:1152:89:1178:119 |  |  | 0 | 0 | moving | 18.847
402 | 13.400 | green | green | green | none | green | none | 2 | green:straight:650:50:680:80;green:straight:1161:54:1189:85 |  |  | 0 | 0 | moving | 18.929
405 | 13.500 | green | green | green | none | none | none | 0 |  |  |  | 0 | 0 | moving | 21.829
408 | 13.600 | green | green | green | none | none | none | 0 |  |  |  | 0 | 0 | moving | 22.097
411 | 13.700 | green | green | green | none | none | none | 0 |  |  |  | 0 | 0 | moving | 23.138
414 | 13.800 | green | green | green | none | none | none | 0 |  |  |  | 0 | 0 | moving | 23.138
417 | 13.900 | green | green | green | red | red | none | 1 | red:unknown:1380:592:1392:600 |  |  | 0 | 0 | moving | 22.097
420 | 14.000 | green | green | green | none | none | none | 0 |  |  |  | 0 | 0 | moving | 21.539
423 | 14.100 | green | green | green | none | none | none | 0 |  |  |  | 0 | 0 | moving | 20.733
426 | 14.200 | green | green | green | none | none | none | 0 |  |  |  | 0 | 0 | moving | 19.693
429 | 14.300 | green | green | none | none | none | none | 0 |  |  |  | 0 | 0 | moving | 19.045
432 | 14.400 | green | green | none | none | none | none | 0 |  |  |  | 0 | 0 | moving | 17.693
435 | 14.500 | green | green | none | none | none | none | 0 |  |  |  | 0 | 0 | moving | 17.414
438 | 14.600 | green | green | none | none | none | none | 0 |  |  |  | 0 | 0 | moving | 16.372
441 | 14.700 | green | green | none | none | none | none | 0 |  |  |  | 0 | 0 | moving | 15.707
444 | 14.800 | green | green | none | none | none | none | 0 |  |  |  | 0 | 0 | moving | 14.818
447 | 14.900 | green | green | none | none | none | none | 0 |  |  |  | 0 | 0 | moving | 14.321
450 | 15.000 | green | green | none | none | none | none | 0 |  |  |  | 0 | 0 | moving | 14.321
453 | 15.100 | green | green | none | none | none | none | 0 |  |  |  | 0 | 0 | moving | 14.469
456 | 15.200 | green | green | none | none | none | none | 0 |  |  |  | 0 | 0 | moving | 14.818
459 | 15.300 | green | green | none | none | none | none | 0 |  |  |  | 0 | 0 | moving | 15.057
462 | 15.400 | green | green | none | green | green | none | 1 | green:unknown:656:453:672:461 |  |  | 0 | 0 | moving | 15.240
465 | 15.500 | green | green | none | none | none | none | 0 |  |  |  | 0 | 0 | moving | 15.513
468 | 15.600 | green | green | none | green | green | none | 1 | green:round:48:354:64:368 |  |  | 0 | 0 | moving | 15.513
471 | 15.700 | green | green | none | none | none | green | 1 | green:right:40:346:54:366 |  |  | 0 | 0 | moving | 15.513
474 | 15.800 | green | green | none | green | green | none | 1 | green:unknown:682:269:694:278 |  |  | 0 | 0 | moving | 15.240
477 | 15.900 | green | green | none | green | green | none | 1 | green:unknown:670:252:682:260 |  |  | 0 | 0 | moving | 15.106
480 | 16.000 | green | green | none | green | green | green | 2 | green:right:640:437:662:461;green:unknown:654:461:664:469 |  |  | 0 | 0 | moving | 13.004
483 | 16.100 | green | green | none | none | none | none | 0 |  |  |  | 0 | 0 | moving | 12.775
486 | 16.200 | green | green | none | none | none | none | 0 |  |  |  | 0 | 0 | moving | 12.434
489 | 16.300 | green | green | none | none | none | none | 0 |  |  |  | 0 | 0 | moving | 12.434
492 | 16.400 | green | green | none | green | green | none | 1 | green:unknown:1080:640:1088:648 |  |  | 0 | 0 | moving | 12.434
495 | 16.500 | green | green | none | green | green | none | 1 | green:unknown:638:434:646:446 |  |  | 0 | 0 | moving | 12.434
498 | 16.600 | green | green | none | green | green | none | 1 | green:unknown:1078:634:1086:642 |  |  | 0 | 0 | moving | 12.694
501 | 16.700 | green | green | none | green | green | none | 1 | green:unknown:579:138:587:146 |  |  | 0 | 0 | moving | 13.388
504 | 16.800 | green | green | none | none | none | none | 0 |  |  |  | 0 | 0 | moving | 13.839
507 | 16.900 | green | green | none | green | green | none | 1 | green:unknown:1077:624:1086:632 |  |  | 0 | 0 | moving | 13.388
510 | 17.000 | green | green | none | none | none | none | 0 |  |  |  | 0 | 0 | moving | 13.437
513 | 17.100 | green | green | none | green | green | none | 1 | green:unknown:1080:620:1088:628 |  |  | 0 | 0 | moving | 13.437
516 | 17.200 | green | green | none | green | green | none | 1 | green:unknown:1083:618:1092:627 |  |  | 0 | 0 | moving | 12.770
519 | 17.300 | green | green | none | green | green | none | 1 | green:unknown:1088:616:1096:624 |  |  | 0 | 0 | moving | 12.770
522 | 17.400 | green | green | none | green | green | none | 1 | green:round:1088:614:1098:624 |  |  | 0 | 0 | moving | 12.878
525 | 17.500 | green | green | none | green | green | none | 2 | green:unknown:1090:614:1098:622;green:unknown:1012:616:1022:624 |  |  | 0 | 0 | moving | 12.383
528 | 17.600 | green | green | none | green | green | none | 2 | green:unknown:1090:614:1098:622;green:unknown:1012:616:1020:624 |  |  | 0 | 0 | moving | 12.878
531 | 17.700 | green | green | none | green | green | none | 2 | green:unknown:1088:612:1096:620;green:unknown:1010:616:1018:624 |  |  | 0 | 0 | moving | 13.051
534 | 17.800 | green | green | none | green | green | none | 1 | green:unknown:232:65:241:78 |  |  | 0 | 0 | moving | 12.878
537 | 17.900 | green | green | none | green | green | none | 2 | green:unknown:1083:610:1091:619;green:unknown:1002:614:1011:622 |  |  | 0 | 0 | moving | 13.051
540 | 18.000 | green | green | none | green | green | none | 1 | green:unknown:214:58:222:68 |  |  | 0 | 0 | moving | 13.104
543 | 18.100 | green | green | none | green | green | none | 1 | green:round:206:50:218:62 |  |  | 0 | 0 | moving | 13.104
546 | 18.200 | green | green | none | green | green | none | 1 | green:unknown:200:44:209:52 |  |  | 0 | 0 | moving | 12.197
549 | 18.300 | green | green | none | none | green | none | 1 | green:straight:194:37:206:48 |  |  | 0 | 0 | moving | 12.197
552 | 18.400 | green | green | none | green | green | none | 1 | green:unknown:1074:604:1083:613 |  |  | 0 | 0 | moving | 12.125
555 | 18.500 | green | green | none | green | green | none | 2 | green:unknown:1073:602:1084:611;green:unknown:986:606:995:614 |  |  | 0 | 0 | moving | 11.692
558 | 18.600 | green | green | none | green | green | none | 1 | green:round:172:18:182:30 |  |  | 0 | 0 | moving | 10.179
561 | 18.700 | green | green | none | green | none | none | 1 | green:left:163:12:174:22 |  |  | 0 | 0 | moving | 9.700
564 | 18.800 | green | green | none | none | green | none | 1 | green:straight:150:6:164:18 |  |  | 0 | 0 | moving | 9.361
567 | 18.900 | green | green | none | green | green | none | 1 | green:round:142:0:156:12 |  |  | 0 | 0 | moving | 9.092
570 | 19.000 | green | green | none | green | green | none | 2 | green:unknown:1063:592:1073:601;green:unknown:970:594:981:603 |  |  | 0 | 0 | moving | 8.890
573 | 19.100 | green | green | none | green | green | none | 2 | green:unknown:1061:592:1070:601;green:unknown:966:594:977:603 |  |  | 0 | 0 | moving | 8.890
576 | 19.200 | green | green | none | green | green | none | 2 | green:unknown:1058:592:1067:602;green:unknown:962:595:973:604 |  |  | 0 | 0 | moving | 8.342
579 | 19.300 | green | green | none | green | green | none | 2 | green:round:1055:592:1065:602;green:round:959:594:969:605 |  |  | 0 | 0 | moving | 8.342
582 | 19.400 | green | green | none | green | green | none | 2 | green:unknown:1053:592:1062:602;green:round:954:594:965:605 |  |  | 0 | 0 | moving | 9.397
585 | 19.500 | green | green | none | green | green | none | 2 | green:round:1051:590:1061:600;green:round:951:592:964:602 |  |  | 0 | 0 | moving | 9.397
588 | 19.600 | green | green | none | green | green | none | 2 | green:round:1051:590:1061:600;green:round:950:591:961:602 |  |  | 0 | 0 | moving | 8.229
591 | 19.700 | green | green | none | green | green | none | 2 | green:round:1050:590:1061:601;green:round:948:592:959:603 |  |  | 0 | 0 | moving | 9.397
594 | 19.800 | green | green | none | green | green | none | 2 | green:round:1051:588:1062:600;green:round:947:592:959:602 |  |  | 0 | 0 | moving | 11.808
597 | 19.900 | green | green | none | green | green | none | 2 | green:round:1054:588:1065:598;green:round:948:590:960:600 |  |  | 0 | 0 | moving | 12.982
600 | 20.000 | green | green | none | green | green | none | 2 | green:round:1058:585:1069:597;green:round:952:588:963:598 |  |  | 0 | 0 | moving | 12.982
603 | 20.100 | green | green | none | green | green | none | 2 | green:round:1063:582:1074:594;green:round:954:586:965:596 |  |  | 0 | 0 | moving | 12.982
606 | 20.200 | green | green | none | green | green | none | 2 | green:round:1066:580:1080:592;green:round:956:582:968:594 |  |  | 0 | 0 | moving | 12.860
609 | 20.300 | green | green | none | green | green | none | 2 | green:round:1069:578:1080:590;green:round:957:580:969:591 |  |  | 0 | 0 | moving | 11.453
612 | 20.400 | green | green | none | green | green | none | 2 | green:round:1072:576:1084:587;green:round:958:578:970:589 |  |  | 0 | 0 | moving | 10.388
615 | 20.500 | green | green | none | green | green | none | 2 | green:round:957:576:969:589;green:round:1073:576:1084:588 |  |  | 0 | 0 | moving | 10.331
618 | 20.600 | green | green | none | green | green | none | 2 | green:round:1072:576:1085:589;green:round:955:578:968:590 |  |  | 0 | 0 | moving | 10.331
621 | 20.700 | green | green | none | green | green | none | 2 | green:round:1071:577:1083:590;green:round:951:580:964:592 |  |  | 0 | 0 | moving | 10.331
624 | 20.800 | green | green | none | green | green | none | 2 | green:round:1069:578:1081:592;green:round:947:582:960:594 |  |  | 0 | 0 | moving | 10.331
627 | 20.900 | green | green | none | green | green | none | 2 | green:round:1067:580:1080:592;green:round:943:582:956:594 |  |  | 0 | 0 | moving | 11.668
630 | 21.000 | green | green | none | green | green | none | 2 | green:round:1066:580:1078:593;green:round:940:582:953:594 |  |  | 0 | 0 | moving | 11.668
633 | 21.100 | green | green | none | green | green | none | 2 | green:round:1065:578:1078:592;green:round:936:582:950:594 |  |  | 0 | 0 | moving | 11.338
636 | 21.200 | green | green | none | green | green | none | 2 | green:round:1065:576:1078:591;green:round:934:580:947:593 |  |  | 0 | 0 | moving | 11.015
639 | 21.300 | green | green | none | green | green | none | 2 | green:round:1065:574:1083:589;green:round:932:578:946:590 |  |  | 0 | 0 | moving | 11.015
642 | 21.400 | green | green | none | green | green | none | 2 | green:round:1066:570:1080:585;green:round:930:572:945:586 |  |  | 0 | 0 | moving | 10.968
645 | 21.500 | green | green | none | green | green | none | 2 | green:round:1068:564:1082:579;green:round:930:568:945:581 |  |  | 0 | 0 | moving | 10.968
648 | 21.600 | green | green | none | green | green | none | 2 | green:round:1070:558:1084:574;green:round:929:560:944:575 |  |  | 0 | 0 | moving | 10.968
651 | 21.700 | green | green | none | green | green | none | 2 | green:round:1073:551:1088:567;green:round:929:554:944:569 |  |  | 0 | 0 | moving | 11.762
654 | 21.800 | green | green | none | green | green | none | 2 | green:round:1076:546:1091:562;green:round:928:548:944:564 |  |  | 0 | 0 | moving | 12.194
657 | 21.900 | green | green | none | green | green | none | 2 | green:round:1078:540:1093:556;green:round:927:544:943:558 |  |  | 0 | 0 | moving | 12.194
660 | 22.000 | green | green | none | green | green | none | 2 | green:round:1081:536:1097:552;green:round:928:538:944:554 |  |  | 0 | 0 | moving | 12.260
663 | 22.100 | green | green | none | green | green | none | 2 | green:round:1084:532:1100:549;green:round:927:536:944:552 |  |  | 0 | 0 | moving | 12.336
666 | 22.200 | green | green | none | green | green | none | 2 | green:round:1086:528:1103:546;green:round:925:532:943:549 |  |  | 0 | 0 | moving | 12.336
669 | 22.300 | green | green | none | green | green | none | 2 | green:round:1088:524:1104:542;green:round:923:528:941:544 |  |  | 0 | 0 | moving | 12.375
672 | 22.400 | green | green | none | green | green | none | 2 | green:round:1087:518:1104:537;green:round:918:522:936:540 |  |  | 0 | 0 | moving | 12.714
675 | 22.500 | green | green | none | green | green | none | 2 | green:round:1086:511:1104:530;green:round:914:514:932:533 |  |  | 0 | 0 | moving | 12.714
678 | 22.600 | green | green | none | green | green | none | 2 | green:round:1086:504:1104:523;green:round:908:506:928:526 |  |  | 0 | 0 | moving | 12.636
681 | 22.700 | green | green | none | green | green | none | 2 | green:round:1086:495:1104:515;green:round:904:498:923:517 |  |  | 0 | 0 | moving | 12.636
684 | 22.800 | green | green | none | green | green | none | 2 | green:round:1084:487:1103:508;green:round:897:490:917:510 |  |  | 0 | 0 | moving | 12.660
687 | 22.900 | green | green | none | green | green | none | 2 | green:round:1083:479:1103:500;green:round:892:482:912:503 |  |  | 0 | 0 | moving | 12.660
690 | 23.000 | green | green | none | green | green | none | 2 | green:round:1086:471:1106:493;green:round:889:476:910:496 |  |  | 0 | 0 | moving | 14.136
693 | 23.100 | green | green | none | green | green | none | 2 | green:round:1087:462:1108:484;green:round:884:468:906:488 |  |  | 0 | 0 | moving | 14.136
696 | 23.200 | green | green | none | green | green | none | 2 | green:round:1088:454:1109:477;green:round:878:458:901:480 |  |  | 0 | 0 | moving | 13.642
699 | 23.300 | green | green | none | green | green | none | 2 | green:round:1087:444:1110:468;green:round:872:448:895:471 |  |  | 0 | 0 | moving | 13.642
702 | 23.400 | green | green | none | green | green | none | 2 | green:round:1088:435:1111:459;green:round:865:438:890:462 |  |  | 0 | 0 | moving | 12.799
705 | 23.500 | green | green | none | green | green | none | 2 | green:round:1088:425:1112:450;green:round:858:428:883:454 |  |  | 0 | 0 | moving | 12.799
708 | 23.600 | green | green | none | green | green | none | 2 | green:round:1088:414:1112:440;green:round:850:418:876:443 |  |  | 0 | 0 | moving | 12.799
711 | 23.700 | green | green | none | green | green | none | 2 | green:round:1088:401:1114:428;green:round:842:406:868:432 |  |  | 0 | 0 | moving | 12.799
714 | 23.800 | green | green | none | green | green | none | 2 | green:round:1089:388:1115:416;green:round:834:392:861:420 |  |  | 0 | 0 | moving | 12.799
717 | 23.900 | green | green | none | green | green | none | 2 | green:round:1090:375:1117:404;green:round:825:380:853:409 |  |  | 0 | 0 | moving | 12.192
720 | 24.000 | green | green | none | green | green | none | 2 | green:round:1091:362:1119:392;green:round:815:368:845:397 |  |  | 0 | 0 | moving | 12.192
723 | 24.100 | green | green | none | green | green | none | 2 | green:round:1093:350:1122:380;green:round:806:354:836:386 |  |  | 0 | 0 | moving | 12.192
726 | 24.200 | green | green | none | green | green | none | 2 | green:round:1094:334:1125:366;green:round:796:339:827:372 |  |  | 0 | 0 | moving | 11.729
729 | 24.300 | green | green | none | green | green | none | 2 | green:round:1098:317:1130:350;green:round:786:322:819:356 |  |  | 0 | 0 | moving | 12.477
732 | 24.400 | green | green | none | green | green | none | 2 | green:round:1103:298:1137:334;green:round:777:304:812:339 |  |  | 0 | 0 | moving | 12.953
735 | 24.500 | green | green | none | green | green | none | 2 | green:round:1109:279:1145:316;green:round:768:285:804:322 |  |  | 0 | 0 | moving | 12.953
738 | 24.600 | green | green | none | green | green | none | 2 | green:round:1116:258:1152:296;green:round:757:264:794:303 |  |  | 0 | 0 | moving | 12.953
741 | 24.700 | green | green | none | green | green | none | 2 | green:round:1124:234:1162:274;green:round:745:239:784:280 |  |  | 0 | 0 | moving | 14.906
744 | 24.800 | green | green | none | green | green | none | 2 | green:round:1132:206:1172:246;green:round:732:210:773:253 |  |  | 0 | 0 | moving | 15.953
747 | 24.900 | green | green | none | green | green | none | 2 | green:round:1140:172:1183:216;green:round:716:175:760:221 |  |  | 0 | 0 | moving | 16.600
750 | 25.000 | green | green | none | green | green | none | 2 | green:round:1152:129:1198:176;green:round:700:133:747:182 |  |  | 0 | 0 | moving | 16.600
753 | 25.100 | green | green | none | green | green | none | 2 | green:round:1164:83:1214:133;green:round:682:88:731:139 |  |  | 0 | 0 | moving | 17.706
756 | 25.200 | green | green | none | green | green | none | 2 | green:round:1180:34:1232:87;green:round:661:38:714:94 |  |  | 0 | 0 | moving | 19.933
759 | 25.300 | green | green | none | green | green | none | 2 | green:round:637:0:695:42;green:round:1202:0:1254:36 |  |  | 0 | 0 | moving | 19.933
762 | 25.400 | green | green | none | none | none | red | 1 | red:right:1578:614:1592:626 |  |  | 0 | 0 | moving | 19.933
765 | 25.500 | green | green | none | none | none | none | 0 |  |  |  | 0 | 0 | moving | 19.666
768 | 25.600 | green | green | none | red | none | none | 1 | red:left:1594:606:1633:646 |  |  | 0 | 0 | moving | 19.023
771 | 25.700 | green | green | none | green | green | none | 1 | green:round:1870:598:1894:628 |  |  | 0 | 0 | moving | 17.943
774 | 25.800 | green | green | none | red | red | none | 1 | red:unknown:1670:568:1678:580 |  |  | 0 | 0 | moving | 16.009
777 | 25.900 | green | green | none | none | none | none | 0 |  |  |  | 0 | 0 | moving | 15.226
780 | 26.000 | green | green | none | none | none | none | 0 |  |  |  | 0 | 0 | moving | 15.226
783 | 26.100 | green | green | none | yellow | yellow | none | 1 | yellow:unknown:1230:640:1238:648 |  |  | 0 | 0 | moving | 15.226
786 | 26.200 | green | green | none | red | red | none | 1 | red:round:1361:634:1371:648 |  |  | 0 | 0 | moving | 15.326
789 | 26.300 | green | green | none | red | red | none | 2 | red:round:1363:628:1373:648;yellow:round:1228:638:1238:648 |  |  | 0 | 0 | moving | 15.326
792 | 26.400 | red | red | none | red | red | none | 2 | red:round:1368:628:1378:648;yellow:unknown:1230:639:1242:648 |  |  | 0 | 0 | moving | 15.326
795 | 26.500 | red | red | none | yellow | yellow | none | 1 | yellow:round:1235:624:1246:648 |  |  | 0 | 0 | moving | 13.122
798 | 26.600 | red | red | none | none | none | none | 0 |  |  |  | 0 | 0 | moving | 12.978
801 | 26.700 | red | red | none | none | none | none | 0 |  |  |  | 0 | 0 | moving | 11.097
804 | 26.800 | red | red | none | red | red | none | 2 | red:straight:1874:508:1920:566;red:unknown:1890:562:1920:574 |  |  | 0 | 0 | moving | 11.097
807 | 26.900 | red | red | none | red | red | none | 2 | red:unknown:1902:493:1920:532;red:unknown:1358:590:1388:648 |  |  | 0 | 0 | moving | 11.097
810 | 27.000 | red | red | none | red | red | none | 1 | red:unknown:1363:590:1388:648 |  |  | 0 | 0 | moving | 11.261
813 | 27.100 | red | red | none | none | none | none | 0 |  |  |  | 0 | 0 | moving | 13.052
816 | 27.200 | red | red | none | none | none | none | 0 |  |  |  | 0 | 0 | moving | 16.525
819 | 27.300 | red | red | none | yellow | yellow | none | 3 | red:unknown:1361:618:1374:648;yellow:round:1202:616:1218:648;yellow:unknown:1362:628:1370:646 |  |  | 0 | 0 | moving | 13.052
822 | 27.400 | red | red | none | yellow | yellow | none | 2 | red:round:1358:628:1370:648;yellow:round:1196:624:1210:648 |  |  | 0 | 0 | moving | 14.146
825 | 27.500 | yellow | yellow | none | yellow | yellow | none | 2 | red:round:1356:638:1368:648;yellow:round:1192:632:1208:648 |  |  | 0 | 0 | moving | 13.052
828 | 27.600 | yellow | yellow | none | yellow | yellow | none | 1 | yellow:round:1190:638:1204:648 |  |  | 0 | 0 | moving | 11.931
831 | 27.700 | yellow | yellow | none | yellow | yellow | none | 1 | yellow:unknown:1196:639:1208:648 |  |  | 0 | 0 | moving | 10.250
834 | 27.800 | yellow | yellow | none | yellow | yellow | none | 1 | yellow:unknown:1206:640:1216:648 |  |  | 0 | 0 | moving | 10.246
837 | 27.900 | yellow | yellow | none | none | none | none | 0 |  |  |  | 0 | 0 | moving | 10.246
840 | 28.000 | yellow | yellow | none | yellow | yellow | none | 1 | yellow:unknown:1234:640:1246:648 |  |  | 0 | 0 | moving | 10.246
843 | 28.100 | yellow | yellow | none | yellow | yellow | none | 1 | yellow:unknown:1248:639:1261:648 |  |  | 0 | 0 | moving | 10.932
846 | 28.200 | yellow | yellow | none | yellow | yellow | none | 2 | red:unknown:1456:640:1470:648;yellow:round:1260:634:1278:648 |  |  | 0 | 0 | moving | 10.970
849 | 28.300 | yellow | yellow | none | yellow | yellow | none | 3 | red:round:1481:636:1496:648;yellow:round:1280:629:1296:648;yellow:left:1484:632:1496:646 |  |  | 0 | 0 | moving | 12.311
852 | 28.400 | yellow | yellow | none | yellow | yellow | none | 3 | red:round:1510:628:1525:648;yellow:round:1300:622:1318:648;yellow:unknown:1512:625:1520:634 |  |  | 0 | 0 | moving | 13.189
855 | 28.500 | yellow | yellow | none | yellow | yellow | none | 2 | red:round:1544:618:1560:648;yellow:round:1330:612:1346:648 |  |  | 0 | 0 | moving | 13.189
858 | 28.600 | yellow | yellow | none | yellow | yellow | none | 1 | yellow:round:1358:598:1382:648 |  |  | 0 | 0 | moving | 15.055
861 | 28.700 | yellow | yellow | none | yellow | yellow | none | 2 | yellow:round:1392:588:1416:648;green:round:1502:606:1512:616 |  |  | 0 | 0 | moving | 16.046
864 | 28.800 | yellow | yellow | none | none | green | none | 1 | green:straight:684:356:702:376 |  |  | 0 | 0 | moving | 17.333
867 | 28.900 | yellow | yellow | none | none | none | none | 0 |  |  |  | 0 | 0 | moving | 17.513
870 | 29.000 | yellow | yellow | none | none | none | none | 0 |  |  |  | 0 | 0 | moving | 17.661
873 | 29.100 | yellow | yellow | none | none | none | yellow | 1 | yellow:right:1848:552:1860:562 |  |  | 0 | 0 | moving | 18.523
876 | 29.200 | yellow | yellow | none | none | none | none | 0 |  |  |  | 0 | 0 | moving | 18.523
879 | 29.300 | yellow | yellow | none | red | red | none | 1 | red:unknown:1912:636:1920:648 |  |  | 0 | 0 | moving | 18.523
882 | 29.400 | yellow | yellow | none | none | none | none | 0 |  |  |  | 0 | 0 | moving | 18.208
885 | 29.500 | yellow | yellow | none | none | none | none | 0 |  |  |  | 0 | 0 | moving | 18.208
888 | 29.600 | yellow | yellow | none | none | none | none | 0 |  |  |  | 0 | 0 | moving | 17.889
891 | 29.700 | yellow | yellow | none | green | green | none | 1 | green:unknown:736:401:753:428 |  |  | 0 | 0 | moving | 16.746
894 | 29.800 | yellow | yellow | none | yellow | yellow | none | 1 | yellow:unknown:144:584:160:592 |  |  | 0 | 0 | moving | 13.864
897 | 29.900 | yellow | yellow | none | yellow | yellow | none | 1 | yellow:unknown:124:578:138:586 |  |  | 0 | 0 | moving | 13.198
900 | 30.000 | yellow | yellow | none | none | none | none | 0 |  |  |  | 0 | 0 | moving | 12.090
903 | 30.100 | yellow | yellow | none | none | none | none | 0 |  |  |  | 0 | 0 | moving | 12.090
906 | 30.200 | yellow | yellow | none | green | green | none | 1 | green:unknown:738:412:746:424 |  |  | 0 | 0 | moving | 11.722
909 | 30.300 | yellow | yellow | none | green | green | none | 1 | green:unknown:697:304:705:312 |  |  | 0 | 0 | moving | 11.551
912 | 30.400 | green | green | none | green | green | none | 1 | green:unknown:600:312:613:320 |  |  | 0 | 0 | moving | 12.090
915 | 30.500 | green | green | none | none | none | none | 0 |  |  |  | 0 | 0 | moving | 12.484
918 | 30.600 | green | green | none | none | none | none | 0 |  |  |  | 0 | 0 | moving | 11.551
921 | 30.700 | green | green | none | green | green | none | 1 | green:unknown:522:306:538:318 |  |  | 0 | 0 | moving | 11.551
924 | 30.800 | green | green | none | none | none | none | 0 |  |  |  | 0 | 0 | moving | 11.135
927 | 30.900 | green | green | none | none | none | none | 0 |  |  |  | 0 | 0 | moving | 10.352
930 | 31.000 | green | green | none | none | none | none | 0 |  |  |  | 0 | 0 | moving | 9.693
933 | 31.100 | green | green | none | green | green | none | 1 | green:round:464:314:478:326 |  |  | 0 | 0 | moving | 9.693
936 | 31.200 | green | green | none | green | green | none | 1 | green:unknown:432:316:447:330 |  |  | 0 | 0 | moving | 9.693
939 | 31.300 | green | green | none | none | none | none | 0 |  |  |  | 0 | 0 | moving | 11.039
942 | 31.400 | green | green | none | green | green | none | 1 | green:unknown:1524:524:1544:534 |  |  | 0 | 0 | moving | 12.162
945 | 31.500 | green | green | none | none | none | none | 0 |  |  |  | 0 | 0 | moving | 13.786
948 | 31.600 | green | green | none | none | none | none | 0 |  |  |  | 0 | 0 | moving | 14.695
951 | 31.700 | green | green | none | green | none | none | 1 | green:left:388:294:405:306 |  |  | 0 | 0 | moving | 15.317
954 | 31.800 | green | green | none | green | green | none | 1 | green:unknown:369:262:394:274 |  |  | 0 | 0 | moving | 15.413
957 | 31.900 | green | green | none | none | none | none | 0 |  |  |  | 0 | 0 | moving | 15.829
960 | 32.000 | green | green | none | green | green | none | 2 | green:unknown:416:262:424:278;green:unknown:338:298:352:306 |  |  | 0 | 0 | moving | 15.829
963 | 32.100 | green | green | none | none | none | none | 0 |  |  |  | 0 | 0 | moving | 15.829
966 | 32.200 | green | green | none | none | none | none | 0 |  |  |  | 0 | 0 | moving | 15.413
969 | 32.300 | green | green | none | none | none | none | 0 |  |  |  | 0 | 0 | moving | 15.273
972 | 32.400 | green | green | none | green | green | none | 1 | green:unknown:360:242:371:269 |  |  | 0 | 0 | moving | 15.273
975 | 32.500 | green | green | none | green | green | none | 1 | green:unknown:384:260:392:270 |  |  | 0 | 0 | moving | 14.841
978 | 32.600 | green | green | none | green | green | none | 1 | green:unknown:1841:356:1850:364 |  |  | 0 | 0 | moving | 14.431
981 | 32.700 | green | green | none | none | none | none | 0 |  |  |  | 0 | 0 | moving | 14.413
984 | 32.800 | green | green | none | none | none | none | 0 |  |  |  | 0 | 0 | moving | 14.431
987 | 32.900 | green | green | none | green | green | none | 1 | green:unknown:224:338:242:348 |  |  | 0 | 0 | moving | 14.431
990 | 33.000 | green | green | none | none | none | none | 0 |  |  |  | 0 | 0 | moving | 13.896
993 | 33.100 | green | green | none | green | green | none | 2 | green:round:152:322:162:332;green:unknown:200:338:208:352 |  |  | 0 | 0 | moving | 13.755
996 | 33.200 | green | green | none | none | none | none | 0 |  |  |  | 0 | 0 | moving | 13.346
999 | 33.300 | green | green | none | green | green | none | 2 | green:unknown:313:232:338:246;green:unknown:288:248:296:256 |  |  | 0 | 0 | moving | 13.346
1002 | 33.400 | green | green | none | none | none | none | 0 |  |  |  | 0 | 0 | moving | 13.346
1005 | 33.500 | green | green | none | none | none | none | 0 |  |  |  | 0 | 0 | moving | 13.477
1008 | 33.600 | green | green | none | none | none | none | 0 |  |  |  | 0 | 0 | moving | 13.477
1011 | 33.700 | green | green | none | green | green | none | 1 | green:round:314:242:324:254 |  |  | 0 | 0 | moving | 13.477
1014 | 33.800 | green | green | none | none | none | none | 0 |  |  |  | 0 | 0 | moving | 12.469
1017 | 33.900 | green | green | none | green | green | none | 1 | green:unknown:272:202:288:220 |  |  | 0 | 0 | moving | 11.762
1020 | 34.000 | green | green | none | none | none | none | 0 |  |  |  | 0 | 0 | moving | 11.762
1023 | 34.100 | green | green | none | none | none | none | 0 |  |  |  | 0 | 0 | moving | 11.762
1026 | 34.200 | green | green | none | green | green | none | 1 | green:unknown:236:224:264:240 |  |  | 0 | 0 | moving | 11.762
1029 | 34.300 | green | green | none | none | none | none | 0 |  |  |  | 0 | 0 | moving | 12.072
1032 | 34.400 | green | green | none | green | green | none | 2 | green:unknown:324:226:333:238;green:left:283:229:302:246 |  |  | 0 | 0 | moving | 12.485
1035 | 34.500 | green | green | none | green | green | none | 1 | green:unknown:235:183:243:192 |  |  | 0 | 0 | moving | 12.485
1038 | 34.600 | green | green | none | green | green | none | 1 | green:unknown:148:265:156:280 |  |  | 0 | 0 | moving | 12.649
1041 | 34.700 | green | green | none | green | none | none | 1 | green:left:256:176:270:190 |  |  | 0 | 0 | moving | 13.139
1044 | 34.800 | green | green | none | green | green | none | 1 | green:unknown:458:212:469:220 |  |  | 0 | 0 | moving | 14.426
1047 | 34.900 | green | green | none | none | none | none | 0 |  |  |  | 0 | 0 | moving | 15.593
1050 | 35.000 | green | green | none | none | green | none | 1 | green:straight:162:234:172:245 |  |  | 0 | 0 | moving | 16.628
1053 | 35.100 | green | green | none | none | none | none | 0 |  |  |  | 0 | 0 | moving | 16.884
1056 | 35.200 | green | green | none | none | none | green | 1 | green:right:252:174:264:186 |  |  | 0 | 0 | moving | 16.884
1059 | 35.300 | green | green | none | none | none | none | 0 |  |  |  | 0 | 0 | moving | 16.884
1062 | 35.400 | green | green | none | none | none | none | 0 |  |  |  | 0 | 0 | moving | 16.884
1065 | 35.500 | green | green | none | none | none | none | 0 |  |  |  | 0 | 0 | moving | 16.343
1068 | 35.600 | green | green | none | none | none | none | 0 |  |  |  | 0 | 0 | moving | 16.143
1071 | 35.700 | green | green | none | none | none | none | 0 |  |  |  | 0 | 0 | moving | 16.143
1074 | 35.800 | green | green | none | green | green | none | 1 | green:unknown:410:434:424:443 |  |  | 0 | 0 | moving | 14.555
1077 | 35.900 | green | green | none | none | none | none | 0 |  |  |  | 0 | 0 | moving | 13.614
1080 | 36.000 | green | green | none | none | none | none | 0 |  |  |  | 0 | 0 | moving | 12.107
1083 | 36.100 | green | green | none | none | none | none | 0 |  |  |  | 0 | 0 | moving | 11.614
1086 | 36.200 | green | green | none | none | none | none | 0 |  |  |  | 0 | 0 | moving | 11.542
1089 | 36.300 | green | green | none | green | green | none | 2 | green:unknown:1075:612:1084:621;green:round:1166:614:1176:626 |  |  | 0 | 0 | moving | 11.542
1092 | 36.400 | green | green | none | green | none | none | 1 | green:left:1072:610:1082:624 |  |  | 0 | 0 | moving | 11.290
1095 | 36.500 | green | green | none | green | green | none | 1 | green:unknown:356:412:370:421 |  |  | 0 | 0 | moving | 11.217
1098 | 36.600 | green | green | none | green | green | none | 1 | green:unknown:350:410:361:418 |  |  | 0 | 0 | moving | 11.217
1101 | 36.700 | green | green | none | green | green | none | 2 | green:straight:1070:600:1080:610;green:round:1170:602:1180:612 |  |  | 0 | 0 | moving | 11.217
1104 | 36.800 | green | green | none | green | green | none | 1 | green:round:1170:600:1181:612 |  |  | 0 | 0 | moving | 11.245
1107 | 36.900 | green | green | none | green | green | none | 2 | green:left:1068:594:1080:605;green:round:1172:598:1182:608 |  |  | 0 | 0 | moving | 12.365
1110 | 37.000 | green | green | none | green | green | none | 1 | green:unknown:304:394:322:404 |  |  | 0 | 0 | moving | 12.365
1113 | 37.100 | green | green | none | green | green | none | 1 | green:round:1170:591:1182:602 |  |  | 0 | 0 | moving | 12.365
1116 | 37.200 | green | green | none | green | green | none | 1 | green:unknown:1167:588:1176:599 |  |  | 0 | 0 | moving | 11.502
1119 | 37.300 | green | green | none | green | green | none | 2 | green:unknown:1052:581:1061:590;green:unknown:1166:584:1175:594 |  |  | 0 | 0 | moving | 11.244
1122 | 37.400 | green | green | none | green | green | none | 2 | green:unknown:1048:576:1057:586;green:unknown:1165:580:1174:589 |  |  | 0 | 0 | moving | 11.244
1125 | 37.500 | green | green | none | green | green | none | 1 | green:unknown:197:359:214:368 |  |  | 0 | 0 | moving | 11.244
1128 | 37.600 | green | green | none | green | green | none | 2 | green:unknown:1038:567:1048:576;green:unknown:1161:568:1170:580 |  |  | 0 | 0 | moving | 11.348
1131 | 37.700 | green | green | none | green | green | none | 2 | green:unknown:1035:563:1044:573;green:unknown:1161:565:1170:576 |  |  | 0 | 0 | moving | 11.454
1134 | 37.800 | green | green | none | green | green | none | 2 | green:unknown:1034:559:1043:569;green:round:1162:561:1173:572 |  |  | 0 | 0 | moving | 11.778
1137 | 37.900 | green | green | none | green | green | none | 2 | green:round:1035:552:1045:563;green:round:1167:555:1177:566 |  |  | 0 | 0 | moving | 11.785
1140 | 38.000 | green | green | none | none | green | none | 1 | green:straight:162:356:176:366 |  |  | 0 | 0 | moving | 12.310
1143 | 38.100 | green | green | none | green | green | none | 1 | green:unknown:152:350:168:361 |  |  | 0 | 0 | moving | 12.506
1146 | 38.200 | green | green | none | green | green | none | 1 | green:unknown:322:108:380:140 |  |  | 0 | 0 | moving | 12.604
1149 | 38.300 | green | green | none | green | green | none | 1 | green:unknown:312:104:374:135 |  |  | 0 | 0 | moving | 12.614
1152 | 38.400 | green | green | none | green | green | none | 1 | green:unknown:309:98:364:128 |  |  | 0 | 0 | moving | 13.241
1155 | 38.500 | green | green | none | green | green | none | 1 | green:unknown:300:94:362:132 |  |  | 0 | 0 | moving | 14.003
1158 | 38.600 | green | green | none | green | green | none | 1 | green:unknown:292:86:352:116 |  |  | 0 | 0 | moving | 14.706
1161 | 38.700 | green | green | none | green | green | none | 1 | green:unknown:286:82:344:115 |  |  | 0 | 0 | moving | 14.706
1164 | 38.800 | green | green | none | green | green | none | 1 | green:unknown:266:76:334:110 |  |  | 0 | 0 | moving | 14.706
1167 | 38.900 | green | green | none | green | green | none | 1 | green:unknown:258:74:328:112 |  |  | 0 | 0 | moving | 14.706
1170 | 39.000 | green | green | none | green | green | none | 1 | green:unknown:254:70:326:110 |  |  | 0 | 0 | moving | 14.706
1173 | 39.100 | green | green | none | green | green | none | 1 | green:unknown:254:66:326:106 |  |  | 0 | 0 | moving | 14.216
1176 | 39.200 | green | green | none | green | green | none | 1 | green:unknown:256:62:328:102 |  |  | 0 | 0 | moving | 14.216
1179 | 39.300 | green | green | none | green | green | none | 1 | green:unknown:260:56:334:92 |  |  | 0 | 0 | moving | 13.397
1182 | 39.400 | green | green | none | green | green | none | 1 | green:unknown:266:48:340:90 |  |  | 0 | 0 | moving | 12.821
1185 | 39.500 | green | green | none | green | green | none | 1 | green:unknown:276:44:350:84 |  |  | 0 | 0 | moving | 10.519
1188 | 39.600 | green | green | none | green | green | none | 1 | green:unknown:292:42:364:75 |  |  | 0 | 0 | moving | 10.519
1191 | 39.700 | green | green | none | green | green | none | 1 | green:unknown:318:40:378:73 |  |  | 0 | 0 | moving | 10.477
1194 | 39.800 | green | green | none | green | green | none | 1 | green:unknown:358:40:432:80 |  |  | 0 | 0 | moving | 9.307
1197 | 39.900 | green | green | none | green | green | none | 1 | green:unknown:418:42:492:77 |  |  | 0 | 0 | moving | 9.307
1200 | 40.000 | green | green | none | green | green | none | 1 | green:unknown:498:44:570:78 |  |  | 0 | 0 | moving | 9.611
1203 | 40.100 | green | green | none | green | green | none | 1 | green:unknown:602:46:672:80 |  |  | 0 | 0 | moving | 9.611
1206 | 40.200 | green | green | none | green | green | none | 1 | green:unknown:768:38:838:72 |  |  | 0 | 0 | moving | 10.367
1209 | 40.300 | green | green | none | green | green | none | 1 | green:unknown:782:281:801:290 |  |  | 0 | 0 | moving | 12.958
1212 | 40.400 | green | green | none | none | none | none | 0 |  |  |  | 0 | 0 | moving | 20.708
1215 | 40.500 | green | green | none | none | none | none | 0 |  |  |  | 0 | 0 | moving | 24.898
1218 | 40.600 | green | green | none | none | none | none | 0 |  |  |  | 0 | 0 | moving | 27.979
1221 | 40.700 | green | green | none | green | green | none | 1 | green:unknown:1907:209:1920:217 |  |  | 0 | 0 | moving | 27.979
1224 | 40.800 | green | green | none | red | red | none | 1 | red:round:1878:586:1888:602 |  |  | 0 | 0 | moving | 32.679
1227 | 40.900 | green | green | none | none | none | none | 0 |  |  |  | 0 | 0 | moving | 32.679
1230 | 41.000 | green | green | none | red | red | none | 1 | red:unknown:960:10:968:20 |  |  | 0 | 0 | moving | 32.679
1233 | 41.100 | green | green | none | none | none | red | 1 | red:right:992:622:1004:634 |  |  | 0 | 0 | moving | 38.165
1236 | 41.200 | red | red | none | red | red | none | 1 | red:round:212:304:244:363 |  |  | 0 | 0 | moving | 39.450
1239 | 41.300 | red | red | none | red | red | none | 1 | red:round:640:302:672:362 |  |  | 0 | 0 | moving | 43.359
1242 | 41.400 | red | red | none | red | red | none | 1 | red:round:1084:279:1116:342 |  |  | 0 | 0 | moving | 45.332
1245 | 41.500 | red | red | none | red | red | none | 1 | red:round:1572:245:1606:310 |  |  | 0 | 0 | moving | 45.395
1248 | 41.600 | red | red | none | green | green | none | 1 | green:unknown:66:625:88:641 |  |  | 0 | 0 | moving | 46.535
1251 | 41.700 | red | red | none | green | red | none | 2 | red:round:0:474:19:490;green:left:292:455:302:469 |  |  | 0 | 0 | moving | 46.535
1254 | 41.800 | red | red | none | red | red | none | 4 | red:round:177:478:193:494;red:round:195:480:230:496;red:round:358:485:391:502;red:round:394:487:426:502 |  |  | 0 | 0 | moving | 45.332
1257 | 41.900 | red | red | none | red | red | none | 5 | red:round:556:491:571:506;red:round:592:492:606:508;red:round:680:496:712:512;red:round:731:498:763:514;red:round:765:499:798:514 |  |  | 0 | 0 | moving | 40.028
1260 | 42.000 | red | red | none | none | none | none | 0 |  |  |  | 0 | 0 | moving | 36.192
1263 | 42.100 | red | red | none | red | red | none | 1 | red:round:1571:529:1585:544 |  |  | 0 | 0 | moving | 36.192
1266 | 42.200 | red | red | none | red | red | none | 2 | red:round:1542:518:1578:535;red:round:1579:520:1596:536 |  |  | 0 | 0 | moving | 36.192
1269 | 42.300 | red | red | none | red | red | none | 2 | red:round:1867:519:1884:536;red:round:1887:520:1905:536 |  |  | 0 | 0 | moving | 32.905
1272 | 42.400 | red | red | none | none | none | none | 0 |  |  |  | 0 | 0 | moving | 32.905
1275 | 42.500 | red | red | none | none | none | none | 0 |  |  |  | 0 | 0 | moving | 32.905
1278 | 42.600 | red | red | none | none | none | none | 0 |  |  |  | 0 | 0 | moving | 30.847
1281 | 42.700 | red | red | none | none | none | none | 0 |  |  |  | 0 | 0 | moving | 29.668
1284 | 42.800 | red | red | none | none | none | none | 0 |  |  |  | 0 | 0 | moving | 29.668
1287 | 42.900 | red | red | none | none | none | none | 0 |  |  |  | 0 | 0 | moving | 28.434
1290 | 43.000 | red | red | none | none | none | none | 0 |  |  |  | 0 | 0 | moving | 25.504
1293 | 43.100 | red | red | none | none | none | none | 0 |  |  |  | 0 | 0 | moving | 25.374
1296 | 43.200 | red | red | none | none | none | none | 0 |  |  |  | 0 | 0 | moving | 22.349
1299 | 43.300 | red | red | none | none | none | none | 0 |  |  |  | 0 | 0 | moving | 22.187
1302 | 43.400 | red | red | none | none | none | none | 0 |  |  |  | 0 | 0 | moving | 21.707
1305 | 43.500 | red | red | none | none | none | none | 0 |  |  |  | 0 | 0 | moving | 20.048
1308 | 43.600 | red | red | none | none | none | none | 0 |  |  |  | 0 | 0 | moving | 19.534
1311 | 43.700 | red | red | none | none | none | none | 0 |  |  |  | 0 | 0 | moving | 18.077
1314 | 43.800 | red | red | none | none | none | none | 0 |  |  |  | 0 | 0 | moving | 17.785
1317 | 43.900 | red | red | none | none | none | none | 0 |  |  |  | 0 | 0 | moving | 17.741
1320 | 44.000 | red | red | none | none | none | none | 0 |  |  |  | 0 | 0 | moving | 16.568
1323 | 44.100 | red | red | none | none | none | none | 0 |  |  |  | 0 | 0 | moving | 16.568
1326 | 44.200 | red | red | none | none | none | none | 0 |  |  |  | 0 | 0 | moving | 15.057
1329 | 44.300 | none | none | none | none | none | none | 0 |  |  |  | 0 | 0 | moving | 15.057
1332 | 44.400 | none | none | none | none | none | none | 0 |  |  |  | 0 | 0 | moving | 15.578
1335 | 44.500 | none | none | none | none | none | none | 0 |  |  |  | 0 | 0 | moving | 16.804
1338 | 44.600 | none | none | none | none | none | none | 0 |  |  |  | 0 | 0 | moving | 17.202
1341 | 44.700 | none | none | none | none | none | none | 0 |  |  |  | 0 | 0 | moving | 17.202
1344 | 44.800 | none | none | none | none | none | none | 0 |  |  |  | 0 | 0 | moving | 18.680
1347 | 44.900 | none | none | none | none | none | none | 0 |  |  |  | 0 | 0 | moving | 18.680
