Zdy-1110/FPGA-676/tools/adas/host_test/out/112739/states.csv

frame | t | sig_left | sig_straight | sig_right | raw_left | raw_straight | raw_right | n_lights | lights | left_line | right_line | left_cov | right_cov | ego_motion | motion_score
0 | 0.000 | none | none | none | none | none | none | 0 |  |  |  | 0 | 0 | moving | 0.000
3 | 0.100 | none | none | none | none | none | none | 0 |  |  |  | 0 | 0 | stopped | 5.295
6 | 0.200 | none | none | none | none | none | none | 0 |  |  |  | 0 | 0 | stopped | 6.525
9 | 0.300 | none | none | none | none | none | none | 0 |  |  |  | 0 | 0 | stopped | 7.754
12 | 0.400 | none | none | none | none | none | none | 0 |  |  |  | 0 | 0 | stopped | 8.844
15 | 0.500 | none | none | none | none | none | none | 0 |  |  |  | 0 | 0 | stopped | 9.933
18 | 0.600 | none | none | none | none | none | none | 0 |  |  |  | 0 | 0 | moving | 10.714
21 | 0.700 | none | none | none | none | none | none | 0 |  |  |  | 0 | 0 | moving | 10.714
24 | 0.800 | none | none | none | none | none | none | 0 |  |  |  | 0 | 0 | moving | 12.038
27 | 0.900 | none | none | none | none | none | none | 0 |  |  |  | 0 | 0 | moving | 12.038
30 | 1.000 | none | none | none | none | none | none | 0 |  |  |  | 0 | 0 | moving | 12.038
33 | 1.100 | none | none | none | none | none | none | 0 |  |  |  | 0 | 0 | moving | 11.255
36 | 1.200 | none | none | none | none | none | none | 0 |  |  |  | 0 | 0 | moving | 12.964
39 | 1.300 | none | none | none | none | none | none | 0 |  |  |  | 0 | 0 | moving | 11.255
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
177 | 5.900 | none | none | none | none | none | none | 0 |  |  |  | 0 | 0 | moving | 13.514
180 | 6.000 | none | none | none | none | none | none | 0 |  |  |  | 0 | 0 | moving | 13.514
183 | 6.100 | none | none | none | none | none | none | 0 |  |  |  | 0 | 0 | moving | 11.177
186 | 6.200 | none | none | none | none | none | none | 0 |  |  |  | 0 | 0 | moving | 13.514
189 | 6.300 | none | none | none | none | none | none | 0 |  |  |  | 0 | 0 | moving | 14.241
192 | 6.400 | none | none | none | none | none | none | 0 |  |  |  | 0 | 0 | moving | 14.241
195 | 6.500 | none | none | none | none | none | none | 0 |  |  |  | 0 | 0 | moving | 14.662
198 | 6.600 | none | none | none | none | none | none | 0 |  |  |  | 0 | 0 | moving | 14.662
201 | 6.700 | none | none | none | none | none | none | 0 |  |  |  | 0 | 0 | moving | 14.662
204 | 6.800 | none | none | none | none | none | none | 0 |  |  |  | 0 | 0 | moving | 10.776
207 | 6.900 | none | none | none | none | none | none | 0 |  |  |  | 0 | 0 | moving | 10.776
210 | 7.000 | none | none | none | none | none | none | 0 |  |  |  | 0 | 0 | moving | 10.776
213 | 7.100 | none | none | none | none | none | none | 0 |  |  |  | 0 | 0 | moving | 10.776
216 | 7.200 | none | none | none | none | none | none | 0 |  |  |  | 0 | 0 | moving | 10.918
219 | 7.300 | none | none | none | none | none | none | 0 |  |  |  | 0 | 0 | moving | 11.249
222 | 7.400 | none | none | none | none | none | none | 0 |  |  |  | 0 | 0 | moving | 16.550
225 | 7.500 | none | none | none | green | green | none | 1 | green:unknown:1572:472:1594:482 |  |  | 0 | 0 | moving | 19.340
228 | 7.600 | none | none | none | green | green | none | 1 | green:unknown:854:396:862:404 |  |  | 0 | 0 | moving | 19.340
231 | 7.700 | none | none | none | none | none | none | 0 |  |  |  | 0 | 0 | moving | 19.340
234 | 7.800 | none | none | none | none | none | none | 0 |  |  |  | 0 | 0 | moving | 13.959
237 | 7.900 | none | none | none | none | none | none | 0 |  |  |  | 0 | 0 | moving | 13.870
240 | 8.000 | none | none | none | none | none | none | 0 |  |  |  | 0 | 0 | moving | 12.987
243 | 8.100 | green | green | none | green | green | none | 1 | green:unknown:800:376:808:384 |  |  | 0 | 0 | moving | 12.987
246 | 8.200 | green | green | none | none | none | none | 0 |  |  |  | 0 | 0 | moving | 12.987
249 | 8.300 | green | green | none | green | green | none | 1 | green:unknown:840:382:848:390 |  |  | 0 | 0 | moving | 12.987
252 | 8.400 | green | green | none | none | none | none | 0 |  |  |  | 0 | 0 | moving | 12.635
255 | 8.500 | green | green | none | none | none | none | 0 |  |  |  | 0 | 0 | moving | 12.635
258 | 8.600 | green | green | none | none | none | none | 0 |  |  |  | 0 | 0 | moving | 12.635
261 | 8.700 | green | green | none | none | none | none | 0 |  |  |  | 0 | 0 | moving | 16.712
264 | 8.800 | green | green | none | none | none | none | 0 |  |  |  | 0 | 0 | moving | 10.476
267 | 8.900 | green | green | none | green | green | none | 1 | green:unknown:826:380:834:390 |  |  | 0 | 0 | moving | 10.882
270 | 9.000 | green | green | none | none | none | none | 0 |  |  |  | 0 | 0 | moving | 10.882
273 | 9.100 | green | green | none | none | none | none | 0 |  |  |  | 0 | 0 | moving | 10.475
276 | 9.200 | green | green | none | none | none | none | 0 |  |  |  | 0 | 0 | moving | 8.775
279 | 9.300 | green | green | none | green | none | none | 1 | green:left:821:374:831:386 |  |  | 0 | 0 | moving | 8.775
282 | 9.400 | green | green | none | green | green | none | 1 | green:unknown:821:374:831:383 |  |  | 0 | 0 | moving | 8.775
285 | 9.500 | green | green | none | none | none | none | 0 |  |  |  | 0 | 0 | moving | 8.331
288 | 9.600 | green | green | none | none | none | none | 0 |  |  |  | 0 | 0 | moving | 8.331
291 | 9.700 | green | green | none | none | none | none | 0 |  |  |  | 0 | 0 | moving | 8.246
294 | 9.800 | green | green | none | green | green | none | 1 | green:unknown:822:371:832:379 |  |  | 0 | 0 | moving | 8.777
297 | 9.900 | green | green | none | none | none | none | 0 |  |  |  | 0 | 0 | moving | 8.058
300 | 10.000 | green | green | none | none | none | none | 0 |  |  |  | 0 | 0 | moving | 8.058
303 | 10.100 | green | green | none | green | green | none | 1 | green:unknown:825:370:833:380 |  |  | 0 | 0 | moving | 7.924
306 | 10.200 | green | green | none | green | green | none | 2 | green:unknown:759:366:767:374;green:unknown:827:370:835:378 |  |  | 0 | 0 | moving | 8.058
309 | 10.300 | green | green | none | green | green | none | 2 | green:unknown:759:366:767:374;green:unknown:829:370:840:378 |  |  | 0 | 0 | moving | 8.058
312 | 10.400 | green | green | none | green | green | none | 2 | green:unknown:758:364:766:372;green:unknown:830:368:838:376 |  |  | 0 | 0 | moving | 7.924
315 | 10.500 | green | green | none | green | green | none | 2 | green:unknown:757:361:765:369;green:unknown:831:365:840:374 |  |  | 0 | 0 | moving | 7.924
318 | 10.600 | green | green | none | green | green | none | 2 | green:unknown:755:358:764:370;green:unknown:832:363:841:372 |  |  | 0 | 0 | moving | 8.526
321 | 10.700 | green | green | none | green | green | none | 2 | green:unknown:754:356:763:365;green:unknown:833:360:842:370 |  |  | 0 | 0 | moving | 8.526
324 | 10.800 | green | green | none | green | green | none | 2 | green:unknown:751:353:761:362;green:unknown:833:358:843:367 |  |  | 0 | 0 | moving | 8.638
327 | 10.900 | green | green | none | green | green | none | 2 | green:unknown:749:347:758:357;green:round:833:352:843:362 |  |  | 0 | 0 | moving | 10.164
330 | 11.000 | green | green | none | green | green | none | 2 | green:round:746:341:756:351;green:round:834:346:844:356 |  |  | 0 | 0 | moving | 11.230
333 | 11.100 | green | green | none | green | green | none | 2 | green:round:744:336:754:346;green:round:835:341:845:351 |  |  | 0 | 0 | moving | 11.230
336 | 11.200 | green | green | none | green | green | none | 2 | green:round:741:329:752:340;green:round:836:334:846:345 |  |  | 0 | 0 | moving | 10.164
339 | 11.300 | green | green | none | green | green | none | 2 | green:round:738:322:749:333;green:round:836:327:847:338 |  |  | 0 | 0 | moving | 11.354
342 | 11.400 | green | green | none | green | green | none | 2 | green:round:735:316:747:327;green:round:838:322:849:333 |  |  | 0 | 0 | moving | 11.354
345 | 11.500 | green | green | none | green | green | none | 2 | green:round:735:312:746:323;green:round:841:318:852:330 |  |  | 0 | 0 | moving | 10.112
348 | 11.600 | green | green | none | green | green | none | 2 | green:round:733:307:745:319;green:round:843:314:855:326 |  |  | 0 | 0 | moving | 10.943
351 | 11.700 | green | green | none | green | green | none | 2 | green:round:730:299:743:312;green:round:845:306:858:319 |  |  | 0 | 0 | moving | 11.271
354 | 11.800 | green | green | none | green | green | none | 2 | green:round:727:290:741:304;green:round:847:298:860:311 |  |  | 0 | 0 | moving | 10.943
357 | 11.900 | green | green | none | green | green | none | 2 | green:round:725:283:739:297;green:round:850:291:864:305 |  |  | 0 | 0 | moving | 10.943
360 | 12.000 | green | green | none | green | green | none | 2 | green:round:723:275:738:290;green:round:853:284:868:298 |  |  | 0 | 0 | moving | 11.067
363 | 12.100 | green | green | none | green | green | none | 2 | green:round:721:266:736:282;green:round:857:276:872:291 |  |  | 0 | 0 | moving | 11.067
366 | 12.200 | green | green | none | green | green | none | 2 | green:round:718:256:734:272;green:round:861:266:877:282 |  |  | 0 | 0 | moving | 11.057
369 | 12.300 | green | green | none | green | green | none | 2 | green:round:715:244:732:261;green:round:865:254:882:271 |  |  | 0 | 0 | moving | 11.067
372 | 12.400 | green | green | none | green | green | none | 2 | green:round:712:232:730:249;green:round:870:242:888:260 |  |  | 0 | 0 | moving | 11.057
375 | 12.500 | green | green | none | green | green | none | 2 | green:round:708:216:728:235;green:round:876:228:895:247 |  |  | 0 | 0 | moving | 9.882
378 | 12.600 | green | green | none | green | green | none | 2 | green:round:705:199:726:219;green:round:883:211:904:232 |  |  | 0 | 0 | moving | 11.057
381 | 12.700 | green | green | none | green | green | none | 2 | green:round:701:181:723:203;green:round:890:195:912:216 |  |  | 0 | 0 | moving | 11.426
384 | 12.800 | green | green | none | green | green | none | 2 | green:round:697:162:721:186;green:round:900:177:923:200 |  |  | 0 | 0 | moving | 11.204
387 | 12.900 | green | green | none | green | green | none | 2 | green:round:693:140:718:165;green:round:911:156:936:181 |  |  | 0 | 0 | moving | 11.426
390 | 13.000 | green | green | none | green | green | none | 2 | green:round:685:112:712:138;green:round:922:130:949:157 |  |  | 0 | 0 | moving | 14.989
393 | 13.100 | green | green | none | green | green | none | 1 | green:round:677:78:707:107 |  |  | 0 | 0 | moving | 14.989
396 | 13.200 | green | green | none | none | none | none | 0 |  |  |  | 0 | 0 | moving | 14.989
399 | 13.300 | green | green | none | none | none | none | 0 |  |  |  | 0 | 0 | moving | 18.837
402 | 13.400 | green | green | none | none | none | none | 0 |  |  |  | 0 | 0 | moving | 14.989
405 | 13.500 | green | green | none | none | none | none | 0 |  |  |  | 0 | 0 | moving | 13.391
408 | 13.600 | green | green | none | none | none | none | 0 |  |  |  | 0 | 0 | moving | 9.978
411 | 13.700 | green | green | none | none | none | none | 0 |  |  |  | 0 | 0 | moving | 9.978
414 | 13.800 | green | green | none | none | none | none | 0 |  |  |  | 0 | 0 | moving | 9.103
417 | 13.900 | green | green | none | none | none | none | 0 |  |  |  | 0 | 0 | moving | 8.499
420 | 14.000 | green | green | none | none | none | none | 0 |  |  |  | 0 | 0 | moving | 8.499
423 | 14.100 | green | green | none | none | none | none | 0 |  |  |  | 0 | 0 | moving | 9.744
426 | 14.200 | green | green | none | none | none | none | 0 |  |  |  | 0 | 0 | moving | 9.744
429 | 14.300 | green | green | none | none | none | none | 0 |  |  |  | 0 | 0 | moving | 10.578
432 | 14.400 | green | green | none | none | none | none | 0 |  |  |  | 0 | 0 | moving | 11.206
435 | 14.500 | green | green | none | none | none | none | 0 |  |  |  | 0 | 0 | moving | 11.206
438 | 14.600 | green | green | none | none | none | none | 0 |  |  |  | 0 | 0 | moving | 10.578
441 | 14.700 | green | green | none | none | none | none | 0 |  |  |  | 0 | 0 | moving | 10.578
444 | 14.800 | green | green | none | none | none | none | 0 |  |  |  | 0 | 0 | moving | 8.941
447 | 14.900 | green | green | none | red | red | none | 1 | red:round:1578:206:1661:262 |  |  | 0 | 0 | moving | 8.941
450 | 15.000 | green | green | none | red | red | none | 1 | red:round:1689:175:1782:237 |  |  | 0 | 0 | moving | 11.793
453 | 15.100 | red | red | none | red | red | none | 1 | red:round:1840:127:1920:190 |  |  | 0 | 0 | moving | 13.334
456 | 15.200 | red | red | none | none | none | none | 0 |  |  |  | 0 | 0 | moving | 11.793
459 | 15.300 | red | red | none | red | red | none | 1 | red:unknown:28:412:40:421 |  |  | 0 | 0 | moving | 11.793
462 | 15.400 | red | red | none | none | none | none | 0 |  |  |  | 0 | 0 | moving | 11.317
465 | 15.500 | red | red | none | yellow | yellow | none | 1 | yellow:round:1862:525:1920:554 |  |  | 0 | 0 | moving | 11.317
468 | 15.600 | red | red | none | none | none | none | 0 |  |  |  | 0 | 0 | moving | 10.095
471 | 15.700 | red | red | none | none | none | none | 0 |  |  |  | 0 | 0 | moving | 10.095
474 | 15.800 | red | red | none | none | none | none | 0 |  |  |  | 0 | 0 | moving | 10.123
477 | 15.900 | red | red | none | none | none | none | 0 |  |  |  | 0 | 0 | moving | 10.123
480 | 16.000 | red | red | none | none | none | none | 0 |  |  |  | 0 | 0 | moving | 10.123
483 | 16.100 | red | red | none | none | none | none | 0 |  |  |  | 0 | 0 | moving | 10.123
486 | 16.200 | red | red | none | none | none | none | 0 |  |  |  | 0 | 0 | moving | 10.455
489 | 16.300 | red | red | none | none | none | none | 0 |  |  |  | 0 | 0 | moving | 10.537
492 | 16.400 | red | red | none | none | none | none | 0 |  |  |  | 0 | 0 | moving | 14.146
495 | 16.500 | red | red | none | none | none | none | 0 |  |  |  | 0 | 0 | moving | 14.146
498 | 16.600 | red | red | none | none | none | none | 0 |  |  |  | 0 | 0 | moving | 14.933
501 | 16.700 | red | red | none | none | none | none | 0 |  |  |  | 0 | 0 | moving | 15.520
504 | 16.800 | red | red | none | none | none | none | 0 |  |  |  | 0 | 0 | moving | 19.580
507 | 16.900 | red | red | none | none | none | none | 0 |  |  |  | 0 | 0 | moving | 19.580
510 | 17.000 | red | red | none | none | none | none | 0 |  |  |  | 0 | 0 | moving | 19.580
513 | 17.100 | red | red | none | green | green | none | 1 | green:unknown:1850:564:1864:576 |  |  | 0 | 0 | moving | 16.476
516 | 17.200 | red | red | none | none | none | none | 0 |  |  |  | 0 | 0 | moving | 15.403
519 | 17.300 | red | red | none | none | none | none | 0 |  |  |  | 0 | 0 | moving | 15.403
522 | 17.400 | red | red | none | none | none | none | 0 |  |  |  | 0 | 0 | moving | 13.910
525 | 17.500 | red | red | none | none | none | none | 0 |  |  |  | 0 | 0 | moving | 13.910
528 | 17.600 | red | red | none | none | none | none | 0 |  |  |  | 0 | 0 | moving | 13.910
531 | 17.700 | red | red | none | none | none | none | 0 |  |  |  | 0 | 0 | moving | 11.690
534 | 17.800 | red | red | none | none | none | none | 0 |  |  |  | 0 | 0 | moving | 11.137
537 | 17.900 | red | red | none | yellow | yellow | none | 1 | yellow:unknown:1847:553:1892:574 |  |  | 0 | 0 | moving | 10.348
540 | 18.000 | red | red | none | none | none | none | 0 |  |  |  | 0 | 0 | moving | 9.853
543 | 18.100 | red | red | none | none | none | none | 0 |  |  |  | 0 | 0 | moving | 9.853
546 | 18.200 | red | red | none | none | none | none | 0 |  |  |  | 0 | 0 | moving | 9.040
549 | 18.300 | red | red | none | none | none | none | 0 |  |  |  | 0 | 0 | moving | 9.853
552 | 18.400 | red | red | none | none | none | none | 0 |  |  |  | 0 | 0 | moving | 9.853
555 | 18.500 | red | red | none | none | none | none | 0 |  |  |  | 0 | 0 | moving | 10.114
558 | 18.600 | red | red | none | none | none | none | 0 |  |  |  | 0 | 0 | moving | 10.114
561 | 18.700 | red | red | none | none | none | none | 0 |  |  |  | 0 | 0 | moving | 10.630
564 | 18.800 | red | red | none | none | none | none | 0 |  |  |  | 0 | 0 | moving | 10.630
567 | 18.900 | red | red | none | none | none | none | 0 |  |  |  | 0 | 0 | moving | 10.630
570 | 19.000 | red | red | none | none | none | none | 0 |  |  |  | 0 | 0 | moving | 10.630
573 | 19.100 | red | red | none | none | none | none | 0 |  |  |  | 0 | 0 | moving | 10.414
576 | 19.200 | red | red | none | none | none | none | 0 |  |  |  | 0 | 0 | moving | 10.414
579 | 19.300 | red | red | none | none | none | none | 0 |  |  |  | 0 | 0 | moving | 10.243
582 | 19.400 | red | red | none | yellow | yellow | none | 1 | yellow:unknown:1850:570:1886:585 |  |  | 0 | 0 | moving | 10.243
585 | 19.500 | red | red | none | none | none | none | 0 |  |  |  | 0 | 0 | moving | 9.043
588 | 19.600 | red | red | none | none | none | none | 0 |  |  |  | 0 | 0 | moving | 9.043
591 | 19.700 | red | red | none | none | none | none | 0 |  |  |  | 0 | 0 | moving | 9.043
594 | 19.800 | red | red | none | none | none | none | 0 |  |  |  | 0 | 0 | moving | 9.227
597 | 19.900 | yellow | yellow | none | yellow | yellow | none | 1 | yellow:unknown:1890:592:1906:601 |  |  | 0 | 0 | moving | 9.775
600 | 20.000 | yellow | yellow | none | none | none | none | 0 |  |  |  | 0 | 0 | moving | 9.775
603 | 20.100 | yellow | yellow | none | none | none | none | 0 |  |  |  | 0 | 0 | moving | 9.775
606 | 20.200 | yellow | yellow | none | none | none | none | 0 |  |  |  | 0 | 0 | moving | 11.760
609 | 20.300 | yellow | yellow | none | none | none | none | 0 |  |  |  | 0 | 0 | moving | 11.952
612 | 20.400 | yellow | yellow | none | red | red | none | 1 | red:unknown:850:538:858:546 |  |  | 0 | 0 | moving | 10.331
615 | 20.500 | yellow | yellow | none | green | green | none | 1 | green:unknown:1860:613:1871:622 |  |  | 0 | 0 | moving | 11.952
618 | 20.600 | yellow | yellow | none | none | none | green | 1 | green:right:1851:568:1874:598 |  |  | 0 | 0 | moving | 12.378
621 | 20.700 | yellow | yellow | none | none | none | none | 0 |  |  |  | 0 | 0 | moving | 12.378
624 | 20.800 | yellow | yellow | none | none | none | none | 0 |  |  |  | 0 | 0 | moving | 12.378
627 | 20.900 | yellow | yellow | none | none | none | none | 0 |  |  |  | 0 | 0 | moving | 12.378
630 | 21.000 | yellow | yellow | none | none | none | none | 0 |  |  |  | 0 | 0 | moving | 12.378
633 | 21.100 | yellow | yellow | none | none | none | none | 0 |  |  |  | 0 | 0 | moving | 15.501
636 | 21.200 | yellow | yellow | none | none | none | none | 0 |  |  |  | 0 | 0 | moving | 15.501
639 | 21.300 | yellow | yellow | none | none | none | none | 0 |  |  |  | 0 | 0 | moving | 11.709
642 | 21.400 | yellow | yellow | none | green | green | none | 1 | green:unknown:773:316:782:326 |  |  | 0 | 0 | moving | 12.450
645 | 21.500 | green | green | none | green | green | none | 1 | green:unknown:770:308:779:318 |  |  | 0 | 0 | moving | 11.103
648 | 21.600 | green | green | none | none | green | none | 1 | green:straight:766:301:776:312 |  |  | 0 | 0 | moving | 11.103
651 | 21.700 | green | green | none | green | green | none | 1 | green:unknown:762:295:772:304 |  |  | 0 | 0 | moving | 11.082
654 | 21.800 | green | green | none | none | none | green | 1 | green:right:758:286:768:296 |  |  | 0 | 0 | moving | 11.082
657 | 21.900 | green | green | none | green | none | none | 1 | green:left:754:278:765:290 |  |  | 0 | 0 | moving | 11.082
660 | 22.000 | green | green | green | none | none | green | 1 | green:right:750:272:761:283 |  |  | 0 | 0 | moving | 11.082
663 | 22.100 | green | green | green | none | green | none | 1 | green:straight:748:264:760:276 |  |  | 0 | 0 | moving | 11.082
666 | 22.200 | green | green | green | green | green | none | 1 | green:unknown:745:255:758:268 |  |  | 0 | 0 | moving | 11.148
669 | 22.300 | green | green | green | none | green | none | 1 | green:straight:742:244:754:258 |  |  | 0 | 0 | moving | 11.227
672 | 22.400 | green | green | green | none | green | none | 1 | green:straight:737:231:750:244 |  |  | 0 | 0 | moving | 14.432
675 | 22.500 | green | green | green | green | green | none | 1 | green:round:731:214:744:228 |  |  | 0 | 0 | moving | 14.432
678 | 22.600 | green | green | green | green | green | none | 1 | green:unknown:723:195:738:212 |  |  | 0 | 0 | moving | 17.582
681 | 22.700 | green | green | green | none | green | none | 1 | green:straight:716:175:732:193 |  |  | 0 | 0 | moving | 14.432
684 | 22.800 | green | green | green | green | green | none | 1 | green:unknown:709:150:727:168 |  |  | 0 | 0 | moving | 11.980
687 | 22.900 | green | green | green | none | green | none | 1 | green:straight:703:124:722:145 |  |  | 0 | 0 | moving | 10.930
690 | 23.000 | green | green | green | none | green | none | 1 | green:straight:696:97:717:120 |  |  | 0 | 0 | moving | 10.930
693 | 23.100 | green | green | green | none | none | none | 0 |  |  |  | 0 | 0 | moving | 10.930
696 | 23.200 | green | green | green | none | none | none | 0 |  |  |  | 0 | 0 | moving | 10.930
699 | 23.300 | green | green | green | none | none | none | 0 |  |  |  | 0 | 0 | moving | 13.436
702 | 23.400 | green | green | green | none | none | none | 0 |  |  |  | 0 | 0 | moving | 13.436
705 | 23.500 | green | green | green | red | red | none | 1 | red:unknown:1112:522:1120:532 |  |  | 0 | 0 | moving | 14.905
708 | 23.600 | green | green | green | none | none | none | 0 |  |  |  | 0 | 0 | moving | 14.905
711 | 23.700 | green | green | green | none | none | none | 0 |  |  |  | 0 | 0 | moving | 15.528
714 | 23.800 | green | green | green | red | red | none | 1 | red:unknown:1156:528:1168:536 |  |  | 0 | 0 | moving | 16.790
717 | 23.900 | green | green | green | yellow | yellow | none | 2 | red:round:1176:529:1188:540;yellow:unknown:1870:553:1906:576 |  |  | 0 | 0 | moving | 18.005
720 | 24.000 | green | green | none | green | green | none | 1 | green:unknown:1560:552:1622:577 |  |  | 0 | 0 | moving | 16.790
723 | 24.100 | green | green | none | green | green | none | 1 | green:unknown:1875:568:1920:589 |  |  | 0 | 0 | moving | 16.790
726 | 24.200 | green | green | none | green | green | none | 1 | green:unknown:1871:568:1920:601 |  |  | 0 | 0 | moving | 16.790
729 | 24.300 | green | green | none | none | none | none | 0 |  |  |  | 0 | 0 | moving | 15.790
732 | 24.400 | green | green | none | none | none | none | 0 |  |  |  | 0 | 0 | moving | 12.556
735 | 24.500 | green | green | none | none | none | none | 0 |  |  |  | 0 | 0 | moving | 12.458
738 | 24.600 | green | green | none | red | red | none | 1 | red:unknown:870:544:879:552 |  |  | 0 | 0 | moving | 10.685
741 | 24.700 | green | green | none | none | none | none | 0 |  |  |  | 0 | 0 | moving | 10.148
744 | 24.800 | green | green | none | none | none | none | 0 |  |  |  | 0 | 0 | moving | 9.415
747 | 24.900 | green | green | none | none | none | none | 0 |  |  |  | 0 | 0 | moving | 9.339
750 | 25.000 | green | green | none | none | none | none | 0 |  |  |  | 0 | 0 | moving | 9.339
753 | 25.100 | green | green | none | none | none | none | 0 |  |  |  | 0 | 0 | moving | 9.339
756 | 25.200 | green | green | none | none | none | none | 0 |  |  |  | 0 | 0 | moving | 10.723
759 | 25.300 | green | green | none | red | red | none | 1 | red:unknown:858:550:868:558 |  |  | 0 | 0 | moving | 10.830
762 | 25.400 | green | green | none | none | none | none | 0 |  |  |  | 0 | 0 | moving | 13.359
765 | 25.500 | red | red | none | red | red | none | 1 | red:unknown:856:552:864:560 |  |  | 0 | 0 | moving | 13.359
768 | 25.600 | red | red | none | none | none | none | 0 |  |  |  | 0 | 0 | moving | 10.830
771 | 25.700 | red | red | none | none | none | none | 0 |  |  |  | 0 | 0 | moving | 11.627
774 | 25.800 | red | red | none | none | none | none | 0 |  |  |  | 0 | 0 | moving | 11.627
777 | 25.900 | red | red | none | none | none | none | 0 |  |  |  | 0 | 0 | moving | 10.874
780 | 26.000 | red | red | none | none | none | none | 0 |  |  |  | 0 | 0 | moving | 11.627
783 | 26.100 | red | red | none | none | none | none | 0 |  |  |  | 0 | 0 | moving | 11.627
786 | 26.200 | red | red | none | none | none | none | 0 |  |  |  | 0 | 0 | moving | 11.852
789 | 26.300 | red | red | none | none | none | none | 0 |  |  |  | 0 | 0 | moving | 11.599
792 | 26.400 | red | red | none | none | none | none | 0 |  |  |  | 0 | 0 | moving | 11.852
795 | 26.500 | red | red | none | none | none | none | 0 |  |  |  | 0 | 0 | moving | 12.314
798 | 26.600 | red | red | none | none | none | none | 0 |  |  |  | 0 | 0 | moving | 12.314
801 | 26.700 | red | red | none | none | none | none | 0 |  |  |  | 0 | 0 | moving | 16.408
804 | 26.800 | red | red | none | none | none | none | 0 |  |  |  | 0 | 0 | moving | 16.408
807 | 26.900 | red | red | none | none | none | none | 0 |  |  |  | 0 | 0 | moving | 8.134
810 | 27.000 | red | red | none | none | none | none | 0 |  |  |  | 0 | 0 | moving | 7.685
813 | 27.100 | red | red | none | none | none | none | 0 |  |  |  | 0 | 0 | moving | 7.251
816 | 27.200 | red | red | none | none | red | none | 1 | red:straight:1232:516:1254:544 |  |  | 0 | 0 | moving | 7.251
819 | 27.300 | red | red | none | red | none | none | 1 | red:left:1242:516:1264:544 |  |  | 0 | 0 | moving | 7.251
822 | 27.400 | red | red | none | red | yellow | none | 2 | red:left:1252:519:1274:546;yellow:unknown:1266:519:1275:528 |  |  | 0 | 0 | moving | 11.358
825 | 27.500 | red | red | none | none | none | none | 0 |  |  |  | 0 | 0 | moving | 12.462
828 | 27.600 | red | red | none | red | none | none | 1 | red:left:1267:522:1292:552 |  |  | 0 | 0 | moving | 16.860
831 | 27.700 | red | red | none | red | none | none | 1 | red:left:1274:524:1300:555 |  |  | 0 | 0 | moving | 14.899
834 | 27.800 | red | red | none | red | none | none | 1 | red:left:1278:526:1306:556 |  |  | 0 | 0 | moving | 14.899
837 | 27.900 | red | red | none | red | red | none | 1 | red:unknown:1282:526:1310:558 |  |  | 0 | 0 | moving | 16.229
840 | 28.000 | red | red | none | none | red | none | 1 | red:straight:1284:526:1314:560 |  |  | 0 | 0 | moving | 14.899
843 | 28.100 | red | red | none | none | none | none | 0 |  |  |  | 0 | 0 | moving | 14.899
846 | 28.200 | red | red | none | red | none | none | 1 | red:left:1298:523:1330:556 |  |  | 0 | 0 | moving | 16.229
849 | 28.300 | red | red | none | red | none | none | 1 | red:left:1314:526:1338:559 |  |  | 0 | 0 | moving | 16.229
852 | 28.400 | red | red | none | none | none | none | 0 |  |  |  | 0 | 0 | moving | 14.847
855 | 28.500 | red | red | none | none | none | none | 0 |  |  |  | 0 | 0 | moving | 14.847
858 | 28.600 | red | red | none | none | none | none | 0 |  |  |  | 0 | 0 | moving | 14.486
861 | 28.700 | red | red | none | none | none | none | 0 |  |  |  | 0 | 0 | moving | 9.489
864 | 28.800 | red | red | none | none | none | none | 0 |  |  |  | 0 | 0 | moving | 9.231
867 | 28.900 | red | red | none | none | none | none | 0 |  |  |  | 0 | 0 | moving | 9.231
870 | 29.000 | red | red | none | none | none | none | 0 |  |  |  | 0 | 0 | moving | 8.828
873 | 29.100 | red | red | none | none | none | none | 0 |  |  |  | 0 | 0 | moving | 7.948
876 | 29.200 | red | red | none | none | none | none | 0 |  |  |  | 0 | 0 | moving | 7.948
879 | 29.300 | red | red | none | none | none | none | 0 |  |  |  | 0 | 0 | moving | 8.035
882 | 29.400 | red | red | none | none | none | none | 0 |  |  |  | 0 | 0 | moving | 8.035
885 | 29.500 | red | red | none | none | none | none | 0 |  |  |  | 0 | 0 | moving | 9.149
888 | 29.600 | red | red | none | none | none | none | 0 |  |  |  | 0 | 0 | moving | 9.149
891 | 29.700 | red | red | none | none | none | none | 0 |  |  |  | 0 | 0 | moving | 9.184
894 | 29.800 | red | red | none | none | none | none | 0 |  |  |  | 0 | 0 | moving | 12.098
897 | 29.900 | red | red | none | none | none | none | 0 |  |  |  | 0 | 0 | moving | 14.800
900 | 30.000 | red | none | none | none | none | none | 0 |  |  |  | 0 | 0 | moving | 12.580
903 | 30.100 | red | none | none | none | none | red | 1 | red:right:528:554:550:574 |  |  | 0 | 0 | moving | 16.999
906 | 30.200 | red | none | none | none | none | none | 0 |  |  |  | 0 | 0 | moving | 16.999
909 | 30.300 | red | none | none | yellow | yellow | red | 2 | red:right:502:558:524:578;yellow:round:1908:544:1920:560 |  |  | 0 | 0 | moving | 12.974
912 | 30.400 | red | none | red | none | none | red | 1 | red:right:486:560:512:580 |  |  | 0 | 0 | moving | 12.580
915 | 30.500 | red | none | red | green | green | none | 1 | green:unknown:770:377:778:386 |  |  | 0 | 0 | moving | 12.458
918 | 30.600 | red | none | red | green | green | none | 1 | green:unknown:764:369:774:378 |  |  | 0 | 0 | moving | 12.416
921 | 30.700 | green | green | red | green | green | none | 2 | green:unknown:759:359:768:368;green:unknown:865:362:874:370 |  |  | 0 | 0 | moving | 11.023
924 | 30.800 | green | green | red | green | green | none | 2 | green:unknown:753:349:764:359;green:unknown:865:352:874:362 |  |  | 0 | 0 | moving | 10.374
927 | 30.900 | green | green | red | green | green | none | 2 | green:round:748:340:759:351;green:unknown:865:343:875:351 |  |  | 0 | 0 | moving | 10.374
930 | 31.000 | green | green | red | none | green | none | 2 | green:straight:743:331:755:343;green:straight:866:334:876:344 |  |  | 0 | 0 | moving | 10.374
933 | 31.100 | green | green | red | green | green | none | 2 | green:unknown:737:324:750:336;green:straight:868:327:878:338 |  |  | 0 | 0 | moving | 11.023
936 | 31.200 | green | green | red | green | green | none | 2 | green:left:731:316:745:329;green:straight:868:320:880:332 |  |  | 0 | 0 | moving | 11.134
939 | 31.300 | green | green | red | green | none | none | 2 | green:left:726:307:740:320;green:left:871:311:883:324 |  |  | 0 | 0 | moving | 11.873
942 | 31.400 | green | green | red | green | green | none | 2 | green:round:720:298:735:312;green:straight:873:301:887:315 |  |  | 0 | 0 | moving | 11.873
945 | 31.500 | green | green | red | green | green | none | 2 | green:left:713:287:729:301;green:straight:875:290:889:305 |  |  | 0 | 0 | moving | 11.873
948 | 31.600 | green | green | red | green | green | none | 2 | green:unknown:703:270:720:288;green:straight:875:275:890:290 |  |  | 0 | 0 | moving | 11.873
951 | 31.700 | green | green | red | none | green | none | 2 | green:straight:692:254:710:271;green:straight:876:258:892:275 |  |  | 0 | 0 | moving | 12.296
954 | 31.800 | green | green | red | green | green | none | 2 | green:unknown:684:234:703:254;green:straight:880:240:898:260 |  |  | 0 | 0 | moving | 12.296
957 | 31.900 | green | green | red | green | green | none | 2 | green:left:675:218:696:238;green:straight:885:223:904:244 |  |  | 0 | 0 | moving | 12.940
960 | 32.000 | green | green | red | green | green | none | 2 | green:left:664:196:688:219;green:unknown:891:203:912:226 |  |  | 0 | 0 | moving | 12.940
963 | 32.100 | green | green | red | green | green | none | 2 | green:left:652:171:677:194;green:straight:898:178:920:202 |  |  | 0 | 0 | moving | 12.940
966 | 32.200 | green | green | red | green | green | none | 1 | green:unknown:637:140:664:166 |  |  | 0 | 0 | moving | 12.731
969 | 32.300 | green | green | red | green | none | none | 1 | green:left:621:104:651:132 |  |  | 0 | 0 | moving | 12.113
972 | 32.400 | green | green | none | green | green | none | 1 | green:unknown:1664:432:1678:456 |  |  | 0 | 0 | moving | 12.113
975 | 32.500 | green | green | none | none | none | none | 0 |  |  |  | 0 | 0 | moving | 12.128
978 | 32.600 | green | green | none | none | none | red | 1 | red:right:518:578:540:598 |  |  | 0 | 0 | moving | 12.731
981 | 32.700 | green | green | none | yellow | yellow | none | 1 | yellow:unknown:22:530:40:540 |  |  | 0 | 0 | moving | 12.128
984 | 32.800 | green | green | none | none | none | red | 1 | red:right:533:582:546:592 |  |  | 0 | 0 | moving | 14.369
987 | 32.900 | green | green | none | red | red | none | 1 | red:unknown:528:570:540:578 |  |  | 0 | 0 | moving | 18.021
990 | 33.000 | green | green | none | red | red | none | 1 | red:unknown:528:566:548:586 |  |  | 0 | 0 | moving | 14.369
993 | 33.100 | red | red | none | red | red | none | 1 | red:round:346:560:372:578 |  |  | 0 | 0 | moving | 14.369
996 | 33.200 | red | red | none | red | red | none | 1 | red:round:340:558:368:576 |  |  | 0 | 0 | moving | 14.369
999 | 33.300 | red | red | none | red | red | none | 1 | red:round:220:468:234:478 |  |  | 0 | 0 | moving | 13.696
1002 | 33.400 | red | red | none | red | red | none | 1 | red:round:228:467:242:478 |  |  | 0 | 0 | moving | 13.620
1005 | 33.500 | red | red | none | none | none | none | 0 |  |  |  | 0 | 0 | moving | 13.620
1008 | 33.600 | red | red | none | red | red | none | 1 | red:unknown:186:458:196:466 |  |  | 0 | 0 | moving | 8.770
1011 | 33.700 | red | red | none | red | red | none | 1 | red:round:278:544:310:564 |  |  | 0 | 0 | moving | 9.266
1014 | 33.800 | red | red | none | none | red | none | 1 | red:straight:176:458:192:472 |  |  | 0 | 0 | moving | 9.266
1017 | 33.900 | red | red | none | none | none | none | 0 |  |  |  | 0 | 0 | moving | 12.134
1020 | 34.000 | red | red | none | red | red | none | 1 | red:round:126:452:136:462 |  |  | 0 | 0 | moving | 12.134
1023 | 34.100 | red | red | none | none | none | none | 0 |  |  |  | 0 | 0 | moving | 12.301
1026 | 34.200 | red | red | none | none | none | none | 0 |  |  |  | 0 | 0 | moving | 15.096
1029 | 34.300 | red | red | none | red | red | none | 1 | red:unknown:309:558:348:584 |  |  | 0 | 0 | moving | 15.096
1032 | 34.400 | red | red | none | red | red | none | 1 | red:unknown:262:558:280:566 |  |  | 0 | 0 | moving | 16.623
1035 | 34.500 | red | red | none | none | none | none | 0 |  |  |  | 0 | 0 | moving | 15.096
1038 | 34.600 | red | red | none | none | none | none | 0 |  |  |  | 0 | 0 | moving | 14.219
1041 | 34.700 | red | red | none | none | none | none | 0 |  |  |  | 0 | 0 | moving | 12.454
1044 | 34.800 | red | red | none | none | none | none | 0 |  |  |  | 0 | 0 | moving | 10.360
1047 | 34.900 | red | red | none | none | none | none | 0 |  |  |  | 0 | 0 | moving | 9.782
1050 | 35.000 | red | red | none | none | none | none | 0 |  |  |  | 0 | 0 | moving | 9.782
1053 | 35.100 | red | red | none | none | none | none | 0 |  |  |  | 0 | 0 | moving | 9.782
1056 | 35.200 | red | red | none | none | none | none | 0 |  |  |  | 0 | 0 | moving | 10.515
1059 | 35.300 | red | red | none | none | none | none | 0 |  |  |  | 0 | 0 | moving | 10.770
1062 | 35.400 | red | red | none | none | none | none | 0 |  |  |  | 0 | 0 | moving | 10.770
1065 | 35.500 | red | red | none | none | none | none | 0 |  |  |  | 0 | 0 | moving | 10.937
1068 | 35.600 | red | red | none | none | none | none | 0 |  |  |  | 0 | 0 | moving | 10.770
1071 | 35.700 | red | red | none | none | none | none | 0 |  |  |  | 0 | 0 | moving | 10.186
1074 | 35.800 | red | red | none | none | none | none | 0 |  |  |  | 0 | 0 | moving | 10.186
1077 | 35.900 | red | red | none | none | none | none | 0 |  |  |  | 0 | 0 | moving | 10.937
1080 | 36.000 | red | red | none | none | none | none | 0 |  |  |  | 0 | 0 | moving | 10.075
1083 | 36.100 | red | red | none | none | none | none | 0 |  |  |  | 0 | 0 | moving | 11.024
1086 | 36.200 | red | red | none | none | none | none | 0 |  |  |  | 0 | 0 | moving | 11.260
1089 | 36.300 | red | red | none | none | none | none | 0 |  |  |  | 0 | 0 | moving | 11.024
1092 | 36.400 | none | none | none | none | none | none | 0 |  |  |  | 0 | 0 | moving | 11.139
1095 | 36.500 | none | none | none | red | red | none | 1 | red:unknown:1790:630:1800:639 |  |  | 0 | 0 | moving | 11.260
1098 | 36.600 | none | none | none | none | none | none | 0 |  |  |  | 0 | 0 | moving | 12.279
1101 | 36.700 | none | none | none | none | none | none | 0 |  |  |  | 0 | 0 | moving | 12.279
1104 | 36.800 | none | none | none | none | none | none | 0 |  |  |  | 0 | 0 | moving | 13.483
1107 | 36.900 | none | none | none | none | none | none | 0 |  |  |  | 0 | 0 | moving | 15.529
1110 | 37.000 | none | none | none | none | none | none | 0 |  |  |  | 0 | 0 | moving | 15.529
1113 | 37.100 | none | none | none | none | none | none | 0 |  |  |  | 0 | 0 | moving | 15.737
1116 | 37.200 | none | none | none | none | none | none | 0 |  |  |  | 0 | 0 | moving | 15.737
1119 | 37.300 | none | none | none | none | none | none | 0 |  |  |  | 0 | 0 | moving | 15.529
1122 | 37.400 | none | none | none | none | none | none | 0 |  |  |  | 0 | 0 | moving | 13.496
1125 | 37.500 | none | none | none | none | none | none | 0 |  |  |  | 0 | 0 | moving | 15.737
1128 | 37.600 | none | none | none | none | none | none | 0 |  |  |  | 0 | 0 | moving | 16.906
1131 | 37.700 | none | none | none | none | none | none | 0 |  |  |  | 0 | 0 | moving | 13.496
1134 | 37.800 | none | none | none | green | green | none | 1 | green:unknown:272:466:286:475 |  |  | 0 | 0 | moving | 14.581
1137 | 37.900 | none | none | none | red | red | none | 2 | red:unknown:240:506:256:532;yellow:unknown:268:512:276:528 |  |  | 0 | 0 | moving | 15.599
1140 | 38.000 | none | none | none | yellow | yellow | none | 2 | yellow:round:160:498:191:530;green:unknown:96:530:118:544 |  |  | 0 | 0 | moving | 14.581
1143 | 38.100 | none | none | none | red | red | none | 1 | red:round:1598:446:1623:464 |  |  | 0 | 0 | moving | 13.907
1146 | 38.200 | none | none | none | red | red | none | 1 | red:round:1665:436:1676:454 |  |  | 0 | 0 | moving | 13.907
1149 | 38.300 | none | none | none | none | none | none | 0 |  |  |  | 0 | 0 | moving | 13.610
1152 | 38.400 | none | none | none | none | none | none | 0 |  |  |  | 0 | 0 | moving | 13.610
1155 | 38.500 | none | none | none | none | none | none | 0 |  |  |  | 0 | 0 | moving | 13.907
1158 | 38.600 | none | none | none | none | none | none | 0 |  |  |  | 0 | 0 | moving | 13.331
1161 | 38.700 | none | none | none | green | green | none | 1 | green:unknown:1618:174:1626:182 |  |  | 0 | 0 | moving | 14.000
1164 | 38.800 | none | none | none | none | none | none | 0 |  |  |  | 0 | 0 | moving | 14.000
1167 | 38.900 | none | none | none | none | none | none | 0 |  |  |  | 0 | 0 | moving | 11.974
1170 | 39.000 | none | none | none | none | none | none | 0 |  |  |  | 0 | 0 | moving | 11.313
1173 | 39.100 | none | none | none | none | none | none | 0 |  |  |  | 0 | 0 | moving | 11.598
1176 | 39.200 | none | none | none | none | none | none | 0 |  |  |  | 0 | 0 | moving | 11.598
1179 | 39.300 | none | none | none | none | none | none | 0 |  |  |  | 0 | 0 | moving | 11.598
1182 | 39.400 | none | none | none | none | none | none | 0 |  |  |  | 0 | 0 | moving | 12.168
1185 | 39.500 | none | none | none | none | none | none | 0 |  |  |  | 0 | 0 | moving | 13.088
1188 | 39.600 | none | none | none | none | none | none | 0 |  |  |  | 0 | 0 | moving | 13.088
1191 | 39.700 | none | none | none | none | none | none | 0 |  |  |  | 0 | 0 | moving | 12.255
1194 | 39.800 | none | none | none | none | none | none | 0 |  |  |  | 0 | 0 | moving | 12.255
1197 | 39.900 | none | none | none | none | none | none | 0 |  |  |  | 0 | 0 | moving | 12.255
1200 | 40.000 | none | none | none | none | none | none | 0 |  |  |  | 0 | 0 | moving | 12.255
1203 | 40.100 | none | none | none | none | none | none | 0 |  |  |  | 0 | 0 | moving | 12.277
1206 | 40.200 | none | none | none | none | none | none | 0 |  |  |  | 0 | 0 | moving | 12.277
1209 | 40.300 | none | none | none | red | red | none | 1 | red:round:438:540:456:552 |  |  | 0 | 0 | moving | 10.740
1212 | 40.400 | none | none | none | red | red | none | 1 | red:round:422:540:441:552 |  |  | 0 | 0 | moving | 11.135
1215 | 40.500 | none | none | none | none | none | none | 0 |  |  |  | 0 | 0 | moving | 11.135
1218 | 40.600 | red | red | none | red | red | none | 1 | red:round:388:542:408:552 |  |  | 0 | 0 | moving | 11.135
1221 | 40.700 | red | red | none | red | red | none | 1 | red:round:374:546:393:556 |  |  | 0 | 0 | moving | 14.189
1224 | 40.800 | red | red | none | red | red | none | 2 | red:round:357:548:376:558;red:round:448:552:476:566 |  |  | 0 | 0 | moving | 17.463
1227 | 40.900 | red | red | none | red | red | none | 2 | red:round:336:550:354:561;red:round:430:554:458:569 |  |  | 0 | 0 | moving | 17.883
1230 | 41.000 | red | red | none | red | red | none | 2 | red:round:306:550:327:561;red:round:404:554:434:568 |  |  | 0 | 0 | moving | 17.883
1233 | 41.100 | red | red | none | red | red | none | 2 | red:round:270:546:292:559;red:round:374:552:406:568 |  |  | 0 | 0 | moving | 14.189
1236 | 41.200 | red | red | none | red | red | none | 1 | red:round:228:546:250:560 |  |  | 0 | 0 | moving | 16.293
1239 | 41.300 | red | red | none | red | red | none | 3 | red:round:178:546:202:558;red:round:295:551:330:568;red:unknown:808:576:818:584 |  |  | 0 | 0 | moving | 16.293
1242 | 41.400 | red | red | none | red | red | none | 3 | red:round:98:490:127:529;red:round:118:544:144:558;red:round:243:548:282:566 |  |  | 0 | 0 | moving | 13.488
1245 | 41.500 | red | red | none | red | red | none | 2 | red:unknown:794:573:804:581;red:round:556:582:566:592 |  |  | 0 | 0 | moving | 15.874
1248 | 41.600 | red | red | none | none | none | none | 0 |  |  |  | 0 | 0 | moving | 15.874
1251 | 41.700 | red | red | none | red | red | none | 1 | red:unknown:0:499:9:508 |  |  | 0 | 0 | moving | 14.425
1254 | 41.800 | red | red | none | red | red | none | 1 | red:round:480:586:492:596 |  |  | 0 | 0 | moving | 13.488
1257 | 41.900 | red | red | none | red | red | none | 1 | red:unknown:752:577:764:585 |  |  | 0 | 0 | moving | 12.872
1260 | 42.000 | red | red | none | none | none | none | 0 |  |  |  | 0 | 0 | moving | 12.872
1263 | 42.100 | red | red | none | none | none | none | 0 |  |  |  | 0 | 0 | moving | 13.026
1266 | 42.200 | red | red | none | none | none | none | 0 |  |  |  | 0 | 0 | moving | 12.872
1269 | 42.300 | red | red | red | none | none | red | 1 | red:right:758:580:770:590 |  |  | 0 | 0 | moving | 12.872
1272 | 42.400 | red | red | red | red | red | none | 1 | red:round:1350:440:1386:460 |  |  | 0 | 0 | moving | 12.140
1275 | 42.500 | red | red | red | red | red | none | 1 | red:round:166:602:180:616 |  |  | 0 | 0 | moving | 11.889
1278 | 42.600 | red | red | red | red | red | none | 1 | red:round:1352:454:1366:464 |  |  | 0 | 0 | moving | 11.889
1281 | 42.700 | red | red | red | red | red | none | 2 | red:round:1382:428:1424:454;red:round:1362:452:1378:462 |  |  | 0 | 0 | moving | 12.140
1284 | 42.800 | red | red | red | red | red | none | 1 | red:round:1376:450:1390:462 |  |  | 0 | 0 | moving | 12.140
1287 | 42.900 | red | red | red | red | red | none | 1 | red:unknown:1386:446:1404:458 |  |  | 0 | 0 | moving | 12.333
1290 | 43.000 | red | red | red | red | red | none | 1 | red:round:1402:442:1418:454 |  |  | 0 | 0 | moving | 12.333
1293 | 43.100 | red | red | red | red | red | none | 1 | red:round:1414:440:1431:452 |  |  | 0 | 0 | moving | 11.683
1296 | 43.200 | red | red | red | red | red | none | 3 | red:round:1452:416:1464:440;red:unknown:1428:440:1444:452;yellow:unknown:1487:418:1498:426 |  |  | 0 | 0 | moving | 11.683
1299 | 43.300 | red | red | red | red | red | none | 2 | red:round:1466:416:1498:444;red:round:1448:440:1460:450 |  |  | 0 | 0 | moving | 12.781
1302 | 43.400 | red | red | red | red | red | none | 2 | red:round:1478:414:1532:444;yellow:unknown:1520:420:1528:428 |  |  | 0 | 0 | moving | 12.781
1305 | 43.500 | red | red | red | red | red | none | 2 | red:round:312:594:334:606;red:unknown:500:595:525:612 |  |  | 0 | 0 | moving | 15.910
1308 | 43.600 | red | red | red | red | red | none | 3 | red:round:1498:408:1552:440;red:straight:1470:438:1488:456;yellow:round:1538:412:1548:422 |  |  | 0 | 0 | moving | 15.910
1311 | 43.700 | red | red | red | red | red | none | 2 | red:unknown:1498:400:1558:435;red:unknown:1472:432:1492:452 |  |  | 0 | 0 | moving | 15.910
1314 | 43.800 | red | red | red | red | red | red | 2 | red:round:1498:392:1558:426;red:right:1470:424:1492:446 |  |  | 0 | 0 | moving | 14.182
1317 | 43.900 | red | red | red | red | red | none | 2 | red:unknown:1496:384:1558:420;red:unknown:1468:418:1489:442 |  |  | 0 | 0 | moving | 13.140
1320 | 44.000 | red | red | red | red | red | red | 2 | red:round:1494:374:1555:412;red:right:1464:408:1484:434 |  |  | 0 | 0 | moving | 13.140
1323 | 44.100 | red | red | red | red | red | none | 2 | red:round:1486:368:1548:406;red:unknown:1454:402:1476:430 |  |  | 0 | 0 | moving | 14.182
1326 | 44.200 | red | red | red | red | red | none | 3 | red:unknown:1478:364:1542:404;red:unknown:1444:398:1470:426;red:unknown:364:462:373:472 |  |  | 0 | 0 | moving | 14.707
1329 | 44.300 | red | red | red | red | red | red | 3 | red:unknown:1468:358:1532:398;red:right:1430:390:1456:422;red:unknown:322:455:330:463 |  |  | 0 | 0 | moving | 14.847
1332 | 44.400 | red | red | red | red | red | red | 2 | red:round:1451:350:1516:388;red:right:1408:380:1440:412 |  |  | 0 | 0 | moving | 16.942
1335 | 44.500 | red | red | red | red | red | none | 2 | red:unknown:1378:374:1411:406;red:unknown:202:442:212:451 |  |  | 0 | 0 | moving | 16.985
1338 | 44.600 | red | red | red | red | red | red | 3 | red:unknown:1390:326:1461:368;red:right:1344:358:1382:392;red:round:129:430:140:440 |  |  | 0 | 0 | moving | 18.907
1341 | 44.700 | red | red | red | red | red | none | 1 | red:round:48:420:58:430 |  |  | 0 | 0 | moving | 19.273
1344 | 44.800 | red | red | red | red | red | red | 2 | red:unknown:1318:298:1392:340;red:right:1268:331:1308:364 |  |  | 0 | 0 | moving | 28.751
1347 | 44.900 | red | red | red | red | red | none | 1 | red:unknown:140:457:149:468 |  |  | 0 | 0 | moving | 37.024
1350 | 45.000 | red | red | red | none | none | none | 0 |  |  |  | 0 | 0 | moving | 37.024
1353 | 45.100 | red | red | red | red | red | none | 1 | red:round:1200:256:1278:302 |  |  | 0 | 0 | moving | 33.881
1356 | 45.200 | red | red | red | none | none | none | 0 |  |  |  | 0 | 0 | moving | 28.751
1359 | 45.300 | red | red | red | none | none | none | 0 |  |  |  | 0 | 0 | moving | 22.482
1362 | 45.400 | red | red | red | none | none | none | 0 |  |  |  | 0 | 0 | moving | 19.610
1365 | 45.500 | red | red | red | none | none | none | 0 |  |  |  | 0 | 0 | moving | 18.671
1368 | 45.600 | red | red | red | none | none | none | 0 |  |  |  | 0 | 0 | moving | 17.250
1371 | 45.700 | red | red | red | red | none | none | 1 | red:left:924:236:946:264 |  |  | 0 | 0 | moving | 19.098
1374 | 45.800 | red | red | red | red | none | none | 1 | red:left:870:223:894:251 |  |  | 0 | 0 | moving | 17.250
1377 | 45.900 | red | red | red | red | none | none | 1 | red:left:816:223:838:246 |  |  | 0 | 0 | moving | 17.250
1380 | 46.000 | red | red | red | red | none | none | 1 | red:left:758:201:782:224 |  |  | 0 | 0 | moving | 19.098
1383 | 46.100 | red | red | red | red | none | none | 1 | red:left:695:181:720:206 |  |  | 0 | 0 | moving | 20.114
1386 | 46.200 | red | red | red | none | none | none | 0 |  |  |  | 0 | 0 | moving | 20.114
1389 | 46.300 | red | red | red | red | red | none | 1 | red:unknown:1816:420:1824:432 |  |  | 0 | 0 | moving | 26.032
1392 | 46.400 | red | red | red | none | none | none | 0 |  |  |  | 0 | 0 | moving | 25.367
1395 | 46.500 | red | red | red | none | none | none | 0 |  |  |  | 0 | 0 | moving | 25.367
1398 | 46.600 | red | red | red | red | red | none | 1 | red:round:1798:471:1818:492 |  |  | 0 | 0 | moving | 21.399
1401 | 46.700 | red | red | red | red | red | none | 1 | red:round:1752:472:1774:496 |  |  | 0 | 0 | moving | 21.399
1404 | 46.800 | red | red | none | red | red | none | 1 | red:round:1768:494:1782:512 |  |  | 0 | 0 | moving | 17.522
1407 | 46.900 | red | red | none | none | none | none | 0 |  |  |  | 0 | 0 | moving | 16.865
1410 | 47.000 | red | red | none | none | none | none | 0 |  |  |  | 0 | 0 | moving | 16.865
1413 | 47.100 | red | red | none | none | none | none | 0 |  |  |  | 0 | 0 | moving | 17.522
1416 | 47.200 | red | red | none | none | none | none | 0 |  |  |  | 0 | 0 | moving | 19.510
1419 | 47.300 | red | red | none | none | none | none | 0 |  |  |  | 0 | 0 | moving | 19.510
1422 | 47.400 | red | red | none | none | none | none | 0 |  |  |  | 0 | 0 | moving | 21.439
1425 | 47.500 | red | red | none | none | none | none | 0 |  |  |  | 0 | 0 | moving | 21.741
1428 | 47.600 | red | red | none | none | none | none | 0 |  |  |  | 0 | 0 | moving | 24.965
1431 | 47.700 | red | red | none | none | none | none | 0 |  |  |  | 0 | 0 | moving | 21.439
1434 | 47.800 | red | red | none | red | red | none | 1 | red:round:605:488:618:500 |  |  | 0 | 0 | moving | 24.965
1437 | 47.900 | red | red | none | none | none | none | 0 |  |  |  | 0 | 0 | moving | 25.892
1440 | 48.000 | red | red | none | none | none | none | 0 |  |  |  | 0 | 0 | moving | 32.741
1443 | 48.100 | red | red | none | none | none | none | 0 |  |  |  | 0 | 0 | moving | 32.741
1446 | 48.200 | red | red | none | none | none | none | 0 |  |  |  | 0 | 0 | moving | 32.741
1449 | 48.300 | red | red | none | red | red | none | 1 | red:unknown:1600:548:1610:556 |  |  | 0 | 0 | moving | 25.954
1452 | 48.400 | red | red | none | none | none | yellow | 1 | yellow:right:1402:552:1422:576 |  |  | 0 | 0 | moving | 19.148
1455 | 48.500 | red | red | none | none | none | none | 0 |  |  |  | 0 | 0 | moving | 19.148
1458 | 48.600 | red | red | none | none | none | none | 0 |  |  |  | 0 | 0 | moving | 17.712
1461 | 48.700 | red | red | none | yellow | yellow | none | 1 | yellow:round:1353:548:1374:572 |  |  | 0 | 0 | moving | 16.424
1464 | 48.800 | red | red | none | none | none | none | 0 |  |  |  | 0 | 0 | moving | 15.966
1467 | 48.900 | red | red | none | red | red | none | 1 | red:unknown:1538:538:1552:548 |  |  | 0 | 0 | moving | 15.020
1470 | 49.000 | red | red | none | none | none | none | 0 |  |  |  | 0 | 0 | moving | 14.788
1473 | 49.100 | red | red | none | none | none | none | 0 |  |  |  | 0 | 0 | moving | 14.788
1476 | 49.200 | red | red | none | none | none | none | 0 |  |  |  | 0 | 0 | moving | 15.020
1479 | 49.300 | red | red | none | none | none | none | 0 |  |  |  | 0 | 0 | moving | 15.416
1482 | 49.400 | red | red | none | none | none | yellow | 1 | yellow:right:1348:558:1372:584 |  |  | 0 | 0 | moving | 15.416
1485 | 49.500 | red | red | yellow | none | none | yellow | 1 | yellow:right:1359:563:1382:592 |  |  | 0 | 0 | moving | 17.715
1488 | 49.600 | red | red | yellow | red | red | none | 1 | red:round:194:202:214:220 |  |  | 0 | 0 | moving | 17.715
1491 | 49.700 | red | red | yellow | red | none | none | 1 | red:left:120:144:160:198 |  |  | 0 | 0 | moving | 18.715
1494 | 49.800 | red | red | yellow | red | red | none | 1 | red:round:30:114:86:160 |  |  | 0 | 0 | moving | 17.715
1497 | 49.900 | red | red | yellow | yellow | yellow | none | 1 | yellow:unknown:1626:500:1646:512 |  |  | 0 | 0 | moving | 17.715
1500 | 50.000 | red | red | yellow | yellow | yellow | none | 2 | yellow:unknown:1910:578:1920:586;yellow:round:1407:586:1430:612 |  |  | 0 | 0 | moving | 15.897
1503 | 50.100 | red | yellow | yellow | none | yellow | none | 1 | yellow:straight:1375:586:1446:648 |  |  | 0 | 0 | moving | 15.686
1506 | 50.200 | yellow | yellow | yellow | yellow | yellow | none | 2 | yellow:unknown:1429:582:1456:614;yellow:unknown:1522:612:1546:648 |  |  | 0 | 0 | moving | 15.686
1509 | 50.300 | yellow | yellow | yellow | none | none | yellow | 1 | yellow:right:1442:581:1466:612 |  |  | 0 | 0 | moving | 15.686
1512 | 50.400 | yellow | yellow | yellow | none | none | none | 0 |  |  |  | 0 | 0 | moving | 15.686
1515 | 50.500 | yellow | yellow | yellow | none | none | none | 0 |  |  |  | 0 | 0 | moving | 15.123
1518 | 50.600 | yellow | yellow | yellow | none | none | none | 0 |  |  |  | 0 | 0 | moving | 14.055
1521 | 50.700 | yellow | yellow | yellow | red | red | none | 1 | red:round:654:392:672:406 |  |  | 0 | 0 | moving | 14.055
1524 | 50.800 | yellow | yellow | yellow | red | red | none | 1 | red:round:632:376:660:400 |  |  | 0 | 0 | moving | 15.063
1527 | 50.900 | red | red | yellow | red | red | none | 1 | red:unknown:320:80:398:116 |  |  | 0 | 0 | moving | 15.063
1530 | 51.000 | red | red | yellow | none | none | none | 0 |  |  |  | 0 | 0 | moving | 15.182
1533 | 51.100 | red | red | yellow | none | none | none | 0 |  |  |  | 0 | 0 | moving | 16.357
1536 | 51.200 | red | red | yellow | green | green | none | 1 | green:unknown:422:527:431:536 |  |  | 0 | 0 | moving | 16.721
1539 | 51.300 | red | red | yellow | red | red | none | 1 | red:round:1902:468:1920:486 |  |  | 0 | 0 | moving | 18.227
1542 | 51.400 | red | red | yellow | yellow | yellow | none | 1 | yellow:unknown:1910:458:1920:468 |  |  | 0 | 0 | moving | 16.357
1545 | 51.500 | red | red | yellow | yellow | yellow | none | 1 | yellow:round:1902:464:1920:478 |  |  | 0 | 0 | moving | 16.357
1548 | 51.600 | red | red | yellow | none | none | none | 0 |  |  |  | 0 | 0 | moving | 18.227
1551 | 51.700 | yellow | yellow | yellow | yellow | yellow | none | 1 | yellow:round:418:204:432:218 |  |  | 0 | 0 | moving | 18.227
1554 | 51.800 | yellow | yellow | yellow | red | red | none | 2 | red:round:398:184:416:210;yellow:round:362:162:379:178 |  |  | 0 | 0 | moving | 14.815
1557 | 51.900 | yellow | yellow | yellow | red | red | none | 1 | red:unknown:334:136:360:175 |  |  | 0 | 0 | moving | 18.364
1560 | 52.000 | yellow | yellow | yellow | none | none | none | 0 |  |  |  | 0 | 0 | moving | 21.284
1563 | 52.100 | yellow | yellow | yellow | none | none | none | 0 |  |  |  | 0 | 0 | moving | 21.062
1566 | 52.200 | yellow | yellow | yellow | yellow | yellow | none | 1 | yellow:round:1836:552:1870:594 |  |  | 0 | 0 | moving | 21.062
1569 | 52.300 | yellow | yellow | none | red | red | none | 1 | red:unknown:264:0:312:38 |  |  | 0 | 0 | moving | 21.062
1572 | 52.400 | yellow | yellow | none | none | none | none | 0 |  |  |  | 0 | 0 | moving | 20.061
1575 | 52.500 | yellow | yellow | none | none | none | none | 0 |  |  |  | 0 | 0 | moving | 19.979
1578 | 52.600 | yellow | yellow | none | none | none | none | 0 |  |  |  | 0 | 0 | moving | 14.925
1581 | 52.700 | yellow | yellow | none | none | none | none | 0 |  |  |  | 0 | 0 | moving | 14.925
1584 | 52.800 | yellow | yellow | none | none | none | none | 0 |  |  |  | 0 | 0 | moving | 14.925
1587 | 52.900 | yellow | yellow | none | none | none | none | 0 |  |  |  | 0 | 0 | moving | 14.729
1590 | 53.000 | yellow | yellow | none | none | none | none | 0 |  |  |  | 0 | 0 | moving | 17.248
1593 | 53.100 | yellow | yellow | none | none | none | none | 0 |  |  |  | 0 | 0 | moving | 17.248
1596 | 53.200 | yellow | yellow | none | none | none | none | 0 |  |  |  | 0 | 0 | moving | 14.986
1599 | 53.300 | yellow | yellow | none | red | red | none | 1 | red:round:588:326:602:344 |  |  | 0 | 0 | moving | 14.986
1602 | 53.400 | red | red | none | red | red | none | 1 | red:round:570:311:586:332 |  |  | 0 | 0 | moving | 17.248
1605 | 53.500 | red | red | none | red | red | none | 1 | red:round:548:294:564:316 |  |  | 0 | 0 | moving | 14.986
1608 | 53.600 | red | red | none | none | none | none | 0 |  |  |  | 0 | 0 | moving | 14.986
1611 | 53.700 | red | red | none | none | none | red | 1 | red:right:490:252:514:274 |  |  | 0 | 0 | moving | 14.946
1614 | 53.800 | red | red | none | none | none | red | 1 | red:right:462:232:484:251 |  |  | 0 | 0 | moving | 14.850
1617 | 53.900 | red | red | none | yellow | red | none | 2 | red:straight:428:208:448:224;yellow:unknown:426:214:444:224 |  |  | 0 | 0 | moving | 14.850
1620 | 54.000 | red | red | none | red | red | none | 2 | red:round:391:176:406:186;yellow:round:390:184:404:194 |  |  | 0 | 0 | moving | 14.946
1623 | 54.100 | red | red | none | red | red | none | 1 | red:round:391:176:402:200 |  |  | 0 | 0 | moving | 17.609
1626 | 54.200 | red | red | none | red | red | none | 1 | red:round:312:158:322:176 |  |  | 0 | 0 | moving | 17.609
1629 | 54.300 | red | red | none | red | red | none | 2 | red:round:232:40:244:54;yellow:unknown:236:55:248:72 |  |  | 0 | 0 | moving | 17.609
1632 | 54.400 | red | red | none | none | none | none | 0 |  |  |  | 0 | 0 | moving | 16.600
1635 | 54.500 | red | red | none | none | none | none | 0 |  |  |  | 0 | 0 | moving | 16.453
1638 | 54.600 | red | red | none | none | none | none | 0 |  |  |  | 0 | 0 | moving | 15.355
1641 | 54.700 | red | red | none | none | none | none | 0 |  |  |  | 0 | 0 | moving | 15.355
1644 | 54.800 | red | red | none | none | none | none | 0 |  |  |  | 0 | 0 | moving | 15.355
1647 | 54.900 | red | red | none | green | green | none | 1 | green:unknown:66:494:74:510 |  |  | 0 | 0 | moving | 15.893
1650 | 55.000 | red | red | red | none | none | red | 1 | red:right:696:376:710:396 |  |  | 0 | 0 | moving | 19.431
1653 | 55.100 | red | red | red | green | green | none | 1 | green:round:6:484:16:500 |  |  | 0 | 0 | moving | 19.431
1656 | 55.200 | red | red | red | none | none | none | 0 |  |  |  | 0 | 0 | moving | 19.431
1659 | 55.300 | red | red | red | none | none | none | 0 |  |  |  | 0 | 0 | moving | 19.431
1662 | 55.400 | red | red | red | red | red | red | 3 | red:right:192:0:234:52;red:round:250:0:274:30;yellow:unknown:221:0:230:9 |  |  | 0 | 0 | moving | 17.349
1665 | 55.500 | red | red | red | none | none | none | 0 |  |  |  | 0 | 0 | moving | 15.643
1668 | 55.600 | red | red | red | red | red | none | 1 | red:unknown:360:474:372:482 |  |  | 0 | 0 | moving | 14.664
1671 | 55.700 | red | red | red | none | none | none | 0 |  |  |  | 0 | 0 | moving | 14.664
1674 | 55.800 | red | red | red | none | none | none | 0 |  |  |  | 0 | 0 | moving | 14.664
1677 | 55.900 | red | red | red | none | none | none | 0 |  |  |  | 0 | 0 | moving | 16.153
1680 | 56.000 | red | red | red | yellow | yellow | none | 1 | yellow:unknown:1584:205:1618:224 |  |  | 0 | 0 | moving | 16.153
1683 | 56.100 | red | red | red | none | none | none | 0 |  |  |  | 0 | 0 | moving | 16.153
1686 | 56.200 | red | red | red | yellow | yellow | none | 1 | yellow:unknown:1821:48:1837:58 |  |  | 0 | 0 | moving | 16.153
1689 | 56.300 | red | red | red | none | none | none | 0 |  |  |  | 0 | 0 | moving | 13.810
1692 | 56.400 | red | red | red | none | none | none | 0 |  |  |  | 0 | 0 | moving | 13.810
1695 | 56.500 | red | red | red | none | none | none | 0 |  |  |  | 0 | 0 | moving | 13.810
1698 | 56.600 | red | red | red | none | none | none | 0 |  |  |  | 0 | 0 | moving | 13.810
1701 | 56.700 | red | red | red | none | none | none | 0 |  |  |  | 0 | 0 | moving | 13.810
1704 | 56.800 | red | red | red | none | none | none | 0 |  |  |  | 0 | 0 | moving | 18.064
1707 | 56.900 | red | red | red | none | none | none | 0 |  |  |  | 0 | 0 | moving | 13.754
1710 | 57.000 | yellow | yellow | red | yellow | yellow | none | 1 | yellow:unknown:670:248:678:256 |  |  | 0 | 0 | moving | 13.754
1713 | 57.100 | yellow | yellow | red | red | red | none | 1 | red:round:774:426:784:438 |  |  | 0 | 0 | moving | 16.024
1716 | 57.200 | yellow | yellow | red | red | red | none | 1 | red:round:774:422:784:434 |  |  | 0 | 0 | moving | 11.640
1719 | 57.300 | red | red | red | red | red | none | 1 | red:round:774:418:785:429 |  |  | 0 | 0 | moving | 11.640
1722 | 57.400 | red | red | none | none | none | none | 0 |  |  |  | 0 | 0 | moving | 11.640
1725 | 57.500 | red | red | none | none | none | none | 0 |  |  |  | 0 | 0 | moving | 11.640
1728 | 57.600 | red | red | none | none | none | none | 0 |  |  |  | 0 | 0 | moving | 11.518
1731 | 57.700 | red | red | none | none | none | none | 0 |  |  |  | 0 | 0 | moving | 11.518
1734 | 57.800 | red | red | none | yellow | yellow | none | 1 | yellow:round:1756:616:1795:648 |  |  | 0 | 0 | moving | 11.518
1737 | 57.900 | red | red | none | none | none | none | 0 |  |  |  | 0 | 0 | moving | 12.094
1740 | 58.000 | red | red | none | red | red | none | 1 | red:unknown:758:370:768:378 |  |  | 0 | 0 | moving | 14.360
1743 | 58.100 | red | red | none | none | none | none | 0 |  |  |  | 0 | 0 | moving | 15.542
1746 | 58.200 | red | red | none | yellow | yellow | none | 1 | yellow:unknown:1770:624:1784:632 |  |  | 0 | 0 | moving | 15.542
1749 | 58.300 | red | red | none | red | red | none | 1 | red:round:776:404:792:420 |  |  | 0 | 0 | moving | 14.360
1752 | 58.400 | red | red | none | red | red | none | 1 | red:round:774:400:790:418 |  |  | 0 | 0 | moving | 14.119
1755 | 58.500 | red | red | none | red | red | none | 1 | red:round:772:399:788:416 |  |  | 0 | 0 | moving | 13.115
1758 | 58.600 | red | red | none | yellow | yellow | none | 1 | yellow:round:1342:546:1354:556 |  |  | 0 | 0 | moving | 13.115
1761 | 58.700 | red | red | none | red | red | none | 1 | red:unknown:660:156:710:236 |  |  | 0 | 0 | moving | 14.119
1764 | 58.800 | red | red | none | none | none | none | 0 |  |  |  | 0 | 0 | moving | 14.182
1767 | 58.900 | red | red | none | yellow | yellow | none | 1 | yellow:round:1486:554:1504:574 |  |  | 0 | 0 | moving | 14.182
1770 | 59.000 | red | red | none | red | red | none | 2 | red:round:380:142:406:168;red:round:418:164:432:184 |  |  | 0 | 0 | moving | 14.182
1773 | 59.100 | red | red | none | none | none | none | 0 |  |  |  | 0 | 0 | moving | 12.390
1776 | 59.200 | red | red | none | red | red | none | 2 | red:unknown:714:296:756:322;red:round:768:372:792:400 |  |  | 0 | 0 | moving | 12.390
1779 | 59.300 | red | red | none | red | red | none | 2 | red:round:708:283:750:312;red:round:765:367:788:396 |  |  | 0 | 0 | moving | 12.390
1782 | 59.400 | red | red | none | red | red | none | 2 | red:unknown:698:270:746:302;red:round:760:362:784:390 |  |  | 0 | 0 | moving | 17.973
1785 | 59.500 | red | red | none | none | none | none | 0 |  |  |  | 0 | 0 | moving | 19.001
1788 | 59.600 | red | red | none | none | none | none | 0 |  |  |  | 0 | 0 | moving | 19.001
1791 | 59.700 | red | red | none | none | none | none | 0 |  |  |  | 0 | 0 | moving | 17.973
1794 | 59.800 | red | red | none | none | none | none | 0 |  |  |  | 0 | 0 | moving | 14.871
1797 | 59.900 | red | red | none | red | red | none | 1 | red:round:744:334:774:364 |  |  | 0 | 0 | moving | 14.871
1800 | 60.000 | red | red | none | red | red | none | 1 | red:round:740:330:770:360 |  |  | 0 | 0 | moving | 14.871
1803 | 60.100 | red | red | none | none | none | none | 0 |  |  |  | 0 | 0 | moving | 14.907
1806 | 60.200 | red | red | none | red | red | none | 1 | red:round:732:320:768:360 |  |  | 0 | 0 | moving | 16.678
1809 | 60.300 | red | red | none | red | red | none | 1 | red:round:730:314:766:356 |  |  | 0 | 0 | moving | 21.657
1812 | 60.400 | red | red | none | none | none | none | 0 |  |  |  | 0 | 0 | moving | 21.669
1815 | 60.500 | red | red | none | none | none | none | 0 |  |  |  | 0 | 0 | moving | 23.415
1818 | 60.600 | red | red | none | none | none | none | 0 |  |  |  | 0 | 0 | moving | 23.415
1821 | 60.700 | red | red | none | none | none | none | 0 |  |  |  | 0 | 0 | moving | 21.669
1824 | 60.800 | red | red | none | green | green | none | 1 | green:unknown:130:466:147:474 |  |  | 0 | 0 | moving | 16.644
1827 | 60.900 | red | red | none | none | none | none | 0 |  |  |  | 0 | 0 | moving | 16.034
1830 | 61.000 | red | red | none | red | red | none | 1 | red:unknown:678:254:726:312 |  |  | 0 | 0 | moving | 16.034
1833 | 61.100 | red | red | none | red | red | none | 1 | red:round:670:244:720:304 |  |  | 0 | 0 | moving | 16.644
1836 | 61.200 | red | red | none | red | red | none | 1 | red:round:661:238:717:298 |  |  | 0 | 0 | moving | 17.252
1839 | 61.300 | red | red | none | none | none | none | 0 |  |  |  | 0 | 0 | moving | 22.673
1842 | 61.400 | red | red | none | none | none | none | 0 |  |  |  | 0 | 0 | moving | 22.673
1845 | 61.500 | red | red | none | red | red | none | 1 | red:unknown:964:498:972:506 |  |  | 0 | 0 | moving | 20.286
1848 | 61.600 | red | red | none | none | none | none | 0 |  |  |  | 0 | 0 | moving | 17.252
1851 | 61.700 | red | red | none | red | red | none | 1 | red:unknown:976:500:986:508 |  |  | 0 | 0 | moving | 20.286
1854 | 61.800 | red | red | none | none | none | red | 1 | red:right:512:174:536:200 |  |  | 0 | 0 | moving | 14.782
1857 | 61.900 | red | red | none | red | red | none | 1 | red:unknown:496:154:518:184 |  |  | 0 | 0 | moving | 14.782
1860 | 62.000 | red | red | none | red | none | red | 2 | red:right:419:128:466:176;red:left:475:134:506:167 |  |  | 0 | 0 | moving | 14.782
1863 | 62.100 | red | red | none | red | red | none | 1 | red:round:1009:500:1022:516 |  |  | 0 | 0 | moving | 14.782
1866 | 62.200 | red | red | none | green | green | none | 1 | green:round:198:453:208:466 |  |  | 0 | 0 | moving | 14.782
1869 | 62.300 | red | red | none | red | red | none | 1 | red:round:1030:499:1046:518 |  |  | 0 | 0 | moving | 13.783
1872 | 62.400 | red | red | red | none | none | red | 1 | red:right:1044:496:1060:518 |  |  | 0 | 0 | moving | 12.675
1875 | 62.500 | red | red | red | none | none | green | 1 | green:right:1575:408:1596:426 |  |  | 0 | 0 | moving | 13.388
1878 | 62.600 | red | red | red | none | none | none | 0 |  |  |  | 0 | 0 | moving | 13.388
1881 | 62.700 | red | red | red | green | green | none | 1 | green:unknown:1588:396:1628:418 |  |  | 0 | 0 | moving | 13.388
1884 | 62.800 | red | red | red | red | red | none | 1 | red:unknown:765:351:780:360 |  |  | 0 | 0 | moving | 13.388
1887 | 62.900 | red | red | red | red | red | red | 2 | red:unknown:1210:486:1220:495;red:right:1138:490:1160:520 |  |  | 0 | 0 | moving | 13.388
1890 | 63.000 | red | red | red | red | red | none | 1 | red:unknown:1228:488:1240:497 |  |  | 0 | 0 | moving | 13.136
1893 | 63.100 | red | red | red | red | red | none | 1 | red:unknown:1202:500:1228:532 |  |  | 0 | 0 | moving | 11.104
1896 | 63.200 | red | red | red | red | red | none | 1 | red:unknown:736:360:744:368 |  |  | 0 | 0 | moving | 11.104
1899 | 63.300 | red | red | red | red | red | none | 2 | red:round:1306:490:1316:504;red:unknown:1287:509:1312:546 |  |  | 0 | 0 | moving | 11.104
1902 | 63.400 | red | red | red | red | red | none | 1 | red:unknown:1340:516:1366:555 |  |  | 0 | 0 | moving | 11.371
1905 | 63.500 | red | red | red | red | red | none | 2 | red:unknown:1168:514:1216:562;red:unknown:1400:524:1428:568 |  |  | 0 | 0 | moving | 11.637
1908 | 63.600 | red | red | red | red | red | none | 2 | red:unknown:1212:521:1264:572;red:round:1480:534:1500:564 |  |  | 0 | 0 | moving | 12.083
1911 | 63.700 | red | red | red | red | red | none | 1 | red:round:1260:524:1320:580 |  |  | 0 | 0 | moving | 12.083
1914 | 63.800 | red | red | red | yellow | yellow | none | 1 | yellow:round:332:436:344:448 |  |  | 0 | 0 | moving | 11.452
1917 | 63.900 | red | red | red | red | red | none | 1 | red:round:1390:548:1452:574 |  |  | 0 | 0 | moving | 11.747
1920 | 64.000 | red | red | red | red | red | none | 2 | red:round:412:462:438:474;red:unknown:976:478:986:486 |  |  | 0 | 0 | moving | 11.747
1923 | 64.100 | red | red | red | red | red | none | 1 | red:unknown:980:480:991:488 |  |  | 0 | 0 | moving | 11.747
1926 | 64.200 | red | red | red | yellow | yellow | none | 1 | yellow:unknown:698:298:710:306 |  |  | 0 | 0 | moving | 12.201
1929 | 64.300 | red | red | red | red | red | none | 2 | red:round:354:468:382:480;red:unknown:988:486:1001:494 |  |  | 0 | 0 | moving | 12.201
1932 | 64.400 | red | red | red | red | red | none | 2 | red:round:336:470:365:482;red:unknown:994:490:1006:498 |  |  | 0 | 0 | moving | 12.201
1935 | 64.500 | red | red | red | red | red | none | 2 | red:round:318:470:348:484;red:unknown:1002:492:1012:500 |  |  | 0 | 0 | moving | 9.868
1938 | 64.600 | red | red | red | green | green | none | 2 | red:unknown:1008:494:1020:502;green:unknown:602:510:626:546 |  |  | 0 | 0 | moving | 8.525
1941 | 64.700 | red | red | red | green | green | none | 1 | green:unknown:596:516:622:544 |  |  | 0 | 0 | moving | 8.525
1944 | 64.800 | red | red | red | red | red | none | 1 | red:round:1844:558:1856:578 |  |  | 0 | 0 | moving | 8.525
1947 | 64.900 | red | red | red | red | red | none | 2 | red:round:256:480:290:494;red:unknown:1028:504:1044:514 |  |  | 0 | 0 | moving | 9.513
1950 | 65.000 | red | red | red | none | none | red | 1 | red:right:1038:506:1050:516 |  |  | 0 | 0 | moving | 10.467
1953 | 65.100 | red | red | red | none | none | none | 0 |  |  |  | 0 | 0 | moving | 10.467
1956 | 65.200 | red | red | red | red | red | none | 1 | red:unknown:1048:506:1064:516 |  |  | 0 | 0 | moving | 10.467
1959 | 65.300 | red | red | red | red | red | none | 1 | red:unknown:1054:504:1070:514 |  |  | 0 | 0 | moving | 10.051
1962 | 65.400 | red | red | red | red | red | none | 1 | red:unknown:1059:502:1075:512 |  |  | 0 | 0 | moving | 8.664
1965 | 65.500 | red | red | red | red | red | none | 1 | red:unknown:1062:502:1078:512 |  |  | 0 | 0 | moving | 8.664
1968 | 65.600 | red | red | red | red | red | none | 1 | red:unknown:1064:502:1080:511 |  |  | 0 | 0 | moving | 8.664
1971 | 65.700 | red | red | red | red | red | none | 1 | red:unknown:1065:504:1082:512 |  |  | 0 | 0 | moving | 8.664
1974 | 65.800 | red | red | red | red | red | none | 1 | red:unknown:1066:504:1082:516 |  |  | 0 | 0 | moving | 8.664
1977 | 65.900 | red | red | red | red | red | none | 1 | red:unknown:1066:506:1083:514 |  |  | 0 | 0 | stopped | 6.240
1980 | 66.000 | red | red | red | red | red | green | 2 | red:unknown:1066:506:1084:517;green:right:763:519:777:529 |  |  | 0 | 0 | stopped | 6.240
1983 | 66.100 | red | red | red | none | none | none | 0 |  |  |  | 0 | 0 | stopped | 6.240
1986 | 66.200 | red | red | red | red | red | none | 1 | red:round:1070:502:1088:514 |  |  | 0 | 0 | stopped | 6.699
1989 | 66.300 | red | red | red | red | red | none | 1 | red:unknown:1072:500:1090:512 |  |  | 0 | 0 | stopped | 9.109
1992 | 66.400 | red | red | red | none | none | none | 0 |  |  |  | 0 | 0 | stopped | 9.109
1995 | 66.500 | red | red | red | green | green | none | 1 | green:unknown:442:340:454:364 |  |  | 0 | 0 | stopped | 9.109
1998 | 66.600 | red | red | red | red | red | none | 2 | red:round:0:482:44:500;red:unknown:1078:498:1097:507 |  |  | 0 | 0 | stopped | 7.847
2001 | 66.700 | red | red | red | red | red | none | 1 | red:unknown:1080:500:1099:509 |  |  | 0 | 0 | stopped | 7.428
2004 | 66.800 | red | red | red | red | red | none | 1 | red:unknown:1082:500:1101:509 |  |  | 0 | 0 | stopped | 7.428
2007 | 66.900 | red | red | red | green | green | none | 1 | green:unknown:444:362:468:404 |  |  | 0 | 0 | stopped | 7.847
2010 | 67.000 | red | red | red | red | red | none | 1 | red:unknown:1081:490:1100:502 |  |  | 0 | 0 | moving | 10.763
2013 | 67.100 | red | red | red | red | red | none | 1 | red:unknown:1083:489:1102:497 |  |  | 0 | 0 | moving | 10.763
2016 | 67.200 | red | red | red | red | red | none | 1 | red:round:1083:486:1102:496 |  |  | 0 | 0 | moving | 10.763
2019 | 67.300 | red | red | red | red | red | none | 1 | red:unknown:1085:484:1104:495 |  |  | 0 | 0 | moving | 9.541
2022 | 67.400 | red | red | red | red | red | none | 1 | red:unknown:1086:482:1105:494 |  |  | 0 | 0 | moving | 8.189
2025 | 67.500 | red | red | red | red | red | none | 1 | red:unknown:1087:482:1106:492 |  |  | 0 | 0 | moving | 7.304
2028 | 67.600 | red | red | red | red | red | none | 2 | red:unknown:1086:482:1105:491;green:unknown:726:502:737:518 |  |  | 0 | 0 | stopped | 4.523
2031 | 67.700 | red | red | red | green | green | none | 2 | red:round:1086:482:1104:492;green:unknown:726:502:737:523 |  |  | 0 | 0 | stopped | 2.982
2034 | 67.800 | red | red | red | red | red | none | 1 | red:unknown:1084:480:1104:492 |  |  | 0 | 0 | stopped | 2.982
2037 | 67.900 | red | red | red | red | red | none | 1 | red:round:1084:476:1102:488 |  |  | 0 | 0 | stopped | 2.982
2040 | 68.000 | red | red | red | red | red | none | 1 | red:unknown:1082:472:1101:480 |  |  | 0 | 0 | stopped | 4.446
2043 | 68.100 | red | red | red | none | none | none | 0 |  |  |  | 0 | 0 | stopped | 7.784
2046 | 68.200 | red | red | red | red | red | none | 1 | red:unknown:1077:464:1097:476 |  |  | 0 | 0 | stopped | 7.784
2049 | 68.300 | red | red | red | red | red | none | 1 | red:round:1074:464:1094:476 |  |  | 0 | 0 | stopped | 7.784
2052 | 68.400 | red | red | red | red | red | none | 1 | red:round:1072:466:1091:478 |  |  | 0 | 0 | stopped | 7.965
2055 | 68.500 | red | red | red | red | red | none | 1 | red:round:1070:470:1089:482 |  |  | 0 | 0 | stopped | 6.218
2058 | 68.600 | red | red | red | red | red | none | 1 | red:unknown:1069:474:1088:486 |  |  | 0 | 0 | stopped | 6.218
2061 | 68.700 | red | red | red | red | red | none | 1 | red:round:1070:476:1089:488 |  |  | 0 | 0 | stopped | 6.218
2064 | 68.800 | red | red | red | red | red | none | 1 | red:unknown:1072:478:1092:489 |  |  | 0 | 0 | stopped | 6.706
2067 | 68.900 | red | red | red | red | red | none | 1 | red:unknown:1076:478:1095:489 |  |  | 0 | 0 | stopped | 6.695
2070 | 69.000 | red | red | red | red | red | none | 1 | red:round:1080:480:1098:492 |  |  | 0 | 0 | stopped | 6.695
2073 | 69.100 | red | red | red | red | red | none | 1 | red:round:1083:482:1102:494 |  |  | 0 | 0 | stopped | 4.426
2076 | 69.200 | red | red | red | red | red | none | 1 | red:round:1086:484:1104:494 |  |  | 0 | 0 | stopped | 5.330
2079 | 69.300 | red | red | red | red | red | none | 1 | red:unknown:1088:484:1106:496 |  |  | 0 | 0 | stopped | 4.426
2082 | 69.400 | red | red | red | red | red | none | 1 | red:unknown:1088:486:1108:495 |  |  | 0 | 0 | stopped | 3.996
2085 | 69.500 | red | red | red | red | red | none | 1 | red:unknown:1090:488:1109:498 |  |  | 0 | 0 | stopped | 3.937
2088 | 69.600 | red | red | red | red | red | none | 1 | red:round:1092:490:1110:500 |  |  | 0 | 0 | stopped | 3.937
2091 | 69.700 | red | red | red | red | red | green | 3 | red:round:1093:490:1112:501;yellow:unknown:1584:446:1592:465;green:right:490:432:508:456 |  |  | 0 | 0 | stopped | 3.367
2094 | 69.800 | red | red | red | none | none | none | 0 |  |  |  | 0 | 0 | stopped | 3.226
2097 | 69.900 | red | red | red | red | red | none | 1 | red:round:1094:492:1114:502 |  |  | 0 | 0 | stopped | 3.028
2100 | 70.000 | red | red | red | red | red | none | 1 | red:round:1095:492:1114:504 |  |  | 0 | 0 | stopped | 3.028
2103 | 70.100 | red | red | red | red | red | none | 1 | red:unknown:1096:492:1115:504 |  |  | 0 | 0 | stopped | 2.457
2106 | 70.200 | red | red | red | red | red | none | 1 | red:unknown:1096:492:1115:504 |  |  | 0 | 0 | stopped | 2.369
2109 | 70.300 | red | red | red | red | red | none | 1 | red:unknown:1096:492:1116:504 |  |  | 0 | 0 | stopped | 2.181
2112 | 70.400 | red | red | red | red | red | none | 1 | red:unknown:1097:494:1118:504 |  |  | 0 | 0 | stopped | 2.369
2115 | 70.500 | red | red | red | red | red | none | 1 | red:unknown:1098:494:1118:504 |  |  | 0 | 0 | stopped | 2.181
2118 | 70.600 | red | red | red | red | red | none | 1 | red:round:1098:496:1118:506 |  |  | 0 | 0 | stopped | 1.774
2121 | 70.700 | red | red | red | red | red | none | 1 | red:round:1100:496:1119:506 |  |  | 0 | 0 | stopped | 1.774
2124 | 70.800 | red | red | red | red | red | none | 1 | red:round:1100:496:1120:508 |  |  | 0 | 0 | stopped | 3.125
2127 | 70.900 | red | red | red | red | red | none | 1 | red:unknown:1102:496:1121:508 |  |  | 0 | 0 | stopped | 2.483
2130 | 71.000 | red | red | red | red | red | none | 1 | red:unknown:1102:498:1122:508 |  |  | 0 | 0 | stopped | 2.483
2133 | 71.100 | red | red | red | red | red | none | 1 | red:unknown:1103:498:1122:509 |  |  | 0 | 0 | stopped | 2.483
2136 | 71.200 | red | red | red | red | red | none | 1 | red:round:1104:498:1123:510 |  |  | 0 | 0 | stopped | 2.483
2139 | 71.300 | red | red | red | red | red | none | 2 | red:unknown:1105:500:1124:512;yellow:unknown:1598:456:1606:472 |  |  | 0 | 0 | stopped | 2.483
2142 | 71.400 | red | red | red | red | red | none | 1 | red:unknown:1158:404:1166:412 |  |  | 0 | 0 | stopped | 3.246
2145 | 71.500 | red | red | red | none | none | none | 0 |  |  |  | 0 | 0 | stopped | 3.424
2148 | 71.600 | red | red | red | none | none | none | 0 |  |  |  | 0 | 0 | stopped | 4.139
2151 | 71.700 | red | red | red | red | red | none | 1 | red:unknown:1158:408:1166:418 |  |  | 0 | 0 | stopped | 4.391
2154 | 71.800 | red | red | red | none | none | none | 0 |  |  |  | 0 | 0 | stopped | 4.595
2157 | 71.900 | red | red | red | red | red | none | 1 | red:unknown:1158:416:1166:426 |  |  | 0 | 0 | stopped | 4.595
2160 | 72.000 | red | red | red | none | none | none | 0 |  |  |  | 0 | 0 | stopped | 4.969
2163 | 72.100 | red | red | red | green | green | none | 1 | green:unknown:461:400:494:440 |  |  | 0 | 0 | stopped | 5.927
2166 | 72.200 | red | red | red | none | none | none | 0 |  |  |  | 0 | 0 | stopped | 6.266
2169 | 72.300 | red | red | red | green | green | none | 1 | green:unknown:448:456:456:472 |  |  | 0 | 0 | stopped | 7.264
2172 | 72.400 | green | green | red | green | green | none | 1 | green:unknown:442:454:450:470 |  |  | 0 | 0 | stopped | 6.266
2175 | 72.500 | green | green | red | none | none | none | 0 |  |  |  | 0 | 0 | stopped | 6.266
2178 | 72.600 | green | green | red | none | none | none | 0 |  |  |  | 0 | 0 | stopped | 5.314
2181 | 72.700 | green | green | red | none | none | none | 0 |  |  |  | 0 | 0 | stopped | 4.279
2184 | 72.800 | green | green | red | none | none | none | 0 |  |  |  | 0 | 0 | stopped | 3.347
2187 | 72.900 | green | green | red | green | none | none | 1 | green:left:448:496:462:512 |  |  | 0 | 0 | stopped | 3.347
2190 | 73.000 | green | green | red | none | none | none | 0 |  |  |  | 0 | 0 | stopped | 3.347
2193 | 73.100 | green | green | red | none | none | none | 0 |  |  |  | 0 | 0 | stopped | 4.637
2196 | 73.200 | green | green | red | green | green | none | 1 | green:round:512:178:524:194 |  |  | 0 | 0 | stopped | 4.749
2199 | 73.300 | green | green | red | none | none | none | 0 |  |  |  | 0 | 0 | stopped | 7.613
2202 | 73.400 | green | green | red | none | none | none | 0 |  |  |  | 0 | 0 | stopped | 7.659
2205 | 73.500 | green | green | red | none | none | none | 0 |  |  |  | 0 | 0 | stopped | 7.613
2208 | 73.600 | green | green | red | none | none | none | 0 |  |  |  | 0 | 0 | stopped | 7.354
2211 | 73.700 | green | green | red | none | none | none | 0 |  |  |  | 0 | 0 | stopped | 7.613
2214 | 73.800 | green | green | red | none | none | none | 0 |  |  |  | 0 | 0 | stopped | 9.778
2217 | 73.900 | green | green | red | none | none | none | 0 |  |  |  | 0 | 0 | stopped | 9.778
2220 | 74.000 | green | green | none | none | none | none | 0 |  |  |  | 0 | 0 | moving | 10.375
2223 | 74.100 | green | green | none | none | none | none | 0 |  |  |  | 0 | 0 | moving | 10.375
2226 | 74.200 | green | green | none | none | none | none | 0 |  |  |  | 0 | 0 | moving | 10.375
2229 | 74.300 | green | green | none | none | none | none | 0 |  |  |  | 0 | 0 | moving | 9.536
2232 | 74.400 | green | green | none | none | none | none | 0 |  |  |  | 0 | 0 | moving | 9.121
2235 | 74.500 | green | green | none | green | green | none | 1 | green:unknown:604:472:612:486 |  |  | 0 | 0 | moving | 8.242
2238 | 74.600 | green | green | none | none | none | none | 0 |  |  |  | 0 | 0 | moving | 7.287
2241 | 74.700 | green | green | none | none | green | none | 1 | green:straight:975:376:985:386 |  |  | 0 | 0 | stopped | 6.991
2244 | 74.800 | green | green | none | none | none | none | 0 |  |  |  | 0 | 0 | stopped | 6.967
2247 | 74.900 | green | green | none | none | none | none | 0 |  |  |  | 0 | 0 | stopped | 6.902
2250 | 75.000 | green | green | none | yellow | yellow | none | 1 | yellow:round:136:482:150:502 |  |  | 0 | 0 | stopped | 6.649
2253 | 75.100 | green | green | none | none | none | none | 0 |  |  |  | 0 | 0 | stopped | 6.649
2256 | 75.200 | green | green | none | none | none | none | 0 |  |  |  | 0 | 0 | stopped | 6.647
2259 | 75.300 | green | green | none | none | none | none | 0 |  |  |  | 0 | 0 | stopped | 6.649
2262 | 75.400 | green | green | none | none | none | none | 0 |  |  |  | 0 | 0 | stopped | 7.007
2265 | 75.500 | green | green | none | none | none | green | 1 | green:right:1232:428:1243:440 |  |  | 0 | 0 | stopped | 9.401
2268 | 75.600 | green | green | none | green | green | none | 1 | green:unknown:990:350:1000:364 |  |  | 0 | 0 | stopped | 9.401
2271 | 75.700 | green | green | none | none | none | green | 1 | green:right:991:348:1001:359 |  |  | 0 | 0 | stopped | 9.401
2274 | 75.800 | green | green | none | none | green | none | 1 | green:straight:912:314:926:334 |  |  | 0 | 0 | stopped | 9.820
2277 | 75.900 | green | green | none | green | green | none | 1 | green:round:1270:424:1281:436 |  |  | 0 | 0 | stopped | 9.820
2280 | 76.000 | green | green | none | green | green | none | 1 | green:round:912:316:924:332 |  |  | 0 | 0 | moving | 10.721
2283 | 76.100 | green | green | none | green | green | none | 1 | green:round:910:318:922:334 |  |  | 0 | 0 | moving | 10.853
2286 | 76.200 | green | green | none | green | green | none | 1 | green:round:908:318:918:342 |  |  | 0 | 0 | moving | 10.853
2289 | 76.300 | green | green | none | green | green | none | 1 | green:round:1320:430:1331:442 |  |  | 0 | 0 | moving | 10.777
2292 | 76.400 | green | green | none | green | green | none | 1 | green:round:1334:430:1346:444 |  |  | 0 | 0 | moving | 10.721
2295 | 76.500 | green | green | none | green | green | none | 1 | green:round:1348:432:1360:445 |  |  | 0 | 0 | moving | 9.328
2298 | 76.600 | green | green | green | none | none | green | 1 | green:right:1362:432:1375:446 |  |  | 0 | 0 | moving | 9.328
2301 | 76.700 | green | green | green | green | green | none | 1 | green:round:891:349:903:360 |  |  | 0 | 0 | moving | 9.328
2304 | 76.800 | green | green | green | green | green | none | 1 | green:round:894:349:905:359 |  |  | 0 | 0 | moving | 10.868
2307 | 76.900 | green | green | green | green | green | none | 1 | green:round:896:346:907:357 |  |  | 0 | 0 | moving | 12.617
2310 | 77.000 | green | green | green | green | green | none | 1 | green:unknown:898:343:910:354 |  |  | 0 | 0 | moving | 13.211
2313 | 77.100 | green | green | green | green | green | none | 1 | green:round:901:340:913:351 |  |  | 0 | 0 | moving | 13.673
2316 | 77.200 | green | green | green | green | green | none | 1 | green:round:906:336:918:347 |  |  | 0 | 0 | moving | 13.799
2319 | 77.300 | green | green | green | green | green | none | 1 | green:round:911:332:923:343 |  |  | 0 | 0 | moving | 13.893
2322 | 77.400 | green | green | green | green | green | none | 2 | green:unknown:917:328:930:340;green:round:1062:331:1074:345 |  |  | 0 | 0 | moving | 13.893
2325 | 77.500 | green | green | green | green | green | none | 1 | green:round:926:325:938:337 |  |  | 0 | 0 | moving | 14.301
2328 | 77.600 | green | green | green | green | green | none | 1 | green:round:937:322:949:334 |  |  | 0 | 0 | moving | 13.893
2331 | 77.700 | green | green | green | green | green | none | 1 | green:round:953:321:965:333 |  |  | 0 | 0 | moving | 13.248
2334 | 77.800 | green | green | green | green | green | none | 1 | green:round:972:319:984:331 |  |  | 0 | 0 | moving | 13.248
2337 | 77.900 | green | green | green | green | green | none | 1 | green:round:995:315:1008:327 |  |  | 0 | 0 | moving | 13.404
2340 | 78.000 | green | green | green | red | red | none | 1 | red:unknown:72:270:88:280 |  |  | 0 | 0 | moving | 13.404
2343 | 78.100 | green | green | green | green | green | none | 2 | green:round:1062:308:1075:320;green:round:1226:309:1241:325 |  |  | 0 | 0 | moving | 14.707
2346 | 78.200 | green | green | green | green | green | none | 1 | green:round:1107:305:1121:318 |  |  | 0 | 0 | moving | 17.898
2349 | 78.300 | green | green | green | green | green | none | 1 | green:round:1162:304:1176:316 |  |  | 0 | 0 | moving | 18.163
2352 | 78.400 | green | green | green | green | none | none | 1 | green:left:1226:299:1242:312 |  |  | 0 | 0 | moving | 19.497
2355 | 78.500 | green | green | green | green | green | none | 1 | green:round:1302:296:1318:309 |  |  | 0 | 0 | moving | 19.944
2358 | 78.600 | green | green | green | green | green | none | 1 | green:round:1389:293:1406:307 |  |  | 0 | 0 | moving | 19.944
2361 | 78.700 | green | green | none | green | none | none | 1 | green:left:1489:291:1506:306 |  |  | 0 | 0 | moving | 19.944
2364 | 78.800 | green | green | none | none | none | none | 0 |  |  |  | 0 | 0 | moving | 20.395
2367 | 78.900 | green | green | none | none | none | none | 0 |  |  |  | 0 | 0 | moving | 19.665
2370 | 79.000 | green | green | none | none | none | none | 0 |  |  |  | 0 | 0 | moving | 19.330
2373 | 79.100 | green | green | none | green | green | none | 1 | green:unknown:1886:526:1902:542 |  |  | 0 | 0 | moving | 19.330
2376 | 79.200 | green | green | none | none | none | none | 0 |  |  |  | 0 | 0 | moving | 18.982
2379 | 79.300 | green | green | none | red | red | none | 1 | red:unknown:1868:304:1878:318 |  |  | 0 | 0 | moving | 17.713
2382 | 79.400 | green | green | none | none | none | green | 1 | green:right:1899:518:1916:538 |  |  | 0 | 0 | moving | 17.713
2385 | 79.500 | green | green | none | none | none | none | 0 |  |  |  | 0 | 0 | moving | 17.713
2388 | 79.600 | green | green | none | none | none | none | 0 |  |  |  | 0 | 0 | moving | 18.581
2391 | 79.700 | green | green | none | none | none | none | 0 |  |  |  | 0 | 0 | moving | 18.581
2394 | 79.800 | green | green | none | none | none | none | 0 |  |  |  | 0 | 0 | moving | 18.668
2397 | 79.900 | green | green | none | none | none | none | 0 |  |  |  | 0 | 0 | moving | 18.668
2400 | 80.000 | green | green | none | none | none | none | 0 |  |  |  | 0 | 0 | moving | 18.668
2403 | 80.100 | green | green | none | none | none | none | 0 |  |  |  | 0 | 0 | moving | 18.668
2406 | 80.200 | green | green | none | none | none | none | 0 |  |  |  | 0 | 0 | moving | 17.263
2409 | 80.300 | green | green | none | yellow | yellow | none | 1 | yellow:round:1598:508:1634:572 |  |  | 0 | 0 | moving | 17.263
2412 | 80.400 | green | green | none | none | none | none | 0 |  |  |  | 0 | 0 | moving | 17.263
2415 | 80.500 | green | green | none | yellow | yellow | none | 1 | yellow:round:1894:523:1920:560 |  |  | 0 | 0 | moving | 17.263
2418 | 80.600 | green | green | none | none | none | none | 0 |  |  |  | 0 | 0 | moving | 17.263
2421 | 80.700 | green | green | none | none | none | none | 0 |  |  |  | 0 | 0 | moving | 16.995
2424 | 80.800 | green | green | none | none | none | none | 0 |  |  |  | 0 | 0 | moving | 15.638
2427 | 80.900 | green | green | none | red | red | none | 1 | red:round:424:213:445:234 |  |  | 0 | 0 | moving | 15.638
2430 | 81.000 | green | green | none | none | none | none | 0 |  |  |  | 0 | 0 | moving | 15.638
2433 | 81.100 | green | green | none | none | none | none | 0 |  |  |  | 0 | 0 | moving | 18.480
2436 | 81.200 | green | green | none | red | red | none | 1 | red:round:588:200:610:221 |  |  | 0 | 0 | moving | 18.480
2439 | 81.300 | red | red | none | red | red | none | 1 | red:round:633:192:655:214 |  |  | 0 | 0 | moving | 18.480
2442 | 81.400 | red | red | none | none | none | none | 0 |  |  |  | 0 | 0 | moving | 18.418
2445 | 81.500 | red | red | none | red | red | none | 1 | red:round:708:173:732:197 |  |  | 0 | 0 | moving | 18.418
2448 | 81.600 | red | red | none | red | red | none | 1 | red:round:739:160:764:184 |  |  | 0 | 0 | moving | 16.155
2451 | 81.700 | red | red | none | red | red | none | 1 | red:round:768:145:794:172 |  |  | 0 | 0 | moving | 14.028
2454 | 81.800 | red | red | none | none | none | none | 0 |  |  |  | 0 | 0 | moving | 14.028
2457 | 81.900 | red | red | none | none | none | none | 0 |  |  |  | 0 | 0 | moving | 14.587
2460 | 82.000 | red | red | none | none | none | none | 0 |  |  |  | 0 | 0 | moving | 11.899
2463 | 82.100 | red | red | none | none | none | none | 0 |  |  |  | 0 | 0 | moving | 14.587
2466 | 82.200 | red | red | none | green | green | none | 1 | green:unknown:1910:520:1920:540 |  |  | 0 | 0 | moving | 14.587
2469 | 82.300 | red | red | none | none | none | none | 0 |  |  |  | 0 | 0 | moving | 14.308
2472 | 82.400 | red | red | none | none | none | none | 0 |  |  |  | 0 | 0 | moving | 13.716
2475 | 82.500 | red | red | none | none | none | none | 0 |  |  |  | 0 | 0 | moving | 13.716
2478 | 82.600 | red | red | none | green | green | none | 1 | green:unknown:123:416:141:430 |  |  | 0 | 0 | moving | 13.711
2481 | 82.700 | green | green | none | green | green | green | 3 | green:right:109:418:129:437;green:round:142:418:152:440;green:unknown:146:472:154:480 |  |  | 0 | 0 | moving | 13.711
2484 | 82.800 | green | green | none | green | green | none | 1 | green:unknown:103:440:112:458 |  |  | 0 | 0 | moving | 13.711
2487 | 82.900 | green | green | none | green | green | none | 1 | green:round:107:415:134:430 |  |  | 0 | 0 | moving | 17.047
2490 | 83.000 | green | green | none | green | green | none | 1 | green:unknown:110:464:118:474 |  |  | 0 | 0 | moving | 17.047
2493 | 83.100 | green | green | none | none | none | none | 0 |  |  |  | 0 | 0 | moving | 17.047
2496 | 83.200 | green | green | none | none | none | none | 0 |  |  |  | 0 | 0 | moving | 14.564
2499 | 83.300 | green | green | none | none | none | none | 0 |  |  |  | 0 | 0 | moving | 13.432
2502 | 83.400 | green | green | none | none | none | none | 0 |  |  |  | 0 | 0 | moving | 13.432
2505 | 83.500 | green | green | none | none | none | none | 0 |  |  |  | 0 | 0 | moving | 13.432
2508 | 83.600 | green | green | none | none | none | none | 0 |  |  |  | 0 | 0 | moving | 13.432
2511 | 83.700 | green | green | none | none | none | none | 0 |  |  |  | 0 | 0 | moving | 12.985
2514 | 83.800 | green | green | none | none | none | none | 0 |  |  |  | 0 | 0 | moving | 12.876
2517 | 83.900 | green | green | none | none | none | none | 0 |  |  |  | 0 | 0 | moving | 12.876
2520 | 84.000 | green | green | none | none | none | none | 0 |  |  |  | 0 | 0 | moving | 12.158
2523 | 84.100 | green | green | none | red | red | none | 1 | red:round:1597:296:1614:310 |  |  | 0 | 0 | moving | 12.165
2526 | 84.200 | green | green | none | none | none | none | 0 |  |  |  | 0 | 0 | moving | 12.876
2529 | 84.300 | green | green | none | none | none | none | 0 |  |  |  | 0 | 0 | moving | 13.552
2532 | 84.400 | green | green | none | red | red | none | 1 | red:unknown:208:407:216:415 |  |  | 0 | 0 | moving | 13.552
2535 | 84.500 | green | green | none | none | none | none | 0 |  |  |  | 0 | 0 | moving | 13.552
2538 | 84.600 | green | green | none | none | none | none | 0 |  |  |  | 0 | 0 | moving | 13.941
2541 | 84.700 | green | green | none | none | none | none | 0 |  |  |  | 0 | 0 | moving | 13.941
2544 | 84.800 | green | green | none | none | none | none | 0 |  |  |  | 0 | 0 | moving | 11.618
2547 | 84.900 | green | green | none | none | none | none | 0 |  |  |  | 0 | 0 | moving | 9.133
2550 | 85.000 | green | green | none | none | none | none | 0 |  |  |  | 0 | 0 | moving | 9.022
2553 | 85.100 | green | green | none | none | none | none | 0 |  |  |  | 0 | 0 | moving | 9.022
2556 | 85.200 | green | green | none | none | none | none | 0 |  |  |  | 0 | 0 | moving | 9.022
2559 | 85.300 | green | green | none | none | none | none | 0 |  |  |  | 0 | 0 | moving | 8.033
2562 | 85.400 | green | green | none | green | green | none | 1 | green:unknown:1828:39:1837:49 |  |  | 0 | 0 | moving | 9.022
2565 | 85.500 | green | green | none | none | none | none | 0 |  |  |  | 0 | 0 | moving | 9.732
2568 | 85.600 | green | green | none | none | none | none | 0 |  |  |  | 0 | 0 | moving | 9.469
2571 | 85.700 | green | green | none | none | none | none | 0 |  |  |  | 0 | 0 | moving | 9.469
2574 | 85.800 | green | green | none | yellow | yellow | none | 1 | yellow:unknown:1592:408:1601:420 |  |  | 0 | 0 | moving | 9.732
2577 | 85.900 | green | green | none | none | none | none | 0 |  |  |  | 0 | 0 | moving | 9.732
2580 | 86.000 | green | green | none | yellow | red | yellow | 3 | red:round:1650:388:1680:402;yellow:right:1614:390:1624:400;yellow:left:1632:390:1644:400 |  |  | 0 | 0 | moving | 9.469
2583 | 86.100 | green | green | none | green | none | none | 1 | green:left:1619:406:1650:448 |  |  | 0 | 0 | moving | 9.824
2586 | 86.200 | green | green | none | none | none | none | 0 |  |  |  | 0 | 0 | moving | 9.824
2589 | 86.300 | green | green | none | red | red | none | 1 | red:round:1840:516:1852:526 |  |  | 0 | 0 | moving | 9.320
2592 | 86.400 | green | green | none | none | none | none | 0 |  |  |  | 0 | 0 | moving | 9.320
2595 | 86.500 | green | green | none | none | none | none | 0 |  |  |  | 0 | 0 | moving | 9.958
2598 | 86.600 | green | green | none | none | none | none | 0 |  |  |  | 0 | 0 | moving | 11.398
2601 | 86.700 | green | green | none | none | none | green | 1 | green:right:1796:558:1806:570 |  |  | 0 | 0 | moving | 12.327
2604 | 86.800 | green | green | none | none | none | yellow | 1 | yellow:right:349:472:390:510 |  |  | 0 | 0 | moving | 13.094
2607 | 86.900 | green | green | none | yellow | yellow | none | 1 | yellow:unknown:314:474:384:516 |  |  | 0 | 0 | moving | 13.282
2610 | 87.000 | green | green | none | yellow | yellow | none | 1 | yellow:unknown:285:470:362:520 |  |  | 0 | 0 | moving | 13.282
2613 | 87.100 | green | green | none | red | red | none | 2 | red:unknown:310:419:318:432;red:round:66:434:76:446 |  |  | 0 | 0 | moving | 13.282
2616 | 87.200 | green | green | none | none | none | none | 0 |  |  |  | 0 | 0 | moving | 12.840
2619 | 87.300 | green | green | none | red | none | none | 1 | red:left:276:422:296:450 |  |  | 0 | 0 | moving | 12.650
2622 | 87.400 | green | green | none | none | none | none | 0 |  |  |  | 0 | 0 | moving | 12.650
2625 | 87.500 | green | green | none | none | none | none | 0 |  |  |  | 0 | 0 | moving | 12.737
2628 | 87.600 | green | green | none | yellow | yellow | none | 1 | yellow:unknown:84:492:127:520 |  |  | 0 | 0 | moving | 12.840
2631 | 87.700 | green | green | none | none | none | none | 0 |  |  |  | 0 | 0 | moving | 12.892
2634 | 87.800 | green | green | none | red | red | none | 1 | red:unknown:200:405:220:440 |  |  | 0 | 0 | moving | 12.892
2637 | 87.900 | green | green | none | red | red | none | 1 | red:unknown:166:390:183:428 |  |  | 0 | 0 | moving | 13.414
2640 | 88.000 | green | green | none | none | none | none | 0 |  |  |  | 0 | 0 | moving | 13.414
2643 | 88.100 | green | green | none | none | none | none | 0 |  |  |  | 0 | 0 | moving | 13.414
2646 | 88.200 | green | green | none | none | none | none | 0 |  |  |  | 0 | 0 | moving | 13.273
2649 | 88.300 | green | green | none | none | none | none | 0 |  |  |  | 0 | 0 | moving | 13.273
2652 | 88.400 | green | green | none | none | none | none | 0 |  |  |  | 0 | 0 | moving | 11.411
2655 | 88.500 | green | green | none | none | none | none | 0 |  |  |  | 0 | 0 | moving | 10.129
2658 | 88.600 | green | green | none | none | none | none | 0 |  |  |  | 0 | 0 | moving | 10.107
2661 | 88.700 | green | green | none | none | none | none | 0 |  |  |  | 0 | 0 | moving | 10.129
2664 | 88.800 | green | green | none | none | green | none | 1 | green:straight:1870:18:1886:39 |  |  | 0 | 0 | moving | 10.426
2667 | 88.900 | green | green | none | none | none | none | 0 |  |  |  | 0 | 0 | moving | 10.426
2670 | 89.000 | green | green | none | none | none | none | 0 |  |  |  | 0 | 0 | moving | 12.967
2673 | 89.100 | green | green | none | none | none | none | 0 |  |  |  | 0 | 0 | moving | 13.303
2676 | 89.200 | red | green | none | red | red | none | 1 | red:round:1548:468:1570:488 |  |  | 0 | 0 | moving | 18.050
2679 | 89.300 | red | green | none | red | red | none | 1 | red:round:1558:434:1572:446 |  |  | 0 | 0 | moving | 18.050
2682 | 89.400 | red | red | none | red | red | none | 1 | red:unknown:1582:428:1604:442 |  |  | 0 | 0 | moving | 18.050
2685 | 89.500 | red | red | none | none | none | none | 0 |  |  |  | 0 | 0 | moving | 18.050
2688 | 89.600 | red | red | none | green | green | none | 1 | green:unknown:228:452:238:470 |  |  | 0 | 0 | moving | 14.333
2691 | 89.700 | red | red | none | green | green | none | 1 | green:round:190:464:208:478 |  |  | 0 | 0 | moving | 13.210
2694 | 89.800 | red | red | none | none | none | none | 0 |  |  |  | 0 | 0 | moving | 14.333
2697 | 89.900 | red | red | none | none | none | none | 0 |  |  |  | 0 | 0 | moving | 13.210
2700 | 90.000 | red | red | none | none | none | none | 0 |  |  |  | 0 | 0 | moving | 13.210
2703 | 90.100 | red | red | none | none | none | none | 0 |  |  |  | 0 | 0 | moving | 12.990
2706 | 90.200 | red | red | none | red | red | none | 1 | red:round:1588:390:1637:432 |  |  | 0 | 0 | moving | 14.094
2709 | 90.300 | red | red | none | green | green | none | 1 | green:unknown:0:463:12:472 |  |  | 0 | 0 | moving | 13.302
2712 | 90.400 | red | red | none | none | none | none | 0 |  |  |  | 0 | 0 | moving | 14.094
2715 | 90.500 | red | red | none | none | none | none | 0 |  |  |  | 0 | 0 | moving | 13.302
2718 | 90.600 | red | red | none | none | none | none | 0 |  |  |  | 0 | 0 | moving | 14.094
2721 | 90.700 | red | red | none | red | red | none | 1 | red:round:1874:568:1920:587 |  |  | 0 | 0 | moving | 13.302
2724 | 90.800 | red | red | none | none | none | none | 0 |  |  |  | 0 | 0 | moving | 12.263
2727 | 90.900 | red | red | none | red | none | none | 1 | red:left:280:436:296:448 |  |  | 0 | 0 | moving | 12.114
2730 | 91.000 | red | red | none | red | red | none | 1 | red:unknown:1152:380:1164:388 |  |  | 0 | 0 | moving | 12.114
2733 | 91.100 | red | red | none | red | red | none | 1 | red:round:244:434:270:449 |  |  | 0 | 0 | moving | 12.114
2736 | 91.200 | red | red | none | red | red | none | 1 | red:round:1320:338:1334:348 |  |  | 0 | 0 | moving | 12.088
2739 | 91.300 | red | red | none | red | red | none | 1 | red:round:216:434:242:450 |  |  | 0 | 0 | moving | 12.088
2742 | 91.400 | red | red | none | red | red | none | 1 | red:round:208:434:234:450 |  |  | 0 | 0 | moving | 11.675
2745 | 91.500 | red | red | none | red | red | none | 1 | red:unknown:189:432:218:450 |  |  | 0 | 0 | moving | 11.404
2748 | 91.600 | red | red | none | red | red | none | 1 | red:unknown:1194:380:1204:388 |  |  | 0 | 0 | moving | 11.091
2751 | 91.700 | red | red | none | red | red | none | 1 | red:round:1272:360:1286:370 |  |  | 0 | 0 | moving | 11.091
2754 | 91.800 | red | red | none | red | red | none | 1 | red:round:1384:332:1400:344 |  |  | 0 | 0 | moving | 11.404
2757 | 91.900 | red | red | none | red | red | none | 1 | red:round:1554:290:1574:302 |  |  | 0 | 0 | moving | 11.404
2760 | 92.000 | red | red | none | red | red | none | 1 | red:unknown:1296:356:1306:364 |  |  | 0 | 0 | moving | 11.475
2763 | 92.100 | red | red | none | red | red | none | 1 | red:round:85:406:139:429 |  |  | 0 | 0 | moving | 12.191
2766 | 92.200 | red | red | none | red | none | none | 1 | red:left:1618:246:1640:264 |  |  | 0 | 0 | moving | 12.890
2769 | 92.300 | red | red | none | red | red | none | 1 | red:round:50:380:88:404 |  |  | 0 | 0 | moving | 13.338
2772 | 92.400 | red | red | none | red | red | none | 1 | red:round:26:371:52:395 |  |  | 0 | 0 | moving | 13.338
2775 | 92.500 | red | red | none | red | red | none | 1 | red:unknown:19:368:64:392 |  |  | 0 | 0 | moving | 13.338
