Zdy-1110/FPGA-676/tools/adas/host_test/out/113343/states.csv

frame | t | sig_left | sig_straight | sig_right | raw_left | raw_straight | raw_right | n_lights | lights | left_line | right_line | left_cov | right_cov | ego_motion | motion_score
0 | 0.000 | none | none | none | none | none | none | 0 |  |  |  | 0 | 0 | moving | 0.000
3 | 0.100 | none | none | none | none | none | none | 0 |  |  |  | 0 | 0 | moving | 11.308
6 | 0.200 | none | none | none | none | none | none | 0 |  |  |  | 0 | 0 | moving | 11.703
9 | 0.300 | none | none | none | none | none | none | 0 |  |  |  | 0 | 0 | moving | 12.097
12 | 0.400 | none | none | none | none | none | none | 0 |  |  |  | 0 | 0 | moving | 12.250
15 | 0.500 | none | none | none | none | none | none | 0 |  |  |  | 0 | 0 | moving | 12.403
18 | 0.600 | none | none | none | none | none | none | 0 |  |  |  | 0 | 0 | moving | 13.317
21 | 0.700 | none | none | none | none | none | none | 0 |  |  |  | 0 | 0 | moving | 13.422
24 | 0.800 | none | none | none | none | none | none | 0 |  |  |  | 0 | 0 | moving | 14.202
27 | 0.900 | none | none | none | none | red | none | 1 | red:straight:1814:606:1828:620 |  |  | 0 | 0 | moving | 14.202
30 | 1.000 | none | none | none | none | none | none | 0 |  |  |  | 0 | 0 | moving | 14.202
33 | 1.100 | none | none | none | yellow | yellow | none | 2 | yellow:round:1876:610:1903:622;yellow:unknown:1370:640:1386:648 |  |  | 0 | 0 | moving | 13.235
36 | 1.200 | none | none | none | yellow | yellow | red | 2 | red:right:1868:608:1882:624;yellow:unknown:1395:636:1420:648 |  |  | 0 | 0 | moving | 12.946
39 | 1.300 | none | none | none | none | none | yellow | 1 | yellow:right:1425:630:1446:648 |  |  | 0 | 0 | moving | 11.855
42 | 1.400 | none | none | none | none | none | none | 0 |  |  |  | 0 | 0 | moving | 10.295
45 | 1.500 | none | none | none | none | none | none | 0 |  |  |  | 0 | 0 | moving | 10.295
48 | 1.600 | yellow | yellow | none | yellow | yellow | none | 2 | yellow:unknown:1514:610:1594:648;yellow:unknown:1792:627:1800:642 |  |  | 0 | 0 | moving | 10.295
51 | 1.700 | yellow | yellow | none | yellow | yellow | none | 1 | yellow:unknown:1546:608:1646:648 |  |  | 0 | 0 | moving | 10.956
54 | 1.800 | yellow | yellow | none | yellow | yellow | none | 2 | yellow:unknown:1692:594:1704:609;yellow:unknown:1712:597:1731:610 |  |  | 0 | 0 | moving | 11.831
57 | 1.900 | yellow | yellow | none | yellow | yellow | none | 1 | yellow:unknown:1765:593:1779:601 |  |  | 0 | 0 | moving | 12.299
60 | 2.000 | yellow | yellow | none | yellow | yellow | none | 1 | yellow:unknown:1842:640:1852:648 |  |  | 0 | 0 | moving | 12.421
63 | 2.100 | yellow | yellow | none | none | none | none | 0 |  |  |  | 0 | 0 | moving | 13.098
66 | 2.200 | yellow | yellow | none | yellow | yellow | none | 1 | yellow:unknown:1844:599:1920:648 |  |  | 0 | 0 | moving | 13.969
69 | 2.300 | yellow | yellow | none | none | none | none | 0 |  |  |  | 0 | 0 | moving | 13.969
72 | 2.400 | yellow | yellow | none | none | none | none | 0 |  |  |  | 0 | 0 | moving | 13.969
75 | 2.500 | yellow | yellow | none | none | none | none | 0 |  |  |  | 0 | 0 | moving | 13.336
78 | 2.600 | yellow | yellow | none | green | green | none | 1 | green:unknown:1040:516:1048:528 |  |  | 0 | 0 | moving | 12.058
81 | 2.700 | yellow | yellow | none | none | none | none | 0 |  |  |  | 0 | 0 | moving | 12.058
84 | 2.800 | yellow | yellow | none | green | green | none | 1 | green:unknown:1052:504:1060:513 |  |  | 0 | 0 | moving | 12.058
87 | 2.900 | green | green | none | green | green | none | 1 | green:unknown:1688:460:1709:472 |  |  | 0 | 0 | moving | 12.121
90 | 3.000 | green | green | none | none | none | none | 0 |  |  |  | 0 | 0 | moving | 12.280
93 | 3.100 | green | green | none | none | none | none | 0 |  |  |  | 0 | 0 | moving | 12.635
96 | 3.200 | green | green | none | none | none | none | 0 |  |  |  | 0 | 0 | moving | 12.927
99 | 3.300 | green | green | none | none | none | none | 0 |  |  |  | 0 | 0 | moving | 13.192
102 | 3.400 | green | green | none | green | green | none | 1 | green:unknown:1606:570:1614:586 |  |  | 0 | 0 | moving | 13.192
105 | 3.500 | green | green | none | green | green | none | 2 | green:unknown:270:538:283:552;green:unknown:1758:544:1768:567 |  |  | 0 | 0 | moving | 13.029
108 | 3.600 | green | green | none | green | green | none | 1 | green:round:1630:554:1642:580 |  |  | 0 | 0 | moving | 13.035
111 | 3.700 | green | green | none | red | none | none | 1 | red:left:232:600:248:614 |  |  | 0 | 0 | moving | 13.035
114 | 3.800 | green | green | none | green | red | none | 2 | red:straight:224:598:240:612;green:round:1658:545:1668:570 |  |  | 0 | 0 | moving | 13.035
117 | 3.900 | green | green | none | none | none | green | 1 | green:right:1168:308:1179:320 |  |  | 0 | 0 | moving | 13.047
120 | 4.000 | green | green | none | green | green | none | 2 | green:round:1788:508:1799:532;green:unknown:236:514:246:536 |  |  | 0 | 0 | moving | 13.047
123 | 4.100 | green | green | none | green | green | none | 3 | green:unknown:1784:508:1796:534;green:unknown:230:512:238:525;green:unknown:1720:540:1728:550 |  |  | 0 | 0 | moving | 13.047
126 | 4.200 | green | green | none | green | green | none | 2 | green:left:1824:510:1834:522;green:unknown:1752:516:1766:540 |  |  | 0 | 0 | moving | 13.047
129 | 4.300 | green | green | none | green | green | none | 1 | green:unknown:1206:208:1221:218 |  |  | 0 | 0 | moving | 12.886
132 | 4.400 | green | green | none | red | none | none | 1 | red:left:181:572:208:596 |  |  | 0 | 0 | moving | 12.445
135 | 4.500 | green | green | none | red | red | none | 2 | red:unknown:162:572:197:594;yellow:unknown:176:570:190:578 |  |  | 0 | 0 | moving | 12.436
138 | 4.600 | red | green | none | red | red | none | 2 | red:unknown:148:570:185:594;yellow:unknown:166:568:178:576 |  |  | 0 | 0 | moving | 12.445
141 | 4.700 | red | green | none | green | green | none | 1 | green:unknown:1307:281:1316:292 |  |  | 0 | 0 | moving | 12.445
144 | 4.800 | red | green | none | green | green | red | 4 | red:right:130:568:160:590;green:unknown:1826:492:1843:528;green:round:1802:500:1820:534;green:unknown:216:508:231:524 |  |  | 0 | 0 | moving | 12.823
147 | 4.900 | green | green | none | green | green | green | 2 | green:round:1772:506:1786:536;green:right:170:507:186:521 |  |  | 0 | 0 | moving | 13.025
150 | 5.000 | green | green | none | green | green | none | 1 | green:unknown:1216:152:1224:168 |  |  | 0 | 0 | moving | 13.640
153 | 5.100 | green | green | none | green | green | none | 1 | green:round:1832:486:1851:518 |  |  | 0 | 0 | moving | 13.640
156 | 5.200 | green | green | none | none | none | green | 1 | green:right:1447:168:1458:179 |  |  | 0 | 0 | moving | 13.640
159 | 5.300 | green | green | none | red | yellow | none | 3 | red:left:104:555:140:584;yellow:unknown:1768:614:1828:639;green:unknown:194:628:204:644 |  |  | 0 | 0 | moving | 12.507
162 | 5.400 | green | green | none | red | yellow | none | 2 | red:left:90:552:132:586;yellow:unknown:1790:613:1844:640 |  |  | 0 | 0 | moving | 12.507
165 | 5.500 | green | green | none | green | none | none | 1 | green:left:1458:33:1501:70 |  |  | 0 | 0 | moving | 12.507
168 | 5.600 | green | green | none | green | green | none | 2 | green:round:1486:0:1537:24;green:unknown:1467:54:1480:68 |  |  | 0 | 0 | moving | 12.594
171 | 5.700 | green | green | none | green | green | none | 1 | green:unknown:1550:12:1566:23 |  |  | 0 | 0 | moving | 12.594
174 | 5.800 | green | green | none | none | none | red | 1 | red:right:44:552:64:578 |  |  | 0 | 0 | moving | 12.594
177 | 5.900 | green | green | none | red | red | none | 2 | red:round:35:551:84:580;yellow:unknown:1884:616:1920:638 |  |  | 0 | 0 | moving | 12.035
180 | 6.000 | green | green | none | red | red | none | 1 | red:round:27:548:72:576 |  |  | 0 | 0 | moving | 11.840
183 | 6.100 | red | red | none | red | red | none | 2 | red:unknown:14:544:64:574;red:unknown:70:574:78:582 |  |  | 0 | 0 | moving | 11.150
186 | 6.200 | red | red | none | none | none | green | 1 | green:right:35:494:48:508 |  |  | 0 | 0 | moving | 11.013
189 | 6.300 | red | red | none | red | none | none | 1 | red:left:50:564:64:579 |  |  | 0 | 0 | moving | 10.401
192 | 6.400 | red | red | none | red | none | none | 1 | red:left:40:556:60:578 |  |  | 0 | 0 | moving | 10.055
195 | 6.500 | red | red | none | red | none | none | 1 | red:left:30:552:54:578 |  |  | 0 | 0 | moving | 10.000
198 | 6.600 | red | red | none | red | none | none | 1 | red:left:18:546:48:576 |  |  | 0 | 0 | moving | 9.900
201 | 6.700 | red | red | none | green | green | none | 1 | green:unknown:123:633:132:648 |  |  | 0 | 0 | moving | 9.654
204 | 6.800 | red | red | none | green | green | none | 1 | green:unknown:119:632:127:648 |  |  | 0 | 0 | moving | 8.991
207 | 6.900 | red | red | none | none | none | none | 0 |  |  |  | 0 | 0 | moving | 8.991
210 | 7.000 | red | red | none | none | none | none | 0 |  |  |  | 0 | 0 | moving | 9.699
213 | 7.100 | red | red | none | none | none | none | 0 |  |  |  | 0 | 0 | moving | 9.456
216 | 7.200 | red | red | none | none | none | none | 0 |  |  |  | 0 | 0 | moving | 9.621
219 | 7.300 | red | red | none | none | none | none | 0 |  |  |  | 0 | 0 | moving | 9.621
222 | 7.400 | green | green | none | green | green | none | 1 | green:unknown:87:633:96:646 |  |  | 0 | 0 | moving | 9.456
225 | 7.500 | green | green | none | green | none | none | 1 | green:left:83:626:97:644 |  |  | 0 | 0 | moving | 8.883
228 | 7.600 | green | green | none | green | green | none | 1 | green:unknown:78:625:92:646 |  |  | 0 | 0 | moving | 8.354
231 | 7.700 | green | green | none | green | green | none | 1 | green:round:74:624:89:646 |  |  | 0 | 0 | moving | 8.354
234 | 7.800 | green | green | none | green | green | none | 1 | green:round:70:622:85:644 |  |  | 0 | 0 | moving | 8.354
237 | 7.900 | green | green | none | green | green | none | 1 | green:round:66:620:81:642 |  |  | 0 | 0 | moving | 8.140
240 | 8.000 | green | green | none | green | green | none | 1 | green:round:62:618:76:643 |  |  | 0 | 0 | moving | 8.297
243 | 8.100 | green | green | none | green | green | none | 1 | green:round:58:616:72:640 |  |  | 0 | 0 | moving | 8.297
246 | 8.200 | green | green | none | green | green | none | 2 | red:unknown:1832:640:1846:648;green:round:54:615:70:638 |  |  | 0 | 0 | moving | 8.297
249 | 8.300 | green | green | none | green | green | none | 4 | red:unknown:1848:636:1862:644;yellow:unknown:1752:638:1777:648;yellow:unknown:1828:640:1848:648;green:round:53:612:67:635 |  |  | 0 | 0 | moving | 8.297
252 | 8.400 | green | green | none | green | green | none | 2 | yellow:unknown:1776:638:1793:648;green:round:50:609:66:632 |  |  | 0 | 0 | moving | 8.377
255 | 8.500 | green | green | none | green | green | none | 1 | green:unknown:52:610:65:629 |  |  | 0 | 0 | moving | 8.742
258 | 8.600 | green | green | none | green | green | red | 2 | red:right:1603:559:1617:576;green:round:56:606:67:628 |  |  | 0 | 0 | moving | 8.815
261 | 8.700 | green | green | none | red | red | none | 2 | red:unknown:1626:554:1639:574;green:unknown:56:608:66:626 |  |  | 0 | 0 | moving | 8.979
264 | 8.800 | green | green | none | red | red | none | 1 | red:unknown:1646:550:1660:575 |  |  | 0 | 0 | moving | 9.184
267 | 8.900 | red | red | none | red | red | none | 1 | red:unknown:1670:548:1683:573 |  |  | 0 | 0 | moving | 9.557
270 | 9.000 | red | red | none | red | red | none | 2 | red:left:1680:538:1694:549;red:round:1692:542:1705:568 |  |  | 0 | 0 | moving | 9.590
273 | 9.100 | red | red | none | red | none | none | 1 | red:left:1681:549:1699:573 |  |  | 0 | 0 | moving | 9.604
276 | 9.200 | red | red | none | none | none | none | 0 |  |  |  | 0 | 0 | moving | 9.711
279 | 9.300 | red | red | none | green | green | none | 1 | green:unknown:34:452:43:464 |  |  | 0 | 0 | moving | 10.251
282 | 9.400 | red | red | none | green | green | none | 1 | green:unknown:78:478:102:488 |  |  | 0 | 0 | moving | 10.265
285 | 9.500 | red | red | none | none | none | none | 0 |  |  |  | 0 | 0 | moving | 10.414
288 | 9.600 | green | green | none | green | green | none | 1 | green:unknown:19:634:27:648 |  |  | 0 | 0 | moving | 10.720
291 | 9.700 | green | green | none | none | none | none | 0 |  |  |  | 0 | 0 | moving | 10.758
294 | 9.800 | green | green | none | green | none | none | 1 | green:left:0:628:12:640 |  |  | 0 | 0 | moving | 10.830
297 | 9.900 | green | green | none | none | none | none | 0 |  |  |  | 0 | 0 | moving | 10.987
300 | 10.000 | green | green | none | red | red | none | 1 | red:unknown:1112:632:1121:642 |  |  | 0 | 0 | moving | 11.067
303 | 10.100 | green | green | none | none | none | none | 0 |  |  |  | 0 | 0 | moving | 11.453
306 | 10.200 | green | green | none | red | red | none | 1 | red:unknown:1137:638:1146:648 |  |  | 0 | 0 | moving | 11.792
309 | 10.300 | green | green | none | none | none | none | 0 |  |  |  | 0 | 0 | moving | 12.000
312 | 10.400 | green | green | none | none | none | none | 0 |  |  |  | 0 | 0 | moving | 12.332
315 | 10.500 | green | green | none | none | none | none | 0 |  |  |  | 0 | 0 | moving | 13.165
318 | 10.600 | green | green | none | none | none | none | 0 |  |  |  | 0 | 0 | moving | 13.165
321 | 10.700 | green | green | none | none | none | none | 0 |  |  |  | 0 | 0 | moving | 13.165
324 | 10.800 | green | green | none | none | none | none | 0 |  |  |  | 0 | 0 | moving | 12.893
327 | 10.900 | green | green | none | none | none | none | 0 |  |  |  | 0 | 0 | moving | 12.893
330 | 11.000 | green | green | none | green | green | none | 1 | green:unknown:74:506:82:523 |  |  | 0 | 0 | moving | 12.788
333 | 11.100 | green | green | none | green | green | none | 1 | green:unknown:64:506:72:522 |  |  | 0 | 0 | moving | 12.788
336 | 11.200 | green | green | none | none | none | none | 0 |  |  |  | 0 | 0 | moving | 12.744
339 | 11.300 | green | green | none | none | none | none | 0 |  |  |  | 0 | 0 | moving | 12.744
342 | 11.400 | green | green | none | none | none | none | 0 |  |  |  | 0 | 0 | moving | 12.744
345 | 11.500 | green | green | none | none | none | none | 0 |  |  |  | 0 | 0 | moving | 13.969
348 | 11.600 | green | green | none | none | none | none | 0 |  |  |  | 0 | 0 | moving | 14.757
351 | 11.700 | green | green | none | red | red | none | 1 | red:unknown:1156:636:1166:644 |  |  | 0 | 0 | moving | 16.537
354 | 11.800 | green | green | none | red | red | none | 1 | red:round:1146:628:1156:638 |  |  | 0 | 0 | moving | 16.537
357 | 11.900 | green | green | none | green | green | none | 2 | red:unknown:1138:624:1148:633;green:unknown:1129:628:1149:642 |  |  | 0 | 0 | moving | 16.537
360 | 12.000 | green | green | none | red | red | none | 1 | red:unknown:1128:620:1138:629 |  |  | 0 | 0 | moving | 15.764
363 | 12.100 | green | green | none | red | red | none | 1 | red:round:1118:616:1128:626 |  |  | 0 | 0 | moving | 15.247
366 | 12.200 | red | red | none | red | red | none | 1 | red:round:1108:614:1118:624 |  |  | 0 | 0 | moving | 14.977
369 | 12.300 | red | red | none | red | red | none | 1 | red:unknown:1098:616:1108:624 |  |  | 0 | 0 | moving | 14.918
372 | 12.400 | red | red | none | red | red | none | 1 | red:round:1088:616:1098:626 |  |  | 0 | 0 | moving | 14.918
375 | 12.500 | red | red | none | red | red | none | 1 | red:round:1078:616:1088:626 |  |  | 0 | 0 | moving | 14.977
378 | 12.600 | red | red | none | red | red | none | 1 | red:round:1068:614:1078:625 |  |  | 0 | 0 | moving | 14.918
381 | 12.700 | red | red | none | red | red | none | 2 | red:round:1057:612:1068:622;green:unknown:1054:626:1071:636 |  |  | 0 | 0 | moving | 14.709
384 | 12.800 | red | red | none | red | red | none | 1 | red:round:1046:610:1058:620 |  |  | 0 | 0 | moving | 13.800
387 | 12.900 | red | red | none | red | red | none | 1 | red:round:1036:608:1047:618 |  |  | 0 | 0 | moving | 12.518
390 | 13.000 | red | red | none | red | red | none | 1 | red:round:1026:606:1037:618 |  |  | 0 | 0 | moving | 11.703
393 | 13.100 | red | red | none | red | red | none | 1 | red:round:1017:602:1028:615 |  |  | 0 | 0 | moving | 11.703
396 | 13.200 | red | red | none | red | red | none | 1 | red:round:1010:600:1020:612 |  |  | 0 | 0 | moving | 11.685
399 | 13.300 | red | red | none | red | red | none | 1 | red:round:1002:598:1013:608 |  |  | 0 | 0 | moving | 11.614
402 | 13.400 | red | red | none | red | red | none | 2 | red:round:994:598:1006:608;red:unknown:1124:598:1136:606 |  |  | 0 | 0 | moving | 11.425
405 | 13.500 | red | red | none | red | red | none | 2 | red:round:987:596:998:608;red:unknown:1118:598:1130:606 |  |  | 0 | 0 | moving | 10.808
408 | 13.600 | red | red | none | yellow | yellow | none | 2 | red:round:980:598:992:610;yellow:round:159:634:180:648 |  |  | 0 | 0 | moving | 10.808
411 | 13.700 | red | red | none | red | red | none | 1 | red:round:974:600:985:612 |  |  | 0 | 0 | moving | 10.808
414 | 13.800 | red | red | none | red | red | none | 2 | red:round:968:604:980:614;red:unknown:1100:604:1114:612 |  |  | 0 | 0 | moving | 11.439
417 | 13.900 | red | red | none | red | red | none | 2 | red:round:962:606:974:618;red:unknown:1096:607:1108:615 |  |  | 0 | 0 | moving | 11.444
420 | 14.000 | red | red | none | red | red | none | 2 | red:round:958:610:968:622;red:round:1091:610:1104:620 |  |  | 0 | 0 | moving | 11.444
423 | 14.100 | red | red | none | red | red | none | 3 | red:round:952:614:964:626;red:unknown:1087:616:1100:625;green:unknown:948:626:960:636 |  |  | 0 | 0 | moving | 11.458
426 | 14.200 | red | red | none | red | red | none | 2 | red:round:948:618:960:630;red:round:1084:618:1098:628 |  |  | 0 | 0 | moving | 11.657
429 | 14.300 | red | red | none | red | red | none | 2 | red:round:945:620:958:632;red:unknown:1082:622:1096:630 |  |  | 0 | 0 | moving | 11.444
432 | 14.400 | red | red | none | red | red | none | 3 | red:round:1080:621:1094:632;red:round:943:622:955:633;green:unknown:936:615:945:624 |  |  | 0 | 0 | moving | 11.312
435 | 14.500 | red | red | none | red | red | none | 2 | red:round:940:622:953:634;red:round:1078:624:1092:634 |  |  | 0 | 0 | moving | 11.164
438 | 14.600 | red | red | none | red | red | none | 2 | red:round:939:622:951:634;red:round:1077:624:1092:634 |  |  | 0 | 0 | moving | 10.889
441 | 14.700 | red | red | none | red | red | none | 2 | red:round:938:622:948:632;red:round:1076:622:1090:633 |  |  | 0 | 0 | moving | 10.218
444 | 14.800 | red | red | none | red | red | none | 3 | red:round:936:620:948:633;red:round:1074:620:1088:632;green:unknown:930:613:950:621 |  |  | 0 | 0 | moving | 9.579
447 | 14.900 | red | red | none | red | red | none | 2 | red:round:934:620:946:630;red:round:1074:620:1088:632 |  |  | 0 | 0 | moving | 9.393
450 | 15.000 | red | red | none | red | red | none | 2 | red:round:932:620:944:631;red:round:1073:620:1088:631 |  |  | 0 | 0 | moving | 9.253
453 | 15.100 | red | red | none | red | red | none | 2 | red:round:931:618:944:630;red:round:1072:618:1086:630 |  |  | 0 | 0 | moving | 9.057
456 | 15.200 | red | red | none | red | red | none | 3 | red:round:930:618:943:630;red:round:1072:618:1086:630;green:unknown:926:629:945:641 |  |  | 0 | 0 | moving | 8.805
459 | 15.300 | red | red | none | red | red | none | 3 | red:round:1071:617:1084:631;red:round:928:618:941:630;green:unknown:920:612:929:622 |  |  | 0 | 0 | moving | 8.600
462 | 15.400 | red | red | none | red | red | none | 3 | red:round:927:620:940:632;red:round:1070:620:1083:633;green:unknown:918:629:942:644 |  |  | 0 | 0 | moving | 8.600
465 | 15.500 | red | red | none | red | red | none | 2 | red:round:926:622:938:634;red:round:1068:622:1082:634 |  |  | 0 | 0 | moving | 8.600
468 | 15.600 | red | red | none | red | red | none | 2 | red:round:1068:623:1082:638;red:round:924:624:936:638 |  |  | 0 | 0 | moving | 9.015
471 | 15.700 | red | red | none | red | red | none | 2 | red:round:922:628:934:640;red:round:1066:628:1080:640 |  |  | 0 | 0 | moving | 9.165
474 | 15.800 | red | red | none | red | red | none | 2 | red:round:920:632:932:644;red:round:1066:632:1079:644 |  |  | 0 | 0 | moving | 9.555
477 | 15.900 | red | red | none | red | red | none | 2 | red:round:919:634:932:648;red:round:1064:634:1078:648 |  |  | 0 | 0 | moving | 9.555
480 | 16.000 | red | red | none | red | red | none | 2 | red:round:918:638:931:648;red:round:1064:638:1078:648 |  |  | 0 | 0 | moving | 9.555
483 | 16.100 | red | red | none | red | red | none | 2 | red:unknown:918:640:930:648;red:unknown:1064:640:1077:648 |  |  | 0 | 0 | moving | 8.758
486 | 16.200 | red | red | none | none | none | none | 0 |  |  |  | 0 | 0 | moving | 8.382
489 | 16.300 | red | red | none | none | none | none | 0 |  |  |  | 0 | 0 | moving | 8.025
492 | 16.400 | red | red | none | none | none | none | 0 |  |  |  | 0 | 0 | moving | 7.498
495 | 16.500 | red | red | none | none | none | none | 0 |  |  |  | 0 | 0 | moving | 7.289
498 | 16.600 | red | red | none | none | none | none | 0 |  |  |  | 0 | 0 | stopped | 6.786
501 | 16.700 | red | red | none | none | none | none | 0 |  |  |  | 0 | 0 | stopped | 6.273
504 | 16.800 | red | red | none | none | none | none | 0 |  |  |  | 0 | 0 | stopped | 6.070
507 | 16.900 | red | red | none | none | none | none | 0 |  |  |  | 0 | 0 | stopped | 5.744
510 | 17.000 | red | red | none | none | none | none | 0 |  |  |  | 0 | 0 | stopped | 5.180
513 | 17.100 | red | red | none | none | none | none | 0 |  |  |  | 0 | 0 | stopped | 4.535
516 | 17.200 | red | red | none | none | none | none | 0 |  |  |  | 0 | 0 | stopped | 3.864
519 | 17.300 | red | red | none | none | none | none | 0 |  |  |  | 0 | 0 | stopped | 3.857
522 | 17.400 | red | red | none | none | none | none | 0 |  |  |  | 0 | 0 | stopped | 3.857
525 | 17.500 | red | red | none | none | none | none | 0 |  |  |  | 0 | 0 | stopped | 3.857
528 | 17.600 | red | red | none | none | none | none | 0 |  |  |  | 0 | 0 | stopped | 4.112
531 | 17.700 | red | red | none | none | none | none | 0 |  |  |  | 0 | 0 | stopped | 4.162
534 | 17.800 | red | red | none | none | none | none | 0 |  |  |  | 0 | 0 | stopped | 4.394
537 | 17.900 | red | red | none | none | none | none | 0 |  |  |  | 0 | 0 | stopped | 4.768
540 | 18.000 | red | red | none | none | none | none | 0 |  |  |  | 0 | 0 | stopped | 4.776
543 | 18.100 | red | red | none | none | none | none | 0 |  |  |  | 0 | 0 | stopped | 5.318
546 | 18.200 | red | red | none | none | none | none | 0 |  |  |  | 0 | 0 | stopped | 5.347
549 | 18.300 | red | red | none | none | none | none | 0 |  |  |  | 0 | 0 | stopped | 5.472
552 | 18.400 | red | red | none | none | none | none | 0 |  |  |  | 0 | 0 | stopped | 5.515
555 | 18.500 | red | red | none | none | none | none | 0 |  |  |  | 0 | 0 | stopped | 5.515
558 | 18.600 | red | red | none | red | red | none | 1 | red:round:1392:638:1402:648 |  |  | 0 | 0 | stopped | 5.472
561 | 18.700 | red | red | none | red | red | none | 1 | red:unknown:1392:636:1400:648 |  |  | 0 | 0 | stopped | 4.994
564 | 18.800 | red | red | none | red | red | none | 1 | red:round:1388:633:1398:648 |  |  | 0 | 0 | stopped | 4.419
567 | 18.900 | red | red | none | red | red | none | 1 | red:round:1384:632:1394:648 |  |  | 0 | 0 | stopped | 4.063
570 | 19.000 | red | red | none | red | red | none | 1 | red:round:1382:632:1392:648 |  |  | 0 | 0 | stopped | 3.531
573 | 19.100 | red | red | none | red | red | none | 1 | red:round:1380:632:1390:648 |  |  | 0 | 0 | stopped | 3.479
576 | 19.200 | red | red | none | red | red | none | 1 | red:round:1376:633:1386:648 |  |  | 0 | 0 | stopped | 3.297
579 | 19.300 | red | red | none | red | red | none | 1 | red:round:1374:633:1384:648 |  |  | 0 | 0 | stopped | 3.297
582 | 19.400 | red | red | none | red | red | none | 1 | red:unknown:1372:634:1380:648 |  |  | 0 | 0 | stopped | 3.313
585 | 19.500 | red | red | none | red | red | none | 1 | red:unknown:1370:634:1378:648 |  |  | 0 | 0 | stopped | 3.409
588 | 19.600 | red | red | none | red | red | none | 1 | red:unknown:1368:636:1376:648 |  |  | 0 | 0 | stopped | 3.409
591 | 19.700 | red | red | none | red | red | none | 1 | red:round:1366:637:1376:648 |  |  | 0 | 0 | stopped | 3.480
594 | 19.800 | red | red | none | red | red | none | 1 | red:unknown:1366:638:1375:648 |  |  | 0 | 0 | stopped | 3.480
597 | 19.900 | red | red | none | red | red | none | 1 | red:unknown:1366:640:1374:648 |  |  | 0 | 0 | stopped | 3.409
600 | 20.000 | red | red | none | red | red | none | 1 | red:unknown:1366:640:1375:648 |  |  | 0 | 0 | stopped | 2.882
603 | 20.100 | red | red | none | red | red | none | 1 | red:unknown:1368:640:1376:648 |  |  | 0 | 0 | stopped | 2.725
606 | 20.200 | red | red | none | none | none | none | 0 |  |  |  | 0 | 0 | stopped | 2.725
609 | 20.300 | red | red | none | none | none | none | 0 |  |  |  | 0 | 0 | stopped | 2.725
612 | 20.400 | red | red | none | none | none | none | 0 |  |  |  | 0 | 0 | stopped | 3.247
615 | 20.500 | red | red | none | none | none | none | 0 |  |  |  | 0 | 0 | stopped | 3.407
618 | 20.600 | red | red | none | none | none | none | 0 |  |  |  | 0 | 0 | stopped | 3.407
621 | 20.700 | red | red | none | none | none | none | 0 |  |  |  | 0 | 0 | stopped | 3.407
624 | 20.800 | red | red | none | none | none | none | 0 |  |  |  | 0 | 0 | stopped | 3.298
627 | 20.900 | red | red | none | none | none | none | 0 |  |  |  | 0 | 0 | stopped | 2.713
630 | 21.000 | red | red | none | none | none | none | 0 |  |  |  | 0 | 0 | stopped | 2.713
633 | 21.100 | red | red | none | none | none | none | 0 |  |  |  | 0 | 0 | stopped | 2.713
636 | 21.200 | red | red | none | none | none | none | 0 |  |  |  | 0 | 0 | stopped | 2.731
639 | 21.300 | red | red | none | red | red | none | 1 | red:unknown:1385:640:1394:648 |  |  | 0 | 0 | stopped | 2.731
642 | 21.400 | red | red | none | red | red | none | 1 | red:round:1384:638:1394:648 |  |  | 0 | 0 | stopped | 2.813
645 | 21.500 | red | red | none | red | red | none | 1 | red:unknown:1384:638:1393:648 |  |  | 0 | 0 | stopped | 2.731
648 | 21.600 | red | red | none | red | red | none | 1 | red:unknown:1383:634:1392:648 |  |  | 0 | 0 | stopped | 2.731
651 | 21.700 | red | red | none | red | red | none | 1 | red:unknown:1382:632:1391:646 |  |  | 0 | 0 | stopped | 2.858
654 | 21.800 | red | red | none | red | red | none | 1 | red:unknown:1382:630:1390:646 |  |  | 0 | 0 | stopped | 3.221
