Zdy-1110/FPGA-676/tools/adas/host_test/out/113421/states.csv

frame | t | sig_left | sig_straight | sig_right | raw_left | raw_straight | raw_right | n_lights | lights | left_line | right_line | left_cov | right_cov | ego_motion | motion_score
0 | 0.000 | none | none | none | none | none | none | 0 |  |  |  | 0 | 0 | moving | 0.000
3 | 0.100 | none | none | none | none | none | none | 0 |  |  |  | 0 | 0 | stopped | 4.138
6 | 0.200 | none | none | none | green | green | none | 1 | green:round:988:574:1007:590 |  |  | 0 | 0 | stopped | 4.885
9 | 0.300 | none | none | none | green | green | none | 1 | green:round:994:574:1005:588 |  |  | 0 | 0 | stopped | 5.362
12 | 0.400 | green | green | none | green | green | none | 1 | green:round:995:576:1007:590 |  |  | 0 | 0 | stopped | 5.201
15 | 0.500 | green | green | none | green | green | none | 1 | green:round:996:576:1009:592 |  |  | 0 | 0 | stopped | 5.362
18 | 0.600 | green | green | none | green | green | none | 2 | green:round:996:575:1007:594;green:round:846:578:860:590 |  |  | 0 | 0 | stopped | 5.362
21 | 0.700 | green | green | none | green | green | none | 2 | green:round:996:576:1009:593;green:round:844:578:861:594 |  |  | 0 | 0 | stopped | 5.362
24 | 0.800 | green | green | none | green | green | none | 3 | red:unknown:1839:616:1859:625;green:round:848:578:862:596;green:round:998:578:1011:592 |  |  | 0 | 0 | stopped | 5.412
27 | 0.900 | green | green | none | green | green | none | 2 | green:round:998:577:1011:592;green:round:849:579:863:593 |  |  | 0 | 0 | stopped | 5.412
30 | 1.000 | green | green | none | green | green | none | 3 | red:unknown:1844:616:1860:624;green:round:998:578:1011:593;green:round:850:579:864:594 |  |  | 0 | 0 | stopped | 5.347
33 | 1.100 | green | green | none | green | green | none | 2 | green:round:850:578:864:593;green:round:1000:578:1013:592 |  |  | 0 | 0 | stopped | 5.347
36 | 1.200 | green | green | none | green | green | none | 2 | green:round:1000:577:1013:593;green:round:850:578:865:593 |  |  | 0 | 0 | stopped | 5.347
39 | 1.300 | green | green | none | green | green | none | 2 | green:round:1000:577:1013:593;green:round:850:578:865:593 |  |  | 0 | 0 | stopped | 5.344
42 | 1.400 | green | green | none | green | green | none | 2 | green:round:849:576:864:592;green:round:1000:576:1013:591 |  |  | 0 | 0 | stopped | 5.347
45 | 1.500 | green | green | none | green | green | none | 2 | green:round:849:573:864:591;green:round:1000:576:1013:594 |  |  | 0 | 0 | stopped | 5.338
48 | 1.600 | green | green | none | green | green | none | 2 | green:round:849:572:864:590;green:round:1000:573:1013:590 |  |  | 0 | 0 | stopped | 5.479
51 | 1.700 | green | green | none | green | green | none | 2 | green:round:1000:573:1013:592;green:round:850:575:864:590 |  |  | 0 | 0 | stopped | 5.338
54 | 1.800 | green | green | none | green | green | none | 2 | green:round:850:574:865:589;green:round:1000:574:1013:592 |  |  | 0 | 0 | stopped | 5.399
57 | 1.900 | green | green | none | green | green | none | 2 | green:round:851:572:866:588;green:round:1002:572:1015:588 |  |  | 0 | 0 | stopped | 5.399
60 | 2.000 | green | green | none | green | green | none | 2 | green:round:851:569:866:587;green:round:1002:572:1015:588 |  |  | 0 | 0 | stopped | 5.598
63 | 2.100 | green | green | none | green | green | none | 2 | green:round:852:572:867:587;green:round:1003:572:1015:587 |  |  | 0 | 0 | stopped | 5.490
66 | 2.200 | green | green | none | green | green | none | 2 | green:round:853:571:868:586;green:round:1004:571:1017:586 |  |  | 0 | 0 | stopped | 5.490
69 | 2.300 | green | green | none | green | green | none | 2 | green:round:855:570:869:586;green:round:1006:571:1019:586 |  |  | 0 | 0 | stopped | 5.490
72 | 2.400 | green | green | none | green | green | none | 3 | red:unknown:1855:614:1872:624;green:round:856:570:870:585;green:round:1006:570:1020:586 |  |  | 0 | 0 | stopped | 5.490
75 | 2.500 | green | green | none | green | green | none | 2 | green:round:1009:567:1021:584;green:round:857:569:872:584 |  |  | 0 | 0 | stopped | 5.490
78 | 2.600 | green | green | none | green | green | none | 2 | green:round:1011:567:1024:586;green:round:859:568:874:584 |  |  | 0 | 0 | stopped | 6.084
81 | 2.700 | green | green | none | green | green | none | 2 | green:round:862:568:876:584;green:round:1012:568:1027:583 |  |  | 0 | 0 | stopped | 6.737
84 | 2.800 | green | green | none | green | green | none | 2 | green:round:864:568:879:583;green:round:1016:568:1029:584 |  |  | 0 | 0 | stopped | 6.737
87 | 2.900 | green | green | none | green | green | none | 2 | green:round:867:568:882:583;green:round:1019:568:1033:583 |  |  | 0 | 0 | stopped | 6.737
90 | 3.000 | green | green | none | green | green | none | 2 | green:round:869:568:884:584;green:round:1022:568:1035:584 |  |  | 0 | 0 | stopped | 6.624
93 | 3.100 | green | green | none | green | green | none | 2 | green:round:1024:568:1039:586;green:round:872:569:887:585 |  |  | 0 | 0 | stopped | 6.624
96 | 3.200 | green | green | none | green | green | none | 2 | green:round:874:570:889:586;green:round:1027:570:1041:587 |  |  | 0 | 0 | stopped | 6.624
99 | 3.300 | green | green | none | green | green | none | 2 | green:round:876:572:891:588;green:round:1029:572:1043:588 |  |  | 0 | 0 | stopped | 6.833
102 | 3.400 | green | green | none | green | green | none | 2 | green:round:1031:572:1045:589;green:round:878:573:892:588 |  |  | 0 | 0 | stopped | 6.889
105 | 3.500 | green | green | none | green | green | none | 2 | green:round:1033:573:1048:590;green:round:879:574:894:590 |  |  | 0 | 0 | stopped | 6.925
108 | 3.600 | green | green | none | green | green | none | 2 | green:round:1035:574:1051:592;green:round:881:576:896:592 |  |  | 0 | 0 | stopped | 6.925
111 | 3.700 | green | green | none | green | green | none | 2 | green:round:1037:576:1053:592;green:round:882:577:897:593 |  |  | 0 | 0 | stopped | 6.925
114 | 3.800 | green | green | none | green | green | none | 2 | green:round:1039:576:1055:593;green:round:883:578:898:594 |  |  | 0 | 0 | stopped | 6.925
117 | 3.900 | green | green | none | green | green | none | 2 | green:round:885:576:900:595;green:round:1041:578:1057:594 |  |  | 0 | 0 | stopped | 6.925
120 | 4.000 | green | green | none | green | green | none | 2 | green:round:1042:578:1058:595;green:round:886:580:901:596 |  |  | 0 | 0 | stopped | 6.972
123 | 4.100 | green | green | none | green | green | none | 2 | green:round:1044:578:1061:594;green:round:887:580:902:596 |  |  | 0 | 0 | stopped | 7.048
126 | 4.200 | green | green | none | green | green | none | 2 | green:round:1047:578:1062:595;green:round:889:580:904:596 |  |  | 0 | 0 | stopped | 7.199
129 | 4.300 | green | green | none | green | green | none | 2 | green:round:1049:578:1064:595;green:round:890:580:906:596 |  |  | 0 | 0 | stopped | 7.286
132 | 4.400 | green | green | none | green | green | none | 2 | green:round:1051:576:1069:593;green:round:892:578:907:594 |  |  | 0 | 0 | stopped | 7.286
135 | 4.500 | green | green | none | green | green | none | 2 | green:round:1054:574:1072:592;green:round:894:577:909:593 |  |  | 0 | 0 | stopped | 7.365
138 | 4.600 | green | green | none | green | green | none | 2 | green:round:1056:575:1073:591;green:round:895:576:911:592 |  |  | 0 | 0 | stopped | 7.886
141 | 4.700 | green | green | none | green | green | none | 2 | green:round:1059:572:1076:589;green:round:897:575:912:591 |  |  | 0 | 0 | stopped | 7.886
144 | 4.800 | green | green | none | green | green | none | 2 | green:round:1061:570:1076:587;green:round:898:573:914:590 |  |  | 0 | 0 | stopped | 7.886
147 | 4.900 | green | green | none | green | green | none | 2 | green:round:1062:571:1078:587;green:round:898:572:914:589 |  |  | 0 | 0 | stopped | 7.820
150 | 5.000 | green | green | none | green | green | none | 2 | green:round:1063:571:1078:587;green:round:898:573:914:589 |  |  | 0 | 0 | stopped | 7.641
153 | 5.100 | green | green | none | green | green | none | 2 | green:round:1063:571:1079:587;green:round:898:572:914:589 |  |  | 0 | 0 | stopped | 7.247
156 | 5.200 | green | green | none | green | green | none | 2 | green:round:1064:570:1080:586;green:round:897:572:913:588 |  |  | 0 | 0 | stopped | 7.191
159 | 5.300 | green | green | none | green | green | none | 2 | green:round:1064:568:1080:584;green:round:896:569:912:586 |  |  | 0 | 0 | stopped | 7.191
162 | 5.400 | green | green | none | green | green | none | 2 | green:round:894:560:910:581;green:round:1064:562:1080:578 |  |  | 0 | 0 | stopped | 7.247
165 | 5.500 | green | green | none | green | green | none | 2 | green:round:1062:554:1078:571;green:round:892:556:908:573 |  |  | 0 | 0 | stopped | 8.199
168 | 5.600 | green | green | none | green | green | none | 2 | green:round:1065:552:1081:569;green:round:892:554:909:572 |  |  | 0 | 0 | stopped | 9.168
171 | 5.700 | green | green | none | green | green | none | 2 | green:round:1063:559:1080:576;green:round:890:562:907:579 |  |  | 0 | 0 | stopped | 9.168
174 | 5.800 | green | green | none | green | green | none | 2 | green:round:1064:558:1081:575;green:round:891:561:908:579 |  |  | 0 | 0 | stopped | 9.168
177 | 5.900 | green | green | none | green | green | none | 2 | green:round:1066:556:1083:574;green:round:891:560:908:578 |  |  | 0 | 0 | stopped | 8.495
180 | 6.000 | green | green | none | green | green | none | 3 | green:round:1068:551:1085:570;green:round:891:556:908:574;green:round:1586:603:1601:627 |  |  | 0 | 0 | stopped | 8.495
183 | 6.100 | green | green | none | green | green | none | 3 | green:round:1070:544:1087:564;green:round:892:552:909:569;green:unknown:1602:594:1619:619 |  |  | 0 | 0 | stopped | 8.495
186 | 6.200 | green | green | none | green | green | none | 3 | green:round:1080:546:1097:564;green:round:900:551:918:569;green:round:1627:590:1644:615 |  |  | 0 | 0 | stopped | 8.210
189 | 6.300 | green | green | none | green | green | none | 3 | green:round:1087:544:1104:563;green:round:906:551:923:569;green:unknown:1650:585:1667:611 |  |  | 0 | 0 | stopped | 8.210
192 | 6.400 | green | green | none | green | green | none | 3 | green:round:1092:542:1110:562;green:round:910:549:927:568;green:round:1672:581:1689:607 |  |  | 0 | 0 | stopped | 8.210
195 | 6.500 | green | green | none | green | green | none | 3 | green:round:1098:544:1116:561;green:round:914:548:931:567;green:round:1696:578:1714:604 |  |  | 0 | 0 | stopped | 7.908
198 | 6.600 | green | green | none | green | green | none | 3 | green:round:1103:543:1121:561;green:round:918:548:935:567;green:round:1722:576:1740:603 |  |  | 0 | 0 | stopped | 7.908
201 | 6.700 | green | green | none | green | green | none | 3 | green:round:1107:544:1124:562;green:round:919:549:937:567;green:unknown:1746:575:1765:602 |  |  | 0 | 0 | stopped | 7.908
204 | 6.800 | green | green | none | green | green | none | 3 | green:round:1110:545:1128:562;green:round:921:549:939:568;green:unknown:1772:573:1791:601 |  |  | 0 | 0 | stopped | 8.771
207 | 6.900 | green | green | none | green | green | none | 3 | green:round:1113:543:1131:561;green:round:922:548:940:567;green:unknown:1800:568:1819:596 |  |  | 0 | 0 | stopped | 9.316
210 | 7.000 | green | green | none | green | green | none | 3 | green:round:1116:543:1134:562;green:round:923:548:941:567;green:unknown:1828:564:1848:593 |  |  | 0 | 0 | stopped | 9.609
213 | 7.100 | green | green | none | green | green | none | 3 | green:round:1119:542:1137:560;green:round:924:546:942:566;green:unknown:1859:559:1879:588 |  |  | 0 | 0 | stopped | 9.671
216 | 7.200 | green | green | none | green | green | none | 3 | green:round:1121:541:1140:560;green:round:924:546:943:566;green:unknown:1892:555:1913:586 |  |  | 0 | 0 | stopped | 9.673
219 | 7.300 | green | green | none | green | green | none | 2 | green:round:1125:545:1144:563;green:round:926:549:944:569 |  |  | 0 | 0 | stopped | 9.673
222 | 7.400 | green | green | none | green | green | none | 2 | green:round:1128:546:1147:565;green:round:927:551:946:571 |  |  | 0 | 0 | moving | 10.463
225 | 7.500 | green | green | none | green | green | none | 2 | green:round:1132:545:1151:564;green:round:929:549:948:569 |  |  | 0 | 0 | moving | 11.101
228 | 7.600 | green | green | none | green | green | none | 2 | green:round:1136:540:1156:560;green:round:930:544:950:565 |  |  | 0 | 0 | moving | 11.814
231 | 7.700 | green | green | none | green | green | none | 2 | green:round:1143:538:1162:557;green:round:935:542:954:562 |  |  | 0 | 0 | moving | 11.923
234 | 7.800 | green | green | none | green | green | none | 2 | green:round:1149:534:1169:554;green:round:939:539:958:559 |  |  | 0 | 0 | moving | 11.814
237 | 7.900 | green | green | none | green | green | none | 2 | green:round:1154:530:1174:550;green:round:941:535:961:556 |  |  | 0 | 0 | moving | 11.101
240 | 8.000 | green | green | none | green | green | none | 2 | green:round:1160:526:1181:546;green:round:945:530:965:551 |  |  | 0 | 0 | moving | 11.829
243 | 8.100 | green | green | none | green | green | none | 2 | green:round:1165:522:1186:542;green:round:947:527:967:548 |  |  | 0 | 0 | moving | 11.406
246 | 8.200 | green | green | none | green | green | none | 2 | green:round:1170:518:1191:539;green:round:948:523:969:545 |  |  | 0 | 0 | moving | 11.406
249 | 8.300 | green | green | none | green | green | none | 2 | green:round:1173:517:1194:538;green:round:949:522:970:544 |  |  | 0 | 0 | moving | 11.406
252 | 8.400 | green | green | none | green | green | none | 2 | green:round:1178:514:1200:535;green:round:950:520:972:542 |  |  | 0 | 0 | moving | 11.406
255 | 8.500 | green | green | none | green | green | none | 2 | green:round:1183:512:1205:533;green:round:952:517:974:540 |  |  | 0 | 0 | moving | 10.847
258 | 8.600 | green | green | none | green | green | none | 2 | green:round:1189:508:1212:529;green:round:955:513:977:536 |  |  | 0 | 0 | moving | 10.614
261 | 8.700 | green | green | none | green | green | none | 2 | green:round:1196:503:1218:525;green:round:958:508:980:531 |  |  | 0 | 0 | moving | 10.421
264 | 8.800 | green | green | none | green | green | none | 2 | green:round:1202:497:1224:519;green:round:960:502:982:525 |  |  | 0 | 0 | moving | 10.114
267 | 8.900 | green | green | none | green | green | none | 2 | green:round:1210:493:1233:516;green:round:964:498:987:522 |  |  | 0 | 0 | moving | 9.959
270 | 9.000 | green | green | none | green | green | none | 2 | green:round:1219:486:1242:509;green:round:968:491:991:514 |  |  | 0 | 0 | moving | 9.959
273 | 9.100 | green | green | none | green | green | none | 2 | green:round:1228:478:1251:501;green:round:973:482:996:506 |  |  | 0 | 0 | moving | 9.959
276 | 9.200 | green | green | none | green | green | none | 2 | green:round:1236:469:1260:493;green:round:976:473:1000:497 |  |  | 0 | 0 | moving | 11.232
279 | 9.300 | green | green | none | green | green | none | 2 | green:round:1245:462:1270:486;green:round:981:466:1005:490 |  |  | 0 | 0 | moving | 11.942
282 | 9.400 | green | green | none | green | green | none | 2 | green:round:1259:446:1284:471;green:round:989:450:1014:475 |  |  | 0 | 0 | moving | 12.414
285 | 9.500 | green | green | none | green | green | none | 2 | green:round:1270:434:1296:460;green:round:996:439:1021:464 |  |  | 0 | 0 | moving | 12.788
288 | 9.600 | green | green | none | green | green | none | 2 | green:round:1283:420:1309:446;green:round:1002:426:1028:451 |  |  | 0 | 0 | moving | 12.788
291 | 9.700 | green | green | none | green | green | none | 2 | green:round:1292:414:1319:440;green:round:1006:420:1031:447 |  |  | 0 | 0 | moving | 13.110
294 | 9.800 | green | green | none | green | green | none | 2 | green:round:1300:408:1327:434;green:round:1007:415:1034:442 |  |  | 0 | 0 | moving | 13.479
297 | 9.900 | green | green | none | green | green | none | 2 | green:round:1315:403:1342:430;green:round:1016:409:1043:436 |  |  | 0 | 0 | moving | 13.479
300 | 10.000 | green | green | none | green | green | none | 2 | green:round:1326:400:1354:428;green:round:1020:405:1048:433 |  |  | 0 | 0 | moving | 21.182
303 | 10.100 | green | green | none | green | green | none | 2 | green:round:1340:397:1368:425;green:round:1027:400:1055:428 |  |  | 0 | 0 | moving | 23.084
306 | 10.200 | green | green | none | green | green | none | 2 | green:round:1354:388:1383:416;green:round:1034:389:1062:418 |  |  | 0 | 0 | moving | 23.084
309 | 10.300 | green | green | none | green | green | none | 2 | green:round:1370:381:1400:410;green:round:1041:382:1070:411 |  |  | 0 | 0 | moving | 23.084
312 | 10.400 | green | green | none | green | green | none | 2 | green:round:1048:371:1079:402;green:round:1386:372:1417:403 |  |  | 0 | 0 | moving | 16.574
315 | 10.500 | green | green | none | green | green | none | 2 | green:round:1056:366:1087:397;green:round:1402:368:1434:399 |  |  | 0 | 0 | moving | 14.724
318 | 10.600 | green | green | none | green | green | none | 2 | green:round:1063:357:1094:389;green:round:1418:360:1450:391 |  |  | 0 | 0 | moving | 14.724
321 | 10.700 | green | green | none | green | green | none | 2 | green:round:1071:348:1104:381;green:round:1436:351:1470:384 |  |  | 0 | 0 | moving | 14.724
324 | 10.800 | green | green | none | green | green | none | 2 | green:round:1077:338:1111:372;green:round:1452:340:1486:374 |  |  | 0 | 0 | moving | 14.231
327 | 10.900 | green | green | none | green | green | none | 2 | green:round:1084:328:1118:362;green:round:1470:329:1505:364 |  |  | 0 | 0 | moving | 14.231
330 | 11.000 | green | green | none | green | green | none | 2 | green:round:1094:312:1129:348;green:round:1492:314:1528:349 |  |  | 0 | 0 | moving | 14.210
333 | 11.100 | green | green | none | green | green | none | 2 | green:round:1104:299:1140:335;green:round:1515:300:1551:336 |  |  | 0 | 0 | moving | 12.249
336 | 11.200 | green | green | none | green | green | none | 2 | green:round:1113:287:1151:325;green:round:1538:288:1576:326 |  |  | 0 | 0 | moving | 11.313
339 | 11.300 | green | green | none | green | green | none | 2 | green:round:1562:272:1601:312;green:round:1124:273:1162:311 |  |  | 0 | 0 | moving | 11.240
342 | 11.400 | green | green | none | green | green | none | 2 | green:round:1588:256:1628:298;green:round:1135:258:1175:297 |  |  | 0 | 0 | moving | 10.595
345 | 11.500 | green | green | none | green | green | none | 2 | green:round:1145:236:1188:277;green:round:1616:236:1658:277 |  |  | 0 | 0 | moving | 10.595
348 | 11.600 | green | green | none | green | green | none | 2 | green:round:1157:212:1203:255;green:round:1647:212:1691:254 |  |  | 0 | 0 | moving | 10.903
351 | 11.700 | green | green | none | green | green | none | 2 | green:round:1682:186:1728:231;green:round:1174:187:1221:232 |  |  | 0 | 0 | moving | 10.490
354 | 11.800 | green | green | none | green | green | none | 2 | green:round:1192:164:1239:211;green:round:1720:164:1767:210 |  |  | 0 | 0 | moving | 10.490
357 | 11.900 | green | green | none | green | green | none | 2 | green:round:1210:133:1261:182;green:round:1764:133:1813:181 |  |  | 0 | 0 | moving | 10.903
360 | 12.000 | green | green | none | green | green | none | 2 | green:round:1234:100:1286:150;green:round:1814:100:1863:151 |  |  | 0 | 0 | moving | 11.000
363 | 12.100 | green | green | none | green | green | none | 2 | green:round:1262:65:1314:117;green:round:1871:66:1920:117 |  |  | 0 | 0 | moving | 11.000
366 | 12.200 | green | green | none | none | none | green | 1 | green:right:1310:38:1344:79 |  |  | 0 | 0 | moving | 11.089
369 | 12.300 | green | green | none | none | none | green | 1 | green:right:1354:0:1379:31 |  |  | 0 | 0 | moving | 11.940
372 | 12.400 | green | green | none | red | red | none | 4 | red:unknown:1304:556:1324:564;red:unknown:1274:568:1343:638;green:unknown:1874:585:1913:611;green:unknown:1875:609:1909:633 |  |  | 0 | 0 | moving | 13.008
375 | 12.500 | green | green | none | red | red | none | 2 | red:unknown:1294:562:1364:631;red:round:1670:572:1698:636 |  |  | 0 | 0 | moving | 13.008
378 | 12.600 | red | red | none | red | red | none | 1 | red:unknown:1312:550:1382:623 |  |  | 0 | 0 | moving | 13.008
381 | 12.700 | red | red | none | red | red | red | 2 | red:unknown:1332:538:1406:613;red:right:1678:600:1693:614 |  |  | 0 | 0 | moving | 12.957
384 | 12.800 | red | red | none | red | red | none | 1 | red:unknown:1350:528:1427:606 |  |  | 0 | 0 | moving | 12.660
387 | 12.900 | red | red | none | red | red | none | 3 | red:unknown:1370:522:1448:602;red:unknown:1702:546:1742:616;green:round:1415:545:1437:575 |  |  | 0 | 0 | moving | 12.660
390 | 13.000 | red | red | none | green | green | none | 3 | red:unknown:1450:439:1469:484;yellow:round:1705:556:1718:570;green:round:1437:537:1461:569 |  |  | 0 | 0 | moving | 12.957
