Zdy-1110/FPGA-676/tools/adas/host_test/out/113452/states.csv

frame | t | sig_left | sig_straight | sig_right | raw_left | raw_straight | raw_right | n_lights | lights | left_line | right_line | left_cov | right_cov | ego_motion | motion_score
0 | 0.000 | none | none | none | yellow | yellow | none | 1 | yellow:unknown:1591:24:1600:37 |  |  | 0 | 0 | moving | 0.000
3 | 0.100 | none | none | none | yellow | yellow | none | 1 | yellow:unknown:1611:8:1622:18 |  |  | 0 | 0 | moving | 10.039
6 | 0.200 | yellow | yellow | none | yellow | yellow | yellow | 2 | yellow:unknown:1618:22:1626:30;yellow:right:1646:30:1658:40 |  |  | 0 | 0 | moving | 10.965
9 | 0.300 | yellow | yellow | none | none | none | none | 0 |  |  |  | 0 | 0 | moving | 11.891
12 | 0.400 | yellow | yellow | none | yellow | yellow | none | 1 | yellow:unknown:1473:543:1488:551 |  |  | 0 | 0 | moving | 11.995
15 | 0.500 | yellow | yellow | none | yellow | yellow | yellow | 3 | yellow:unknown:1488:542:1499:551;yellow:right:1536:544:1572:587;yellow:right:1473:550:1484:560 |  |  | 0 | 0 | moving | 11.891
18 | 0.600 | yellow | yellow | none | yellow | yellow | none | 1 | yellow:unknown:1702:70:1724:80 |  |  | 0 | 0 | moving | 11.891
21 | 0.700 | yellow | yellow | yellow | yellow | yellow | yellow | 3 | yellow:left:1538:531:1555:554;yellow:right:1557:545:1592:588;yellow:unknown:1560:572:1570:589 |  |  | 0 | 0 | moving | 11.481
24 | 0.800 | yellow | yellow | yellow | none | none | yellow | 1 | yellow:right:1812:236:1824:248 |  |  | 0 | 0 | moving | 11.398
27 | 0.900 | yellow | yellow | yellow | yellow | yellow | none | 1 | yellow:unknown:1566:4:1579:14 |  |  | 0 | 0 | moving | 11.373
30 | 1.000 | yellow | yellow | yellow | yellow | yellow | none | 2 | yellow:unknown:1578:0:1587:8;yellow:unknown:1620:10:1642:26 |  |  | 0 | 0 | moving | 11.398
33 | 1.100 | yellow | yellow | yellow | yellow | yellow | none | 1 | yellow:unknown:1726:290:1737:298 |  |  | 0 | 0 | moving | 11.398
36 | 1.200 | yellow | yellow | yellow | none | yellow | none | 1 | yellow:straight:1776:270:1788:280 |  |  | 0 | 0 | moving | 11.617
39 | 1.300 | yellow | yellow | yellow | yellow | yellow | none | 1 | yellow:unknown:1826:246:1837:256 |  |  | 0 | 0 | moving | 11.751
42 | 1.400 | yellow | yellow | yellow | red | red | none | 2 | red:unknown:754:626:763:636;yellow:unknown:1644:584:1652:602 |  |  | 0 | 0 | moving | 12.061
45 | 1.500 | yellow | yellow | yellow | yellow | yellow | none | 1 | yellow:unknown:1248:422:1258:430 |  |  | 0 | 0 | moving | 12.543
48 | 1.600 | yellow | yellow | yellow | none | none | yellow | 1 | yellow:right:1756:62:1766:74 |  |  | 0 | 0 | moving | 12.543
51 | 1.700 | yellow | yellow | yellow | yellow | yellow | none | 1 | yellow:unknown:1812:21:1821:33 |  |  | 0 | 0 | moving | 12.519
54 | 1.800 | yellow | yellow | yellow | yellow | yellow | none | 1 | yellow:unknown:1270:402:1286:410 |  |  | 0 | 0 | moving | 12.519
57 | 1.900 | yellow | yellow | yellow | yellow | yellow | none | 1 | yellow:unknown:1278:392:1294:402 |  |  | 0 | 0 | moving | 11.170
60 | 2.000 | yellow | yellow | yellow | yellow | yellow | none | 1 | yellow:round:1602:280:1614:290 |  |  | 0 | 0 | moving | 11.057
63 | 2.100 | yellow | yellow | yellow | yellow | yellow | yellow | 2 | yellow:right:1645:564:1702:612;yellow:round:1586:566:1613:583 |  |  | 0 | 0 | moving | 11.057
66 | 2.200 | yellow | yellow | yellow | yellow | yellow | none | 1 | yellow:unknown:1456:316:1480:327 |  |  | 0 | 0 | moving | 11.170
69 | 2.300 | yellow | yellow | yellow | yellow | yellow | none | 2 | yellow:unknown:1508:298:1518:306;yellow:unknown:1473:304:1492:317 |  |  | 0 | 0 | moving | 13.006
72 | 2.400 | yellow | yellow | yellow | yellow | none | none | 1 | yellow:left:1489:292:1510:312 |  |  | 0 | 0 | moving | 14.723
75 | 2.500 | yellow | yellow | yellow | yellow | yellow | none | 2 | yellow:unknown:1546:270:1556:280;yellow:unknown:1510:280:1522:292 |  |  | 0 | 0 | moving | 14.742
78 | 2.600 | yellow | yellow | yellow | none | none | yellow | 1 | yellow:right:1611:568:1641:592 |  |  | 0 | 0 | moving | 14.723
81 | 2.700 | yellow | yellow | yellow | yellow | yellow | none | 3 | red:unknown:744:640:756:648;yellow:unknown:1616:564:1658:592;yellow:unknown:1704:579:1721:616 |  |  | 0 | 0 | moving | 14.723
84 | 2.800 | yellow | yellow | yellow | yellow | yellow | none | 1 | yellow:unknown:1620:564:1664:590 |  |  | 0 | 0 | moving | 13.316
87 | 2.900 | yellow | yellow | yellow | yellow | yellow | none | 1 | yellow:unknown:1524:158:1540:168 |  |  | 0 | 0 | moving | 12.219
90 | 3.000 | yellow | yellow | yellow | none | yellow | none | 1 | yellow:straight:1540:136:1560:152 |  |  | 0 | 0 | moving | 11.916
93 | 3.100 | yellow | yellow | yellow | none | none | yellow | 1 | yellow:right:1564:114:1588:148 |  |  | 0 | 0 | moving | 10.926
96 | 3.200 | yellow | yellow | yellow | yellow | yellow | yellow | 2 | yellow:right:1588:92:1608:114;yellow:unknown:1666:106:1680:116 |  |  | 0 | 0 | moving | 10.926
99 | 3.300 | yellow | yellow | yellow | yellow | yellow | yellow | 2 | yellow:right:1612:66:1640:104;yellow:unknown:1694:80:1710:90 |  |  | 0 | 0 | moving | 12.219
102 | 3.400 | yellow | yellow | yellow | none | yellow | yellow | 3 | yellow:right:1638:40:1666:79;yellow:right:1726:52:1740:64;yellow:straight:1828:80:1842:100 |  |  | 0 | 0 | moving | 12.801
105 | 3.500 | yellow | yellow | yellow | yellow | yellow | yellow | 3 | yellow:unknown:1798:0:1820:12;yellow:right:1661:10:1696:48;yellow:unknown:1758:22:1774:34 |  |  | 0 | 0 | moving | 12.801
108 | 3.600 | yellow | yellow | yellow | none | none | yellow | 1 | yellow:right:1765:36:1776:50 |  |  | 0 | 0 | moving | 12.801
111 | 3.700 | yellow | yellow | yellow | yellow | yellow | none | 3 | yellow:unknown:1807:2:1816:18;yellow:left:1824:6:1846:22;yellow:unknown:1777:15:1796:28 |  |  | 0 | 0 | moving | 10.377
114 | 3.800 | yellow | yellow | yellow | yellow | yellow | none | 2 | yellow:unknown:1816:48:1830:56;yellow:unknown:1801:78:1816:86 |  |  | 0 | 0 | moving | 10.041
117 | 3.900 | yellow | yellow | yellow | yellow | yellow | yellow | 5 | yellow:unknown:1766:54:1782:62;yellow:right:1578:76:1592:88;yellow:unknown:1689:76:1697:91;yellow:unknown:1738:76:1757:88;yellow:unknown:1836:82:1844:90 |  |  | 0 | 0 | moving | 10.041
120 | 4.000 | yellow | yellow | yellow | yellow | yellow | yellow | 3 | yellow:right:1604:50:1622:66;yellow:unknown:1880:50:1890:58;yellow:left:1746:70:1766:96 |  |  | 0 | 0 | moving | 10.041
123 | 4.100 | yellow | yellow | yellow | yellow | yellow | yellow | 2 | yellow:right:1765:32:1780:47;yellow:unknown:1788:58:1804:66 |  |  | 0 | 0 | moving | 10.078
126 | 4.200 | yellow | yellow | yellow | yellow | yellow | none | 1 | yellow:unknown:1810:3:1820:16 |  |  | 0 | 0 | moving | 10.211
129 | 4.300 | yellow | yellow | yellow | yellow | yellow | none | 2 | yellow:unknown:1836:552:1868:610;yellow:round:1718:562:1749:586 |  |  | 0 | 0 | moving | 10.375
132 | 4.400 | yellow | yellow | yellow | yellow | yellow | none | 1 | yellow:unknown:1816:92:1838:102 |  |  | 0 | 0 | moving | 10.443
135 | 4.500 | yellow | yellow | yellow | yellow | yellow | yellow | 3 | yellow:unknown:1798:538:1873:608;yellow:right:1845:542:1860:553;yellow:right:1742:556:1776:580 |  |  | 0 | 0 | moving | 10.553
138 | 4.600 | yellow | yellow | yellow | yellow | yellow | none | 2 | yellow:unknown:1812:544:1902:606;yellow:round:1758:556:1783:576 |  |  | 0 | 0 | moving | 10.553
141 | 4.700 | yellow | yellow | yellow | yellow | yellow | yellow | 5 | yellow:right:1829:543:1912:602;yellow:unknown:1828:548:1837:559;yellow:right:1772:552:1792:570;yellow:unknown:1828:560:1839:573;yellow:left:1761:572:1774:582 |  |  | 0 | 0 | moving | 10.553
144 | 4.800 | yellow | yellow | yellow | yellow | yellow | none | 2 | yellow:unknown:1846:535:1920:600;yellow:round:1786:548:1801:560 |  |  | 0 | 0 | moving | 10.430
147 | 4.900 | yellow | yellow | yellow | yellow | yellow | yellow | 3 | yellow:unknown:1868:533:1878:542;yellow:right:1862:534:1920:596;yellow:unknown:1778:562:1804:573 |  |  | 0 | 0 | moving | 9.951
150 | 5.000 | yellow | yellow | yellow | yellow | yellow | none | 2 | yellow:unknown:1880:528:1920:590;yellow:unknown:1781:557:1814:571 |  |  | 0 | 0 | moving | 9.901
153 | 5.100 | yellow | yellow | yellow | yellow | yellow | yellow | 3 | yellow:right:1856:514:1882:544;yellow:unknown:1897:544:1920:584;yellow:unknown:1794:552:1828:568 |  |  | 0 | 0 | moving | 9.867
156 | 5.200 | yellow | yellow | yellow | yellow | yellow | none | 2 | yellow:unknown:1866:510:1896:554;yellow:unknown:1808:546:1840:562 |  |  | 0 | 0 | moving | 9.901
159 | 5.300 | yellow | yellow | yellow | yellow | none | none | 1 | yellow:left:1478:144:1492:157 |  |  | 0 | 0 | moving | 9.901
162 | 5.400 | yellow | yellow | yellow | yellow | yellow | none | 1 | yellow:round:1554:354:1566:365 |  |  | 0 | 0 | moving | 9.993
165 | 5.500 | yellow | yellow | yellow | yellow | yellow | none | 2 | yellow:round:1864:528:1875:542;yellow:unknown:1912:530:1920:541 |  |  | 0 | 0 | moving | 10.164
168 | 5.600 | yellow | yellow | yellow | yellow | yellow | none | 1 | yellow:unknown:1835:520:1858:552 |  |  | 0 | 0 | moving | 10.186
171 | 5.700 | yellow | yellow | yellow | yellow | yellow | none | 1 | yellow:round:1858:514:1886:546 |  |  | 0 | 0 | moving | 10.476
174 | 5.800 | yellow | yellow | yellow | yellow | yellow | none | 1 | yellow:unknown:1152:296:1160:308 |  |  | 0 | 0 | moving | 10.476
177 | 5.900 | yellow | yellow | yellow | yellow | yellow | none | 1 | yellow:round:1884:506:1896:534 |  |  | 0 | 0 | moving | 10.476
180 | 6.000 | yellow | yellow | yellow | yellow | yellow | none | 1 | yellow:round:1901:500:1920:528 |  |  | 0 | 0 | moving | 10.186
183 | 6.100 | yellow | yellow | yellow | yellow | yellow | none | 1 | yellow:unknown:1876:506:1889:515 |  |  | 0 | 0 | moving | 10.145
186 | 6.200 | yellow | yellow | yellow | none | none | yellow | 1 | yellow:right:1885:502:1906:518 |  |  | 0 | 0 | moving | 10.098
189 | 6.300 | yellow | yellow | yellow | none | none | yellow | 1 | yellow:right:1892:495:1920:522 |  |  | 0 | 0 | moving | 10.145
192 | 6.400 | yellow | yellow | yellow | red | red | none | 2 | red:round:676:596:688:607;red:round:766:598:779:609 |  |  | 0 | 0 | moving | 10.141
195 | 6.500 | yellow | yellow | yellow | yellow | none | none | 1 | yellow:left:1536:370:1550:380 |  |  | 0 | 0 | moving | 10.098
198 | 6.600 | yellow | yellow | yellow | red | red | none | 2 | red:round:679:594:689:604;red:round:770:594:782:606 |  |  | 0 | 0 | moving | 10.141
201 | 6.700 | yellow | yellow | yellow | yellow | yellow | none | 1 | yellow:unknown:1680:112:1688:129 |  |  | 0 | 0 | moving | 10.141
204 | 6.800 | yellow | yellow | yellow | yellow | none | none | 1 | yellow:left:1896:330:1908:344 |  |  | 0 | 0 | moving | 9.869
207 | 6.900 | yellow | yellow | yellow | red | red | none | 2 | red:round:682:594:692:604;red:round:774:594:786:606 |  |  | 0 | 0 | moving | 9.869
210 | 7.000 | yellow | yellow | yellow | yellow | yellow | none | 1 | yellow:unknown:1754:82:1764:90 |  |  | 0 | 0 | moving | 9.979
213 | 7.100 | yellow | yellow | yellow | yellow | none | none | 1 | yellow:left:1796:44:1807:54 |  |  | 0 | 0 | moving | 9.613
216 | 7.200 | yellow | yellow | yellow | yellow | yellow | none | 1 | yellow:unknown:1844:0:1856:8 |  |  | 0 | 0 | moving | 9.979
219 | 7.300 | yellow | yellow | yellow | yellow | yellow | none | 1 | yellow:unknown:1808:119:1824:128 |  |  | 0 | 0 | moving | 10.144
222 | 7.400 | yellow | yellow | yellow | red | red | none | 2 | red:round:696:580:706:590;red:round:788:580:802:592 |  |  | 0 | 0 | moving | 10.983
225 | 7.500 | yellow | yellow | yellow | red | red | none | 2 | red:round:699:574:710:586;red:round:792:574:806:588 |  |  | 0 | 0 | moving | 11.528
228 | 7.600 | red | red | yellow | red | red | none | 2 | red:round:703:570:714:581;red:round:797:570:810:582 |  |  | 0 | 0 | moving | 12.168
231 | 7.700 | red | red | yellow | red | red | none | 2 | red:round:706:564:717:576;red:round:801:566:814:578 |  |  | 0 | 0 | moving | 12.176
234 | 7.800 | red | red | yellow | red | red | none | 2 | red:round:706:558:720:570;red:round:804:559:816:572 |  |  | 0 | 0 | moving | 12.176
237 | 7.900 | red | red | yellow | red | red | none | 2 | red:round:712:552:723:563;red:round:808:552:820:565 |  |  | 0 | 0 | moving | 12.737
240 | 8.000 | red | red | yellow | red | red | none | 2 | red:round:714:544:726:555;red:round:810:544:824:558 |  |  | 0 | 0 | moving | 13.414
243 | 8.100 | red | red | yellow | red | red | none | 2 | red:round:716:536:728:548;red:round:814:536:826:550 |  |  | 0 | 0 | moving | 13.544
246 | 8.200 | red | red | yellow | red | red | none | 2 | red:round:717:530:728:541;red:round:814:530:828:543 |  |  | 0 | 0 | moving | 13.544
249 | 8.300 | red | red | yellow | red | red | none | 3 | red:round:717:522:728:534;red:round:814:522:828:536;red:unknown:392:540:400:556 |  |  | 0 | 0 | moving | 13.414
252 | 8.400 | red | red | none | red | red | none | 2 | red:round:717:516:729:528;red:round:814:516:828:530 |  |  | 0 | 0 | moving | 12.351
255 | 8.500 | red | red | none | yellow | yellow | none | 1 | yellow:unknown:1880:114:1895:122 |  |  | 0 | 0 | moving | 12.351
258 | 8.600 | red | red | none | red | red | none | 3 | red:round:720:507:731:519;red:round:818:508:832:521;red:unknown:356:515:364:530 |  |  | 0 | 0 | moving | 12.341
261 | 8.700 | red | red | none | red | red | none | 2 | red:round:720:507:731:519;red:round:818:508:832:521 |  |  | 0 | 0 | moving | 12.315
264 | 8.800 | red | red | none | yellow | yellow | none | 1 | yellow:unknown:1760:36:1775:46 |  |  | 0 | 0 | moving | 11.577
267 | 8.900 | red | red | none | red | red | none | 3 | red:unknown:316:501:324:520;red:round:717:504:729:516;red:round:818:504:830:518 |  |  | 0 | 0 | moving | 11.577
270 | 9.000 | red | red | none | red | red | none | 3 | red:unknown:304:496:312:512;red:round:718:500:730:513;red:round:818:503:832:516 |  |  | 0 | 0 | moving | 11.577
273 | 9.100 | red | red | none | red | red | none | 3 | red:unknown:294:490:302:508;red:round:721:498:732:510;red:round:822:500:834:513 |  |  | 0 | 0 | moving | 9.221
276 | 9.200 | red | red | none | red | red | none | 3 | red:unknown:282:482:290:502;red:round:722:496:734:508;red:round:824:496:836:510 |  |  | 0 | 0 | moving | 9.221
279 | 9.300 | red | red | none | red | red | none | 4 | red:round:270:478:280:500;red:round:724:494:736:506;red:round:824:494:838:508;yellow:round:243:518:254:529 |  |  | 0 | 0 | moving | 12.229
282 | 9.400 | red | red | none | red | red | none | 3 | red:round:258:472:268:494;red:round:722:490:736:504;red:round:826:492:838:506 |  |  | 0 | 0 | moving | 11.290
285 | 9.500 | red | red | none | red | red | none | 3 | red:round:246:466:256:490;red:round:724:490:736:502;red:round:826:490:840:504 |  |  | 0 | 0 | moving | 10.367
288 | 9.600 | red | red | none | red | red | none | 3 | red:round:234:462:244:486;red:round:724:486:737:500;red:round:826:489:840:506 |  |  | 0 | 0 | moving | 10.367
291 | 9.700 | red | red | none | red | red | none | 3 | red:round:222:458:232:482;red:unknown:724:486:736:494;red:round:826:488:840:502 |  |  | 0 | 0 | moving | 10.367
294 | 9.800 | red | red | none | red | red | none | 2 | red:round:826:488:840:498;red:unknown:102:534:114:558 |  |  | 0 | 0 | moving | 9.421
297 | 9.900 | red | red | none | yellow | red | none | 2 | red:round:198:451:210:478;yellow:left:167:497:178:509 |  |  | 0 | 0 | moving | 8.836
300 | 10.000 | red | red | none | yellow | yellow | none | 1 | yellow:round:958:578:996:604 |  |  | 0 | 0 | moving | 8.836
303 | 10.100 | yellow | red | none | yellow | none | none | 1 | yellow:left:144:491:158:504 |  |  | 0 | 0 | moving | 8.596
306 | 10.200 | yellow | red | none | yellow | red | none | 2 | red:round:166:440:178:466;yellow:left:134:487:148:500 |  |  | 0 | 0 | moving | 8.438
309 | 10.300 | yellow | red | none | yellow | red | none | 2 | red:round:158:434:170:458;yellow:left:125:481:138:494 |  |  | 0 | 0 | moving | 7.603
312 | 10.400 | yellow | red | none | yellow | red | none | 2 | red:round:150:427:162:456;yellow:left:117:475:132:490 |  |  | 0 | 0 | moving | 7.603
315 | 10.500 | yellow | red | none | yellow | yellow | none | 4 | red:round:136:530:148:560;red:unknown:960:574:971:592;yellow:round:962:566:1001:591;yellow:left:6:570:30:596 |  |  | 0 | 0 | moving | 7.603
318 | 10.600 | yellow | red | none | yellow | red | none | 2 | red:unknown:138:414:150:440;yellow:left:105:463:118:476 |  |  | 0 | 0 | moving | 7.681
321 | 10.700 | yellow | red | none | red | red | none | 1 | red:round:132:408:144:438 |  |  | 0 | 0 | moving | 7.681
324 | 10.800 | yellow | red | none | red | red | none | 1 | red:round:128:404:140:432 |  |  | 0 | 0 | moving | 7.681
327 | 10.900 | red | red | none | red | red | none | 1 | red:round:122:395:136:424 |  |  | 0 | 0 | stopped | 6.875
330 | 11.000 | red | red | none | yellow | red | none | 2 | red:round:120:392:132:420;yellow:left:85:440:100:454 |  |  | 0 | 0 | stopped | 6.295
333 | 11.100 | red | red | none | red | red | none | 2 | red:round:116:381:130:410;yellow:unknown:87:437:96:445 |  |  | 0 | 0 | stopped | 5.790
336 | 11.200 | red | red | none | red | yellow | none | 2 | red:left:964:542:979:556;yellow:round:968:530:1007:556 |  |  | 0 | 0 | stopped | 4.682
339 | 11.300 | red | red | none | yellow | yellow | none | 1 | yellow:unknown:1784:190:1792:198 |  |  | 0 | 0 | stopped | 4.682
342 | 11.400 | red | red | none | red | red | none | 1 | red:round:114:362:126:390 |  |  | 0 | 0 | stopped | 4.682
345 | 11.500 | red | red | none | red | red | none | 1 | red:round:112:358:124:388 |  |  | 0 | 0 | stopped | 4.553
348 | 11.600 | red | red | none | yellow | yellow | none | 1 | yellow:unknown:1655:154:1663:166 |  |  | 0 | 0 | stopped | 4.406
351 | 11.700 | red | red | none | yellow | yellow | none | 1 | yellow:unknown:1528:10:1542:22 |  |  | 0 | 0 | stopped | 3.750
354 | 11.800 | yellow | yellow | none | yellow | yellow | none | 1 | yellow:unknown:1652:159:1660:170 |  |  | 0 | 0 | stopped | 3.750
357 | 11.900 | yellow | yellow | none | none | none | yellow | 1 | yellow:right:1522:20:1534:32 |  |  | 0 | 0 | stopped | 3.750
360 | 12.000 | yellow | yellow | none | red | yellow | none | 2 | red:left:958:532:974:554;yellow:round:962:526:1000:552 |  |  | 0 | 0 | stopped | 4.470
363 | 12.100 | yellow | yellow | none | yellow | yellow | none | 2 | red:unknown:952:538:967:558;yellow:round:958:530:996:557 |  |  | 0 | 0 | stopped | 4.821
366 | 12.200 | yellow | yellow | none | yellow | yellow | none | 1 | yellow:unknown:1634:180:1642:188 |  |  | 0 | 0 | stopped | 4.868
369 | 12.300 | yellow | yellow | none | yellow | yellow | none | 3 | red:unknown:944:552:958:570;yellow:round:948:544:988:568;yellow:left:1450:561:1468:578 |  |  | 0 | 0 | stopped | 5.086
372 | 12.400 | yellow | yellow | none | red | red | none | 1 | red:round:82:398:96:428 |  |  | 0 | 0 | stopped | 5.086
375 | 12.500 | yellow | yellow | none | yellow | yellow | none | 2 | red:unknown:938:557:952:578;yellow:round:942:552:980:577 |  |  | 0 | 0 | stopped | 5.090
378 | 12.600 | yellow | yellow | none | red | red | none | 1 | red:round:74:407:88:436 |  |  | 0 | 0 | stopped | 5.090
381 | 12.700 | yellow | yellow | none | yellow | yellow | none | 1 | yellow:unknown:1611:198:1619:208 |  |  | 0 | 0 | stopped | 5.090
384 | 12.800 | yellow | yellow | none | yellow | yellow | none | 1 | yellow:unknown:1608:200:1616:208 |  |  | 0 | 0 | stopped | 4.924
387 | 12.900 | yellow | yellow | none | yellow | yellow | none | 1 | yellow:unknown:1605:202:1613:213 |  |  | 0 | 0 | stopped | 4.472
390 | 13.000 | yellow | yellow | none | yellow | yellow | none | 1 | yellow:unknown:1602:204:1610:215 |  |  | 0 | 0 | stopped | 4.411
393 | 13.100 | yellow | yellow | none | yellow | yellow | none | 1 | yellow:unknown:1599:206:1607:218 |  |  | 0 | 0 | stopped | 4.378
396 | 13.200 | yellow | yellow | none | yellow | yellow | none | 2 | red:unknown:918:584:929:598;yellow:round:920:571:960:598 |  |  | 0 | 0 | stopped | 4.086
399 | 13.300 | yellow | yellow | none | yellow | yellow | none | 1 | yellow:unknown:1442:498:1450:506 |  |  | 0 | 0 | stopped | 3.808
402 | 13.400 | yellow | yellow | none | yellow | yellow | none | 1 | yellow:round:918:576:956:601 |  |  | 0 | 0 | stopped | 3.224
405 | 13.500 | yellow | yellow | none | yellow | yellow | none | 3 | red:unknown:912:582:926:604;yellow:round:915:576:954:602;yellow:unknown:1492:604:1500:619 |  |  | 0 | 0 | stopped | 3.224
408 | 13.600 | yellow | yellow | none | yellow | yellow | none | 3 | red:unknown:910:588:920:606;yellow:round:912:578:952:604;yellow:unknown:1486:605:1498:627 |  |  | 0 | 0 | stopped | 3.224
411 | 13.700 | yellow | yellow | none | red | red | none | 1 | red:round:46:440:58:468 |  |  | 0 | 0 | stopped | 3.224
414 | 13.800 | yellow | yellow | none | yellow | yellow | none | 1 | yellow:round:7:489:22:503 |  |  | 0 | 0 | stopped | 3.046
417 | 13.900 | yellow | yellow | none | red | yellow | none | 2 | red:left:904:596:919:610;yellow:round:910:582:947:608 |  |  | 0 | 0 | stopped | 3.046
420 | 14.000 | yellow | yellow | none | yellow | yellow | none | 2 | yellow:round:906:584:946:610;yellow:unknown:1410:592:1426:611 |  |  | 0 | 0 | stopped | 2.924
423 | 14.100 | yellow | yellow | none | yellow | yellow | none | 3 | red:left:902:594:917:612;yellow:round:905:584:944:610;yellow:left:1408:597:1428:614 |  |  | 0 | 0 | stopped | 2.654
426 | 14.200 | yellow | yellow | none | yellow | yellow | none | 3 | red:left:900:594:916:614;yellow:round:904:586:942:612;yellow:left:1404:586:1426:617 |  |  | 0 | 0 | stopped | 2.464
429 | 14.300 | yellow | yellow | none | yellow | yellow | none | 1 | yellow:unknown:0:489:16:500 |  |  | 0 | 0 | stopped | 2.363
