Zdy-1110/FPGA-676/tools/adas/host_test/out/113539/states.csv

frame | t | sig_left | sig_straight | sig_right | raw_left | raw_straight | raw_right | n_lights | lights | left_line | right_line | left_cov | right_cov | ego_motion | motion_score
0 | 0.000 | none | none | none | none | yellow | none | 1 | yellow:straight:468:636:482:646 |  |  | 0 | 0 | moving | 0.000
3 | 0.100 | none | none | none | yellow | yellow | none | 1 | yellow:unknown:412:638:428:648 |  |  | 0 | 0 | moving | 15.336
6 | 0.200 | none | yellow | none | yellow | yellow | none | 1 | yellow:unknown:350:640:364:648 |  |  | 0 | 0 | moving | 14.507
9 | 0.300 | none | yellow | none | none | none | none | 0 |  |  |  | 0 | 0 | moving | 15.336
12 | 0.400 | none | yellow | none | none | none | none | 0 |  |  |  | 0 | 0 | moving | 14.930
15 | 0.500 | none | yellow | none | none | none | none | 0 |  |  |  | 0 | 0 | moving | 14.613
18 | 0.600 | yellow | yellow | none | yellow | yellow | none | 1 | yellow:round:6:565:44:606 |  |  | 0 | 0 | moving | 14.524
21 | 0.700 | yellow | yellow | none | none | none | none | 0 |  |  |  | 0 | 0 | moving | 14.548
24 | 0.800 | yellow | yellow | none | none | none | none | 0 |  |  |  | 0 | 0 | moving | 14.548
27 | 0.900 | yellow | yellow | none | red | red | none | 1 | red:round:918:558:931:590 |  |  | 0 | 0 | moving | 14.613
30 | 1.000 | yellow | yellow | none | red | red | none | 1 | red:round:870:556:883:587 |  |  | 0 | 0 | moving | 14.776
33 | 1.100 | yellow | yellow | none | none | none | none | 0 |  |  |  | 0 | 0 | moving | 14.819
36 | 1.200 | yellow | yellow | none | none | none | none | 0 |  |  |  | 0 | 0 | moving | 14.819
39 | 1.300 | yellow | yellow | none | yellow | yellow | none | 1 | yellow:round:1196:608:1212:628 |  |  | 0 | 0 | moving | 14.776
42 | 1.400 | yellow | yellow | none | yellow | yellow | none | 2 | red:round:728:552:742:584;yellow:round:1170:608:1190:628 |  |  | 0 | 0 | moving | 14.560
45 | 1.500 | yellow | yellow | none | yellow | yellow | none | 1 | yellow:round:1150:608:1176:632 |  |  | 0 | 0 | moving | 14.189
48 | 1.600 | yellow | yellow | none | red | red | none | 1 | red:unknown:1894:218:1920:230 |  |  | 0 | 0 | moving | 13.828
51 | 1.700 | yellow | yellow | none | red | red | none | 1 | red:round:1910:214:1920:224 |  |  | 0 | 0 | moving | 13.089
54 | 1.800 | yellow | yellow | none | none | none | green | 1 | green:right:0:419:14:436 |  |  | 0 | 0 | moving | 12.488
57 | 1.900 | yellow | yellow | none | yellow | yellow | none | 2 | red:round:682:562:696:595;yellow:round:1132:618:1166:646 |  |  | 0 | 0 | moving | 12.470
60 | 2.000 | yellow | yellow | none | yellow | yellow | none | 1 | yellow:round:1140:618:1170:644 |  |  | 0 | 0 | moving | 11.792
63 | 2.100 | yellow | yellow | none | none | none | green | 1 | green:right:0:413:22:430 |  |  | 0 | 0 | moving | 11.792
66 | 2.200 | yellow | yellow | none | none | none | none | 0 |  |  |  | 0 | 0 | moving | 11.792
69 | 2.300 | yellow | yellow | none | green | green | none | 1 | green:unknown:16:284:24:294 |  |  | 0 | 0 | moving | 12.310
72 | 2.400 | yellow | yellow | none | green | green | none | 1 | green:unknown:15:376:32:392 |  |  | 0 | 0 | moving | 12.778
75 | 2.500 | green | green | none | green | green | none | 1 | green:unknown:0:264:24:278 |  |  | 0 | 0 | moving | 12.778
78 | 2.600 | green | green | none | green | green | none | 1 | green:unknown:8:366:26:402 |  |  | 0 | 0 | moving | 12.778
81 | 2.700 | green | green | none | none | none | none | 0 |  |  |  | 0 | 0 | moving | 12.916
84 | 2.800 | green | green | none | red | red | none | 1 | red:unknown:719:582:727:590 |  |  | 0 | 0 | moving | 13.126
87 | 2.900 | green | green | none | red | red | none | 1 | red:unknown:703:582:711:596 |  |  | 0 | 0 | moving | 16.243
90 | 3.000 | red | red | none | red | red | none | 1 | red:unknown:669:514:689:556 |  |  | 0 | 0 | moving | 21.233
93 | 3.100 | red | red | none | red | red | none | 2 | red:round:647:510:664:552;red:unknown:656:580:664:594 |  |  | 0 | 0 | moving | 21.233
96 | 3.200 | red | red | none | red | red | none | 2 | red:unknown:625:578:634:598;red:unknown:1448:624:1466:634 |  |  | 0 | 0 | moving | 21.233
99 | 3.300 | red | red | none | red | red | none | 1 | red:unknown:590:579:600:602 |  |  | 0 | 0 | moving | 18.901
102 | 3.400 | red | red | none | red | red | none | 2 | red:unknown:552:581:565:610;red:unknown:1444:632:1465:642 |  |  | 0 | 0 | moving | 18.344
105 | 3.500 | red | red | none | red | red | none | 2 | red:unknown:516:585:529:610;red:unknown:1446:636:1468:646 |  |  | 0 | 0 | moving | 18.344
108 | 3.600 | red | red | none | red | red | none | 2 | red:unknown:480:584:494:612;red:unknown:1452:638:1476:648 |  |  | 0 | 0 | moving | 18.901
111 | 3.700 | red | red | none | none | none | none | 0 |  |  |  | 0 | 0 | moving | 20.807
114 | 3.800 | red | red | none | none | none | none | 0 |  |  |  | 0 | 0 | moving | 20.871
117 | 3.900 | red | red | none | none | none | none | 0 |  |  |  | 0 | 0 | moving | 20.871
120 | 4.000 | red | red | none | none | none | none | 0 |  |  |  | 0 | 0 | moving | 20.807
123 | 4.100 | red | red | none | none | none | none | 0 |  |  |  | 0 | 0 | moving | 19.951
126 | 4.200 | red | red | none | none | none | none | 0 |  |  |  | 0 | 0 | moving | 19.177
129 | 4.300 | red | red | none | none | none | none | 0 |  |  |  | 0 | 0 | moving | 19.172
132 | 4.400 | red | red | none | none | none | none | 0 |  |  |  | 0 | 0 | moving | 17.964
135 | 4.500 | red | red | none | none | none | none | 0 |  |  |  | 0 | 0 | moving | 17.964
138 | 4.600 | red | red | none | none | none | none | 0 |  |  |  | 0 | 0 | moving | 17.964
141 | 4.700 | red | red | none | none | none | none | 0 |  |  |  | 0 | 0 | moving | 18.209
144 | 4.800 | red | red | none | none | none | none | 0 |  |  |  | 0 | 0 | moving | 18.209
147 | 4.900 | red | red | none | none | none | none | 0 |  |  |  | 0 | 0 | moving | 18.209
150 | 5.000 | red | red | none | yellow | none | none | 1 | yellow:left:0:531:12:544 |  |  | 0 | 0 | moving | 18.290
153 | 5.100 | red | red | none | none | none | none | 0 |  |  |  | 0 | 0 | moving | 17.499
156 | 5.200 | red | red | none | none | none | none | 0 |  |  |  | 0 | 0 | moving | 17.499
159 | 5.300 | red | red | none | none | none | none | 0 |  |  |  | 0 | 0 | moving | 18.240
162 | 5.400 | red | red | none | none | none | none | 0 |  |  |  | 0 | 0 | moving | 18.334
165 | 5.500 | red | red | none | none | none | none | 0 |  |  |  | 0 | 0 | moving | 19.690
168 | 5.600 | red | red | none | none | none | none | 0 |  |  |  | 0 | 0 | moving | 19.690
171 | 5.700 | red | none | none | none | none | none | 0 |  |  |  | 0 | 0 | moving | 19.690
174 | 5.800 | red | none | none | none | none | none | 0 |  |  |  | 0 | 0 | moving | 19.400
177 | 5.900 | red | none | none | red | red | none | 1 | red:unknown:987:562:995:572 |  |  | 0 | 0 | moving | 17.691
180 | 6.000 | red | none | none | none | none | none | 0 |  |  |  | 0 | 0 | moving | 17.691
183 | 6.100 | red | none | none | none | none | none | 0 |  |  |  | 0 | 0 | moving | 17.691
186 | 6.200 | red | none | none | none | none | none | 0 |  |  |  | 0 | 0 | moving | 17.863
189 | 6.300 | red | none | none | none | none | none | 0 |  |  |  | 0 | 0 | moving | 17.863
192 | 6.400 | red | none | none | yellow | yellow | none | 1 | yellow:unknown:1284:441:1302:460 |  |  | 0 | 0 | moving | 18.056
195 | 6.500 | red | none | none | red | red | none | 1 | red:unknown:1046:536:1054:544 |  |  | 0 | 0 | moving | 17.863
198 | 6.600 | red | none | none | red | red | none | 1 | red:unknown:1058:534:1066:542 |  |  | 0 | 0 | moving | 17.838
201 | 6.700 | red | none | none | none | yellow | none | 1 | yellow:straight:1350:422:1368:443 |  |  | 0 | 0 | moving | 17.838
204 | 6.800 | red | none | none | yellow | yellow | none | 1 | yellow:unknown:1372:415:1391:438 |  |  | 0 | 0 | moving | 18.106
207 | 6.900 | red | none | none | yellow | none | none | 1 | yellow:left:1396:407:1416:430 |  |  | 0 | 0 | moving | 19.193
210 | 7.000 | yellow | yellow | none | yellow | yellow | none | 1 | yellow:unknown:1420:397:1438:420 |  |  | 0 | 0 | moving | 19.688
213 | 7.100 | yellow | yellow | none | yellow | none | none | 1 | yellow:left:1442:386:1464:411 |  |  | 0 | 0 | moving | 21.254
216 | 7.200 | yellow | yellow | none | yellow | none | none | 1 | yellow:left:1464:366:1487:397 |  |  | 0 | 0 | moving | 21.254
219 | 7.300 | yellow | yellow | none | yellow | none | none | 1 | yellow:left:1484:352:1508:384 |  |  | 0 | 0 | moving | 21.254
222 | 7.400 | yellow | yellow | none | yellow | yellow | none | 1 | yellow:unknown:1504:340:1528:374 |  |  | 0 | 0 | moving | 19.455
225 | 7.500 | yellow | yellow | none | yellow | none | none | 1 | yellow:left:1525:324:1552:358 |  |  | 0 | 0 | moving | 19.455
228 | 7.600 | yellow | yellow | none | yellow | none | none | 1 | yellow:left:1545:306:1571:342 |  |  | 0 | 0 | moving | 19.455
231 | 7.700 | yellow | yellow | none | yellow | yellow | none | 1 | yellow:unknown:1563:290:1590:325 |  |  | 0 | 0 | moving | 19.484
234 | 7.800 | yellow | yellow | none | yellow | none | none | 1 | yellow:left:1582:274:1614:312 |  |  | 0 | 0 | moving | 20.133
237 | 7.900 | yellow | yellow | none | yellow | none | none | 1 | yellow:left:1597:260:1630:298 |  |  | 0 | 0 | moving | 20.612
240 | 8.000 | yellow | yellow | none | yellow | none | none | 1 | yellow:left:1614:246:1644:285 |  |  | 0 | 0 | moving | 21.363
243 | 8.100 | yellow | yellow | none | yellow | yellow | none | 1 | yellow:round:1629:234:1661:276 |  |  | 0 | 0 | moving | 21.664
246 | 8.200 | yellow | yellow | none | yellow | none | none | 1 | yellow:left:1643:226:1680:271 |  |  | 0 | 0 | moving | 22.205
249 | 8.300 | yellow | yellow | none | red | red | none | 2 | red:round:1109:454:1120:465;red:unknown:1208:456:1216:466 |  |  | 0 | 0 | moving | 22.205
252 | 8.400 | yellow | yellow | none | red | red | none | 2 | red:round:1102:456:1114:467;red:unknown:1200:460:1212:468 |  |  | 0 | 0 | moving | 22.717
255 | 8.500 | red | red | none | red | red | none | 1 | red:round:1096:456:1107:470 |  |  | 0 | 0 | moving | 22.873
258 | 8.600 | red | red | none | red | red | none | 1 | red:round:1089:456:1101:470 |  |  | 0 | 0 | moving | 22.873
261 | 8.700 | red | red | none | red | red | none | 2 | red:round:1084:454:1096:465;red:unknown:1188:458:1197:468 |  |  | 0 | 0 | moving | 22.717
264 | 8.800 | red | red | none | red | red | none | 2 | red:round:1078:452:1090:464;red:round:1182:456:1194:468 |  |  | 0 | 0 | moving | 22.167
267 | 8.900 | red | red | none | red | red | none | 2 | red:round:1071:452:1084:466;red:unknown:1180:458:1188:468 |  |  | 0 | 0 | moving | 20.594
270 | 9.000 | red | red | none | red | red | none | 1 | red:round:1064:456:1076:470 |  |  | 0 | 0 | moving | 19.214
273 | 9.100 | red | red | none | red | red | none | 1 | red:round:1056:458:1069:474 |  |  | 0 | 0 | moving | 19.214
276 | 9.200 | red | red | none | red | red | none | 1 | red:round:1049:458:1062:470 |  |  | 0 | 0 | moving | 19.214
279 | 9.300 | red | red | none | red | red | none | 2 | red:round:1044:452:1056:464;red:round:1154:456:1168:470 |  |  | 0 | 0 | moving | 20.147
282 | 9.400 | red | red | none | red | red | none | 2 | red:round:1036:448:1050:462;red:round:1148:454:1162:466 |  |  | 0 | 0 | moving | 20.147
285 | 9.500 | red | red | none | red | red | none | 2 | red:round:1034:444:1046:458;red:unknown:1152:452:1160:462 |  |  | 0 | 0 | moving | 23.370
288 | 9.600 | red | red | none | red | red | none | 1 | red:round:1027:442:1041:458 |  |  | 0 | 0 | moving | 23.455
291 | 9.700 | red | red | none | red | red | none | 1 | red:round:1022:438:1036:454 |  |  | 0 | 0 | moving | 25.126
294 | 9.800 | red | red | none | red | red | none | 2 | red:round:1017:436:1031:452;red:unknown:1136:442:1144:452 |  |  | 0 | 0 | moving | 23.455
297 | 9.900 | red | red | none | red | red | none | 2 | red:round:1012:434:1027:450;red:round:1133:440:1147:454 |  |  | 0 | 0 | moving | 23.455
300 | 10.000 | red | red | none | red | red | none | 2 | red:round:1012:432:1026:444;red:round:1133:436:1148:450 |  |  | 0 | 0 | moving | 23.455
303 | 10.100 | red | red | none | red | red | none | 2 | red:round:1010:426:1024:441;red:round:1134:432:1148:448 |  |  | 0 | 0 | moving | 21.185
306 | 10.200 | red | red | none | red | red | none | 2 | red:round:1009:420:1024:438;red:round:1135:426:1150:441 |  |  | 0 | 0 | moving | 21.072
309 | 10.300 | red | red | none | red | red | none | 2 | red:round:1010:414:1026:430;red:round:1139:420:1154:436 |  |  | 0 | 0 | moving | 18.274
312 | 10.400 | red | red | none | red | red | none | 2 | red:round:1010:408:1026:426;red:round:1141:414:1156:430 |  |  | 0 | 0 | moving | 18.274
315 | 10.500 | red | red | none | red | red | none | 2 | red:round:1014:402:1029:421;red:round:1146:408:1161:424 |  |  | 0 | 0 | moving | 18.274
318 | 10.600 | red | red | none | red | red | none | 2 | red:round:1016:398:1031:418;red:round:1150:404:1166:422 |  |  | 0 | 0 | moving | 18.274
321 | 10.700 | red | red | none | red | red | none | 2 | red:round:1018:398:1033:413;red:round:1154:402:1170:420 |  |  | 0 | 0 | moving | 18.153
324 | 10.800 | red | red | none | red | red | none | 2 | red:round:1020:396:1036:411;red:round:1159:400:1176:418 |  |  | 0 | 0 | moving | 18.870
327 | 10.900 | red | red | none | red | red | none | 2 | red:round:1024:394:1040:412;red:round:1165:398:1181:418 |  |  | 0 | 0 | moving | 18.864
330 | 11.000 | red | red | none | red | red | none | 2 | red:round:1027:392:1044:409;red:round:1170:398:1187:414 |  |  | 0 | 0 | moving | 18.864
333 | 11.100 | red | red | none | red | red | none | 2 | red:round:1030:392:1046:409;red:round:1175:398:1192:415 |  |  | 0 | 0 | moving | 18.864
336 | 11.200 | red | red | none | red | red | none | 2 | red:round:1032:392:1048:408;red:round:1178:396:1196:414 |  |  | 0 | 0 | moving | 19.632
339 | 11.300 | red | red | none | red | red | none | 2 | red:round:1031:390:1048:407;red:round:1181:396:1198:413 |  |  | 0 | 0 | moving | 18.864
342 | 11.400 | red | red | none | red | red | none | 2 | red:round:1030:388:1046:408;red:round:1180:394:1198:414 |  |  | 0 | 0 | moving | 19.632
345 | 11.500 | red | red | none | red | red | none | 2 | red:round:1026:388:1043:406;red:round:1179:394:1197:412 |  |  | 0 | 0 | moving | 19.632
348 | 11.600 | red | red | none | red | red | none | 2 | red:round:1020:388:1038:408;red:round:1176:394:1194:414 |  |  | 0 | 0 | moving | 19.632
351 | 11.700 | red | red | none | red | red | none | 2 | red:round:1016:380:1034:400;red:round:1174:386:1192:404 |  |  | 0 | 0 | moving | 19.185
354 | 11.800 | red | red | none | red | red | none | 2 | red:round:1011:375:1030:396;red:round:1172:380:1190:402 |  |  | 0 | 0 | moving | 19.185
357 | 11.900 | red | red | none | red | red | none | 2 | red:round:1008:378:1027:400;red:round:1171:386:1190:404 |  |  | 0 | 0 | moving | 19.185
360 | 12.000 | red | red | none | red | red | none | 2 | red:round:1006:378:1024:398;red:round:1170:386:1189:408 |  |  | 0 | 0 | moving | 19.185
363 | 12.100 | red | red | none | red | red | none | 2 | red:round:1002:372:1020:392;red:round:1168:380:1187:400 |  |  | 0 | 0 | moving | 19.118
366 | 12.200 | red | red | none | yellow | yellow | none | 1 | yellow:unknown:1874:158:1886:166 |  |  | 0 | 0 | moving | 18.774
369 | 12.300 | red | red | none | red | red | none | 2 | red:round:1002:380:1020:400;red:round:1172:390:1192:410 |  |  | 0 | 0 | moving | 20.408
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
