Zdy-1110/FPGA-676/tools/usb_feed/testdata/band_113539_f0.png

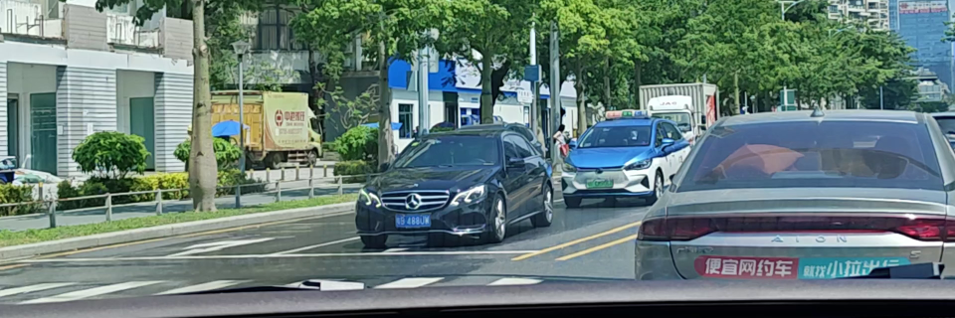
tools/usb_feed/testdata/band_113539_f0.png
