Zdy-1110/FPGA-676/tools/nav_proto/templates/crop52_debug.jpg

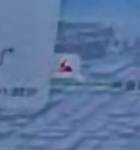
tools/nav_proto/templates/crop52_debug.jpg
