Zdy-1110/FPGA-676/tools/nav_proto/templates/crop87_debug.jpg

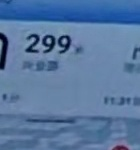
tools/nav_proto/templates/crop87_debug.jpg
