Zdy-1110/FPGA-676/tools/nav_proto/templates/debug_left_54.0s.jpg

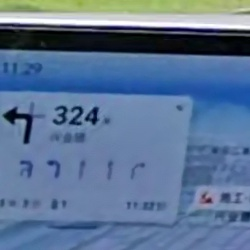
tools/nav_proto/templates/debug_left_54.0s.jpg
