Zdy-1110/FPGA-676/fpga/ip/PCIe_IP/rtl/hsstlp/ipm2l_pcie_hsstlp_x2_top.v

// Created by IP Generator (Version 2021.1-SP4.1 build 75525)


///////////////////////////////////////////////////////////////////////////////
//
// Copyright (c) 2019 PANGO MICROSYSTEMS, INC
// ALL RIGHTS REVERVED.
//
// THE SOURCE CODE CONTAINED HEREIN IS PROPRIETARY TO PANGO MICROSYSTEMS, INC.
// IT SHALL NOT BE REPRODUCED OR DISCLOSED IN WHOLE OR IN PART OR USED BY
// PARTIES WITHOUT WRITTEN AUTHORIZATION FROM THE OWNER.
//
////////////////////////////////////////////////////////////////////////////////
//
// Library:
// Filename:
////////////////////////////////////////////////////////////////////////////////

`timescale 1ns/100fs

module ipm2l_pcie_hsstlp_x2_top (
    
    input          i_p_refckn_0                  ,
    input          i_p_refckp_0                  ,
    input          i_p_tx_lane_pd_clkpath_0      ,
    input          i_p_tx_lane_pd_clkpath_1      ,
    input          i_p_tx_lane_pd_piso_0         ,
    input          i_p_tx_lane_pd_piso_1         ,
    input          i_p_tx_lane_pd_driver_0       ,
    input          i_p_tx_lane_pd_driver_1       ,
    input          i_p_lane_pd_0                 ,
    input          i_p_lane_pd_1                 ,
    input          i_p_lane_rst_0                ,
    input          i_p_lane_rst_1                ,
    input          i_p_rx_lane_pd_0              ,
    input          i_p_rx_lane_pd_1              ,
    output         o_p_clk2core_tx_0             ,
    output         o_p_clk2core_tx_1             ,
    input          i_p_tx0_clk_fr_core           ,
    input          i_p_tx1_clk_fr_core           ,
    input          i_p_rx0_clk_fr_core           ,
    input          i_p_rx1_clk_fr_core           ,
    input          i_p_rx0_clk2_fr_core          ,
    input          i_p_rx1_clk2_fr_core          ,
    input          i_pll_lock_rx_0               ,
    input          i_pll_lock_rx_1               ,
    output         o_p_refck2core_0              ,
    input          i_p_pll_rst_0                 ,
    input          i_p_tx_pma_rst_0              ,
    input          i_p_tx_pma_rst_1              ,
    input          i_p_pcs_tx_rst_0              ,
    input          i_p_pcs_tx_rst_1              ,
    input          i_p_rx_pma_rst_0              ,
    input          i_p_rx_pma_rst_1              ,
    input          i_p_pcs_rx_rst_0              ,
    input          i_p_pcs_rx_rst_1              ,
    input          i_p_pcs_cb_rst_0              ,
    input          i_p_pcs_cb_rst_1              ,
    input  [2:0]   i_p_lx_margin_ctl_0           ,
    input  [2:0]   i_p_lx_margin_ctl_1           ,
    input          i_p_lx_swing_ctl_0            ,
    input          i_p_lx_swing_ctl_1            ,
    input  [1:0]   i_p_lx_deemp_ctl_0            ,
    input  [1:0]   i_p_lx_deemp_ctl_1            ,
    input          i_p_lane_sync_0               ,
    input          i_p_rate_change_tclk_on_0     ,
    input  [1:0]   i_p_tx_ckdiv_0                ,
    input  [1:0]   i_p_tx_ckdiv_1                ,
    input  [1:0]   i_p_lx_rx_ckdiv_0             ,
    input  [1:0]   i_p_lx_rx_ckdiv_1             ,
    input  [1:0]   i_p_lx_elecidle_en_0          ,
    input  [1:0]   i_p_lx_elecidle_en_1          ,
    output         o_p_pll_lock_0                ,
    output         o_p_rx_sigdet_sta_0           ,
    output         o_p_rx_sigdet_sta_1           ,
    output         o_p_lx_cdr_align_0            ,
    output         o_p_lx_cdr_align_1            ,
    input          i_p_lx_rxdct_en_0             ,
    input          i_p_lx_rxdct_en_1             ,
    output         o_p_lx_rxdct_out_0            ,
    output         o_p_lx_rxdct_out_1            ,
    output         o_p_pcs_lsm_synced_0          ,
    output         o_p_pcs_lsm_synced_1          ,
    input          i_p_pcs_nearend_loop_0        ,
    input          i_p_pcs_farend_loop_0         ,
    input          i_p_pma_nearend_ploop_0       ,
    input          i_p_pma_nearend_sloop_0       ,
    input          i_p_pma_farend_ploop_0        ,
    input          i_p_pcs_nearend_loop_1        ,
    input          i_p_pcs_farend_loop_1         ,
    input          i_p_pma_nearend_ploop_1       ,
    input          i_p_pma_nearend_sloop_1       ,
    input          i_p_pma_farend_ploop_1        ,
    input          i_p_rx_polarity_invert_0      ,
    input          i_p_rx_polarity_invert_1      ,
    input          i_p_tx_beacon_en_0            ,
    input          i_p_tx_beacon_en_1            ,
    input          i_p_cfg_clk                   ,
    input          i_p_cfg_rst                   ,
    input          i_p_cfg_psel                  ,
    input          i_p_cfg_enable                ,
    input          i_p_cfg_write                 ,
    input  [15:0]  i_p_cfg_addr                  ,
    input  [7:0]   i_p_cfg_wdata                 ,
    output [7:0]   o_p_cfg_rdata                 ,
    output         o_p_cfg_int                   ,
    output         o_p_cfg_ready                 ,
    input          i_p_l0rxn                     ,
    input          i_p_l0rxp                     ,
    input          i_p_l1rxn                     ,
    input          i_p_l1rxp                     ,
    output         o_p_l0txn                     ,
    output         o_p_l0txp                     ,
    output         o_p_l1txn                     ,
    output         o_p_l1txp                     ,
    input  [31:0]  i_txd_0                       ,
    input  [3:0]   i_tdispsel_0                  ,
    input  [3:0]   i_tdispctrl_0                 ,
    input  [3:0]   i_txk_0                       ,
    input  [31:0]  i_txd_1                       ,
    input  [3:0]   i_tdispsel_1                  ,
    input  [3:0]   i_tdispctrl_1                 ,
    input  [3:0]   i_txk_1                       ,
    output [2:0]   o_rxstatus_0                  ,
    output [31:0]  o_rxd_0                       ,
    output [3:0]   o_rdisper_0                   ,
    output [3:0]   o_rdecer_0                    ,
    output [3:0]   o_rxk_0                       ,
    output [2:0]   o_rxstatus_1                  ,
    output [31:0]  o_rxd_1                       ,
    output [3:0]   o_rdisper_1                   ,
    output [3:0]   o_rdecer_1                    ,
    output [3:0]   o_rxk_1                       ,
    input          i_p_pllpowerdown_0              
);


// ********************* UI parameters *********************
localparam CH0_EN = "Fullduplex";
localparam CH1_EN = "Fullduplex";
localparam CH2_EN = "DISABLE";
localparam CH3_EN = "DISABLE";
localparam CH0_PROTOCOL = "PCIEx2";
localparam CH1_PROTOCOL = "PCIEx2";
localparam CH2_PROTOCOL = "CUSTOMERIZEDx1";
localparam CH3_PROTOCOL = "CUSTOMERIZEDx1";
localparam CH0_PROTOCOL_DEFAULT = "FALSE";
localparam CH1_PROTOCOL_DEFAULT = "FALSE";
localparam CH2_PROTOCOL_DEFAULT = "FALSE";
localparam CH3_PROTOCOL_DEFAULT = "FALSE";
localparam CH0_TX_RATE = 5.0;
localparam CH1_TX_RATE = 5.0;
localparam CH2_TX_RATE = 0.0;
localparam CH3_TX_RATE = 0.0;
localparam CH0_RX_RATE = 5.0;
localparam CH1_RX_RATE = 5.0;
localparam CH2_RX_RATE = 0.0;
localparam CH3_RX_RATE = 0.0;
localparam CH0_TX_ENCODER = "8B10B";
localparam CH1_TX_ENCODER = "8B10B";
localparam CH2_TX_ENCODER = "Bypassed";
localparam CH3_TX_ENCODER = "Bypassed";
localparam CH0_RX_DECODER = "8B10B";
localparam CH1_RX_DECODER = "8B10B";
localparam CH2_RX_DECODER = "Bypassed";
localparam CH3_RX_DECODER = "Bypassed";
localparam CH0_TDATA_WIDTH = 32;
localparam CH1_TDATA_WIDTH = 32;
localparam CH2_TDATA_WIDTH = 32;
localparam CH3_TDATA_WIDTH = 32;
localparam CH0_RDATA_WIDTH = 32;
localparam CH1_RDATA_WIDTH = 32;
localparam CH2_RDATA_WIDTH = 32;
localparam CH3_RDATA_WIDTH = 32;
localparam CH0_TX_FABRIC_FEQ = 125.0;
localparam CH1_TX_FABRIC_FEQ = 125.0;
localparam CH2_TX_FABRIC_FEQ = 0.0;
localparam CH3_TX_FABRIC_FEQ = 0.0;
localparam CH0_RX_FABRIC_FEQ = 125.0;
localparam CH1_RX_FABRIC_FEQ = 125.0;
localparam CH2_RX_FABRIC_FEQ = 0.0;
localparam CH3_RX_FABRIC_FEQ = 0.0;
localparam PLL_NUM = 1;
localparam PLL0_EN = "TRUE";
localparam PLL1_EN = "FALSE";
localparam PLL_REFCLK_SAME = "FALSE";
localparam PLL0_REF_SEL = "Diff_REFCK0";
localparam PLL1_REF_SEL = "Diff_REFCK1";
localparam PLL0_FRQ_INDEX = 0;
localparam PLL1_FRQ_INDEX = 0;
localparam PLL0_REF_FRQ = 100.0;
localparam PLL1_REF_FRQ = 125.0;
localparam CH0_TX_PLL_SEL = "PLL0";
localparam CH1_TX_PLL_SEL = "PLL0";
localparam CH2_TX_PLL_SEL = "PLL0";
localparam CH3_TX_PLL_SEL = "PLL0";
localparam CH0_RX_PLL_SEL = "PLL0";
localparam CH1_RX_PLL_SEL = "PLL0";
localparam CH2_RX_PLL_SEL = "PLL0";
localparam CH3_RX_PLL_SEL = "PLL0";
localparam CH0_RXPCS_ALIGN = "XAUI_MODE";
localparam CH1_RXPCS_ALIGN = "XAUI_MODE";
localparam CH2_RXPCS_ALIGN = "Bypassed";
localparam CH3_RXPCS_ALIGN = "Bypassed";
localparam CH0_RXPCS_COMMA_SEL = "K28.5";
localparam CH1_RXPCS_COMMA_SEL = "K28.5";
localparam CH2_RXPCS_COMMA_SEL = "K28.5";
localparam CH3_RXPCS_COMMA_SEL = "K28.5";
localparam CH0_RXPCS_BONDING = "Bypassed";
localparam CH1_RXPCS_BONDING = "Bypassed";
localparam CH2_RXPCS_BONDING = "Bypassed";
localparam CH3_RXPCS_BONDING = "Bypassed";
localparam CH0_RXPCS_CTC = "PCIE_4BYTE";
localparam CH1_RXPCS_CTC = "PCIE_4BYTE";
localparam CH2_RXPCS_CTC = "Bypassed";
localparam CH3_RXPCS_CTC = "Bypassed";
localparam [9:0] CH0_RXPCS_COMMA_REG0 = 10'b0101111100;
localparam [9:0] CH1_RXPCS_COMMA_REG0 = 10'b0101111100;
localparam [9:0] CH2_RXPCS_COMMA_REG0 = 10'b0;
localparam [9:0] CH3_RXPCS_COMMA_REG0 = 10'b0;
localparam [9:0] CH0_RXPCS_COMMA_MASK = 10'b0000000000;
localparam [9:0] CH1_RXPCS_COMMA_MASK = 10'b0000000000;
localparam [9:0] CH2_RXPCS_COMMA_MASK = 10'b0;
localparam [9:0] CH3_RXPCS_COMMA_MASK = 10'b0;
localparam [9:0] CH0_RXPCS_SKIP_REG0 = 10'b110111100;
localparam [9:0] CH1_RXPCS_SKIP_REG0 = 10'b110111100;
localparam [9:0] CH2_RXPCS_SKIP_REG0 = 10'b0;
localparam [9:0] CH3_RXPCS_SKIP_REG0 = 10'b0;
localparam [9:0] CH0_RXPCS_SKIP_REG1 = 10'b100011100;
localparam [9:0] CH1_RXPCS_SKIP_REG1 = 10'b100011100;
localparam [9:0] CH2_RXPCS_SKIP_REG1 = 10'b0;
localparam [9:0] CH3_RXPCS_SKIP_REG1 = 10'b0;
localparam [9:0] CH0_RXPCS_SKIP_REG2 = 10'b100011100;
localparam [9:0] CH1_RXPCS_SKIP_REG2 = 10'b100011100;
localparam [9:0] CH2_RXPCS_SKIP_REG2 = 10'b0;
localparam [9:0] CH3_RXPCS_SKIP_REG2 = 10'b0;
localparam [9:0] CH0_RXPCS_SKIP_REG3 = 10'b100011100;
localparam [9:0] CH1_RXPCS_SKIP_REG3 = 10'b100011100;
localparam [9:0] CH2_RXPCS_SKIP_REG3 = 10'b0;
localparam [9:0] CH3_RXPCS_SKIP_REG3 = 10'b0;
localparam [7:0] CH0_RXPCS_A_REG = 8'b01111100;
localparam [7:0] CH1_RXPCS_A_REG = 8'b01111100;
localparam [7:0] CH2_RXPCS_A_REG = 8'b01111100;
localparam [7:0] CH3_RXPCS_A_REG = 8'b01111100;
localparam INNER_RST_EN = "FALSE";
localparam FREE_FRQ = 10.0;
localparam CH0_RXPCS_ALIGN_TIMER = 32767;
localparam CH1_RXPCS_ALIGN_TIMER = 32767;
localparam CH2_RXPCS_ALIGN_TIMER = 32767;
localparam CH3_RXPCS_ALIGN_TIMER = 32767;
localparam CH0_RXPCS_BONDING_RANGE = "80BIT";
localparam CH1_RXPCS_BONDING_RANGE = "80BIT";
localparam CH2_RXPCS_BONDING_RANGE = "80BIT";
localparam CH3_RXPCS_BONDING_RANGE = "80BIT";
localparam CH0_RXPMA_RTERM = 5;
localparam CH1_RXPMA_RTERM = 5;
localparam CH2_RXPMA_RTERM = 6;
localparam CH3_RXPMA_RTERM = 6;
localparam CH0_PRE_CURSOR_EN = "FALSE";
localparam CH1_PRE_CURSOR_EN = "FALSE";
localparam CH2_PRE_CURSOR_EN = "FALSE";
localparam CH3_PRE_CURSOR_EN = "FALSE";
localparam CH0_POST_CURSOR_EN = "TRUE";
localparam CH1_POST_CURSOR_EN = "TRUE";
localparam CH2_POST_CURSOR_EN = "FALSE";
localparam CH3_POST_CURSOR_EN = "FALSE";
localparam CH0_PRE_CURSOR_EMPHASIS = 0;
localparam CH1_PRE_CURSOR_EMPHASIS = 0;
localparam CH2_PRE_CURSOR_EMPHASIS = 0;
localparam CH3_PRE_CURSOR_EMPHASIS = 0;
localparam CH0_POST_CURSOR_EMPHASIS = 12;
localparam CH1_POST_CURSOR_EMPHASIS = 12;
localparam CH2_POST_CURSOR_EMPHASIS = 0;
localparam CH3_POST_CURSOR_EMPHASIS = 0;
localparam CH0_POST1_CURSOR_EMPHASIS = 19;
localparam CH1_POST1_CURSOR_EMPHASIS = 0;  // 20261018 fix: was 19 (-6 dB); over-equalised lane 1 at Gen2 on RK P29 (decode/disparity, ~5000 L0->Recovery/s); 0 -> 0 errors, 10-min soak clean
localparam CH2_POST1_CURSOR_EMPHASIS = 0;
localparam CH3_POST1_CURSOR_EMPHASIS = 0;
localparam CH0_POST2_CURSOR_EMPHASIS = 0;
localparam CH1_POST2_CURSOR_EMPHASIS = 0;
localparam CH2_POST2_CURSOR_EMPHASIS = 0;
localparam CH3_POST2_CURSOR_EMPHASIS = 0;
localparam P_APB_EN = "TRUE";
localparam PLL0_VCO = 5000.0;
localparam PLL0_M = 1;
localparam PLL0_N1 = 5;
localparam PLL0_N2 = 10;
localparam PLL1_VCO = 1600.0;
localparam PLL1_M = 1;
localparam PLL1_N1 = 5;
localparam PLL1_N2 = 4;
localparam P_LX_TX_CKDIV_0 = 2;
localparam P_LX_TX_CKDIV_1 = 2;
localparam P_LX_TX_CKDIV_2 = 0;
localparam P_LX_TX_CKDIV_3 = 0;
localparam LX_RX_CKDIV_0 = 2;
localparam LX_RX_CKDIV_1 = 2;
localparam LX_RX_CKDIV_2 = 0;
localparam LX_RX_CKDIV_3 = 0;
localparam RX0_CLK2_FR_CORE = "TRUE";
localparam RX1_CLK2_FR_CORE = "TRUE";
localparam RX2_CLK2_FR_CORE = "FALSE";
localparam RX3_CLK2_FR_CORE = "FALSE";
localparam TX0_CLK2_FR_CORE = "FALSE";
localparam TX1_CLK2_FR_CORE = "FALSE";
localparam TX2_CLK2_FR_CORE = "FALSE";
localparam TX3_CLK2_FR_CORE = "FALSE";
localparam CH0_DEBUG_BUS = "TRUE";
localparam CH1_DEBUG_BUS = "TRUE";
localparam CH2_DEBUG_BUS = "FALSE";
localparam CH3_DEBUG_BUS = "FALSE";
localparam CH0_FFE_CTRL_EN = "TRUE";
localparam CH1_FFE_CTRL_EN = "TRUE";
localparam CH2_FFE_CTRL_EN = "FALSE";
localparam CH3_FFE_CTRL_EN = "FALSE";
localparam CH0_RX_CLK_SLIP_EN = "FALSE";
localparam CH1_RX_CLK_SLIP_EN = "FALSE";
localparam CH2_RX_CLK_SLIP_EN = "FALSE";
localparam CH3_RX_CLK_SLIP_EN = "FALSE";
localparam PCIE_CLK_MODE_EN_0 = "FALSE";
localparam PCIE_CLK_MODE_EN_1 = "TRUE";
localparam PCIE_CLK_MODE_EN_2 = "FALSE";
localparam PCIE_CLK_MODE_EN_3 = "FALSE";

//-- GTP PARAMETER ---//

//renamed parameters
//CHx_TDATA_WIDTH_TYPE: "8bit_only", "10bit_only", "8b10b_8bit", "16bit_only", "20bit_only", "8b10b_16bit", "32bit_only", "40bit_only", "8b10b_32bit"
//CHx_RDATA_WIDTH_TYPE: "8bit_only", "10bit_only", "8b10b_8bit", "16bit_only", "20bit_only", "8b10b_16bit", "32bit_only", "40bit_only", "8b10b_32bit"
localparam           CH0_TDATA_WIDTH_TYPE          = ((CH0_TX_ENCODER=="Bypassed")&&(CH0_TDATA_WIDTH==8)) ? "8bit_only" :
                                                     ((CH0_TX_ENCODER=="Bypassed")&&(CH0_TDATA_WIDTH==10)) ? "10bit_only" :
                                                     ((CH0_TX_ENCODER=="Bypassed")&&(CH0_TDATA_WIDTH==16)) ? "16bit_only" :
                                                     ((CH0_TX_ENCODER=="Bypassed")&&(CH0_TDATA_WIDTH==20)) ? "20bit_only" :
                                                     ((CH0_TX_ENCODER=="Bypassed")&&(CH0_TDATA_WIDTH==32)) ? "32bit_only" :
                                                     ((CH0_TX_ENCODER=="Bypassed")&&(CH0_TDATA_WIDTH==40)) ? "40bit_only" :
                                                     ((CH0_TX_ENCODER=="8B10B") &&  (CH0_TDATA_WIDTH==8)) ? "8b10b_8bit"  :
                                                     ((CH0_TX_ENCODER=="8B10B") &&  (CH0_TDATA_WIDTH==16)) ? "8b10b_16bit" : 
                                                     ((CH0_TX_ENCODER=="64B66B_transparent") &&  (CH0_TDATA_WIDTH==16)) ? "64b66b_16bit" :
                                                     ((CH0_TX_ENCODER=="64B66B_transparent") &&  (CH0_TDATA_WIDTH==32)) ? "64b66b_32bit" :
                                                     ((CH0_TX_ENCODER=="64B67B_transparent") &&  (CH0_TDATA_WIDTH==16)) ? "64b67b_16bit" :
                                                     ((CH0_TX_ENCODER=="64B67B_transparent") &&  (CH0_TDATA_WIDTH==32)) ? "64b67b_32bit" : "8b10b_32bit";
localparam           CH1_TDATA_WIDTH_TYPE          = ((CH1_TX_ENCODER=="Bypassed")&&(CH1_TDATA_WIDTH==8)) ? "8bit_only" :
                                                     ((CH1_TX_ENCODER=="Bypassed")&&(CH1_TDATA_WIDTH==10)) ? "10bit_only" :
                                                     ((CH1_TX_ENCODER=="Bypassed")&&(CH1_TDATA_WIDTH==16)) ? "16bit_only" :
                                                     ((CH1_TX_ENCODER=="Bypassed")&&(CH1_TDATA_WIDTH==20)) ? "20bit_only" :
                                                     ((CH1_TX_ENCODER=="Bypassed")&&(CH1_TDATA_WIDTH==32)) ? "32bit_only" :
                                                     ((CH1_TX_ENCODER=="Bypassed")&&(CH1_TDATA_WIDTH==40)) ? "40bit_only" :
                                                     ((CH1_TX_ENCODER=="8B10B") &&  (CH1_TDATA_WIDTH==8)) ? "8b10b_8bit" :
                                                     ((CH1_TX_ENCODER=="8B10B") &&  (CH1_TDATA_WIDTH==16)) ? "8b10b_16bit" :
                                                     ((CH1_TX_ENCODER=="64B66B_transparent") &&  (CH1_TDATA_WIDTH==16)) ? "64b66b_16bit" :
                                                     ((CH1_TX_ENCODER=="64B66B_transparent") &&  (CH1_TDATA_WIDTH==32)) ? "64b66b_32bit" :
                                                     ((CH1_TX_ENCODER=="64B67B_transparent") &&  (CH1_TDATA_WIDTH==16)) ? "64b67b_16bit" :
                                                     ((CH1_TX_ENCODER=="64B67B_transparent") &&  (CH1_TDATA_WIDTH==32)) ? "64b67b_32bit" : "8b10b_32bit";
localparam           CH2_TDATA_WIDTH_TYPE          = ((CH2_TX_ENCODER=="Bypassed")&&(CH2_TDATA_WIDTH==8)) ? "8bit_only" :
                                                     ((CH2_TX_ENCODER=="Bypassed")&&(CH2_TDATA_WIDTH==10)) ? "10bit_only" :
                                                     ((CH2_TX_ENCODER=="Bypassed")&&(CH2_TDATA_WIDTH==16)) ? "16bit_only" :
                                                     ((CH2_TX_ENCODER=="Bypassed")&&(CH2_TDATA_WIDTH==20)) ? "20bit_only" :
                                                     ((CH2_TX_ENCODER=="Bypassed")&&(CH2_TDATA_WIDTH==32)) ? "32bit_only" :
                                                     ((CH2_TX_ENCODER=="Bypassed")&&(CH2_TDATA_WIDTH==40)) ? "40bit_only" :
                                                     ((CH2_TX_ENCODER=="8B10B") &&  (CH2_TDATA_WIDTH==8)) ? "8b10b_8bit" :
                                                     ((CH2_TX_ENCODER=="8B10B") &&  (CH2_TDATA_WIDTH==16)) ? "8b10b_16bit" : 
                                                     ((CH2_TX_ENCODER=="64B66B_transparent") &&  (CH2_TDATA_WIDTH==16)) ? "64b66b_16bit" :
                                                     ((CH2_TX_ENCODER=="64B66B_transparent") &&  (CH2_TDATA_WIDTH==32)) ? "64b66b_32bit" :
                                                     ((CH2_TX_ENCODER=="64B67B_transparent") &&  (CH2_TDATA_WIDTH==16)) ? "64b67b_16bit" :
                                                     ((CH2_TX_ENCODER=="64B67B_transparent") &&  (CH2_TDATA_WIDTH==32)) ? "64b67b_32bit" : "8b10b_32bit";
localparam           CH3_TDATA_WIDTH_TYPE          = ((CH3_TX_ENCODER=="Bypassed")&&(CH3_TDATA_WIDTH==8)) ? "8bit_only" :
                                                     ((CH3_TX_ENCODER=="Bypassed")&&(CH3_TDATA_WIDTH==10)) ? "10bit_only" :
                                                     ((CH3_TX_ENCODER=="Bypassed")&&(CH3_TDATA_WIDTH==16)) ? "16bit_only" :
                                                     ((CH3_TX_ENCODER=="Bypassed")&&(CH3_TDATA_WIDTH==20)) ? "20bit_only" :
                                                     ((CH3_TX_ENCODER=="Bypassed")&&(CH3_TDATA_WIDTH==32)) ? "32bit_only" :
                                                     ((CH3_TX_ENCODER=="Bypassed")&&(CH3_TDATA_WIDTH==40)) ? "40bit_only" :
                                                     ((CH3_TX_ENCODER=="8B10B") &&  (CH3_TDATA_WIDTH==8)) ? "8b10b_8bit" :
                                                     ((CH3_TX_ENCODER=="8B10B") &&  (CH3_TDATA_WIDTH==16)) ? "8b10b_16bit" :
                                                     ((CH3_TX_ENCODER=="64B66B_transparent") &&  (CH3_TDATA_WIDTH==16)) ? "64b66b_16bit" :
                                                     ((CH3_TX_ENCODER=="64B66B_transparent") &&  (CH3_TDATA_WIDTH==32)) ? "64b66b_32bit" :
                                                     ((CH3_TX_ENCODER=="64B67B_transparent") &&  (CH3_TDATA_WIDTH==16)) ? "64b67b_16bit" :
                                                     ((CH3_TX_ENCODER=="64B67B_transparent") &&  (CH3_TDATA_WIDTH==32)) ? "64b67b_32bit" : "8b10b_32bit";
localparam           CH0_RDATA_WIDTH_TYPE          = ((CH0_RX_DECODER=="Bypassed")&&(CH0_RDATA_WIDTH==8)) ? "8bit_only" :
                                                     ((CH0_RX_DECODER=="Bypassed")&&(CH0_RDATA_WIDTH==10)) ? "10bit_only" :
                                                     ((CH0_RX_DECODER=="Bypassed")&&(CH0_RDATA_WIDTH==16)) ? "16bit_only" :
                                                     ((CH0_RX_DECODER=="Bypassed")&&(CH0_RDATA_WIDTH==20)) ? "20bit_only" :
                                                     ((CH0_RX_DECODER=="Bypassed")&&(CH0_RDATA_WIDTH==32)) ? "32bit_only" :
                                                     ((CH0_RX_DECODER=="Bypassed")&&(CH0_RDATA_WIDTH==40)) ? "40bit_only" :
                                                     ((CH0_RX_DECODER=="8B10B") &&  (CH0_RDATA_WIDTH==8)) ? "8b10b_8bit" :
                                                     ((CH0_RX_DECODER=="8B10B") &&  (CH0_RDATA_WIDTH==16)) ? "8b10b_16bit" :
                                                     ((CH0_RX_DECODER=="64B66B_transparent") &&  (CH0_RDATA_WIDTH==16)) ? "64b66b_16bit" :
                                                     ((CH0_RX_DECODER=="64B66B_transparent") &&  (CH0_RDATA_WIDTH==32)) ? "64b66b_32bit" :
                                                     ((CH0_RX_DECODER=="64B67B_transparent") &&  (CH0_RDATA_WIDTH==16)) ? "64b67b_16bit" :
                                                     ((CH0_RX_DECODER=="64B67B_transparent") &&  (CH0_RDATA_WIDTH==32)) ? "64b67b_32bit" : "8b10b_32bit";
localparam           CH1_RDATA_WIDTH_TYPE          = ((CH1_RX_DECODER=="Bypassed")&&(CH1_RDATA_WIDTH==8)) ? "8bit_only" :
                                                     ((CH1_RX_DECODER=="Bypassed")&&(CH1_RDATA_WIDTH==10)) ? "10bit_only" :
                                                     ((CH1_RX_DECODER=="Bypassed")&&(CH1_RDATA_WIDTH==16)) ? "16bit_only" :
                                                     ((CH1_RX_DECODER=="Bypassed")&&(CH1_RDATA_WIDTH==20)) ? "20bit_only" :
                                                     ((CH1_RX_DECODER=="Bypassed")&&(CH1_RDATA_WIDTH==32)) ? "32bit_only" :
                                                     ((CH1_RX_DECODER=="Bypassed")&&(CH1_RDATA_WIDTH==40)) ? "40bit_only" :
                                                     ((CH1_RX_DECODER=="8B10B") &&  (CH1_RDATA_WIDTH==8)) ? "8b10b_8bit" :
                                                     ((CH1_RX_DECODER=="8B10B") &&  (CH1_RDATA_WIDTH==16)) ? "8b10b_16bit" :
                                                     ((CH1_RX_DECODER=="64B66B_transparent") &&  (CH1_RDATA_WIDTH==16)) ? "64b66b_16bit" :
                                                     ((CH1_RX_DECODER=="64B66B_transparent") &&  (CH1_RDATA_WIDTH==32)) ? "64b66b_32bit" :
                                                     ((CH1_RX_DECODER=="64B67B_transparent") &&  (CH1_RDATA_WIDTH==16)) ? "64b67b_16bit" :
                                                     ((CH1_RX_DECODER=="64B67B_transparent") &&  (CH1_RDATA_WIDTH==32)) ? "64b67b_32bit" : "8b10b_32bit";
localparam           CH2_RDATA_WIDTH_TYPE          = ((CH2_RX_DECODER=="Bypassed")&&(CH2_RDATA_WIDTH==8)) ? "8bit_only" :
                                                     ((CH2_RX_DECODER=="Bypassed")&&(CH2_RDATA_WIDTH==10)) ? "10bit_only" :
                                                     ((CH2_RX_DECODER=="Bypassed")&&(CH2_RDATA_WIDTH==16)) ? "16bit_only" :
                                                     ((CH2_RX_DECODER=="Bypassed")&&(CH2_RDATA_WIDTH==20)) ? "20bit_only" :
                                                     ((CH2_RX_DECODER=="Bypassed")&&(CH2_RDATA_WIDTH==32)) ? "32bit_only" :
                                                     ((CH2_RX_DECODER=="Bypassed")&&(CH2_RDATA_WIDTH==40)) ? "40bit_only" :
                                                     ((CH2_RX_DECODER=="8B10B") &&  (CH2_RDATA_WIDTH==8)) ? "8b10b_8bit" :
                                                     ((CH2_RX_DECODER=="8B10B") &&  (CH2_RDATA_WIDTH==16)) ? "8b10b_16bit" :
                                                     ((CH2_RX_DECODER=="64B66B_transparent") &&  (CH2_RDATA_WIDTH==16)) ? "64b66b_16bit" :
                                                     ((CH2_RX_DECODER=="64B66B_transparent") &&  (CH2_RDATA_WIDTH==32)) ? "64b66b_32bit" :
                                                     ((CH2_RX_DECODER=="64B67B_transparent") &&  (CH2_RDATA_WIDTH==16)) ? "64b67b_16bit" :
                                                     ((CH2_RX_DECODER=="64B67B_transparent") &&  (CH2_RDATA_WIDTH==32)) ? "64b67b_32bit" : "8b10b_32bit";
localparam           CH3_RDATA_WIDTH_TYPE          = ((CH3_RX_DECODER=="Bypassed")&&(CH3_RDATA_WIDTH==8)) ? "8bit_only" :
                                                     ((CH3_RX_DECODER=="Bypassed")&&(CH3_RDATA_WIDTH==10)) ? "10bit_only" :
                                                     ((CH3_RX_DECODER=="Bypassed")&&(CH3_RDATA_WIDTH==16)) ? "16bit_only" :
                                                     ((CH3_RX_DECODER=="Bypassed")&&(CH3_RDATA_WIDTH==20)) ? "20bit_only" :
                                                     ((CH3_RX_DECODER=="Bypassed")&&(CH3_RDATA_WIDTH==32)) ? "32bit_only" :
                                                     ((CH3_RX_DECODER=="Bypassed")&&(CH3_RDATA_WIDTH==40)) ? "40bit_only" :
                                                     ((CH3_RX_DECODER=="8B10B") &&  (CH3_RDATA_WIDTH==8)) ? "8b10b_8bit" :
                                                     ((CH3_RX_DECODER=="8B10B") &&  (CH3_RDATA_WIDTH==16)) ? "8b10b_16bit" :
                                                     ((CH3_RX_DECODER=="64B66B_transparent") &&  (CH3_RDATA_WIDTH==16)) ? "64b66b_16bit" :
                                                     ((CH3_RX_DECODER=="64B66B_transparent") &&  (CH3_RDATA_WIDTH==32)) ? "64b66b_32bit" :
                                                     ((CH3_RX_DECODER=="64B67B_transparent") &&  (CH3_RDATA_WIDTH==16)) ? "64b67b_16bit" :
                                                     ((CH3_RX_DECODER=="64B67B_transparent") &&  (CH3_RDATA_WIDTH==32)) ? "64b67b_32bit" : "8b10b_32bit";
localparam           PCS_CH0_BYPASS_WORD_ALIGN     = (CH0_RXPCS_ALIGN=="Bypassed") ? "TRUE" : "FALSE";         
localparam           PCS_CH1_BYPASS_WORD_ALIGN     = (CH1_RXPCS_ALIGN=="Bypassed") ? "TRUE" : "FALSE";         
localparam           PCS_CH2_BYPASS_WORD_ALIGN     = (CH2_RXPCS_ALIGN=="Bypassed") ? "TRUE" : "FALSE";         
localparam           PCS_CH3_BYPASS_WORD_ALIGN     = (CH3_RXPCS_ALIGN=="Bypassed") ? "TRUE" : "FALSE";         
localparam           PCS_CH0_BYPASS_BONDING        = (CH0_RXPCS_BONDING=="Bypassed") ? "TRUE" : "FALSE";         
localparam           PCS_CH1_BYPASS_BONDING        = (CH1_RXPCS_BONDING=="Bypassed") ? "TRUE" : "FALSE";         
localparam           PCS_CH2_BYPASS_BONDING        = (CH2_RXPCS_BONDING=="Bypassed") ? "TRUE" : "FALSE";         
localparam           PCS_CH3_BYPASS_BONDING        = (CH3_RXPCS_BONDING=="Bypassed") ? "TRUE" : "FALSE";         
localparam           PCS_CH0_BYPASS_CTC            = (CH0_RXPCS_CTC=="Bypassed") ? "TRUE" : "FALSE";         
localparam           PCS_CH1_BYPASS_CTC            = (CH1_RXPCS_CTC=="Bypassed") ? "TRUE" : "FALSE";         
localparam           PCS_CH2_BYPASS_CTC            = (CH2_RXPCS_CTC=="Bypassed") ? "TRUE" : "FALSE";         
localparam           PCS_CH3_BYPASS_CTC            = (CH3_RXPCS_CTC=="Bypassed") ? "TRUE" : "FALSE";         
localparam           PCS_CH0_ALIGN_MODE            = (CH0_RXPCS_ALIGN=="CUSTOMERIZED_MODE") ? "OUTSIDE" : 
                                                     (CH0_RXPCS_ALIGN=="RAPIDIO_MODE") ? "RAPIDIO" :            
                                                     (CH0_RXPCS_ALIGN=="XAUI_MODE") ? "10GB" : "1GB";           
localparam           PCS_CH1_ALIGN_MODE            = (CH1_RXPCS_ALIGN=="CUSTOMERIZED_MODE") ? "OUTSIDE" : 
                                                     (CH1_RXPCS_ALIGN=="RAPIDIO_MODE") ? "RAPIDIO" :            
                                                     (CH1_RXPCS_ALIGN=="XAUI_MODE") ? "10GB" : "1GB";           
localparam           PCS_CH2_ALIGN_MODE            = (CH2_RXPCS_ALIGN=="CUSTOMERIZED_MODE") ? "OUTSIDE" : 
                                                     (CH2_RXPCS_ALIGN=="RAPIDIO_MODE") ? "RAPIDIO" :            
                                                     (CH2_RXPCS_ALIGN=="XAUI_MODE") ? "10GB" : "1GB";           
localparam           PCS_CH3_ALIGN_MODE            = (CH3_RXPCS_ALIGN=="CUSTOMERIZED_MODE") ? "OUTSIDE" : 
                                                     (CH3_RXPCS_ALIGN=="RAPIDIO_MODE") ? "RAPIDIO" :            
                                                     (CH3_RXPCS_ALIGN=="XAUI_MODE") ? "10GB" : "1GB";           
localparam   integer PCS_CH0_COMMA_REG0            = CH0_RXPCS_COMMA_REG0;               
localparam   integer PCS_CH1_COMMA_REG0            = CH1_RXPCS_COMMA_REG0;               
localparam   integer PCS_CH2_COMMA_REG0            = CH2_RXPCS_COMMA_REG0;               
localparam   integer PCS_CH3_COMMA_REG0            = CH3_RXPCS_COMMA_REG0;               
localparam   integer PCS_CH0_COMMA_REG1            = 1023 - CH0_RXPCS_COMMA_REG0;               
localparam   integer PCS_CH1_COMMA_REG1            = 1023 - CH1_RXPCS_COMMA_REG0;               
localparam   integer PCS_CH2_COMMA_REG1            = 1023 - CH2_RXPCS_COMMA_REG0;               
localparam   integer PCS_CH3_COMMA_REG1            = 1023 - CH3_RXPCS_COMMA_REG0;               
localparam   integer PCS_CH0_RAPID_IMAX            = 5;               
localparam   integer PCS_CH1_RAPID_IMAX            = 5;               
localparam   integer PCS_CH2_RAPID_IMAX            = 5;               
localparam   integer PCS_CH3_RAPID_IMAX            = 5;               
localparam   integer PCS_CH0_RAPID_VMIN_1          = 250;
localparam   integer PCS_CH1_RAPID_VMIN_1          = 250;
localparam   integer PCS_CH2_RAPID_VMIN_1          = 250;
localparam   integer PCS_CH3_RAPID_VMIN_1          = 250;
localparam   integer PCS_CH0_RAPID_VMIN_2          = 1;
localparam   integer PCS_CH1_RAPID_VMIN_2          = 1;
localparam   integer PCS_CH2_RAPID_VMIN_2          = 1;
localparam   integer PCS_CH3_RAPID_VMIN_2          = 1;
localparam   integer PCS_CH0_COMMA_MASK            = CH0_RXPCS_COMMA_MASK;               
localparam   integer PCS_CH1_COMMA_MASK            = CH1_RXPCS_COMMA_MASK;               
localparam   integer PCS_CH2_COMMA_MASK            = CH2_RXPCS_COMMA_MASK;               
localparam   integer PCS_CH3_COMMA_MASK            = CH3_RXPCS_COMMA_MASK;               
localparam           PCS_CH0_CEB_MODE              = (CH0_RXPCS_BONDING=="CUSTOMERIZED_MODE") ? "OUTSIDE" :
                                                     (CH0_RXPCS_BONDING=="RAPIDIO_MODE") ? "RAPIDIO" : "10GB";          
localparam           PCS_CH1_CEB_MODE              = (CH1_RXPCS_BONDING=="CUSTOMERIZED_MODE") ? "OUTSIDE" :
                                                     (CH1_RXPCS_BONDING=="RAPIDIO_MODE") ? "RAPIDIO" : "10GB";          
localparam           PCS_CH2_CEB_MODE              = (CH2_RXPCS_BONDING=="CUSTOMERIZED_MODE") ? "OUTSIDE" :
                                                     (CH2_RXPCS_BONDING=="RAPIDIO_MODE") ? "RAPIDIO" : "10GB";          
localparam           PCS_CH3_CEB_MODE              = (CH3_RXPCS_BONDING=="CUSTOMERIZED_MODE") ? "OUTSIDE" :
                                                     (CH3_RXPCS_BONDING=="RAPIDIO_MODE") ? "RAPIDIO" : "10GB";          
localparam           PCS_CH0_CTC_MODE              = ((CH0_RXPCS_CTC=="CUSTOMERIZED_4BYTE")||(CH0_RXPCS_CTC=="PCIE_4BYTE")) ? "4SKIP" :          
                                                     ((CH0_RXPCS_CTC=="CUSTOMERIZED_2BYTE")||(CH0_RXPCS_CTC=="GE"  )) ? "2SKIP" : 
                                                      (CH0_RXPCS_CTC=="PCIE_2BYTE") ? "PCIE_2BYTE" : "1SKIP";          
localparam           PCS_CH1_CTC_MODE              = ((CH1_RXPCS_CTC=="CUSTOMERIZED_4BYTE")||(CH1_RXPCS_CTC=="PCIE_4BYTE")) ? "4SKIP" :          
                                                     ((CH1_RXPCS_CTC=="CUSTOMERIZED_2BYTE")||(CH1_RXPCS_CTC=="GE"  )) ? "2SKIP" : 
                                                      (CH1_RXPCS_CTC=="PCIE_2BYTE") ? "PCIE_2BYTE" : "1SKIP";          
localparam           PCS_CH2_CTC_MODE              = ((CH2_RXPCS_CTC=="CUSTOMERIZED_4BYTE")||(CH2_RXPCS_CTC=="PCIE_4BYTE")) ? "4SKIP" :          
                                                     ((CH2_RXPCS_CTC=="CUSTOMERIZED_2BYTE")||(CH2_RXPCS_CTC=="GE"  )) ? "2SKIP" :        
                                                      (CH2_RXPCS_CTC=="PCIE_2BYTE") ? "PCIE_2BYTE" : "1SKIP";          
localparam           PCS_CH3_CTC_MODE              = ((CH3_RXPCS_CTC=="CUSTOMERIZED_4BYTE")||(CH3_RXPCS_CTC=="PCIE_4BYTE")) ? "4SKIP" :          
                                                     ((CH3_RXPCS_CTC=="CUSTOMERIZED_2BYTE")||(CH3_RXPCS_CTC=="GE"  )) ? "2SKIP" :       
                                                      (CH3_RXPCS_CTC=="PCIE_2BYTE") ? "PCIE_2BYTE" : "1SKIP";          
localparam   integer PCS_CH0_SKIP_REG0             = CH0_RXPCS_SKIP_REG0;               
localparam   integer PCS_CH1_SKIP_REG0             = CH1_RXPCS_SKIP_REG0;               
localparam   integer PCS_CH2_SKIP_REG0             = CH2_RXPCS_SKIP_REG0;               
localparam   integer PCS_CH3_SKIP_REG0             = CH3_RXPCS_SKIP_REG0;               
localparam   integer PCS_CH0_SKIP_REG1             = CH0_RXPCS_SKIP_REG1;               
localparam   integer PCS_CH1_SKIP_REG1             = CH1_RXPCS_SKIP_REG1;               
localparam   integer PCS_CH2_SKIP_REG1             = CH2_RXPCS_SKIP_REG1;               
localparam   integer PCS_CH3_SKIP_REG1             = CH3_RXPCS_SKIP_REG1;               
localparam   integer PCS_CH0_SKIP_REG2             = CH0_RXPCS_SKIP_REG2;               
localparam   integer PCS_CH1_SKIP_REG2             = CH1_RXPCS_SKIP_REG2;               
localparam   integer PCS_CH2_SKIP_REG2             = CH2_RXPCS_SKIP_REG2;               
localparam   integer PCS_CH3_SKIP_REG2             = CH3_RXPCS_SKIP_REG2;               
localparam   integer PCS_CH0_SKIP_REG3             = CH0_RXPCS_SKIP_REG3;               
localparam   integer PCS_CH1_SKIP_REG3             = CH1_RXPCS_SKIP_REG3;               
localparam   integer PCS_CH2_SKIP_REG3             = CH2_RXPCS_SKIP_REG3;               
localparam   integer PCS_CH3_SKIP_REG3             = CH3_RXPCS_SKIP_REG3;               
localparam           PCS_CH0_GE_AUTO_EN            = (CH0_RXPCS_CTC=="GE") ? "TRUE" : "FALSE";         
localparam           PCS_CH1_GE_AUTO_EN            = (CH1_RXPCS_CTC=="GE") ? "TRUE" : "FALSE";         
localparam           PCS_CH2_GE_AUTO_EN            = (CH2_RXPCS_CTC=="GE") ? "TRUE" : "FALSE";         
localparam           PCS_CH3_GE_AUTO_EN            = (CH3_RXPCS_CTC=="GE") ? "TRUE" : "FALSE";         
localparam   integer PCS_CH0_A_REG                 = CH0_RXPCS_A_REG;               
localparam   integer PCS_CH1_A_REG                 = CH1_RXPCS_A_REG;               
localparam   integer PCS_CH2_A_REG                 = CH2_RXPCS_A_REG;               
localparam   integer PCS_CH3_A_REG                 = CH3_RXPCS_A_REG;               
localparam           PCS_CH0_PCIE_SLAVE            = "MASTER";        
localparam           PCS_CH1_PCIE_SLAVE            = (CH0_PROTOCOL=="PCIEx4" || CH0_PROTOCOL=="PCIEx2") ? "SLAVE" : "MASTER";        
localparam           PCS_CH2_PCIE_SLAVE            = (CH0_PROTOCOL=="PCIEx4") ? "SLAVE" : "MASTER";        
localparam           PCS_CH3_PCIE_SLAVE            = (CH0_PROTOCOL=="PCIEx4" || CH2_PROTOCOL=="PCIEx2") ? "SLAVE" : "MASTER";        
localparam   integer PCS_CH0_SLAVE                 = 0;        
localparam   integer PCS_CH1_SLAVE                 = (PCS_CH1_BYPASS_BONDING=="FALSE") ? 1 : 0;
localparam   integer PCS_CH2_SLAVE                 = (CH0_PROTOCOL=="CUSTOMERIZEDx4" && PCS_CH2_BYPASS_BONDING=="FALSE") ? 1 : 
                                                     (CH0_PROTOCOL=="XAUI" && PCS_CH2_BYPASS_BONDING=="FALSE") ? 1 : 0;
localparam   integer PCS_CH3_SLAVE                 = (CH0_PROTOCOL=="CUSTOMERIZEDx4" && PCS_CH3_BYPASS_BONDING=="FALSE") ? 1 : 
                                                     (CH0_PROTOCOL=="XAUI" && PCS_CH3_BYPASS_BONDING=="FALSE") ? 1 :
                                                     (CH2_PROTOCOL=="CUSTOMERIZEDx2" && PCS_CH3_BYPASS_BONDING=="FALSE") ? 1 : 0;
localparam           PCS_CH0_TX_SLAVE              = "MASTER";         
localparam           PCS_CH1_TX_SLAVE              = (CH0_PROTOCOL=="CUSTOMERIZEDx4") ? "SLAVE" : 
                                                     (CH0_PROTOCOL=="PCIEx4") ? "SLAVE" :
                                                     (CH0_PROTOCOL=="XAUI") ? "SLAVE" :
                                                     (CH0_PROTOCOL=="CUSTOMERIZEDx2" || CH0_PROTOCOL=="PCIEx2") ? "SLAVE" : 
                                                     "MASTER";
localparam           PCS_CH2_TX_SLAVE               = (CH0_PROTOCOL=="CUSTOMERIZEDx4") ? "SLAVE" : 
                                                     (CH0_PROTOCOL=="PCIEx4") ? "SLAVE" :
                                                     (CH0_PROTOCOL=="XAUI") ? "SLAVE" : "MASTER";
localparam           PCS_CH3_TX_SLAVE               = (CH0_PROTOCOL=="CUSTOMERIZEDx4") ? "SLAVE" : 
                                                     (CH0_PROTOCOL=="PCIEx4") ? "SLAVE" :
                                                     (CH0_PROTOCOL=="XAUI") ? "SLAVE" :
                                                     (CH2_PROTOCOL=="CUSTOMERIZEDx2" || CH2_PROTOCOL=="PCIEx2") ? "SLAVE" : "MASTER";
localparam   integer PCS_CH0_MASTER_CHECK_OFFSET   = 4;               
localparam   integer PCS_CH1_MASTER_CHECK_OFFSET   = 4;               
localparam   integer PCS_CH2_MASTER_CHECK_OFFSET   = 4;               
localparam   integer PCS_CH3_MASTER_CHECK_OFFSET   = 4;               
localparam   integer PCS_CH0_DELAY_SET             = 3;               
localparam   integer PCS_CH1_DELAY_SET             = 2; //to be done for CH0 PCIEx2               
localparam   integer PCS_CH2_DELAY_SET             = (CH2_PROTOCOL=="CUSTOMERIZEDx2") ? 3 : 1;               
localparam   integer PCS_CH3_DELAY_SET             = (CH2_PROTOCOL=="CUSTOMERIZEDx2") ? 2 : 0; //to be done for CH2 PCIEx2               
localparam           PCS_CH0_SEACH_OFFSET          = CH0_RXPCS_BONDING_RANGE;         
localparam           PCS_CH1_SEACH_OFFSET          = CH1_RXPCS_BONDING_RANGE;         
localparam           PCS_CH2_SEACH_OFFSET          = CH2_RXPCS_BONDING_RANGE;         
localparam           PCS_CH3_SEACH_OFFSET          = CH3_RXPCS_BONDING_RANGE;         
localparam   integer PCS_CH0_CEB_RAPIDLS_MMAX      = 5;         
localparam   integer PCS_CH1_CEB_RAPIDLS_MMAX      = 5;         
localparam   integer PCS_CH2_CEB_RAPIDLS_MMAX      = 5;         
localparam   integer PCS_CH3_CEB_RAPIDLS_MMAX      = 5;         
localparam           PCS_CH0_PMA_TX2RX_PLOOP_EN    = CH0_DEBUG_BUS ;//TRUE, FALSE                                                                  
localparam           PCS_CH1_PMA_TX2RX_PLOOP_EN    = CH1_DEBUG_BUS ;//TRUE, FALSE                                                                  
localparam           PCS_CH2_PMA_TX2RX_PLOOP_EN    = CH2_DEBUG_BUS ;//TRUE, FALSE                                                                  
localparam           PCS_CH3_PMA_TX2RX_PLOOP_EN    = CH3_DEBUG_BUS ;//TRUE, FALSE                                                                  
localparam           PCS_CH0_PMA_TX2RX_SLOOP_EN    = CH0_DEBUG_BUS ;//TRUE, FALSE                                                                  
localparam           PCS_CH1_PMA_TX2RX_SLOOP_EN    = CH1_DEBUG_BUS ;//TRUE, FALSE                                                                  
localparam           PCS_CH2_PMA_TX2RX_SLOOP_EN    = CH2_DEBUG_BUS ;//TRUE, FALSE                                                                  
localparam           PCS_CH3_PMA_TX2RX_SLOOP_EN    = CH3_DEBUG_BUS ;//TRUE, FALSE                                                                  
localparam           PCS_CH0_PMA_RX2TX_PLOOP_EN    = CH0_DEBUG_BUS ;//TRUE, FALSE                                                                  
localparam           PCS_CH1_PMA_RX2TX_PLOOP_EN    = CH1_DEBUG_BUS ;//TRUE, FALSE                                                                  
localparam           PCS_CH2_PMA_RX2TX_PLOOP_EN    = CH2_DEBUG_BUS ;//TRUE, FALSE                                                                  
localparam           PCS_CH3_PMA_RX2TX_PLOOP_EN    = CH3_DEBUG_BUS ;//TRUE, FALSE                                                                  

localparam           PMA_CH0_REG_TX_BUSWIDTH_OW    = "TRUE";       
localparam           PMA_CH1_REG_TX_BUSWIDTH_OW    = "TRUE";       
localparam           PMA_CH2_REG_TX_BUSWIDTH_OW    = "TRUE";       
localparam           PMA_CH3_REG_TX_BUSWIDTH_OW    = "TRUE";       
localparam           PMA_CH0_REG_RX_BUSWIDTH_EN    = "TRUE";       
localparam           PMA_CH1_REG_RX_BUSWIDTH_EN    = "TRUE";       
localparam           PMA_CH2_REG_RX_BUSWIDTH_EN    = "TRUE";       
localparam           PMA_CH3_REG_RX_BUSWIDTH_EN    = "TRUE";       
localparam   integer PMA_CH0_REG_RX_TERM_MODE_CTRL = CH0_RXPMA_RTERM;
localparam   integer PMA_CH1_REG_RX_TERM_MODE_CTRL = CH1_RXPMA_RTERM;
localparam   integer PMA_CH2_REG_RX_TERM_MODE_CTRL = CH2_RXPMA_RTERM;       
localparam   integer PMA_CH3_REG_RX_TERM_MODE_CTRL = CH3_RXPMA_RTERM;       
localparam   integer PMA_CH0_REG_RX_RESERVED_361_354 = 0;       
localparam   integer PMA_CH1_REG_RX_RESERVED_361_354 = 0;       
localparam   integer PMA_CH2_REG_RX_RESERVED_361_354 = 0;       
localparam   integer PMA_CH3_REG_RX_RESERVED_361_354 = 0;       
localparam           PMA_CH0_REG_RX_HIGHZ          = "FALSE";       
localparam           PMA_CH1_REG_RX_HIGHZ          = "FALSE";       
localparam           PMA_CH2_REG_RX_HIGHZ          = "FALSE";       
localparam           PMA_CH3_REG_RX_HIGHZ          = "FALSE";       
localparam           PMA_CH0_REG_RX_HIGHZ_EN       = "FALSE";       
localparam           PMA_CH1_REG_RX_HIGHZ_EN       = "FALSE";       
localparam           PMA_CH2_REG_RX_HIGHZ_EN       = "FALSE";       
localparam           PMA_CH3_REG_RX_HIGHZ_EN       = "FALSE";       
localparam           PMA_CH0_REG_CDR_LOCK_TIMER    = (CH0_PROTOCOL=="PCIEx1" || CH0_PROTOCOL=="PCIEx2" || CH0_PROTOCOL=="PCIEx4") ? "1_2U" : "25_6U";
localparam           PMA_CH1_REG_CDR_LOCK_TIMER    = (CH1_PROTOCOL=="PCIEx1" || CH1_PROTOCOL=="PCIEx2" || CH1_PROTOCOL=="PCIEx4") ? "1_2U" : "25_6U";
localparam           PMA_CH2_REG_CDR_LOCK_TIMER    = (CH2_PROTOCOL=="PCIEx1" || CH2_PROTOCOL=="PCIEx2" || CH2_PROTOCOL=="PCIEx4") ? "1_2U" : "25_6U";
localparam           PMA_CH3_REG_CDR_LOCK_TIMER    = (CH3_PROTOCOL=="PCIEx1" || CH3_PROTOCOL=="PCIEx2" || CH3_PROTOCOL=="PCIEx4") ? "1_2U" : "25_6U";
localparam           PMA_CH0_REG_PD_PRE            = CH0_PRE_CURSOR_EN=="TRUE" ? "FALSE" : "TRUE";
localparam           PMA_CH1_REG_PD_PRE            = CH1_PRE_CURSOR_EN=="TRUE" ? "FALSE" : "TRUE";
localparam           PMA_CH2_REG_PD_PRE            = CH2_PRE_CURSOR_EN=="TRUE" ? "FALSE" : "TRUE";
localparam           PMA_CH3_REG_PD_PRE            = CH3_PRE_CURSOR_EN=="TRUE" ? "FALSE" : "TRUE";
localparam   integer PMA_CH0_REG_TX_CFG_PRE        = CH0_PRE_CURSOR_EMPHASIS;       
localparam   integer PMA_CH1_REG_TX_CFG_PRE        = CH1_PRE_CURSOR_EMPHASIS;       
localparam   integer PMA_CH2_REG_TX_CFG_PRE        = CH2_PRE_CURSOR_EMPHASIS;       
localparam   integer PMA_CH3_REG_TX_CFG_PRE        = CH3_PRE_CURSOR_EMPHASIS;       
localparam           PMA_CH0_REG_TX_PD_POST        = (CH0_POST_CURSOR_EN=="TRUE" || CH0_FFE_CTRL_EN=="TRUE") ? "ON" : "OFF";
localparam           PMA_CH1_REG_TX_PD_POST        = (CH1_POST_CURSOR_EN=="TRUE" || CH1_FFE_CTRL_EN=="TRUE") ? "ON" : "OFF";
localparam           PMA_CH2_REG_TX_PD_POST        = (CH2_POST_CURSOR_EN=="TRUE" || CH2_FFE_CTRL_EN=="TRUE") ? "ON" : "OFF";
localparam           PMA_CH3_REG_TX_PD_POST        = (CH3_POST_CURSOR_EN=="TRUE" || CH3_FFE_CTRL_EN=="TRUE") ? "ON" : "OFF";
localparam   integer PMA_CH0_REG_CFG_POST          = CH0_POST_CURSOR_EMPHASIS;       
localparam   integer PMA_CH1_REG_CFG_POST          = CH1_POST_CURSOR_EMPHASIS;       
localparam   integer PMA_CH2_REG_CFG_POST          = CH2_POST_CURSOR_EMPHASIS;       
localparam   integer PMA_CH3_REG_CFG_POST          = CH3_POST_CURSOR_EMPHASIS;       
localparam   integer PMA_CH0_REG_CFG_POST1         = CH0_POST1_CURSOR_EMPHASIS;       
localparam   integer PMA_CH1_REG_CFG_POST1         = CH1_POST1_CURSOR_EMPHASIS;       
localparam   integer PMA_CH2_REG_CFG_POST1         = CH2_POST1_CURSOR_EMPHASIS;       
localparam   integer PMA_CH3_REG_CFG_POST1         = CH3_POST1_CURSOR_EMPHASIS;       
localparam   integer PMA_CH0_REG_CFG_POST2         = CH0_POST2_CURSOR_EMPHASIS;       
localparam   integer PMA_CH1_REG_CFG_POST2         = CH1_POST2_CURSOR_EMPHASIS;       
localparam   integer PMA_CH2_REG_CFG_POST2         = CH2_POST2_CURSOR_EMPHASIS;       
localparam   integer PMA_CH3_REG_CFG_POST2         = CH3_POST2_CURSOR_EMPHASIS;       
localparam   integer PMA_CH0_REG_RX_RESERVED_353_346 = CH0_RX_CLK_SLIP_EN=="TRUE" ? 1 : 0;
localparam   integer PMA_CH1_REG_RX_RESERVED_353_346 = CH1_RX_CLK_SLIP_EN=="TRUE" ? 1 : 0;
localparam   integer PMA_CH2_REG_RX_RESERVED_353_346 = CH2_RX_CLK_SLIP_EN=="TRUE" ? 1 : 0;
localparam   integer PMA_CH3_REG_RX_RESERVED_353_346 = CH3_RX_CLK_SLIP_EN=="TRUE" ? 1 : 0;

localparam           PMA_PLL0_REG_REFCLK_PAD_SEL   = (PLL0_REF_SEL=="Fabric_REFCK0" || PLL0_REF_SEL=="Fabric_REFCK1") ? "TRUE" : "FALSE";         
localparam           PMA_PLL1_REG_REFCLK_PAD_SEL   = (PLL1_REF_SEL=="Fabric_REFCK0" || PLL1_REF_SEL=="Fabric_REFCK1") ? "TRUE" : "FALSE";         

localparam           PMA_PLL0_PARM_PLL_POWERUP     = "ON";         
localparam           PMA_PLL0_REG_PLL_LOCKDET_MODE = "FALSE";
localparam   integer PMA_PLL0_REG_PLL_LOCKDET_FBCT = 3 ;            
localparam   integer PMA_PLL0_REG_PLL_LOCKDET_ITER = 0 ;            
localparam   integer PMA_PLL0_REG_PLL_LOCKDET_REFCT= 3 ;            
localparam   integer PMA_PLL0_REG_PLL_REFDIV       = (PLL0_M==2) ? 0 : 16; //16 means M = 1
localparam   integer PMA_PLL0_REG_PLL_FBDIV        = (PLL0_N2==1 && PLL0_N1==4) ? 6'b010000 : // N1*N2 = 4
                                                     (PLL0_N2==1 && PLL0_N1==5) ? 6'b110000 : // N1*N2 = 5
                                                     (PLL0_N2==2 && PLL0_N1==4) ? 6'b000000 : // N1*N2 = 8
                                                     (PLL0_N2==2 && PLL0_N1==5) ? 6'b100000 : // N1*N2 = 10
                                                     (PLL0_N2==3 && PLL0_N1==4) ? 6'b000001 : // N1*N2 = 12
                                                     (PLL0_N2==3 && PLL0_N1==5) ? 6'b100001 : // N1*N2 = 15
                                                     (PLL0_N2==4 && PLL0_N1==4) ? 6'b000100 : // N1*N2 = 16 
                                                     (PLL0_N2==5 && PLL0_N1==4) ? 6'b000011 : // N1*N2 = 20
                                                     (PLL0_N2==4 && PLL0_N1==5) ? 6'b100100 : // N1*N2 = 20
                                                     (PLL0_N2==6 && PLL0_N1==4) ? 6'b000101 : // N1*N2 = 24
                                                     (PLL0_N2==5 && PLL0_N1==5) ? 6'b100011 : // N1*N2 = 25
                                                     (PLL0_N2==6 && PLL0_N1==5) ? 6'b100101 : // N1*N2 = 30 
                                                     (PLL0_N2==8 && PLL0_N1==4) ? 6'b000110 : // N1*N2 = 32 
                                                     (PLL0_N2==8 && PLL0_N1==5) ? 6'b100110 : 6'b100111 ; // N1*N2 = 40 or N1*N2 = 50
                                            
localparam           PMA_PLL1_PARM_PLL_POWERUP     = PLL_NUM ==2 ? "ON" : "OFF";         
localparam           PMA_PLL1_REG_PLL_LOCKDET_MODE = "FALSE";      
localparam   integer PMA_PLL1_REG_PLL_LOCKDET_FBCT = 3 ;            
localparam   integer PMA_PLL1_REG_PLL_LOCKDET_ITER = 0 ;            
localparam   integer PMA_PLL1_REG_PLL_LOCKDET_REFCT= 3 ;            
localparam   integer PMA_PLL1_REG_PLL_REFDIV       = (PLL1_M==2) ? 0 : 16; //16 means M = 1
localparam   integer PMA_PLL1_REG_PLL_FBDIV        = (PLL1_N2==1 && PLL1_N1==4) ? 6'b010000 : // N1*N2 = 4
                                                     (PLL1_N2==1 && PLL1_N1==5) ? 6'b110000 : // N1*N2 = 5
                                                     (PLL1_N2==2 && PLL1_N1==4) ? 6'b000000 : // N1*N2 = 8
                                                     (PLL1_N2==2 && PLL1_N1==5) ? 6'b100000 : // N1*N2 = 10
                                                     (PLL1_N2==3 && PLL1_N1==4) ? 6'b000001 : // N1*N2 = 12
                                                     (PLL1_N2==3 && PLL1_N1==5) ? 6'b100001 : // N1*N2 = 15
                                                     (PLL1_N2==4 && PLL1_N1==4) ? 6'b000100 : // N1*N2 = 16 
                                                     (PLL1_N2==5 && PLL1_N1==4) ? 6'b000011 : // N1*N2 = 20
                                                     (PLL1_N2==4 && PLL1_N1==5) ? 6'b100100 : // N1*N2 = 20
                                                     (PLL1_N2==6 && PLL1_N1==4) ? 6'b000101 : // N1*N2 = 24
                                                     (PLL1_N2==5 && PLL1_N1==5) ? 6'b100011 : // N1*N2 = 25
                                                     (PLL1_N2==6 && PLL1_N1==5) ? 6'b100101 : // N1*N2 = 30 
                                                     (PLL1_N2==8 && PLL1_N1==4) ? 6'b000110 : // N1*N2 = 32 
                                                     (PLL1_N2==8 && PLL1_N1==5) ? 6'b100110 : 6'b100111 ; // N1*N2 = 40 or N1*N2 = 50


//*******************************************************************************************************************
localparam PCS_CH0_TX_BYPASS_ENC  =  CH0_TDATA_WIDTH_TYPE == "8b10b_8bit"   ? "FALSE" :
                                    CH0_TDATA_WIDTH_TYPE == "8b10b_16bit"  ? "FALSE" :
                                    CH0_TDATA_WIDTH_TYPE == "8b10b_32bit"  ? "FALSE" : "TRUE";
localparam PCS_CH1_TX_BYPASS_ENC  =  CH1_TDATA_WIDTH_TYPE == "8b10b_8bit"   ? "FALSE" :
                                    CH1_TDATA_WIDTH_TYPE == "8b10b_16bit"  ? "FALSE" :
                                    CH1_TDATA_WIDTH_TYPE == "8b10b_32bit"  ? "FALSE" : "TRUE";
localparam PCS_CH2_TX_BYPASS_ENC  =  CH2_TDATA_WIDTH_TYPE == "8b10b_8bit"   ? "FALSE" :
                                    CH2_TDATA_WIDTH_TYPE == "8b10b_16bit"  ? "FALSE" :
                                    CH2_TDATA_WIDTH_TYPE == "8b10b_32bit"  ? "FALSE" : "TRUE";
localparam PCS_CH3_TX_BYPASS_ENC  =  CH3_TDATA_WIDTH_TYPE == "8b10b_8bit"   ? "FALSE" :
                                    CH3_TDATA_WIDTH_TYPE == "8b10b_16bit"  ? "FALSE" :
                                    CH3_TDATA_WIDTH_TYPE == "8b10b_32bit"  ? "FALSE" : "TRUE";                                                                                                            
                                    
localparam PCS_CH0_TX_BYPASS_GEAR = CH0_TDATA_WIDTH_TYPE == "32bit_only"  ? "FALSE" :
                                    CH0_TDATA_WIDTH_TYPE == "40bit_only"  ? "FALSE" :
                                    CH0_TDATA_WIDTH_TYPE == "8b10b_32bit" ? "FALSE" :
                                    CH0_TDATA_WIDTH_TYPE == "64b66b_16bit"? "FALSE" :
                                    CH0_TDATA_WIDTH_TYPE == "64b66b_32bit"? "FALSE" : 
                                    CH0_TDATA_WIDTH_TYPE == "64b67b_16bit"? "FALSE" : 
                                    CH0_TDATA_WIDTH_TYPE == "64b67b_32bit"? "FALSE" : "TRUE";
localparam PCS_CH1_TX_BYPASS_GEAR = CH1_TDATA_WIDTH_TYPE == "32bit_only"  ? "FALSE" :
                                    CH1_TDATA_WIDTH_TYPE == "40bit_only"  ? "FALSE" :
                                    CH1_TDATA_WIDTH_TYPE == "8b10b_32bit" ? "FALSE" :
                                    CH1_TDATA_WIDTH_TYPE == "64b66b_16bit"? "FALSE" :
                                    CH1_TDATA_WIDTH_TYPE == "64b66b_32bit"? "FALSE" : 
                                    CH1_TDATA_WIDTH_TYPE == "64b67b_16bit"? "FALSE" : 
                                    CH1_TDATA_WIDTH_TYPE == "64b67b_32bit"? "FALSE" : "TRUE";
localparam PCS_CH2_TX_BYPASS_GEAR = CH2_TDATA_WIDTH_TYPE == "32bit_only"  ? "FALSE" :
                                    CH2_TDATA_WIDTH_TYPE == "40bit_only"  ? "FALSE" :
                                    CH2_TDATA_WIDTH_TYPE == "8b10b_32bit" ? "FALSE" :
                                    CH2_TDATA_WIDTH_TYPE == "64b66b_16bit"? "FALSE" :
                                    CH2_TDATA_WIDTH_TYPE == "64b66b_32bit"? "FALSE" : 
                                    CH2_TDATA_WIDTH_TYPE == "64b67b_16bit"? "FALSE" : 
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
localparam PCS_CH3_TX_BRIDGE_TCLK_SEL = TX3_CLK2_FR_CORE == "TRUE"  ? "TCLK2" :  "TCLK";       

localparam PCS_CH0_PCS_TCLK_SEL = "PMA_TCLK";
localparam PCS_CH1_PCS_TCLK_SEL = "PMA_TCLK";
localparam PCS_CH2_PCS_TCLK_SEL = "PMA_TCLK";
localparam PCS_CH3_PCS_TCLK_SEL = "PMA_TCLK";

localparam PCS_CH0_TX_GEAR_CLK_EN_SEL = TX0_CLK2_FR_CORE == "TRUE"  ? "TRUE" :  "FALSE";       
localparam PCS_CH1_TX_GEAR_CLK_EN_SEL = TX1_CLK2_FR_CORE == "TRUE"  ? "TRUE" :  "FALSE";       
localparam PCS_CH2_TX_GEAR_CLK_EN_SEL = TX2_CLK2_FR_CORE == "TRUE"  ? "TRUE" :  "FALSE";       
localparam PCS_CH3_TX_GEAR_CLK_EN_SEL = TX3_CLK2_FR_CORE == "TRUE"  ? "TRUE" :  "FALSE";       
                                      
localparam PCS_CH0_GEAR_TCLK_SEL = TX0_CLK2_FR_CORE == "TRUE"  ? "TCLK2" :  "PMA_TCLK"; 
localparam PCS_CH1_GEAR_TCLK_SEL = TX1_CLK2_FR_CORE == "TRUE"  ? "TCLK2" :  "PMA_TCLK"; 
localparam PCS_CH2_GEAR_TCLK_SEL = TX2_CLK2_FR_CORE == "TRUE"  ? "TCLK2" :  "PMA_TCLK"; 
localparam PCS_CH3_GEAR_TCLK_SEL = TX3_CLK2_FR_CORE == "TRUE"  ? "TCLK2" :  "PMA_TCLK"; 

localparam PCS_CH0_TX_BRIDGE_GEAR_SEL = TX0_CLK2_FR_CORE == "TRUE"  ? "TRUE" :  "FALSE"; 
localparam PCS_CH1_TX_BRIDGE_GEAR_SEL = TX1_CLK2_FR_CORE == "TRUE"  ? "TRUE" :  "FALSE"; 
localparam PCS_CH2_TX_BRIDGE_GEAR_SEL = TX2_CLK2_FR_CORE == "TRUE"  ? "TRUE" :  "FALSE"; 
localparam PCS_CH3_TX_BRIDGE_GEAR_SEL = TX3_CLK2_FR_CORE == "TRUE"  ? "TRUE" :  "FALSE"; 

localparam PCS_CH0_TX_BYPASS_BRIDGE_UINT = "FALSE";
localparam PCS_CH1_TX_BYPASS_BRIDGE_UINT = "FALSE";
localparam PCS_CH2_TX_BYPASS_BRIDGE_UINT = "FALSE";
localparam PCS_CH3_TX_BYPASS_BRIDGE_UINT = "FALSE";

localparam PCS_CH0_TX_BYPASS_BRIDGE_FIFO = "FALSE";
localparam PCS_CH1_TX_BYPASS_BRIDGE_FIFO = "FALSE";
localparam PCS_CH2_TX_BYPASS_BRIDGE_FIFO = "FALSE";
localparam PCS_CH3_TX_BYPASS_BRIDGE_FIFO = "FALSE";

localparam PCS_CH0_TX_TCLK2FABRIC_SEL 	= CH0_TDATA_WIDTH_TYPE == "32bit_only"  ? "TRUE" :
                                          CH0_TDATA_WIDTH_TYPE == "40bit_only"  ? "TRUE" :
                                          CH0_TDATA_WIDTH_TYPE == "8b10b_32bit" ? "TRUE" :
                                          CH0_TDATA_WIDTH_TYPE == "64b66b_32bit"? "TRUE" :
                                          CH0_TDATA_WIDTH_TYPE == "64b67b_32bit"? "TRUE" : "FALSE";
localparam PCS_CH1_TX_TCLK2FABRIC_SEL 	= PCIE_CLK_MODE_EN_1   == "TRUE"        ? "FALSE":
                                          CH1_TDATA_WIDTH_TYPE == "32bit_only"  ? "TRUE" :
                                          CH1_TDATA_WIDTH_TYPE == "40bit_only"  ? "TRUE" :
                                          CH1_TDATA_WIDTH_TYPE == "8b10b_32bit" ? "TRUE" :
                                          CH1_TDATA_WIDTH_TYPE == "64b66b_32bit"? "TRUE" :
                                          CH1_TDATA_WIDTH_TYPE == "64b67b_32bit"? "TRUE" : "FALSE";
localparam PCS_CH2_TX_TCLK2FABRIC_SEL 	= CH2_TDATA_WIDTH_TYPE == "32bit_only"  ? "TRUE" :
                                          CH2_TDATA_WIDTH_TYPE == "40bit_only"  ? "TRUE" :
                                          CH2_TDATA_WIDTH_TYPE == "8b10b_32bit" ? "TRUE" :
                                          CH2_TDATA_WIDTH_TYPE == "64b66b_32bit"? "TRUE" :
                                          CH2_TDATA_WIDTH_TYPE == "64b67b_32bit"? "TRUE" : "FALSE";
localparam PCS_CH3_TX_TCLK2FABRIC_SEL 	= PCIE_CLK_MODE_EN_3   == "TRUE"        ? "FALSE":
                                          CH3_TDATA_WIDTH_TYPE == "32bit_only"  ? "TRUE" :
                                          CH3_TDATA_WIDTH_TYPE == "40bit_only"  ? "TRUE" :
                                          CH3_TDATA_WIDTH_TYPE == "8b10b_32bit" ? "TRUE" :
                                          CH3_TDATA_WIDTH_TYPE == "64b66b_32bit"? "TRUE" :
                                          CH3_TDATA_WIDTH_TYPE == "64b67b_32bit"? "TRUE" : "FALSE";
//
localparam PCS_CH0_TX_OUTZZ =  "FALSE";
localparam PCS_CH1_TX_OUTZZ =  "FALSE";  
localparam PCS_CH2_TX_OUTZZ =  "FALSE";
localparam PCS_CH3_TX_OUTZZ =  "FALSE";                     

localparam PCS_CH0_DATA_WIDTH_MODE      = CH0_TDATA_WIDTH_TYPE == "8bit_only"   ? "X8"  :
                                      CH0_TDATA_WIDTH_TYPE == "10bit_only"  ? "X10" :
                                      CH0_TDATA_WIDTH_TYPE == "8b10b_8bit"  ? "X10" :
                                      CH0_TDATA_WIDTH_TYPE == "16bit_only"  ? "X16" :
                                      CH0_TDATA_WIDTH_TYPE == "20bit_only"  ? "X20" :
                                      CH0_TDATA_WIDTH_TYPE == "8b10b_16bit" ? "X20" :
                                      CH0_TDATA_WIDTH_TYPE == "32bit_only"  ? "X16" :
                                      CH0_TDATA_WIDTH_TYPE == "64b66b_16bit"? "X16" : 
                                      CH0_TDATA_WIDTH_TYPE == "64b66b_32bit"? "X16" : 
                                      CH0_TDATA_WIDTH_TYPE == "64b67b_16bit"? "X16" :
                                      CH0_TDATA_WIDTH_TYPE == "64b67b_32bit"? "X16" : "X20";
localparam PCS_CH1_DATA_WIDTH_MODE 	= CH1_TDATA_WIDTH_TYPE == "8bit_only"   ? "X8"  :
                                      CH1_TDATA_WIDTH_TYPE == "10bit_only"  ? "X10" :
                                      CH1_TDATA_WIDTH_TYPE == "8b10b_8bit"  ? "X10" :
                                      CH1_TDATA_WIDTH_TYPE == "16bit_only"  ? "X16" :
                                      CH1_TDATA_WIDTH_TYPE == "20bit_only"  ? "X20" :
                                      CH1_TDATA_WIDTH_TYPE == "8b10b_16bit" ? "X20" :
                                      CH1_TDATA_WIDTH_TYPE == "32bit_only"  ? "X16" :
                                      CH1_TDATA_WIDTH_TYPE == "64b66b_16bit"? "X16" : 
                                      CH1_TDATA_WIDTH_TYPE == "64b66b_32bit"? "X16" : 
                                      CH1_TDATA_WIDTH_TYPE == "64b67b_16bit"? "X16" :
                                      CH1_TDATA_WIDTH_TYPE == "64b67b_32bit"? "X16" : "X20";
localparam PCS_CH2_DATA_WIDTH_MODE 	= CH2_TDATA_WIDTH_TYPE == "8bit_only"   ? "X8"  :
                                      CH2_TDATA_WIDTH_TYPE == "10bit_only"  ? "X10" :
                                      CH2_TDATA_WIDTH_TYPE == "8b10b_8bit"  ? "X10" :
                                      CH2_TDATA_WIDTH_TYPE == "16bit_only"  ? "X16" :
                                      CH2_TDATA_WIDTH_TYPE == "20bit_only"  ? "X20" :
                                      CH2_TDATA_WIDTH_TYPE == "8b10b_16bit" ? "X20" :
                                      CH2_TDATA_WIDTH_TYPE == "32bit_only"  ? "X16" :                                   
                                      CH2_TDATA_WIDTH_TYPE == "64b66b_16bit"? "X16" : 
                                      CH2_TDATA_WIDTH_TYPE == "64b66b_32bit"? "X16" : 
                                      CH2_TDATA_WIDTH_TYPE == "64b67b_16bit"? "X16" :
                                      CH2_TDATA_WIDTH_TYPE == "64b67b_32bit"? "X16" : "X20";
localparam PCS_CH3_DATA_WIDTH_MODE 	= CH3_TDATA_WIDTH_TYPE == "8bit_only"   ? "X8"  :
                                      CH3_TDATA_WIDTH_TYPE == "10bit_only"  ? "X10" :
                                      CH3_TDATA_WIDTH_TYPE == "8b10b_8bit"  ? "X10" :
                                      CH3_TDATA_WIDTH_TYPE == "16bit_only"  ? "X16" :
                                      CH3_TDATA_WIDTH_TYPE == "20bit_only"  ? "X20" :
                                      CH3_TDATA_WIDTH_TYPE == "8b10b_16bit" ? "X20" :
                                      CH3_TDATA_WIDTH_TYPE == "32bit_only"  ? "X16" :                                                                          
                                      CH3_TDATA_WIDTH_TYPE == "64b66b_16bit"? "X16" : 
                                      CH3_TDATA_WIDTH_TYPE == "64b66b_32bit"? "X16" : 
                                      CH3_TDATA_WIDTH_TYPE == "64b67b_16bit"? "X16" :
                                      CH3_TDATA_WIDTH_TYPE == "64b67b_32bit"? "X16" : "X20";
                                         
localparam PCS_CH0_ENC_DUAL = CH0_TDATA_WIDTH_TYPE == "8b10b_8bit" ? "FALSE" : "TRUE";
localparam PCS_CH1_ENC_DUAL = CH1_TDATA_WIDTH_TYPE == "8b10b_8bit" ? "FALSE" : "TRUE";
localparam PCS_CH2_ENC_DUAL = CH2_TDATA_WIDTH_TYPE == "8b10b_8bit" ? "FALSE" : "TRUE";
localparam PCS_CH3_ENC_DUAL = CH3_TDATA_WIDTH_TYPE == "8b10b_8bit" ? "FALSE" : "TRUE";

localparam PCS_CH0_TX_GEAR_SPLIT =CH0_TDATA_WIDTH_TYPE == "32bit_only"  ? "TRUE" :
                                  CH0_TDATA_WIDTH_TYPE == "40bit_only"  ? "TRUE" :
                                  CH0_TDATA_WIDTH_TYPE == "8b10b_32bit" ? "TRUE" :
                                  CH0_TDATA_WIDTH_TYPE == "64b66b_32bit"? "TRUE" :
                                  CH0_TDATA_WIDTH_TYPE == "64b67b_32bit"? "TRUE" : "FALSE";
localparam PCS_CH1_TX_GEAR_SPLIT =CH1_TDATA_WIDTH_TYPE == "32bit_only"  ? "TRUE" :
                                  CH1_TDATA_WIDTH_TYPE == "40bit_only"  ? "TRUE" :
                                  CH1_TDATA_WIDTH_TYPE == "8b10b_32bit" ? "TRUE" : 
                                  CH1_TDATA_WIDTH_TYPE == "64b66b_32bit"? "TRUE" :
                                  CH1_TDATA_WIDTH_TYPE == "64b67b_32bit"? "TRUE" : "FALSE";
localparam PCS_CH2_TX_GEAR_SPLIT =CH2_TDATA_WIDTH_TYPE == "32bit_only"  ? "TRUE" :
                                  CH2_TDATA_WIDTH_TYPE == "40bit_only"  ? "TRUE" :
                                  CH2_TDATA_WIDTH_TYPE == "8b10b_32bit" ? "TRUE" : 
                                  CH2_TDATA_WIDTH_TYPE == "64b66b_32bit"? "TRUE" :
                                  CH2_TDATA_WIDTH_TYPE == "64b67b_32bit"? "TRUE" : "FALSE";
localparam PCS_CH3_TX_GEAR_SPLIT =CH3_TDATA_WIDTH_TYPE == "32bit_only"  ? "TRUE" :
                                  CH3_TDATA_WIDTH_TYPE == "40bit_only"  ? "TRUE" :
                                  CH3_TDATA_WIDTH_TYPE == "8b10b_32bit" ? "TRUE" : 
                                  CH3_TDATA_WIDTH_TYPE == "64b66b_32bit"? "TRUE" :
                                  CH3_TDATA_WIDTH_TYPE == "64b67b_32bit"? "TRUE" : "FALSE";
localparam PMA_CH0_TXDATA_WIDTH  = CH0_TDATA_WIDTH_TYPE == "8bit_only"   ? "8BIT"  :
                                  CH0_TDATA_WIDTH_TYPE == "10bit_only"  ? "10BIT" :
                                  CH0_TDATA_WIDTH_TYPE == "8b10b_8bit"  ? "10BIT" :
                                  CH0_TDATA_WIDTH_TYPE == "16bit_only"  ? "16BIT" :
                                  CH0_TDATA_WIDTH_TYPE == "20bit_only"  ? "20BIT" :
                                  CH0_TDATA_WIDTH_TYPE == "8b10b_16bit" ? "20BIT" :
                                  CH0_TDATA_WIDTH_TYPE == "32bit_only"  ? "16BIT" :
                                  CH0_TDATA_WIDTH_TYPE == "64b66b_16bit"? "16BIT" : 
                                  CH0_TDATA_WIDTH_TYPE == "64b66b_32bit"? "16BIT" : 
                                  CH0_TDATA_WIDTH_TYPE == "64b67b_16bit"? "16BIT" : 
                                  CH0_TDATA_WIDTH_TYPE == "64b67b_32bit"? "16BIT" : "20BIT";
localparam PMA_CH1_TXDATA_WIDTH  =CH1_TDATA_WIDTH_TYPE == "8bit_only"   ? "8BIT"  :
                                  CH1_TDATA_WIDTH_TYPE == "10bit_only"  ? "10BIT" :
                                  CH1_TDATA_WIDTH_TYPE == "8b10b_8bit"  ? "10BIT" :
                                  CH1_TDATA_WIDTH_TYPE == "16bit_only"  ? "16BIT" :
                                  CH1_TDATA_WIDTH_TYPE == "20bit_only"  ? "20BIT" :
                                  CH1_TDATA_WIDTH_TYPE == "8b10b_16bit" ? "20BIT" :
                                  CH1_TDATA_WIDTH_TYPE == "32bit_only"  ? "16BIT" : 
                                  CH1_TDATA_WIDTH_TYPE == "64b66b_16bit"? "16BIT" : 
                                  CH1_TDATA_WIDTH_TYPE == "64b66b_32bit"? "16BIT" : 
                                  CH1_TDATA_WIDTH_TYPE == "64b67b_16bit"? "16BIT" : 
                                  CH1_TDATA_WIDTH_TYPE == "64b67b_32bit"? "16BIT" : "20BIT";
localparam PMA_CH2_TXDATA_WIDTH  =CH2_TDATA_WIDTH_TYPE == "8bit_only"   ? "8BIT"  :
                                  CH2_TDATA_WIDTH_TYPE == "10bit_only"  ? "10BIT" :
                                  CH2_TDATA_WIDTH_TYPE == "8b10b_8bit"  ? "10BIT" :
                                  CH2_TDATA_WIDTH_TYPE == "16bit_only"  ? "16BIT" :
                                  CH2_TDATA_WIDTH_TYPE == "20bit_only"  ? "20BIT" :
                                  CH2_TDATA_WIDTH_TYPE == "8b10b_16bit" ? "20BIT" :
                                  CH2_TDATA_WIDTH_TYPE == "32bit_only"  ? "16BIT" :
                                  CH2_TDATA_WIDTH_TYPE == "64b66b_16bit"? "16BIT" : 
                                  CH2_TDATA_WIDTH_TYPE == "64b66b_32bit"? "16BIT" : 
                                  CH2_TDATA_WIDTH_TYPE == "64b67b_16bit"? "16BIT" : 
                                  CH2_TDATA_WIDTH_TYPE == "64b67b_32bit"? "16BIT" : "20BIT";
localparam PMA_CH3_TXDATA_WIDTH  =CH3_TDATA_WIDTH_TYPE == "8bit_only"   ? "8BIT"  :
                                  CH3_TDATA_WIDTH_TYPE == "10bit_only"  ? "10BIT" :
                                  CH3_TDATA_WIDTH_TYPE == "8b10b_8bit"  ? "10BIT" :
                                  CH3_TDATA_WIDTH_TYPE == "16bit_only"  ? "16BIT" :
                                  CH3_TDATA_WIDTH_TYPE == "20bit_only"  ? "20BIT" :
                                  CH3_TDATA_WIDTH_TYPE == "8b10b_16bit" ? "20BIT" :
                                  CH3_TDATA_WIDTH_TYPE == "32bit_only"  ? "16BIT" : 
                                  CH3_TDATA_WIDTH_TYPE == "64b66b_16bit"? "16BIT" : 
                                  CH3_TDATA_WIDTH_TYPE == "64b66b_32bit"? "16BIT" : 
                                  CH3_TDATA_WIDTH_TYPE == "64b67b_16bit"? "16BIT" : 
                                  CH3_TDATA_WIDTH_TYPE == "64b67b_32bit"? "16BIT" : "20BIT";

localparam PMA_CH0_REG_TX_PRBS_GEN_WIDTH_SEL = PMA_CH0_TXDATA_WIDTH;
localparam PMA_CH1_REG_TX_PRBS_GEN_WIDTH_SEL = PMA_CH1_TXDATA_WIDTH;
localparam PMA_CH2_REG_TX_PRBS_GEN_WIDTH_SEL = PMA_CH2_TXDATA_WIDTH;
localparam PMA_CH3_REG_TX_PRBS_GEN_WIDTH_SEL = PMA_CH3_TXDATA_WIDTH;
//
localparam PCS_CH0_TX_64B66B_67B = CH0_TX_ENCODER == "64B66B_transparent" ? "64B_66B"  :
                                   CH0_TX_ENCODER == "64B67B_transparent" ? "64B_67B"  : "NORMAL";
localparam PCS_CH1_TX_64B66B_67B = CH1_TX_ENCODER == "64B66B_transparent" ? "64B_66B"  :
                                   CH1_TX_ENCODER == "64B67B_transparent" ? "64B_67B"  : "NORMAL";
localparam PCS_CH2_TX_64B66B_67B = CH2_TX_ENCODER == "64B66B_transparent" ? "64B_66B"  :
                                   CH2_TX_ENCODER == "64B67B_transparent" ? "64B_67B"  : "NORMAL";
localparam PCS_CH3_TX_64B66B_67B = CH3_TX_ENCODER == "64B66B_transparent" ? "64B_66B"  :
                                   CH3_TX_ENCODER == "64B67B_transparent" ? "64B_67B"  : "NORMAL";
//******************************************************************************************************************
localparam PCS_CH0_BYPASS_DENC  = CH0_RDATA_WIDTH_TYPE == "8b10b_8bit"   ? "FALSE" :
                                 CH0_RDATA_WIDTH_TYPE == "8b10b_16bit"  ? "FALSE" :
                                 CH0_RDATA_WIDTH_TYPE == "8b10b_32bit"  ? "FALSE" : "TRUE";
localparam PCS_CH1_BYPASS_DENC  = CH1_RDATA_WIDTH_TYPE == "8b10b_8bit"   ? "FALSE" :
                                 CH1_RDATA_WIDTH_TYPE == "8b10b_16bit"  ? "FALSE" :
                                 CH1_RDATA_WIDTH_TYPE == "8b10b_32bit"  ? "FALSE" : "TRUE";
localparam PCS_CH2_BYPASS_DENC  = CH2_RDATA_WIDTH_TYPE == "8b10b_8bit"   ? "FALSE" :
                                 CH2_RDATA_WIDTH_TYPE == "8b10b_16bit"  ? "FALSE" :
                                 CH2_RDATA_WIDTH_TYPE == "8b10b_32bit"  ? "FALSE" : "TRUE";
localparam PCS_CH3_BYPASS_DENC  = CH3_RDATA_WIDTH_TYPE == "8b10b_8bit"   ? "FALSE" :
                                 CH3_RDATA_WIDTH_TYPE == "8b10b_16bit"  ? "FALSE" :
                                 CH3_RDATA_WIDTH_TYPE == "8b10b_32bit"  ? "FALSE" : "TRUE";                                                                                                   

localparam PCS_CH0_SAMP_16B     =  CH0_RDATA_WIDTH_TYPE == "8bit_only"   ? "X16" :
                                  CH0_RDATA_WIDTH_TYPE == "16bit_only"  ? "X16" :
                                  CH0_RDATA_WIDTH_TYPE == "32bit_only"  ? "X16" :
                                  CH0_RDATA_WIDTH_TYPE == "64b66b_16bit"? "X16" : 
                                  CH0_RDATA_WIDTH_TYPE == "64b66b_32bit"? "X16" : 
                                  CH0_RDATA_WIDTH_TYPE == "64b67b_16bit"? "X16" : 
                                  CH0_RDATA_WIDTH_TYPE == "64b67b_32bit"? "X16" : "X20";
localparam PCS_CH1_SAMP_16B     =  CH1_RDATA_WIDTH_TYPE == "8bit_only"   ? "X16" :
                                  CH1_RDATA_WIDTH_TYPE == "16bit_only"  ? "X16" :
                                  CH1_RDATA_WIDTH_TYPE == "32bit_only"  ? "X16" : 
                                  CH1_RDATA_WIDTH_TYPE == "64b66b_16bit"? "X16" : 
                                  CH1_RDATA_WIDTH_TYPE == "64b66b_32bit"? "X16" : 
                                  CH1_RDATA_WIDTH_TYPE == "64b67b_16bit"? "X16" : 
                                  CH1_RDATA_WIDTH_TYPE == "64b67b_32bit"? "X16" : "X20";
localparam PCS_CH2_SAMP_16B     =  CH2_RDATA_WIDTH_TYPE == "8bit_only"   ? "X16" :
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
                                  CH3_RDATA_WIDTH_TYPE == "20bit_only"  ? "X20" :
                                  CH3_RDATA_WIDTH_TYPE == "8b10b_16bit" ? "X20" :
                                  CH3_RDATA_WIDTH_TYPE == "32bit_only"  ? "X16" :
                                  CH3_RDATA_WIDTH_TYPE == "64b66b_16bit"? "X16" : 
                                  CH3_RDATA_WIDTH_TYPE == "64b66b_32bit"? "X16" : 
                                  CH3_RDATA_WIDTH_TYPE == "64b67b_16bit"? "X16" : 
                                  CH3_RDATA_WIDTH_TYPE == "64b67b_32bit"? "X16" : "X20";

localparam PCS_CH0_SPLIT        =  CH0_RDATA_WIDTH_TYPE == "8bit_only"   ? "TRUE" :
                                  CH0_RDATA_WIDTH_TYPE == "10bit_only"   ? "TRUE" :
                                  CH0_RDATA_WIDTH_TYPE == "8b10b_8bit"   ? "TRUE" :
                                  CH0_RDATA_WIDTH_TYPE == "64b66b_16bit" ? "TRUE" :
                                  CH0_RDATA_WIDTH_TYPE == "64b67b_16bit" ? "TRUE" : "FALSE";
localparam PCS_CH1_SPLIT        =  CH1_RDATA_WIDTH_TYPE == "8bit_only"   ? "TRUE" :
                                  CH1_RDATA_WIDTH_TYPE == "10bit_only"   ? "TRUE" :
                                  CH1_RDATA_WIDTH_TYPE == "8b10b_8bit"   ? "TRUE" :
                                  CH1_RDATA_WIDTH_TYPE == "64b66b_16bit" ? "TRUE" :
                                  CH1_RDATA_WIDTH_TYPE == "64b67b_16bit" ? "TRUE" : "FALSE";
localparam PCS_CH2_SPLIT        =  CH2_RDATA_WIDTH_TYPE == "8bit_only"   ? "TRUE" :
                                  CH2_RDATA_WIDTH_TYPE == "10bit_only"   ? "TRUE" :
                                  CH2_RDATA_WIDTH_TYPE == "8b10b_8bit"   ? "TRUE" : 
                                  CH2_RDATA_WIDTH_TYPE == "64b66b_16bit" ? "TRUE" :
                                  CH2_RDATA_WIDTH_TYPE == "64b67b_16bit" ? "TRUE" : "FALSE";
localparam PCS_CH3_SPLIT        =  CH3_RDATA_WIDTH_TYPE == "8bit_only"   ? "TRUE" :
                                  CH3_RDATA_WIDTH_TYPE == "10bit_only"   ? "TRUE" :
                                  CH3_RDATA_WIDTH_TYPE == "8b10b_8bit"   ? "TRUE" :                                                                   
                                  CH3_RDATA_WIDTH_TYPE == "64b66b_16bit" ? "TRUE" :
                                  CH3_RDATA_WIDTH_TYPE == "64b67b_16bit" ? "TRUE" : "FALSE";

localparam PCS_CH0_COMMA_DET_MODE = CH0_RX_CLK_SLIP_EN=="TRUE" ? "RX_CLK_SLIP" : "COMMA_PATTERN";
localparam PCS_CH1_COMMA_DET_MODE = CH1_RX_CLK_SLIP_EN=="TRUE" ? "RX_CLK_SLIP" : "COMMA_PATTERN";
localparam PCS_CH2_COMMA_DET_MODE = CH2_RX_CLK_SLIP_EN=="TRUE" ? "RX_CLK_SLIP" : "COMMA_PATTERN";
localparam PCS_CH3_COMMA_DET_MODE = CH3_RX_CLK_SLIP_EN=="TRUE" ? "RX_CLK_SLIP" : "COMMA_PATTERN";

localparam PCS_CH0_DEC_DUAL     =  CH0_RDATA_WIDTH_TYPE == "8b10b_8bit"   ? "TRUE" :
                                  CH0_RDATA_WIDTH_TYPE == "8b10b_16bit"  ? "TRUE" :
                                  CH0_RDATA_WIDTH_TYPE == "8b10b_32bit"  ? "TRUE" : "FALSE";
localparam PCS_CH1_DEC_DUAL     =  CH1_RDATA_WIDTH_TYPE == "8b10b_8bit"   ? "TRUE" :
                                  CH1_RDATA_WIDTH_TYPE == "8b10b_16bit"  ? "TRUE" :
                                  CH1_RDATA_WIDTH_TYPE == "8b10b_32bit"  ? "TRUE" : "FALSE";
localparam PCS_CH2_DEC_DUAL     =  CH2_RDATA_WIDTH_TYPE == "8b10b_8bit"   ? "TRUE" :
                                  CH2_RDATA_WIDTH_TYPE == "8b10b_16bit"  ? "TRUE" :
                                  CH2_RDATA_WIDTH_TYPE == "8b10b_32bit"  ? "TRUE" : "FALSE";
localparam PCS_CH3_DEC_DUAL     =  CH3_RDATA_WIDTH_TYPE == "8b10b_8bit"   ? "TRUE" :
                                  CH3_RDATA_WIDTH_TYPE == "8b10b_16bit"  ? "TRUE" :
                                  CH3_RDATA_WIDTH_TYPE == "8b10b_32bit"  ? "TRUE" : "FALSE";                                  
                                  
localparam PCS_CH0_PCS_RCLK_EN  = CH0_RDATA_WIDTH_TYPE == "8b10b_8bit"  ? "TRUE" : "FALSE";
localparam PCS_CH1_PCS_RCLK_EN  = CH1_RDATA_WIDTH_TYPE == "8b10b_8bit"  ? "TRUE" : "FALSE";
localparam PCS_CH2_PCS_RCLK_EN  = CH2_RDATA_WIDTH_TYPE == "8b10b_8bit"  ? "TRUE" : "FALSE";
localparam PCS_CH3_PCS_RCLK_EN  = CH3_RDATA_WIDTH_TYPE == "8b10b_8bit"  ? "TRUE" : "FALSE";
                                  
localparam PCS_CH0_CB_RCLK_EN  = CH0_RDATA_WIDTH_TYPE == "8b10b_8bit"  ? "TRUE" : "FALSE";
localparam PCS_CH1_CB_RCLK_EN  = CH1_RDATA_WIDTH_TYPE == "8b10b_8bit"  ? "TRUE" : "FALSE";
localparam PCS_CH2_CB_RCLK_EN  = CH2_RDATA_WIDTH_TYPE == "8b10b_8bit"  ? "TRUE" : "FALSE";
localparam PCS_CH3_CB_RCLK_EN  = CH3_RDATA_WIDTH_TYPE == "8b10b_8bit"  ? "TRUE" : "FALSE";
                                  
localparam PCS_CH0_AFTER_CTC_RCLK_EN  = CH0_RDATA_WIDTH_TYPE == "8b10b_8bit"  ? "TRUE" : "FALSE";
localparam PCS_CH1_AFTER_CTC_RCLK_EN  = CH1_RDATA_WIDTH_TYPE == "8b10b_8bit"  ? "TRUE" : "FALSE";
localparam PCS_CH2_AFTER_CTC_RCLK_EN  = CH2_RDATA_WIDTH_TYPE == "8b10b_8bit"  ? "TRUE" : "FALSE";
localparam PCS_CH3_AFTER_CTC_RCLK_EN  = CH3_RDATA_WIDTH_TYPE == "8b10b_8bit"  ? "TRUE" : "FALSE";

localparam PCS_CH0_AFTER_CTC_RCLK_EN_GB   =  CH0_RDATA_WIDTH_TYPE == "32bit_only"  ? "TRUE" :
                                            CH0_RDATA_WIDTH_TYPE == "40bit_only"  ? "TRUE" :
                                            CH0_RDATA_WIDTH_TYPE == "8b10b_32bit" ? "TRUE" :
                                            CH0_RDATA_WIDTH_TYPE == "64b66b_32bit"? "TRUE" : 
                                            CH0_RDATA_WIDTH_TYPE == "64b67b_32bit"? "TRUE" : "FALSE";
localparam PCS_CH1_AFTER_CTC_RCLK_EN_GB   =  CH1_RDATA_WIDTH_TYPE == "32bit_only"  ? "TRUE" :
                                            CH1_RDATA_WIDTH_TYPE == "40bit_only"  ? "TRUE" :
                                            CH1_RDATA_WIDTH_TYPE == "8b10b_32bit" ? "TRUE" :
                                            CH1_RDATA_WIDTH_TYPE == "64b66b_32bit"? "TRUE" : 
                                            CH1_RDATA_WIDTH_TYPE == "64b67b_32bit"? "TRUE" : "FALSE";
localparam PCS_CH2_AFTER_CTC_RCLK_EN_GB   =  CH2_RDATA_WIDTH_TYPE == "32bit_only"  ? "TRUE" :
                                            CH2_RDATA_WIDTH_TYPE == "40bit_only"  ? "TRUE" :
                                            CH2_RDATA_WIDTH_TYPE == "8b10b_32bit" ? "TRUE" : 
                                            CH2_RDATA_WIDTH_TYPE == "64b66b_32bit"? "TRUE" : 
                                            CH2_RDATA_WIDTH_TYPE == "64b67b_32bit"? "TRUE" : "FALSE";
localparam PCS_CH3_AFTER_CTC_RCLK_EN_GB   =  CH3_RDATA_WIDTH_TYPE == "32bit_only"  ? "TRUE" :
                                            CH3_RDATA_WIDTH_TYPE == "40bit_only"  ? "TRUE" :
                                            CH3_RDATA_WIDTH_TYPE == "8b10b_32bit" ? "TRUE" :
                                            CH3_RDATA_WIDTH_TYPE == "64b66b_32bit"? "TRUE" : 
                                            CH3_RDATA_WIDTH_TYPE == "64b67b_32bit"? "TRUE" : "FALSE";

localparam PMA_CH0_SIPO_BIT_SETTING  = CH0_RDATA_WIDTH_TYPE == "8bit_only"   ? "8BIT"  :
                                      CH0_RDATA_WIDTH_TYPE == "10bit_only"  ? "10BIT" :
                                      CH0_RDATA_WIDTH_TYPE == "8b10b_8bit"  ? "10BIT" :
                                      CH0_RDATA_WIDTH_TYPE == "16bit_only"  ? "16BIT" :
                                      CH0_RDATA_WIDTH_TYPE == "20bit_only"  ? "20BIT" :
                                      CH0_RDATA_WIDTH_TYPE == "8b10b_16bit" ? "20BIT" :
                                      CH0_RDATA_WIDTH_TYPE == "32bit_only"  ? "16BIT" : 
                                      CH0_RDATA_WIDTH_TYPE == "64b66b_16bit"? "16BIT" : 
                                      CH0_RDATA_WIDTH_TYPE == "64b66b_32bit"? "16BIT" : 
                                      CH0_RDATA_WIDTH_TYPE == "64b67b_16bit"? "16BIT" : 
                                      CH0_RDATA_WIDTH_TYPE == "64b67b_32bit"? "16BIT" : "20BIT";
localparam PMA_CH1_SIPO_BIT_SETTING  = CH1_RDATA_WIDTH_TYPE == "8bit_only"   ? "8BIT"  :
                                      CH1_RDATA_WIDTH_TYPE == "10bit_only"  ? "10BIT" :
                                      CH1_RDATA_WIDTH_TYPE == "8b10b_8bit"  ? "10BIT" :
                                      CH1_RDATA_WIDTH_TYPE == "16bit_only"  ? "16BIT" :
                                      CH1_RDATA_WIDTH_TYPE == "20bit_only"  ? "20BIT" :
                                      CH1_RDATA_WIDTH_TYPE == "8b10b_16bit" ? "20BIT" :
                                      CH1_RDATA_WIDTH_TYPE == "32bit_only"  ? "16BIT" :
                                      CH1_RDATA_WIDTH_TYPE == "64b66b_16bit"? "16BIT" : 
                                      CH1_RDATA_WIDTH_TYPE == "64b66b_32bit"? "16BIT" : 
                                      CH1_RDATA_WIDTH_TYPE == "64b67b_16bit"? "16BIT" : 
                                      CH1_RDATA_WIDTH_TYPE == "64b67b_32bit"? "16BIT" : "20BIT";
localparam PMA_CH2_SIPO_BIT_SETTING  = CH2_RDATA_WIDTH_TYPE == "8bit_only"   ? "8BIT"  :
                                      CH2_RDATA_WIDTH_TYPE == "10bit_only"  ? "10BIT" :
                                      CH2_RDATA_WIDTH_TYPE == "8b10b_8bit"  ? "10BIT" :
                                      CH2_RDATA_WIDTH_TYPE == "16bit_only"  ? "16BIT" :
                                      CH2_RDATA_WIDTH_TYPE == "20bit_only"  ? "20BIT" :
                                      CH2_RDATA_WIDTH_TYPE == "8b10b_16bit" ? "20BIT" :
                                      CH2_RDATA_WIDTH_TYPE == "32bit_only"  ? "16BIT" :                                                                        
                                      CH2_RDATA_WIDTH_TYPE == "64b66b_16bit"? "16BIT" : 
                                      CH2_RDATA_WIDTH_TYPE == "64b66b_32bit"? "16BIT" : 
                                      CH2_RDATA_WIDTH_TYPE == "64b67b_16bit"? "16BIT" : 
                                      CH2_RDATA_WIDTH_TYPE == "64b67b_32bit"? "16BIT" : "20BIT";
localparam PMA_CH3_SIPO_BIT_SETTING  = CH3_RDATA_WIDTH_TYPE == "8bit_only"   ? "8BIT"  :
                                      CH3_RDATA_WIDTH_TYPE == "10bit_only"  ? "10BIT" :
                                      CH3_RDATA_WIDTH_TYPE == "8b10b_8bit"  ? "10BIT" :
                                      CH3_RDATA_WIDTH_TYPE == "16bit_only"  ? "16BIT" :
                                      CH3_RDATA_WIDTH_TYPE == "20bit_only"  ? "20BIT" :
                                      CH3_RDATA_WIDTH_TYPE == "8b10b_16bit" ? "20BIT" :
                                      CH3_RDATA_WIDTH_TYPE == "32bit_only"  ? "16BIT" : 
                                      CH3_RDATA_WIDTH_TYPE == "64b66b_16bit"? "16BIT" : 
                                      CH3_RDATA_WIDTH_TYPE == "64b66b_32bit"? "16BIT" : 
                                      CH3_RDATA_WIDTH_TYPE == "64b67b_16bit"? "16BIT" : 
                                      CH3_RDATA_WIDTH_TYPE == "64b67b_32bit"? "16BIT" : "20BIT";

localparam PMA_CH0_REG_PRBS_CHK_WIDTH_SEL = PMA_CH0_SIPO_BIT_SETTING;
localparam PMA_CH1_REG_PRBS_CHK_WIDTH_SEL = PMA_CH1_SIPO_BIT_SETTING;
localparam PMA_CH2_REG_PRBS_CHK_WIDTH_SEL = PMA_CH2_SIPO_BIT_SETTING;
localparam PMA_CH3_REG_PRBS_CHK_WIDTH_SEL = PMA_CH3_SIPO_BIT_SETTING;

localparam PMA_CH0_REG_RX_DATAPATH_PD_EN = "TRUE";
localparam PMA_CH1_REG_RX_DATAPATH_PD_EN = "TRUE";
localparam PMA_CH2_REG_RX_DATAPATH_PD_EN = "TRUE";
localparam PMA_CH3_REG_RX_DATAPATH_PD_EN = "TRUE";
localparam PMA_CH0_REG_RX_SIGDET_VTH = "72MV";
localparam PMA_CH1_REG_RX_SIGDET_VTH = "72MV";
localparam PMA_CH2_REG_RX_SIGDET_VTH = "72MV";
localparam PMA_CH3_REG_RX_SIGDET_VTH = "72MV";

localparam PMA_CH0_REG_TX_SATA_EN   =  "FALSE" ;
localparam PMA_CH1_REG_TX_SATA_EN   =  "FALSE" ;
localparam PMA_CH2_REG_TX_SATA_EN   =  "FALSE" ;
localparam PMA_CH3_REG_TX_SATA_EN   =  "FALSE" ;
//SATA OOB CONFIGURATION
localparam   integer PMA_CH0_REG_OOB_COMWAKE_GAP_MIN = (((CH0_RX_RATE == 6.0) && (PMA_CH0_SIPO_BIT_SETTING == "20BIT")) || ((CH0_RX_RATE == 3.0) && (PMA_CH0_SIPO_BIT_SETTING == "10BIT" ))) ? 29 :
                                                       (((CH0_RX_RATE == 3.0) && (PMA_CH0_SIPO_BIT_SETTING == "20BIT")) || ((CH0_RX_RATE == 1.5) && (PMA_CH0_SIPO_BIT_SETTING == "10BIT" ))) ? 12 : 
                                                        ((CH0_RX_RATE == 1.5) && (PMA_CH0_SIPO_BIT_SETTING == "20BIT")) ? 6 : 3;
localparam   integer PMA_CH1_REG_OOB_COMWAKE_GAP_MIN = (((CH1_RX_RATE == 6.0) && (PMA_CH1_SIPO_BIT_SETTING == "20BIT")) || ((CH1_RX_RATE == 3.0) && (PMA_CH1_SIPO_BIT_SETTING == "10BIT" ))) ? 29 :
                                                       (((CH1_RX_RATE == 3.0) && (PMA_CH1_SIPO_BIT_SETTING == "20BIT")) || ((CH1_RX_RATE == 1.5) && (PMA_CH1_SIPO_BIT_SETTING == "10BIT" ))) ? 12 : 
                                                        ((CH1_RX_RATE == 1.5) && (PMA_CH1_SIPO_BIT_SETTING == "20BIT")) ? 6 : 3;
localparam   integer PMA_CH2_REG_OOB_COMWAKE_GAP_MIN = (((CH2_RX_RATE == 6.0) && (PMA_CH2_SIPO_BIT_SETTING == "20BIT")) || ((CH2_RX_RATE == 3.0) && (PMA_CH2_SIPO_BIT_SETTING == "10BIT" ))) ? 29 :
                                                       (((CH2_RX_RATE == 3.0) && (PMA_CH2_SIPO_BIT_SETTING == "20BIT")) || ((CH2_RX_RATE == 1.5) && (PMA_CH2_SIPO_BIT_SETTING == "10BIT" ))) ? 12 : 
                                                        ((CH2_RX_RATE == 1.5) && (PMA_CH2_SIPO_BIT_SETTING == "20BIT")) ? 6 : 3;
localparam   integer PMA_CH3_REG_OOB_COMWAKE_GAP_MIN = (((CH3_RX_RATE == 6.0) && (PMA_CH3_SIPO_BIT_SETTING == "20BIT")) || ((CH3_RX_RATE == 3.0) && (PMA_CH3_SIPO_BIT_SETTING == "10BIT" ))) ? 29 :
                                                       (((CH3_RX_RATE == 3.0) && (PMA_CH3_SIPO_BIT_SETTING == "20BIT")) || ((CH3_RX_RATE == 1.5) && (PMA_CH3_SIPO_BIT_SETTING == "10BIT" ))) ? 12 : 
                                                        ((CH3_RX_RATE == 1.5) && (PMA_CH3_SIPO_BIT_SETTING == "20BIT")) ? 6 : 3;

localparam   integer PMA_CH0_REG_OOB_COMWAKE_GAP_MAX = (((CH0_RX_RATE == 6.0) && (PMA_CH0_SIPO_BIT_SETTING == "20BIT")) || ((CH0_RX_RATE == 3.0) && (PMA_CH0_SIPO_BIT_SETTING == "10BIT" ))) ? 35 :
                                                       (((CH0_RX_RATE == 3.0) && (PMA_CH0_SIPO_BIT_SETTING == "20BIT")) || ((CH0_RX_RATE == 1.5) && (PMA_CH0_SIPO_BIT_SETTING == "10BIT" ))) ? 19 : 
                                                        ((CH0_RX_RATE == 1.5) && (PMA_CH0_SIPO_BIT_SETTING == "20BIT")) ? 9 : 11;
localparam   integer PMA_CH1_REG_OOB_COMWAKE_GAP_MAX = (((CH1_RX_RATE == 6.0) && (PMA_CH1_SIPO_BIT_SETTING == "20BIT")) || ((CH1_RX_RATE == 3.0) && (PMA_CH1_SIPO_BIT_SETTING == "10BIT" ))) ? 35 :
                                                       (((CH1_RX_RATE == 3.0) && (PMA_CH1_SIPO_BIT_SETTING == "20BIT")) || ((CH1_RX_RATE == 1.5) && (PMA_CH1_SIPO_BIT_SETTING == "10BIT" ))) ? 19 : 
                                                        ((CH1_RX_RATE == 1.5) && (PMA_CH1_SIPO_BIT_SETTING == "20BIT")) ? 9 : 11;
localparam   integer PMA_CH2_REG_OOB_COMWAKE_GAP_MAX = (((CH2_RX_RATE == 6.0) && (PMA_CH2_SIPO_BIT_SETTING == "20BIT")) || ((CH2_RX_RATE == 3.0) && (PMA_CH2_SIPO_BIT_SETTING == "10BIT" ))) ? 35 :
                                                       (((CH2_RX_RATE == 3.0) && (PMA_CH2_SIPO_BIT_SETTING == "20BIT")) || ((CH2_RX_RATE == 1.5) && (PMA_CH2_SIPO_BIT_SETTING == "10BIT" ))) ? 19 : 
                                                        ((CH2_RX_RATE == 1.5) && (PMA_CH2_SIPO_BIT_SETTING == "20BIT")) ? 9 : 11;
localparam   integer PMA_CH3_REG_OOB_COMWAKE_GAP_MAX = (((CH3_RX_RATE == 6.0) && (PMA_CH3_SIPO_BIT_SETTING == "20BIT")) || ((CH3_RX_RATE == 3.0) && (PMA_CH3_SIPO_BIT_SETTING == "10BIT" ))) ? 35 :
                                                       (((CH3_RX_RATE == 3.0) && (PMA_CH3_SIPO_BIT_SETTING == "20BIT")) || ((CH3_RX_RATE == 1.5) && (PMA_CH3_SIPO_BIT_SETTING == "10BIT" ))) ? 19 : 
                                                        ((CH3_RX_RATE == 1.5) && (PMA_CH3_SIPO_BIT_SETTING == "20BIT")) ? 9 : 11;

localparam   integer PMA_CH0_REG_OOB_COMINIT_GAP_MIN = (((CH0_RX_RATE == 6.0) && (PMA_CH0_SIPO_BIT_SETTING == "20BIT")) || ((CH0_RX_RATE == 3.0) && (PMA_CH0_SIPO_BIT_SETTING == "10BIT" ))) ? 90 :
                                                       (((CH0_RX_RATE == 3.0) && (PMA_CH0_SIPO_BIT_SETTING == "20BIT")) || ((CH0_RX_RATE == 1.5) && (PMA_CH0_SIPO_BIT_SETTING == "10BIT" ))) ? 44 : 
                                                        ((CH0_RX_RATE == 1.5) && (PMA_CH0_SIPO_BIT_SETTING == "20BIT")) ? 22 : 15;
localparam   integer PMA_CH1_REG_OOB_COMINIT_GAP_MIN = (((CH1_RX_RATE == 6.0) && (PMA_CH1_SIPO_BIT_SETTING == "20BIT")) || ((CH1_RX_RATE == 3.0) && (PMA_CH1_SIPO_BIT_SETTING == "10BIT" ))) ? 90 :
                                                       (((CH1_RX_RATE == 3.0) && (PMA_CH1_SIPO_BIT_SETTING == "20BIT")) || ((CH1_RX_RATE == 1.5) && (PMA_CH1_SIPO_BIT_SETTING == "10BIT" ))) ? 44 : 
                                                        ((CH1_RX_RATE == 1.5) && (PMA_CH1_SIPO_BIT_SETTING == "20BIT")) ? 22 : 15;
localparam   integer PMA_CH2_REG_OOB_COMINIT_GAP_MIN = (((CH2_RX_RATE == 6.0) && (PMA_CH2_SIPO_BIT_SETTING == "20BIT")) || ((CH2_RX_RATE == 3.0) && (PMA_CH2_SIPO_BIT_SETTING == "10BIT" ))) ? 90 :
                                                       (((CH2_RX_RATE == 3.0) && (PMA_CH2_SIPO_BIT_SETTING == "20BIT")) || ((CH2_RX_RATE == 1.5) && (PMA_CH2_SIPO_BIT_SETTING == "10BIT" ))) ? 44 : 
                                                        ((CH2_RX_RATE == 1.5) && (PMA_CH2_SIPO_BIT_SETTING == "20BIT")) ? 22 : 15;
localparam   integer PMA_CH3_REG_OOB_COMINIT_GAP_MIN = (((CH3_RX_RATE == 6.0) && (PMA_CH3_SIPO_BIT_SETTING == "20BIT")) || ((CH3_RX_RATE == 3.0) && (PMA_CH3_SIPO_BIT_SETTING == "10BIT" ))) ? 90 :
                                                       (((CH3_RX_RATE == 3.0) && (PMA_CH3_SIPO_BIT_SETTING == "20BIT")) || ((CH3_RX_RATE == 1.5) && (PMA_CH3_SIPO_BIT_SETTING == "10BIT" ))) ? 44 : 
                                                        ((CH3_RX_RATE == 1.5) && (PMA_CH3_SIPO_BIT_SETTING == "20BIT")) ? 22 : 15;

localparam   integer PMA_CH0_REG_OOB_COMINIT_GAP_MAX = (((CH0_RX_RATE == 6.0) && (PMA_CH0_SIPO_BIT_SETTING == "20BIT")) || ((CH0_RX_RATE == 3.0) && (PMA_CH0_SIPO_BIT_SETTING == "10BIT" ))) ? 102:
                                                       (((CH0_RX_RATE == 3.0) && (PMA_CH0_SIPO_BIT_SETTING == "20BIT")) || ((CH0_RX_RATE == 1.5) && (PMA_CH0_SIPO_BIT_SETTING == "10BIT" ))) ? 52 : 
                                                        ((CH0_RX_RATE == 1.5) && (PMA_CH0_SIPO_BIT_SETTING == "20BIT")) ? 26 : 35;
localparam   integer PMA_CH1_REG_OOB_COMINIT_GAP_MAX = (((CH1_RX_RATE == 6.0) && (PMA_CH1_SIPO_BIT_SETTING == "20BIT")) || ((CH1_RX_RATE == 3.0) && (PMA_CH1_SIPO_BIT_SETTING == "10BIT" ))) ? 102:
                                                       (((CH1_RX_RATE == 3.0) && (PMA_CH1_SIPO_BIT_SETTING == "20BIT")) || ((CH1_RX_RATE == 1.5) && (PMA_CH1_SIPO_BIT_SETTING == "10BIT" ))) ? 52 : 
                                                        ((CH1_RX_RATE == 1.5) && (PMA_CH1_SIPO_BIT_SETTING == "20BIT")) ? 26 : 35;
localparam   integer PMA_CH2_REG_OOB_COMINIT_GAP_MAX = (((CH2_RX_RATE == 6.0) && (PMA_CH2_SIPO_BIT_SETTING == "20BIT")) || ((CH2_RX_RATE == 3.0) && (PMA_CH2_SIPO_BIT_SETTING == "10BIT" ))) ? 102:
                                                       (((CH2_RX_RATE == 3.0) && (PMA_CH2_SIPO_BIT_SETTING == "20BIT")) || ((CH2_RX_RATE == 1.5) && (PMA_CH2_SIPO_BIT_SETTING == "10BIT" ))) ? 52 : 
                                                        ((CH2_RX_RATE == 1.5) && (PMA_CH2_SIPO_BIT_SETTING == "20BIT")) ? 26 : 35;
localparam   integer PMA_CH3_REG_OOB_COMINIT_GAP_MAX = (((CH3_RX_RATE == 6.0) && (PMA_CH3_SIPO_BIT_SETTING == "20BIT")) || ((CH3_RX_RATE == 3.0) && (PMA_CH3_SIPO_BIT_SETTING == "10BIT" ))) ? 102:
                                                       (((CH3_RX_RATE == 3.0) && (PMA_CH3_SIPO_BIT_SETTING == "20BIT")) || ((CH3_RX_RATE == 1.5) && (PMA_CH3_SIPO_BIT_SETTING == "10BIT" ))) ? 52 : 
                                                        ((CH3_RX_RATE == 1.5) && (PMA_CH3_SIPO_BIT_SETTING == "20BIT")) ? 26 : 35;

localparam PCS_CH0_BYPASS_GEAR   =  CH0_RDATA_WIDTH_TYPE == "16bit_only"  ? "TRUE" :
                                   CH0_RDATA_WIDTH_TYPE == "20bit_only"  ? "TRUE" :
                                   CH0_RDATA_WIDTH_TYPE == "8b10b_16bit" ? "TRUE" : "FALSE";
localparam PCS_CH1_BYPASS_GEAR   =  CH1_RDATA_WIDTH_TYPE == "16bit_only"  ? "TRUE" :
                                   CH1_RDATA_WIDTH_TYPE == "20bit_only"  ? "TRUE" :
                                   CH1_RDATA_WIDTH_TYPE == "8b10b_16bit" ? "TRUE" : "FALSE";
localparam PCS_CH2_BYPASS_GEAR   =  CH2_RDATA_WIDTH_TYPE == "16bit_only"  ? "TRUE" :
                                   CH2_RDATA_WIDTH_TYPE == "20bit_only"  ? "TRUE" :
                                   CH2_RDATA_WIDTH_TYPE == "8b10b_16bit" ? "TRUE" : "FALSE";
localparam PCS_CH3_BYPASS_GEAR   =  CH3_RDATA_WIDTH_TYPE == "16bit_only"  ? "TRUE" :
                                   CH3_RDATA_WIDTH_TYPE == "20bit_only"  ? "TRUE" :
                                   CH3_RDATA_WIDTH_TYPE == "8b10b_16bit" ? "TRUE" : "FALSE";  
//
localparam PCS_CH0_BYPASS_BRIDGE = RX0_CLK2_FR_CORE=="TRUE" ? "TRUE" : "FALSE";
localparam PCS_CH1_BYPASS_BRIDGE = RX1_CLK2_FR_CORE=="TRUE" ? "TRUE" : "FALSE";
localparam PCS_CH2_BYPASS_BRIDGE = RX2_CLK2_FR_CORE=="TRUE" ? "TRUE" : "FALSE";
localparam PCS_CH3_BYPASS_BRIDGE = RX3_CLK2_FR_CORE=="TRUE" ? "TRUE" : "FALSE";
//
localparam PCS_CH0_BYPASS_BRIDGE_FIFO = "FALSE";
localparam PCS_CH1_BYPASS_BRIDGE_FIFO = "FALSE";
localparam PCS_CH2_BYPASS_BRIDGE_FIFO = "FALSE";
localparam PCS_CH3_BYPASS_BRIDGE_FIFO = "FALSE";
//
localparam PCS_CH0_PCS_RCLK_SEL = "PMA_RCLK";
localparam PCS_CH1_PCS_RCLK_SEL = "PMA_RCLK";
localparam PCS_CH2_PCS_RCLK_SEL = "PMA_RCLK";
localparam PCS_CH3_PCS_RCLK_SEL = "PMA_RCLK";
//
localparam PCS_CH0_CB_RCLK_SEL = PCS_CH0_BYPASS_BONDING == "FALSE" ? "MCB_RCLK" : "PMA_RCLK";
localparam PCS_CH1_CB_RCLK_SEL = PCS_CH1_BYPASS_BONDING == "FALSE" ? "MCB_RCLK" : "PMA_RCLK";
localparam PCS_CH2_CB_RCLK_SEL = PCS_CH2_BYPASS_BONDING == "FALSE" ? "MCB_RCLK" : "PMA_RCLK";
localparam PCS_CH3_CB_RCLK_SEL = PCS_CH3_BYPASS_BONDING == "FALSE" ? "MCB_RCLK" : "PMA_RCLK";
//
localparam PCS_CH0_AFTER_CTC_RCLK_SEL = RX0_CLK2_FR_CORE   == "TRUE"      ? "RCLK2"    :
                                        PCS_CH0_BYPASS_CTC == "FALSE"     ? "PMA_TCLK" :
                                        PCS_CH0_BYPASS_BONDING == "FALSE" ? "MCB_RCLK" : "PMA_RCLK";
localparam PCS_CH1_AFTER_CTC_RCLK_SEL = RX1_CLK2_FR_CORE   == "TRUE"      ? "RCLK2"    :
                                        PCS_CH1_BYPASS_CTC == "FALSE"     ? "PMA_TCLK" :
                                        PCS_CH1_BYPASS_BONDING == "FALSE" ? "MCB_RCLK" : "PMA_RCLK";
localparam PCS_CH2_AFTER_CTC_RCLK_SEL = RX2_CLK2_FR_CORE   == "TRUE"      ? "RCLK2"    :
                                        PCS_CH2_BYPASS_CTC == "FALSE"     ? "PMA_TCLK" :
                                        PCS_CH2_BYPASS_BONDING == "FALSE" ? "MCB_RCLK" : "PMA_RCLK";                                       
localparam PCS_CH3_AFTER_CTC_RCLK_SEL = RX1_CLK2_FR_CORE   == "TRUE"      ? "RCLK2"    :
                                        PCS_CH3_BYPASS_CTC == "FALSE"     ? "PMA_TCLK" :
                                        PCS_CH3_BYPASS_BONDING == "FALSE" ? "MCB_RCLK" : "PMA_RCLK";   
// 
localparam PCS_CH0_RX_64B66B_67B = CH0_RX_DECODER == "64B66B_transparent" ? "64B_66B"  :
                                   CH0_RX_DECODER == "64B67B_transparent" ? "64B_67B"  : "NORMAL";
localparam PCS_CH1_RX_64B66B_67B = CH1_RX_DECODER == "64B66B_transparent" ? "64B_66B"  :
                                   CH1_RX_DECODER == "64B67B_transparent" ? "64B_67B"  : "NORMAL";
localparam PCS_CH2_RX_64B66B_67B = CH2_RX_DECODER == "64B66B_transparent" ? "64B_66B"  :
                                   CH2_RX_DECODER == "64B67B_transparent" ? "64B_67B"  : "NORMAL";
localparam PCS_CH3_RX_64B66B_67B = CH3_RX_DECODER == "64B66B_transparent" ? "64B_66B"  :
                                   CH3_RX_DECODER == "64B67B_transparent" ? "64B_67B"  : "NORMAL";
//
//*******************************************************************************************************************

//-- INNER RESET PARAMETER ---//
localparam FREE_CLOCK_FREQ         = (FREE_FRQ==0) ? 100.0 : FREE_FRQ;
localparam CH0_TX_ENABLE           = ((CH0_EN=="Fullduplex")||(CH0_EN=="TX_only")) ? "TRUE" : "FALSE";
localparam CH1_TX_ENABLE           = ((CH1_EN=="Fullduplex")||(CH1_EN=="TX_only")) ? "TRUE" : "FALSE";
localparam CH2_TX_ENABLE           = ((CH2_EN=="Fullduplex")||(CH2_EN=="TX_only")) ? "TRUE" : "FALSE";
localparam CH3_TX_ENABLE           = ((CH3_EN=="Fullduplex")||(CH3_EN=="TX_only")) ? "TRUE" : "FALSE";
localparam CH0_RX_ENABLE           = ((CH0_EN=="Fullduplex")||(CH0_EN=="RX_only")) ? "TRUE" : "FALSE";
localparam CH1_RX_ENABLE           = ((CH1_EN=="Fullduplex")||(CH1_EN=="RX_only")) ? "TRUE" : "FALSE";
localparam CH2_RX_ENABLE           = ((CH2_EN=="Fullduplex")||(CH2_EN=="RX_only")) ? "TRUE" : "FALSE";
localparam CH3_RX_ENABLE           = ((CH3_EN=="Fullduplex")||(CH3_EN=="RX_only")) ? "TRUE" : "FALSE";
localparam CH0_MULT_LANE_MODE      = ((CH0_PROTOCOL=="CUSTOMERIZEDx4")||(CH0_PROTOCOL=="PCIEx4")||(CH0_PROTOCOL=="XAUI")) ? 4 : 
                                      ((CH0_PROTOCOL=="CUSTOMERIZEDx2")||(CH0_PROTOCOL=="PCIEx2")) ? 2 : 1;
localparam CH1_MULT_LANE_MODE      = ((CH0_PROTOCOL=="CUSTOMERIZEDx4")||(CH0_PROTOCOL=="PCIEx4")||(CH0_PROTOCOL=="XAUI")) ? 4 : 
                                      ((CH0_PROTOCOL=="CUSTOMERIZEDx2")||(CH0_PROTOCOL=="PCIEx2")) ? 2 : 1;
localparam CH2_MULT_LANE_MODE      = ((CH0_PROTOCOL=="CUSTOMERIZEDx4")||(CH0_PROTOCOL=="PCIEx4")||(CH0_PROTOCOL=="XAUI")) ? 4 : 
                                      ((CH2_PROTOCOL=="CUSTOMERIZEDx2")||(CH2_PROTOCOL=="PCIEx2")) ? 2 : 1;
localparam CH3_MULT_LANE_MODE      = ((CH0_PROTOCOL=="CUSTOMERIZEDx4")||(CH0_PROTOCOL=="PCIEx4")||(CH0_PROTOCOL=="XAUI")) ? 4 : 
                                      ((CH2_PROTOCOL=="CUSTOMERIZEDx2")||(CH2_PROTOCOL=="PCIEx2")) ? 2 : 1;
localparam CHANNEL0_EN             =  (CH0_TX_ENABLE == "TRUE" || CH0_RX_ENABLE == "TRUE") ? "TRUE" : "FALSE";
localparam CHANNEL1_EN             =  (CH1_TX_ENABLE == "TRUE" || CH1_RX_ENABLE == "TRUE") ? "TRUE" : "FALSE";
localparam CHANNEL2_EN             =  (CH2_TX_ENABLE == "TRUE" || CH2_RX_ENABLE == "TRUE") ? "TRUE" : "FALSE";
localparam CHANNEL3_EN             =  (CH3_TX_ENABLE == "TRUE" || CH3_RX_ENABLE == "TRUE") ? "TRUE" : "FALSE";
localparam TX_CHANNEL0_PLL         =  CH0_TX_PLL_SEL == "PLL1" ? 1 : 0;
localparam TX_CHANNEL1_PLL         =  CH1_TX_PLL_SEL == "PLL1" ? 1 : 0;
localparam TX_CHANNEL2_PLL         =  CH2_TX_PLL_SEL == "PLL1" ? 1 : 0;
localparam TX_CHANNEL3_PLL         =  CH3_TX_PLL_SEL == "PLL1" ? 1 : 0;
localparam RX_CHANNEL0_PLL         =  CH0_RX_PLL_SEL == "PLL1" ? 1 : 0;
localparam RX_CHANNEL1_PLL         =  CH1_RX_PLL_SEL == "PLL1" ? 1 : 0;
localparam RX_CHANNEL2_PLL         =  CH2_RX_PLL_SEL == "PLL1" ? 1 : 0;
localparam RX_CHANNEL3_PLL         =  CH3_RX_PLL_SEL == "PLL1" ? 1 : 0;
localparam PCS_CH0_BYPASS_ALIGN    = (CH0_RXPCS_ALIGN=="Bypassed" || CH0_RXPCS_ALIGN=="CUSTOMERIZED_MODE" || CH0_RX_CLK_SLIP_EN=="TRUE") ? "TRUE" : "FALSE";         
localparam PCS_CH1_BYPASS_ALIGN    = (CH1_RXPCS_ALIGN=="Bypassed" || CH1_RXPCS_ALIGN=="CUSTOMERIZED_MODE" || CH1_RX_CLK_SLIP_EN=="TRUE") ? "TRUE" : "FALSE";         
localparam PCS_CH2_BYPASS_ALIGN    = (CH2_RXPCS_ALIGN=="Bypassed" || CH2_RXPCS_ALIGN=="CUSTOMERIZED_MODE" || CH2_RX_CLK_SLIP_EN=="TRUE") ? "TRUE" : "FALSE";         
localparam PCS_CH3_BYPASS_ALIGN    = (CH3_RXPCS_ALIGN=="Bypassed" || CH3_RXPCS_ALIGN=="CUSTOMERIZED_MODE" || CH3_RX_CLK_SLIP_EN=="TRUE") ? "TRUE" : "FALSE";         
localparam PCS_CH0_BYPASS_BOND     = (CH0_RXPCS_BONDING=="Bypassed" || CH0_RXPCS_BONDING=="CUSTOMERIZED_MODE") ? "TRUE" : "FALSE";
localparam PCS_CH1_BYPASS_BOND     = (CH1_RXPCS_BONDING=="Bypassed" || CH1_RXPCS_BONDING=="CUSTOMERIZED_MODE") ? "TRUE" : "FALSE";
localparam PCS_CH2_BYPASS_BOND     = (CH2_RXPCS_BONDING=="Bypassed" || CH2_RXPCS_BONDING=="CUSTOMERIZED_MODE") ? "TRUE" : "FALSE";
localparam PCS_CH3_BYPASS_BOND     = (CH3_RXPCS_BONDING=="Bypassed" || CH3_RXPCS_BONDING=="CUSTOMERIZED_MODE") ? "TRUE" : "FALSE";

//-- PLL RATECHANGE CLK SELECTED PARAMETER ---//
localparam PLL0_TXPCLK_PLL_SEL     = (CH0_TX_PLL_SEL=="PLL0" && CH0_TX_ENABLE=="TRUE") ? 0 :
                                     (CH1_TX_PLL_SEL=="PLL0" && CH1_TX_ENABLE=="TRUE") ? 1 :
                                     (CH2_TX_PLL_SEL=="PLL0" && CH2_TX_ENABLE=="TRUE") ? 2 :
                                     (CH3_TX_PLL_SEL=="PLL0" && CH3_TX_ENABLE=="TRUE") ? 3 :
                                     (CHANNEL0_EN=="TRUE") ? 0 :
                                     (CHANNEL1_EN=="TRUE") ? 1 :
                                     (CHANNEL2_EN=="TRUE") ? 2 : 3;
localparam PLL1_TXPCLK_PLL_SEL     = (CH0_TX_PLL_SEL=="PLL1" && CH0_TX_ENABLE=="TRUE") ? 0 :
                                     (CH1_TX_PLL_SEL=="PLL1" && CH1_TX_ENABLE=="TRUE") ? 1 :
                                     (CH2_TX_PLL_SEL=="PLL1" && CH2_TX_ENABLE=="TRUE") ? 2 :
                                     (CH3_TX_PLL_SEL=="PLL1" && CH3_TX_ENABLE=="TRUE") ? 3 :
                                     (CHANNEL0_EN=="TRUE") ? 0 :
                                     (CHANNEL1_EN=="TRUE") ? 1 :
                                     (CHANNEL2_EN=="TRUE") ? 2 : 3;

//-- wire INNER RESET & HSST  ---//
wire            P_PLL_READY_0           ; // input  wire                    
wire            P_PLL_READY_1           ; // input  wire                    
wire            P_RX_SIGDET_STATUS_0    ; // input  wire                    
wire            P_RX_SIGDET_STATUS_1    ; // input  wire                    
wire            P_RX_SIGDET_STATUS_2    ; // input  wire                    
wire            P_RX_SIGDET_STATUS_3    ; // input  wire                    
wire            P_LX_CDR_ALIGN_0        ; // input  wire                    
wire            P_LX_CDR_ALIGN_1        ; // input  wire                    
wire            P_LX_CDR_ALIGN_2        ; // input  wire                    
wire            P_LX_CDR_ALIGN_3        ; // input  wire                    
wire            P_PCS_LSM_SYNCED_0      ; // input  wire                    
wire            P_PCS_LSM_SYNCED_1      ; // input  wire                    
wire            P_PCS_LSM_SYNCED_2      ; // input  wire                    
wire            P_PCS_LSM_SYNCED_3      ; // input  wire                    
wire            P_PCS_RX_MCB_STATUS_0   ; // input  wire                    
wire            P_PCS_RX_MCB_STATUS_1   ; // input  wire                    
wire            P_PCS_RX_MCB_STATUS_2   ; // input  wire                    
wire            P_PCS_RX_MCB_STATUS_3   ; // input  wire                    
wire            P_PLLPOWERDOWN_0        ; // output wire                    
wire            P_PLLPOWERDOWN_1        ; // output wire                    
wire            P_PLL_RST_0             ; // output wire                    
wire            P_PLL_RST_1             ; // output wire                    
wire            P_LANE_SYNC_0           ; // output wire                    
wire            P_LANE_SYNC_1           ; // output wire                   
wire            P_RATE_CHANGE_TCLK_ON_0 ; // output wire                   
wire            P_RATE_CHANGE_TCLK_ON_1 ; // output wire                   
wire            P_TX_LANE_PD_CLKPATH_0  ; // output wire                   
wire            P_TX_LANE_PD_CLKPATH_1  ; // output wire                   
wire            P_TX_LANE_PD_CLKPATH_2  ; // output wire                   
wire            P_TX_LANE_PD_CLKPATH_3  ; // output wire                   
wire            P_TX_LANE_PD_PISO_0     ; // output wire                   
wire            P_TX_LANE_PD_PISO_1     ; // output wire                   
wire            P_TX_LANE_PD_PISO_2     ; // output wire                   
wire            P_TX_LANE_PD_PISO_3     ; // output wire                   
wire            P_TX_LANE_PD_DRIVER_0   ; // output wire                   
wire            P_TX_LANE_PD_DRIVER_1   ; // output wire                   
wire            P_TX_LANE_PD_DRIVER_2   ; // output wire                   
wire            P_TX_LANE_PD_DRIVER_3   ; // output wire                   
wire    [2 : 0] P_TX_RATE_0             ; // output wire    [2 : 0]         
wire    [2 : 0] P_TX_RATE_1             ; // output wire    [2 : 0]         
wire    [2 : 0] P_TX_RATE_2             ; // output wire    [2 : 0]         
wire    [2 : 0] P_TX_RATE_3             ; // output wire    [2 : 0]         
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
wire            i_force_rxfsm_lsm_0     ; // input  wire                    
wire            i_force_rxfsm_lsm_1     ; // input  wire                    
wire            i_force_rxfsm_lsm_2     ; // input  wire                    
wire            i_force_rxfsm_lsm_3     ; // input  wire
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
