Zdy-1110/FPGA-676/fpga/linux/driver/pango_pci_driver.c

#include "pango_pci_driver.h"
#include "id_config.h"

//#define NDEBUG

#ifndef NDEBUG
#define LOG(msg ...) printk(KERN_ALERT msg)
#else
#define LOG(msg ...)
#endif

#define PCI_DRIVER_DEV_COUNT 1
#define PCI_DRIVER_DEV_NAME "pango_pci_driver"

struct file_operations pango_cdev_fops = {
	.owner   = THIS_MODULE,
	.llseek  = pango_cdev_llseek,
	.read    = pango_cdev_read,
	.write   = pango_cdev_write,
	.open    = pango_cdev_open,
	.unlocked_ioctl = pango_cdev_ioctl,
	.release = pango_cdev_release,
};

struct PciDriverDevInfo pci_dev_info = {
	._dev            = 0,
	._dev_firstminor = 0,
	._dev_count      = PCI_DRIVER_DEV_COUNT,
	._dev_name       = PCI_DRIVER_DEV_NAME,
};

struct pci_device_id pci_pango_device_ids[] = {
	{ PCI_DEVICE(PCI_PANGO_DEFAULT_VENDOR_ID, PCI_PANGO_DEFAULT_DEVICE_ID) },
	{ 0, },
};

struct PciPango pci_info = {
	._pango_pci_driver = {
		._pci_bar     = 1,
		._pci_io_size = 0,
		._pci_io      = NULL,
		._pci_io_buff = NULL,
		._pci_driver  = {
			.name     = PCI_DRIVER_DEV_NAME,
			.id_table = pci_pango_device_ids,
			.probe    = pci_driver_probe,
			.remove   = pci_driver_remove,
		},
	},
	._cdev_class = NULL,
};


struct pci_dev *op_dev;

///////////////////////////////////////////////////////////////////////

loff_t pango_cdev_llseek(struct file *filp, loff_t off, int whence)
{
	struct PciPango *pci_pango = &pci_info;
	loff_t newpos = 0;
	
	//LOG("pango_cdev_llseek.\n");
	
	switch (whence)
	{
		case 0: /* SEEK_SET */
		{
			newpos = off;
		}
			break;
		case 1: /* SEEK_CUR */
		{
			newpos = off;
		}
			break;
		case 2: /* SEEK_END */
		{
			newpos =  off;
		}
			break;
		default: /* can't happen */
		{
			return -EINVAL;
		}	
			break;
	}
	
	if (newpos < 0)
	{
		return -EINVAL;
	}
	//printk("AAAA -- newpos %ld \n",newpos);
	filp->f_pos = newpos;
	
	return newpos;
}

static void ReadConfig(struct pci_dev * pdev)
{
	int i;
	u8 valb;
	u16 valw;
	u32 valdw;
	u8 id;
	u8 next;
	int pos;
	unsigned long reg_base, reg_len;

	/* Read PCI configuration space 读取PCI配置空间*/
	printk(KERN_INFO "PCI Configuration Space:\n");
	for(i=0; i< 1024; i++)
	{
		pci_read_config_dword(pdev, i*4, &valdw);
		command_operation.get_pci_dev_info.data[i] = valdw;
	}

	/* Now read each element - one at a time 现在读取每个元素——一次读取一个*/

	/* Read Vendor ID 读取厂商ID*/
	pci_read_config_word(pdev, PCI_VENDOR_ID, &valw);
	printk("Vendor ID: 0x%x, \n", valw);
	command_operation.get_pci_dev_info.vendor_id = valw;

	/* Read Device ID 读取设备ID*/
	pci_read_config_word(pdev, PCI_DEVICE_ID, &valw);
	printk("Device ID: 0x%x, \n", valw);
	command_operation.get_pci_dev_info.device_id = valw;

	/* Read Command Register 读取命令寄存器*/
	pci_read_config_word(pdev, PCI_COMMAND, &valw);
	printk("Cmd Reg: 0x%x, \n", valw);
	command_operation.get_pci_dev_info.cmd_reg = valw;

	/* Read Status Register 读取状态寄存器*/
	pci_read_config_word(pdev, PCI_STATUS, &valw);
	printk("Stat Reg: 0x%x, \n", valw);
	command_operation.get_pci_dev_info.status_reg = valw;

	/* Read Revision ID 阅读修订ID*/
	pci_read_config_byte(pdev, PCI_REVISION_ID, &valb);
	printk("Revision ID: 0x%x, \n", valb);
	command_operation.get_pci_dev_info.revision_id = valb;

	/* Read Class Code */
	/*
	pci_read_config_dword(pdev, PCI_CLASS_PROG, &valdw);
	printk("Class Code: 0x%lx, ", valdw);
	valdw &= 0x00ffffff;
	printk("Class Code: 0x%lx, ", valdw);
	*/
	/* Read Reg-level Programming Interface 读取reg级编程接口*/
	pci_read_config_byte(pdev, PCI_CLASS_PROG, &valb);
	printk("Class Prog: 0x%x, \n", valb);
	command_operation.get_pci_dev_info.class_prog = valb;

	/* Read Device Class */
	pci_read_config_word(pdev, PCI_CLASS_DEVICE, &valw);
	printk("Device Class: 0x%x, \n", valw);
	command_operation.get_pci_dev_info.class_device = valw;

	  /* Read Cache Line 读缓存线*/
	  pci_read_config_byte(pdev, PCI_CACHE_LINE_SIZE, &valb);
	  printk("Cache Line Size: 0x%x, \n", valb);
	
	  /* Read Latency Timer 读延迟计时器*/
	  pci_read_config_byte(pdev, PCI_LATENCY_TIMER, &valb);
	  printk("Latency Timer: 0x%x, \n", valb);
	
	  /* Read Header Type 读头类型*/
	  pci_read_config_byte(pdev, PCI_HEADER_TYPE, &valb);
	  printk("Header Type: 0x%x, \n", valb);
	
	  /* Read BIST */
	  pci_read_config_byte(pdev, PCI_BIST, &valb);
	  printk("BIST: 0x%x\n", valb);

	/* Read all 6 BAR registers 读取所有6个BAR寄存器*/
	for(i=0; i<=5; i++)
	{
		/* Physical address & length 物理地址和长度*/
		reg_base = pci_resource_start(pdev, i);
		reg_len = pci_resource_len(pdev, i);
		printk("BAR%d: Addr:0x%lx Len:0x%lx,  ", i, reg_base, reg_len);
		command_operation.get_pci_dev_info.bar[i].bar_base = reg_base;
		command_operation.get_pci_dev_info.bar[i].bar_len = reg_len;

		/* Flags */
		if((pci_resource_flags(pdev, i) & IORESOURCE_MEM))
		  printk("Region is for memory\n");
		else if((pci_resource_flags(pdev, i) & IORESOURCE_IO))
		  printk("Region is for I/O\n");
	}
	printk("\n");

	  /* Read CIS Pointer 读CIS指针*/
	  pci_read_config_dword(pdev, PCI_CARDBUS_CIS, &valdw);
	  printk("CardBus CIS Pointer: 0x%x, \n", valdw);
	
	  /* Read Subsystem Vendor ID 读取子系统供应商ID*/
	  pci_read_config_word(pdev, PCI_SUBSYSTEM_VENDOR_ID, &valw);
	  printk("Subsystem Vendor ID: 0x%x, \n", valw);
	
	  /* Read Subsystem Device ID 读取子系统设备ID*/
	  pci_read_config_word(pdev, PCI_SUBSYSTEM_ID, &valw);
	  printk("Subsystem Device ID: 0x%x\n", valw);
	
	  /* Read Expansion ROM Base Address 读取扩展ROM的基地地址*/
	  pci_read_config_dword(pdev, PCI_ROM_ADDRESS, &valdw);
	  printk("Expansion ROM Base Address: 0x%x\n", valdw);
	
	  /* Read IRQ Line 读IRQ线*/
	  pci_read_config_byte(pdev, PCI_INTERRUPT_LINE, &valb);
	  printk("IRQ Line: 0x%x, ", valb);
	
	  /* Read IRQ Pin 读IRQ引脚*/
	  pci_read_config_byte(pdev, PCI_INTERRUPT_PIN, &valb);
	  printk("IRQ Pin: 0x%x, ", valb);

	/* Read Min Gnt */
	pci_read_config_byte(pdev, PCI_MIN_GNT, &valb);
	printk("Min Gnt: 0x%x, ", valb);
	command_operation.get_pci_dev_info.min_gnt = valb;

	/* Read Max Lat */
	pci_read_config_byte(pdev, PCI_MAX_LAT, &valb);
	printk("Max Lat: 0x%x\n", valb);
	command_operation.get_pci_dev_info.max_lat = valb;
	
	if(pci_find_capability(pdev, PCI_CAP_ID_EXP))
	{
		pos = pci_find_capability(pdev, PCI_CAP_ID_EXP);
		pci_read_config_word(pdev, pos + PCI_EXP_LNKSTA, &valw);
		command_operation.get_pci_dev_info.link_speed = (valw & 0x0003);
		command_operation.get_pci_dev_info.link_width = (valw & 0x03f0) >> 4;
		printk("Link Speed: %d\n", command_operation.get_pci_dev_info.link_speed);
		printk("Link Width: x%d\n", command_operation.get_pci_dev_info.link_width);
		
		pci_read_config_word(pdev, pos + PCI_EXP_DEVCTL, &valw);
		command_operation.get_pci_dev_info.mps = 128 << ((valw & PCI_EXP_DEVCTL_PAYLOAD) >> 5);
		command_operation.get_pci_dev_info.mrrs = 128 << ((valw & PCI_EXP_DEVCTL_READRQ) >> 12);
		printk("MPS: %d\n", command_operation.get_pci_dev_info.mps);
		printk("MRRS: %d\n", command_operation.get_pci_dev_info.mrrs);
		
	}
	else
	{
		printk("Cannot find PCI Express Capabilities\n");
		command_operation.get_pci_dev_info.link_speed = 0;
		command_operation.get_pci_dev_info.link_width = 0;
		command_operation.get_pci_dev_info.mps = 0;
		command_operation.get_pci_dev_info.mrrs = 0;
	}

	pci_read_config_word(pdev, PCI_STATUS, &valw);
	command_operation.cap_info.cap_error = 0;
	if (!(valw & PCI_STATUS_CAP_LIST))
	{
		command_operation.cap_info.cap_status = 0;
	}
	else
	{
		command_operation.cap_info.cap_status = 1;
		for(i = 0; i < 256; i++)
		{
			command_operation.cap_info.cap_buf[i].flag = 0;
		}
		pci_read_config_byte(pdev, PCI_CAPABILITY_LIST, &valb);
		valb &= ~3;
		while(valb)
		{

			pci_read_config_byte(pdev, valb + PCI_CAP_LIST_ID, &id);		
			pci_read_config_byte(pdev, valb + PCI_CAP_LIST_NEXT, &next);
			next &= ~3;
			command_operation.cap_info.cap_buf[valb].flag = 1;
			command_operation.cap_info.cap_buf[valb].id = id;
			command_operation.cap_info.cap_buf[valb].addr_offset = valb;
			command_operation.cap_info.cap_buf[valb].next_offset = next;
			printk("cap id = %x; addr_offset = %x; next_offset = %x\n", id, valb, next);
			if(id == 0xff)
			{
				command_operation.cap_info.cap_error = 1;
				break;
			}
			valb = next;
		}
	}

}

ssize_t pango_cdev_read(struct file *filp, char __user *buf, size_t count, loff_t *f_pos)
{
	int i,value =0;
	struct PciPango *pci_pango = &pci_info;
	int read_len ;
	
	//printk("---AAAAA --read - current_len = %ld addr 0x%x \n", count,filp->f_pos);		


	spin_lock(&dma_info.addr_r.lock);
	
	iowrite32(dma_info.addr_r.addr & 0x00000000ffffffff, pci_pango->_pango_pci_driver._pci_io + DMA_READ_ADDR_L);
	iowrite32(dma_info.addr_r.addr >> 32, pci_pango->_pango_pci_driver._pci_io + DMA_READ_ADDR_H);	
	iowrite32(filp->f_pos, pci_pango->_pango_pci_driver._pci_io + READ_RAM_ADDR);
	
	read_len = ( count >> 2 ) -1 ; //转换成DW
	iowrite32(read_len, pci_pango->_pango_pci_driver._pci_io + DMA_READ_LEN);
	iowrite32(dma_info.cmd.data.addr_type, pci_pango->_pango_pci_driver._pci_io + DMA_READ_ADDR_TYPE);
			
	//udelay(10);
	
	for(i = 0 ; i < 1000 ; i++)
	{	
		value = ioread32(pci_pango->_pango_pci_driver._pci_io + DMA_READ_DONE);	
		if(value)
		{	
			udelay(5);
			copy_to_user((char __user *)buf,dma_info.addr_r.data_buf, count);
			break;
		}
		else
			udelay(10);
		
	}
	
	
	spin_unlock(&dma_info.addr_r.lock);
	
	if(value)
		return count;
	else 
		return -1;
}

ssize_t pango_cdev_write(struct file *filp, const char __user *buf, size_t count, loff_t *f_pos)
{
	int i, value =0;
	struct PciPango *pci_pango = &pci_info;
	int write_len ;
	
	//printk("---AAAAA --write - current_len = %ld addr 0x%x \n", count,filp->f_pos);		

	spin_lock(&dma_info.addr_r.lock);
	
	copy_from_user(dma_info.addr_w.data_buf,(char __user *)buf, count);

	//告诉fpga dma数据地址
	iowrite32(dma_info.addr_w.addr & 0x00000000ffffffff, pci_pango->_pango_pci_driver._pci_io + DMA_WRITE_ADDR_L);
	iowrite32(dma_info.addr_w.addr >> 32, pci_pango->_pango_pci_driver._pci_io + DMA_WRITE_ADDR_H);
	
	//写入ram操作地址
	iowrite32(filp->f_pos, pci_pango->_pango_pci_driver._pci_io + WRITE_RAM_ADDR);
	
	write_len = (count >> 2) -1 ; //转换成DW
	iowrite32(write_len, pci_pango->_pango_pci_driver._pci_io + DMA_WRITE_LEN);
	
	iowrite32(dma_info.cmd.data.addr_type, pci_pango->_pango_pci_driver._pci_io + DMA_WRITE_ADDR_TYPE);
	//udelay(10);
	
	for(i = 0 ; i < 1000 ; i++)
	{
		value = ioread32(pci_pango->_pango_pci_driver._pci_io + DMA_WRITE_DONE);	
		if(value ==1)
	 	{
			udelay(5);
			break;
		}
		else 
			udelay(10);
	}	
	
	spin_unlock(&dma_info.addr_r.lock);
	
	
	if(value ==1)
		return count ;
	else
		return -1;
}



/**************************************************************************
** 函数名称:    pango_cdev_ioctl
** 函数功能:    写数据，将应用层传递过来的数据先复制到内核中然后再对数据进行解析
** 输入参数:    *file：文件描述词
**          cmd：操作命令(cmd的最高位表示寄存器读写操作指令，0：读操作；1：写操作)
**          arg：读取数据宽度
** 输出参数:    无
** 返回参数:操作结果
****************************************************************************/
long pango_cdev_ioctl(struct file *file, unsigned int cmd, unsigned long arg)
{
	struct PciPango *pci_pango = &pci_info;
	unsigned int value =0;
	unsigned int current_len =0; 
	
	switch(cmd)
	{
		case PCI_READ_DATA_CMD:	
			copy_from_user(&config_operation,(COMMAND_OPERATION*)arg, sizeof(COMMAND_OPERATION));
			pci_read_config_dword(op_dev, config_operation.addr, &config_operation.data);
			copy_to_user((COMMAND_OPERATION*)arg, &config_operation, sizeof(COMMAND_OPERATION));
		break;
		
		case PCI_WRITE_DATA_CMD:	
			copy_from_user(&config_operation,(COMMAND_OPERATION*)arg, sizeof(COMMAND_OPERATION));
			pci_write_config_dword(op_dev, config_operation.addr, config_operation.data);
		break;
		
		case PCI_MAP_ADDR_CMD:
			spin_lock(&dma_info.addr_r.lock);
			copy_from_user(&dma_operation,(DMA_OPERATION*)arg, sizeof(DMA_OPERATION));
			dma_info.addr_r.data_buf = pci_alloc_consistent(op_dev, dma_operation.current_len, &dma_info.addr_r.addr);
			dma_info.addr_w.data_buf = pci_alloc_consistent(op_dev, dma_operation.current_len, &dma_info.addr_w.addr);
			dma_info.addr_r.addr_size = ((dma_info.addr_r.addr >> 32) > 0) ? 1 : 0;
			dma_info.addr_w.addr_size = ((dma_info.addr_w.addr >> 32) > 0) ? 1 : 0;
			dma_info.cmd.data.length = (dma_operation.current_len >>2 )- 1;
			dma_info.cmd.data.addr_type = dma_info.addr_r.addr_size;

			//printk("addr_size = %d;     current_len = %d \n", (dma_info.addr_r.addr_size) ? 64 : 32, dma_operation.current_len);
			//printk("dma_addr_r  = 0x%llx  dma_addr_w  = 0x%llx \n", dma_info.addr_r.addr, dma_info.addr_w.addr);
			spin_unlock(&dma_info.addr_r.lock);
		break;
		
		case PCI_WRITE_TO_KERNEL_CMD:										
			spin_lock(&dma_info.addr_r.lock);
			copy_from_user(&dma_operation,(DMA_OPERATION*)arg, sizeof(DMA_OPERATION));
			memcpy(dma_info.addr_w.data_buf, dma_operation.data.write_buf, dma_operation.current_len);
			current_len = (dma_operation.current_len >> 2 )- 1;

			iowrite32(dma_info.addr_w.addr & 0x00000000ffffffff, pci_pango->_pango_pci_driver._pci_io + DMA_WRITE_ADDR_L);
			iowrite32(dma_info.addr_w.addr >> 32, pci_pango->_pango_pci_driver._pci_io + DMA_WRITE_ADDR_H);
			iowrite32(dma_operation.offset_addr, pci_pango->_pango_pci_driver._pci_io + WRITE_RAM_ADDR);
			iowrite32(current_len, pci_pango->_pango_pci_driver._pci_io + DMA_WRITE_LEN);
			iowrite32(dma_info.cmd.data.addr_type, pci_pango->_pango_pci_driver._pci_io + DMA_WRITE_ADDR_TYPE);
			
			spin_unlock(&dma_info.addr_r.lock);
		break;
		
		case PCI_DMA_WRITE_CHECK:												/* 查询 CPU写数据是否完成 */
			spin_lock(&dma_info.addr_r.lock);		                       /* DMA写操作，DMA将数据写入到DDR */                                  						
			value = ioread32(pci_pango->_pango_pci_driver._pci_io + DMA_WRITE_DONE);	
			copy_to_user((unsigned int*)arg, &value, sizeof(unsigned int));
			spin_unlock(&dma_info.addr_r.lock);
		break;
		
		case PCI_DMA_READ_CHECK:												/* CPU写数据 */
			spin_lock(&dma_info.addr_r.lock);								/* DMA读操作，DMA将数据读入到FPGA设备 */
			value = ioread32(pci_pango->_pango_pci_driver._pci_io + DMA_READ_DONE);	
			copy_to_user((unsigned int*)arg, &value, sizeof(unsigned int));
			spin_unlock(&dma_info.addr_r.lock);
		break;
			
		case PCI_READ_FROM_KERNEL_CMD:										/* 将数据写入CPU缓存 */
			spin_lock(&dma_info.addr_r.lock);

			memcpy(dma_operation.data.read_buf, dma_info.addr_r.data_buf, dma_operation.current_len);
			copy_to_user((DMA_OPERATION*)arg, &dma_operation, sizeof(DMA_OPERATION));
			spin_unlock(&dma_info.addr_r.lock);
		break;
		
		case PCI_READ_RAM_CMD:
			spin_lock(&dma_info.addr_r.lock);
			copy_from_user(&dma_operation,(DMA_OPERATION*)arg, sizeof(DMA_OPERATION));
			current_len = (dma_operation.current_len>>2) - 1;
			iowrite32(dma_info.addr_r.addr & 0x00000000ffffffff, pci_pango->_pango_pci_driver._pci_io + DMA_READ_ADDR_L);
			iowrite32(dma_info.addr_r.addr >> 32, pci_pango->_pango_pci_driver._pci_io + DMA_READ_ADDR_H);	
			iowrite32(dma_operation.offset_addr, pci_pango->_pango_pci_driver._pci_io + READ_RAM_ADDR);
			iowrite32(current_len, pci_pango->_pango_pci_driver._pci_io + DMA_READ_LEN);
			iowrite32(dma_info.cmd.data.addr_type, pci_pango->_pango_pci_driver._pci_io + DMA_READ_ADDR_TYPE);
			
			spin_unlock(&dma_info.addr_r.lock);
		break;
			
		case PCI_UMAP_ADDR_CMD:
			spin_lock(&dma_info.addr_r.lock);
			pci_free_consistent(op_dev, dma_operation.current_len, dma_info.addr_r.data_buf, dma_info.addr_r.addr);
			pci_free_consistent(op_dev, dma_operation.current_len, dma_info.addr_w.data_buf, dma_info.addr_w.addr);
			dma_info.addr_r.data_buf = NULL;
			dma_info.addr_w.data_buf = NULL;
			spin_unlock(&dma_info.addr_r.lock);
			
		case PCI_MAP_BAR0_CMD:
			copy_to_user((COMMAND_OPERATION*)arg, &command_operation, sizeof(COMMAND_OPERATION));		
			
		break;

	}
	
    return 0;
}


int pango_cdev_open(struct inode *inode, struct file *filp)
{
	
	return 0;
}

int pango_cdev_release(struct inode *inode, struct file *filp)
{
	LOG("pango_cdev_release.\n");
	
	return 0;
}

static int set_dma_mask(struct pci_dev *pdev)
{
    if(!pdev)
    {
        LOG("Invalid pdev\n");
        return -EINVAL;
    }

    LOG("sizeof(dma_addr_t) == %ld\n", sizeof(dma_addr_t));

    /* 64-bit addressing capability for XDMA? */
    if (!pci_set_dma_mask(pdev, DMA_BIT_MASK(64))) {
        /* query for DMA transfer */
        /* @see Documentation/DMA-mapping.txt */
        LOG("pci_set_dma_mask()\n");
        /* use 64-bit DMA */
        LOG("Using a 64-bit DMA mask.\n");
        /* use 32-bit DMA for descriptors */
        pci_set_consistent_dma_mask(pdev, DMA_BIT_MASK(64));
        /* use 64-bit DMA, 32-bit for consistent */
    } else if (!pci_set_dma_mask(pdev, DMA_BIT_MASK(32))) {
        LOG("Could not set 64-bit DMA mask.\n");
        pci_set_consistent_dma_mask(pdev, DMA_BIT_MASK(32));
        /* use 32-bit DMA */
        LOG("Using a 32-bit DMA mask.\n");
    } else {
        LOG("No suitable DMA possible.\n");
        return -EINVAL;
    }

    return 0;
}

static void pci_keep_intx_enabled(struct pci_dev *pdev)
{
    unsigned short pcmd, pcmd_new;

    pci_read_config_word(pdev, PCI_COMMAND, &pcmd);
    pcmd_new = pcmd & ~PCI_COMMAND_INTX_DISABLE;
    if (pcmd_new != pcmd) {
        LOG("%s: clear INTX_DISABLE, 0x%x -> 0x%x.\n",
            dev_name(&pdev->dev), pcmd, pcmd_new);
        pci_write_config_word(pdev, PCI_COMMAND, pcmd_new);
    }

    LOG("pci_keep_intx_enabled.\n");
}

///////////////////////////////////////////////////////////////////////

int pci_driver_probe(struct pci_dev *dev, const struct pci_device_id *device_id)
{
	int result = 0;
	unsigned long bar_address = 0;
	LOG("pci_driver_probe.\n");
	
    LOG("dev vendor : 0x%x, device : 0x%x\n", dev->vendor, dev->device);
	
    result = pci_enable_device(dev);									//PCIE设备使能，初始化memory和IO类型的BAR
    LOG("pci_enable_device result : %d\n", result);
	
	if(result != 0)
	{
		goto fail_enable_device;
	}
	//辅助函数用于检查总线是否可以接收给定大小的总线地址(mask)，如果可以，则通知总线层给定的外围设备将使用该大小的总线地址。
	result = set_dma_mask(dev);
	
	if(result != 0)
	{
		goto fail_set_dma_mask;
	}
	
	ReadConfig(dev);
	op_dev = dev;
	pci_set_master(dev);												//设定设备工作在总线主设备模式
	//通知内核该设备对应的IO端口和内存资源已经使用，其他的PCI设备不要再使用这个区域
	//获得当前pci设备对应的IO端口和IO内存的基址。
    result = pci_request_region(dev, pci_info._pango_pci_driver._pci_bar, NULL);
    LOG("pci_request_region result : %d\n", result);
	
	if(result != 0)
	{
		goto fail_request_region;
	}
	
	pci_info._pango_pci_driver._pci_io_size = pci_resource_len(dev, pci_info._pango_pci_driver._pci_bar);		//获取bar的物理地址范围
	bar_address = pci_resource_start(dev, pci_info._pango_pci_driver._pci_bar);									//获取bar的物理地址
	pci_info._pango_pci_driver._pci_io      = ioremap(bar_address, pci_info._pango_pci_driver._pci_io_size); 	//将bar的物理地址进行虚拟地址映射
	pci_info._pango_pci_driver._pci_io_buff = kmalloc(pci_info._pango_pci_driver._pci_io_size, GFP_KERNEL);
	
    result = pci_info._pango_pci_driver._pci_io != NULL ? 0 : -1;
    LOG("ioremap result : %d\n", result);
    
	pci_keep_intx_enabled(dev);
	
	return result;
	
fail_request_region:
    pci_clear_master(dev);
    LOG("pci_clear_master\n");
	
fail_set_dma_mask:
    pci_disable_device(dev);
    LOG("pci_disable_device\n");

fail_enable_device:
	
	return result;
}

void pci_driver_remove(struct pci_dev *dev)
{
	kfree(pci_info._pango_pci_driver._pci_io_buff);
	
    iounmap(pci_info._pango_pci_driver._pci_io);
    LOG("iounmap\n");
	
    pci_release_region(dev, pci_info._pango_pci_driver._pci_bar);
    LOG("pci_release_region\n");
	
    pci_clear_master(dev);
    LOG("pci_clear_master\n");
	
    pci_disable_device(dev);
    LOG("pci_disable_device\n");
	
	LOG("pci_driver_remove.\n");
}

///////////////////////////////////////////////////////////////////////

int init_pango_cdev(struct cdev *pango_cdev)
{
	int result = 0;
	
	LOG("init_pango_cdev.\n");
	
	result = alloc_chrdev_region(&pci_dev_info._dev, pci_dev_info._dev_firstminor, pci_dev_info._dev_count, pci_dev_info._dev_name);
	
	LOG("*********alloc_chrdev_region, result : %d\n", result);
	
	if(result < 0)
	{
		return result;
	}
	
	cdev_init(pango_cdev, &pango_cdev_fops);
	
	pango_cdev->owner = THIS_MODULE;
	pango_cdev->ops   = &pango_cdev_fops;
	
	result = cdev_add(pango_cdev, pci_dev_info._dev, pci_dev_info._dev_count);							//关联设备号
	
	LOG("init pango_cdev result : %d\n", result);
	
	return result;
}

void exit_pango_cdev(struct cdev *pango_cdev)
{
	cdev_del(pango_cdev);
	
	unregister_chrdev_region(pci_dev_info._dev, pci_dev_info._dev_count);
	
	LOG("exit cdev.\n");
}

int init_pango_pci_driver(struct pci_driver *pango_pci_driver)
{
	int result = 0;
	
	LOG("init_pango_pci_driver.\n");
	
	result = pci_register_driver(pango_pci_driver);						//注册PCI驱动
	
	LOG("*********pci_register_driver, result : %d\n", result);
	
	return result;
}

void exit_pango_pci_driver(struct pci_driver *pango_pci_driver)
{
	pci_unregister_driver(pango_pci_driver);
	
	LOG("exit pci pango driver.\n");
}

// class_create动态创建设备的逻辑类，并完成部分字段的初始化，然后将其添加到内核中。创建的逻辑类位于/sys/class/。
int init_pango_cdev_class(struct class *pango_cdev_class)
{
	int result = -1;
	
	LOG("init_pango_cdev_class.\n");
	
	pango_cdev_class = class_create(THIS_MODULE, pci_dev_info._dev_name);
	
#ifndef NDEBUG
	(!!pango_cdev_class) ? LOG("class create success.\n") : LOG("class create failed.\n");
#endif
	
	if(pango_cdev_class)
	{
		LOG("create device.\n");
		device_create(pango_cdev_class, NULL, pci_dev_info._dev, NULL, "%s", pci_dev_info._dev_name);
		
		result = 0;
	}
	
	return result;
}

void exit_pango_cdev_class(struct class *pango_cdev_class)
{
	LOG("device_destroy\n");
	device_destroy(pango_cdev_class, pci_dev_info._dev);
	
	LOG("class_destroy\n");
	class_destroy(pango_cdev_class);
	
	pango_cdev_class = NULL;
	
	LOG("exit cdev class.\n");
}

///////////////////////////////////////////////////////////////////////

int __init init_pci_pango(void)
{
	int result = 0;
	
	LOG("init_pci_pango.\n");
	
	spin_lock_init(&dma_info.addr_r.lock);
	
	
	result = init_pango_cdev(&pci_info._cdev);						//申请主设备号
	LOG("init cdev result : %d\n", result);
	
	result = init_pango_pci_driver(&pci_info._pango_pci_driver._pci_driver);
	LOG("init pci result : %d\n", result);
	
	sema_init(&pci_info._sem, 1);
	LOG("sema_init.\n");
	
	result = init_pango_cdev_class(pci_info._cdev_class);
	LOG("init cdev class result : %d\n", result);
	
	

	return result;
}

void __exit exit_pci_pango(void)
{
	exit_pango_cdev_class(pci_info._cdev_class);
	
	exit_pango_pci_driver(&pci_info._pango_pci_driver._pci_driver);
	
	exit_pango_cdev(&pci_info._cdev);
	
	LOG("exit_pci_pango.\n");
}

module_init(init_pci_pango);
module_exit(exit_pci_pango);


/* 添加模块描述信息 */
/* 添加模块描述信息 */

MODULE_AUTHOR("Pango, lxg.");                                                          /* 作者信息 */
MODULE_DESCRIPTION("Pango pci driver");                                                /* 模块介绍信息 */
MODULE_LICENSE("GPL v2");                                                              /* 模块许可证 */
MODULE_ALIAS("pango pci driver");                                                      /* 模块的别名信息 */
