Zdy-1110/FPGA-676/fpga/src/pango_pcie_dma_top.v

//////////////////////////////////////////////////////////////////////////////
// 
// Library:
// Filename:pango_pcie_dma_top.v
//////////////////////////////////////////////////////////////////////////////
module pango_pcie_dma_top 
(
    //clk and rst
    input                       ref_clk_n       ,      //100 Mhz
    input                       ref_clk_p       ,      //100 Mhz
    input                       free_clk        ,      // 20261017 log: 27MHz onboard osc (D18)
    input           [4:0]       key             ,      // 20261018 disp: KEY0..KEY4
    input                       perst_n         ,
    // 20261018 ddr: DDR3 interface
    input                       clk_p           ,      // 20261018 ddr:
    input                       clk_n           ,      // 20261018 ddr:
    output  wire                mem_rst_n       ,      // 20261018 ddr:
    output  wire                mem_ck          ,      // 20261018 ddr:
    output  wire                mem_ck_n        ,      // 20261018 ddr:
    output  wire                mem_cke         ,      // 20261018 ddr:
    output  wire                mem_cs_n        ,      // 20261018 ddr:
    output  wire                mem_ras_n       ,      // 20261018 ddr:
    output  wire                mem_cas_n       ,      // 20261018 ddr:
    output  wire                mem_we_n        ,      // 20261018 ddr:
    output  wire                mem_odt         ,      // 20261018 ddr:
    output  wire    [14:0]      mem_a           ,      // 20261018 ddr:
    output  wire    [2:0]       mem_ba          ,      // 20261018 ddr:
    inout           [3:0]       mem_dqs         ,      // 20261018 ddr:
    inout           [3:0]       mem_dqs_n       ,      // 20261018 ddr:
    inout           [31:0]      mem_dq          ,      // 20261018 ddr:
    output  wire    [3:0]       mem_dm          ,      // 20261018 ddr:
    //UART interface
    output  wire                txd             ,
    input                       rxd             ,
    //diff signals
    input           [3:0]       rxn             ,
    input           [3:0]       rxp             ,
    output  wire    [3:0]       txn             ,
    output  wire    [3:0]       txp             ,

    //LED signals
    output  wire    [7:0]       led             ,   // 20261018 disp: LED0..LED7

    //HDMI output (20261018 disp)
    output  wire                pix_clk         ,
    output  wire                vs_out          ,
    output  wire                hs_out          ,
    output  wire                de_out          ,
    output  wire    [7:0]       r_out           ,
    output  wire    [7:0]       g_out           ,
    output  wire    [7:0]       b_out           ,
    output  wire                hd_scl          ,
    inout                       hd_sda          ,
    output  wire                rstn_out        ,

    // 20261026 cam : OV5640 cameras (pins copied from the stereo project fdc)
    inout                       cmos1_scl       ,   // cam1 SCCB clock
    inout                       cmos1_sda       ,   // cam1 SCCB data
    input                       cmos1_vsync     ,
    input                       cmos1_href      ,
    input                       cmos1_pclk      ,
    input           [7:0]       cmos1_data      ,
    output  wire                cmos1_reset     ,
    inout                       cmos2_scl       ,   // cam2 SCCB clock (unused)
    inout                       cmos2_sda       ,   // cam2 SCCB data (unused)
    input                       cmos2_vsync     ,
    input                       cmos2_href      ,
    input                       cmos2_pclk      ,
    input           [7:0]       cmos2_data      ,
    output  wire                cmos2_reset
);


localparam      ADDR_WIDTH    = 'd32    ;  
localparam      RD_DATA_DELAY = 'd1     ;   


//RESET DEBOUNCE and SYNC
wire            sync_button_rst_n       ;
wire            s_pclk_rstn             ;

//********************** internal signal
//clk and rst
wire            pclk_div2               /* synthesis PAP_MARK_DEBUG=?true?*/;
wire            pclk                    ;
wire            ref_clk                 ;
wire            core_rst_n              ;
//AXIS master interface
wire            axis_master_tvalid      /* synthesis PAP_MARK_DEBUG=?true?*/;
wire            axis_master_tready      /* synthesis PAP_MARK_DEBUG=?true?*/;
wire    [127:0] axis_master_tdata       /* synthesis PAP_MARK_DEBUG=?true?*/;
wire    [3:0]   axis_master_tkeep       /* synthesis PAP_MARK_DEBUG=?true?*/;
wire            axis_master_tlast       /* synthesis PAP_MARK_DEBUG=?true?*/;
wire    [7:0]   axis_master_tuser       /* synthesis PAP_MARK_DEBUG=?true?*/;

//axis slave 0 interface
wire            axis_slave0_tready      /* synthesis PAP_MARK_DEBUG=?true?*/;
wire            axis_slave0_tvalid      /* synthesis PAP_MARK_DEBUG=?true?*/;
wire    [127:0] axis_slave0_tdata       /* synthesis PAP_MARK_DEBUG=?true?*/;
wire            axis_slave0_tlast       /* synthesis PAP_MARK_DEBUG=?true?*/;
wire            axis_slave0_tuser       /* synthesis PAP_MARK_DEBUG=?true?*/;

//axis slave 1 interface
wire            axis_slave1_tready      /* synthesis PAP_MARK_DEBUG=?true?*/;
wire            axis_slave1_tvalid      /* synthesis PAP_MARK_DEBUG=?true?*/;
wire    [127:0] axis_slave1_tdata       /* synthesis PAP_MARK_DEBUG=?true?*/;
wire            axis_slave1_tlast       /* synthesis PAP_MARK_DEBUG=?true?*/;
wire            axis_slave1_tuser       /* synthesis PAP_MARK_DEBUG=?true?*/;

//axis slave 2 interface
wire            axis_slave2_tready      /* synthesis PAP_MARK_DEBUG=?true?*/;
wire            axis_slave2_tvalid      /* synthesis PAP_MARK_DEBUG=?true?*/;
wire    [127:0] axis_slave2_tdata       /* synthesis PAP_MARK_DEBUG=?true?*/;
wire            axis_slave2_tlast       /* synthesis PAP_MARK_DEBUG=?true?*/;
wire            axis_slave2_tuser       /* synthesis PAP_MARK_DEBUG=?true?*/;

wire    [7:0]   cfg_pbus_num            ;
wire    [4:0]   cfg_pbus_dev_num        ;
wire    [2:0]   cfg_max_rd_req_size     ;
wire    [2:0]   cfg_max_payload_size    ;
wire            cfg_rcb                 ;

//system signal
wire    [4:0]   smlh_ltssm_state        /* synthesis PAP_MARK_DEBUG=?true?*/;
wire            smlh_link_up            ;   // 20261018 disp: internal now

// 20261018 disp: ext regs / arbiter / display interconnect
wire [11:0]     ext_rd_addr         ;
wire [127:0]    ext_rd_data         ;
wire            ext_cfg_tgl         ;
wire [15:0]     ext_cfg_ctrl        ;
wire [31:0]     ext_fb_base         ;
wire [31:0]     ext_slot_size       ;
wire [31:0]     ext_stride          ;
wire [31:0]     ext_uv_off          ;
wire            ext_commit_tgl      ;
wire [1:0]      ext_commit_slot     ;
wire [15:0]     ext_commit_fid      ;
wire            ext_stat_tgl        ;
wire [159:0]    ext_stat_bus        ;
wire [4:0]      ext_key_stat        ;
wire [7:0]      ext_led_host        ;
wire [7:0]      ext_led_oe          ;

// 20261018 osd1: OSD register/event interconnect
wire            ext_osd_cfg_tgl     ;
wire [1065:0]   ext_osd_cfg         ;
wire            ext_tram_we         ;
wire [5:0]      ext_tram_addr       ;
wire [31:0]     ext_tram_data       ;
wire            ext_evt_tgl         ;
wire [2:0]      ext_evt_key         ;
wire [1:0]      ext_evt_type        ;
wire [5:0]      ext_evt_step        ;
wire            ext_drv_tgl         ;
wire [9:0]      ext_drv_bus         ;
wire            ext_cal_tgl         ;
wire [59:0]     ext_cal_bus         ;
wire            hdmi_reinit_tgl     ;   // 20261019 osd1d: pclk_div2 -> cfg_clk
wire            hdmi_rx_en          ;   // 20261028: pclk_div2 -> cfg_clk
wire            hdmi_stat_tgl       ;   // 20261019 osd1d: cfg_clk
wire [31:0]     hdmi_stat_bus       ;   // 20261019 osd1d: cfg_clk
wire [8:0]      ext_stats_ctrl      ;   // 20261027 stats
wire [95:0]     ext_stats_bus       ;   // 20261027 stats
wire            ext_stats_tgl       ;   // 20261027 stats

//uart2apb 32bits
wire            uart_p_sel              ;
wire    [3:0]   uart_p_strb             ;
wire    [15:0]  uart_p_addr             ;
wire    [31:0]  uart_p_wdata            ;
wire            uart_p_ce               ;
wire            uart_p_we               ;
wire            uart_p_rdy              ;
wire    [31:0]  uart_p_rdata            ;

// 20261018 ddr: PCIe DMA <-> rt_ddr_hub interconnect
wire            bar1_tap_vld        ;   // 20261018 ddr:
wire [11:0]     bar1_tap_addr       ;   // 20261018 ddr:
wire [31:0]     bar1_tap_data       ;   // 20261018 ddr:
wire            mrd_start_hub       ;   // 20261018 ddr:
wire            mrd_done_hub        ;   // 20261018 ddr:
wire            db_ack_hub          ;   // 20261018 ddr:
wire            hub_db_req          ;   // 20261018 ddr:
wire [31:0]     hub_db_addr         ;   // 20261018 ddr:
wire [19:0]     hub_db_len_dw       ;   // 20261018 ddr:
wire            hub_issue_hold      ;   // 20261018 ddr:
wire            hub_start_block     ;   // 20261018 ddr:
wire            hub_final_done_host ;   // 20261018 ddr:
wire [127:0]    hub_stat1c0         ;   // 20261018 ddr:
wire [127:0]    hub_stat1d0         ;   // 20261018 ddr:
wire [127:0]    hub_stat1e0         ;   // 20261018 ddr:
wire            hub_copy_wr_en      ;   // 20261018 ddr:
wire [11:0]     hub_copy_wr_addr    ;   // 20261018 ddr:
wire [127:0]    hub_copy_wr_data    ;   // 20261018 ddr:

//----------------------------------------------------------rst debounce ----------------------------------------------------------

hsst_rst_cross_sync_v1_0 #(
    `ifdef IPS2L_PCIE_SPEEDUP_SIM
    .RST_CNTR_VALUE     (16'h10             )
    `else
    .RST_CNTR_VALUE     (16'hC000           )
    `endif
)
u_refclk_buttonrstn_debounce(
    .clk                (ref_clk            ),
    .rstn_in            (1'b1               ),
    .rstn_out           (sync_button_rst_n  )
);

hsst_rst_cross_sync_v1_0 #(
    `ifdef IPS2L_PCIE_SPEEDUP_SIM
    .RST_CNTR_VALUE     (16'h10             )
    `else
    .RST_CNTR_VALUE     (16'hC000           )
    `endif
)
u_refclk_perstn_debounce(
    .clk                (ref_clk            ),
    .rstn_in            (perst_n            ),
    .rstn_out           (sync_perst_n       )
);

hsst_rst_sync_v1_0  u_ref_core_rstn_sync    (
    .clk                (ref_clk            ),
    .rst_n              (core_rst_n         ),
    .sig_async          (1'b1               ),
    .sig_synced         (ref_core_rst_n     )
);

hsst_rst_sync_v1_0  u_pclk_core_rstn_sync   (
    .clk                (pclk               ),
    .rst_n              (core_rst_n         ),
    .sig_async          (1'b1               ),
    .sig_synced         (s_pclk_rstn        )
);


//---------------------------------------------------------- dbg sticky led (20261017 dbg) ----------------------------------------------------------
wire            dbg_pll_lock        /* synthesis PAP_MARK_DEBUG="true" */;
wire            dbg_tx_rst_done     /* synthesis PAP_MARK_DEBUG="true" */;
wire    [1:0]   dbg_cdr_align       /* synthesis PAP_MARK_DEBUG="true" */;
wire    [1:0]   dbg_lsm_synced      /* synthesis PAP_MARK_DEBUG="true" */;
wire            rdlh_link_up_int    /* synthesis PAP_MARK_DEBUG="true" */;

// 2-stage synchronizers into ref_clk domain (async reset by sync_perst_n)
reg     [1:0]   sync_pll_lock;
reg     [1:0]   sync_tx_rst_done;
reg     [1:0]   sync_cdr_align0;
reg     [1:0]   sync_cdr_align1;
reg     [1:0]   sync_pollcfg;
reg     [1:0]   sync_cfg;

// LTSSM flags sampled in pclk_div2 domain (no reset)
reg             ltssm_is_pollcfg;
reg             ltssm_is_cfg;
always @(posedge pclk_div2)
begin
    ltssm_is_pollcfg <= (smlh_ltssm_state == 5'h04);
    ltssm_is_cfg     <= (smlh_ltssm_state >= 5'h07) && (smlh_ltssm_state <= 5'h0C);
end

// sticky flags in ref_clk domain
reg             st_pll;
reg             st_txdone;
reg             st_cdr0;
reg             st_cdr1;
reg             st_pollcfg;
reg             st_cfg;

always @(posedge ref_clk or negedge sync_perst_n)
begin
    if (!sync_perst_n)
    begin
        sync_pll_lock    <= 2'd0;
        sync_tx_rst_done <= 2'd0;
        sync_cdr_align0  <= 2'd0;
        sync_cdr_align1  <= 2'd0;
        sync_pollcfg     <= 2'd0;
        sync_cfg         <= 2'd0;
        st_pll           <= 1'b0;
        st_txdone        <= 1'b0;
        st_cdr0          <= 1'b0;
        st_cdr1          <= 1'b0;
        st_pollcfg       <= 1'b0;
        st_cfg           <= 1'b0;
    end
    else
    begin
        sync_pll_lock    <= {sync_pll_lock[0],    dbg_pll_lock};
        sync_tx_rst_done <= {sync_tx_rst_done[0], dbg_tx_rst_done};
        sync_cdr_align0  <= {sync_cdr_align0[0],  dbg_cdr_align[0]};
        sync_cdr_align1  <= {sync_cdr_align1[0],  dbg_cdr_align[1]};
        sync_pollcfg     <= {sync_pollcfg[0],     ltssm_is_pollcfg};
        sync_cfg         <= {sync_cfg[0],         ltssm_is_cfg};

        if (sync_pll_lock[1])    st_pll     <= 1'b1;
        if (sync_tx_rst_done[1]) st_txdone  <= 1'b1;
        if (sync_cdr_align0[1])  st_cdr0    <= 1'b1;
        if (sync_cdr_align1[1])  st_cdr1    <= 1'b1;
        if (sync_pollcfg[1])     st_pollcfg <= 1'b1;
        if (sync_cfg[1])         st_cfg     <= 1'b1;
    end
end

// 20261017 dbg: sticky flags kept internal only (no longer on pins)

//----------------------------------------------------------   dma  ----------------------------------------------------------

wire                        cpld_finish        ; 
wire                        mwr_req_cmd        ;
wire                        mwr_tx_start       ;	
wire    [31:0]              rd_base_ram_addr   ;	
wire    [31:0]              wr_base_ram_addr   ;
wire    [10:0]              mem_length         ;

wire                        pio_wr_en          ;
wire    [15:0]              pio_wr_byte_en     ; 
wire    [ADDR_WIDTH-1:0]    pio_wr_addr        ;
wire    [127:0]             pio_wr_data        ;
wire                        pio_rd_en          ;
wire    [ADDR_WIDTH-1:0]    pio_rd_addr        ;
wire    [127:0]             pio_rd_data        ;

wire                        dma_wr_en          ;
wire    [15:0]              dma_wr_byte_en     ; 
wire    [ADDR_WIDTH-1:0]    dma_wr_addr        ;
wire    [127:0]             dma_wr_data        ;
wire                        dma_rd_en          ;
wire    [ADDR_WIDTH-1:0]    dma_rd_addr        ;
wire    [127:0]             dma_rd_data        ;
	
rt_pcie_dma #(
    .ADDR_WIDTH             (ADDR_WIDTH             ),
	.RD_DATA_DELAY          (RD_DATA_DELAY          )   //receive rd_data delay clk cyle, support 1?2?3 clk cyle.
)
u_rt_pcie_dma
(
    .clk                    (pclk_div2              ),  //gen1:62.5MHz,gen2:125MHz
    .rst_n                  (core_rst_n             ),
    //num
    .i_cfg_pbus_num         (cfg_pbus_num           ),  //input [7:0]
    .i_cfg_pbus_dev_num     (cfg_pbus_dev_num       ),  //input [4:0]
    .i_cfg_max_rd_req_size  (cfg_max_rd_req_size    ),  //input [2:0]
    .i_cfg_max_payload_size (cfg_max_payload_size   ),  //input [2:0]
    //**********************************************************************
    //axis master interface
    .i_axis_master_tvld     (axis_master_tvalid     ),  //input  [0:0]
    .o_axis_master_trdy     (axis_master_tready     ),  //output [0:0]
    .i_axis_master_tdata    (axis_master_tdata      ),  //input  [127:0]
    .i_axis_master_tkeep    (axis_master_tkeep      ),  //input  [3:0]
    .i_axis_master_tlast    (axis_master_tlast      ),  //input  [0:0]
    .i_axis_master_tuser    (axis_master_tuser      ),  //input  [7:0]

    //**********************************************************************
    //axis_slave0 interface
    .i_axis_slave0_trdy     (axis_slave0_tready     ),  //input  [0:0]
    .o_axis_slave0_tvld     (axis_slave0_tvalid     ),  //output [0:0]
    .o_axis_slave0_tdata    (axis_slave0_tdata      ),  //output [127:0]
    .o_axis_slave0_tlast    (axis_slave0_tlast      ),  //output [0:0]
    .o_axis_slave0_tuser    (axis_slave0_tuser      ),  //output [0:0]
    //axis_slave1 interface
    .i_axis_slave1_trdy     (axis_slave1_tready     ),  //input  [0:0]
    .o_axis_slave1_tvld     (axis_slave1_tvalid     ),  //output [0:0]
    .o_axis_slave1_tdata    (axis_slave1_tdata      ),  //output [127:0]
    .o_axis_slave1_tlast    (axis_slave1_tlast      ),  //output [0:0]
    .o_axis_slave1_tuser    (axis_slave1_tuser      ),  //output [0:0]
    //axis_slave2 interface
    .i_axis_slave2_trdy     (axis_slave2_tready     ),  //input  [0:0]
    .o_axis_slave2_tvld     (axis_slave2_tvalid     ),  //output [0:0]
    .o_axis_slave2_tdata    (axis_slave2_tdata      ),  //output [127:0]
    .o_axis_slave2_tlast    (axis_slave2_tlast      ),  //output [0:0]
    .o_axis_slave2_tuser    (axis_slave2_tuser      ),  //output [0:0]
    //**********************************************************************
	
	.i_cpld_finish           (cpld_finish           ),  //input  [0:0]  //????cpld??             
    .o_mwr_req_cmd           (mwr_req_cmd           ),  //output [0:0]  //mwr????????????16in_16out_ram  1clk        
    .i_mwr_tx_start          (mwr_tx_start          ),  //input  [0:0]  //????????????16in_128out ram.????mwr??  1clk	
    .o_rd_base_ram_addr      (rd_base_ram_addr      ),  //output [31:0]
    .o_wr_base_ram_addr      (wr_base_ram_addr      ),  //output [31:0]
    .o_mem_length            (mem_length            ),  //output [10:0]	
    //**********************************************************************	
    //////ram interface
	//pio write to ram
	.o_pio_wr_en             (pio_wr_en             ),  //output [0:0]
    .o_pio_wr_byte_en        (pio_wr_byte_en        ),  //output [15:0]
    .o_pio_wr_addr           (pio_wr_addr           ),  //output [63:0]
    .o_pio_wr_data           (pio_wr_data           ),  //output [127:0]
	//pio read from ram                        
	.o_pio_rd_en             (pio_rd_en             ),  //output [0:0]
    .o_pio_rd_addr           (pio_rd_addr           ),  //output [63:0]
    .i_pio_rd_data           (pio_rd_data           ),	//input  [127:0]
	
    //dma cpld, write to ram
	.o_dma_wr_en             (dma_wr_en             ),  //output [0:0]
    .o_dma_wr_byte_en        (dma_wr_byte_en        ),  //output [15:0]
    .o_dma_wr_addr           (dma_wr_addr           ),  //output [ADDR_WIDTH-1:0]
    .o_dma_wr_data           (dma_wr_data           ),  //output [127:0]
	//dma mwr, read from ram
	.o_dma_rd_en             (dma_rd_en             ),  //output [0:0]
    .o_dma_rd_addr           (dma_rd_addr           ),  //output [ADDR_WIDTH-1:0]
    .i_dma_rd_data           (dma_rd_data           ),  //input  [127:0]
    // 20261018 ddr: DDR doorbell / BAR1 tap interface
    .o_bar1_tap_vld          (bar1_tap_vld          ),   // 20261018 ddr:
    .o_bar1_tap_addr         (bar1_tap_addr         ),   // 20261018 ddr:
    .o_bar1_tap_data         (bar1_tap_data         ),   // 20261018 ddr:
    .o_mrd_start             (mrd_start_hub         ),   // 20261018 ddr:
    .o_mrd_done              (mrd_done_hub          ),   // 20261018 ddr:
    .o_db_ack                (db_ack_hub            ),   // 20261018 ddr:
    .i_db_req                (hub_db_req            ),   // 20261018 ddr:
    .i_db_addr               (hub_db_addr           ),   // 20261018 ddr:
    .i_db_len_dw             (hub_db_len_dw         ),   // 20261018 ddr:
    .i_issue_hold            (hub_issue_hold        ),   // 20261018 ddr:
    .i_start_block           (hub_start_block       ),   // 20261018 ddr:
    .i_final_done_host       (hub_final_done_host   ),   // 20261018 ddr:
    .i_stat1c0               (hub_stat1c0           ),   // 20261018 ddr:
    .i_stat1d0               (hub_stat1d0           ),   // 20261018 ddr:
    .i_stat1e0               (hub_stat1e0           ),   // 20261018 ddr:
    .i_ext_rd_data           (ext_rd_data           ),   // 20261018 disp:
    .o_ext_rd_addr           (ext_rd_addr           )    // 20261018 disp:
);

//**********************************************************************
/////////////////////////////////////////////////////////////////PIO RAM
ram_128in_128out u_ram_128in_128out
(
    .wr_clk             (pclk_div2               ),  // input
    .wr_rst             (~core_rst_n             ),  // input
    .wr_en              (pio_wr_en               ),  // input
    .wr_byte_en         (pio_wr_byte_en          ),  // input [15:0]
    .wr_addr            (pio_wr_addr[11:0]       ),  // input [11:0]
    .wr_data            (pio_wr_data             ),  // input [127:0]
    .rd_clk             (pclk_div2               ),  // input
    .rd_rst             (~core_rst_n             ),  // input
    .rd_clk_en          (pio_rd_en               ),  // input
    .rd_addr            (pio_rd_addr[11:0]       ),  // input [11:0]
    .rd_data            (pio_rd_data             )   // output[127:0]
);


/////////////////////////////////////////////////////////////////DMA
wire            dma_ram_wr_en      ;
wire    [31:0]  dma_ram_wr_addr    ;
wire    [15:0]  dma_ram_wr_data    ;
wire    [1:0]   dma_ram_wr_byte_en ; 

wire            dma_ram_rd_en      ;
wire    [31:0]  dma_ram_rd_addr    ;
wire    [15:0]  dma_ram_rd_data    ;

rt_gs_dma_interface_conversion #(
    .ADDR_WIDTH              (ADDR_WIDTH          ),
	.RD_DATA_DELAY           (RD_DATA_DELAY       ),   //receive rd_data delay clk cyle, support 1?2?3 clk cyle.
	.FAST_PATH               (1)                       // 20261018 fast: 128-bit DMA RAM, no 16-bit repack
)
u_rt_gs_dma_interface_conversion
(
    .clk                     (pclk_div2           ),  // input
    .rst_n                   (core_rst_n          ),  // input
	//128bit write           
    .i_dma_wr_en             (dma_wr_en           ),  // input
    .i_dma_wr_byte_en        (dma_wr_byte_en      ),  // input [15:0]
    .i_dma_wr_addr           (dma_wr_addr         ),  // input [ADDR_WIDTH-1:0]
    .i_dma_wr_data           (dma_wr_data         ),  // input [127:0]
	//16bit write            
    .o_dma_ram_wr_en         (dma_ram_wr_en       ),  // output
    .o_dma_ram_wr_byte_en    (dma_ram_wr_byte_en  ),  // output [1:0]
    .o_dma_ram_wr_addr       (dma_ram_wr_addr     ),  // output [ADDR_WIDTH-1:0]
    .o_dma_ram_wr_data       (dma_ram_wr_data     ),  // output [15:0]
    //128bit read	         
    .i_dma_rd_en             (dma_rd_en           ),  // input 
    .i_dma_rd_addr           (dma_rd_addr         ),  // input  [ADDR_WIDTH-1:0]
	.o_dma_rd_data           (dma_rd_data         ),  // output [127:0]
    //16bit read		     
    .o_dma_ram_rd_en         (dma_ram_rd_en       ),  // output 
    .o_dma_ram_rd_addr       (dma_ram_rd_addr     ),  // output [ADDR_WIDTH-1:0]
    .i_dma_ram_rd_data       (dma_ram_rd_data     ),  // input  [15:0]
	/////////////////////////////////////////////////	
	//other ctrl
	.o_cpld_finish           (cpld_finish          ),  
    .i_mwr_req_cmd           (mwr_req_cmd          ),  
    .o_mwr_tx_start          (mwr_tx_start         ),  
    .i_rd_base_ram_addr      (rd_base_ram_addr     ),  
    .i_wr_base_ram_addr      (wr_base_ram_addr     ),  
	.i_mem_length            (mem_length           )   ,
    // 20261018 ddr: DDR readback copy write port
    .i_copy_wr_en            (hub_copy_wr_en       ),   // 20261018 ddr:
    .i_copy_wr_addr          (hub_copy_wr_addr     ),   // 20261018 ddr:
    .i_copy_wr_data          (hub_copy_wr_data     )    // 20261018 ddr:
);

//DMA RAM
ram_16in_16out u_ram_16in_16out 
(
    .wr_clk             (pclk_div2            ),  // input
    .wr_rst             (~core_rst_n          ),  // input
    .wr_en              (dma_ram_wr_en        ),  // input
    .wr_byte_en         (dma_ram_wr_byte_en   ),  // input [1:0]
    .wr_addr            (dma_ram_wr_addr[11:0]),  // input [11:0]
    .wr_data            (dma_ram_wr_data      ),  // input [15:0]
    .rd_clk             (pclk_div2            ),  // input
    .rd_rst             (~core_rst_n          ),  // input
    .rd_clk_en          (dma_ram_rd_en        ),  // input
    .rd_addr            (dma_ram_rd_addr[11:0]),  // input  [11:0]
    .rd_data            (dma_ram_rd_data      )   // output [15:0]
);

//----------------------------------------------------------   ddr3 (20261018 ddr) ----------------------------------------------------------
// 20261018 ddr: DDR3 125MHz differential reference clock
wire            ddr_ref_clk         ;   // 20261018 ddr:
GTP_INBUFGDS #(
    .IOSTANDARD     ("DEFAULT"),
    .TERM_DIFF      ("ON")
) u_ddr_refclk (
    .O              (ddr_ref_clk            ),   // 20261018 ddr:
    .I              (clk_p                  ),   // 20261018 ddr:
    .IB             (clk_n                  )    // 20261018 ddr:
);

// 20261018 ddr: power-on reset (20-bit counter on free_clk, registers init 0)
reg     [19:0]  por_cnt             = 20'd0;   // 20261018 ddr:
reg             por_done            = 1'b0;    // 20261018 ddr:
always @(posedge free_clk)   // 20261018 ddr:
begin
    if (!por_done)
    begin
        por_cnt <= por_cnt + 20'd1;   // 20261018 ddr:
        if (por_cnt == 20'hFFFFF)
            por_done <= 1'b1;   // 20261018 ddr:
    end
end

wire            ddr_resetn          ;   // 20261018 ddr:
assign ddr_resetn = por_done;   // 20261018 ddr: (POR only)

// 20261018 ddr: DDR core domain outputs
wire            ddr_core_clk        ;   // 20261018 ddr:
wire            ddr_init_done       ;   // 20261018 ddr:
wire            ddr_rst_n           ;   // 20261018 ddr:
wire            ddr_pll_lock        ;   // 20261018 ddr:
wire            ddr_phy_pll_lock    ;   // 20261018 ddr:
wire            ddr_gpll_lock       ;   // 20261018 ddr:
wire            ddr_rst_gpll_lock   ;   // 20261018 ddr:
wire            ddr_ddrphy_cpd_lock ;   // 20261018 ddr:

// 20261018 ddr: async assert / sync release reset for DDR hub
reg     [1:0]   ddr_rstn_sync       ;   // 20261018 ddr:
always @(posedge ddr_core_clk or negedge ddr_resetn)   // 20261018 ddr:
begin
    if (!ddr_resetn)
        ddr_rstn_sync <= 2'b00;   // 20261018 ddr:
    else
        ddr_rstn_sync <= {ddr_rstn_sync[0], 1'b1};   // 20261018 ddr:
end
assign ddr_rst_n = ddr_rstn_sync[1];   // 20261018 ddr:

// 20261018 ddr: AXI between DDR3 IP and rt_ddr_hub
wire [27:0]     ddr_axi_awaddr      ;   // 20261018 ddr:
wire [3:0]      ddr_axi_awlen       ;   // 20261018 ddr:
wire            ddr_axi_awvalid     ;   // 20261018 ddr:
wire            ddr_axi_awready     ;   // 20261018 ddr:
wire [255:0]    ddr_axi_wdata       ;   // 20261018 ddr:
wire [31:0]     ddr_axi_wstrb       ;   // 20261018 ddr:
wire            ddr_axi_wready      ;   // 20261018 ddr:
wire [27:0]     ddr_axi_araddr      ;   // 20261018 ddr:
wire [3:0]      ddr_axi_arlen       ;   // 20261018 ddr:
wire            ddr_axi_arvalid     ;   // 20261018 ddr:
wire            ddr_axi_arready     ;   // 20261018 ddr:
wire [255:0]    ddr_axi_rdata       ;   // 20261018 ddr:
wire            ddr_axi_rlast       ;   // 20261018 ddr:
wire            ddr_axi_rvalid      ;   // 20261018 ddr:
wire [3:0]      ddr_axi_aruser_id   ;   // 20261018 disp:

// 20261018 disp: arbiter client buses
wire [27:0]     hub_axi_araddr      ;
wire [3:0]      hub_axi_arlen       ;
wire            hub_axi_arvalid     ;
wire            hub_axi_arready     ;
wire [255:0]    hub_axi_rdata       ;
wire            hub_axi_rlast       ;
wire            hub_axi_rvalid      ;
wire [27:0]     dsp_axi_araddr      ;
wire [3:0]      dsp_axi_arlen       ;
wire            dsp_axi_arvalid     ;
wire            dsp_axi_arready     ;
wire [255:0]    dsp_axi_rdata       ;
wire            dsp_axi_rlast       ;
wire            dsp_axi_rvalid      ;

// 20261018 ddr: DDR3 controller IP
ddr3_test u_ddr3_test_h (
    .ref_clk                   (ddr_ref_clk            ),
    .resetn                    (ddr_resetn             ),
    .ddr_init_done             (ddr_init_done          ),
    .pll_lock                  (ddr_pll_lock           ),
    .core_clk                  (ddr_core_clk           ),
    .phy_pll_lock              (ddr_phy_pll_lock       ),
    .gpll_lock                 (ddr_gpll_lock          ),
    .rst_gpll_lock             (ddr_rst_gpll_lock      ),
    .ddrphy_cpd_lock           (ddr_ddrphy_cpd_lock    ),

    .axi_awaddr                (ddr_axi_awaddr         ),
    .axi_awuser_ap             (1'b0                   ),
    .axi_awuser_id             (4'd0                   ),
    .axi_awlen                 (ddr_axi_awlen          ),
    .axi_awready               (ddr_axi_awready        ),
    .axi_awvalid               (ddr_axi_awvalid        ),
    .axi_wdata                 (ddr_axi_wdata          ),
    .axi_wstrb                 (ddr_axi_wstrb          ),
    .axi_wready                (ddr_axi_wready         ),
    .axi_wusero_id             (                       ),
    .axi_wusero_last           (                       ),
    .axi_araddr                (ddr_axi_araddr         ),
    .axi_aruser_ap             (1'b0                   ),
    .axi_aruser_id             (ddr_axi_aruser_id      ),
    .axi_arlen                 (ddr_axi_arlen          ),
    .axi_arready               (ddr_axi_arready        ),
    .axi_arvalid               (ddr_axi_arvalid        ),
    .axi_rdata                 (ddr_axi_rdata          ),
    .axi_rid                   (                       ),
    .axi_rlast                 (ddr_axi_rlast          ),
    .axi_rvalid                (ddr_axi_rvalid         ),

    .apb_clk                   (1'b0                   ),
    .apb_rst_n                 (1'b1                   ),
    .apb_sel                   (1'b0                   ),
    .apb_enable                (1'b0                   ),
    .apb_addr                  (8'b0                   ),
    .apb_write                 (1'b0                   ),
    .apb_ready                 (                       ),
    .apb_wdata                 (16'b0                  ),
    .apb_rdata                 (                       ),

    .mem_rst_n                 (mem_rst_n              ),
    .mem_ck                    (mem_ck                 ),
    .mem_ck_n                  (mem_ck_n               ),
    .mem_cke                   (mem_cke                ),
    .mem_cs_n                  (mem_cs_n               ),
    .mem_ras_n                 (mem_ras_n              ),
    .mem_cas_n                 (mem_cas_n              ),
    .mem_we_n                  (mem_we_n               ),
    .mem_odt                   (mem_odt                ),
    .mem_a                     (mem_a                  ),
    .mem_ba                    (mem_ba                 ),
    .mem_dqs                   (mem_dqs                ),
    .mem_dqs_n                 (mem_dqs_n              ),
    .mem_dq                    (mem_dq                 ),
    .mem_dm                    (mem_dm                 ),

    .dbg_gate_start            (1'b0                   ),
    .dbg_cpd_start             (1'b0                   ),
    .dbg_ddrphy_rst_n          (1'b1                   ),
    .dbg_gpll_scan_rst         (1'b0                   ),
    .samp_position_dyn_adj     (1'b0                   ),
    .init_samp_position_even   (32'd0                  ),
    .init_samp_position_odd    (32'd0                  ),
    .wrcal_position_dyn_adj    (1'b0                   ),
    .init_wrcal_position       (32'd0                  ),
    .force_read_clk_ctrl       (1'b0                   ),
    .init_slip_step            (16'd0                  ),
    .init_read_clk_ctrl        (12'd0                  ),
    .debug_calib_ctrl          (                       ),
    .dbg_slice_status          (                       ),
    .dbg_slice_state           (                       ),
    .debug_data                (                       ),
    .dbg_dll_upd_state         (                       ),
    .debug_gpll_dps_phase      (                       ),
    .dbg_rst_dps_state         (                       ),
    .dbg_tran_err_rst_cnt      (                       ),
    .dbg_ddrphy_init_fail      (                       ),
    .debug_cpd_offset_adj      (1'b0                   ),
    .debug_cpd_offset_dir      (1'b0                   ),
    .debug_cpd_offset          (10'd0                  ),
    .debug_dps_cnt_dir0        (                       ),
    .debug_dps_cnt_dir1        (                       ),
    .ck_dly_en                 (1'b0                   ),
    .init_ck_dly_step          (8'h0                   ),
    .ck_dly_set_bin            (                       ),
    .align_error               (                       ),
    .debug_rst_state           (                       ),
    .debug_cpd_state           (                       )
);

//----------------------------------------------------------   cam1 / cam2 (20261026 cam) ----------------------------------------------------------
// cam1 : OV5640 -> 8:16 pack -> 42 MHz -> centre crop 960x540 -> DDR slot0
// cam2 : pins brought out only, capture path is not built at this stage.
wire            cam1_pclk_16bit     ;
wire            cam1_pclk_16bit_g   ;
wire [15:0]     cam1_d_16bit        ;
wire            cam1_href_16bit     ;
wire            cam1_vsync_d0       ;
wire            cam_cfg_done        ;
wire            cam_initial_en      ;
wire            cam_wr_en           ;
wire [31:0]     cam_wr_addr         ;
wire [127:0]    cam_wr_data         ;
wire [15:0]     cam_wr_be           ;
wire            cam_wr_ready        ;
wire [31:0]     cam_wr_stat         ;
wire            cam_commit_tgl      ;   // camera frame boundary -> window 0
wire [15:0]     cam_commit_fid      ;
wire            cam_commit_buf      ;   // slot0 double buffer index
wire            cam_urgent          ;   // camera FIFO nearly full -> MRd pause
wire [31:0]     cam_urg_cnt         ;   // MRd pause episodes (0x8A8)
// 20261106 cam23: runtime SCCB wires (declared before u_cam1_reg_config uses them)
wire [23:0]     sccb_cmd            ;
wire            sccb_req_tgl        ;
wire            sccb_done_tgl       ;
wire            sccb_nack           ;

// power on sequence : 5 ms / 1.3 ms / 21 ms tuned for 50 MHz.  free_clk is
// 27 MHz, so every delay is ~1.85x longer, which is on the safe side (the
// OV5640 only specifies minimum waits).
power_on_delay u_cam_power_on (
    .clk_50M      (free_clk         ),
    .reset_n      (1'b1             ),
    .camera1_rstn (cmos1_reset      ),
    .camera2_rstn (cmos2_reset      ),
    .camera_pwnd  (                 ),
    .initial_en   (cam_initial_en   )
);

// cam1 SCCB : 357 entry OV5640 table (1280x720 RGB565), 20 kHz class clock
reg_config u_cam1_reg_config (
    .clk_25M      (free_clk         ),
    .camera_rstn  (cmos1_reset      ),
    .initial_en   (cam_initial_en   ),
    .reg_conf_done(cam_cfg_done     ),
    .i2c_sclk     (cmos1_scl        ),
    .i2c_sdat     (cmos1_sda        ),
    .clock_20k    (                 ),
    .reg_index    (                 ),
    .nack_after102(                 ),
    .rt_cmd       (sccb_cmd         ),
    .rt_req_tgl   (sccb_req_tgl     ),
    .rt_done_tgl  (sccb_done_tgl    ),
    .rt_nack      (sccb_nack        )
);

// cam2 : only the pins (SCCB released, reset follows the same power sequence)
reg cam2_scl_oe = 1'b0;
reg cam2_sda_oe = 1'b0;
assign cmos2_scl = cam2_scl_oe ? 1'b0 : 1'bz;
assign cmos2_sda = cam2_sda_oe ? 1'b0 : 1'bz;

// cam1 8 bit -> 16 bit RGB565 packing, same structure as the reference top
reg [7:0] cmos1_d_d0;
reg       cmos1_href_d0;
reg       cmos1_vsync_d0;
always @(posedge cmos1_pclk)
begin
    cmos1_d_d0     <= cmos1_data ;
    cmos1_href_d0  <= cmos1_href ;
    cmos1_vsync_d0 <= cmos1_vsync;
end

cmos_8_16bit cmos1_8_16bit (
    .pclk      (cmos1_pclk      ),
    .rst_n     (cam_cfg_done    ),
    .pdata_i   (cmos1_d_d0      ),
    .de_i      (cmos1_href_d0   ),
    .vs_i      (cmos1_vsync_d0  ),
    .pixel_clk (cam1_pclk_16bit ),
    .pdata_o   (cam1_d_16bit    ),
    .de_o      (cam1_href_16bit )
);

GTP_CLKBUFG u_clkbufg_cam1 (
    .CLKOUT (cam1_pclk_16bit_g),
    .CLKIN  (cam1_pclk_16bit  )
);

// camera pixel domain reset : por_done (free_clk) synced into pclk_16bit
reg [1:0] cam_rstn_sync;
always @(posedge cam1_pclk_16bit_g)
    cam_rstn_sync <= {cam_rstn_sync[0], por_done};
wire cam_pclk_rst_n = cam_rstn_sync[1];

// 20261026 cam diag : pclk activity toggle, sampled in pclk_div2 by rt_ext_regs
reg cam_pclk_tgl = 1'b0;
always @(posedge cmos1_pclk)
    cam_pclk_tgl <= ~cam_pclk_tgl;

// 20261026 cam diag : vsync rising edges in the pclk_16bit domain, saturating
reg        cam_vs16_d1 = 1'b0, cam_vs16_d2 = 1'b0, cam_vs16_d3 = 1'b0;
reg [7:0]  cam_vs_cnt16 = 8'd0;
always @(posedge cam1_pclk_16bit_g)
begin
    cam_vs16_d1 <= cmos1_vsync_d0;
    cam_vs16_d2 <= cam_vs16_d1;
    cam_vs16_d3 <= cam_vs16_d2;
    if (cam_vs16_d2 & ~cam_vs16_d3)
        if (cam_vs_cnt16 != 8'hFF) cam_vs_cnt16 <= cam_vs_cnt16 + 1'b1;
end

// centre crop + 128 bit packing + async FIFO to the DDR hub (pclk_div2)
cam_ddr_writer u_cam_ddr_writer (
    .i_cam_en   (~ext_cfg_ctrl[6] ),
    .i_ddr_en   (ext_cfg_ctrl[0]  ),
    .pclk       (cam1_pclk_16bit_g),
    .pclk_rst_n (cam_pclk_rst_n   ),
    .vsync      (cmos1_vsync_d0   ),
    .de         (cam1_href_16bit  ),
    .data       (cam1_d_16bit     ),
    .core_clk   (pclk_div2        ),
    .core_rst_n (core_rst_n       ),
    .cfg_base   (ext_fb_base      ),
    .o_wr_en    (cam_wr_en        ),
    .o_wr_addr  (cam_wr_addr      ),
    .o_wr_data  (cam_wr_data      ),
    .o_wr_be    (cam_wr_be        ),
    .i_wr_ready (cam_wr_ready     ),
    .o_commit_tgl(cam_commit_tgl  ),
    .o_commit_fid(cam_commit_fid  ),
    .o_commit_buf(cam_commit_buf  ),
    .o_cam_urgent(cam_urgent      ),
    .o_stat     (cam_wr_stat      )
);

// 20261018 ddr: DDR readback / doorbell hub
rt_ddr_hub u_rt_ddr_hub (
    .pclk                      (pclk_div2              ),
    .pclk_rst_n                (core_rst_n             ),
    .i_tap_vld                 (bar1_tap_vld           ),
    .i_tap_addr                (bar1_tap_addr          ),
    .i_tap_data                (bar1_tap_data          ),
    .i_dma_wr_en               (dma_wr_en              ),
    .i_dma_wr_addr             (dma_wr_addr            ),
    .i_dma_wr_data             (dma_wr_data            ),
    .i_dma_wr_be               (dma_wr_byte_en         ),
    .i_cam_wr_en               (cam_wr_en              ),
    .i_cam_wr_addr             (cam_wr_addr            ),
    .i_cam_wr_data             (cam_wr_data            ),
    .i_cam_wr_be               (cam_wr_be              ),
    .o_cam_wr_ready            (cam_wr_ready           ),
    .i_cam_urgent              (cam_urgent             ),
    .o_cam_urg_cnt             (cam_urg_cnt            ),
    .i_mrd_start               (mrd_start_hub          ),
    .i_mrd_done                (mrd_done_hub           ),
    .i_db_ack                  (db_ack_hub             ),
    .o_db_req                  (hub_db_req             ),
    .o_db_addr                 (hub_db_addr            ),
    .o_db_len_dw               (hub_db_len_dw          ),
    .o_issue_hold              (hub_issue_hold         ),
    .o_start_block             (hub_start_block        ),
    .o_final_done_host         (hub_final_done_host    ),
    .o_copy_wr_en              (hub_copy_wr_en         ),
    .o_copy_wr_addr            (hub_copy_wr_addr       ),
    .o_copy_wr_data            (hub_copy_wr_data       ),
    .o_stat1c0                 (hub_stat1c0            ),
    .o_stat1d0                 (hub_stat1d0            ),
    .o_stat1e0                 (hub_stat1e0            ),
    .ddr_clk                   (ddr_core_clk           ),
    .ddr_rst_n                 (ddr_rst_n              ),
    .ddr_init_done             (ddr_init_done          ),
    .axi_awaddr                (ddr_axi_awaddr         ),
    .axi_awlen                 (ddr_axi_awlen          ),
    .axi_awvalid               (ddr_axi_awvalid        ),
    .axi_awready               (ddr_axi_awready        ),
    .axi_wdata                 (ddr_axi_wdata          ),
    .axi_wstrb                 (ddr_axi_wstrb          ),
    .axi_wready                (ddr_axi_wready         ),
    .axi_araddr                (hub_axi_araddr         ),
    .axi_arlen                 (hub_axi_arlen          ),
    .axi_arvalid               (hub_axi_arvalid        ),
    .axi_arready               (hub_axi_arready        ),
    .axi_rdata                 (hub_axi_rdata          ),
    .axi_rlast                 (hub_axi_rlast          ),
    .axi_rvalid                (hub_axi_rvalid         )
);

// 20261018 disp: DDR3 read arbiter (hub=port0, display=port1)
rt_ddr_rd_arb u_rt_ddr_rd_arb (
    .clk         (ddr_core_clk      ),
    .rst_n       (ddr_rst_n         ),
    .s0_araddr   (hub_axi_araddr    ),
    .s0_arlen    (hub_axi_arlen     ),
    .s0_arvalid  (hub_axi_arvalid   ),
    .s0_arready  (hub_axi_arready   ),
    .s0_rdata    (hub_axi_rdata     ),
    .s0_rlast    (hub_axi_rlast     ),
    .s0_rvalid   (hub_axi_rvalid    ),
    .s1_araddr   (dsp_axi_araddr    ),
    .s1_arlen    (dsp_axi_arlen     ),
    .s1_arvalid  (dsp_axi_arvalid   ),
    .s1_arready  (dsp_axi_arready   ),
    .s1_rdata    (dsp_axi_rdata     ),
    .s1_rlast    (dsp_axi_rlast     ),
    .s1_rvalid   (dsp_axi_rvalid    ),
    .ddr_araddr  (ddr_axi_araddr    ),
    .ddr_arlen   (ddr_axi_arlen     ),
    .ddr_arvalid (ddr_axi_arvalid   ),
    .ddr_arready (ddr_axi_arready   ),
    .ddr_rdata   (ddr_axi_rdata     ),
    .ddr_rlast   (ddr_axi_rlast     ),
    .ddr_rvalid  (ddr_axi_rvalid    ),
    .ddr_aruser_id(ddr_axi_aruser_id)
);

// 20261028 lane wires
wire [159:0] ext_lane_cfg_bus;
wire         ext_lane_cfg_tgl;
wire [255:0] ext_lane_stat_bus;   // 20261105: 原为 [223:0]，最高 32 位(max_consec/double_cnt, 0x8F4)被截断恒为 0
wire [223:0] ext_lane_dbg_bus;
wire         ext_lane_stat_tgl;

// 20261029 zebra wires
wire [47:0]  ext_zebra_cfg_bus;
wire         ext_zebra_cfg_tgl;
wire [95:0]  ext_zebra_stat_bus;
wire         ext_zebra_stat_tgl;

// 20261018 disp: extended BAR1 registers (pclk_div2 domain)
rt_ext_regs u_rt_ext_regs (
    .clk           (pclk_div2        ),
    .rst_n         (core_rst_n       ),
    .i_tap_vld     (bar1_tap_vld     ),
    .i_tap_addr    (bar1_tap_addr    ),
    .i_tap_data    (bar1_tap_data    ),
    .i_rd_addr     (ext_rd_addr      ),
    .o_rd128       (ext_rd_data      ),
    .cfg_tgl       (ext_cfg_tgl      ),
    .cfg_ctrl      (ext_cfg_ctrl     ),
    .cfg_fb_base   (ext_fb_base      ),
    .cfg_slot_size (ext_slot_size    ),
    .cfg_stride    (ext_stride       ),
    .cfg_uv_off    (ext_uv_off       ),
    .commit_tgl    (ext_commit_tgl   ),
    .commit_slot   (ext_commit_slot  ),
    .commit_frame_id(ext_commit_fid  ),
    .i_stat_tgl    (ext_stat_tgl     ),
    .i_stat_bus    (ext_stat_bus     ),
    .o_osd_tgl     (ext_osd_cfg_tgl  ),
    .o_osd_cfg     (ext_osd_cfg      ),
    .o_tram_we     (ext_tram_we      ),
    .o_tram_addr   (ext_tram_addr    ),
    .o_tram_data   (ext_tram_data    ),
    .i_evt_tgl     (ext_evt_tgl      ),
    .i_evt_key     (ext_evt_key      ),
    .i_evt_type    (ext_evt_type     ),
    .i_evt_step    (ext_evt_step     ),
    .i_drv_tgl     (ext_drv_tgl      ),
    .i_drv_bus     (ext_drv_bus      ),
    .i_cal_tgl     (ext_cal_tgl      ),
    .i_cal_bus     (ext_cal_bus      ),
    .i_key_stat    (ext_key_stat     ),
    .o_led_host    (ext_led_host     ),
    .o_led_oe      (ext_led_oe       ),
    .o_hdmi_reinit_tgl(hdmi_reinit_tgl),   // 20261019 osd1d
    .o_hdmi_rx_en     (hdmi_rx_en     ),   // 20261028
    .i_hdmi_stat_tgl(hdmi_stat_tgl   ),   // 20261019 osd1d
    .i_hdmi_stat_bus(hdmi_stat_bus   ),   // 20261019 osd1d
    // 20261026 cam diag : read-only camera status (0x8A0 / 0x8A4)
    .i_cam_cfg_done   (cam_cfg_done     ),
    .i_cam_initial_en (cam_initial_en   ),
    .i_cam_vsync      (cmos1_vsync      ),
    .i_cam_href       (cmos1_href       ),
    .i_cam_pclk_tgl   (cam_pclk_tgl     ),
    .i_cam_href16     (cam1_href_16bit  ),
    .i_cam_pclk_rst_n (cam_pclk_rst_n   ),
    .i_por_done       (por_done         ),
    .i_cam_vs_cnt16   (cam_vs_cnt16     ),
    .i_cam_wr_stat    (cam_wr_stat      ),
    .i_cam_urg_cnt    (cam_urg_cnt      ),
    .o_stats_ctrl     (ext_stats_ctrl   ),
    .i_stats_bus      (ext_stats_bus    ),
    .i_stats_tgl      (ext_stats_tgl    ),
    // 20261028 lane
    .o_lane_cfg_bus   (ext_lane_cfg_bus ),
    .o_lane_cfg_tgl   (ext_lane_cfg_tgl ),
    .i_lane_stat_bus  (ext_lane_stat_bus),
    .i_lane_dbg_bus   (ext_lane_dbg_bus ),
    .i_lane_stat_tgl  (ext_lane_stat_tgl),
    // 20261029 zebra
    .o_zebra_cfg_bus  (ext_zebra_cfg_bus ),
    .o_zebra_cfg_tgl  (ext_zebra_cfg_tgl ),
    .i_zebra_stat_bus (ext_zebra_stat_bus),
    .i_zebra_stat_tgl (ext_zebra_stat_tgl),
    // 20261106 cam23: runtime SCCB
    .o_sccb_cmd       (sccb_cmd         ),
    .o_sccb_req_tgl   (sccb_req_tgl     ),
    .i_sccb_done_tgl  (sccb_done_tgl    ),
    .i_sccb_nack      (sccb_nack        )
);

// 20261018 disp: display subsystem
rt_disp_top u_rt_disp_top (

    .free_clk       (free_clk        ),    .core_clk       (ddr_core_clk    ),
    .core_rst_n     (ddr_rst_n       ),
    .ddr_init_done  (ddr_init_done   ),
    .cfg_tgl        (ext_cfg_tgl     ),
    .cfg_ctrl       (ext_cfg_ctrl    ),
    .cfg_fb_base    (ext_fb_base     ),
    .cfg_slot_size  (ext_slot_size   ),
    .cfg_stride     (ext_stride      ),
    .cfg_uv_off     (ext_uv_off      ),
    .commit_tgl     (ext_commit_tgl  ),
    .commit_slot    (ext_commit_slot ),
    .commit_frame_id(ext_commit_fid  ),
    .stat_tgl       (ext_stat_tgl    ),
    .stat_bus       (ext_stat_bus    ),
    .hdmi_reinit_tgl(hdmi_reinit_tgl ),   // 20261019 osd1d
    .hdmi_rx_en     (hdmi_rx_en     ),   // 20261028
    .hdmi_stat_tgl  (hdmi_stat_tgl   ),   // 20261019 osd1d
    .hdmi_stat_bus  (hdmi_stat_bus   ),   // 20261019 osd1d
    // 20261026 cam : camera frame boundary commit for window 0 (slot 0)
    .cam_commit_tgl (cam_commit_tgl  ),
    .cam_commit_fid (cam_commit_fid  ),
    .cam_commit_buf (cam_commit_buf  ),
    .pclk_i         (pclk_div2       ),
    .osd_cfg_tgl    (ext_osd_cfg_tgl ),
    .osd_cfg        (ext_osd_cfg     ),
    .tram_we        (ext_tram_we     ),
    .tram_addr      (ext_tram_addr   ),
    .tram_wdata     (ext_tram_data   ),
    .evt_tgl        (ext_evt_tgl     ),
    .evt_key        (ext_evt_key     ),
    .evt_type       (ext_evt_type    ),
    .evt_step       (ext_evt_step    ),
    .drv_tgl        (ext_drv_tgl     ),
    .drv_bus        (ext_drv_bus     ),
    .cal_tgl        (ext_cal_tgl     ),
    .cal_bus        (ext_cal_bus     ),
    .m_araddr       (dsp_axi_araddr  ),
    .m_arlen        (dsp_axi_arlen   ),
    .m_arvalid      (dsp_axi_arvalid ),
    .m_arready      (dsp_axi_arready ),
    .m_rdata        (dsp_axi_rdata   ),
    .m_rlast        (dsp_axi_rlast   ),
    .m_rvalid       (dsp_axi_rvalid  ),
    .led_host       (ext_led_host    ),
    .led_oe         (ext_led_oe      ),
    .rdlh_link_up   (rdlh_link_up_int),
    .key_raw        (key             ),
    .led            (led             ),
    .key_stat       (ext_key_stat    ),
    .stats_ctrl     (ext_stats_ctrl  ),
    .stats_bus      (ext_stats_bus   ),
    .stats_tgl      (ext_stats_tgl   ),
    // 20261028 lane
    .lane_cfg_bus   (ext_lane_cfg_bus),
    .lane_cfg_tgl   (ext_lane_cfg_tgl),
    .lane_stat_bus  (ext_lane_stat_bus),
    .lane_dbg_bus   (ext_lane_dbg_bus),
    .lane_stat_tgl  (ext_lane_stat_tgl),
    // 20261029 zebra
    .zebra_cfg_bus  (ext_zebra_cfg_bus),
    .zebra_cfg_tgl  (ext_zebra_cfg_tgl),
    .zebra_stat_bus (ext_zebra_stat_bus),
    .zebra_stat_tgl (ext_zebra_stat_tgl),
    .pix_clk        (pix_clk         ),

    .vs_out         (vs_out          ),
    .hs_out         (hs_out          ),
    .de_out         (de_out          ),
    .r_out          (r_out           ),
    .g_out          (g_out           ),
    .b_out          (b_out           ),
    .hd_scl         (hd_scl          ),
    .hd_sda         (hd_sda          ),
    .rstn_out       (rstn_out        )
);

 
//----------------------------------------------------------   pcie wrap  ----------------------------------------------------------
//pcie wrap : HSSTLP : 0x0000~6000 PCIe BASE ADDR : 0x7000

PCIe_IP
u_ips2l_pcie_wrap
(
    .button_rst_n               (1'b1                   ),
    .power_up_rst_n             (sync_perst_n           ),
    .perst_n                    (sync_perst_n           ),
    //clk and rst
    .pclk                       (pclk                   ),      //output
    .pclk_div2                  (pclk_div2              ),      //output
    .ref_clk                    (ref_clk                ),      //output
    .ref_clk_n                  (ref_clk_n              ),      //input
    .ref_clk_p                  (ref_clk_p              ),      //input
    .core_rst_n                 (core_rst_n             ),      //output
    
    //APB interface to  DBI cfg
    //.p_clk                      (ref_clk                ),      //input
    .p_sel                      ('d0                    ),      //input
    .p_strb                     ('d0                    ),      //input  [ 3:0]
    .p_addr                     ('d0                    ),      //input  [15:0]
    .p_wdata                    ('d0                    ),      //input  [31:0]
    .p_ce                       ('d0                    ),      //input
    .p_we                       ('d0                    ),      //input
    .p_rdy                      (                       ),      //output
    .p_rdata                    (                       ),      //output [31:0]
   
    //PHY diff signals
    .rxn                        (rxn                    ),      //input   [3:0]
    .rxp                        (rxp                    ),      //input   [3:0]
    .txn                        (txn                    ),      //output  [3:0]
    .txp                        (txp                    ),      //output  [3:0]
    .pcs_nearend_loop           ({4{1'b0}}              ),      //input
    .pma_nearend_ploop          ({4{1'b0}}              ),      //input
    .pma_nearend_sloop          ({4{1'b0}}              ),      //input
    //AXIS master interface
    .axis_master_tvalid         (axis_master_tvalid     ),      //output
    .axis_master_tready         (axis_master_tready     ),      //input
    .axis_master_tdata          (axis_master_tdata      ),      //output [127:0]
    .axis_master_tkeep          (axis_master_tkeep      ),      //output [3:0]
    .axis_master_tlast          (axis_master_tlast      ),      //output
    .axis_master_tuser          (axis_master_tuser      ),      //output [7:0]
    
    //axis slave 0 interface
    .axis_slave0_tready         (axis_slave0_tready     ),      //output
    .axis_slave0_tvalid         (axis_slave0_tvalid     ),      //input
    .axis_slave0_tdata          (axis_slave0_tdata      ),      //input  [127:0]
    .axis_slave0_tlast          (axis_slave0_tlast      ),      //input
    .axis_slave0_tuser          (axis_slave0_tuser      ),      //input
    
    //axis slave 1 interface
    .axis_slave1_tready         (axis_slave1_tready     ),      //output
    .axis_slave1_tvalid         (axis_slave1_tvalid     ),      //input
    .axis_slave1_tdata          (axis_slave1_tdata      ),      //input  [127:0]
    .axis_slave1_tlast          (axis_slave1_tlast      ),      //input
    .axis_slave1_tuser          (axis_slave1_tuser      ),      //input
    //axis slave 2 interface
    .axis_slave2_tready         (axis_slave2_tready     ),      //output
    .axis_slave2_tvalid         (axis_slave2_tvalid     ),      //input
    .axis_slave2_tdata          (axis_slave2_tdata      ),      //input  [127:0]
    .axis_slave2_tlast          (axis_slave2_tlast      ),      //input
    .axis_slave2_tuser          (axis_slave2_tuser      ),      //input
     
    .pm_xtlh_block_tlp          (                       ),      //output

	 // MSI interface	
    .ven_msi_req                (1'b0                   ),      //input
    .cfg_msi_en                 (                       ),      //output
    .ven_msi_grant              (                       ),      //output	
    .ven_msi_tc                 (3'b0                   ),      //input   [2:0]	
    .ven_msi_vector             (5'b0                   ),      //input   [4:0]		
    .cfg_msi_pending            (32'b0                  ),      //input   [31:0]	

	  
    .cfg_send_cor_err_mux       (                       ),      //output
    .cfg_send_nf_err_mux        (                       ),      //output
    .cfg_send_f_err_mux         (                       ),      //output
    .cfg_sys_err_rc             (                       ),      //output
    .cfg_aer_rc_err_mux         (                       ),      //output
    //radm timeout
    .radm_cpl_timeout           (                       ),      //output
    
    //configuration signals
    .cfg_max_rd_req_size        (cfg_max_rd_req_size    ),      //output [2:0]
    .cfg_bus_master_en          (                       ),      //output
    .cfg_max_payload_size       (cfg_max_payload_size   ),      //output [2:0]
    .cfg_ext_tag_en             (                       ),      //output
    .cfg_rcb                    (cfg_rcb                ),      //output
    .cfg_mem_space_en           (                       ),      //output
    .cfg_pm_no_soft_rst         (                       ),      //output
    .cfg_crs_sw_vis_en          (                       ),      //output
    .cfg_no_snoop_en            (                       ),      //output
    .cfg_relax_order_en         (                       ),      //output
    .cfg_tph_req_en             (                       ),      //output [2-1:0]
    .cfg_pf_tph_st_mode         (                       ),      //output [3-1:0]
    .rbar_ctrl_update           (                       ),      //output
    .cfg_atomic_req_en          (                       ),      //output
    
    .cfg_pbus_num               (cfg_pbus_num           ),      //output [7:0]
    .cfg_pbus_dev_num           (cfg_pbus_dev_num       ),      //output [4:0]
    
    //debug signals
    .radm_idle                  (                       ),      //output
    .radm_q_not_empty           (                       ),      //output
    .radm_qoverflow             (                       ),      //output
    .diag_ctrl_bus              (2'b0                   ),      //input   [1:0]
    .cfg_link_auto_bw_mux       (                       ),      //output              merge cfg_link_auto_bw_msi and cfg_link_auto_bw_int
    .cfg_bw_mgt_mux             (                       ),      //output              merge cfg_bw_mgt_int and cfg_bw_mgt_msi
    .cfg_pme_mux                (                       ),      //output              merge cfg_pme_int and cfg_pme_msi
    .app_ras_des_sd_hold_ltssm  (1'b0                   ),      //input
    .app_ras_des_tba_ctrl       (2'b0                   ),      //input   [1:0]
    
    .dyn_debug_info_sel         (4'b0                   ),      //input   [3:0]
    .debug_info_mux             (                       ),      //output  [132:0]
    
    //system signal
    .smlh_link_up               (smlh_link_up           ),      //output
    .rdlh_link_up               (rdlh_link_up_int       ),      //output  // 20261017 dbg: internal wire
    .smlh_ltssm_state           (smlh_ltssm_state       ),      //output  [4:0]
    // 20261017 dbg: PHY status inputs
    .o_dbg_pll_lock             (dbg_pll_lock           ),      //output
    .o_dbg_cdr_align            (dbg_cdr_align          ),      //output  [1:0]
    .o_dbg_lsm_synced           (dbg_lsm_synced         ),      //output  [1:0]
    .o_dbg_tx_rst_done          (dbg_tx_rst_done        )       //output
);

//---------------------------------------------------------- ltssm logger (20261017 log) ----------------------------------------------------------
// 20261017 log: status flags {perst_n,pll_lock,tx_rst_done,cdr1,cdr0,lsm1,lsm0,link_up}
wire    [7:0]   ltssm_dbg_flags;

assign ltssm_dbg_flags = {perst_n, dbg_pll_lock, dbg_tx_rst_done,
                          dbg_cdr_align[1], dbg_cdr_align[0],
                          dbg_lsm_synced[1], dbg_lsm_synced[0], smlh_link_up};

ltssm_logger u_ltssm_logger
(
    .free_clk    (free_clk        ),   // 20261017 log: 27MHz domain
    .pclk_div2   (pclk_div2       ),   // 20261017 log: PCIe core domain
    .ltssm_state (smlh_ltssm_state),   // 20261017 log: [4:0]
    .flags_async (ltssm_dbg_flags ),   // 20261017 log: [7:0]
    .txd         (txd             )    // 20261017 log: UART TX
);

endmodule

// 20261017 log: ============================================================
// 20261017 log: ltssm_logger
// 20261017 log:   Records LTSSM state / status-flag transitions with a 1us
// 20261017 log:   timestamp, buffers them in a 512x48 sync FIFO and streams
// 20261017 log:   ASCII lines out of an 8N1 UART on the 27MHz free_clk.
// 20261017 log: ============================================================
module ltssm_logger
(
    input           free_clk    ,   // 20261017 log: 27 MHz board oscillator
    input           pclk_div2   ,   // 20261017 log: PCIe core clock domain
    input   [4:0]   ltssm_state ,   // 20261017 log: smlh_ltssm_state
    input   [7:0]   flags_async ,   // 20261017 log: {perst,pll,txdone,cdr1,cdr0,lsm1,lsm0,link}
    output  reg     txd             // 20261017 log: UART TX
);

    localparam       BAUD_DIV   = 29;       // 20261017 log: 27MHz/29 ~= 931kbaud
    localparam [5:0] INIT_STATE = 6'h3F;    // 20261017 log: last_state power-on value

    localparam [2:0] S_BANNER   = 3'd0;     // 20261017 log: FSM states
    localparam [2:0] S_CHK      = 3'd1;
    localparam [2:0] S_RDLAT    = 3'd2;
    localparam [2:0] S_TXCH     = 3'd3;
    localparam [2:0] S_TXWAIT   = 3'd4;

    reg      [2:0]  state   = S_BANNER;     // 20261017 log: FSM state (declaration init)

    // 20261017 log: -------- 1us tick + timestamp (free_clk) -----------------
    reg      [4:0]  div_cnt = 5'd0;
    reg      [31:0] ts_us   = 32'd0;

    always @(posedge free_clk)
    begin
        if (div_cnt == 5'd26)
            div_cnt <= 5'd0;
        else
            div_cnt <= div_cnt + 5'd1;
    end

    wire tick_us = (div_cnt == 5'd26);

    always @(posedge free_clk)
    begin
        if (tick_us)
            ts_us <= ts_us + 32'd1;
    end

    // 20261017 log: -------- LTSSM cross domain (1FF + 3FF sync) -------------
    reg      [4:0]  ltssm_q  = 5'd0;
    always @(posedge pclk_div2)
        ltssm_q <= ltssm_state;

    reg      [4:0]  ltssm_s1 = 5'd0;
    reg      [4:0]  ltssm_s2 = 5'd0;
    reg      [4:0]  ltssm_s3 = 5'd0;
    always @(posedge free_clk)
    begin
        ltssm_s1 <= ltssm_q;
        ltssm_s2 <= ltssm_s1;
        ltssm_s3 <= ltssm_s2;
    end

    wire            ltssm_stable_vld = (ltssm_s3 == ltssm_s2);   // 20261017 log: stable when s3==s2
    wire     [4:0]  ltssm_stable     = ltssm_s3;

    // 20261017 log: -------- flags cross domain (2FF sync) -------------------
    reg      [7:0]  flags_s1 = 8'd0;
    reg      [7:0]  flags_s  = 8'd0;
    always @(posedge free_clk)
    begin
        flags_s1 <= flags_async;
        flags_s  <= flags_s1;
    end

    // 20261017 log: -------- event detection ---------------------------------
    reg      [5:0]  last_state      = INIT_STATE;
    reg      [7:0]  last_flags      = 8'h00;
    reg             dropped_pending = 1'b0;

    wire state_changed = ltssm_stable_vld &&
                         ((ltssm_stable != last_state[4:0]) || (last_state == INIT_STATE));
    wire flags_changed = (flags_s != last_flags);
    wire ev_valid      = state_changed || flags_changed;

    // 20261017 log: -------- sync FIFO 512 x 48 (block RAM) ------------------
    reg      [47:0] mem [0:511];
    reg      [8:0]  wr_ptr    = 9'd0;
    reg      [8:0]  rd_ptr    = 9'd0;
    reg      [9:0]  fifo_cnt  = 10'd0;
    reg      [47:0] rd_data   = 48'd0;

    wire            fifo_full  = (fifo_cnt == 10'd512);
    wire            fifo_empty = (fifo_cnt == 10'd0);
    wire            pop        = (state == S_CHK) && !fifo_empty;
    wire            ev_write   = ev_valid && !fifo_full;
    // 20261017 log: record = {ts_us[31:0], flags_s[7:0], dropped, 2'b00, state[4:0]}
    wire     [47:0] ev_data    = {ts_us, flags_s, dropped_pending, 2'b00, ltssm_stable};

    always @(posedge free_clk)
    begin
        if (ev_write)
        begin
            mem[wr_ptr] <= ev_data;
            wr_ptr      <= wr_ptr + 9'd1;
        end
    end

    always @(posedge free_clk)
        rd_data <= mem[rd_ptr];     // 20261017 log: registered read -> block RAM

    always @(posedge free_clk)
    begin
        if (ev_valid && fifo_full)
            dropped_pending <= 1'b1;
        else if (ev_write)
            dropped_pending <= 1'b0;
    end

    always @(posedge free_clk)
    begin
        if (ev_write)
        begin
            last_state <= {1'b0, ltssm_stable};
            last_flags <= flags_s;
        end
    end

    always @(posedge free_clk)
    begin
        if (pop)
            rd_ptr <= rd_ptr + 9'd1;
    end

    always @(posedge free_clk)
    begin
        case ({ev_write, pop})
            2'b10:   fifo_cnt <= fifo_cnt + 10'd1;
            2'b01:   fifo_cnt <= fifo_cnt - 10'd1;
            default: ;
        endcase
    end

    // 20261017 log: -------- UART TX 8N1 -------------------------------------
    reg      [9:0]  tx_shifter = 10'h3FF;
    reg      [4:0]  baud_cnt   = 5'd0;
    reg      [3:0]  bit_cnt    = 4'd0;
    reg             tx_busy    = 1'b0;
    reg             tx_start   = 1'b0;
    reg      [7:0]  tx_byte    = 8'h00;

    always @(posedge free_clk)
    begin
        if (!tx_busy)
        begin
            txd <= 1'b1;                                // 20261017 log: idle high
            if (tx_start)
            begin
                tx_busy    <= 1'b1;
                tx_shifter <= {1'b1, tx_byte, 1'b0};    // 20261017 log: {stop,data,start}
                baud_cnt   <= 5'd0;
                bit_cnt    <= 4'd0;
                txd        <= 1'b0;                     // 20261017 log: start bit
            end
        end
        else
        begin
            if (baud_cnt == BAUD_DIV-1)
            begin
                baud_cnt <= 5'd0;
                if (bit_cnt == 4'd9)
                begin
                    tx_busy <= 1'b0;
                    txd     <= 1'b1;                    // 20261017 log: stop bit
                end
                else
                begin
                    tx_shifter <= {1'b1, tx_shifter[9:1]};
                    txd        <= tx_shifter[1];
                    bit_cnt    <= bit_cnt + 4'd1;
                end
            end
            else
            begin
                baud_cnt <= baud_cnt + 5'd1;
            end
        end
    end

    // 20261017 log: -------- record character buffer -------------------------
    reg      [7:0]  rec_buf [0:15];

    function [7:0] hex2ascii;
        input [3:0] n;
        begin
            hex2ascii = (n < 4'd10) ? (8'h30 + {4'b0, n}) : (8'h37 + {4'b0, n});
        end
    endfunction

    function [7:0] banner_char_fn;
        input [4:0] idx;
        begin
            case (idx)
                5'd0 :   banner_char_fn = "\r";
                5'd1 :   banner_char_fn = "\n";
                5'd2 :   banner_char_fn = "L";
                5'd3 :   banner_char_fn = "T";
                5'd4 :   banner_char_fn = "S";
                5'd5 :   banner_char_fn = "S";
                5'd6 :   banner_char_fn = "M";
                5'd7 :   banner_char_fn = "L";
                5'd8 :   banner_char_fn = "O";
                5'd9 :   banner_char_fn = "G";
                5'd10:   banner_char_fn = " ";
                5'd11:   banner_char_fn = "2";
                5'd12:   banner_char_fn = "0";
                5'd13:   banner_char_fn = "2";
                5'd14:   banner_char_fn = "6";
                5'd15:   banner_char_fn = "1";
                5'd16:   banner_char_fn = "0";
                5'd17:   banner_char_fn = "1";
                5'd18:   banner_char_fn = "7";
                5'd19:   banner_char_fn = "\r";
                5'd20:   banner_char_fn = "\n";
                default: banner_char_fn = 8'h00;
            endcase
        end
    endfunction

    reg      [4:0]  msg_idx   = 5'd0;
    reg      [4:0]  msg_len   = 5'd21;
    reg             in_banner = 1'b1;
    reg             seen_busy = 1'b0;

    wire     [7:0]  cur_char = in_banner ? banner_char_fn(msg_idx) : rec_buf[msg_idx];

    // 20261017 log: -------- transmit FSM ------------------------------------
    always @(posedge free_clk)
    begin
        case (state)
            S_BANNER:
            begin
                in_banner <= 1'b1;
                msg_len   <= 5'd21;
                msg_idx   <= 5'd0;
                seen_busy <= 1'b0;
                state     <= S_TXCH;
            end

            S_CHK:
            begin
                if (!fifo_empty)
                    state <= S_RDLAT;
            end

            S_RDLAT:
            begin
                in_banner <= 1'b0;
                msg_len   <= 5'd16;
                msg_idx   <= 5'd0;
                seen_busy <= 1'b0;
                rec_buf[0]  <= hex2ascii(rd_data[47:44]);
                rec_buf[1]  <= hex2ascii(rd_data[43:40]);
                rec_buf[2]  <= hex2ascii(rd_data[39:36]);
                rec_buf[3]  <= hex2ascii(rd_data[35:32]);
                rec_buf[4]  <= hex2ascii(rd_data[31:28]);
                rec_buf[5]  <= hex2ascii(rd_data[27:24]);
                rec_buf[6]  <= hex2ascii(rd_data[23:20]);
                rec_buf[7]  <= hex2ascii(rd_data[19:16]);
                rec_buf[8]  <= 8'h20;
                rec_buf[9]  <= hex2ascii(rd_data[15:12]);
                rec_buf[10] <= hex2ascii(rd_data[11:8]);
                rec_buf[11] <= rd_data[7] ? 8'h21 : 8'h20;
                rec_buf[12] <= hex2ascii({3'b000, rd_data[4]});
                rec_buf[13] <= hex2ascii(rd_data[3:0]);
                rec_buf[14] <= 8'h0D;
                rec_buf[15] <= 8'h0A;
                state      <= S_TXCH;
            end

            S_TXCH:
            begin
                tx_byte   <= cur_char;
                tx_start  <= 1'b1;
                seen_busy <= 1'b0;
                state     <= S_TXWAIT;
            end

            S_TXWAIT:
            begin
                tx_start <= 1'b0;
                if (!seen_busy)
                begin
                    if (tx_busy)
                        seen_busy <= 1'b1;
                end
                else
                begin
                    if (!tx_busy)
                    begin
                        if (msg_idx == msg_len - 5'd1)
                            state <= S_CHK;
                        else
                        begin
                            msg_idx <= msg_idx + 5'd1;
                            state   <= S_TXCH;
                        end
                    end
                end
            end

            default:
                state <= S_BANNER;
        endcase
    end

endmodule
