Zdy-1110/FPGA-676/fpga/ip/ram_128in_128out/rtl/ipm2l_sdpram_v1_4_ram_128in_128out.v

// Created by IP Generator (Version 2021.1-SP7.3 build 94852)



////////////////////////////////////////////////////////////////////////////////
//
// Copyright (c) 2019 PANGO MICROSYSTEMS, INC
// ALL RIGHTS REVERVED.
//
// THE SOURCE CODE CONTAINED HEREIN IS PROPRIETARY TO PANGO MICROSYSTEMS, INC.
// IT SHALL NOT BE REPRODUCED OR DISCLOSED IN WHOLE OR IN PART OR USED BY
// PARTIES WITHOUT WRITTEN AUTHORIZATION FROM THE OWNER.
//
////////////////////////////////////////////////////////////////////////////////
//
// Library:
// Filename:ipm2l_sdpram.v
////////////////////////////////////////////////////////////////////////////////

module ipm2l_sdpram_v1_4_ram_128in_128out  #(
    parameter   c_CAS_MODE              = "18K"             ,   // "18K", "36K", "64K"
    parameter   c_WR_ADDR_WIDTH         = 10                ,
    parameter   c_WR_DATA_WIDTH         = 32                ,
    parameter   c_RD_ADDR_WIDTH         = 10                ,
    parameter   c_RD_DATA_WIDTH         = 32                ,
    parameter   c_WR_ADDR_STROBE_EN     = 0                 ,
    parameter   c_WR_CLK_EN             = 0                 ,
    parameter   c_OUTPUT_REG            = 0                 ,
    parameter   c_RD_OCE_EN             = 0                 ,
    parameter   c_FAB_REG               = 0                 ,
    parameter   c_RD_ADDR_STROBE_EN     = 0                 ,
    parameter   c_RD_CLK_EN             = 0                 ,
    parameter   c_RESET_TYPE            = "ASYNC"           ,
    parameter   c_RD_CLK_OR_POL_INV     = 0                 ,
    parameter   c_POWER_OPT             = 0                 ,
    parameter   c_INIT_FILE             = "NONE"            ,
    parameter   c_INIT_FORMAT           = "BIN"             ,
    parameter   c_WR_BYTE_EN            = 0                 ,
    parameter   c_BE_WIDTH              = 8
) (
    input   wire    [c_WR_ADDR_WIDTH-1 : 0]     wr_addr         ,
    input   wire    [c_WR_DATA_WIDTH-1 : 0]     wr_data         ,
    input   wire                                wr_en           ,
    input   wire                                wr_clk          ,
    input   wire                                wr_clk_en       ,
    input   wire                                wr_rst          ,
    input   wire    [c_BE_WIDTH-1 : 0]          wr_byte_en      ,
    input   wire                                wr_addr_strobe  ,

    input   wire    [c_RD_ADDR_WIDTH-1 : 0]     rd_addr         ,
    output  wire    [c_RD_DATA_WIDTH-1 : 0]     rd_data         ,
    input   wire                                rd_clk          ,
    input   wire                                rd_clk_en       ,
    input   wire                                rd_rst          ,
    input   wire                                rd_oce          ,
    input   wire                                rd_addr_strobe
);

localparam INIT_EN = 0 ; // @IPC bool
localparam RST_VAL_EN = 0 ; // @IPC bool

    localparam  c_WR_BYTE_WIDTH = c_WR_BYTE_EN ? (c_WR_DATA_WIDTH/(c_BE_WIDTH==0 ? 1 : c_BE_WIDTH)) : ( (c_WR_DATA_WIDTH%9 ==0) ? 9 : (c_WR_DATA_WIDTH%8 ==0) ? 8 : 9 );
    localparam  ADDR_STROBE_EN  = (c_WR_ADDR_STROBE_EN == 1) || (c_RD_ADDR_STROBE_EN == 1);
    //c_WR_DATA_WIDTH == 2^N
    //WIDTH_RATIO = 1
    //L_DATA_WIDTH is the parameter value of DATA_WIDTH_A and DATA_WIDTH_B in a instance DRM ,define witch type DRM to instance in noraml mode
    localparam  DATA_WIDTH_WIDE = c_WR_DATA_WIDTH >= c_RD_DATA_WIDTH ? c_WR_DATA_WIDTH :c_RD_DATA_WIDTH ; //wider DATA_WIDTH between c_WR_DATA_WIDTH and c_RD_DATA_WIDTH
    localparam  ADDR_WIDTH_WIDE = c_WR_DATA_WIDTH >= c_RD_DATA_WIDTH ? c_WR_ADDR_WIDTH :c_RD_ADDR_WIDTH ; //ADDR WIDTH correspond to DATA_WIDTH_WIDE

    localparam  DATA_WIDTH_NARROW = c_WR_DATA_WIDTH >= c_RD_DATA_WIDTH ? c_RD_DATA_WIDTH :c_WR_DATA_WIDTH ;
    localparam  ADDR_WIDTH_NARROW = c_WR_DATA_WIDTH >= c_RD_DATA_WIDTH ? c_RD_ADDR_WIDTH :c_WR_ADDR_WIDTH ;

    localparam  DATA_WIDTH_W2N = c_WR_DATA_WIDTH >= c_RD_DATA_WIDTH ? 1 : 0 ;
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
