Zdy-1110/FPGA-676/(commit log)

2026-10-29 初始提交
    [111440_hmi_reference.csv, 112454_timeline.csv, 112507_timeline.csv, 112739_timeline.csv, 113343_timeline.csv, 113421_timeline.csv, 113452_timeline.csv, 113539_timeline.csv]
2026-10-29 fpga_reload 改用 pwsh
2026-10-29 斑马线黄金模型与参数扫描
    [events.csv]
2026-10-29 红绿灯检测移植到板端
    [cases_c.csv, cases_c_no_ref.csv, states.csv]
2026-10-29 行人锥桶刹车决策与技术文档初稿
2026-10-29 cam11 RTL 快照与 NPU 实测
2026-10-29 清理误跟踪文件，板端凭据改为环境变量
2026-10-29 开机选择界面与 U 盘浏览器
2026-10-29 按键基线抵消与静态图片输入
2026-10-29 技术报告与配图
2026-10-29 文档构建与源码打包脚本
2026-10-29 DMA 与启动链容错加固
2026-10-29 补寄存器与复现附录
2026-10-29 限速标志提示与开机守护循环
2026-10-29 现场诊断脚本与运行手册
2026-10-29 术语表附录与表述修正
2026-10-29 录制素材生成脚本
2026-10-29 冷启动等待 FPGA 版本就绪
2026-10-29 修正欠载统计口径
2026-10-29 导航原型补充真值滞后说明
2026-10-29 S99 记录守护进程 PID
2026-10-29 文档引用改为函数级
2026-10-29 补门级网表一致性说明
2026-10-29 收紧绝对化表述
2026-10-29 删去不可核实的表述
2026-10-29 源码包生成 MANIFEST
2026-10-29 修正门级后仿口径
2026-10-29 提交清单与自检项
2026-10-29 源码包附证据日志
2026-10-30 提交文档初稿与紧凑表格模式
2026-10-30 cam17：OV5640 色彩修正与菜单按键调整
2026-10-30 提交文档更新 cam17 数据
2026-10-30 补板端回归结果与 cam17 已知风险
2026-11-01 自适应夜间增强与导航示例
    [dark_set.csv, luma_stats.csv, video_20260929_112454.csv, video_20260929_112507.csv, video_20260929_112739.csv, video_20260929_113343.csv, video_20260929_113421.csv, video_20260929_113452.csv]
2026-11-01 文档统一到 cam18 数据
2026-11-02 cam23 位流：车道线阈值重做与 ZOOM2X 分析核
2026-11-02 板端：四分屏调度、夜间通道与车道分类
    [report.csv, test_eval.csv]
2026-11-02 文档更新与配图重绘，导出提交文档
2026-11-02 修正文档中的复现基线提交号
2026-11-02 移除编辑器配置残留
2026-11-03 补齐移植说明与全量源码包，构建脚本改为相对路径
    [cam23_multiseed_result.csv]
2026-11-03 源码包根目录附移植说明
2026-11-03 自检脚本兼容源码包环境
2026-11-03 源码包附文档引用的溯源材料
